duanestorey/hifi-amp/README.md

# hifi-amp
A hi-fi 4-channel amplifier with active-crossovers and room correction
