duanestorey/hifi-amp/pcbs/README.md

## Printed Circuit Boards

These are all the associated PCBs for the amplifier project.  They were all created in Kicad, and the boards optimized for production via JLCPCB.
