duanestorey/hifi-amp/pcbs/_final_proto/README.md

## Next Updates

* Opamp voltage regulator has enable pin - can use that to kill the rails instead of a relay on split board
* Change vinyl to Muffy
* See if we can move relay for LM3886 rails somewhere else
* Add LPF to opamp power supply caps, possibly digital too
