duanestorey/hifi-amp/pcbs/vinyl-p6/readme.md

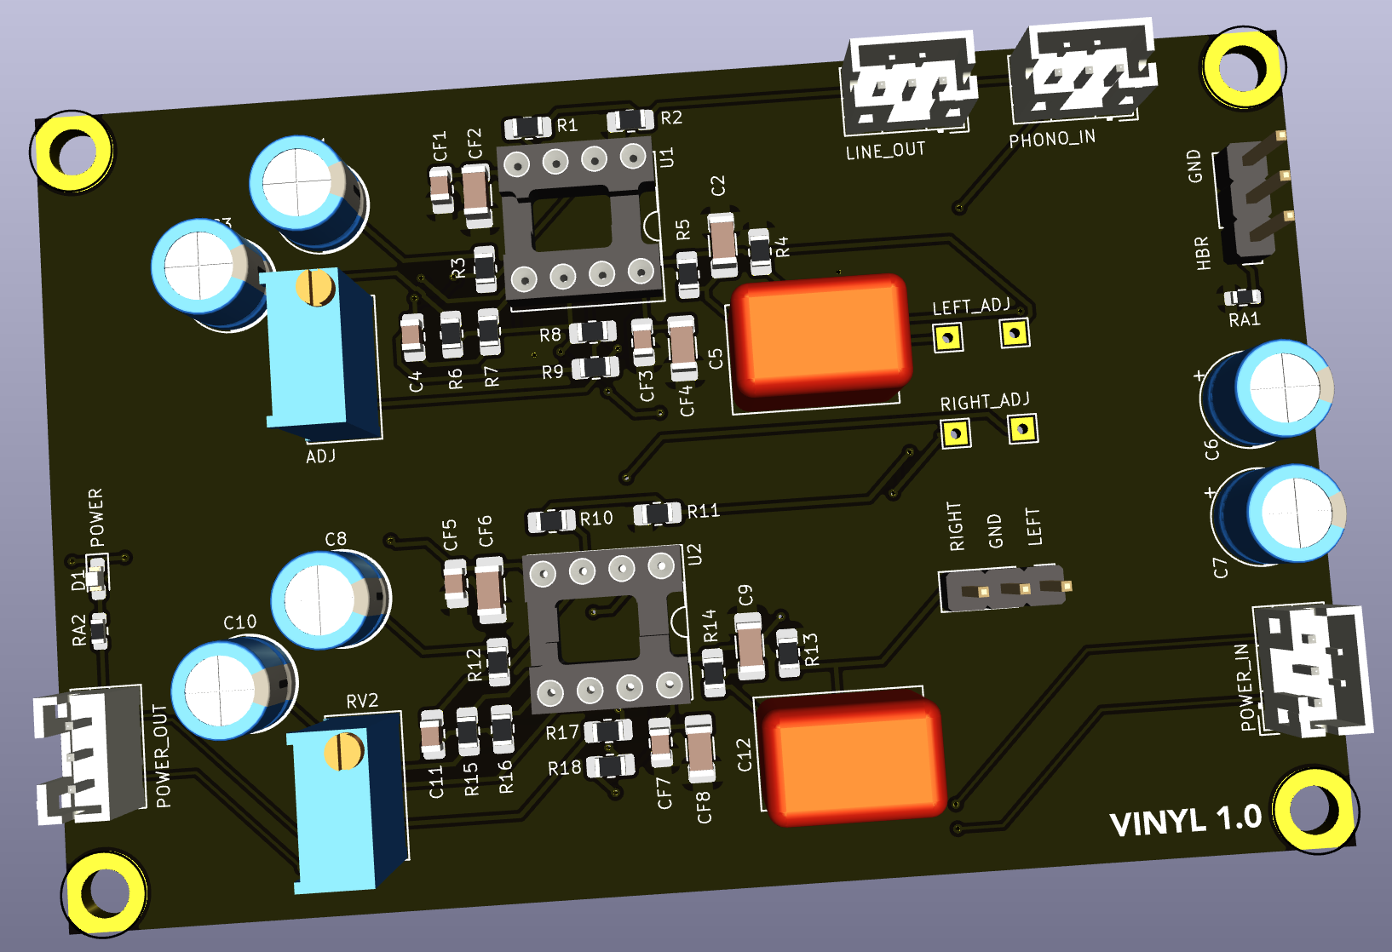
[picture p10: pcbs/vinyl-p6/screenshot.png]


## Phono/Vinyl Pre-amp

This is a phono/vinyl pre-amp with adjustable gain from about 40dB up to 60dB. It is based almost entirely on the ESP Project 6 Hifi Phono Pre-amp.  All resistors are thin-film 603/805, and all capacitors are either Nichicon Muse ES bipolar electrolytics or C0G surface mount 1206 variants.

### Version History

- 1.0: Initial Release

### Speciality Components

* OPA1612 Burr Brown operation amplifiers
* Various C0G and thin film resistors
* Nichicon Muse ES 25V 10uF
