duanestorey/hifi-amp/pcbs/_final_proto/psu-relay/readme.md

## PSU Split

### Version History

- 1.0: Initial Release
	- Missed connections between 5V and 3V3 capacitors.  Can fix it attaching wire under the board I think

### Speciality Components
