duanestorey/hifi-amp/pcbs/_final_proto/input-sel/readme.md

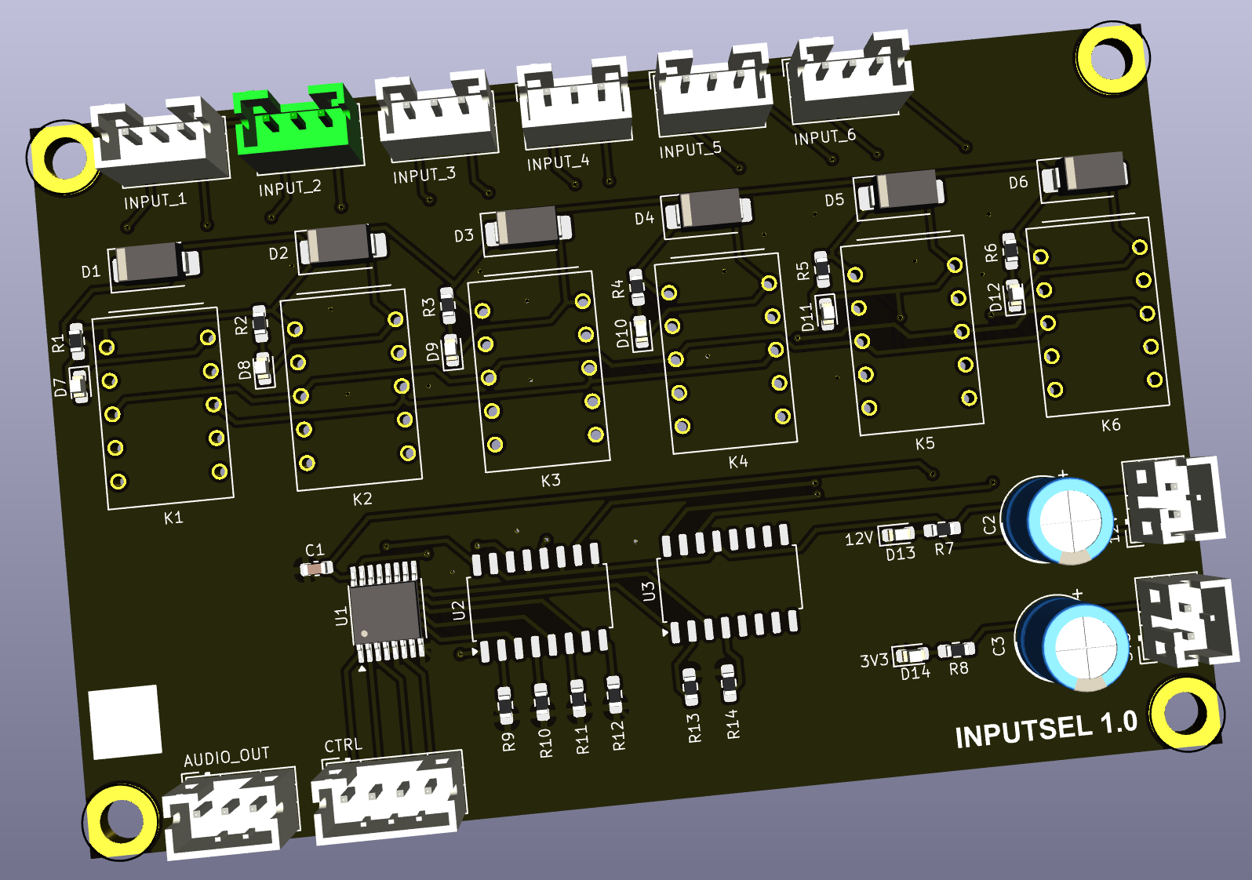
[picture p15: pcbs/_final_proto/input-sel/screenshot.png]


## Line-Input Selector

This PCB allows switching of 6 analog stereo inputs using gold-plated small signal relays.

### Version History

- 1.0: Initial Release

### Speciality Components

* 6x KEMET EA2 12V relays
* 2x TCMT4600 quad optocoupler
* CD74AC238 3->8 digital decoder
