duanestorey/hifi-amp/pcbs/_final_proto/lift/readme.md

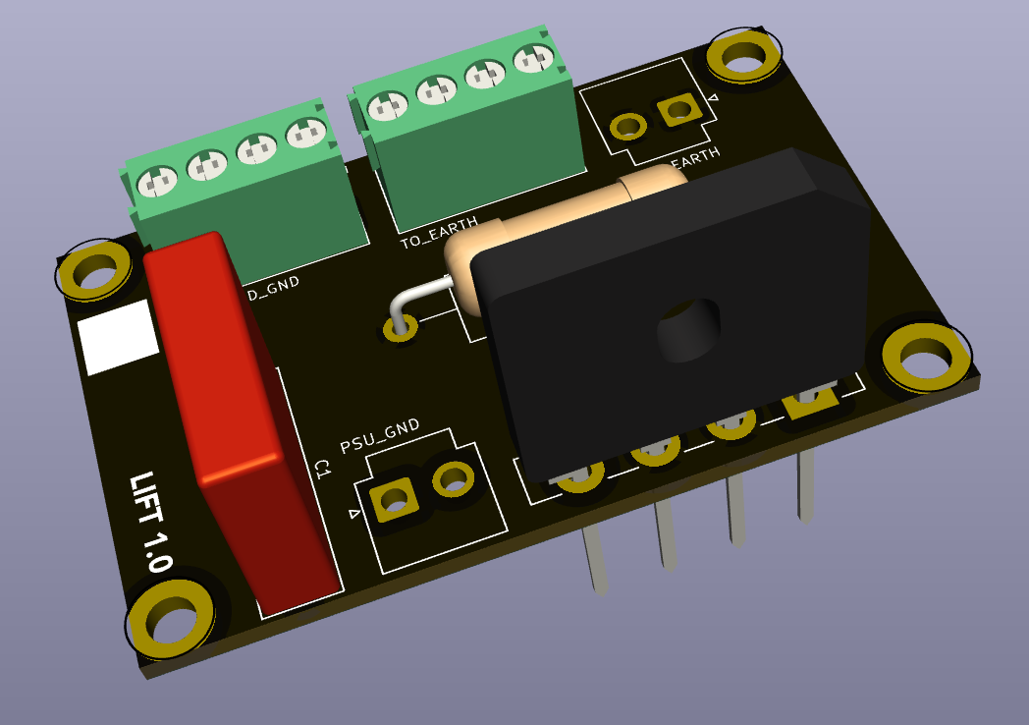
[picture p16: pcbs/_final_proto/lift/screenshot.png]


## Ground Lift

This board provides a ground-lift circuit to isolate the audio grounds from the chassis ground.  May not be legal in some juridictions, but should be safe.

### Version History

- 1.0: Initial Release

### Speciality Components
