duanestorey/hifi-amp/docs/specs.md

## Technical Specifications

The following are the rough technical specifications for the completed amplifier project. 

| Name | Value |
| ---- | ----- |
| Speakers | 2.1 |
| Channels | 4.1 |
| Subwoofer | Auto-generated |
| Sub Crossover Frequency | Programmable (80Hz typical) |
| Output Power (8Ω)| > 50W x 2 |
| Output Power (6Ω)| > 68W x 2 |
| THD+N @ Full Power | 0.03% |
| THD+N @ 2W | 0.005% |
| Display | 4x16 alphanumeric LCD |
| RCA Inputs | 6 |
| SPDIF Digital Inputs | 4 |
| TOSLINK Digital Inputs | 1 |
| Vinyl | Built-in RIAA amplifier |
| Internal Digital | 24-bit 96kHz | 
| Active Crossovers | Supported via Programmabale Biquads |
| Biquads supported | More than 100 at 96kHz |
| Signal Processing | 3x240 MHz dual-core 32-bit Xtensa LX7 |
| Output DAC | 112db SNR, -93db THD |
| Input ADC | 110db SNR, -93db THD |
| IR External Remote | Supported at 38kHz |
| Configuration | Wifi-Support |
| Programming | Over USB |

[Return to main page](/)
