duanestorey/hifi-amp/docs/hardware/index.md

## Hardware

The following are the entire collection of PCBs used to build the amplifier. The majority of these PCBS are two layer, but are few of them are also four layer. 

All of these PCBs were created using [Kicad](https://www.kicad.org/), a great open-source electronics design and automation suite. The Kicad files can be found [in the Github repository](https://github.com/duanestorey/hifi-amp/tree/main/pcbs) under similar names.

### Contents

- [Accessory PSU](dual-psu.md)
- [ADC](adc.md)
- [Analog Input Selector](input-sel.md)
- [Channel Amplifiers](lm3886.md)
- [DAC](dac.md)
- [Digital Signal Processors](dsp.md)
- [FTDI USB to UART](ftdi.md)
- [GPIO Extender](extend.md)
- [Ground Lift](lift.md)
- [Main PSU](psu.md)
- [Microprocessor](uproc.md)
- [Monoblocks](mono.md)
- [RCA Inputs](inputs.md)
- [Rectifier](rectify.md)
- [SPDIF/Digital Inputs](spdif.md)
- [Vinyl RIAA Amplifier](vinyl.md)
- [DIP to SOIC](soic.md)

[Return to main page](/)
