duanestorey/hifi-amp/docs/hardware/dsp.md

DSP PCB

## Digital Signal Processing (DSP)

This board can convert one stereo I2S audio stream into six independent signal processing pipelines configurable over I2C. 

### Version History

- 1.0: Initial Release

### Speciality Components

* 3x ESP32-S3-WROOM-1-N16R8 microprocessors @ 240 MHz
* 3x PI6CV304 clock distributor
* TMP100 temperature sensor

[Return to main page](/)
