duanestorey/hifi-amp/docs/i2c.md

## I2C Allocation

The following are the I2C addresses and alternates in the amplifier.

| Description | Address | Alternative |
| ----- | --- | --- |
| CS8416 | 0x10 | 0x10 - 0x17 |
| MCP1 | 0x20 | |
| MCP2 | 0x21 | |
| 4 Line LCD | 0x27 | |
| DIX9211 | 0x40 | 0x41 | 
| INA260 Channel | 0x41 | |
| INA260 PSU | 0x42 | |
| INA260 DC POS | 0x43 | |
| INA260 BUCK | 0x44 | |
| INA260 5V | 0x45 | |
| INA260 12V | 0x46 | |
| INA260 3V3 | 0x47 | |
| TMP100 CPU | 0x48 | | 
| TMP100 PSU | 0x49 | | 
| PCM5122 | 0x4c | 0x4d - 0x4f |
| ESP32 DSP | 0x58 | |
| Dolby Decoder | 0x5c | |
| PCM1863 ADC | 0x94 | 0x96 |

[Return to main page](/)
