duanestorey/hifi-amp/docs/enclosures.md

## Enclosures

There are two different enclosures used in this project.

### Main Amplifier Chassis

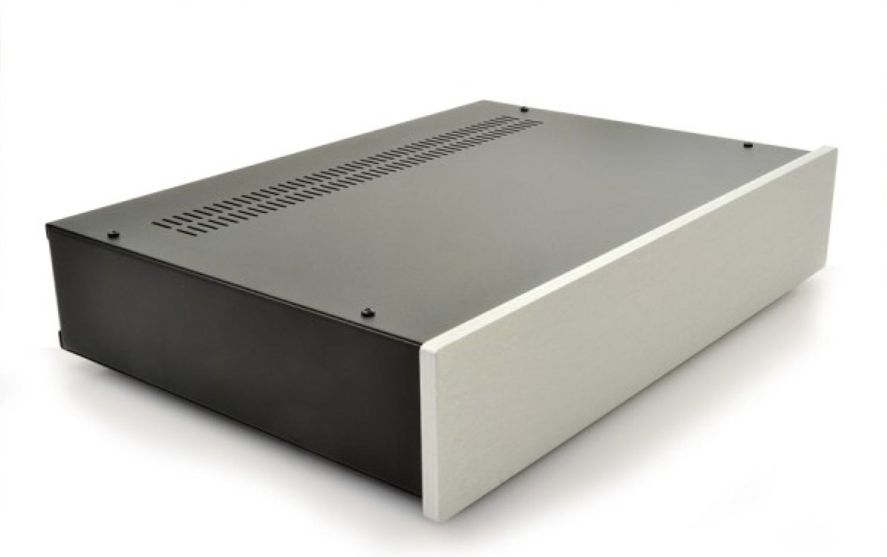
[picture p20: docs/images/pesante.png]
Main Chassis


The main amplifier uses the Pesante 2U case with 10mm front panel from [modushop.biz](https://modushop.biz/site/index.php?route=product/product&path=171_229&product_id=157).  This case also uses the optinoal inner baseplate with 10mm spacing.

#### Front Panel

The front panel was drilled using a CNC machine using the [front-panel template](https://github.com/duanestorey/hifi-amp/tree/main/cad) by modushop.biz using one of their optional add-ons. 

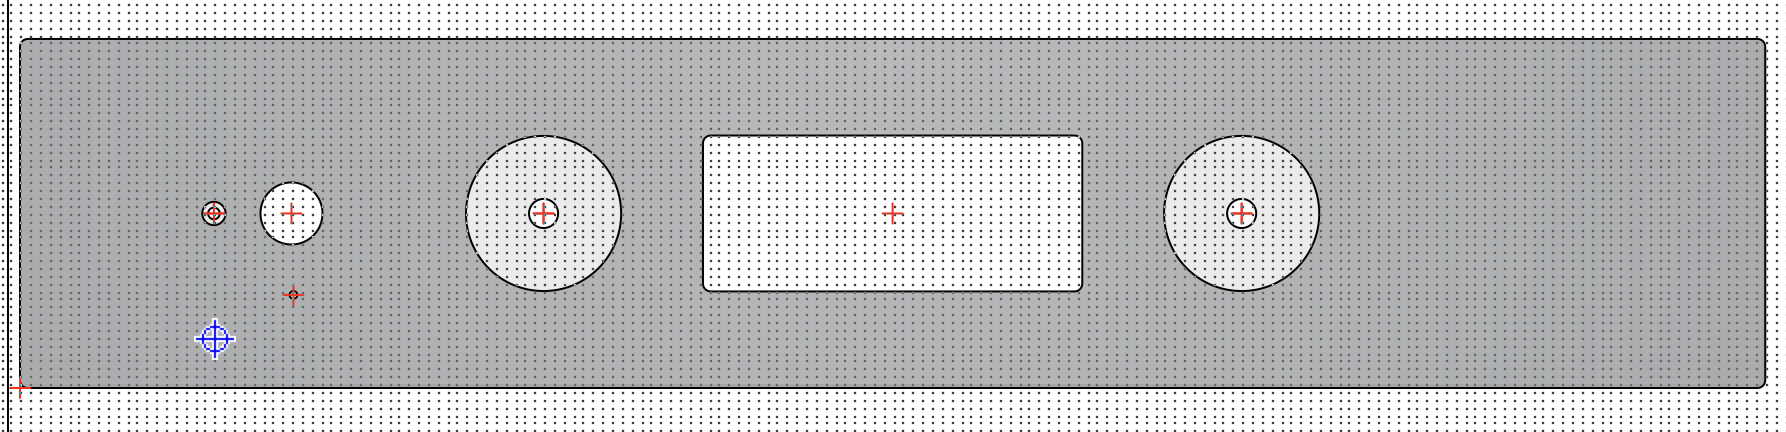
[picture p21: docs/images/front-panel.png]
Front Panel


### Monoblocks

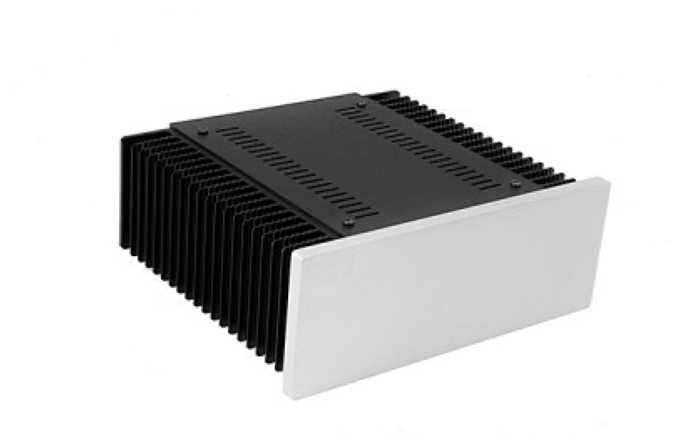
[picture p22: docs/images/mini-dissipante.png]
Monoblocks


There are also two monoblocks (technically duo-blocks, as they contain two channels each) that use the Mini-dissipante 2U cases also from [moduship.biz](https://modushop.biz/site/index.php?route=product/product&path=284&product_id=735).  This two cases also uses the optinoal inner baseplate with 10mm spacing.

[Return to main page](/)
