duanestorey/hifi-amp/docs/software/amp.md

## Amplifier Code

The main amplifier code is an ESP32 IDF application built on FreeRTOS. 

You can find the main amplifier code [in the Github repository](https://github.com/duanestorey/hifi-amp/).

[Return to main page](/)
