duanestorey/hifi-amp/docs/software/index.md

## Software

This project primarily uses the ESP32-S3 chipset by Espressif. These chips are dual-core 240 MHz and support both wifi and bluetooth.

The software was written primariy in C++ and C using the [Epressif IDF framework](https://www.espressif.com/en/products/sdks/esp-idf).

### Contents

- [Amplifier](amp.md)
- [DSP](dsp.md)

[Return to main page](/)
