duanestorey/hifi-amp/docs/software/dsp.md

## DSP Code

The main DSP code is an ESP32 IDF application built on FreeRTOS. It has to be independently uploaded to each of the three DSP chips.

[Return to main page](/)
