duanestorey/hifi-amp/plans/pcb-requirements.rtf

AMPLIFIER PINS

ADC - no major ones
- would be nice - GPIO1, ADC_INT

DAC - I2C,
- would be nice, XSMT pin

DOLBY - RESET, IRQ, both already have pull-ups , pulldowns

DSP - would be nice, EN, BOOT to program chip

I2S - EN1, EN2 for sure, EN3, EN4 if we have room

INPUT-SEL
- needs CTRL1, CTRL2, CTRL3, FUTURE - needs pulldowns on uProc side, put on for pin header for now

SPDIF
- needs SCL, SDA, RESET on 3 pin PH

REMOTE
EXPANSION
DEBUG

PGND
3V3
SCL
SDA
