duanestorey/hifi-amp/datasheets/inductor_cmp.png

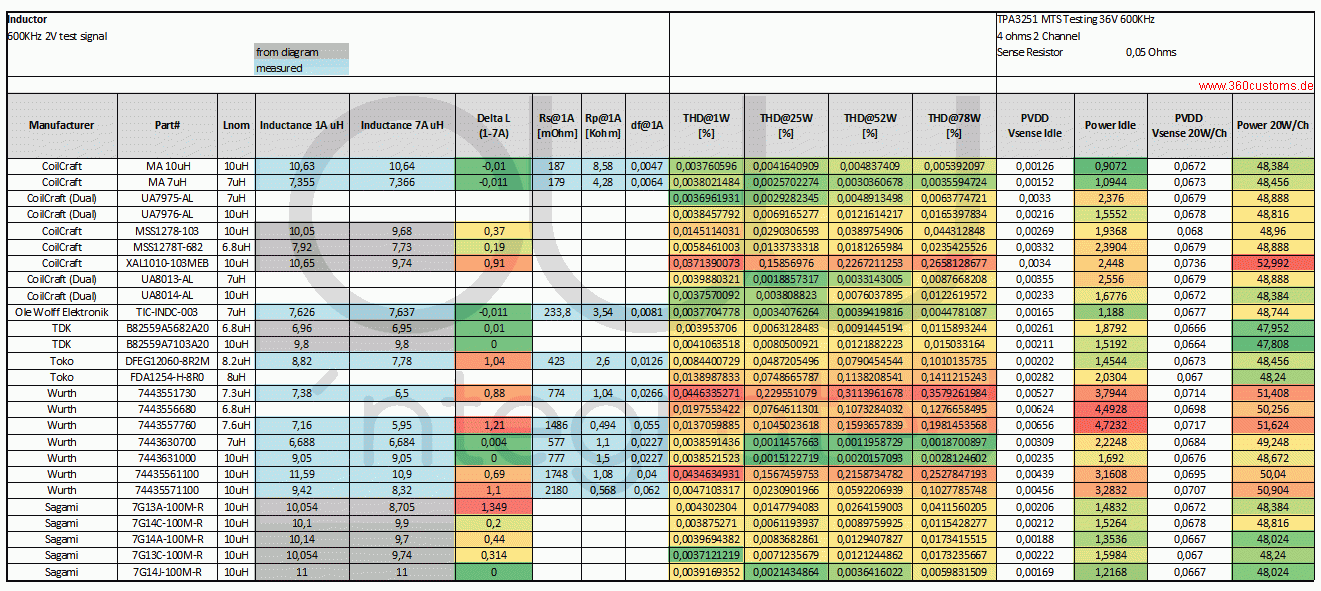
datasheets/inductor_cmp.png
