duanestorey/hifi-amp/docs/log/GjvUp6-XUAA7CEx Medium.jpeg

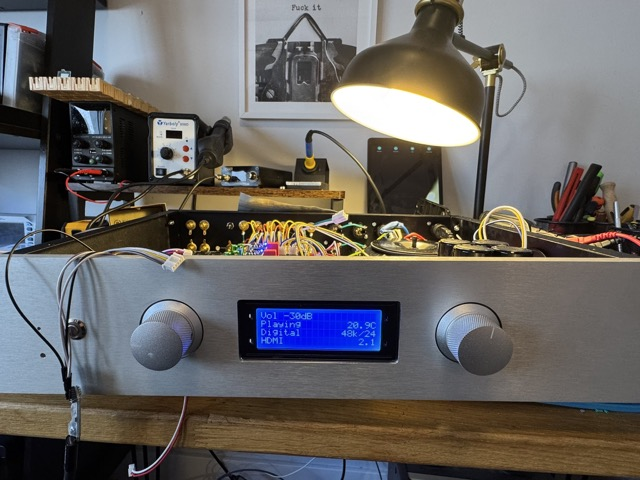
docs/log/GjvUp6-XUAA7CEx Medium.jpeg
