duanestorey/hifi-amp/docs/log/Gjw41vNXAAAi-az Medium.jpeg

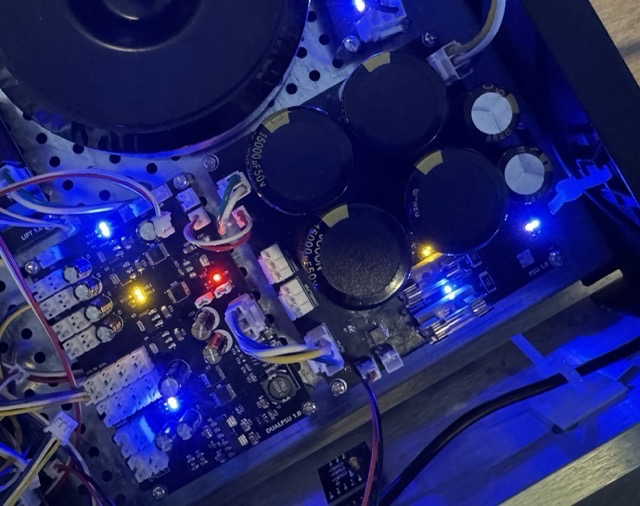
docs/log/Gjw41vNXAAAi-az Medium.jpeg
