duanestorey/hifi-amp/docs/log/IMG_3358 Medium.jpeg

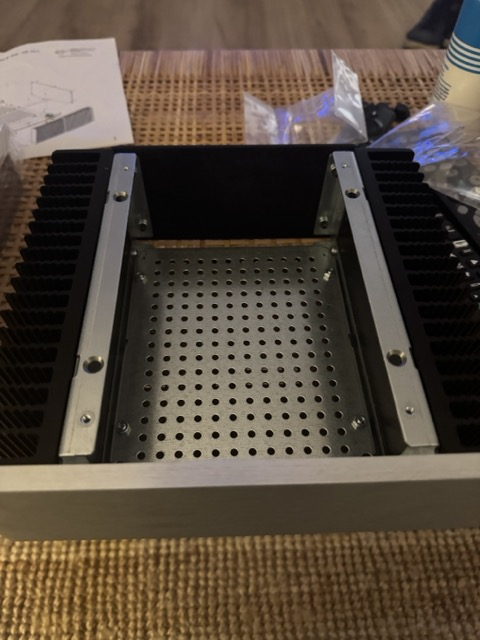
docs/log/IMG_3358 Medium.jpeg
