duanestorey/hifi-amp/docs/log/IMG_3362 Medium.jpeg

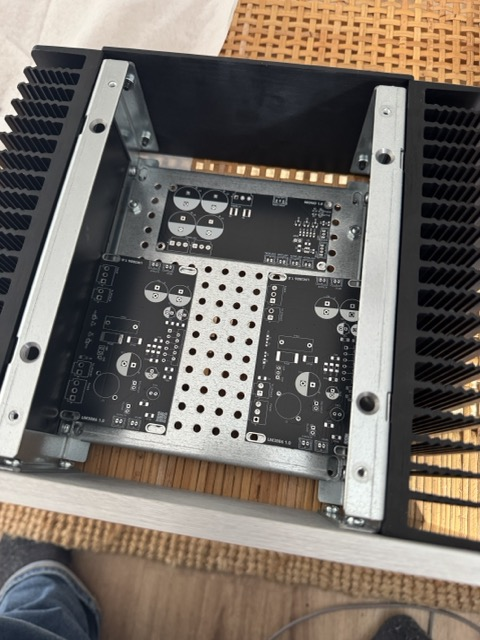
docs/log/IMG_3362 Medium.jpeg
