duanestorey/hifi-amp/docs/log/IMG_3363 Medium.jpeg

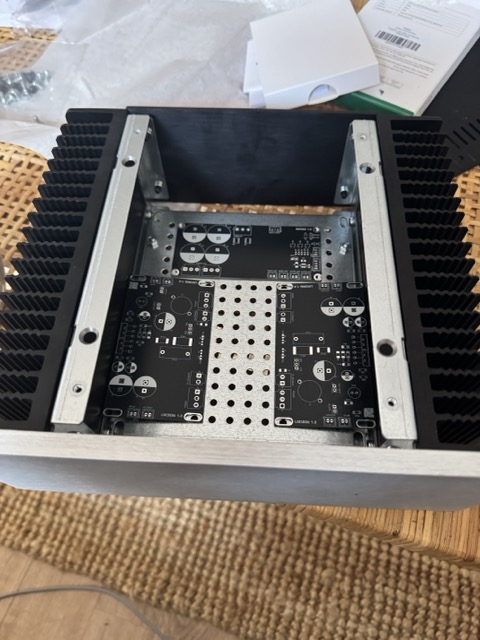
docs/log/IMG_3363 Medium.jpeg
