duanestorey/hifi-amp/docs/log/IMG_3368 Medium.jpeg

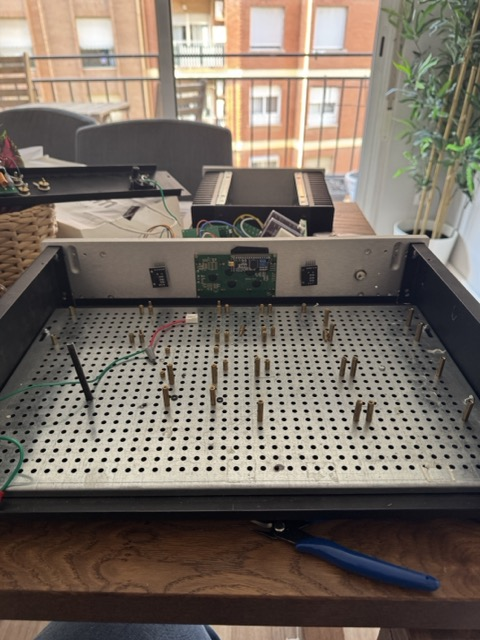
docs/log/IMG_3368 Medium.jpeg
