duanestorey/hifi-amp/docs/log/IMG_3374 Medium.jpeg

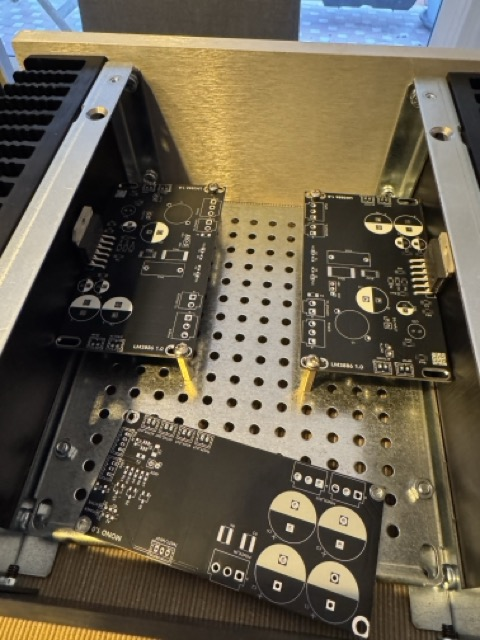
docs/log/IMG_3374 Medium.jpeg
