duanestorey/hifi-amp/docs/log/IMG_3375 Medium.jpeg

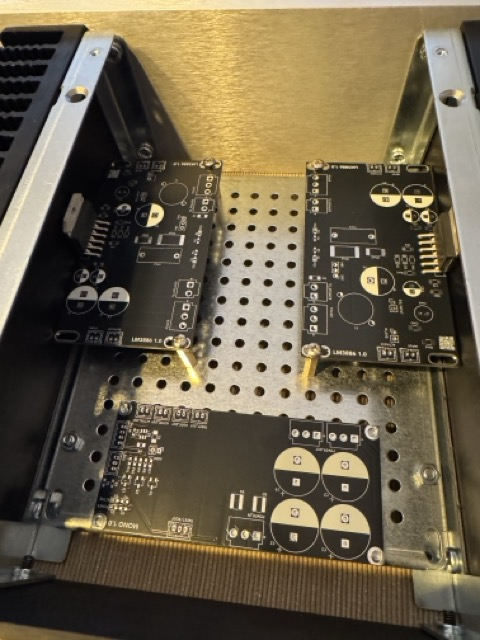
docs/log/IMG_3375 Medium.jpeg
