duanestorey/hifi-amp/docs/log/IMG_3376 Medium.jpeg

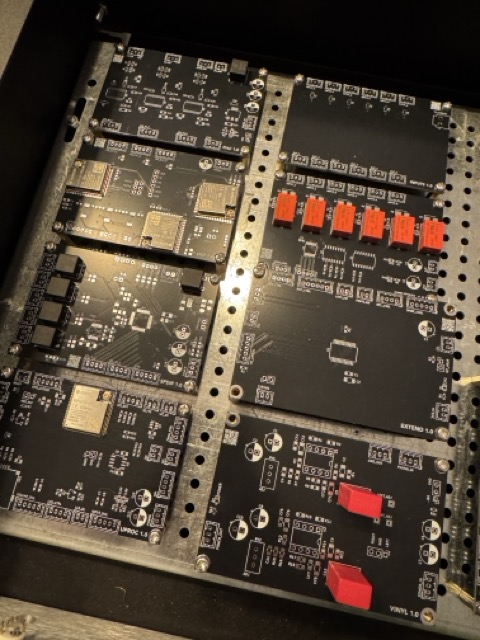
docs/log/IMG_3376 Medium.jpeg
