duanestorey/hifi-amp/docs/log/IMG_3377 Medium.jpeg

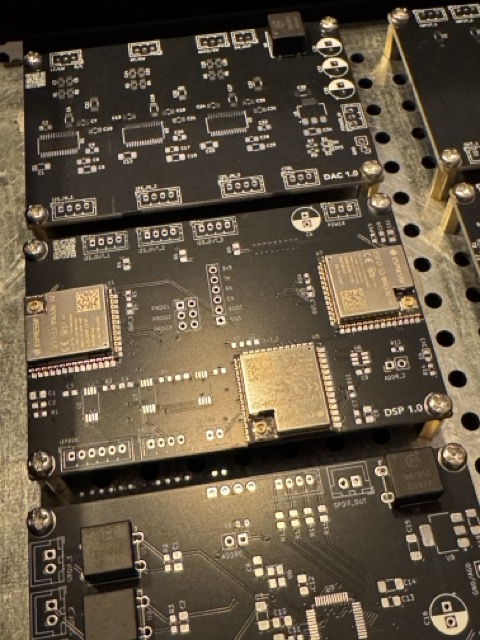
docs/log/IMG_3377 Medium.jpeg
