duanestorey/hifi-amp/docs/log/IMG_3389 Medium.jpeg

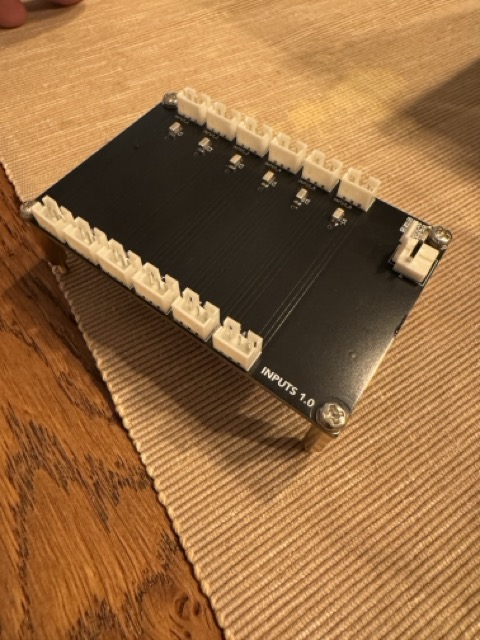
docs/log/IMG_3389 Medium.jpeg
