duanestorey/hifi-amp/docs/log/IMG_3390 Medium.jpeg

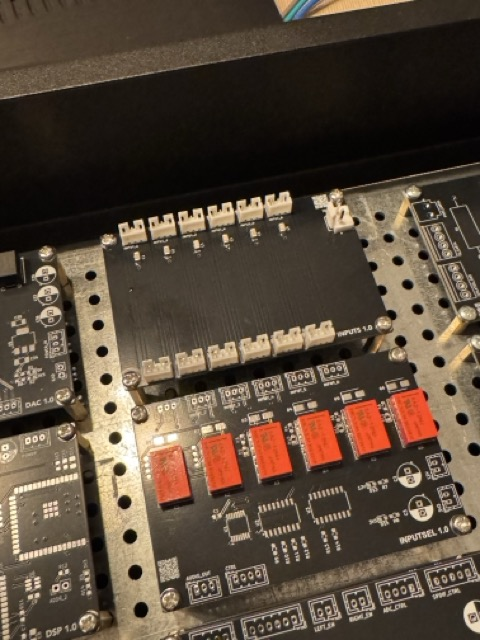
docs/log/IMG_3390 Medium.jpeg
