duanestorey/hifi-amp/docs/log/IMG_3426 Medium.jpeg

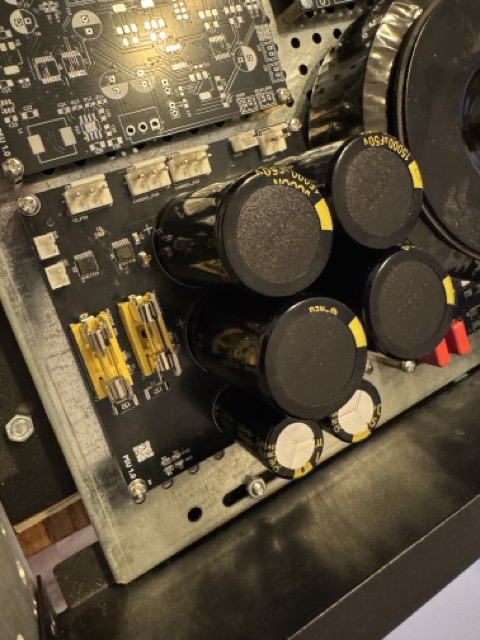
docs/log/IMG_3426 Medium.jpeg
