duanestorey/hifi-amp/docs/log/IMG_3427 Medium.jpeg

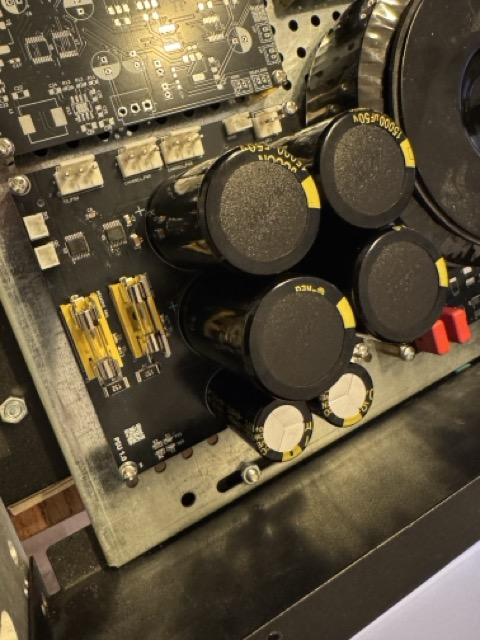
docs/log/IMG_3427 Medium.jpeg
