duanestorey/hifi-amp/docs/log/IMG_3428 Medium.jpeg

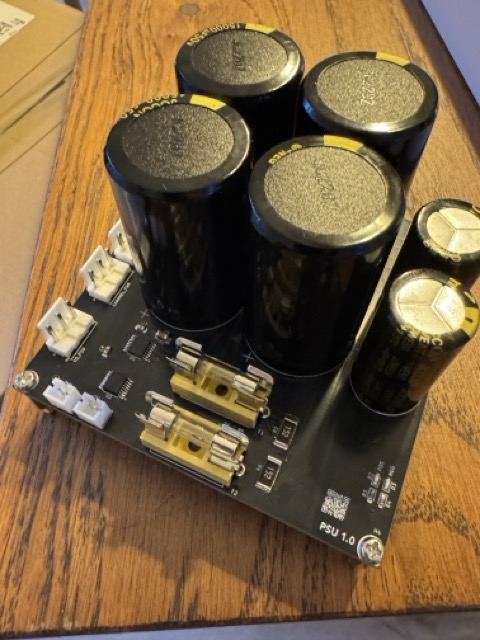
docs/log/IMG_3428 Medium.jpeg
