duanestorey/hifi-amp/docs/log/IMG_3440 Medium.jpeg

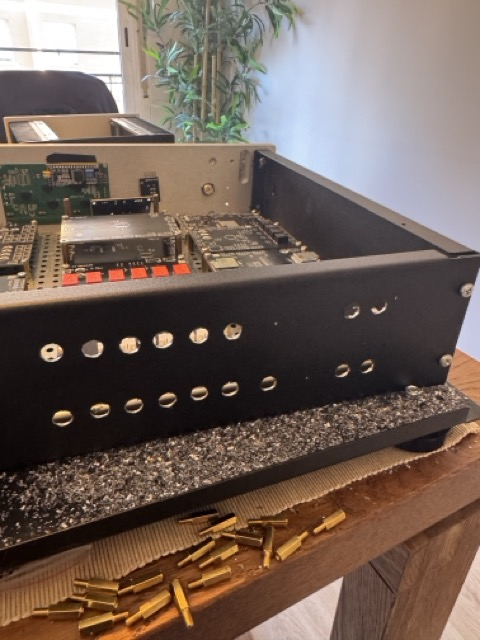
docs/log/IMG_3440 Medium.jpeg
