duanestorey/hifi-amp/docs/log/IMG_3441 Medium.jpeg

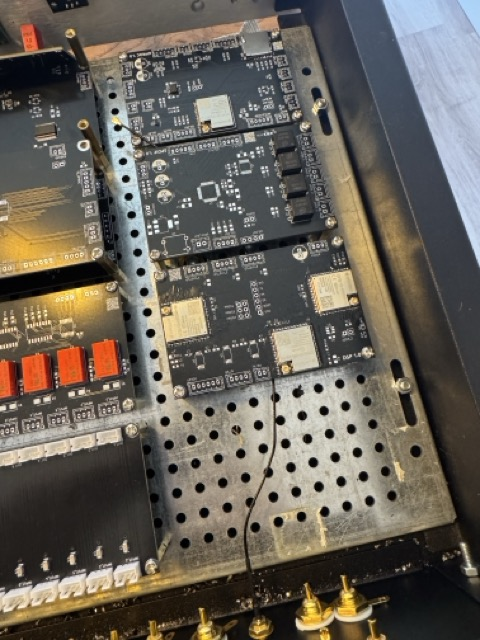
docs/log/IMG_3441 Medium.jpeg
