duanestorey/hifi-amp/docs/log/IMG_3442 Medium.jpeg

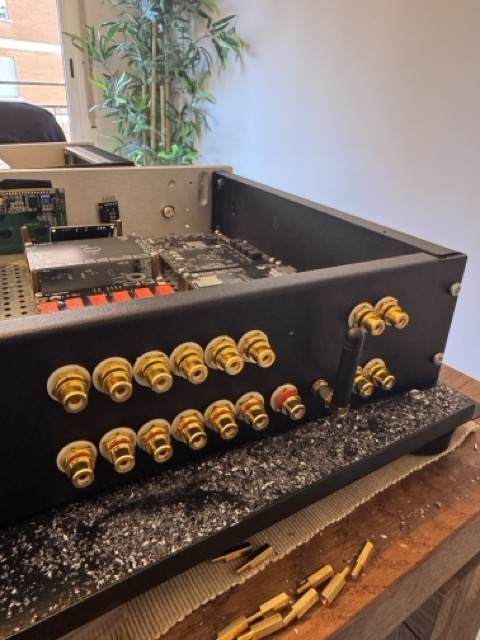
docs/log/IMG_3442 Medium.jpeg
