duanestorey/hifi-amp/docs/log/IMG_3445 Medium.jpeg

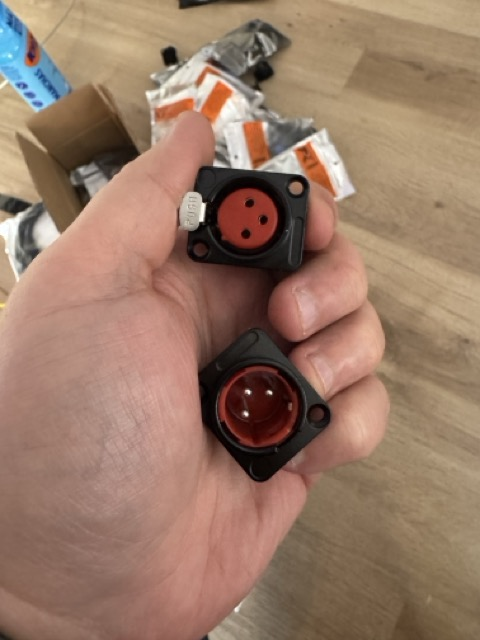
docs/log/IMG_3445 Medium.jpeg
