duanestorey/hifi-amp/docs/log/IMG_3446 Medium.jpeg

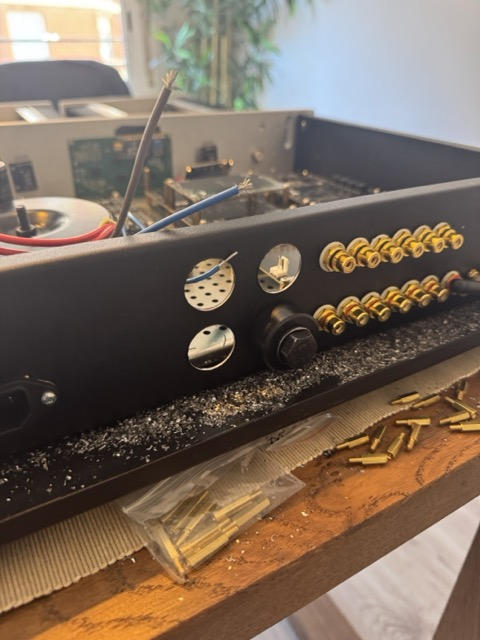
docs/log/IMG_3446 Medium.jpeg
