duanestorey/hifi-amp/docs/log/IMG_3447 Medium.jpeg

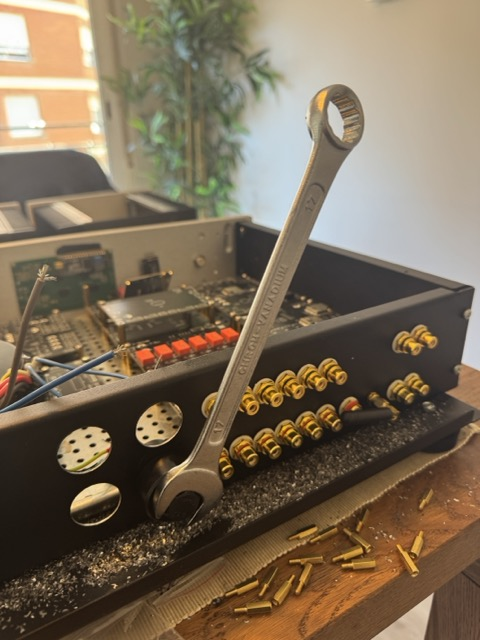
docs/log/IMG_3447 Medium.jpeg
