duanestorey/hifi-amp/docs/log/IMG_3448 Medium.jpeg

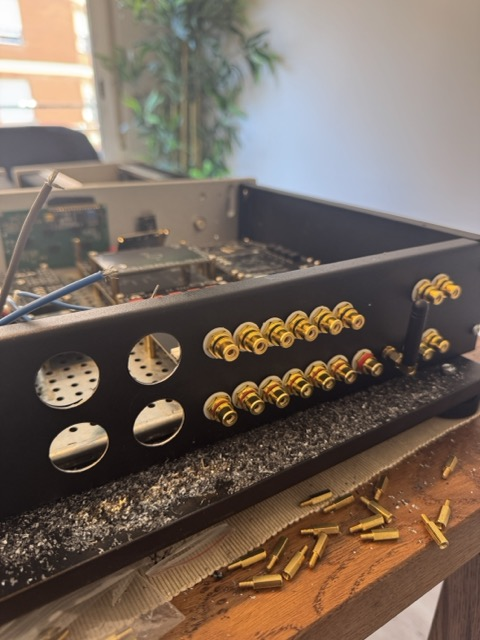
docs/log/IMG_3448 Medium.jpeg
