duanestorey/hifi-amp/docs/log/IMG_3449 Medium.jpeg

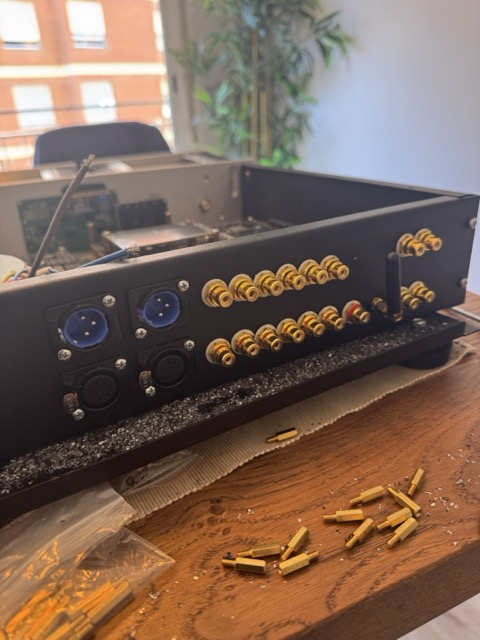
docs/log/IMG_3449 Medium.jpeg
