duanestorey/hifi-amp/docs/log/IMG_3450 Medium.jpeg

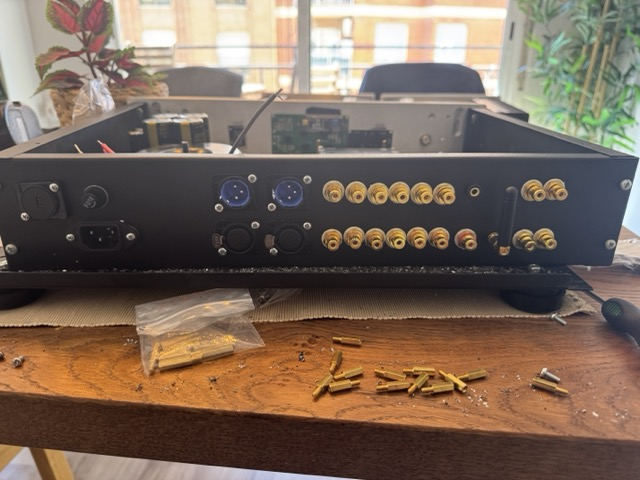
docs/log/IMG_3450 Medium.jpeg
