duanestorey/hifi-amp/docs/log/IMG_3454 Medium.jpeg

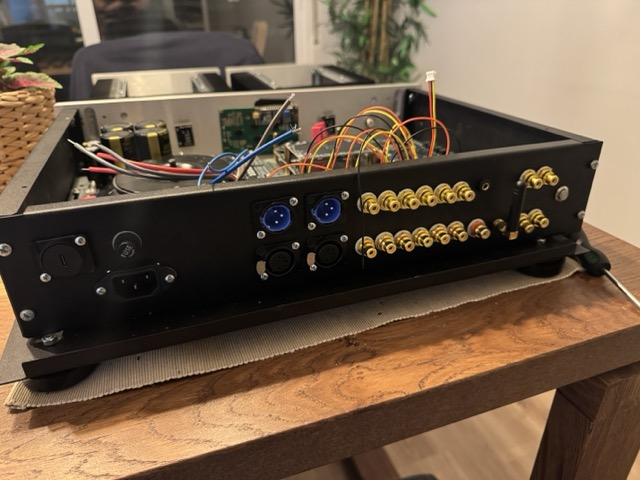
docs/log/IMG_3454 Medium.jpeg
