duanestorey/hifi-amp/docs/log/IMG_3464 Medium.jpeg

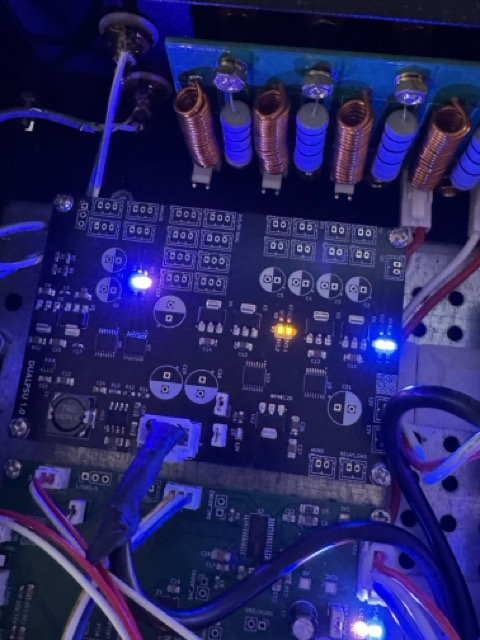
docs/log/IMG_3464 Medium.jpeg
