duanestorey/hifi-amp/docs/log/IMG_3465 Medium.jpeg

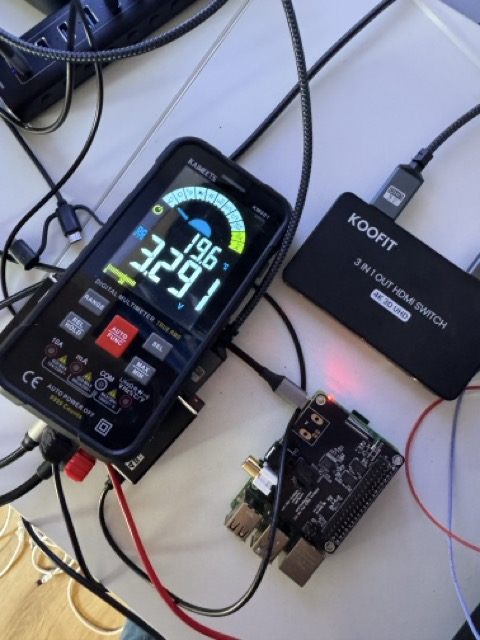
docs/log/IMG_3465 Medium.jpeg
