duanestorey/hifi-amp/docs/log/IMG_3466 Medium.jpeg

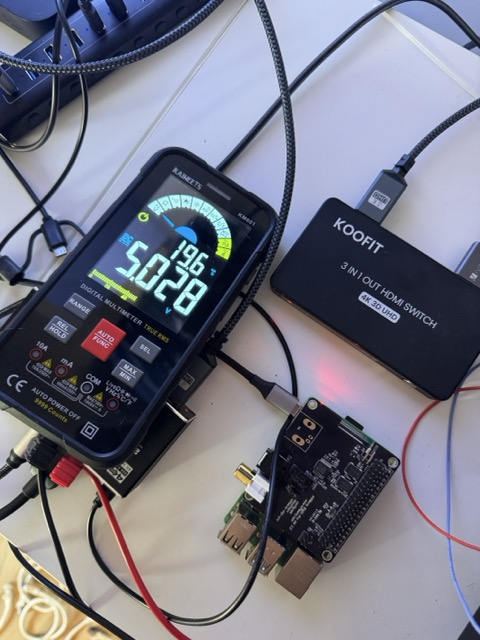
docs/log/IMG_3466 Medium.jpeg
