duanestorey/hifi-amp/docs/log/IMG_3471 Medium.jpeg

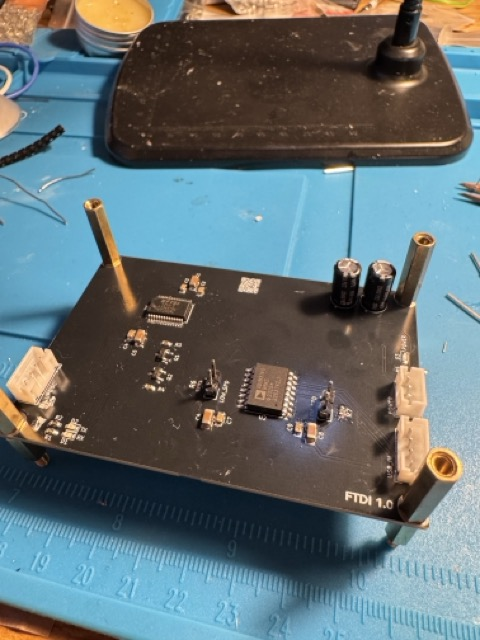
docs/log/IMG_3471 Medium.jpeg
