duanestorey/hifi-amp/docs/log/IMG_3472 Medium.jpeg

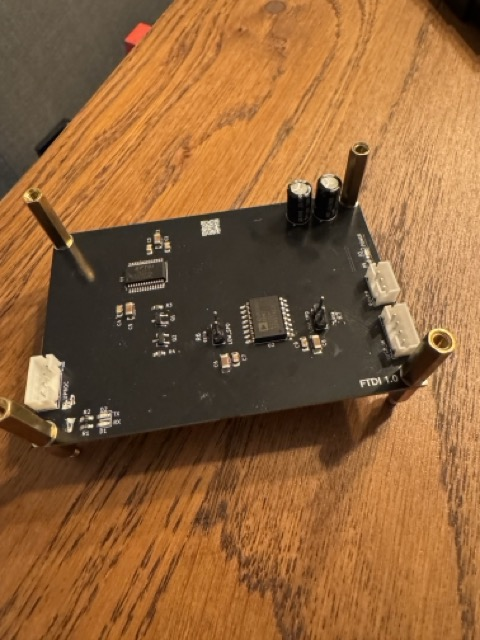
docs/log/IMG_3472 Medium.jpeg
