duanestorey/hifi-amp/docs/log/IMG_3473 Medium.jpeg

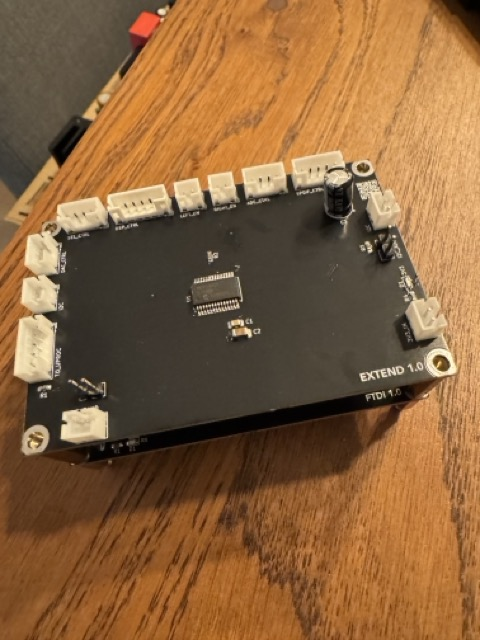
docs/log/IMG_3473 Medium.jpeg
