duanestorey/hifi-amp/docs/log/IMG_3475 Medium.jpeg

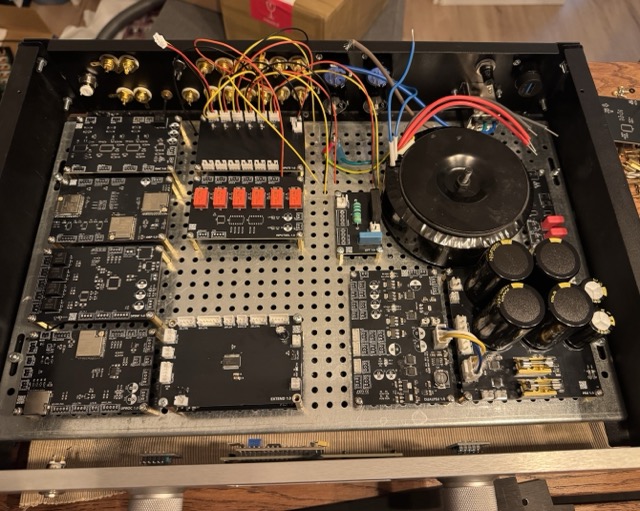
docs/log/IMG_3475 Medium.jpeg
