duanestorey/hifi-amp/docs/log/IMG_3496 Medium.jpeg

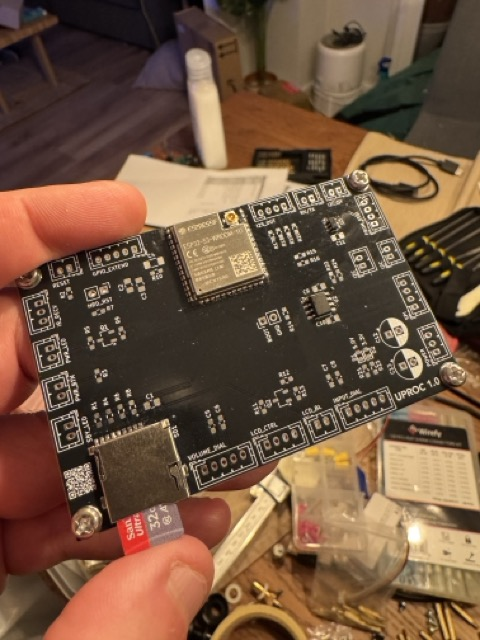
docs/log/IMG_3496 Medium.jpeg
