duanestorey/hifi-amp/docs/log/IMG_3515 Medium.jpeg

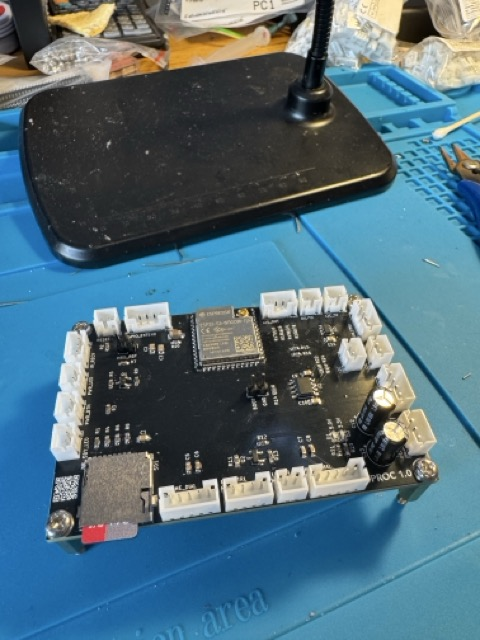
docs/log/IMG_3515 Medium.jpeg
