duanestorey/hifi-amp/docs/log/IMG_3516 Medium.jpeg

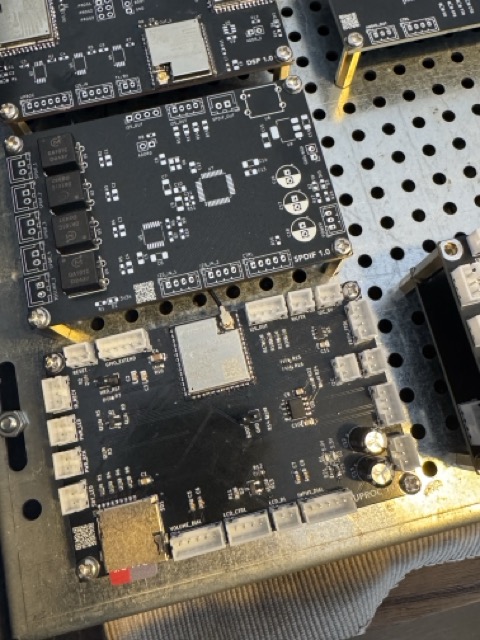
docs/log/IMG_3516 Medium.jpeg
