duanestorey/hifi-amp/docs/log/IMG_3518 Medium.jpeg

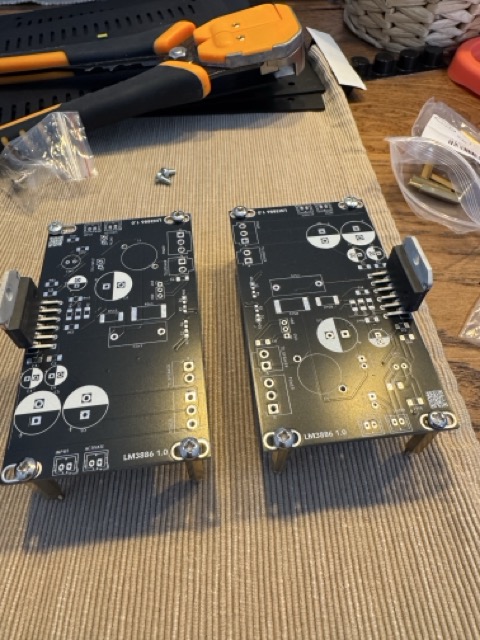
docs/log/IMG_3518 Medium.jpeg
