duanestorey/hifi-amp/docs/log/IMG_3519 Medium.jpeg

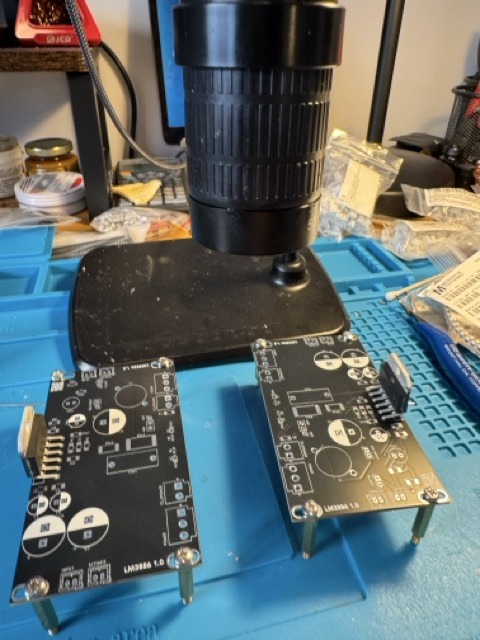
docs/log/IMG_3519 Medium.jpeg
