duanestorey/hifi-amp/docs/log/IMG_3520 Medium.jpeg

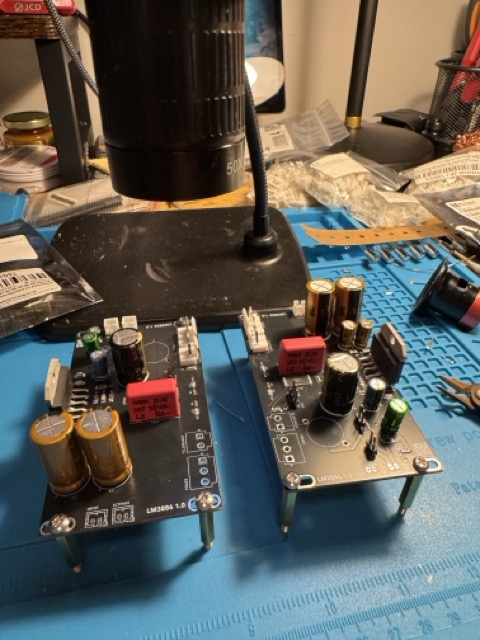
docs/log/IMG_3520 Medium.jpeg
