duanestorey/hifi-amp/docs/log/IMG_3521 Medium.jpeg

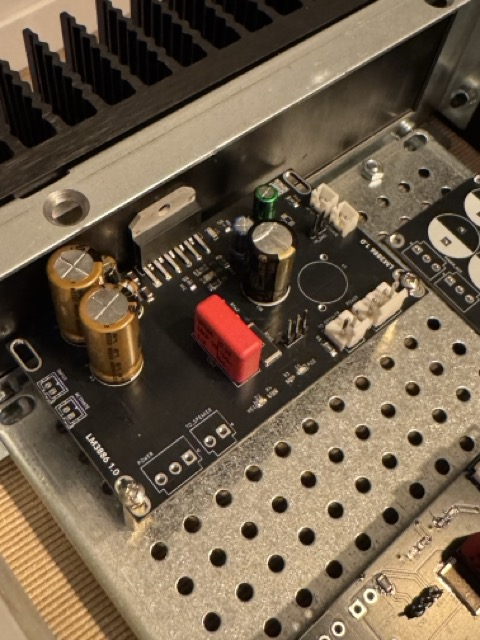
docs/log/IMG_3521 Medium.jpeg
