duanestorey/hifi-amp/docs/log/IMG_3522 Medium.jpeg

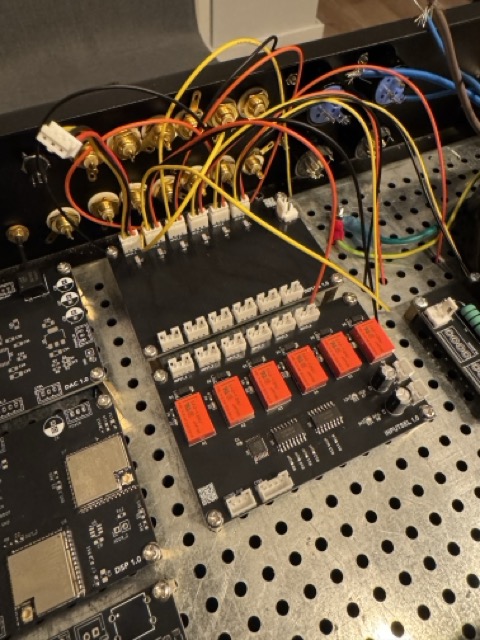
docs/log/IMG_3522 Medium.jpeg
