duanestorey/hifi-amp/docs/log/IMG_3523 Medium.jpeg

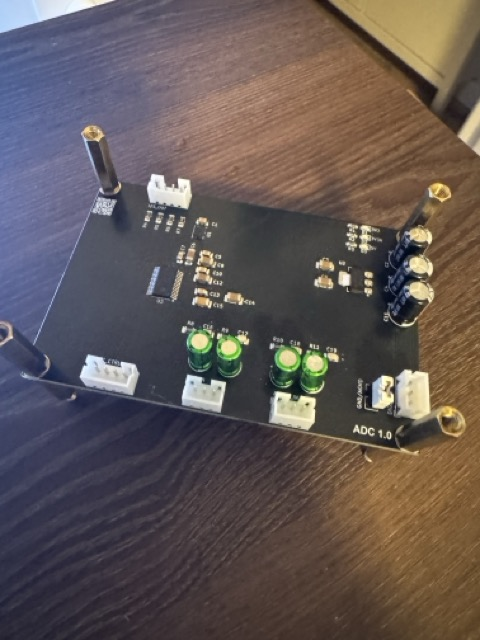
docs/log/IMG_3523 Medium.jpeg
