duanestorey/hifi-amp/docs/log/IMG_3524 Medium.jpeg

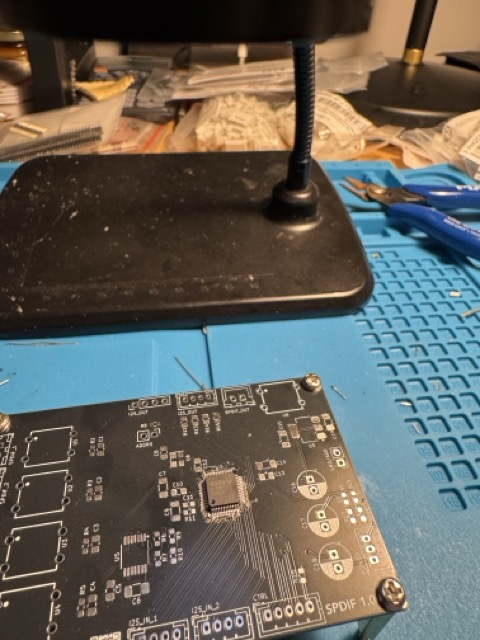
docs/log/IMG_3524 Medium.jpeg
