duanestorey/hifi-amp/docs/log/IMG_3525 Medium.jpeg

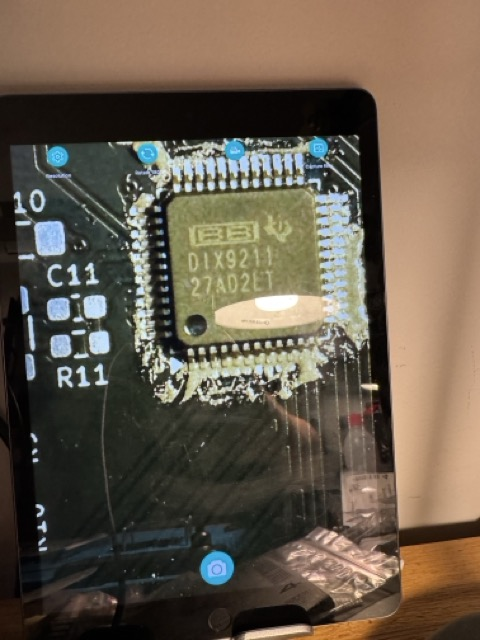
docs/log/IMG_3525 Medium.jpeg
