duanestorey/hifi-amp/docs/log/IMG_3526 Medium.jpeg

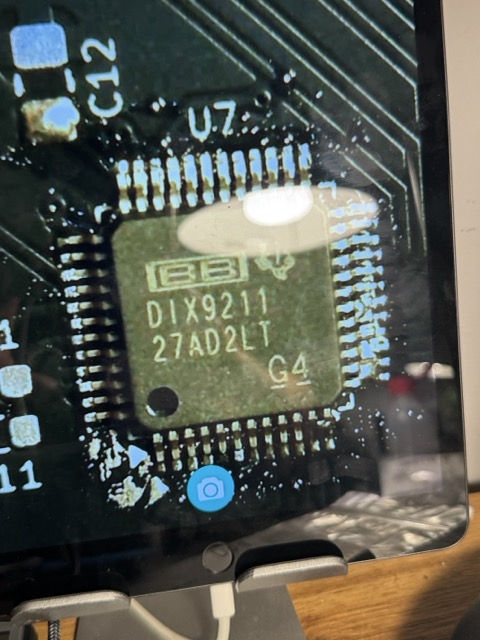
docs/log/IMG_3526 Medium.jpeg
