duanestorey/hifi-amp/docs/log/IMG_3527 Medium.jpeg

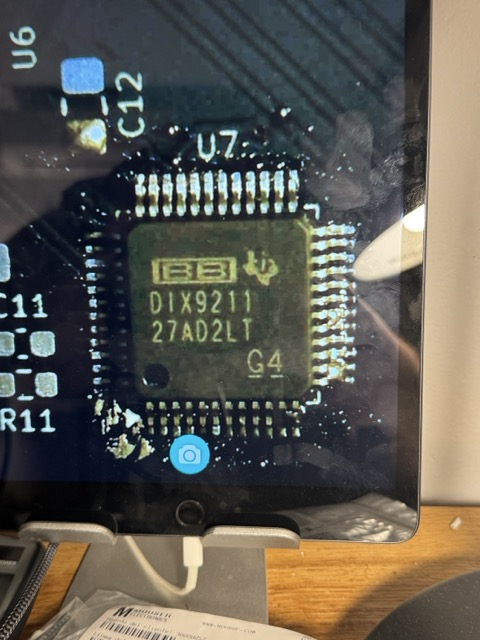
docs/log/IMG_3527 Medium.jpeg
