duanestorey/hifi-amp/docs/log/IMG_3528 Medium.jpeg

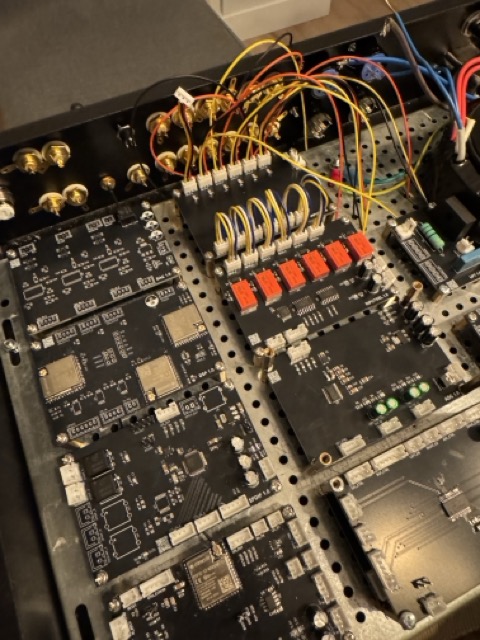
docs/log/IMG_3528 Medium.jpeg
