duanestorey/hifi-amp/docs/log/IMG_3529 Medium.jpeg

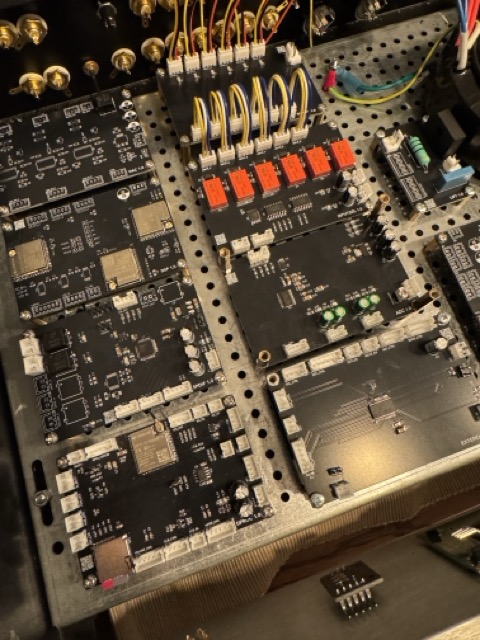
docs/log/IMG_3529 Medium.jpeg
