duanestorey/hifi-amp/docs/log/IMG_3530 Medium.jpeg

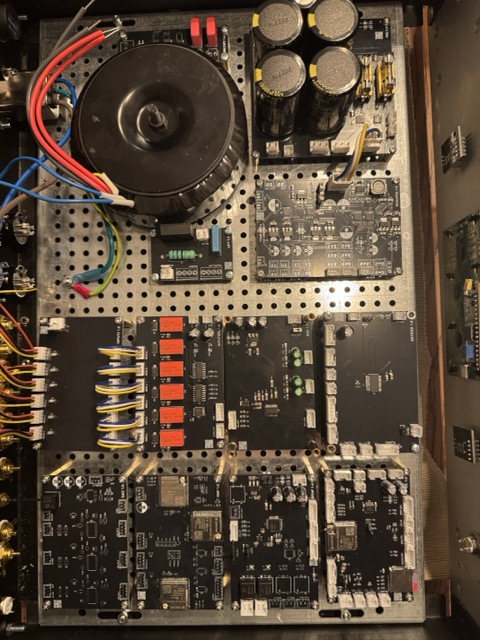
docs/log/IMG_3530 Medium.jpeg
