duanestorey/hifi-amp/docs/log/IMG_3531 Medium.jpeg

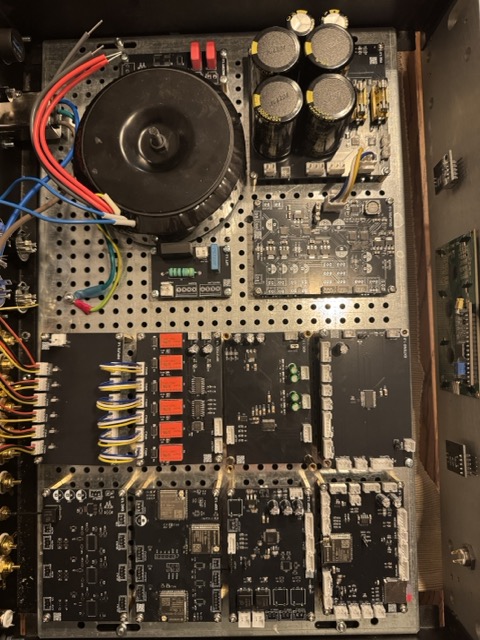
docs/log/IMG_3531 Medium.jpeg
