duanestorey/hifi-amp/docs/log/IMG_3533 Medium.jpeg

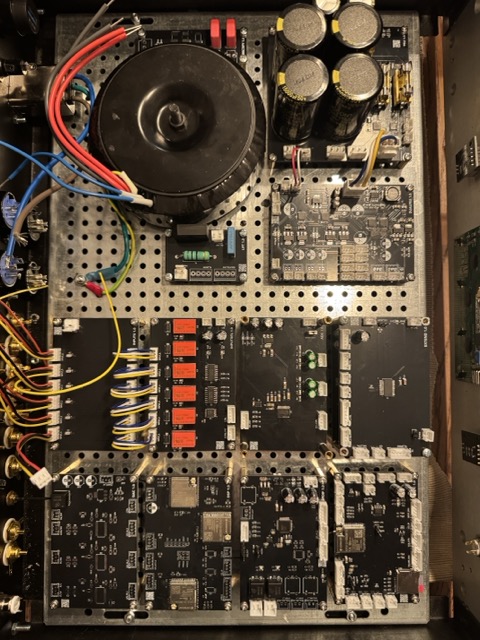
docs/log/IMG_3533 Medium.jpeg
