duanestorey/hifi-amp/docs/log/IMG_3535 Medium.jpeg

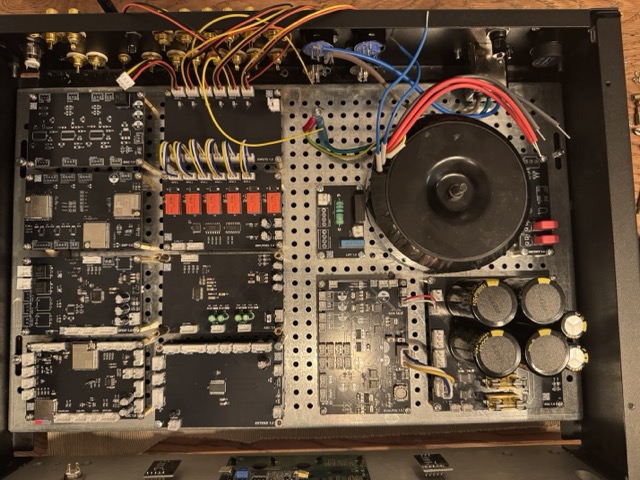
docs/log/IMG_3535 Medium.jpeg
