duanestorey/hifi-amp/docs/log/IMG_3539 Medium.jpeg

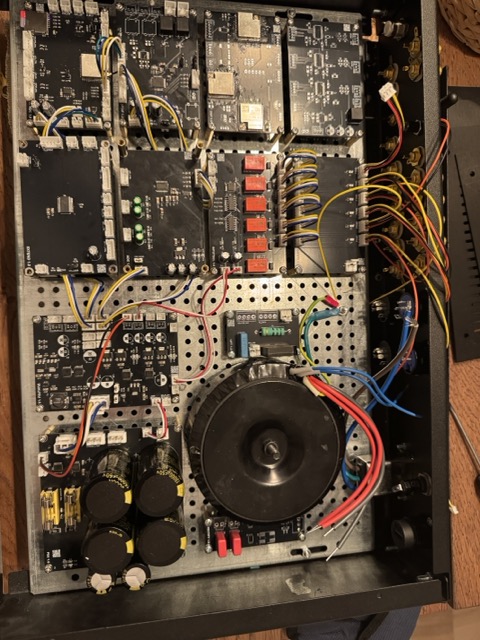
docs/log/IMG_3539 Medium.jpeg
