duanestorey/hifi-amp/docs/log/IMG_3547 Medium.jpeg

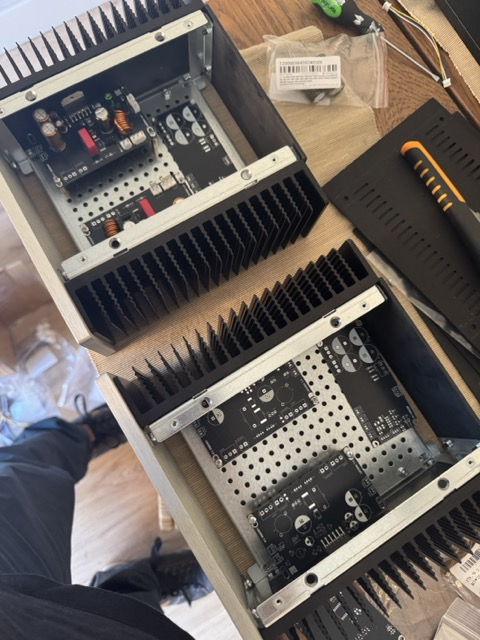
docs/log/IMG_3547 Medium.jpeg
