duanestorey/hifi-amp/docs/log/IMG_3548 Medium.jpeg

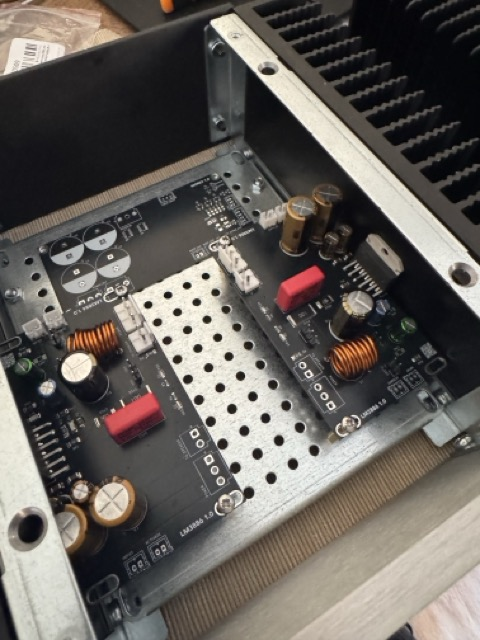
docs/log/IMG_3548 Medium.jpeg
