duanestorey/hifi-amp/docs/log/IMG_3549 Medium.jpeg

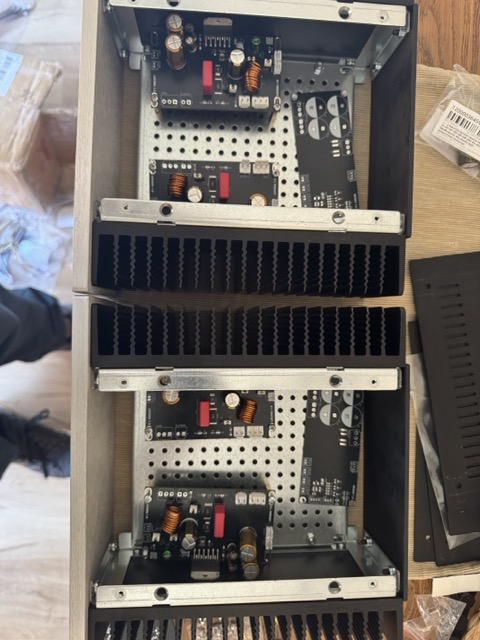
docs/log/IMG_3549 Medium.jpeg
