duanestorey/hifi-amp/docs/log/IMG_3550 Medium.jpeg

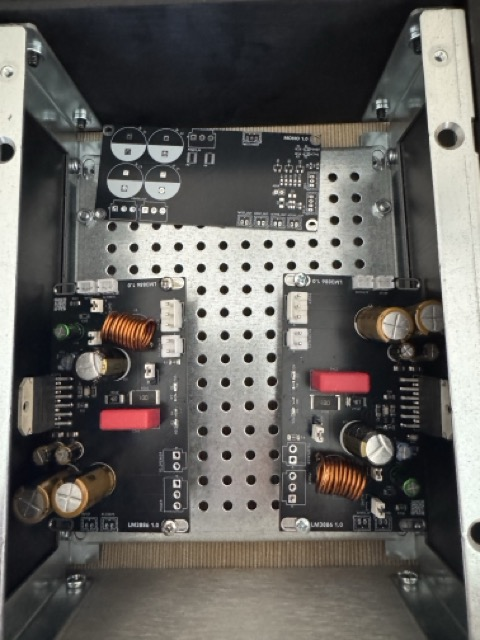
docs/log/IMG_3550 Medium.jpeg
