duanestorey/hifi-amp/docs/log/IMG_3551 Medium.jpeg

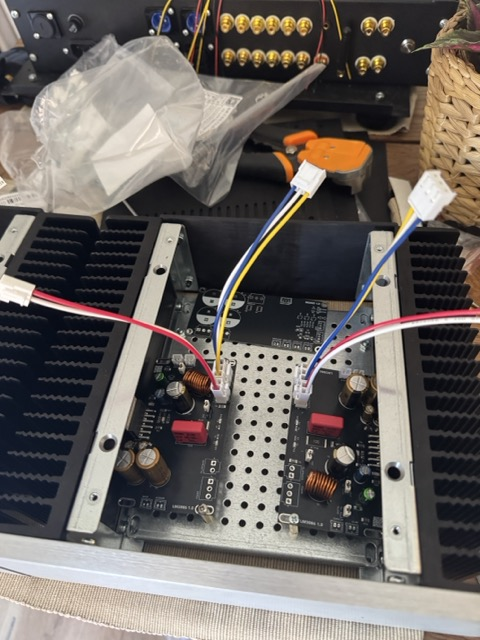
docs/log/IMG_3551 Medium.jpeg
