duanestorey/hifi-amp/docs/log/IMG_3553 Medium.jpeg

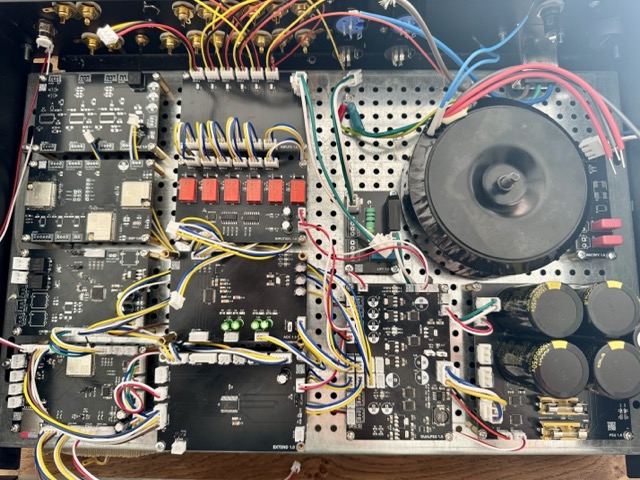
docs/log/IMG_3553 Medium.jpeg
