duanestorey/hifi-amp/docs/log/IMG_3554 Medium.jpeg

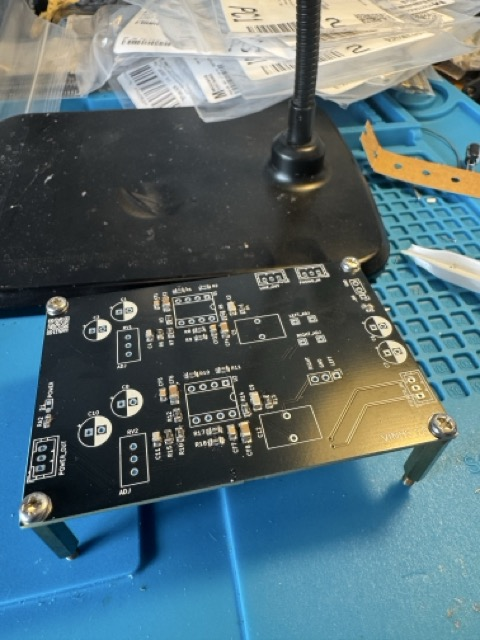
docs/log/IMG_3554 Medium.jpeg
