duanestorey/hifi-amp/docs/log/IMG_3555 Medium.jpeg

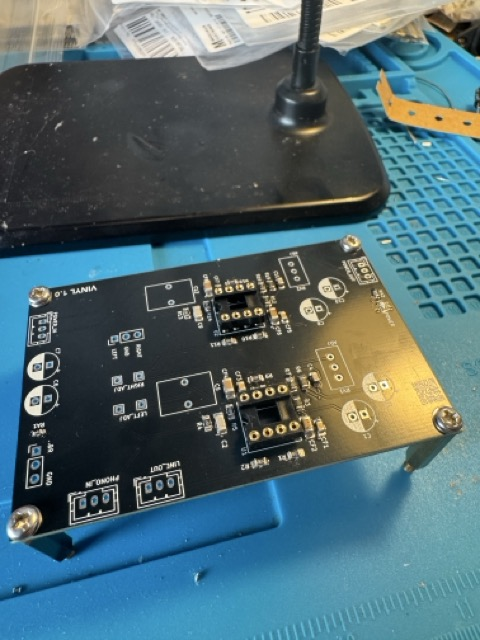
docs/log/IMG_3555 Medium.jpeg
