duanestorey/hifi-amp/docs/log/IMG_3556 Medium.jpeg

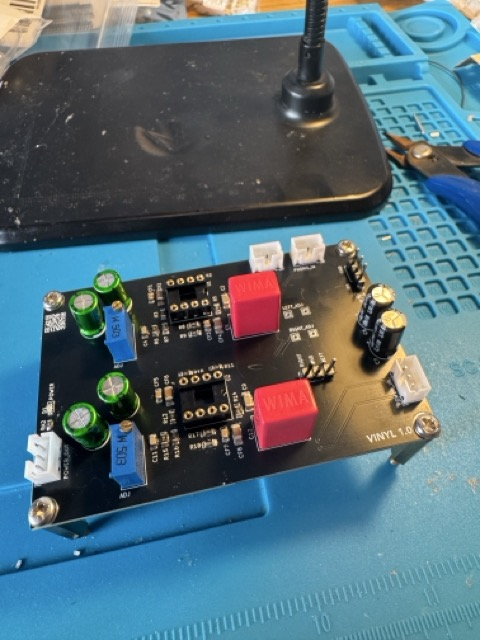
docs/log/IMG_3556 Medium.jpeg
