duanestorey/hifi-amp/docs/log/IMG_3559 Medium.jpeg

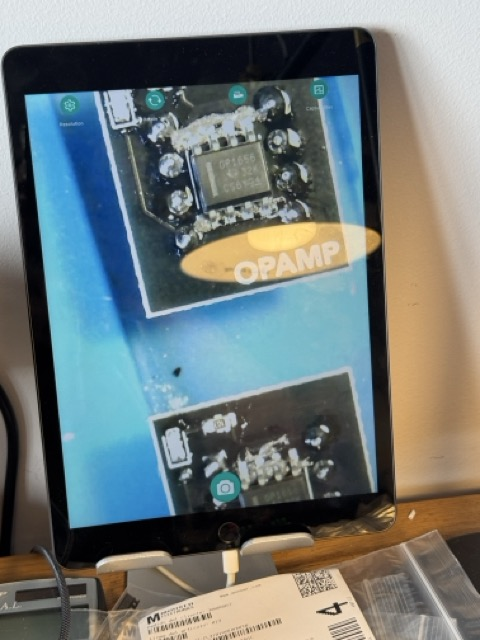
docs/log/IMG_3559 Medium.jpeg
