duanestorey/hifi-amp/docs/log/IMG_3560 Medium.jpeg

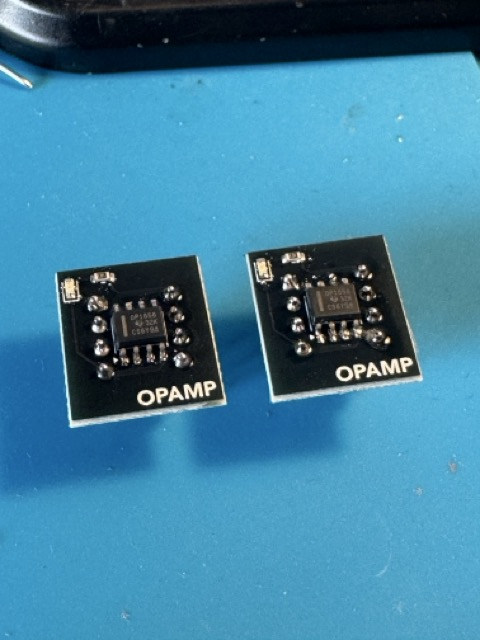
docs/log/IMG_3560 Medium.jpeg
