duanestorey/hifi-amp/docs/log/IMG_3561 Medium.jpeg

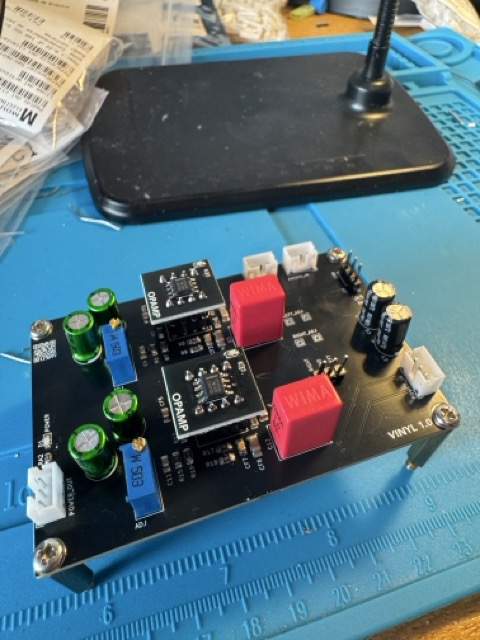
docs/log/IMG_3561 Medium.jpeg
