duanestorey/hifi-amp/docs/log/IMG_3562 Medium.jpeg

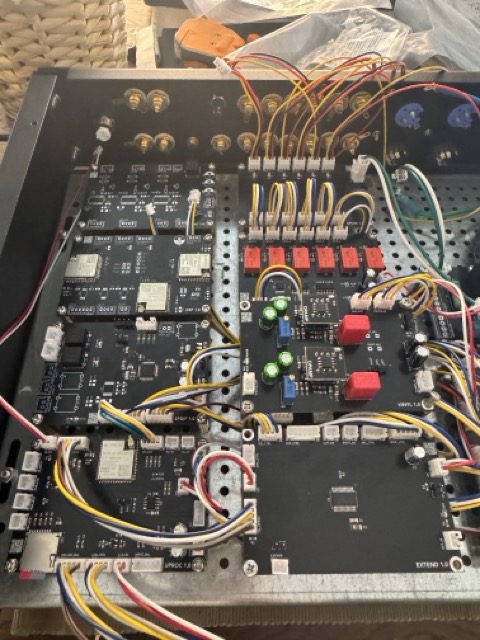
docs/log/IMG_3562 Medium.jpeg
