duanestorey/hifi-amp/docs/log/IMG_3563 Medium.jpeg

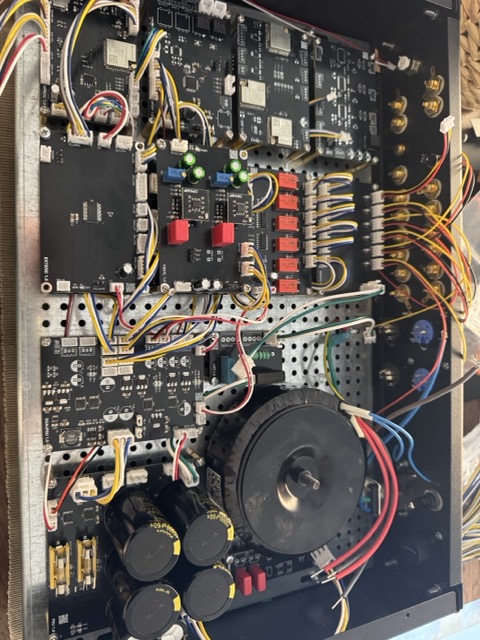
docs/log/IMG_3563 Medium.jpeg
