duanestorey/hifi-amp/docs/log/IMG_3564 Medium.jpeg

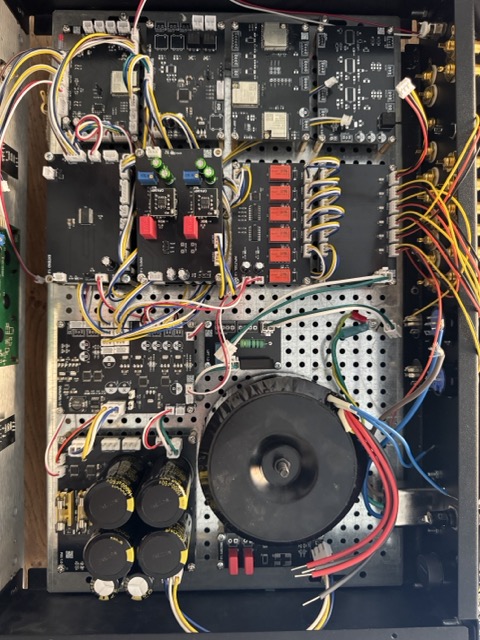
docs/log/IMG_3564 Medium.jpeg
