duanestorey/hifi-amp/docs/log/IMG_3565 Medium.jpeg

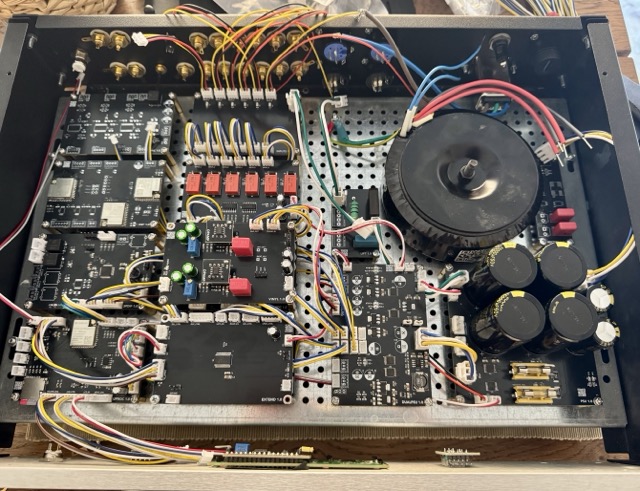
docs/log/IMG_3565 Medium.jpeg
