duanestorey/hifi-amp/docs/log/IMG_3618 Medium.jpeg

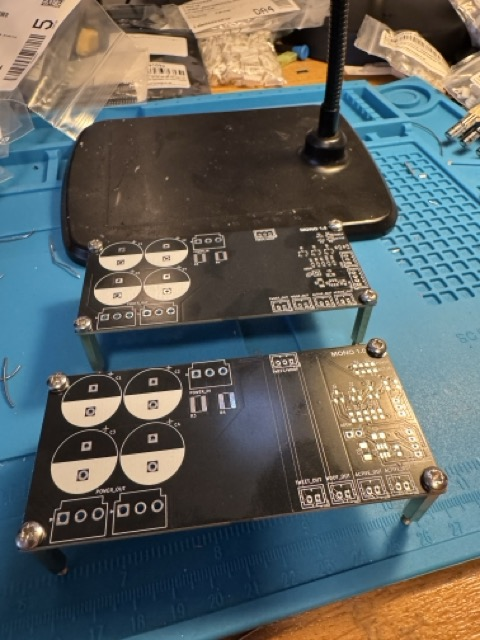
docs/log/IMG_3618 Medium.jpeg
