duanestorey/hifi-amp/docs/log/IMG_3619 Medium.jpeg

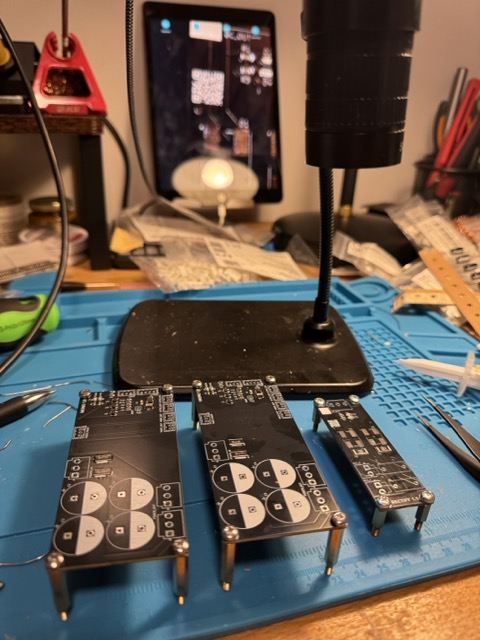
docs/log/IMG_3619 Medium.jpeg
