duanestorey/hifi-amp/docs/log/IMG_3620 Medium.jpeg

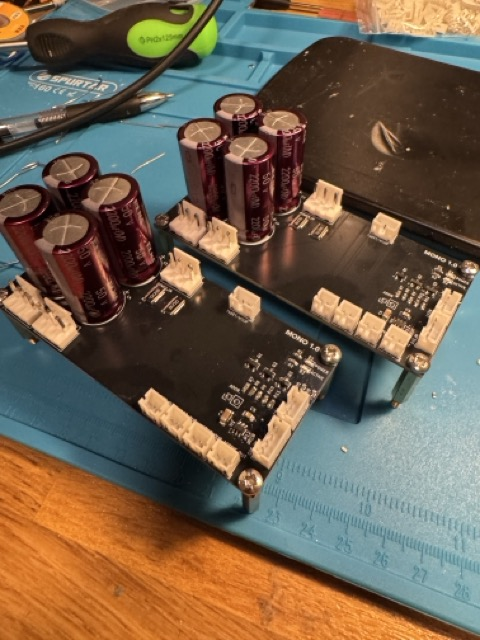
docs/log/IMG_3620 Medium.jpeg
