duanestorey/hifi-amp/docs/log/IMG_3621 Medium.jpeg

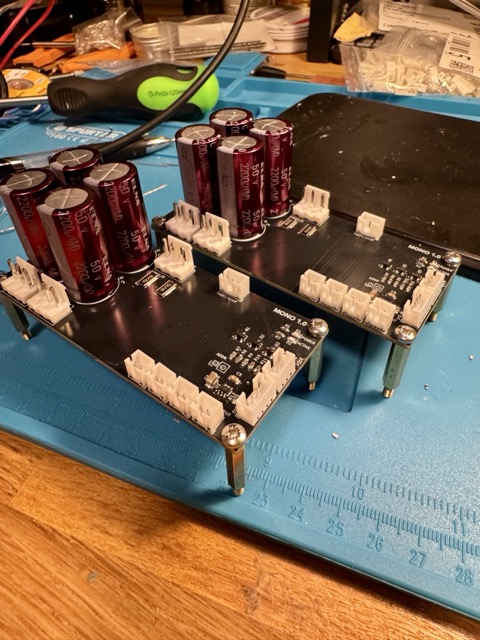
docs/log/IMG_3621 Medium.jpeg
