duanestorey/hifi-amp/docs/log/IMG_3623 Medium.jpeg

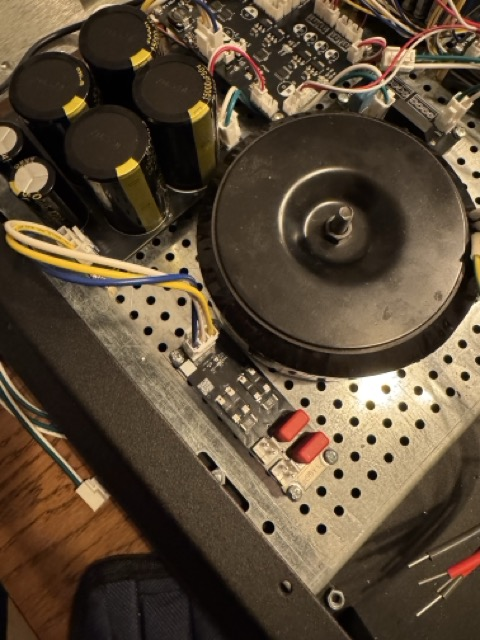
docs/log/IMG_3623 Medium.jpeg
