duanestorey/hifi-amp/docs/log/IMG_3624 Medium.jpeg

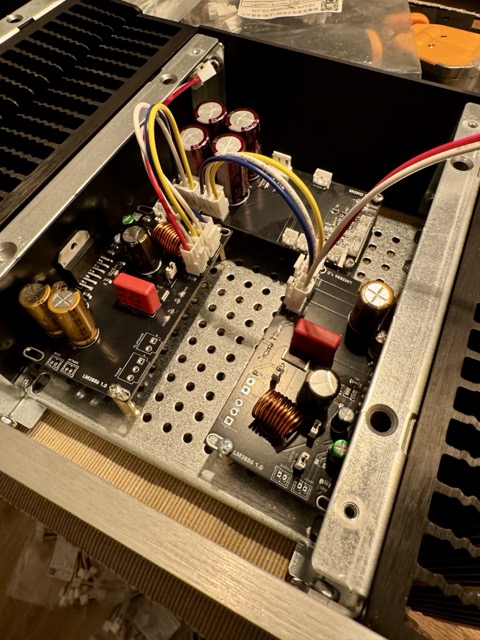
docs/log/IMG_3624 Medium.jpeg
