duanestorey/hifi-amp/docs/log/IMG_3625 Medium.jpeg

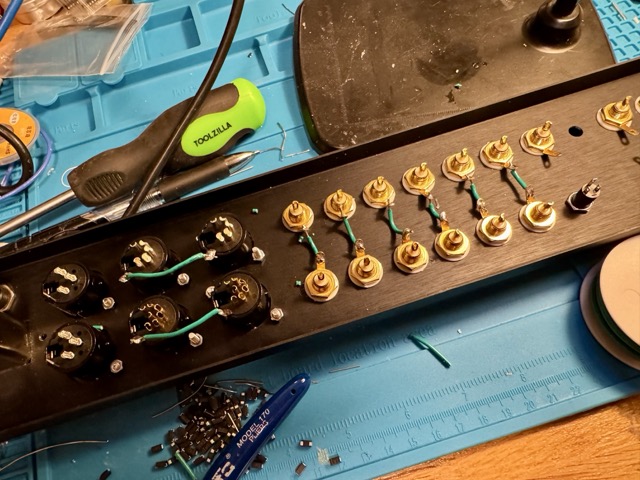
docs/log/IMG_3625 Medium.jpeg
