duanestorey/hifi-amp/docs/log/IMG_3626 Medium.jpeg

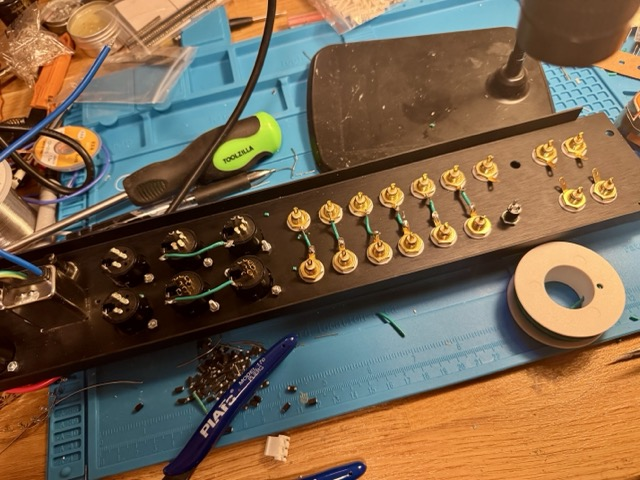
docs/log/IMG_3626 Medium.jpeg
