duanestorey/hifi-amp/docs/log/IMG_3627 Medium.jpeg

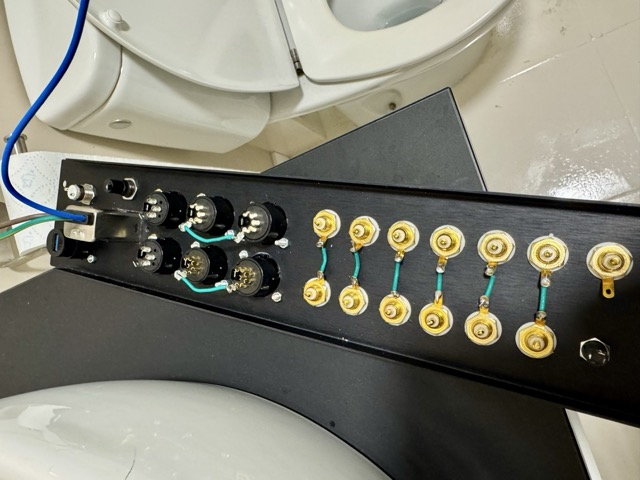
docs/log/IMG_3627 Medium.jpeg
