duanestorey/hifi-amp/docs/log/IMG_3628 Medium.jpeg

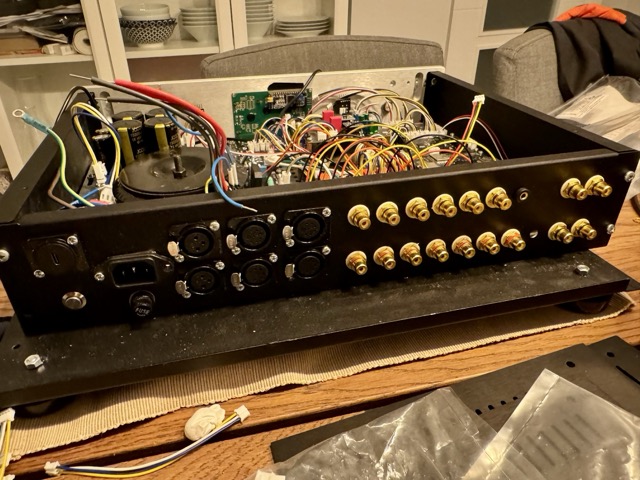
docs/log/IMG_3628 Medium.jpeg
