duanestorey/hifi-amp/docs/log/IMG_3637 Medium.jpeg

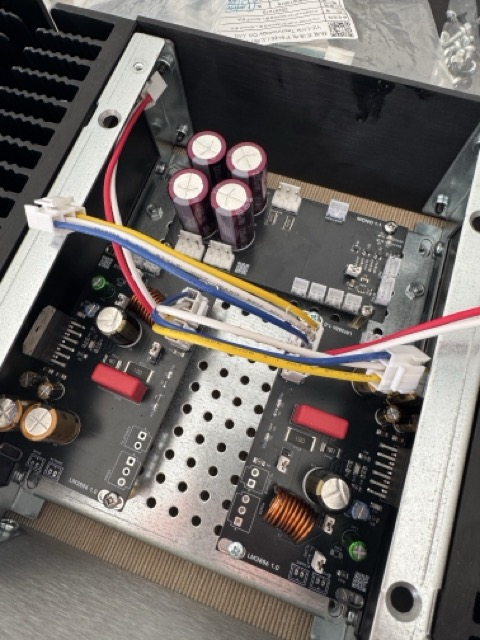
docs/log/IMG_3637 Medium.jpeg
