duanestorey/hifi-amp/docs/log/IMG_3638 Medium.jpeg

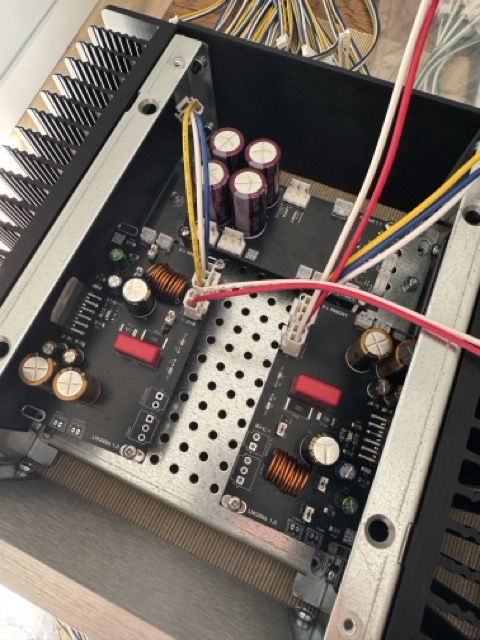
docs/log/IMG_3638 Medium.jpeg
