duanestorey/hifi-amp/docs/log/IMG_3641 Medium.jpeg

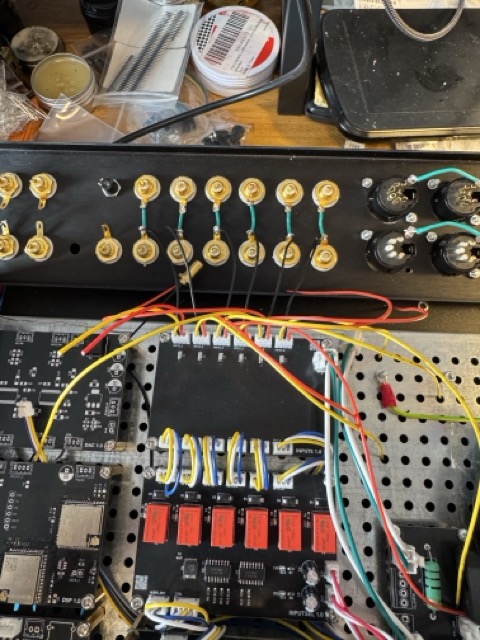
docs/log/IMG_3641 Medium.jpeg
