duanestorey/hifi-amp/docs/log/IMG_3643 Medium.jpeg

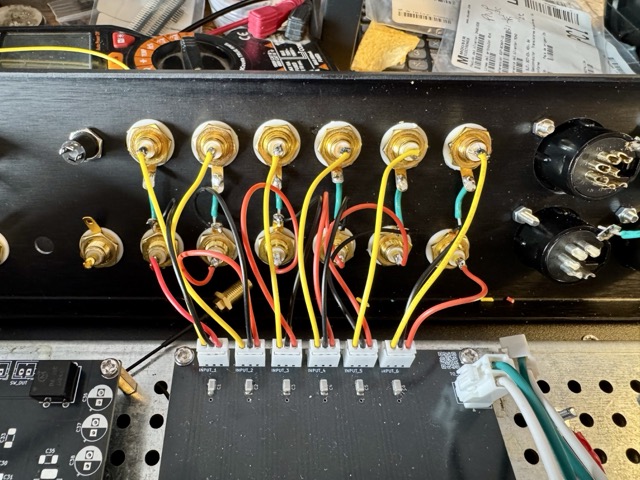
docs/log/IMG_3643 Medium.jpeg
