duanestorey/hifi-amp/docs/log/IMG_3644 Medium.jpeg

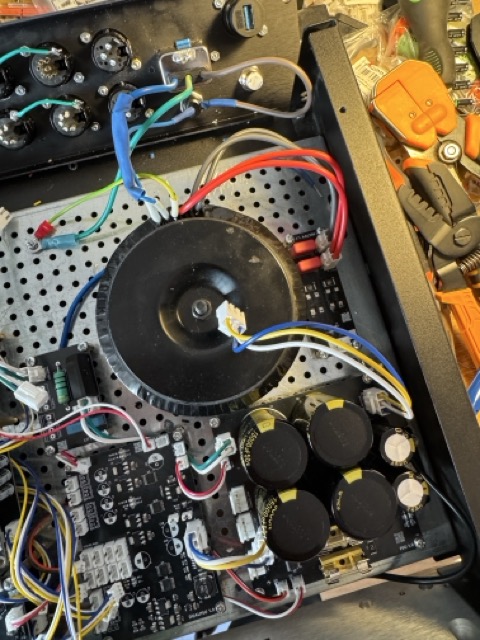
docs/log/IMG_3644 Medium.jpeg
