duanestorey/hifi-amp/docs/log/IMG_3645 Medium.jpeg

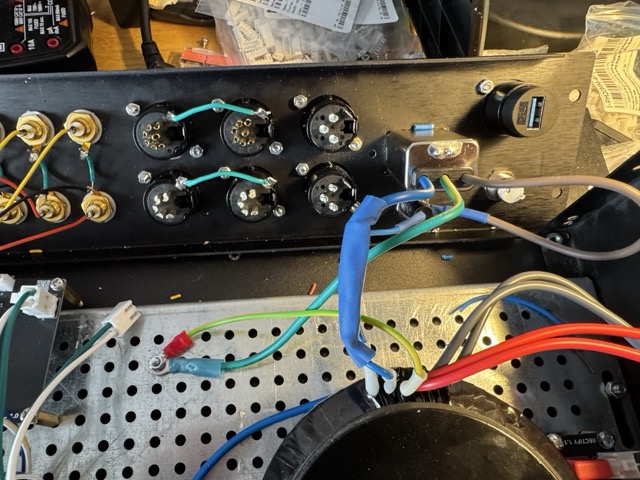
docs/log/IMG_3645 Medium.jpeg
