duanestorey/hifi-amp/docs/log/IMG_3646 Medium.jpeg

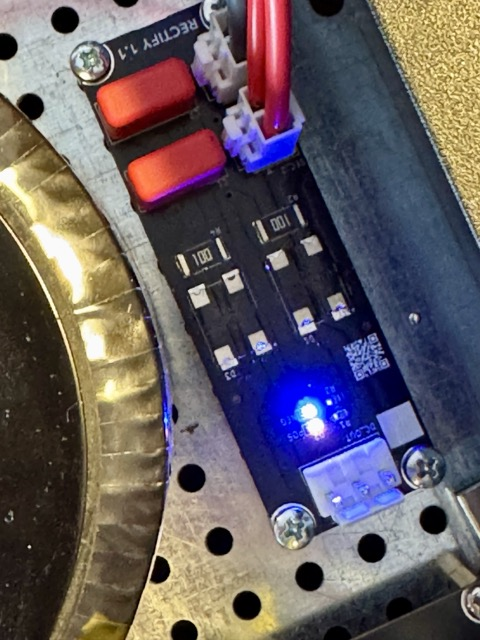
docs/log/IMG_3646 Medium.jpeg
