duanestorey/hifi-amp/docs/log/IMG_3647 Medium.jpeg

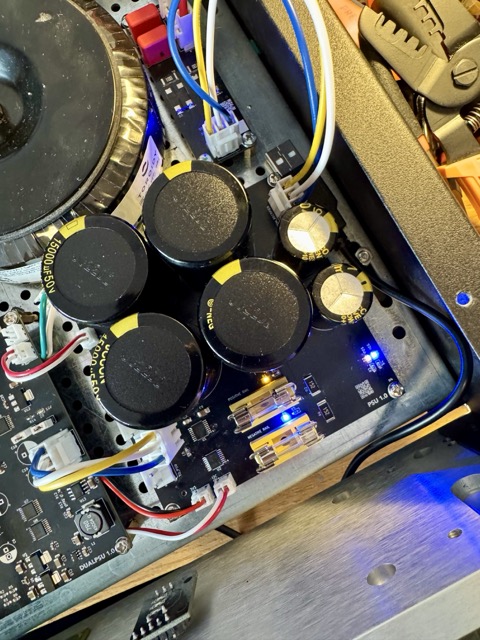
docs/log/IMG_3647 Medium.jpeg
