duanestorey/hifi-amp/docs/log/IMG_3648 Medium.jpeg

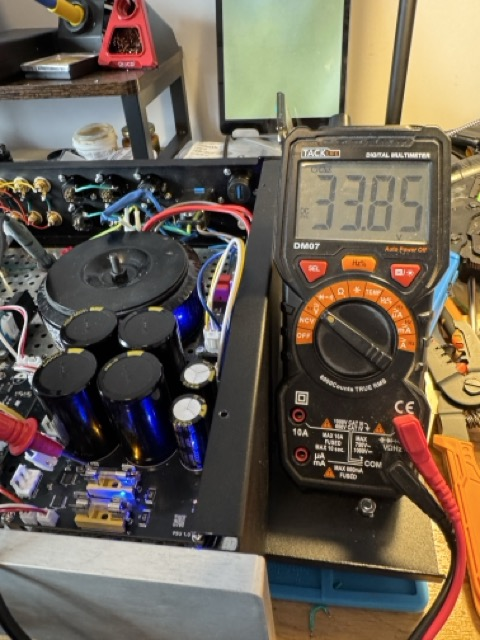
docs/log/IMG_3648 Medium.jpeg
