duanestorey/hifi-amp/docs/log/IMG_3649 Medium.jpeg

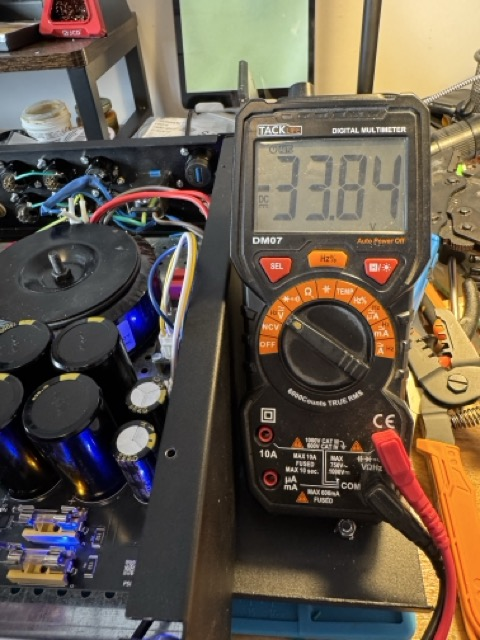
docs/log/IMG_3649 Medium.jpeg
