duanestorey/hifi-amp/docs/log/IMG_3650 Medium.jpeg

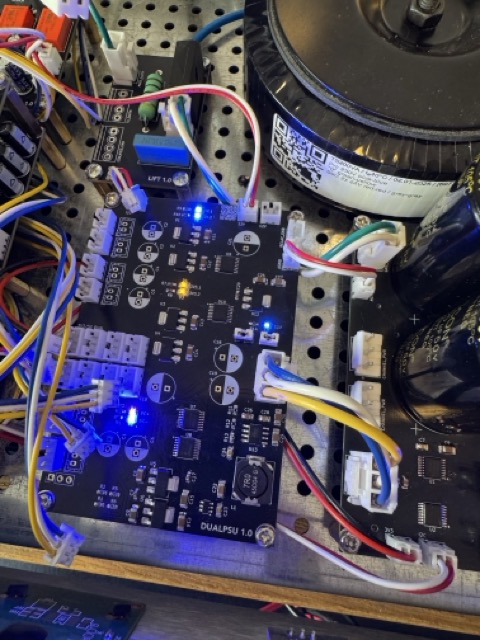
docs/log/IMG_3650 Medium.jpeg
