duanestorey/hifi-amp/docs/log/IMG_3651 Medium.jpeg

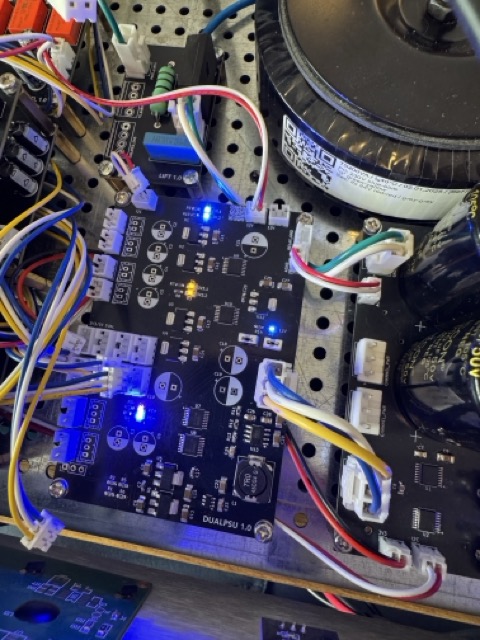
docs/log/IMG_3651 Medium.jpeg
