duanestorey/hifi-amp/docs/log/IMG_3653 Medium.jpeg

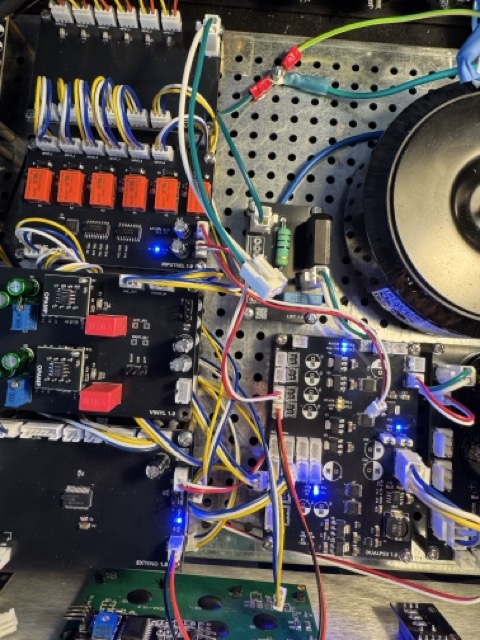
docs/log/IMG_3653 Medium.jpeg
