duanestorey/hifi-amp/docs/log/IMG_3654 Medium.jpeg

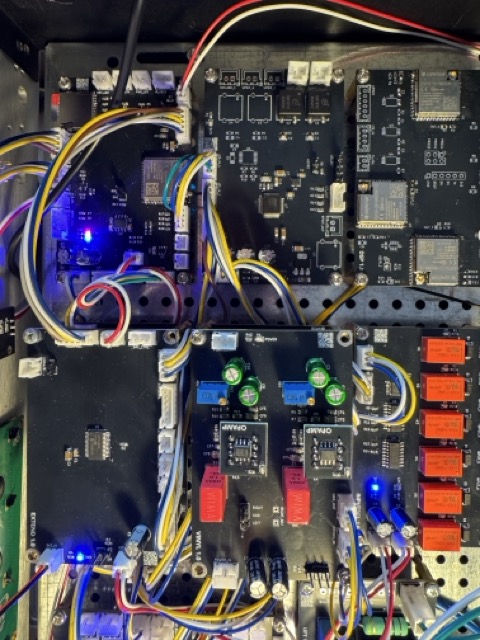
docs/log/IMG_3654 Medium.jpeg
