duanestorey/hifi-amp/docs/log/IMG_3655 Medium.jpeg

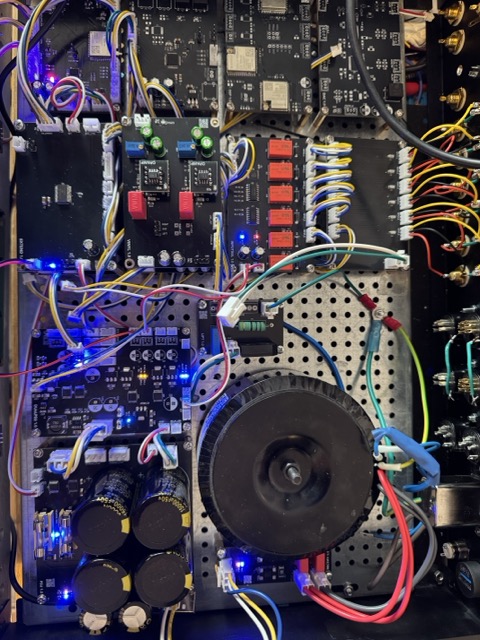
docs/log/IMG_3655 Medium.jpeg
