duanestorey/hifi-amp/docs/log/IMG_3660 Medium.jpeg

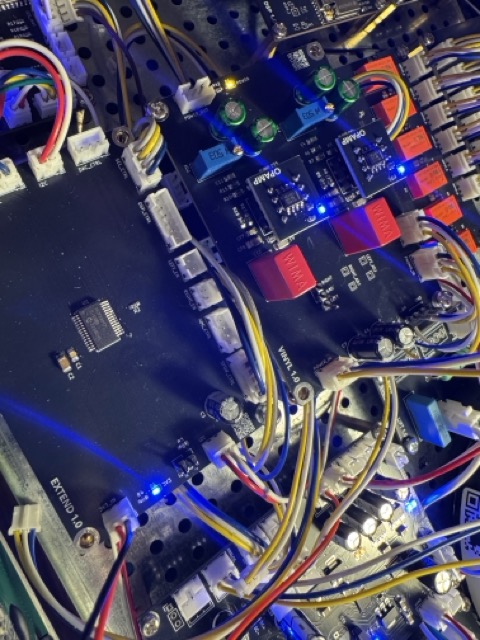
docs/log/IMG_3660 Medium.jpeg
