duanestorey/hifi-amp/docs/log/IMG_3661 Medium.jpeg

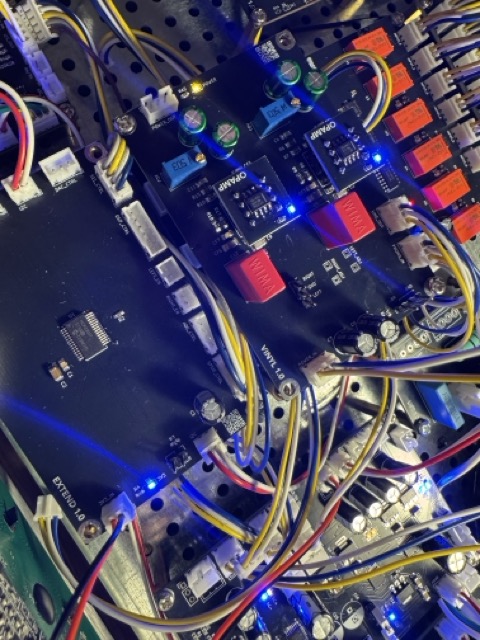
docs/log/IMG_3661 Medium.jpeg
