duanestorey/hifi-amp/docs/log/IMG_3662 Medium.jpeg

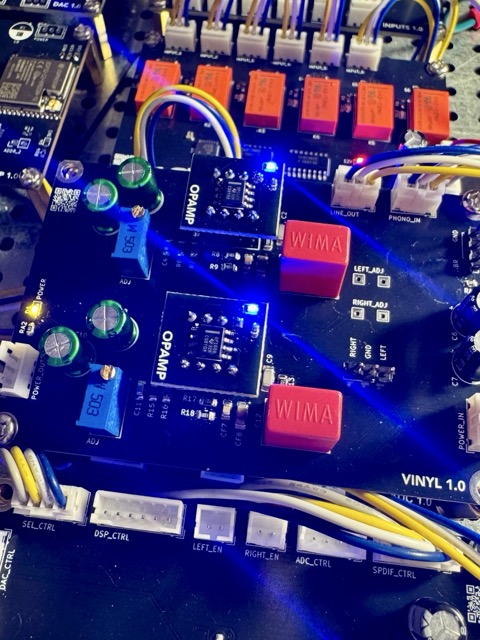
docs/log/IMG_3662 Medium.jpeg
