duanestorey/hifi-amp/docs/log/IMG_3666 Medium.jpeg

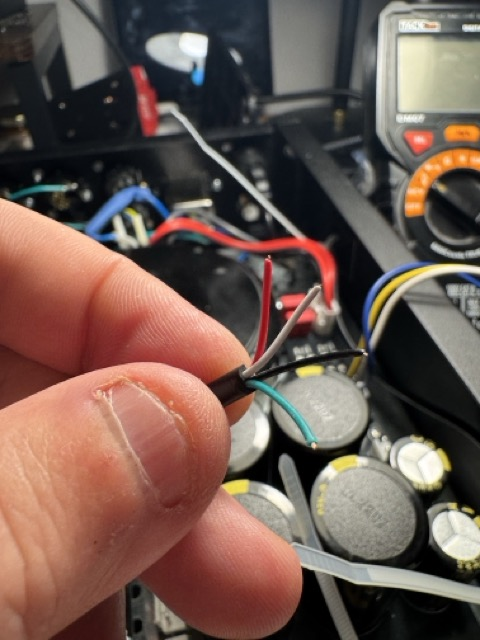
docs/log/IMG_3666 Medium.jpeg
