duanestorey/hifi-amp/docs/log/IMG_3668 Medium.jpeg

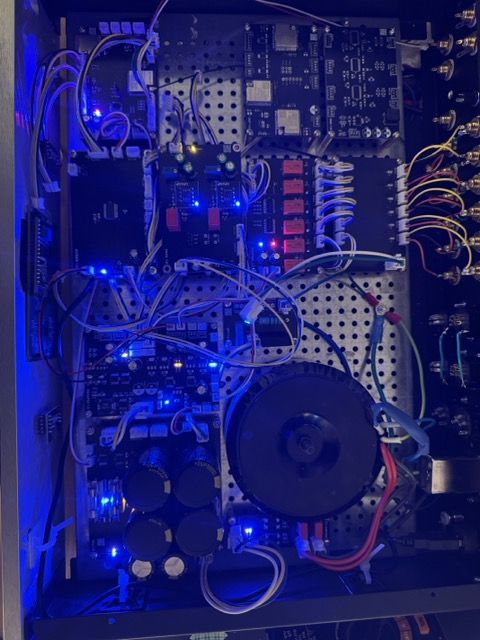
docs/log/IMG_3668 Medium.jpeg
