duanestorey/hifi-amp/docs/log/IMG_3669 Medium.jpeg

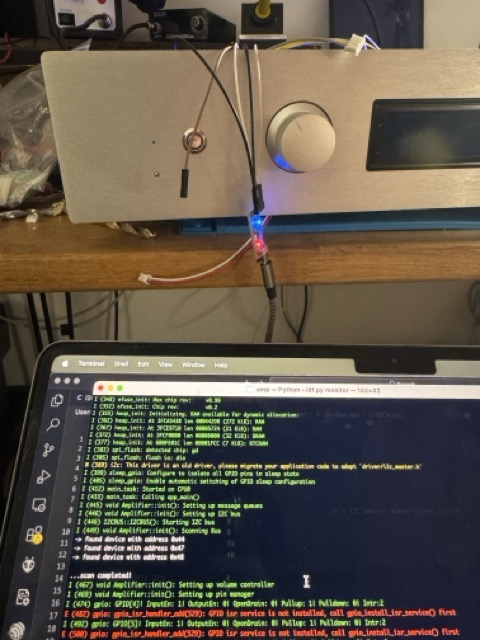
docs/log/IMG_3669 Medium.jpeg
