duanestorey/hifi-amp/docs/log/IMG_3670 2 Medium.jpeg

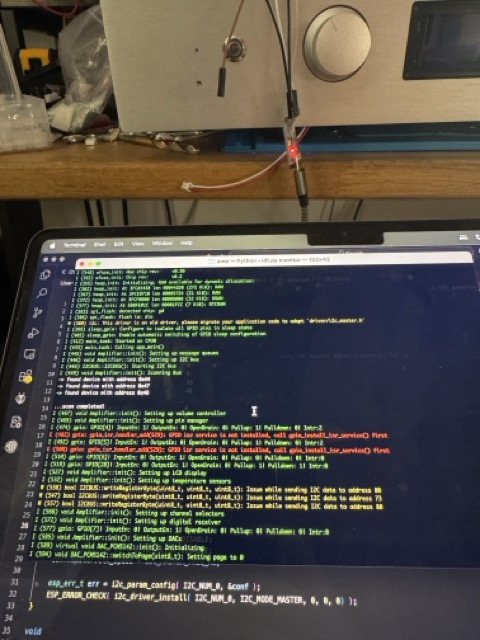
docs/log/IMG_3670 2 Medium.jpeg
