duanestorey/hifi-amp/docs/log/IMG_3673 Medium.jpeg

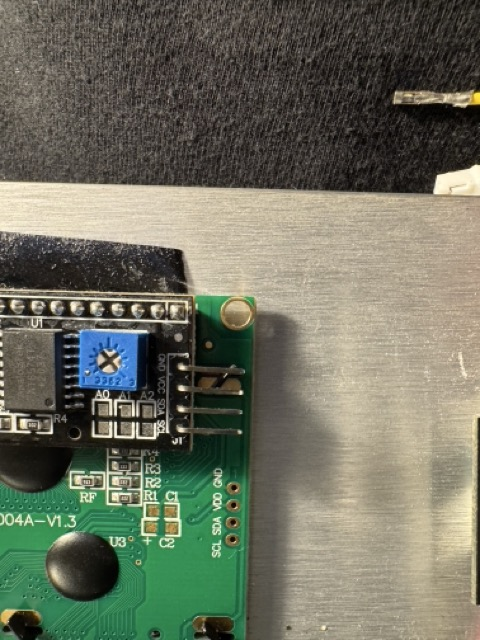
docs/log/IMG_3673 Medium.jpeg
