duanestorey/hifi-amp/docs/log/IMG_3684 Medium.jpeg

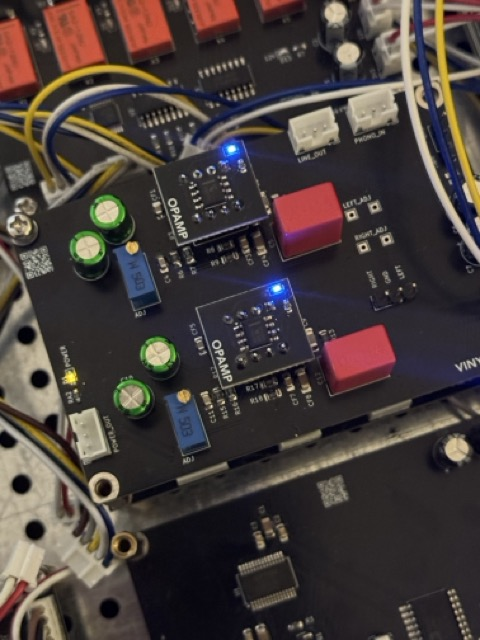
docs/log/IMG_3684 Medium.jpeg
