duanestorey/hifi-amp/kicad/Models/usb-c.step

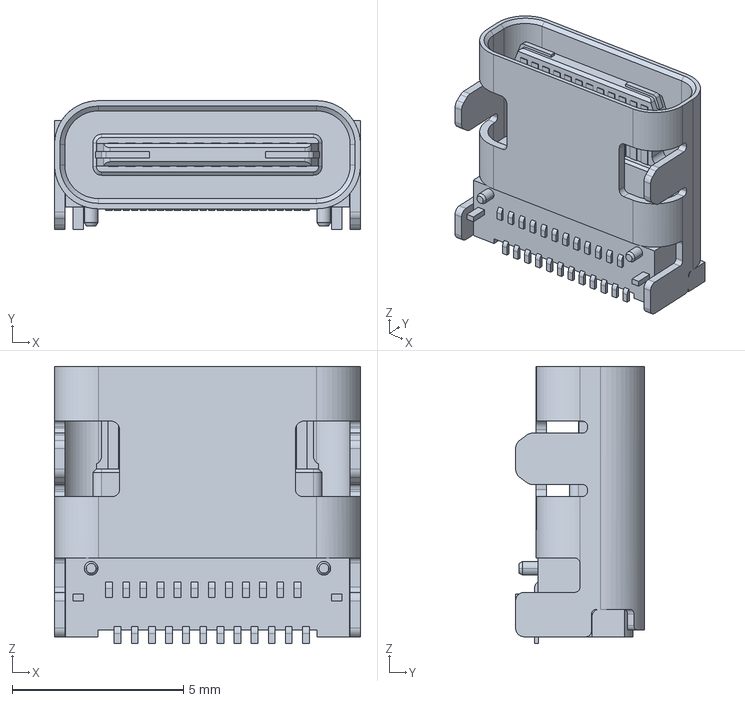
[picture p126: CAD file, 2025-11-16]
kicad/Models/usb-c.step
8.94 x 3.76 x 8.10 mm
