duanestorey/hifi-amp/kicad/Models/skqgafe010.stp

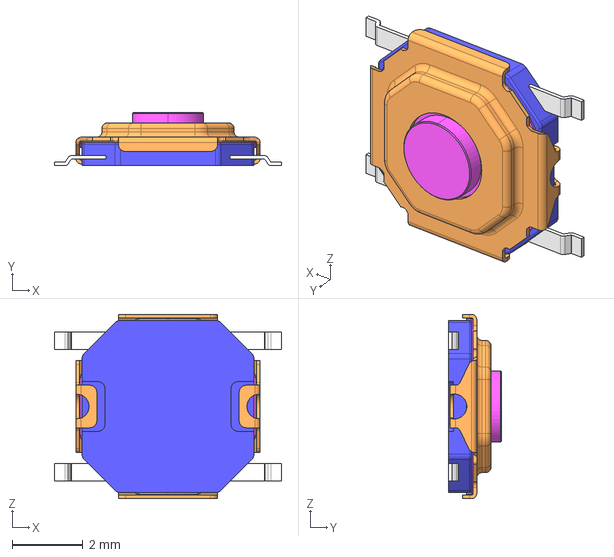
[picture p127: CAD file, 2025-11-16]
kicad/Models/skqgafe010.stp
6.40 x 1.50 x 5.20 mm
