duanestorey/hifi-amp/kicad/Models/B2P-VH--3DModel-STEP-56544.STEP

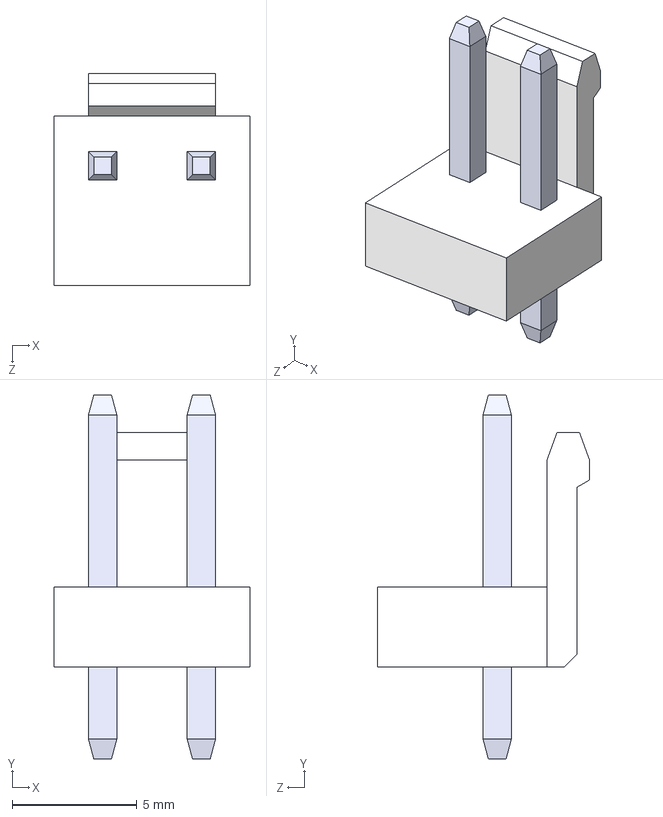
[picture p128: CAD file, 2025-11-16]
kicad/Models/B2P-VH--3DModel-STEP-56544.STEP
7.86 x 14.6 x 8.50 mm
BxP-VH_2
pin x 2
