duanestorey/hifi-amp/kicad/Models/Msbl.stp

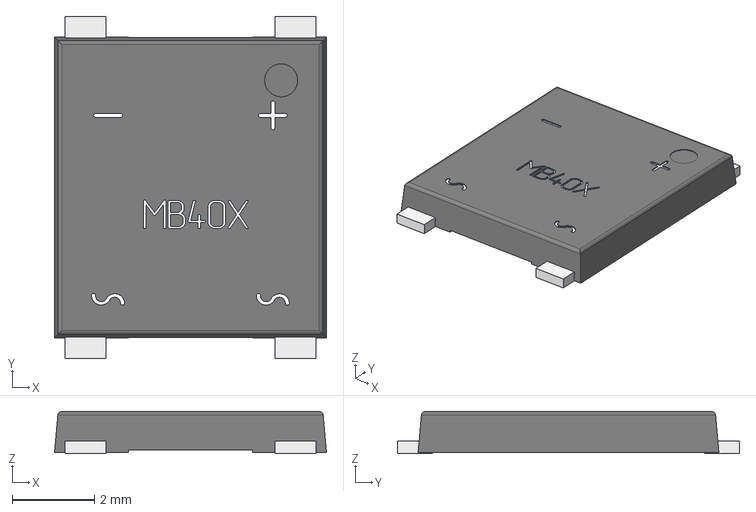
[picture p129: CAD file, 2025-11-16]
kicad/Models/Msbl.stp
6.60 x 8.30 x 1.02 mm
