duanestorey/hifi-amp/kicad/Models/B3P-VH-LF--SN---3DModel-STEP-510211.STEP

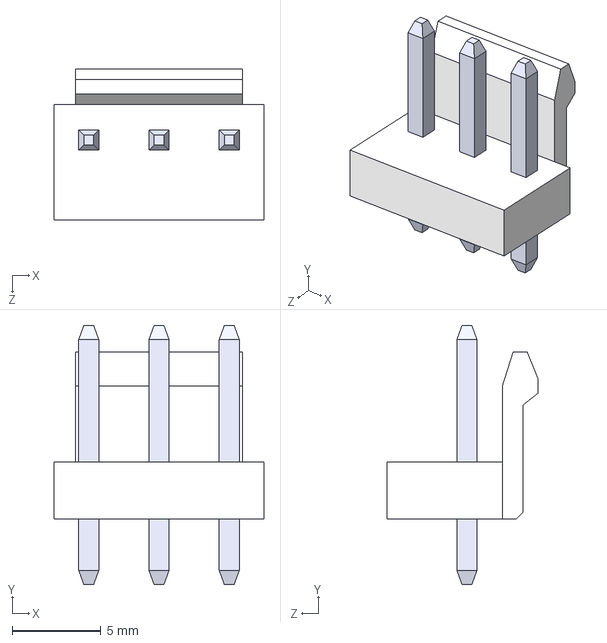
[picture p130: CAD file, 2025-11-16]
kicad/Models/B3P-VH-LF--SN---3DModel-STEP-510211.STEP
11.8 x 14.6 x 8.50 mm
