duanestorey/hifi-amp/kicad/Models/LM3886.STEP

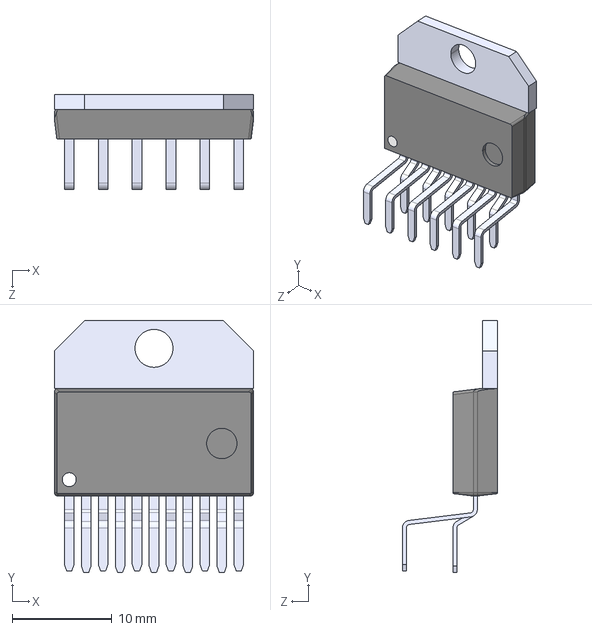
[picture p131: CAD file, 2025-11-16]
kicad/Models/LM3886.STEP
20.0 x 25.3 x 9.58 mm
