duanestorey/hifi-amp/kicad/Models/g2rl-2_24dc.stp

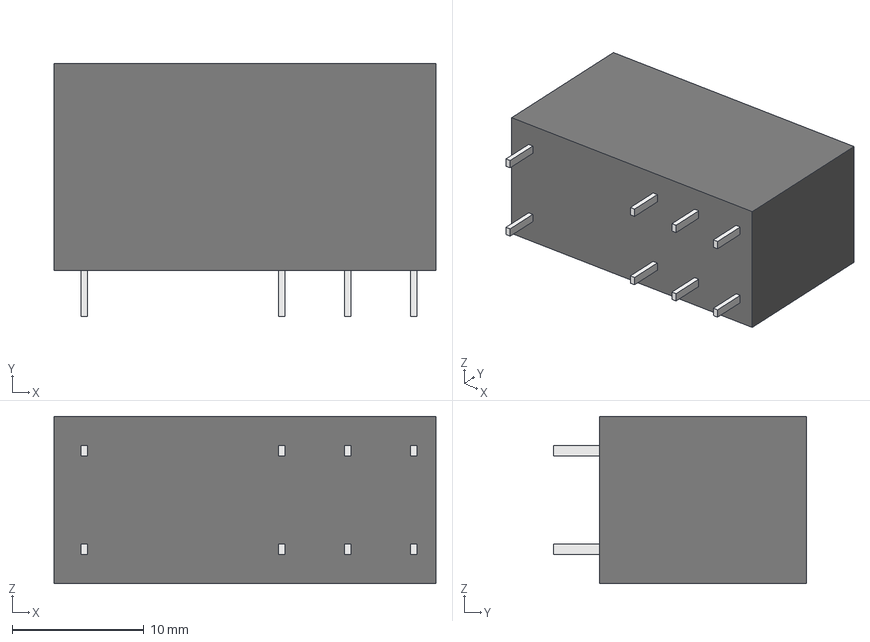
[picture p132: CAD file, 2025-11-16]
kicad/Models/g2rl-2_24dc.stp
29.0 x 19.2 x 12.7 mm
