duanestorey/hifi-amp/kicad/Models/SMD fuse holder v7.step

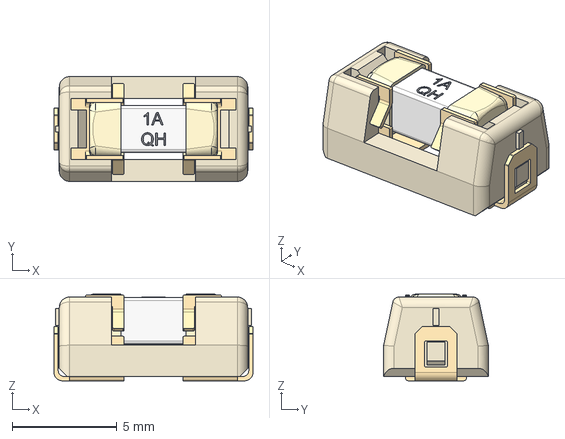
[picture p133: CAD file, 2025-11-16]
kicad/Models/SMD fuse holder v7.step
9.50 x 5.00 x 4.14 mm
0679H1000-xxsingle fonts v2
Terminal
