duanestorey/hifi-amp/kicad/Models/SSR21NV-M30064.step

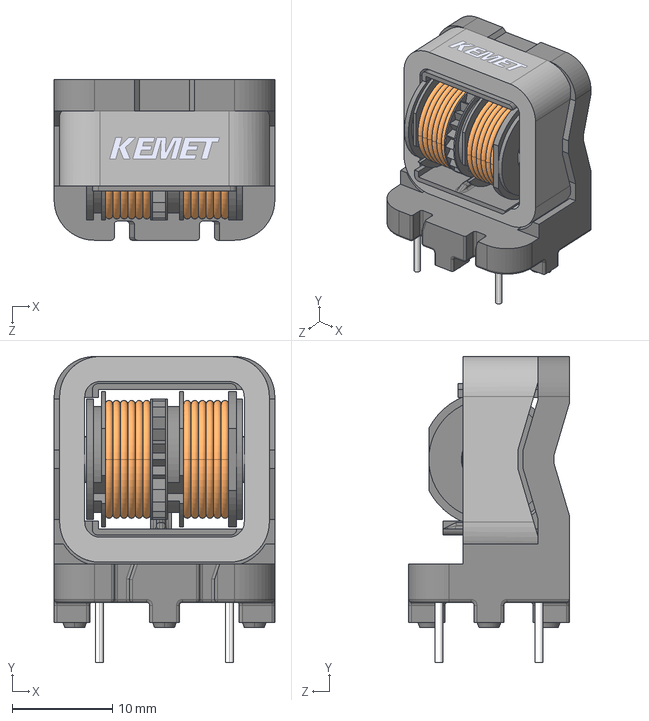
[picture p134: CAD file, 2025-10-22]
kicad/Models/SSR21NV-M30064.step
22.0 x 30.5 x 16.0 mm
