duanestorey/hifi-amp/kicad/Models/2171790001.stp

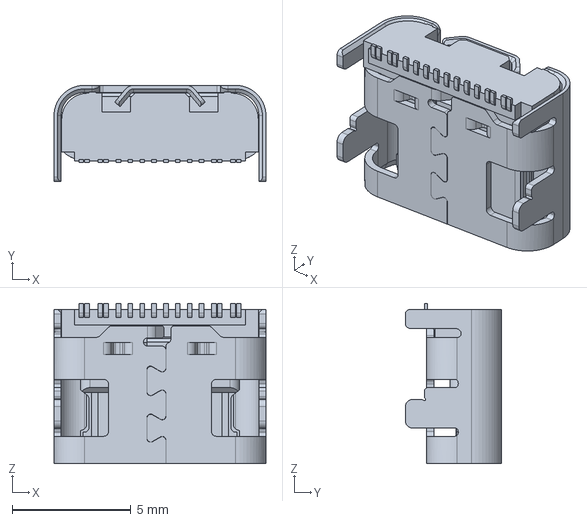
[picture p135: CAD file, 2025-11-16]
kicad/Models/2171790001.stp
8.94 x 4.06 x 6.75 mm
