duanestorey/hifi-amp/(list of files, cad)

Other CAD files:
cad/amp.scad
cad/amp2.scad
cad/back.scad
