duanestorey/hifi-amp/docs/build/index.md

## Build

### Contents

- [Chassis & Monoblocks](chassis.md)
- [IEC Inlet & Transformer](iec.md)
- [Grounds and Ground Lift](grounds.md)
- [Amplifier Back Panel](amp-back-panel.md)
- [Rectifier & Main PSU](psu.md)
- [Accessory PSU](dual-psu.md)
- [FTDI & Microprocessor](ftdi-uproc.md)
- [Buttons & LCD](buttons.md)
- [GPIO Extender](gpio.md)
- [Inputs & Input Selector](inputs.md)
- [Vinyl](vinyl.md)
- [SPDIF & DSP](dsp.md)
- [ADC & DAC](adc-dac.md)
- [Amplifier Back Panel Wiring](wiring.md)
- [Monoblocks](mono.md)
- [Channel Amplifiers](lm3886.md)
- [Monoblock Back Panel](mono-back-panel.md)

[Return to main page](/)
