duanestorey/hifi-amp/pcbs/_ToPrint.rtf

February 28, 2025

- DAC17??

- DAC - DONE
- DSP - DONE
- DOLBY - DONE
- ENTRY - DONE
- I2S - DONE
- LM3886 - DONE
- MONITOR - DONE
- MULTI - DONE
- SPLIT - DONE
- RECTIFY - DONE
- SPDIF CS8416

Aliexpress
ADAU
TSSOP CS8416
