duanestorey/hifi-amp/(list of files, drawings)

Other design files:
pcbs/_final_proto/adc/1.0/freerouting.dsn
pcbs/adc/1.2/freerouting.dsn
