duanestorey/hifi-amp/pcbs/_final_proto/psu-split/1.2/split.kicad_pcb

## KiCad design pcbs/_final_proto/psu-split/1.2/split.kicad_pcb (2025-11-16)

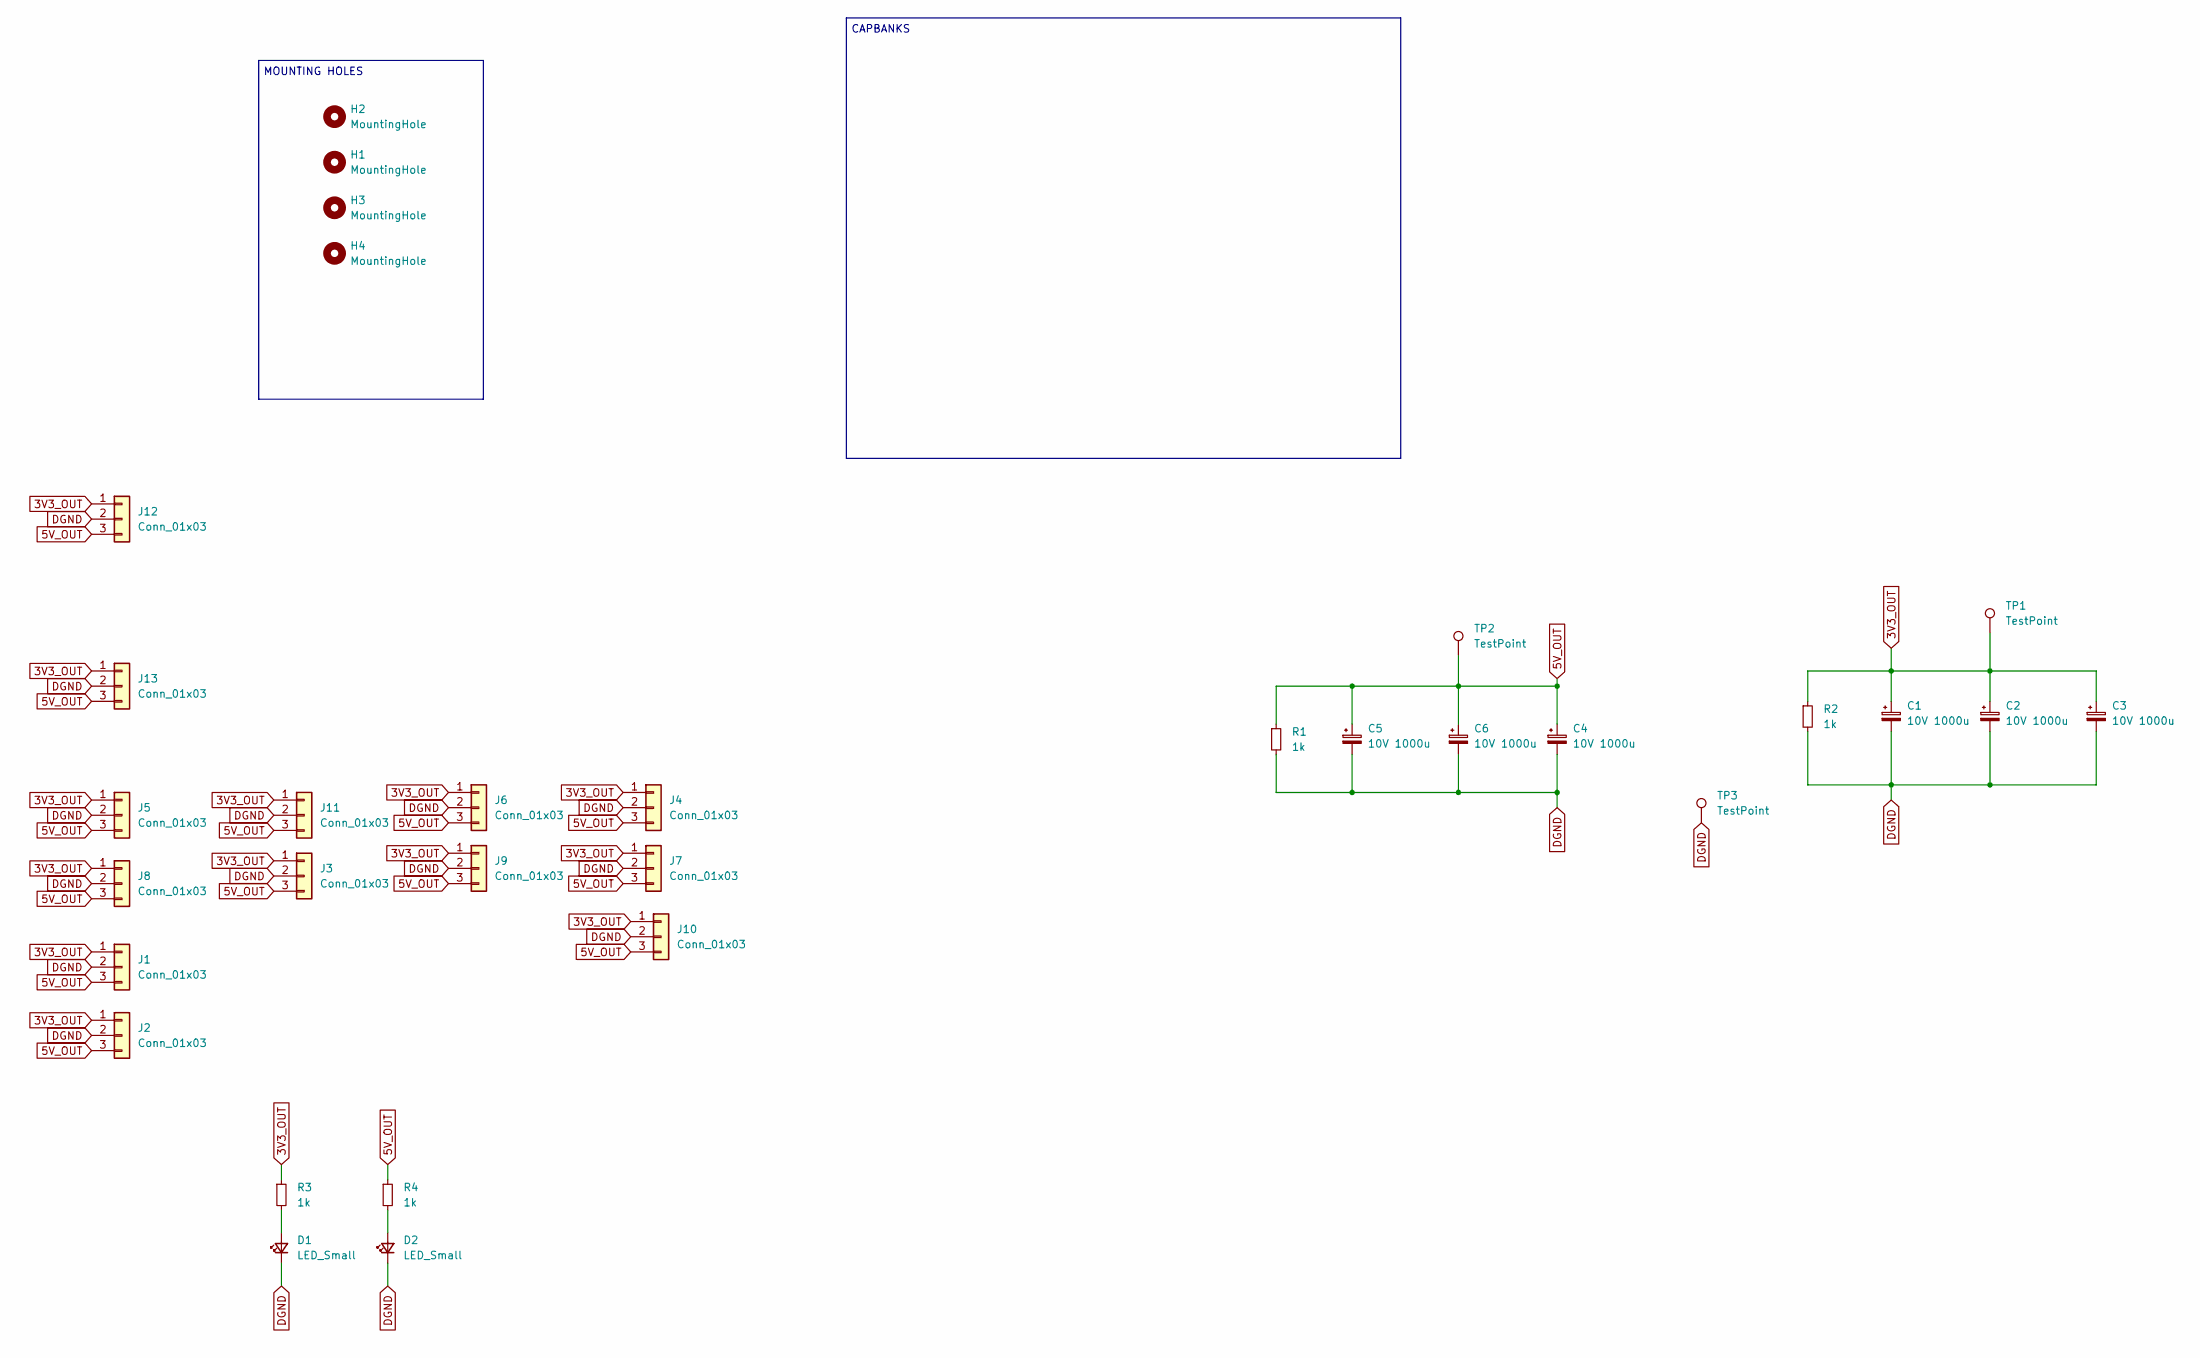
[picture p136: schematic split.kicad_sch]

Parts:
C1, C2, C3, C4, C5, C6: 10V 1000u; CP_Elec_10x10
D1, D2: LED_Small; LED_0805_2012Metric_Pad_HandSolder_Duane
H1, H2, H3, H4: MountingHole; MountingHole_3.2mm_M3_DIN965_Pad_TopBottom
J1, J2, J3, J4, J5, J6, J7, J8, J9, J10, J11, J13: Conn_01x03; JST_PH_B3B-PH-K_1x03_P2.00mm_Vertical
J12: Conn_01x03; JST_VH_B3P-VH-B_1x03_P3.96mm_Vertical_Duane
R1, R2, R3, R4: 1k; R_0805_2012Metric_Pad1.20x1.40mm_HandSolder_Duane
TP1, TP2, TP3: TestPoint; TestPoint_THTPad_2.5x2.5mm_Drill1.2mm

Connections:
3V3_OUT: C1.1, C2.1, C3.1, J1.1, J2.1, J3.1, J4.1, J5.1, J6.1, J7.1, J8.1, J9.1, J10.1, J11.1, J12.1, J13.1, R2.1, R3.1, TP1.1
5V_OUT: C4.1, C5.1, C6.1, J1.3, J2.3, J3.3, J4.3, J5.3, J6.3, J7.3, J8.3, J9.3, J10.3, J11.3, J12.3, J13.3, R1.1, R4.1, TP2.1
DGND: C1.2, C2.2, C3.2, C4.2, C5.2, C6.2, D1.1 (K), D2.1 (K), J1.2, J2.2, J3.2, J4.2, J5.2, J6.2, J7.2, J8.2, J9.2, J10.2, J11.2, J12.2, J13.2, R1.2, R2.2, TP3.1
unnamed: D1.2 (A), R3.2
unnamed: D2.2 (A), R4.2

Notes on the sheet:
MOUNTING HOLES
CAPBANKS

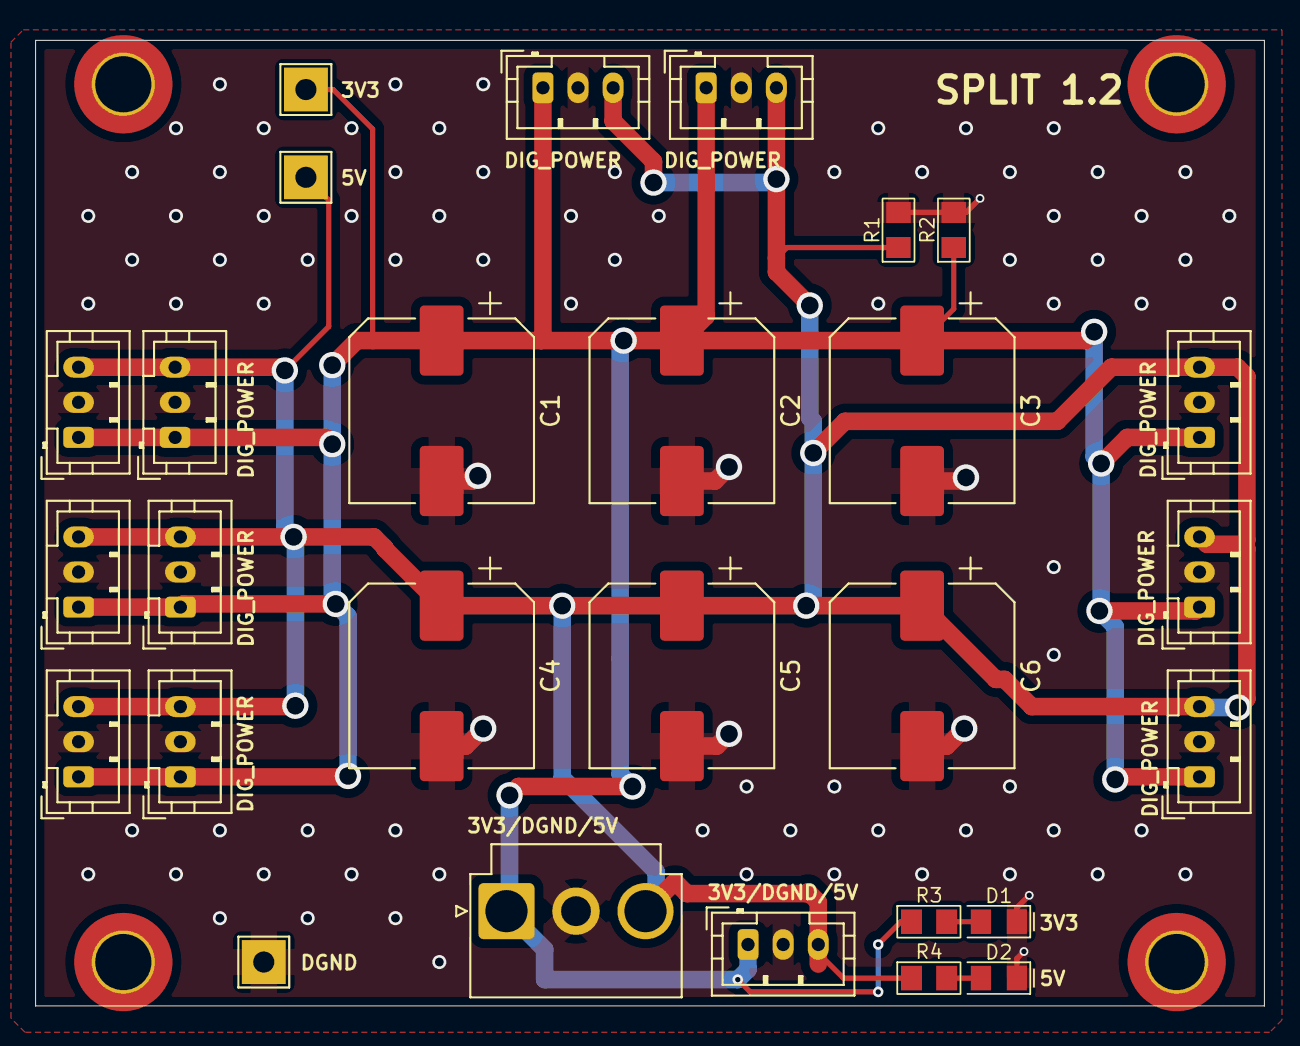
[picture p137: board pcbs/_final_proto/psu-split/1.2/split.kicad_pcb from above]

Board: 2 copper layers, 70.0 x 55.0 mm, 32 parts (0 on the bottom side), 5 nets.
