duanestorey/hifi-amp/pcbs/_final_proto/psu-monitor/1.2/rectifier.kicad_pcb

## KiCad design pcbs/_final_proto/psu-monitor/1.2/rectifier.kicad_pcb (2025-11-16)

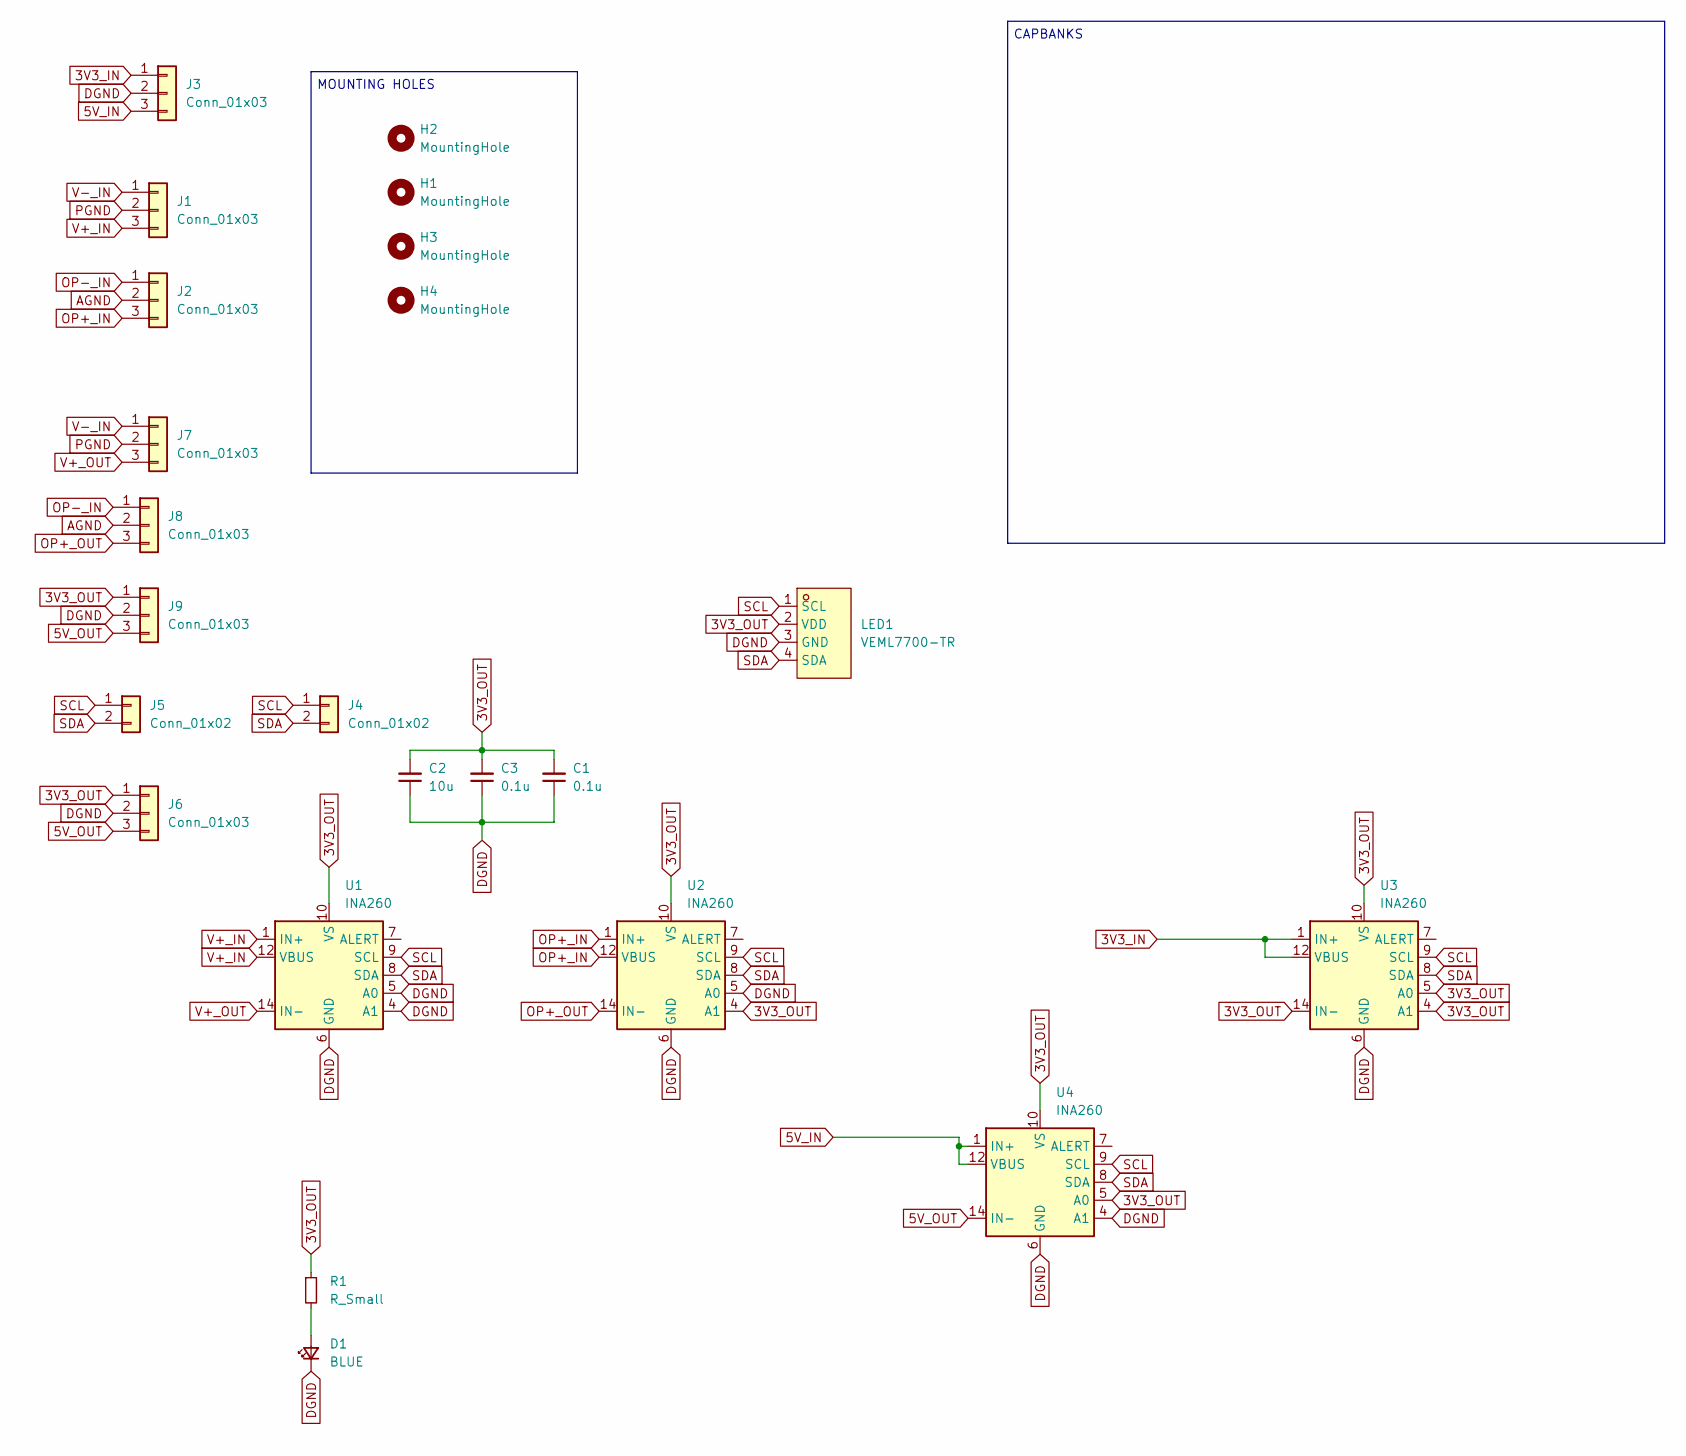
[picture p138: schematic rectifier.kicad_sch]

Parts:
C1, C3: 0.1u; C_0805_2012Metric_Pad1.18x1.45mm_HandSolder_Duane
C2: 10u; C_1206_3216Metric_Pad1.33x1.80mm_HandSolder_Duane
D1: BLUE; LED_0805_2012Metric_Pad_HandSolder_Duane
H1, H2, H3, H4: MountingHole; MountingHole_3.2mm_M3_DIN965_Pad_TopBottom
J1, J2, J3, J7, J8, J9: Conn_01x03; JST_VH_B3P-VH-B_1x03_P3.96mm_Vertical_Duane
J4, J5: Conn_01x02; JST_PH_B2B-PH-K_1x02_P2.00mm_Vertical
J6: Conn_01x03; JST_PH_B3B-PH-K_1x03_P2.00mm_Vertical
LED1: VEML7700-TR; LED-SMD_4P-L6.8-W2.4_VEML7700-TR; LCSC Part C504893
R1: R_Small; R_0805_2012Metric_Pad1.20x1.40mm_HandSolder_Duane
U1, U2, U3, U4: INA260; TSSOP-16_4.4x5mm_P0.65mm

Connections:
3V3_IN: J3.1, U3.1 (IN+), U3.2 (IN+), U3.3 (IN+), U3.12 (VBUS)
3V3_OUT: C1.2, C2.2, C3.2, J6.1, J9.1, LED1.2 (VDD), R1.1, U1.10 (VS), U2.4 (A1), U2.10 (VS), U3.4 (A1), U3.5 (A0), U3.10 (VS), U3.14 (IN-), U3.15 (IN-), U3.16 (IN-), U4.5 (A0), U4.10 (VS)
5V_IN: J3.3, U4.1 (IN+), U4.2 (IN+), U4.3 (IN+), U4.12 (VBUS)
5V_OUT: J6.3, J9.3, U4.14 (IN-), U4.15 (IN-), U4.16 (IN-)
AGND: J2.2, J8.2
DGND: C1.1, C2.1, C3.1, D1.1 (K), J3.2, J6.2, J9.2, LED1.3 (GND), U1.4 (A1), U1.5 (A0), U1.6 (GND), U1.11 (GND), U2.5 (A0), U2.6 (GND), U2.11 (GND), U3.6 (GND), U3.11 (GND), U4.4 (A1), U4.6 (GND), U4.11 (GND)
unnamed: D1.2 (A), R1.2
OP+_IN: J2.3, U2.1 (IN+), U2.2 (IN+), U2.3 (IN+), U2.12 (VBUS)
OP+_OUT: J8.3, U2.14 (IN-), U2.15 (IN-), U2.16 (IN-)
OP-_IN: J2.1, J8.1
PGND: J1.2, J7.2
SCL: J4.1, J5.1, LED1.1 (SCL), U1.9 (SCL), U2.9 (SCL), U3.9 (SCL), U4.9 (SCL)
SDA: J4.2, J5.2, LED1.4 (SDA), U1.8 (SDA), U2.8 (SDA), U3.8 (SDA), U4.8 (SDA)
V+_IN: J1.3, U1.1 (IN+), U1.2 (IN+), U1.3 (IN+), U1.12 (VBUS)
V+_OUT: J7.3, U1.14 (IN-), U1.15 (IN-), U1.16 (IN-)
V-_IN: J1.1, J7.1

Notes on the sheet:
MOUNTING HOLES
CAPBANKS

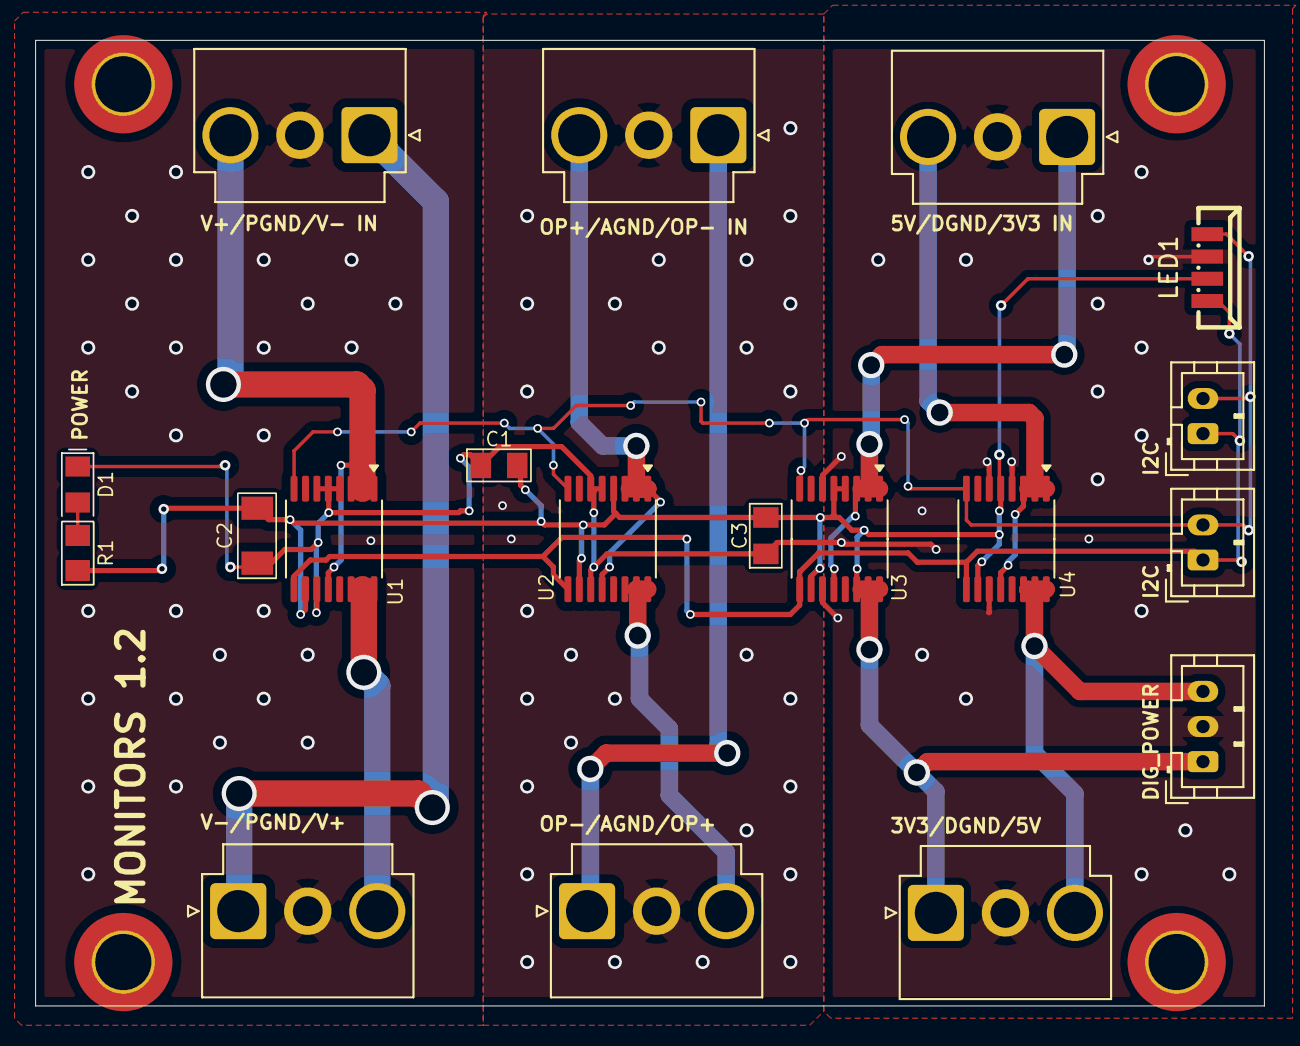
[picture p139: board pcbs/_final_proto/psu-monitor/1.2/rectifier.kicad_pcb from above]

Board: 2 copper layers, 70.0 x 55.0 mm, 23 parts (0 on the bottom side), 16 nets.
