duanestorey/hifi-amp/pcbs/_final_proto/dsp/1.1-raw/dsp.kicad_pcb

## KiCad design pcbs/_final_proto/dsp/1.1-raw/dsp.kicad_pcb (2025-11-16)

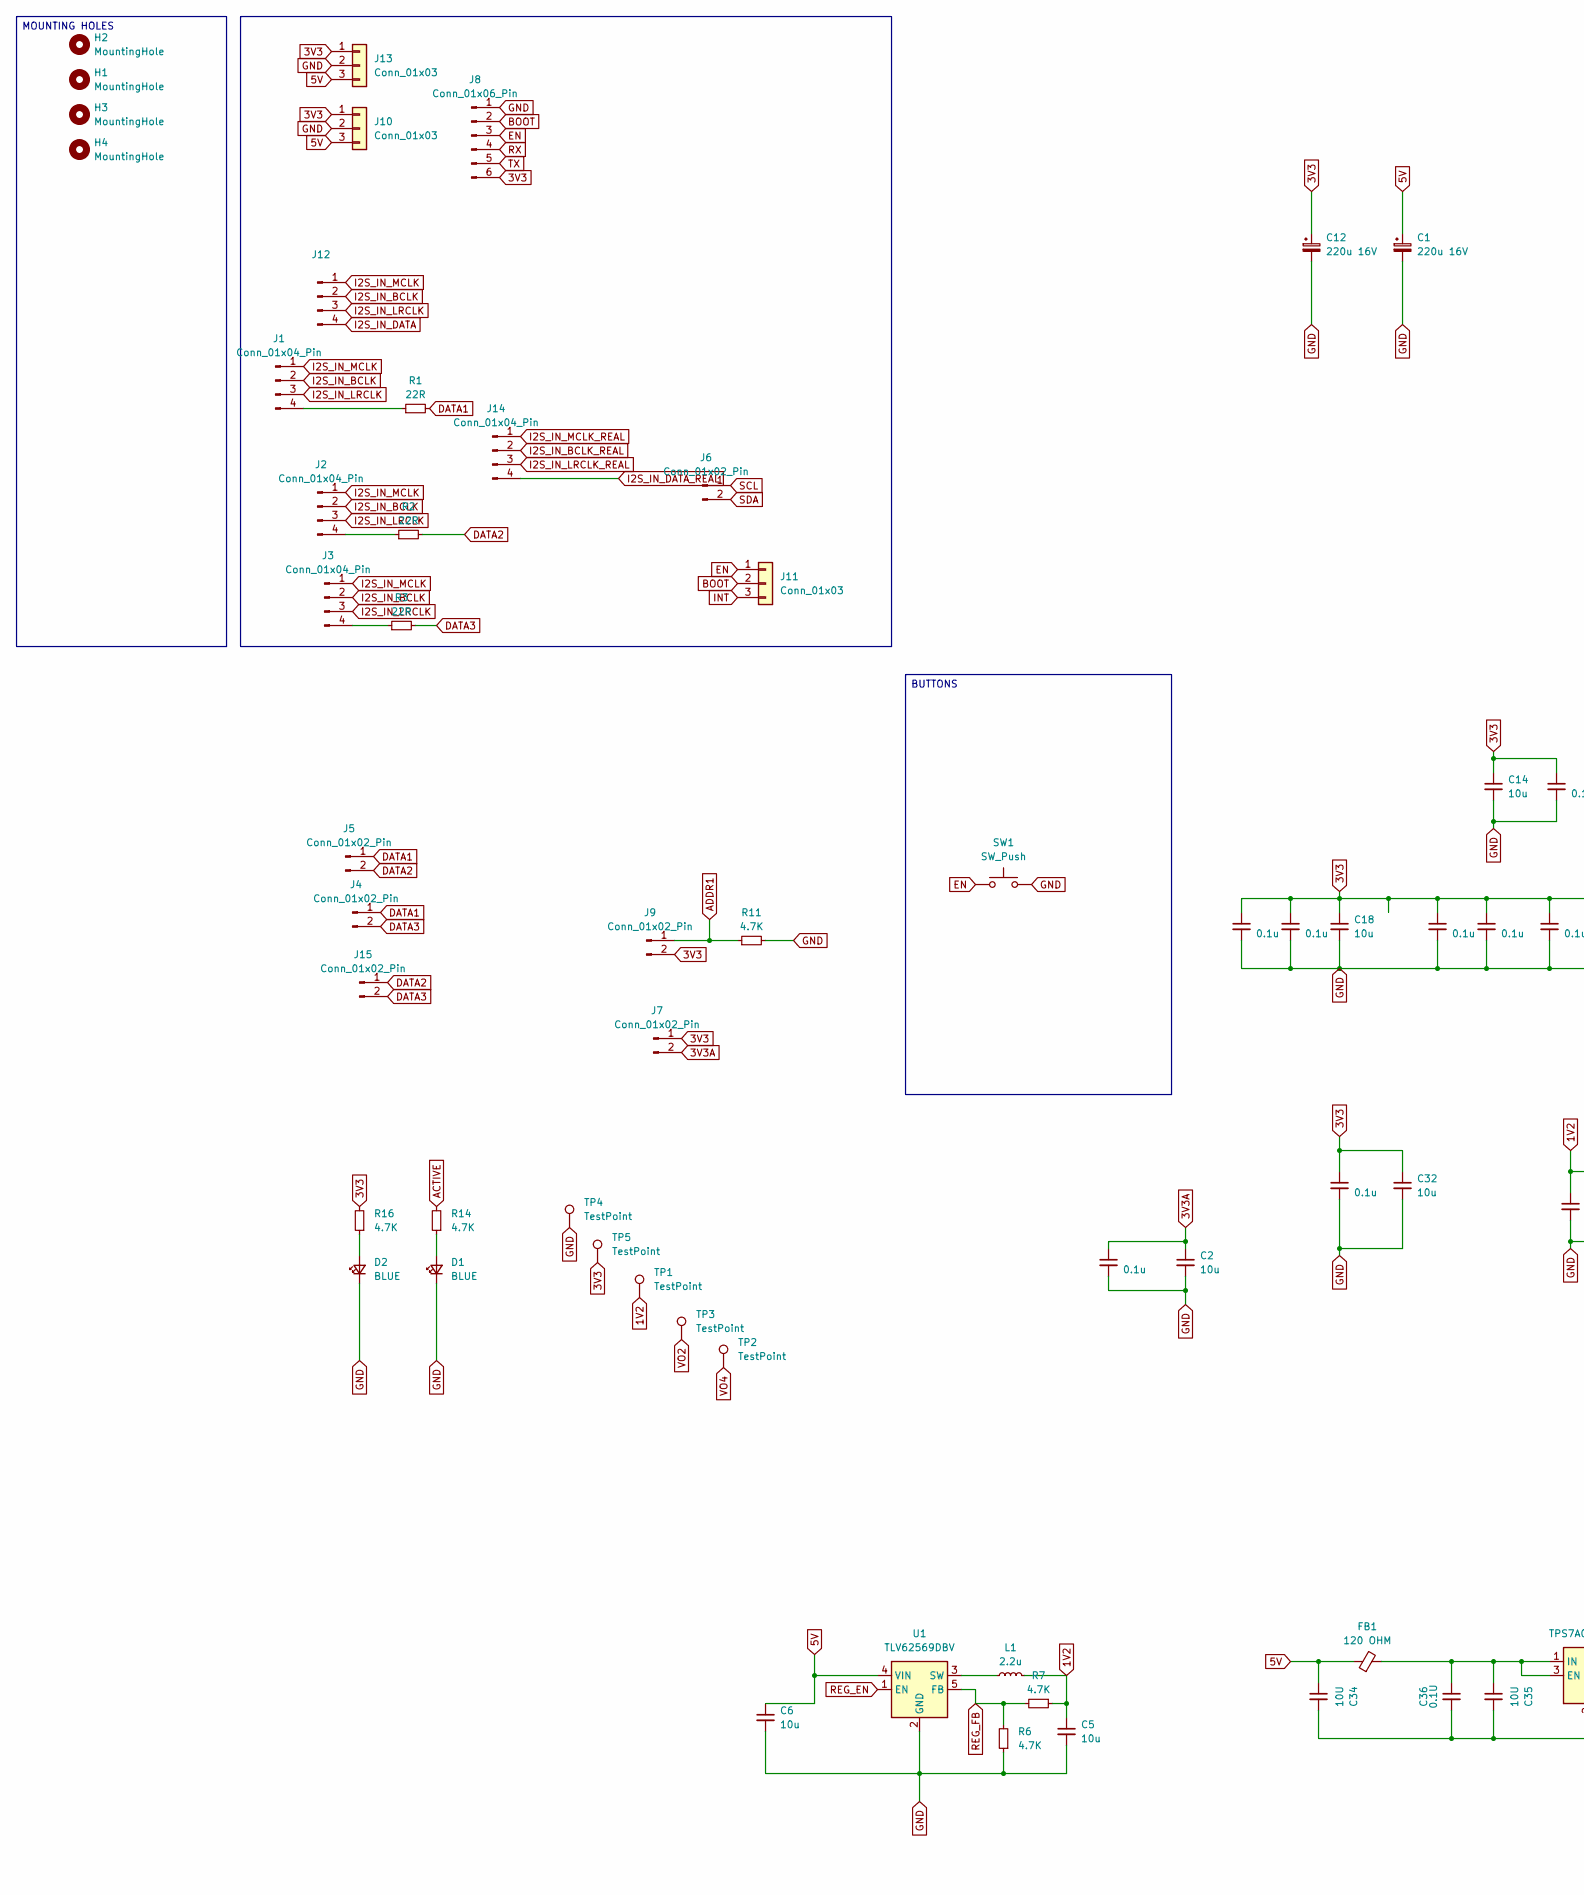
[picture p140: schematic dsp.kicad_sch, part in row 1, column 1]

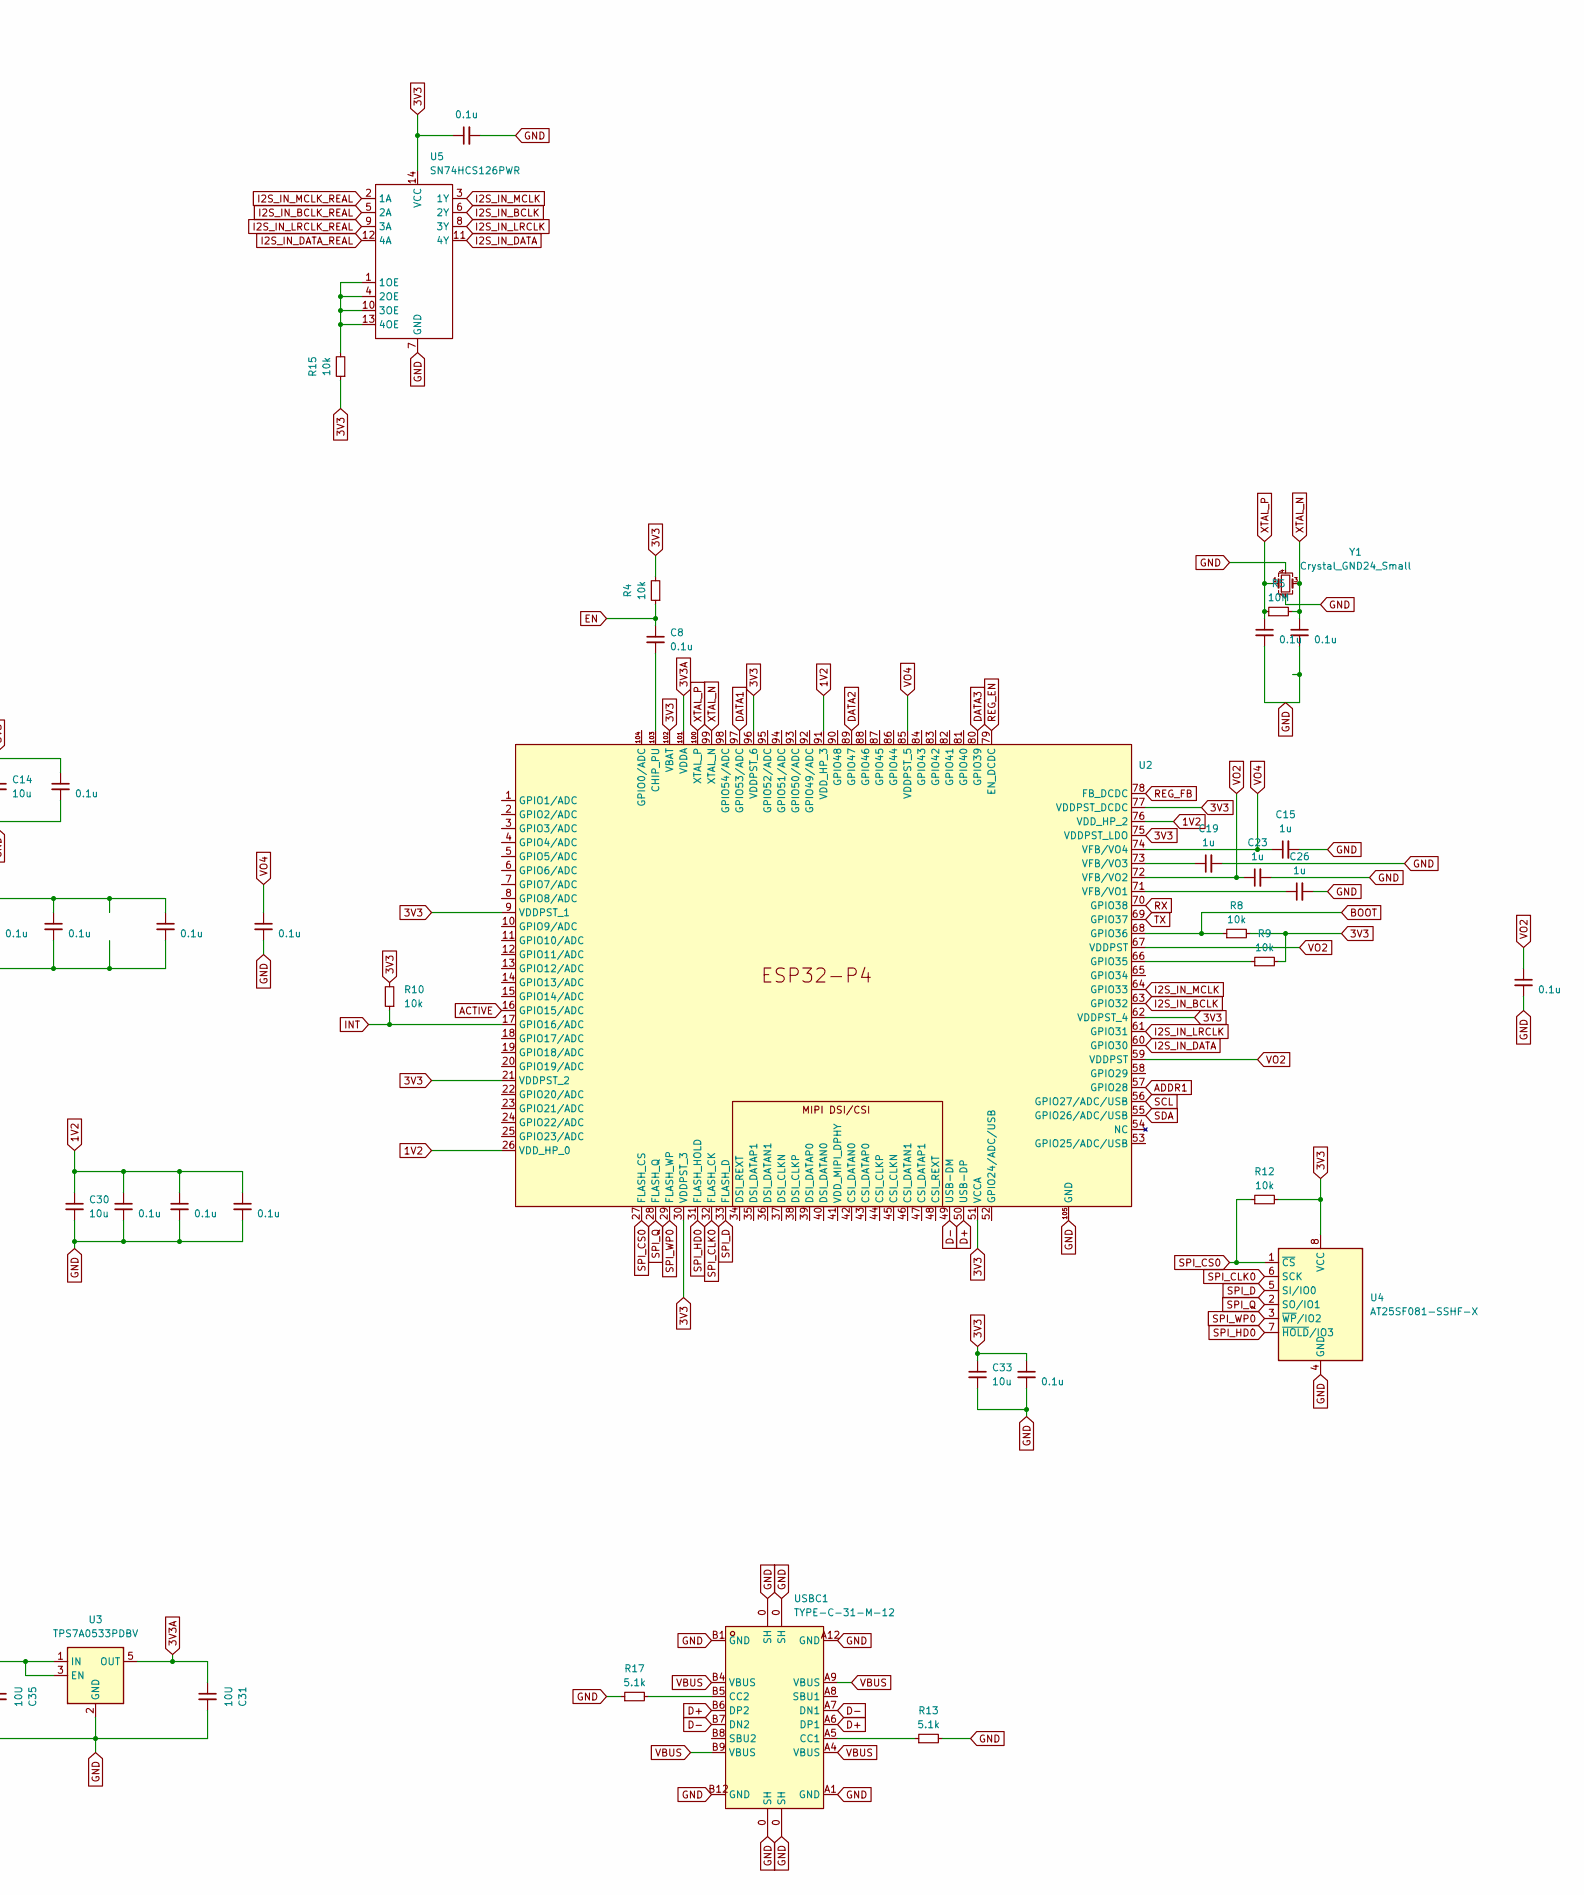
[picture p141: schematic dsp.kicad_sch, part in row 1, column 2]

Parts:
C1, C12: 220u 16V; CP_Elec_6.3x7.7
C2, C5, C6, C14, C18, C30, C32, C33: 10u; C_1206_3216Metric_Pad1.33x1.80mm_HandSolder
C3, C4, C7, C8, C9, C10, C11, C13, C16, C17, C20, C21, C22, C24, C25, C27, C28, C29, C37: 0.1u; C_0805_2012Metric_Pad1.18x1.45mm_HandSolder
C15, C19, C23, C26: 1u; C_1206_3216Metric_Pad1.33x1.80mm_HandSolder
C31, C34, C35: 10U; C_1206_3216Metric_Pad1.33x1.80mm_HandSolder
C36: 0.1U; C_0805_2012Metric_Pad1.18x1.45mm_HandSolder
D1, D2: BLUE; LED_0805_2012Metric_Pad_HandSolder_Duane
FB1: 120 OHM; R_0603_1608Metric_Pad0.98x0.95mm_HandSolder
H1, H2, H3, H4: MountingHole; MountingHole_3.2mm_M3_DIN965_Pad_TopOnly
J1, J2, J3, J14: Conn_01x04_Pin; JST_PH_B4B-PH-K_1x04_P2.00mm_Vertical
J4, J5, J7, J9, J15: Conn_01x02_Pin; PinHeader_1x02_P2.54mm_Vertical
J6: Conn_01x02_Pin; JST_PH_B2B-PH-K_1x02_P2.00mm_Vertical
J8: Conn_01x06_Pin; PinHeader_1x06_P2.54mm_Vertical
J10, J11, J13: Conn_01x03; JST_PH_B3B-PH-K_1x03_P2.00mm_Vertical
J12: Conn_01x04_Pin; PinHeader_1x04_P2.54mm_Vertical
L1: 2.2u; L_0805_2012Metric_Pad1.15x1.40mm_HandSolder
R1, R2, R3: 22R; R_0805_2012Metric_Pad1.20x1.40mm_HandSolder; LCSC C23162
R4, R8, R9, R10, R12, R15: 10k; R_0805_2012Metric_Pad1.20x1.40mm_HandSolder; Mouser 603-RT0805FRE0722RL
R5: 10M; R_0805_2012Metric_Pad1.20x1.40mm_HandSolder; Mouser 603-RT0805FRE0722RL
R6, R7, R11, R14, R16: 4.7K; R_0805_2012Metric_Pad1.20x1.40mm_HandSolder; LCSC C23162
R13, R17: 5.1k; R_0805_2012Metric_Pad1.20x1.40mm_HandSolder; Mouser 603-RT0805FRE0722RL
SW1: SW_Push; Button Aliexpress 4x4
TP1, TP2, TP3, TP4, TP5: TestPoint; TestPoint_THTPad_1.5x1.5mm_Drill0.7mm
U1: TLV62569DBV; SOT-23-5
U2: ESP32-P4
U3: TPS7A0533PDBV; SOT-23-5
U4: AT25SF081-SSHF-X; SOP-8_3.76x4.96mm_P1.27mm
U5: SN74HCS126PWR; TSSOP-14_4.4x5mm_P0.65mm; Mouser SN74HCS126PWR
USBC1: TYPE-C-31-M-12; USB-C_SMD-TYPE-C-31-M-12; LCSC Part C165948
Y1: Crystal_GND24_Small; Crystal_SMD_SeikoEpson_FA238-4Pin_3.2x2.5mm

Connections:
1V2: C5.1, C10.1, C17.1, C27.1, C30.1, L1.2, R7.1, TP1.1, U2.26 (VDD_HP_0), U2.76 (VDD_HP_2), U2.91 (VDD_HP_3)
3V3: C9.1, C12.1, C13.1, C14.1, C16.1, C18.1, C20.1, C21.1, C22.1, C24.1, C28.1, C29.1, C32.1, C33.1, C37.1, J7.1, J8.6, J9.2, J10.1, J13.1, R4.2, R8.2, R9.2, R10.2, R12.2, R15.1, R16.2, TP5.1, U2.9 (VDDPST_1), U2.21 (VDDPST_2), U2.30 (VDDPST_3), U2.51 (VCCA), U2.62 (VDDPST_4), U2.75 (VDDPST_LDO), U2.77 (VDDPST_DCDC), U2.96 (VDDPST_6), U2.102 (VBAT), U4.8 (VCC), U5.14 (VCC)
3V3A: C2.1, C7.1, C31.1, J7.2, U2.101 (VDDA), U3.5 (OUT)
5V: C1.1, C6.1, C34.1, FB1.1, J10.3, J13.3, U1.4 (VIN)
ACTIVE: R14.2, U2.16 (GPIO15/ADC)
ADDR1: J9.1, R11.1, U2.57 (GPIO28)
BOOT: J8.2, J11.2, R8.1, U2.68 (GPIO36)
D+: U2.50 (USB-DP), USBC1.A6 (DP1), USBC1.B6 (DP2)
D-: U2.49 (USB-DM), USBC1.A7 (DN1), USBC1.B7 (DN2)
DATA1: J4.1, J5.1, R1.2, U2.97 (GPIO53/ADC)
DATA2: J5.2, J15.1, R2.2, U2.89 (GPIO47)
DATA3: J4.2, J15.2, R3.2, U2.80 (GPIO39)
EN: C8.1, J8.3, J11.1, R4.1, SW1.1
GND: C1.2, C2.2, C3.2, C4.2, C5.2, C6.2, C7.2, C9.2, C10.2, C11.2, C12.2, C13.2, C14.2, C15.2, C16.2, C17.2, C18.2, C19.2, C20.2, C21.2, C22.2, C23.2, C24.2, C25.2, C26.2, C27.2, C28.2, C29.2, C30.2, C31.2, C32.2, C33.2, C34.2, C35.2, C36.2, C37.2, D1.1 (K), D2.1 (K), J8.1, J10.2, J13.2, R6.1, R11.2, R13.2, R17.1, SW1.2, TP4.1, U1.2 (GND), U2.105 (GND), U3.2 (GND), U4.4 (GND), U5.7 (GND), USBC1.0 (SH), USBC1.A1 (GND), USBC1.A12 (GND), USBC1.B1 (GND), USBC1.B12 (GND), Y1.2, Y1.4
I2S_IN_BCLK: J1.2, J2.2, J3.2, J12.2, U2.63 (GPIO32), U5.6 (2Y)
I2S_IN_BCLK_REAL: J14.2, U5.5 (2A)
I2S_IN_DATA: J12.4, U2.60 (GPIO30), U5.11 (4Y)
I2S_IN_DATA_REAL: J14.4, U5.12 (4A)
I2S_IN_LRCLK: J1.3, J2.3, J3.3, J12.3, U2.61 (GPIO31), U5.8 (3Y)
I2S_IN_LRCLK_REAL: J14.3, U5.9 (3A)
I2S_IN_MCLK: J1.1, J2.1, J3.1, J12.1, U2.64 (GPIO33), U5.3 (1Y)
I2S_IN_MCLK_REAL: J14.1, U5.2 (1A)
INT: J11.3, R10.1, U2.17 (GPIO16/ADC)
unnamed: D1.2 (A), R14.1
unnamed: D2.2 (A), R16.1
unnamed: J1.4, R1.1
unnamed: J2.4, R2.1
unnamed: J3.4, R3.1
unnamed: L1.1, U1.3 (SW)
unnamed: C8.2, U2.103 (CHIP_PU)
unnamed: R9.1, U2.66 (GPIO35)
unnamed: C26.1, U2.71 (VFB/VO1)
unnamed: C19.1, U2.73 (VFB/VO3)
unnamed: C35.1, C36.1, FB1.2, U3.1 (IN), U3.3 (EN)
unnamed: R15.2, U5.1 (1OE), U5.4 (2OE), U5.10 (3OE), U5.13 (4OE)
unnamed: R13.1, USBC1.A5 (CC1)
unnamed: R17.2, USBC1.B5 (CC2)
REG_EN: U1.1 (EN), U2.79 (EN_DCDC)
REG_FB: R6.2, R7.2, U1.5 (FB), U2.78 (FB_DCDC)
RX: J8.4, U2.70 (GPIO38)
SCL: J6.1, U2.56 (GPIO27/ADC/USB)
SDA: J6.2, U2.55 (GPIO26/ADC/USB)
SPI_CLK0: U2.32 (FLASH_CK), U4.6 (SCK)
SPI_CS0: R12.1, U2.27 (FLASH_CS), U4.1 (~CS)
SPI_D: U2.33 (FLASH_D), U4.5 (SI/IO0)
SPI_HD0: U2.31 (FLASH_HOLD), U4.7 (~HOLD/IO3)
SPI_Q: U2.28 (FLASH_Q), U4.2 (SO/IO1)
SPI_WP0: U2.29 (FLASH_WP), U4.3 (~WP/IO2)
TX: J8.5, U2.69 (GPIO37)
VBUS: USBC1.A4 (VBUS), USBC1.A9 (VBUS), USBC1.B4 (VBUS), USBC1.B9 (VBUS)
VO2: C23.1, C25.1, TP3.1, U2.59 (VDDPST), U2.67 (VDDPST), U2.72 (VFB/VO2)
VO4: C11.1, C15.1, TP2.1, U2.74 (VFB/VO4), U2.85 (VDDPST_5)
XTAL_N: C4.1, R5.2, U2.99 (XTAL_N), Y1.3
XTAL_P: C3.1, R5.1, U2.100 (XTAL_P), Y1.1

Notes on the sheet:
MOUNTING HOLES
BUTTONS

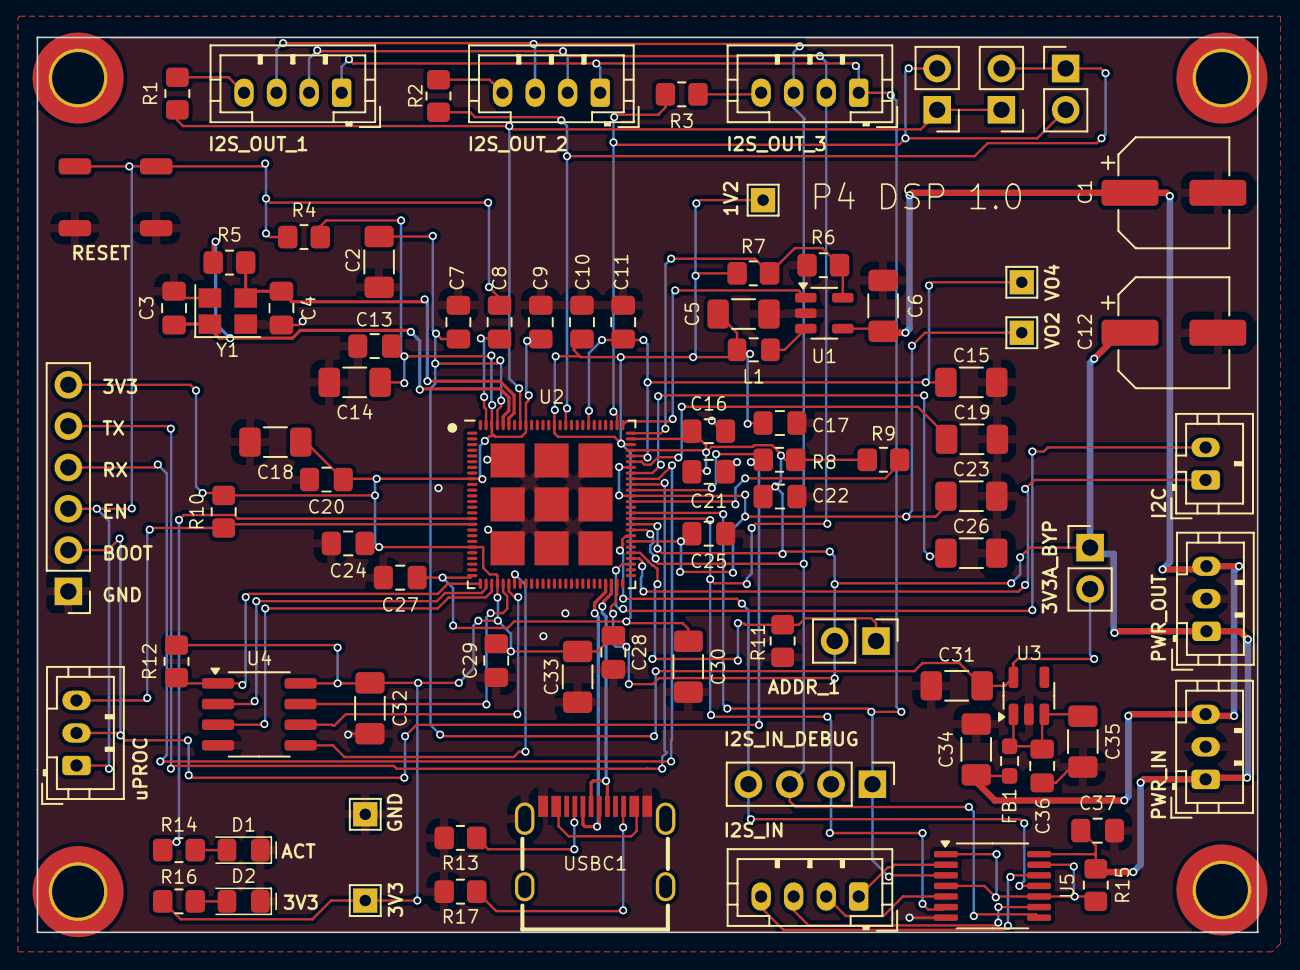
[picture p142: board pcbs/_final_proto/dsp/1.1-raw/dsp.kicad_pcb from above]

Board: 2 copper layers, 75.0 x 55.0 mm, 90 parts (0 on the bottom side), 54 nets.
