duanestorey/hifi-amp/pcbs/_final_proto/i2s/1.0/i2s.kicad_pcb

## KiCad design pcbs/_final_proto/i2s/1.0/i2s.kicad_pcb (2025-11-16)

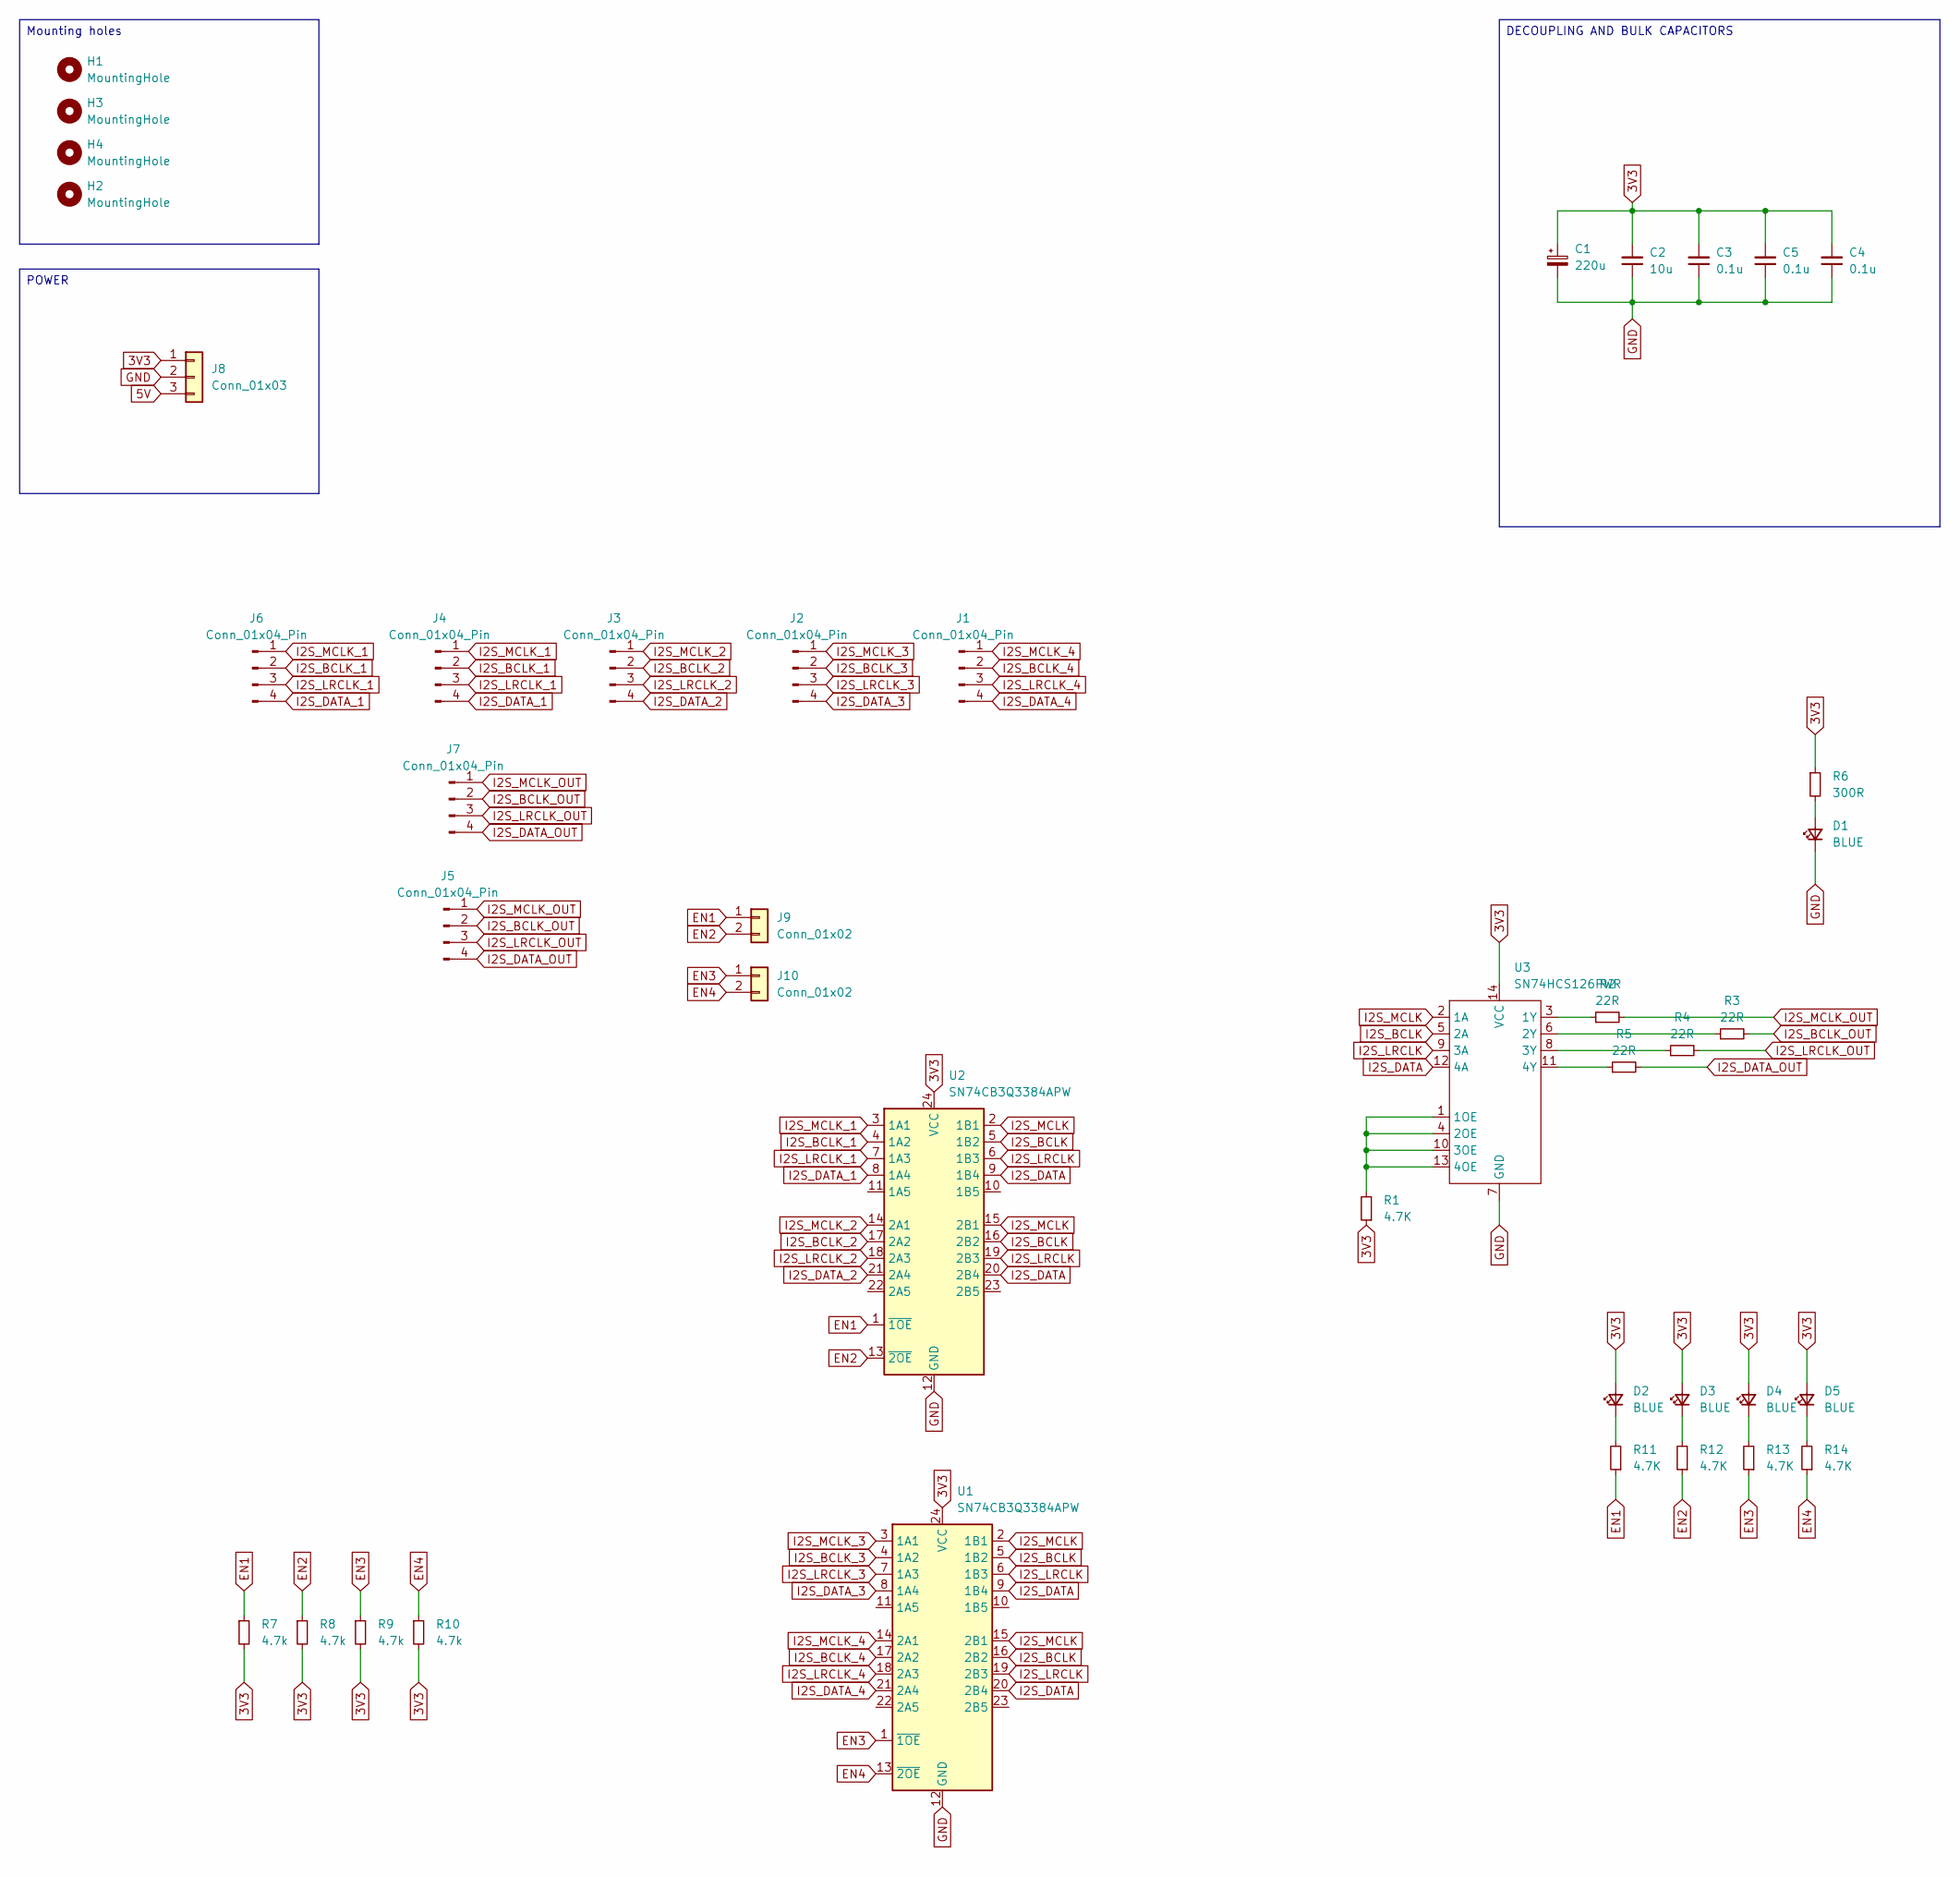
[picture p143: schematic i2s.kicad_sch]

Parts:
C1: 220u; CP_Elec_6.3x7.7
C2: 10u; C_1206_3216Metric_Pad1.33x1.80mm_HandSolder_Duane
C3, C4, C5: 0.1u; C_0805_2012Metric_Pad1.18x1.45mm_HandSolder_Duane
D1, D2, D3, D4, D5: BLUE; LED_0805_2012Metric_Pad_HandSolder_Duane
H1, H2, H3, H4: MountingHole; MountingHole_3.2mm_M3_DIN965_Pad_TopBottom
J1, J2, J3, J4, J6, J7: Conn_01x04_Pin; JST_PH_B4B-PH-K_1x04_P2.00mm_Vertical
J5: Conn_01x04_Pin; PinHeader_1x04_P2.54mm_Vertical
J8: Conn_01x03; JST_PH_B3B-PH-K_1x03_P2.00mm_Vertical
J9, J10: Conn_01x02; JST_PH_B2B-PH-K_1x02_P2.00mm_Vertical
R1, R11, R12, R13, R14: 4.7K; R_0805_2012Metric_Pad1.20x1.40mm_HandSolder_Duane
R2, R3, R4, R5: 22R; R_0805_2012Metric_Pad1.20x1.40mm_HandSolder_Duane
R6: 300R; R_0805_2012Metric_Pad1.20x1.40mm_HandSolder_Duane
R7, R8, R9, R10: 4.7k; R_0805_2012Metric_Pad1.20x1.40mm_HandSolder_Duane
U1, U2: SN74CB3Q3384APW; TSSOP-24_4.4x7.8mm_P0.65mm; Mouser SN74CB3Q3384APWR
U3: SN74HCS126PWR; TSSOP-14_4.4x5mm_P0.65mm; Mouser SN74HCS126PWR

Connections:
3V3: C1.1, C2.2, C3.2, C4.2, C5.2, D2.2 (A), D3.2 (A), D4.2 (A), D5.2 (A), J8.1, R1.1, R6.1, R7.2, R8.2, R9.2, R10.2, U1.24 (VCC), U2.24 (VCC), U3.14 (VCC)
5V: J8.3
EN1: J9.1, R7.1, R11.1, U2.1 (~1OE)
EN2: J9.2, R8.1, R12.1, U2.13 (~2OE)
EN3: J10.1, R9.1, R13.1, U1.1 (~1OE)
EN4: J10.2, R10.1, R14.1, U1.13 (~2OE)
GND: C1.2, C2.1, C3.1, C4.1, C5.1, D1.1 (K), J8.2, U1.12 (GND), U2.12 (GND), U3.7 (GND)
I2S_BCLK: U1.5 (1B2), U1.16 (2B2), U2.5 (1B2), U2.16 (2B2), U3.5 (2A)
I2S_BCLK_1: J4.2, J6.2, U2.4 (1A2)
I2S_BCLK_2: J3.2, U2.17 (2A2)
I2S_BCLK_3: J2.2, U1.4 (1A2)
I2S_BCLK_4: J1.2, U1.17 (2A2)
I2S_BCLK_OUT: J5.2, J7.2, R3.2
I2S_DATA: U1.9 (1B4), U1.20 (2B4), U2.9 (1B4), U2.20 (2B4), U3.12 (4A)
I2S_DATA_1: J4.4, J6.4, U2.8 (1A4)
I2S_DATA_2: J3.4, U2.21 (2A4)
I2S_DATA_3: J2.4, U1.8 (1A4)
I2S_DATA_4: J1.4, U1.21 (2A4)
I2S_DATA_OUT: J5.4, J7.4, R5.2
I2S_LRCLK: U1.6 (1B3), U1.19 (2B3), U2.6 (1B3), U2.19 (2B3), U3.9 (3A)
I2S_LRCLK_1: J4.3, J6.3, U2.7 (1A3)
I2S_LRCLK_2: J3.3, U2.18 (2A3)
I2S_LRCLK_3: J2.3, U1.7 (1A3)
I2S_LRCLK_4: J1.3, U1.18 (2A3)
I2S_LRCLK_OUT: J5.3, J7.3, R4.2
I2S_MCLK: U1.2 (1B1), U1.15 (2B1), U2.2 (1B1), U2.15 (2B1), U3.2 (1A)
I2S_MCLK_1: J4.1, J6.1, U2.3 (1A1)
I2S_MCLK_2: J3.1, U2.14 (2A1)
I2S_MCLK_3: J2.1, U1.3 (1A1)
I2S_MCLK_4: J1.1, U1.14 (2A1)
I2S_MCLK_OUT: J5.1, J7.1, R2.2
unnamed: D1.2 (A), R6.2
unnamed: D2.1 (K), R11.2
unnamed: D3.1 (K), R12.2
unnamed: D4.1 (K), R13.2
unnamed: D5.1 (K), R14.2
unnamed: R1.2, U3.1 (1OE), U3.4 (2OE), U3.10 (3OE), U3.13 (4OE)
unnamed: R2.1, U3.3 (1Y)
unnamed: R3.1, U3.6 (2Y)
unnamed: R4.1, U3.8 (3Y)
unnamed: R5.1, U3.11 (4Y)

Notes on the sheet:
DECOUPLING AND BULK CAPACITORS
Mounting holes
POWER

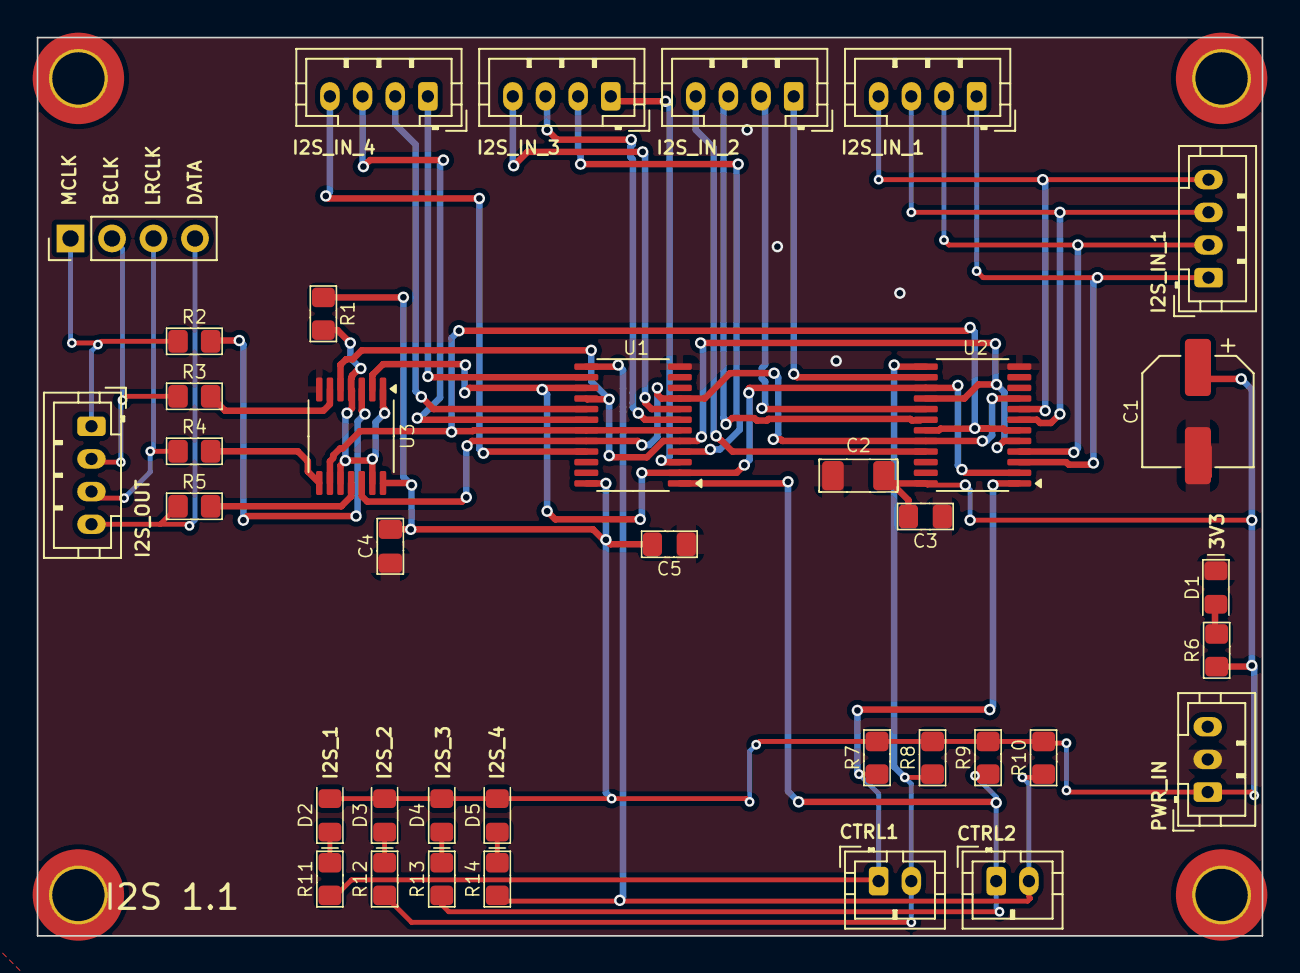
[picture p144: board i2s.kicad_pcb from above]

Board: 2 copper layers, 75.0 x 55.0 mm, 41 parts (0 on the bottom side), 40 nets.
