duanestorey/hifi-amp/pcbs/_final_proto/sub-uproc/sub-uproc.kicad_pcb

## KiCad design pcbs/_final_proto/sub-uproc/sub-uproc.kicad_pcb (2025-11-16)

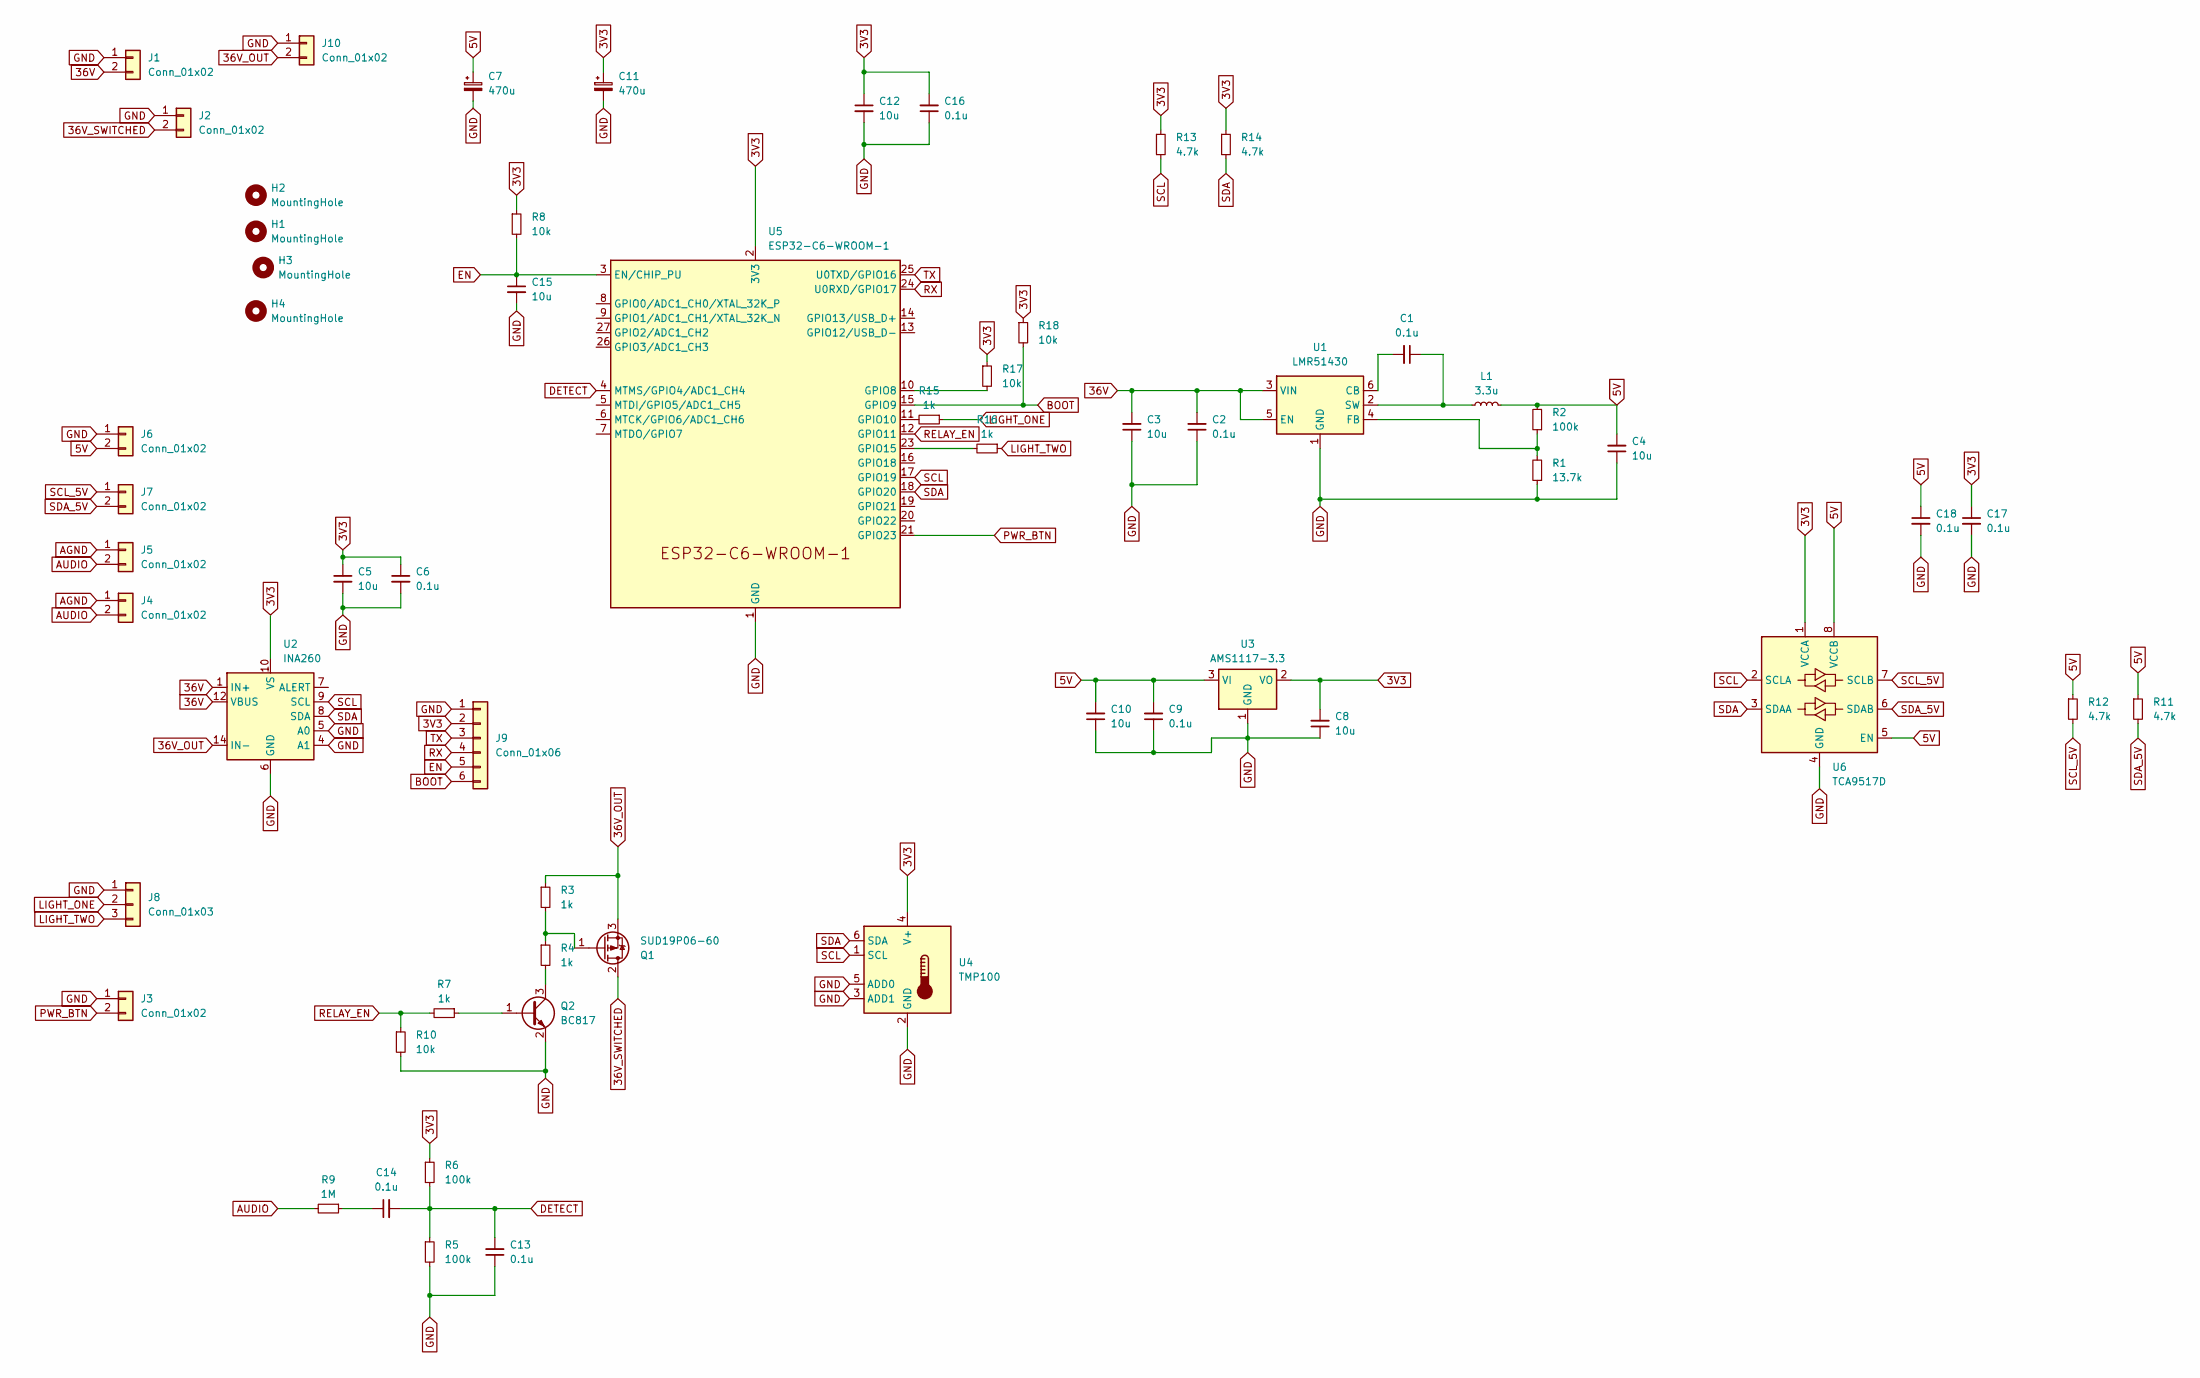
[picture p145: schematic sub-uproc.kicad_sch]

Parts:
C1, C2, C6, C9, C13, C14, C16, C17, C18: 0.1u; C_0805_2012Metric_Pad1.18x1.45mm_HandSolder_Duane
C3, C4, C5, C8, C10, C12, C15: 10u; C_1206_3216Metric_Pad1.33x1.80mm_HandSolder_Duane
C7, C11: 470u; CP_Elec_6.3x7.7
H1, H2, H3, H4: MountingHole; MountingHole_3.2mm_M3_DIN965_Pad_TopBottom
J1, J2, J4, J5, J6, J7, J10: Conn_01x02; TerminalBlock_Phoenix_PT-1,5-2-5.0-H_1x02_P5.00mm_Horizontal
J3: Conn_01x02; JST_PH_B2B-PH-K_1x02_P2.00mm_Vertical
J8: Conn_01x03; JST_PH_B3B-PH-K_1x03_P2.00mm_Vertical
J9: Conn_01x06; PinHeader_1x06_P2.54mm_Vertical
L1: 3.3u; L_Wuerth_HCI-7030
Q1: SUD19P06-60; TO-252-2
Q2: BC817; SOT-23
R1: 13.7k; R_0805_2012Metric_Pad1.20x1.40mm_HandSolder_Duane
R2, R5, R6: 100k; R_0805_2012Metric_Pad1.20x1.40mm_HandSolder_Duane
R3, R4, R7, R15, R16: 1k; R_0805_2012Metric_Pad1.20x1.40mm_HandSolder_Duane
R8, R10, R17, R18: 10k; R_0805_2012Metric_Pad1.20x1.40mm_HandSolder_Duane
R9: 1M; R_0805_2012Metric_Pad1.20x1.40mm_HandSolder_Duane
R11, R12, R13, R14: 4.7k; R_0805_2012Metric_Pad1.20x1.40mm_HandSolder_Duane
U1: LMR51430; SOT-23-6
U2: INA260; TSSOP-16_4.4x5mm_P0.65mm
U3: AMS1117-3.3; SOT-223-3_TabPin2
U4: TMP100; SOT-23-6
U5: ESP32-C6-WROOM-1
U6: TCA9517D; SOIC-8_3.9x4.9mm_P1.27mm

Connections:
3V3: C5.1, C6.1, C8.2, C11.1, C12.1, C16.2, C17.1, J9.2, R6.1, R8.1, R13.1, R14.1, R17.1, R18.1, U2.10 (VS), U3.2 (VO), U4.4 (V+), U5.2 (3V3), U6.1 (VCCA)
5V: C4.2, C7.1, C9.2, C10.2, C18.1, J6.2, L1.2, R2.2, R11.1, R12.1, U3.3 (VI), U6.5 (EN), U6.8 (VCCB)
36V: C2.2, C3.2, J1.2, U1.3 (VIN), U1.5 (EN), U2.1 (IN+), U2.2 (IN+), U2.3 (IN+), U2.12 (VBUS)
36V_OUT: J10.2, Q1.3 (S), R3.1, U2.14 (IN-), U2.15 (IN-), U2.16 (IN-)
36V_SWITCHED: J2.2, Q1.2 (D)
AGND: J4.1, J5.1
AUDIO: J4.2, J5.2, R9.2
BOOT: J9.6, R18.2, U5.15 (GPIO9)
DETECT: C13.2, C14.2, R5.1, R6.2, U5.4 (MTMS/GPIO4/ADC1_CH4)
EN: C15.1, J9.5, R8.2, U5.3 (EN/CHIP_PU)
GND: C2.1, C3.1, C4.1, C5.2, C6.2, C7.2, C8.1, C9.1, C10.1, C11.2, C12.2, C13.1, C15.2, C16.1, C17.2, C18.2, J1.1, J2.1, J3.1, J6.1, J8.1, J9.1, J10.1, Q2.2 (E), R1.1, R5.2, R10.2, U1.1 (GND), U2.4 (A1), U2.5 (A0), U2.6 (GND), U2.11 (GND), U3.1 (GND), U4.2 (GND), U4.3 (ADD1), U4.5 (ADD0), U5.1 (GND), U5.28 (GND), U5.29 (GND), U6.4 (GND)
LIGHT_ONE: J8.2, R15.1
LIGHT_TWO: J8.3, R16.1
unnamed: C14.1, R9.1
unnamed: Q1.1 (G), R3.2, R4.1
unnamed: Q2.1 (B), R7.1
unnamed: Q2.3 (C), R4.2
unnamed: C1.2, U1.6 (CB)
unnamed: R1.2, R2.1, U1.4 (FB)
unnamed: C1.1, L1.1, U1.2 (SW)
unnamed: R17.2, U5.10 (GPIO8)
unnamed: R15.2, U5.11 (GPIO10)
unnamed: R16.2, U5.23 (GPIO15)
PWR_BTN: J3.2, U5.21 (GPIO23)
RELAY_EN: R7.2, R10.1, U5.12 (GPIO11)
RX: J9.4, U5.24 (U0RXD/GPIO17)
SCL: R13.2, U2.9 (SCL), U4.1 (SCL), U5.17 (GPIO19), U6.2 (SCLA)
SCL_5V: J7.1, R12.2, U6.7 (SCLB)
SDA: R14.2, U2.8 (SDA), U4.6 (SDA), U5.18 (GPIO20), U6.3 (SDAA)
SDA_5V: J7.2, R11.2, U6.6 (SDAB)
TX: J9.3, U5.25 (U0TXD/GPIO16)

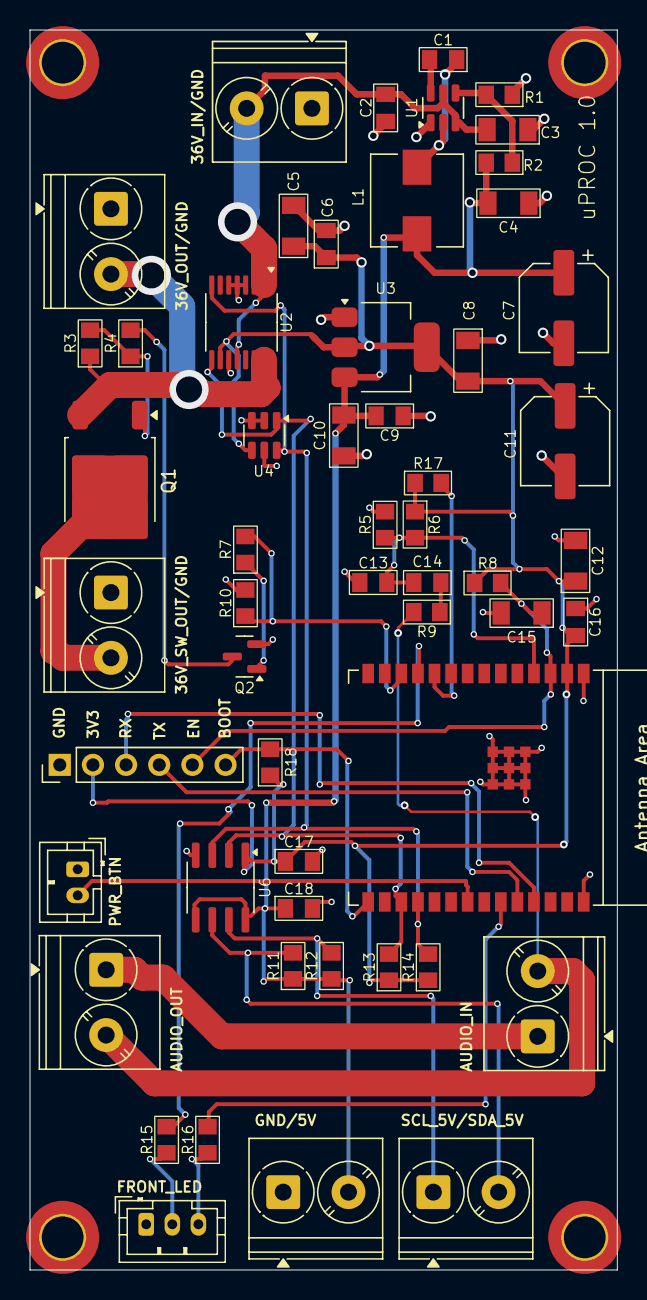
[picture p146: board sub-uproc.kicad_pcb from above]

Board: 2 copper layers, 45.0 x 95.0 mm, 59 parts (0 on the bottom side), 31 nets.
