duanestorey/hifi-amp/pcbs/_final_proto/psu-capbanks/1.1-more/capbanks.kicad_pcb

## KiCad design pcbs/_final_proto/psu-capbanks/1.1-more/capbanks.kicad_pcb (2025-11-16)

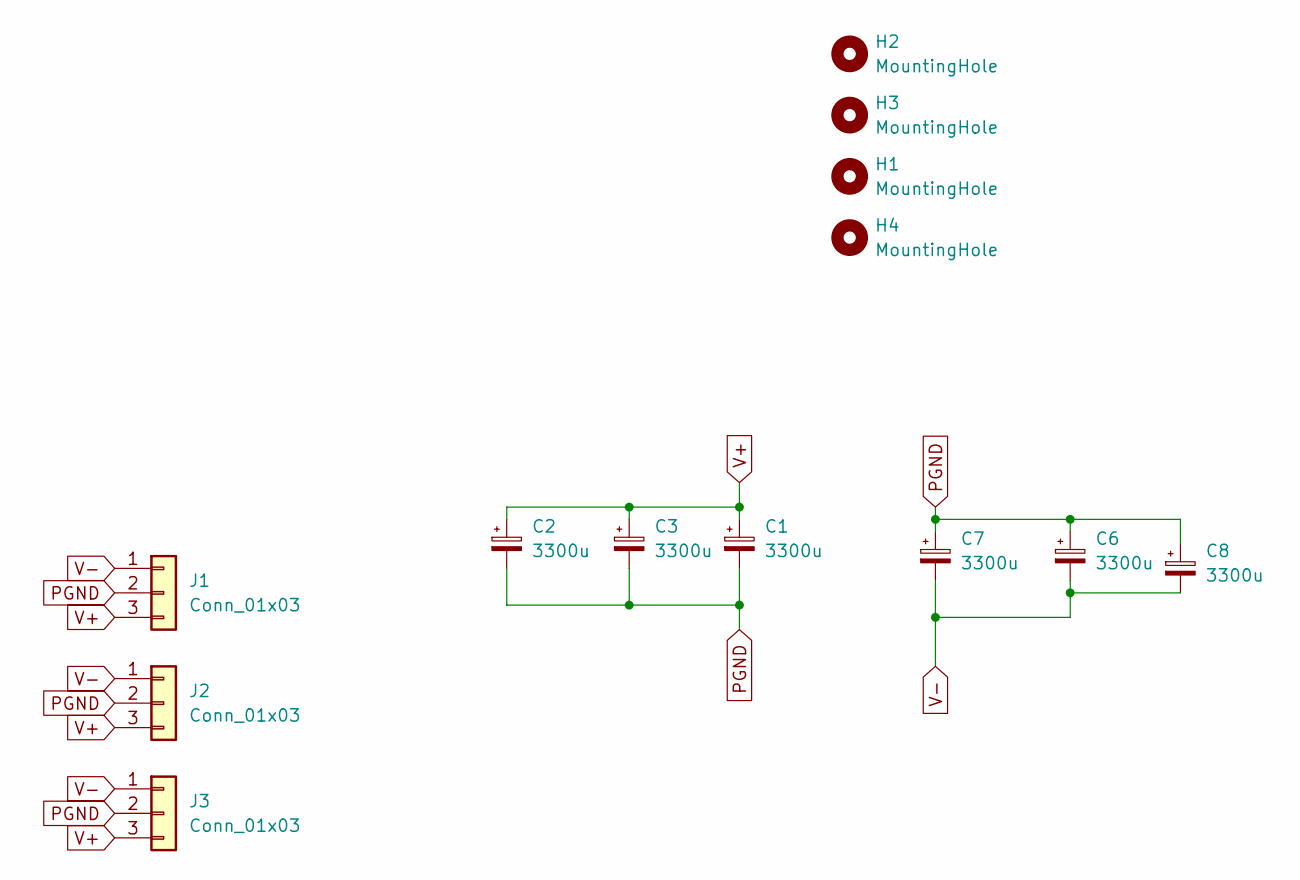
[picture p147: schematic capbanks.kicad_sch]

Parts:
C1, C2, C3, C6, C7, C8: 3300u; CP_Radial_D16.0mm_P7.50mm
H1, H2, H3, H4: MountingHole; MountingHole_3.2mm_M3_DIN965_Pad_TopBottom
J1, J2, J3: Conn_01x03; JST_VH_B3P-VH-B_1x03_P3.96mm_Vertical_Duane

Connections:
PGND: C1.2, C2.2, C3.2, C6.1, C7.1, C8.1, J1.2, J2.2, J3.2
V+: C1.1, C2.1, C3.1, J1.3, J2.3, J3.3
V-: C6.2, C7.2, C8.2, J1.1, J2.1, J3.1

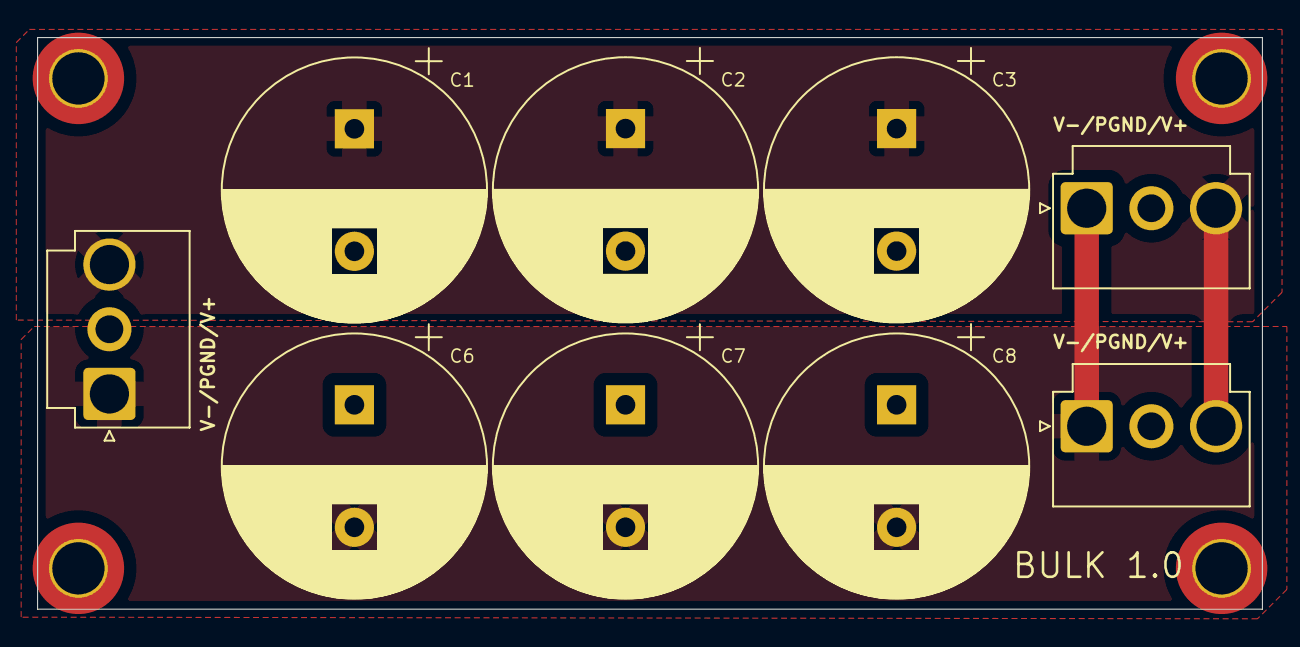
[picture p148: board pcbs/_final_proto/psu-capbanks/1.1-more/capbanks.kicad_pcb from above]

Board: 2 copper layers, 75.0 x 35.0 mm, 13 parts (0 on the bottom side), 3 nets.
