duanestorey/hifi-amp/pcbs/_final_proto/psu-split/1.0/split.kicad_pcb

## KiCad design pcbs/_final_proto/psu-split/1.0/split.kicad_pcb (2025-11-16)

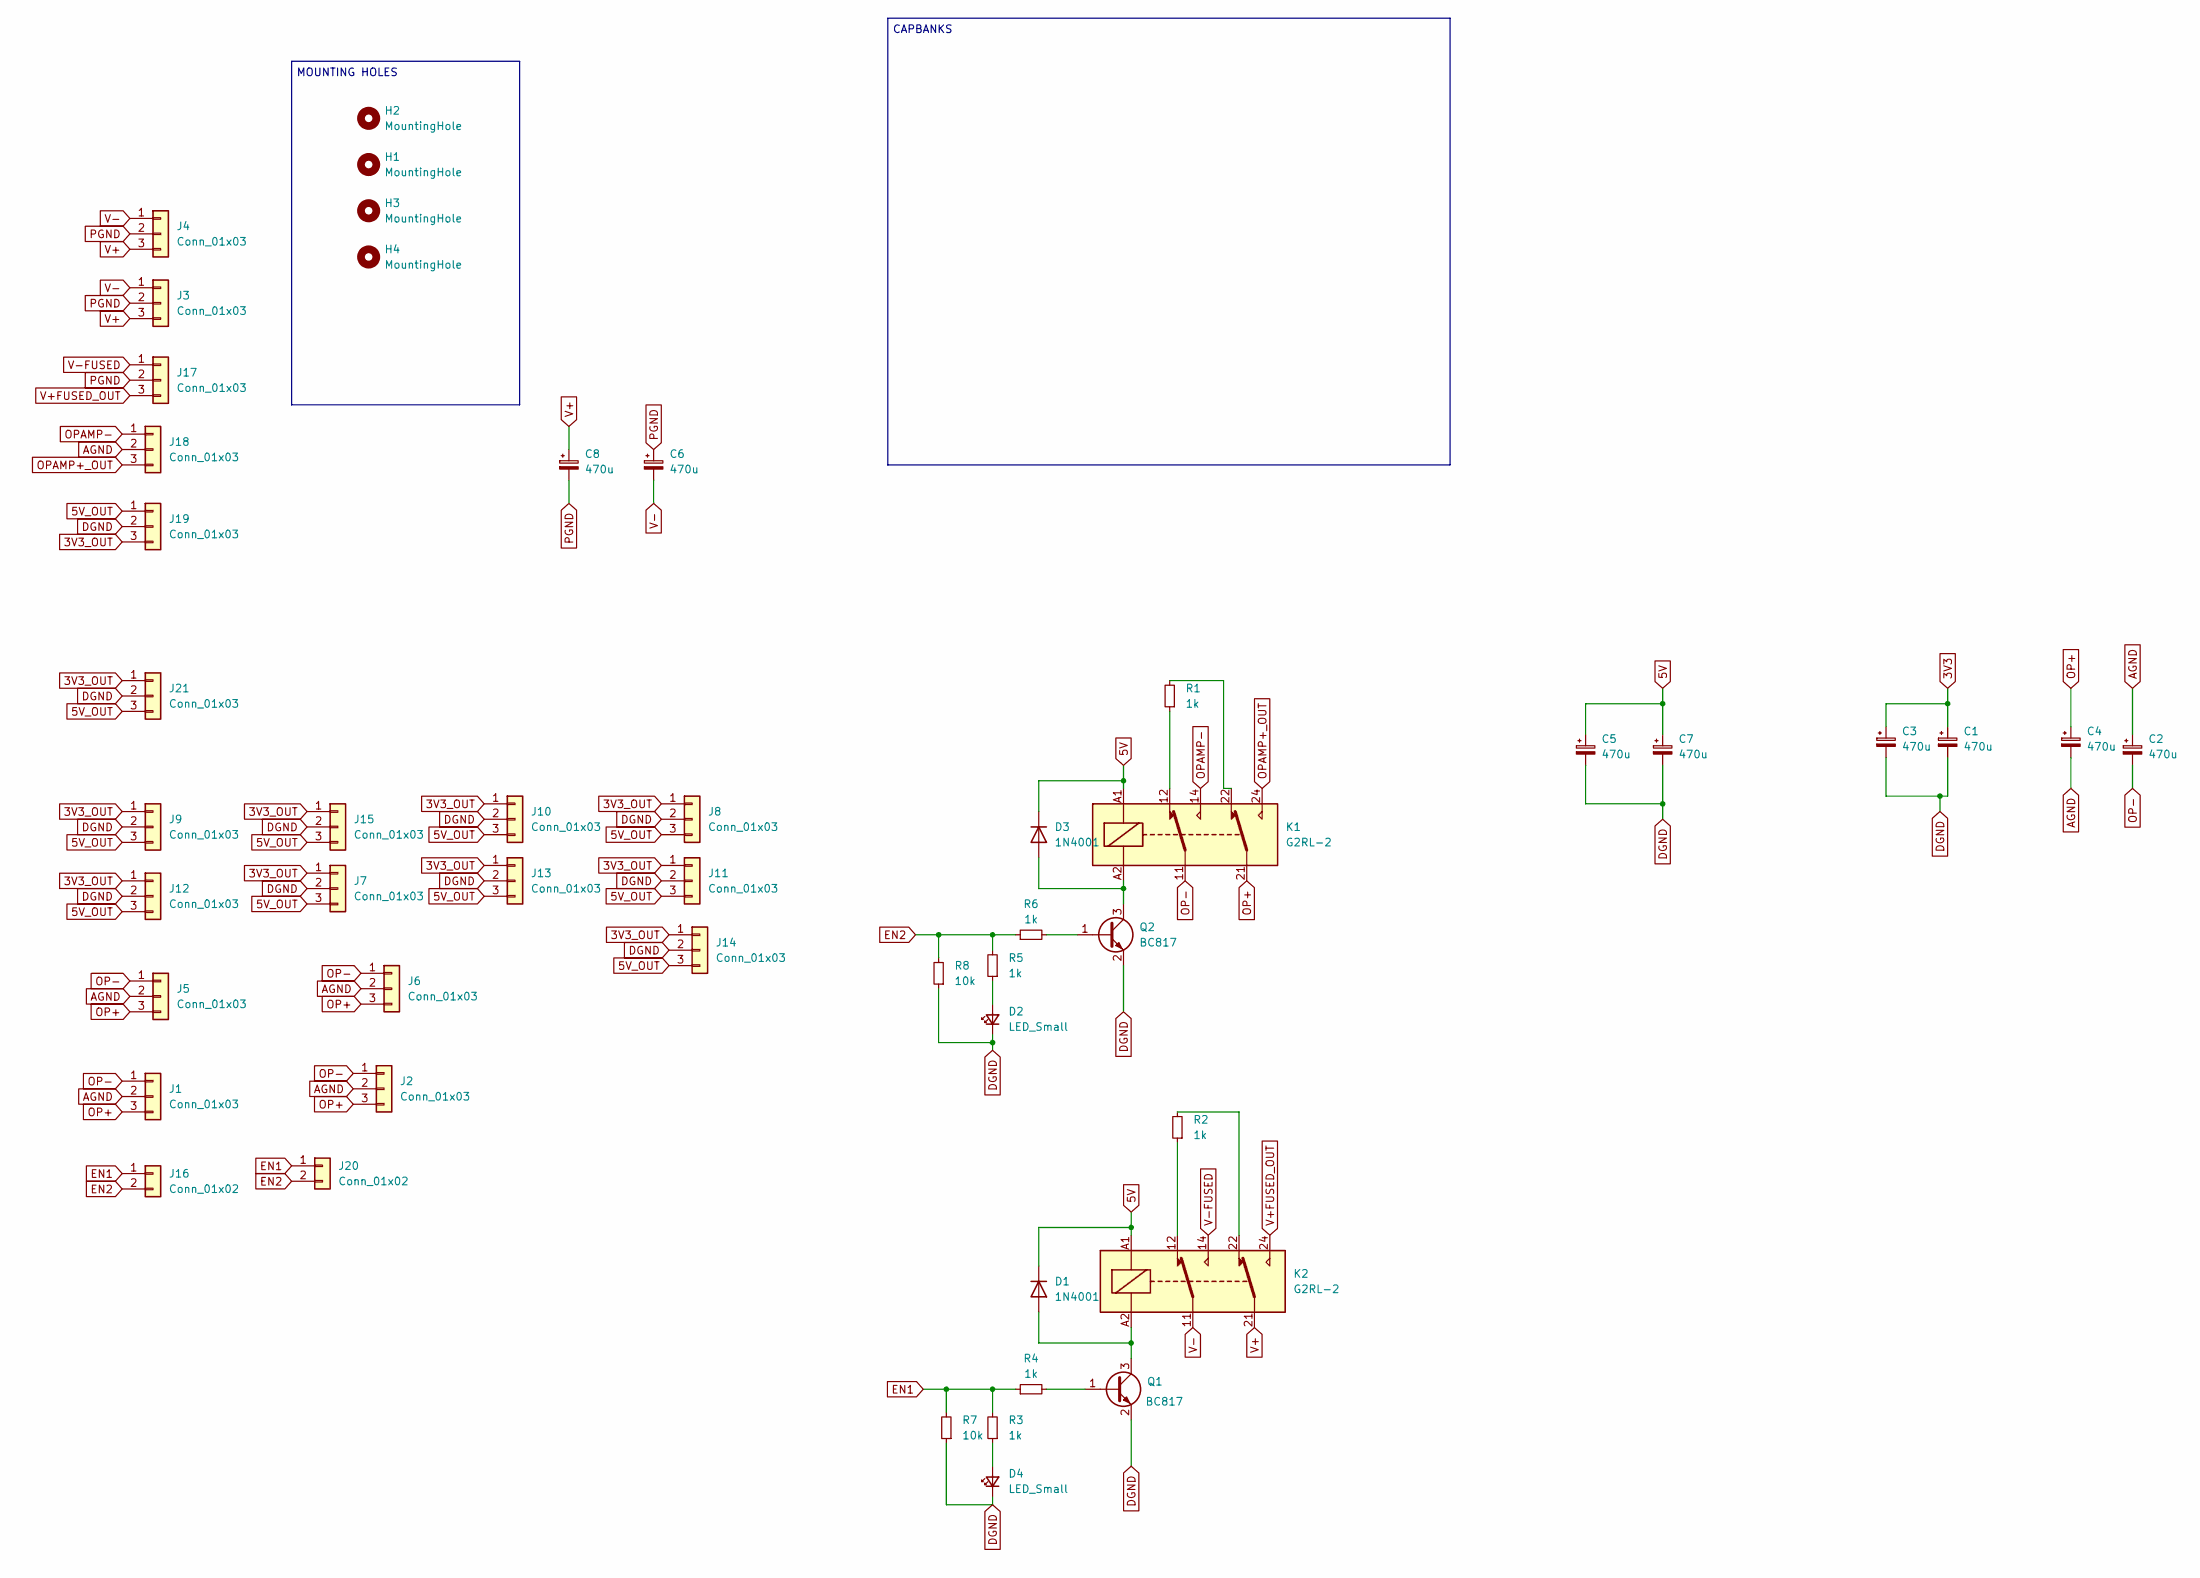
[picture p149: schematic split.kicad_sch]

Parts:
C1, C2, C3, C4, C5, C6, C7, C8: 470u; CP_Elec_6.3x7.7
D1, D3: 1N4001; D_SMA
D2, D4: LED_Small; LED_0805_2012Metric_Pad_HandSolder_Duane
H1, H2, H3, H4: MountingHole; MountingHole_3.2mm_M3_DIN965_Pad_TopBottom
J1, J2, J5, J6, J7, J8, J9, J10, J11, J12, J13, J14, J15, J21: Conn_01x03; JST_PH_B3B-PH-K_1x03_P2.00mm_Vertical
J3, J4, J17, J18, J19: Conn_01x03; TerminalBlock_Phoenix_PT-1,5-3-3.5-H_1x03_P3.50mm_Horizontal
J16: Conn_01x02; PinHeader_1x02_P2.54mm_Vertical
J20: Conn_01x02; JST_PH_B2B-PH-K_1x02_P2.00mm_Vertical
K1, K2: G2RL-2; Relay_DPDT_Omron_G2RL-2
Q1, Q2: BC817; SOT-23
R1, R2, R3, R4, R5, R6: 1k; R_0805_2012Metric_Pad1.20x1.40mm_HandSolder_Duane
R7, R8: 10k; R_0805_2012Metric_Pad1.20x1.40mm_HandSolder_Duane

Connections:
3V3: C1.1, C3.1
3V3_OUT: J7.1, J8.1, J9.1, J10.1, J11.1, J12.1, J13.1, J14.1, J15.1, J19.3, J21.1
5V: C5.1, C7.1, D1.1 (K), D3.1 (K), K1.A1, K2.A1
5V_OUT: J7.3, J8.3, J9.3, J10.3, J11.3, J12.3, J13.3, J14.3, J15.3, J19.1, J21.3
AGND: C2.1, C4.2, J1.2, J2.2, J5.2, J6.2, J18.2
DGND: C1.2, C3.2, C5.2, C7.2, D2.1 (K), D4.1 (K), J7.2, J8.2, J9.2, J10.2, J11.2, J12.2, J13.2, J14.2, J15.2, J19.2, J21.2, Q1.2 (E), Q2.2 (E), R7.1, R8.1
EN1: J16.1, J20.1, R3.2, R4.1, R7.2
EN2: J16.2, J20.2, R5.2, R6.1, R8.2
unnamed: D1.2 (A), K2.A2, Q1.3 (C)
unnamed: D2.2 (A), R5.1
unnamed: D3.2 (A), K1.A2, Q2.3 (C)
unnamed: D4.2 (A), R3.1
unnamed: K1.12, R1.1
unnamed: K1.22, R1.2
unnamed: K2.12, R2.1
unnamed: K2.22, R2.2
unnamed: Q1.1 (B), R4.2
unnamed: Q2.1 (B), R6.2
OP+: C4.1, J1.3, J2.3, J5.3, J6.3, K1.21
OP-: C2.2, J1.1, J2.1, J5.1, J6.1, K1.11
OPAMP+_OUT: J18.3, K1.24
OPAMP-: J18.1, K1.14
PGND: C6.1, C8.2, J3.2, J4.2, J17.2
V+: C8.1, J3.3, J4.3, K2.21
V+FUSED_OUT: J17.3, K2.24
V-: C6.2, J3.1, J4.1, K2.11
V-FUSED: J17.1, K2.14

Notes on the sheet:
MOUNTING HOLES
CAPBANKS

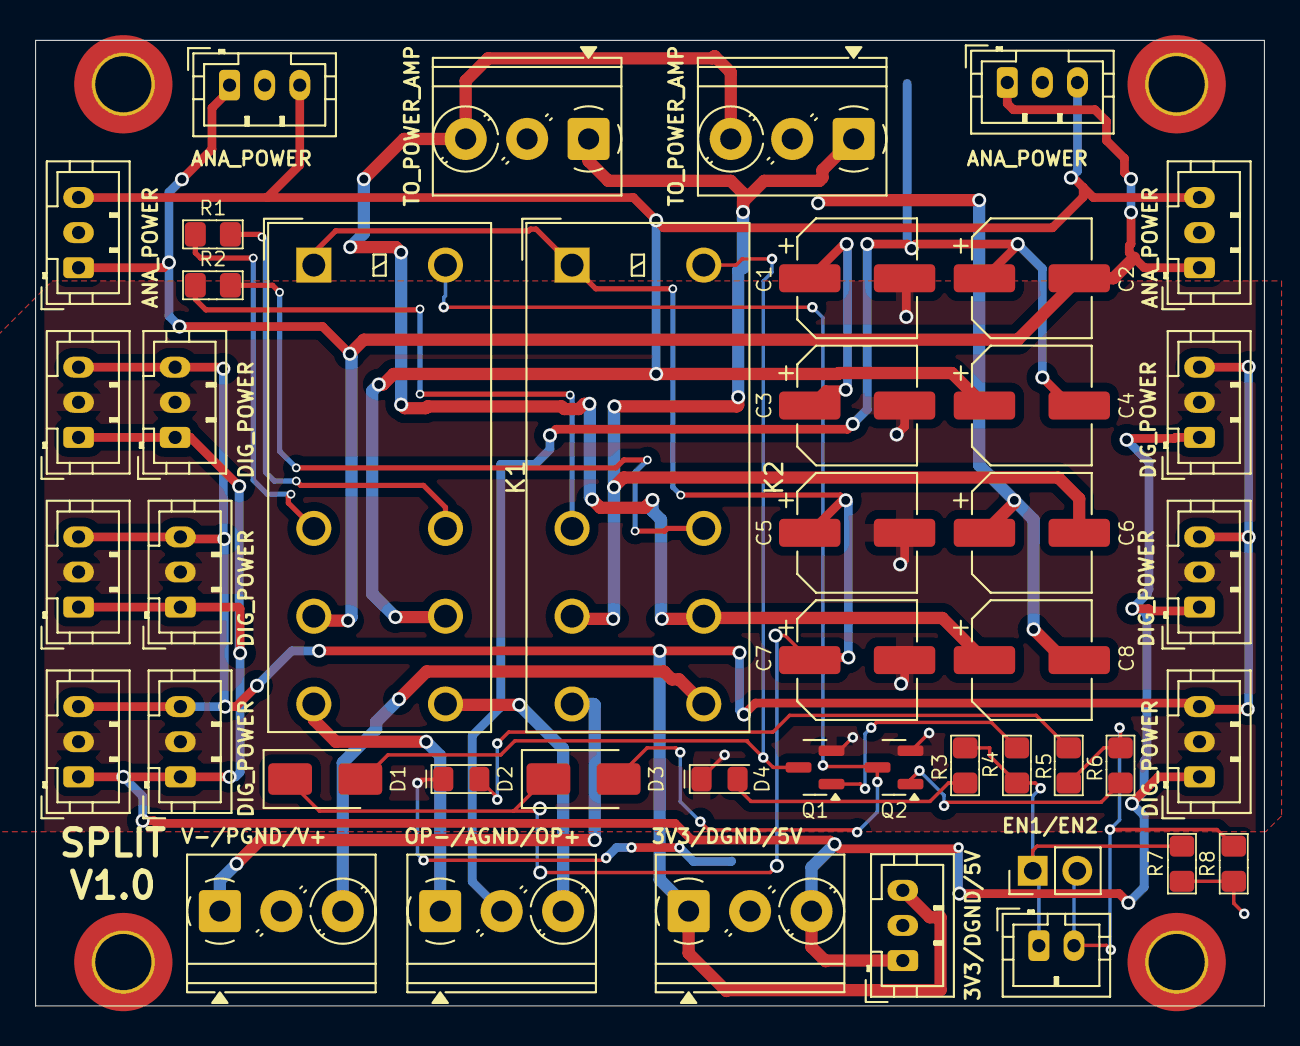
[picture p150: board pcbs/_final_proto/psu-split/1.0/split.kicad_pcb from above]

Board: 2 copper layers, 70.0 x 55.0 mm, 49 parts (0 on the bottom side), 27 nets.
