duanestorey/hifi-amp/pcbs/_final_proto/psu-capbanks/1.2-relay/capbanks.kicad_pcb

## KiCad design pcbs/_final_proto/psu-capbanks/1.2-relay/capbanks.kicad_pcb (2025-11-16)

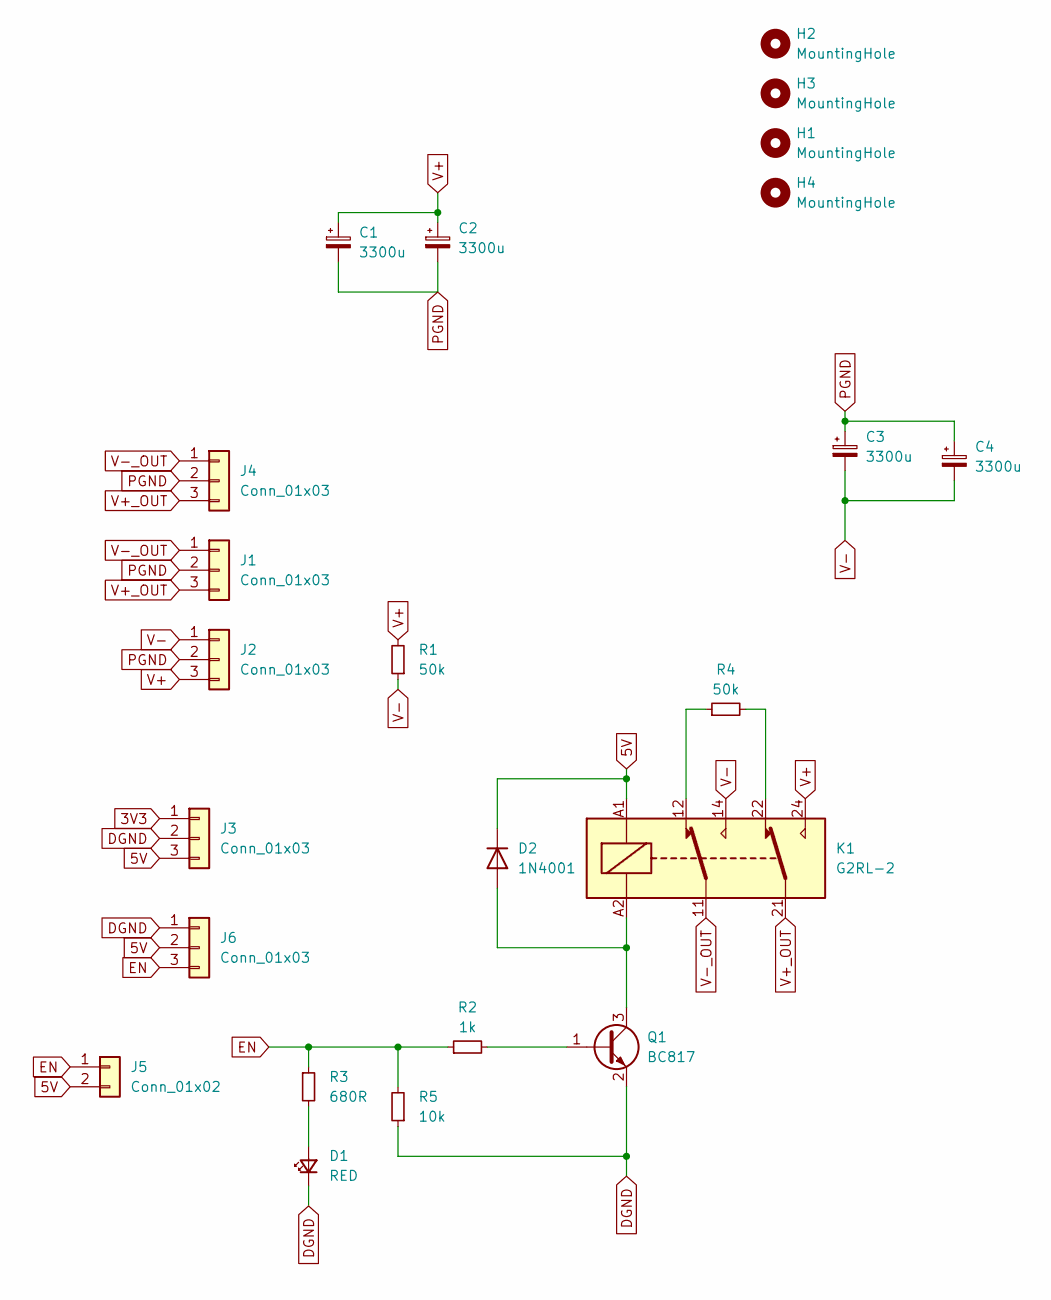
[picture p151: schematic capbanks.kicad_sch]

Parts:
C1, C2, C3, C4: 3300u; CP_Radial_D16.0mm_P7.50mm
D1: RED; LED_0805_2012Metric_Pad_HandSolder_Duane
D2: 1N4001; D_SMA
H1, H2, H3, H4: MountingHole; MountingHole_3.2mm_M3_DIN965_Pad_TopBottom
J1, J2, J4: Conn_01x03; JST_VH_B3P-VH-B_1x03_P3.96mm_Vertical_Duane
J3, J6: Conn_01x03; JST_PH_B3B-PH-K_1x03_P2.00mm_Vertical
J5: Conn_01x02; PinHeader_1x02_P2.54mm_Vertical
K1: G2RL-2; Relay_DPDT_Omron_G2RL-2
Q1: BC817; SOT-23
R1, R4: 50k; R_0805_2012Metric_Pad1.20x1.40mm_HandSolder_Duane
R2: 1k; R_0805_2012Metric_Pad1.20x1.40mm_HandSolder_Duane
R3: 680R; R_0805_2012Metric_Pad1.20x1.40mm_HandSolder_Duane
R5: 10k; R_0805_2012Metric_Pad1.20x1.40mm_HandSolder_Duane

Connections:
3V3: J3.1
5V: D2.1 (K), J3.3, J5.2, J6.2, K1.A1
DGND: D1.1 (K), J3.2, J6.1, Q1.2 (E), R5.1
EN: J5.1, J6.3, R2.1, R3.1, R5.2
unnamed: D1.2 (A), R3.2
unnamed: D2.2 (A), K1.A2, Q1.3 (C)
unnamed: K1.12, R4.1
unnamed: K1.22, R4.2
unnamed: Q1.1 (B), R2.2
PGND: C1.2, C2.2, C3.1, C4.1, J1.2, J2.2, J4.2
V+: C1.1, C2.1, J2.3, K1.24, R1.2
V+_OUT: J1.3, J4.3, K1.21
V-: C3.2, C4.2, J2.1, K1.14, R1.1
V-_OUT: J1.1, J4.1, K1.11

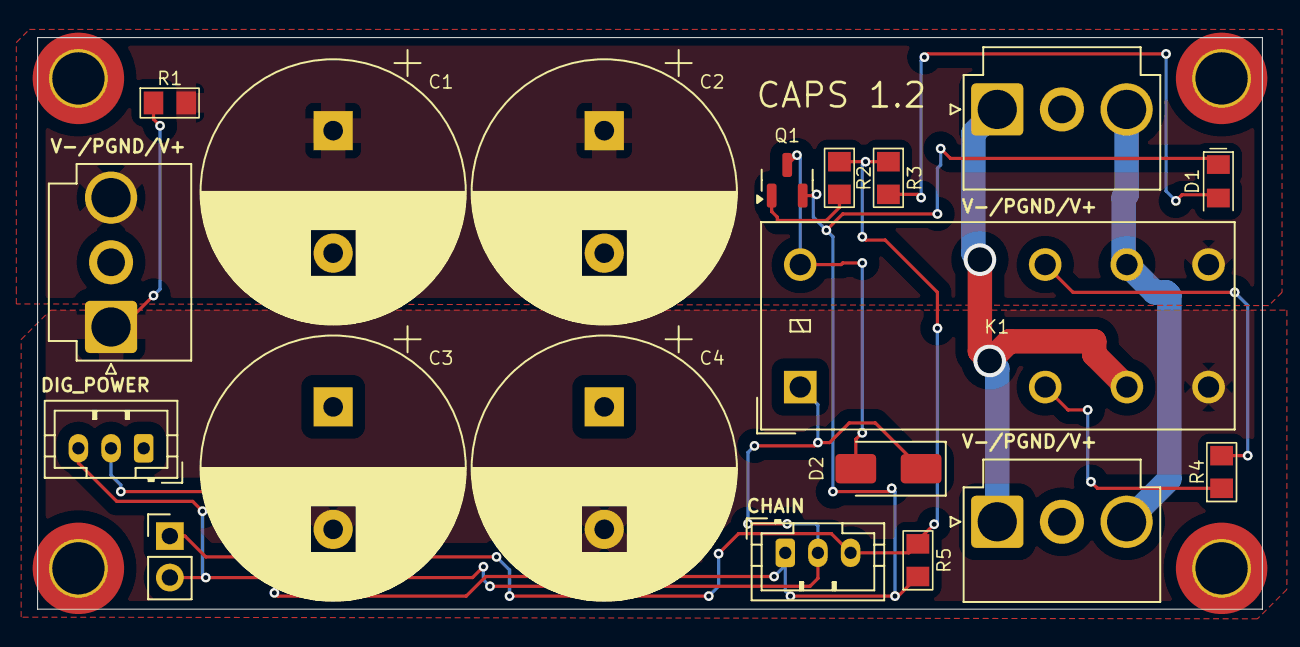
[picture p152: board pcbs/_final_proto/psu-capbanks/1.2-relay/capbanks.kicad_pcb from above]

Board: 2 copper layers, 75.0 x 35.0 mm, 23 parts (0 on the bottom side), 13 nets.
