duanestorey/hifi-amp/pcbs/_final_proto/psu-rectifiers/1.2/rectifier.kicad_pcb

## KiCad design pcbs/_final_proto/psu-rectifiers/1.2/rectifier.kicad_pcb (2025-11-16)

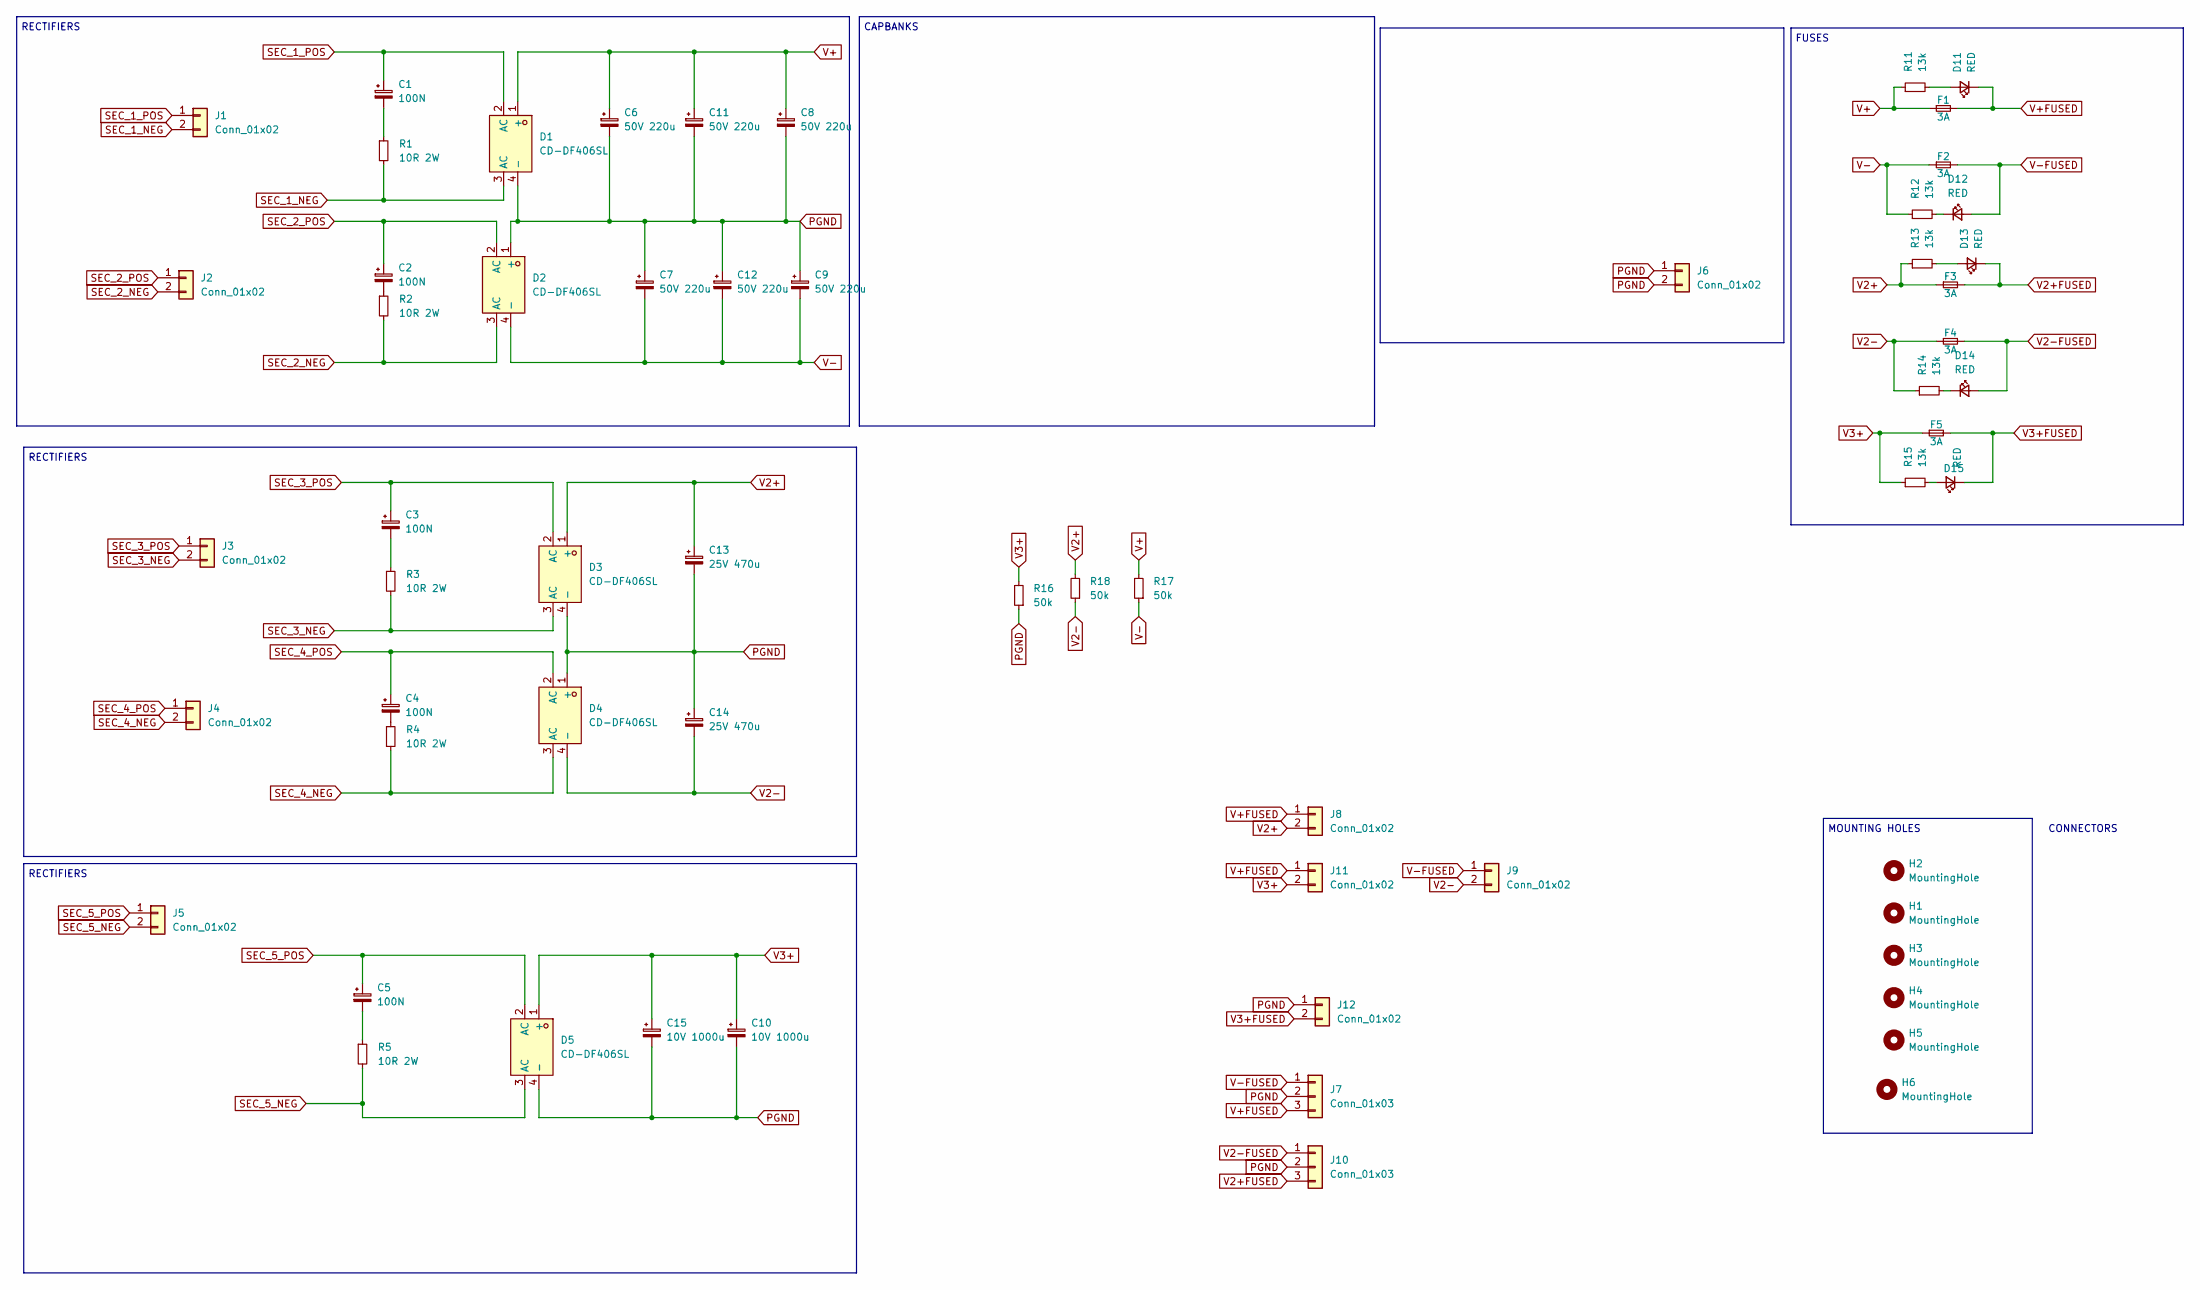
[picture p153: schematic rectifier.kicad_sch]

Parts:
C1, C2, C3, C4, C5: 100N; C_Rect_L10.3mm_W4.5mm_P7.50mm_MKS4; Mouser MKP4F031002D00KF00
C6, C7, C8, C9, C11, C12: 50V 220u; CP_Elec_10x10.5
C10, C15: 10V 1000u; CP_Elec_10x10.5
C13, C14: 25V 470u; CP_Elec_10x10.5
D1, D2, D3, D4, D5: CD-DF406SL; Z4-D_4P-L10.5-W8.1-P5.08-TL; LCSC Part C17188088
D11, D12, D13, D14, D15: RED; LED_0805_2012Metric_Pad_HandSolder_Duane
F1, F2, F3, F4, F5: 3A; Fuse_1812_AliExpress
H1, H2, H3, H4, H5, H6: MountingHole; MountingHole_3.2mm_M3_DIN965_Pad_TopBottom
J1, J2, J3, J4, J5, J6: Conn_01x02; JST_VH_B2P-VH-B_1x02_P3.96mm_Vertical
J7, J10: Conn_01x03; JST_VH_B3P-VH-B_1x03_P3.96mm_Vertical_Duane
J8, J9, J11: Conn_01x02; PinHeader_1x02_P2.54mm_Vertical
J12: Conn_01x02; JST_VH_B2P-VH-B_1x02_P3.96mm_Vertical_Duane
R1, R2, R3, R4, R5: 10R 2W; R_2512_6332Metric_Pad1.40x3.35mm_HandSolder; Mouser 603-SR2512JK-7W10RL
R11, R12, R13, R14, R15: 13k; R_0805_2012Metric_Pad1.20x1.40mm_HandSolder_Duane; Mouser 603-SR2512JK-7W10RL
R16, R17, R18: 50k; R_0805_2012Metric_Pad1.20x1.40mm_HandSolder_Duane; Mouser 603-SR2512JK-7W10RL

Connections:
unnamed: C1.2, R1.1
unnamed: C2.2, R2.1
unnamed: C3.2, R3.1
unnamed: C4.2, R4.1
unnamed: C5.2, R5.1
unnamed: D11.2 (A), R11.2
unnamed: D12.1 (K), R12.2
unnamed: D13.2 (A), R13.2
unnamed: D14.1 (K), R14.2
unnamed: D15.2 (A), R15.2
PGND: C6.2, C7.1, C8.2, C9.1, C10.2, C11.2, C12.1, C13.2, C14.1, C15.2, D1.4 (-), D2.1 (+), D3.4 (-), D4.1 (+), D5.4 (-), J6.1, J6.2, J7.2, J10.2, J12.1, R16.1
SEC_1_NEG: D1.3 (AC), J1.2, R1.2
SEC_1_POS: C1.1, D1.2 (AC), J1.1
SEC_2_NEG: D2.3 (AC), J2.2, R2.2
SEC_2_POS: C2.1, D2.2 (AC), J2.1
SEC_3_NEG: D3.3 (AC), J3.2, R3.2
SEC_3_POS: C3.1, D3.2 (AC), J3.1
SEC_4_NEG: D4.3 (AC), J4.2, R4.2
SEC_4_POS: C4.1, D4.2 (AC), J4.1
SEC_5_NEG: D5.3 (AC), J5.2, R5.2
SEC_5_POS: C5.1, D5.2 (AC), J5.1
V2+: C13.1, D3.1 (+), F3.1, J8.2, R13.1, R18.2
V2+FUSED: D13.1 (K), F3.2, J10.3
V2-: C14.2, D4.4 (-), F4.1, J9.2, R14.1, R18.1
V2-FUSED: D14.2 (A), F4.2, J10.1
V3+: C10.1, C15.1, D5.1 (+), F5.1, J11.2, R15.1, R16.2
V3+FUSED: D15.1 (K), F5.2, J12.2
V+: C6.1, C8.1, C11.1, D1.1 (+), F1.1, R11.1, R17.2
V+FUSED: D11.1 (K), F1.2, J7.3, J8.1, J11.1
V-: C7.2, C9.2, C12.2, D2.4 (-), F2.1, R12.1, R17.1
V-FUSED: D12.2 (A), F2.2, J7.1, J9.1

Notes on the sheet:
MOUNTING HOLES
RECTIFIERS
CONNECTORS
CAPBANKS
FUSES

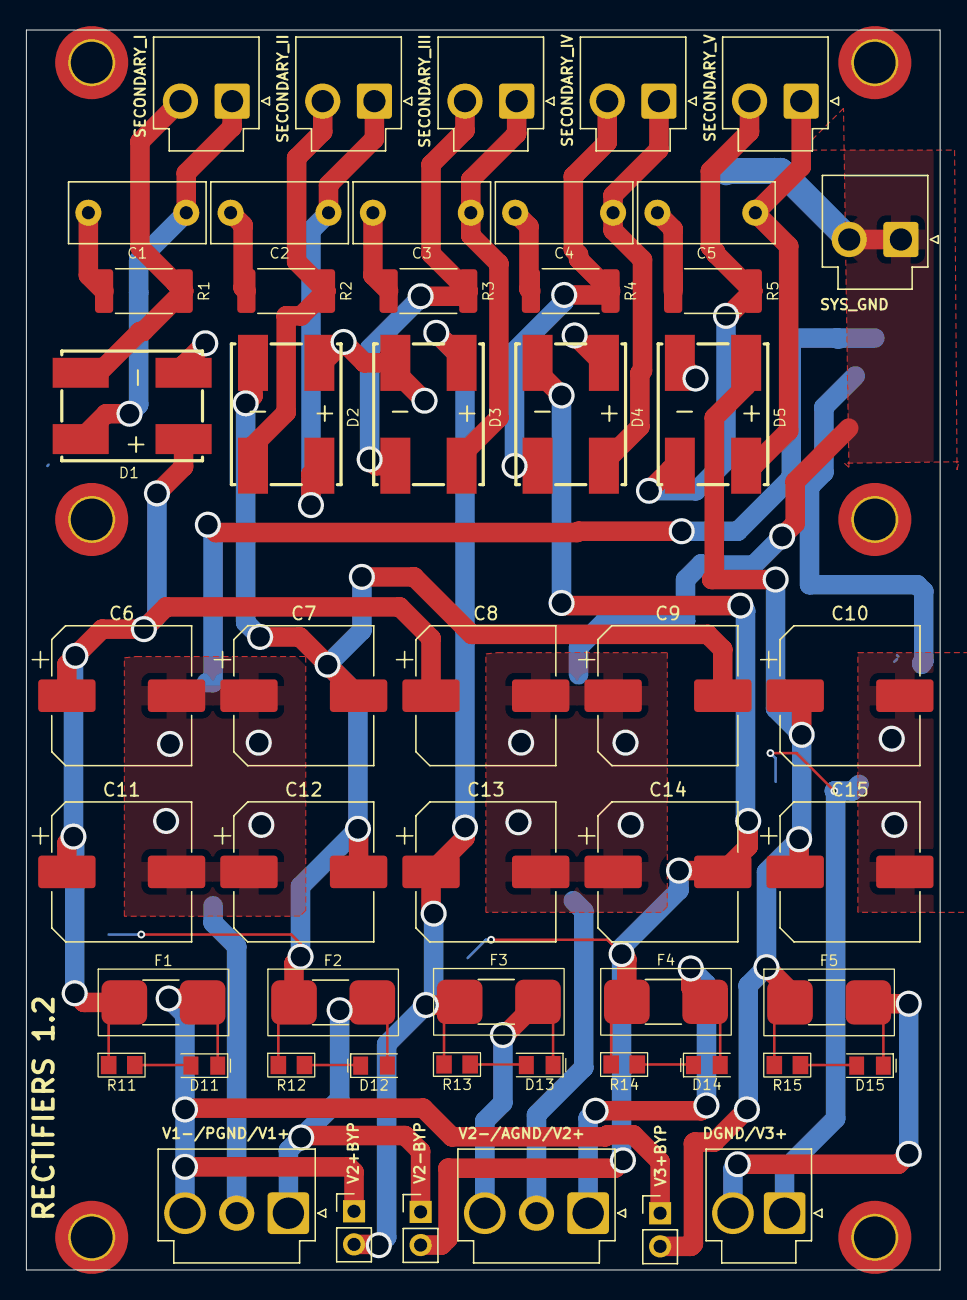
[picture p154: board pcbs/_final_proto/psu-rectifiers/1.2/rectifier.kicad_pcb from above]

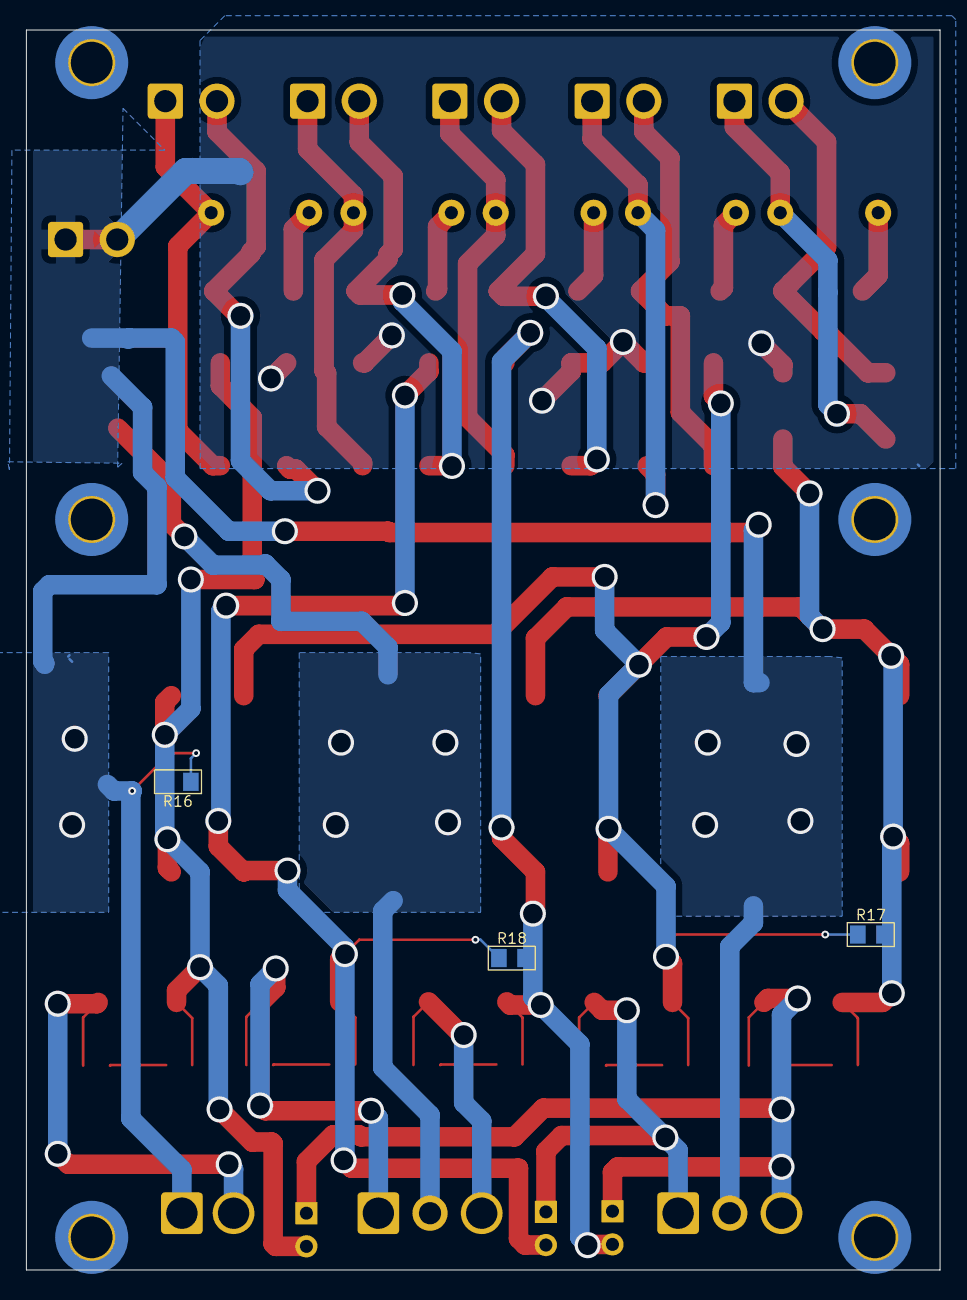
[picture p155: board pcbs/_final_proto/psu-rectifiers/1.2/rectifier.kicad_pcb from below]

Board: 2 copper layers, 70.0 x 95.0 mm, 61 parts (3 on the bottom side), 31 nets.
