duanestorey/hifi-amp/pcbs/_final_proto/lm3886/1.1/lm3886.kicad_pcb

## KiCad design pcbs/_final_proto/lm3886/1.1/lm3886.kicad_pcb (2025-11-16)

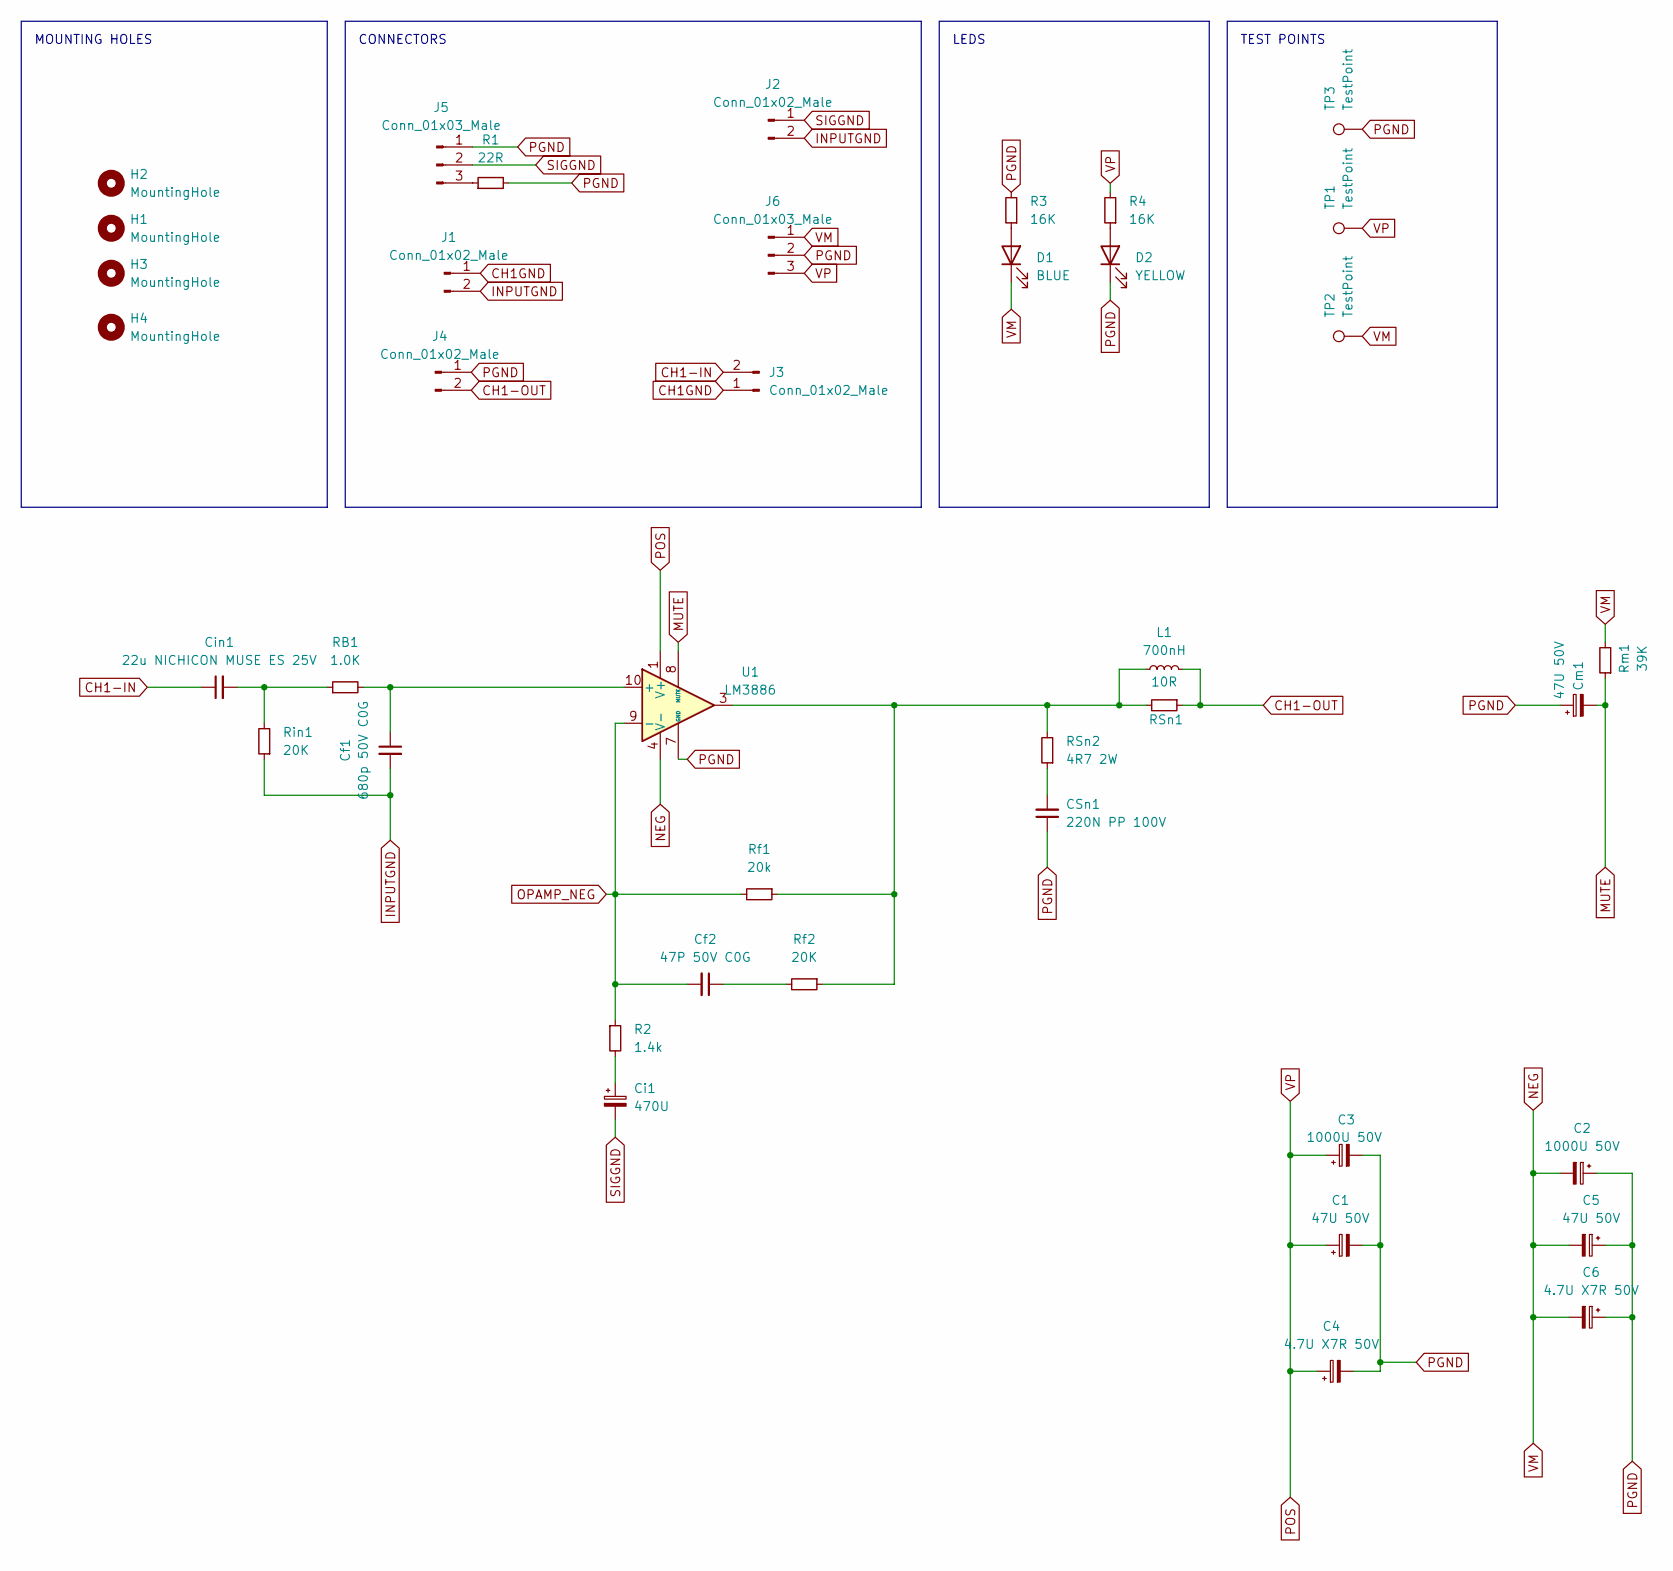
[picture p156: schematic lm3886.kicad_sch]

Parts:
C1, C5: 47U 50V; CP_Radial_D6.3mm_P2.50mm
C2, C3: 1000U 50V; CP_Radial_D12.5mm_P5.00mm
C4, C6: 4.7U X7R 50V; C_1206_3216Metric_Pad1.33x1.80mm_HandSolder; Mouser 80-C1206X475J5RACTU
CSn1: 220N PP 100V; C_Rect_L18.0mm_W7.0mm_P15.00mm_FKS3_FKP3; Mouser 505-MKP1D032204D00JB
Cf1: 680p 50V C0G; C_1206_3216Metric_Pad1.33x1.80mm_HandSolder; Mouser 603-CC126GRNPO9BN681
Cf2: 47P 50V C0G; C_1206_3216Metric_Pad1.33x1.80mm_HandSolder; Mouser 791-1206N470F500CT
Ci1: 470U; CP_Radial_D12.5mm_P5.00mm
Cin1: 22u NICHICON MUSE ES 25V; C_Radial_D6.3mm_H5.0mm_P2.50mm
Cm1: 47U 50V; CP_Radial_D6.3mm_P2.50mm
D1: BLUE; LED_0805_2012Metric_Pad1.15x1.40mm_HandSolder
D2: YELLOW; LED_0805_2012Metric_Pad1.15x1.40mm_HandSolder
H1, H2, H3, H4: MountingHole; MountingHole_3.2mm_M3_DIN965_Pad_TopOnly
J1, J2: Conn_01x02_Male; PinHeader_1x02_P2.54mm_Vertical
J3: Conn_01x02_Male; TerminalBlock_Phoenix_PT-1,5-2-3.5-H_1x02_P3.50mm_Horizontal
J4: Conn_01x02_Male; TerminalBlock_Phoenix_PT-1,5-2-5.0-H_1x02_P5.00mm_Horizontal
J5: Conn_01x03_Male; PinHeader_1x03_P2.54mm_Vertical
J6: Conn_01x03_Male; TerminalBlock_Phoenix_PT-1,5-3-5.0-H_1x03_P5.00mm_Horizontal
L1: 700nH; 500nH Inductor Aliexpress Air Gap
R1: 22R; R_1206_3216Metric_Pad1.30x1.75mm_HandSolder
R2: 1.4k; R_1206_3216Metric_Pad1.30x1.75mm_HandSolder; Mouser RC1206FR-071K4L
R3, R4: 16K; R_0805_2012Metric_Pad1.20x1.40mm_HandSolder_Duane
RB1: 1.0K; R_1206_3216Metric_Pad1.30x1.75mm_HandSolder; Mouser 603-RT1206FRE131KL
RSn1: 10R; R_4020_10251Metric_Pad1.65x5.30mm_HandSolder; Mouser 279-355010RJT
RSn2: 4R7 2W; R_2512_6332Metric_Pad1.40x3.35mm_HandSolder; Mouser 603-RC2512JK-7W4R7
Rf1: 20k; R_1206_3216Metric_Pad1.30x1.75mm_HandSolder; Mouser 603-RT1206FRD0720KL
Rf2: 20K; R_1206_3216Metric_Pad1.30x1.75mm_HandSolder; Mouser 603-RT1206FRD0720KL
Rin1: 20K; R_1206_3216Metric_Pad1.30x1.75mm_HandSolder; Mouser 603-RT1206FRD0720KL
Rm1: 39K; R_1206_3216Metric_Pad1.30x1.75mm_HandSolder; Mouser 603-RC1206JR-0739KL
TP1, TP2, TP3: TestPoint; TestPoint_THTPad_1.5x1.5mm_Drill0.7mm
U1: LM3886

Connections:
CH1-IN: Cin1.1, J3.2
CH1-OUT: J4.2, L1.2, RSn1.1
CH1GND: J1.1, J3.1
INPUTGND: Cf1.2, J1.2, J2.2, Rin1.1
MUTE: Cm1.2, Rm1.1, U1.8 (MUTE)
NEG: C2.2, C5.2, C6.2, D1.1 (K), J6.1, Rm1.2, TP2.1, U1.4 (V-)
unnamed: CSn1.2, RSn2.1
unnamed: Cf2.1, Rf2.2
unnamed: Ci1.1, R2.2
unnamed: Cin1.2, RB1.1, Rin1.2
unnamed: D1.2 (A), R3.1
unnamed: D2.2 (A), R4.1
unnamed: J5.3, R1.1
unnamed: L1.1, RSn1.2, RSn2.2, Rf1.1, Rf2.1, U1.3
unnamed: Cf1.1, RB1.2, U1.10 (+)
OPAMP_NEG: Cf2.2, R2.1, Rf1.2, U1.9 (-)
PGND: C1.2, C2.1, C3.2, C4.2, C5.1, C6.1, CSn1.1, Cm1.1, D2.1 (K), J4.1, J5.1, J6.2, R1.2, R3.2, TP3.1, U1.7 (GND)
POS: C1.1, C3.1, C4.1, J6.3, R4.2, TP1.1, U1.1 (V+), U1.5 (V+)
SIGGND: Ci1.2, J2.1, J5.2

Notes on the sheet:
TEST POINTS
MOUNTING HOLES
CONNECTORS
LEDS

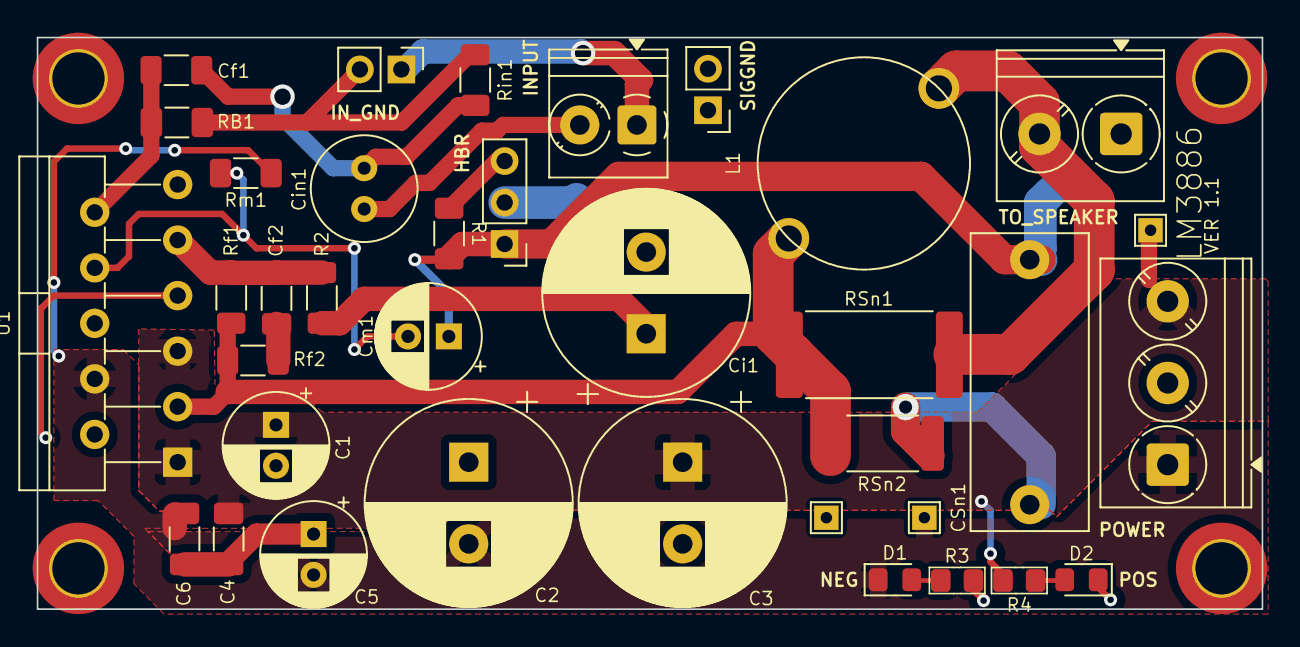
[picture p157: board pcbs/_final_proto/lm3886/1.1/lm3886.kicad_pcb from above]

Board: 2 copper layers, 75.0 x 35.0 mm, 40 parts (0 on the bottom side), 19 nets.
