duanestorey/hifi-amp/pcbs/_final_proto/psu-analog-digital/1.1/rectifier.kicad_pcb

## KiCad design pcbs/_final_proto/psu-analog-digital/1.1/rectifier.kicad_pcb (2025-11-16)

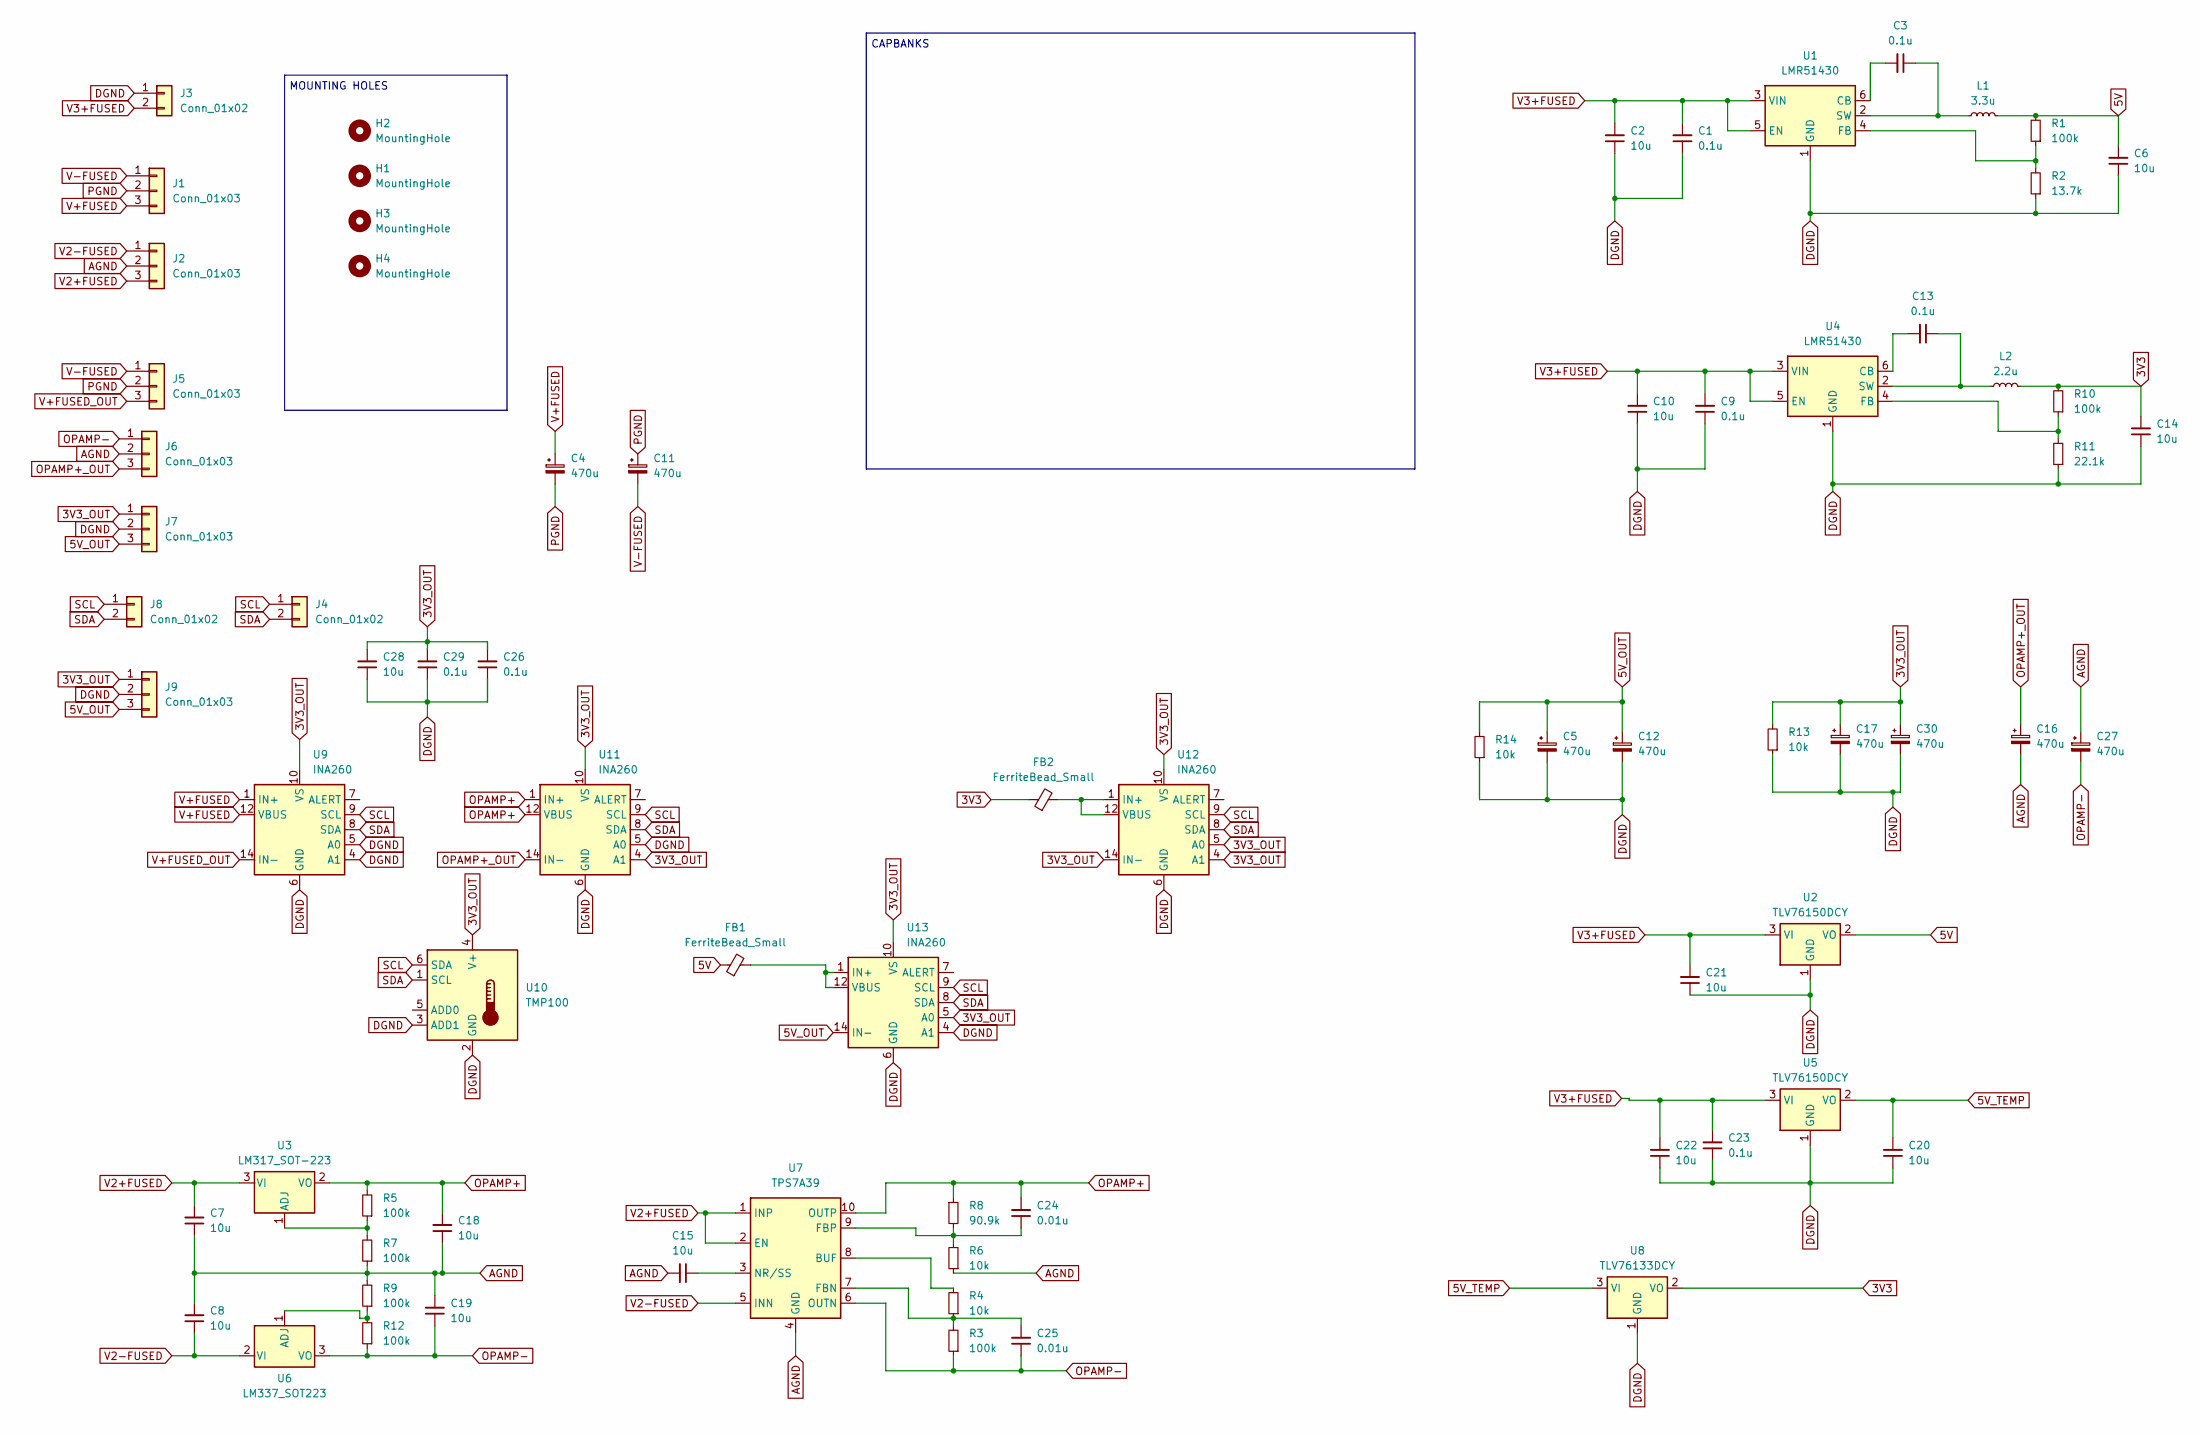
[picture p160: schematic rectifier.kicad_sch]

Parts:
C1, C3, C9, C13, C23, C26, C29: 0.1u; C_0805_2012Metric_Pad1.18x1.45mm_HandSolder_Duane
C2, C6, C7, C8, C10, C14, C15, C18, C19, C20, C21, C22, C28: 10u; C_1206_3216Metric_Pad1.33x1.80mm_HandSolder_Duane
C4, C5, C11, C12, C16, C17, C27, C30: 470u; CP_Elec_6.3x7.7
C24, C25: 0.01u; C_0805_2012Metric_Pad1.18x1.45mm_HandSolder_Duane
FB1, FB2: FerriteBead_Small; R_0805_2012Metric_Pad1.20x1.40mm_HandSolder_Duane
H1, H2, H3, H4: MountingHole; MountingHole_3.2mm_M3_DIN965_Pad_TopBottom
J1, J2, J5, J6, J7: Conn_01x03; JST_VH_B3P-VH-B_1x03_P3.96mm_Vertical_Duane
J3: Conn_01x02; JST_VH_B2P-VH-B_1x02_P3.96mm_Vertical_Duane
J4, J8: Conn_01x02; JST_PH_B2B-PH-K_1x02_P2.00mm_Vertical
J9: Conn_01x03; JST_PH_B3B-PH-K_1x03_P2.00mm_Vertical
L1: 3.3u; L_Wuerth_HCI-7030
L2: 2.2u; L_Wuerth_HCI-7030
R1, R3, R5, R7, R9, R10, R12: 100k; R_0805_2012Metric_Pad1.20x1.40mm_HandSolder_Duane
R2: 13.7k; R_0805_2012Metric_Pad1.20x1.40mm_HandSolder_Duane
R4, R6, R13, R14: 10k; R_0805_2012Metric_Pad1.20x1.40mm_HandSolder_Duane
R8: 90.9k; R_0805_2012Metric_Pad1.20x1.40mm_HandSolder_Duane
R11: 22.1k; R_0805_2012Metric_Pad1.20x1.40mm_HandSolder_Duane
U1, U4: LMR51430; SOT-23-6
U2, U5: TLV76150DCY; SOT-223-3_TabPin2
U3: LM317_SOT-223; SOT-223-3_TabPin2
U6: LM337_SOT223; SOT-223-3_TabPin2
U7: TPS7A39; Texas_S-PVSON-N10_ThermalVias
U8: TLV76133DCY; SOT-223-3_TabPin2
U9, U11, U12, U13: INA260; TSSOP-16_4.4x5mm_P0.65mm
U10: TMP100; SOT-23-6

Connections:
3V3: C14.2, FB2.1, L2.2, R10.2, U8.2 (VO)
3V3_OUT: C17.1, C26.2, C28.2, C29.2, C30.1, J7.1, J9.1, R13.2, U9.10 (VS), U10.4 (V+), U11.4 (A1), U11.10 (VS), U12.4 (A1), U12.5 (A0), U12.10 (VS), U12.14 (IN-), U12.15 (IN-), U12.16 (IN-), U13.5 (A0), U13.10 (VS)
5V: C6.2, FB1.1, L1.2, R1.2, U2.2 (VO)
5V_OUT: C5.1, C12.1, J7.3, J9.3, R14.2, U13.14 (IN-), U13.15 (IN-), U13.16 (IN-)
5V_TEMP: C20.2, U5.2 (VO), U8.3 (VI)
AGND: C7.1, C8.2, C15.2, C16.2, C18.1, C19.2, C27.1, J2.2, J6.2, R6.1, R7.1, R9.2, U7.4 (GND), U7.11 (GND)
DGND: C1.1, C2.1, C5.2, C6.1, C9.1, C10.1, C12.2, C14.1, C17.2, C20.1, C21.1, C22.1, C23.1, C26.1, C28.1, C29.1, C30.2, J3.1, J7.2, J9.2, R2.1, R11.1, R13.1, R14.1, U1.1 (GND), U2.1 (GND), U4.1 (GND), U5.1 (GND), U8.1 (GND), U9.4 (A1), U9.5 (A0), U9.6 (GND), U9.11 (GND), U10.2 (GND), U10.3 (ADD1), U11.5 (A0), U11.6 (GND), U11.11 (GND), U12.6 (GND), U12.11 (GND), U13.4 (A1), U13.6 (GND), U13.11 (GND)
unnamed: C3.2, U1.6 (CB)
unnamed: R1.1, R2.2, U1.4 (FB)
unnamed: C3.1, L1.1, U1.2 (SW)
unnamed: R5.1, R7.2, U3.1 (ADJ)
unnamed: C13.2, U4.6 (CB)
unnamed: R10.1, R11.2, U4.4 (FB)
unnamed: C13.1, L2.1, U4.2 (SW)
unnamed: R9.1, R12.2, U6.1 (ADJ)
unnamed: R4.2, U7.8 (BUF)
unnamed: C25.2, R3.2, R4.1, U7.7 (FBN)
unnamed: C24.1, R6.2, R8.2, U7.9 (FBP)
unnamed: C15.1, U7.3 (NR/SS)
unnamed: FB2.2, U12.1 (IN+), U12.2 (IN+), U12.3 (IN+), U12.12 (VBUS)
unnamed: FB1.2, U13.1 (IN+), U13.2 (IN+), U13.3 (IN+), U13.12 (VBUS)
OPAMP+: C18.2, C24.2, R5.2, R8.1, U3.2 (VO), U7.10 (OUTP), U11.1 (IN+), U11.2 (IN+), U11.3 (IN+), U11.12 (VBUS)
OPAMP+_OUT: C16.1, J6.3, U11.14 (IN-), U11.15 (IN-), U11.16 (IN-)
OPAMP-: C19.1, C25.1, C27.2, J6.1, R3.1, R12.1, U6.3 (VO), U7.6 (OUTN)
PGND: C4.2, C11.1, J1.2, J5.2
SCL: J4.1, J8.1, U9.9 (SCL), U10.6 (SDA), U11.9 (SCL), U12.9 (SCL), U13.9 (SCL)
SDA: J4.2, J8.2, U9.8 (SDA), U10.1 (SCL), U11.8 (SDA), U12.8 (SDA), U13.8 (SDA)
V2+FUSED: C7.2, J2.3, U3.3 (VI), U7.1 (INP), U7.2 (EN)
V2-FUSED: C8.1, J2.1, U6.2 (VI), U7.5 (INN)
V3+FUSED: C1.2, C2.2, C9.2, C10.2, C21.2, C22.2, C23.2, J3.2, U1.3 (VIN), U1.5 (EN), U2.3 (VI), U4.3 (VIN), U4.5 (EN), U5.3 (VI)
V+FUSED: C4.1, J1.3, U9.1 (IN+), U9.2 (IN+), U9.3 (IN+), U9.12 (VBUS)
V+FUSED_OUT: J5.3, U9.14 (IN-), U9.15 (IN-), U9.16 (IN-)
V-FUSED: C11.2, J1.1, J5.1

Notes on the sheet:
MOUNTING HOLES
CAPBANKS

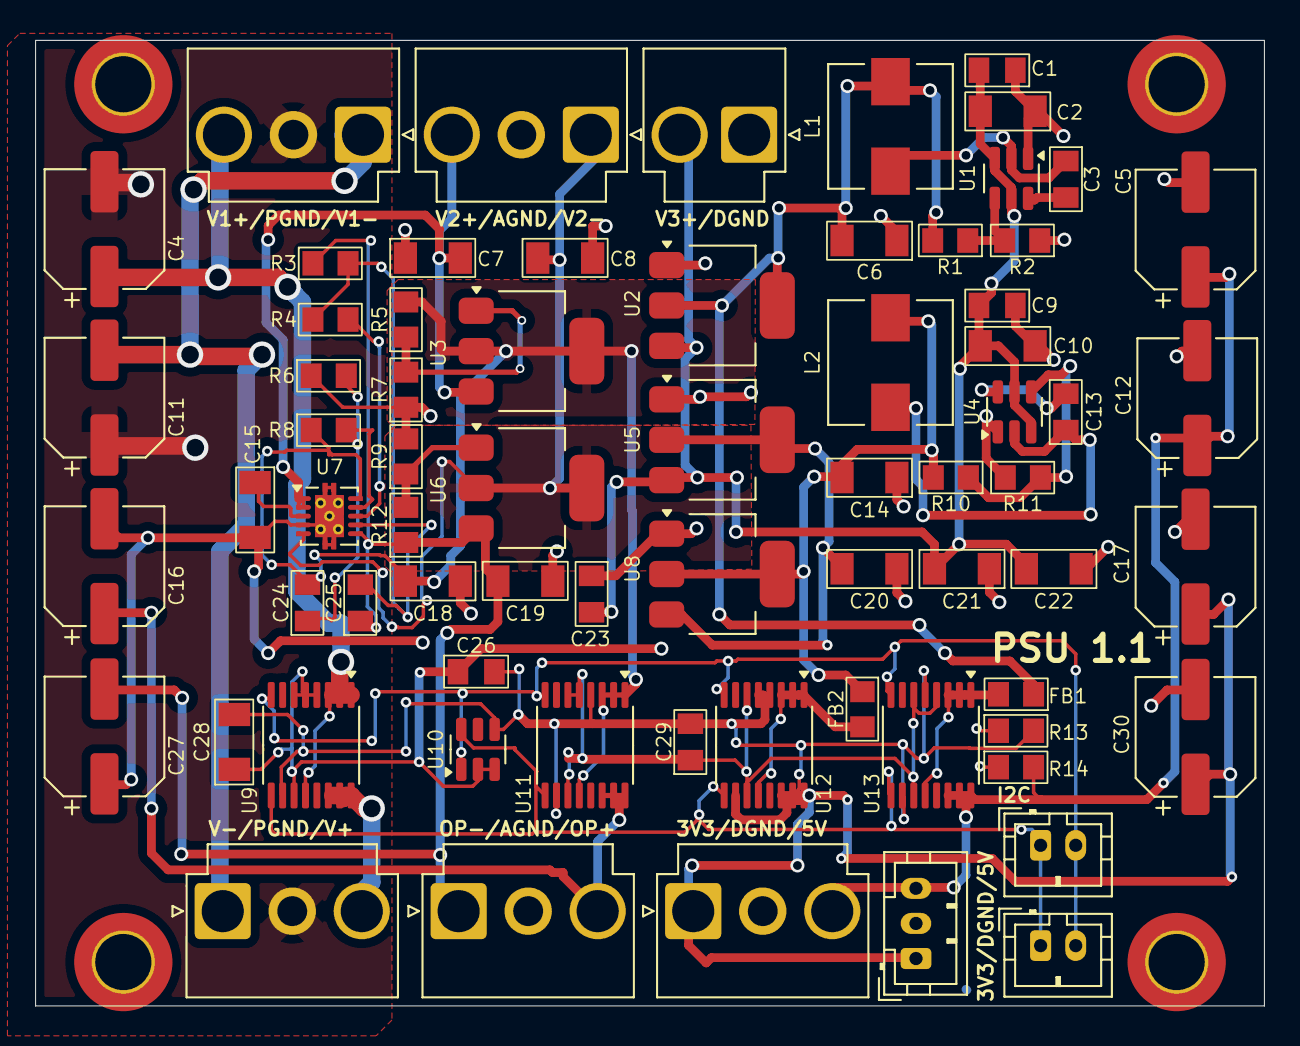
[picture p161: board pcbs/_final_proto/psu-analog-digital/1.1/rectifier.kicad_pcb from above]

Board: 2 copper layers, 70.0 x 55.0 mm, 74 parts (0 on the bottom side), 33 nets.
