duanestorey/hifi-amp/pcbs/_final_proto/psu-analog-digital/1.1-linear/rectifier.kicad_pcb

## KiCad design pcbs/_final_proto/psu-analog-digital/1.1-linear/rectifier.kicad_pcb (2025-11-16)

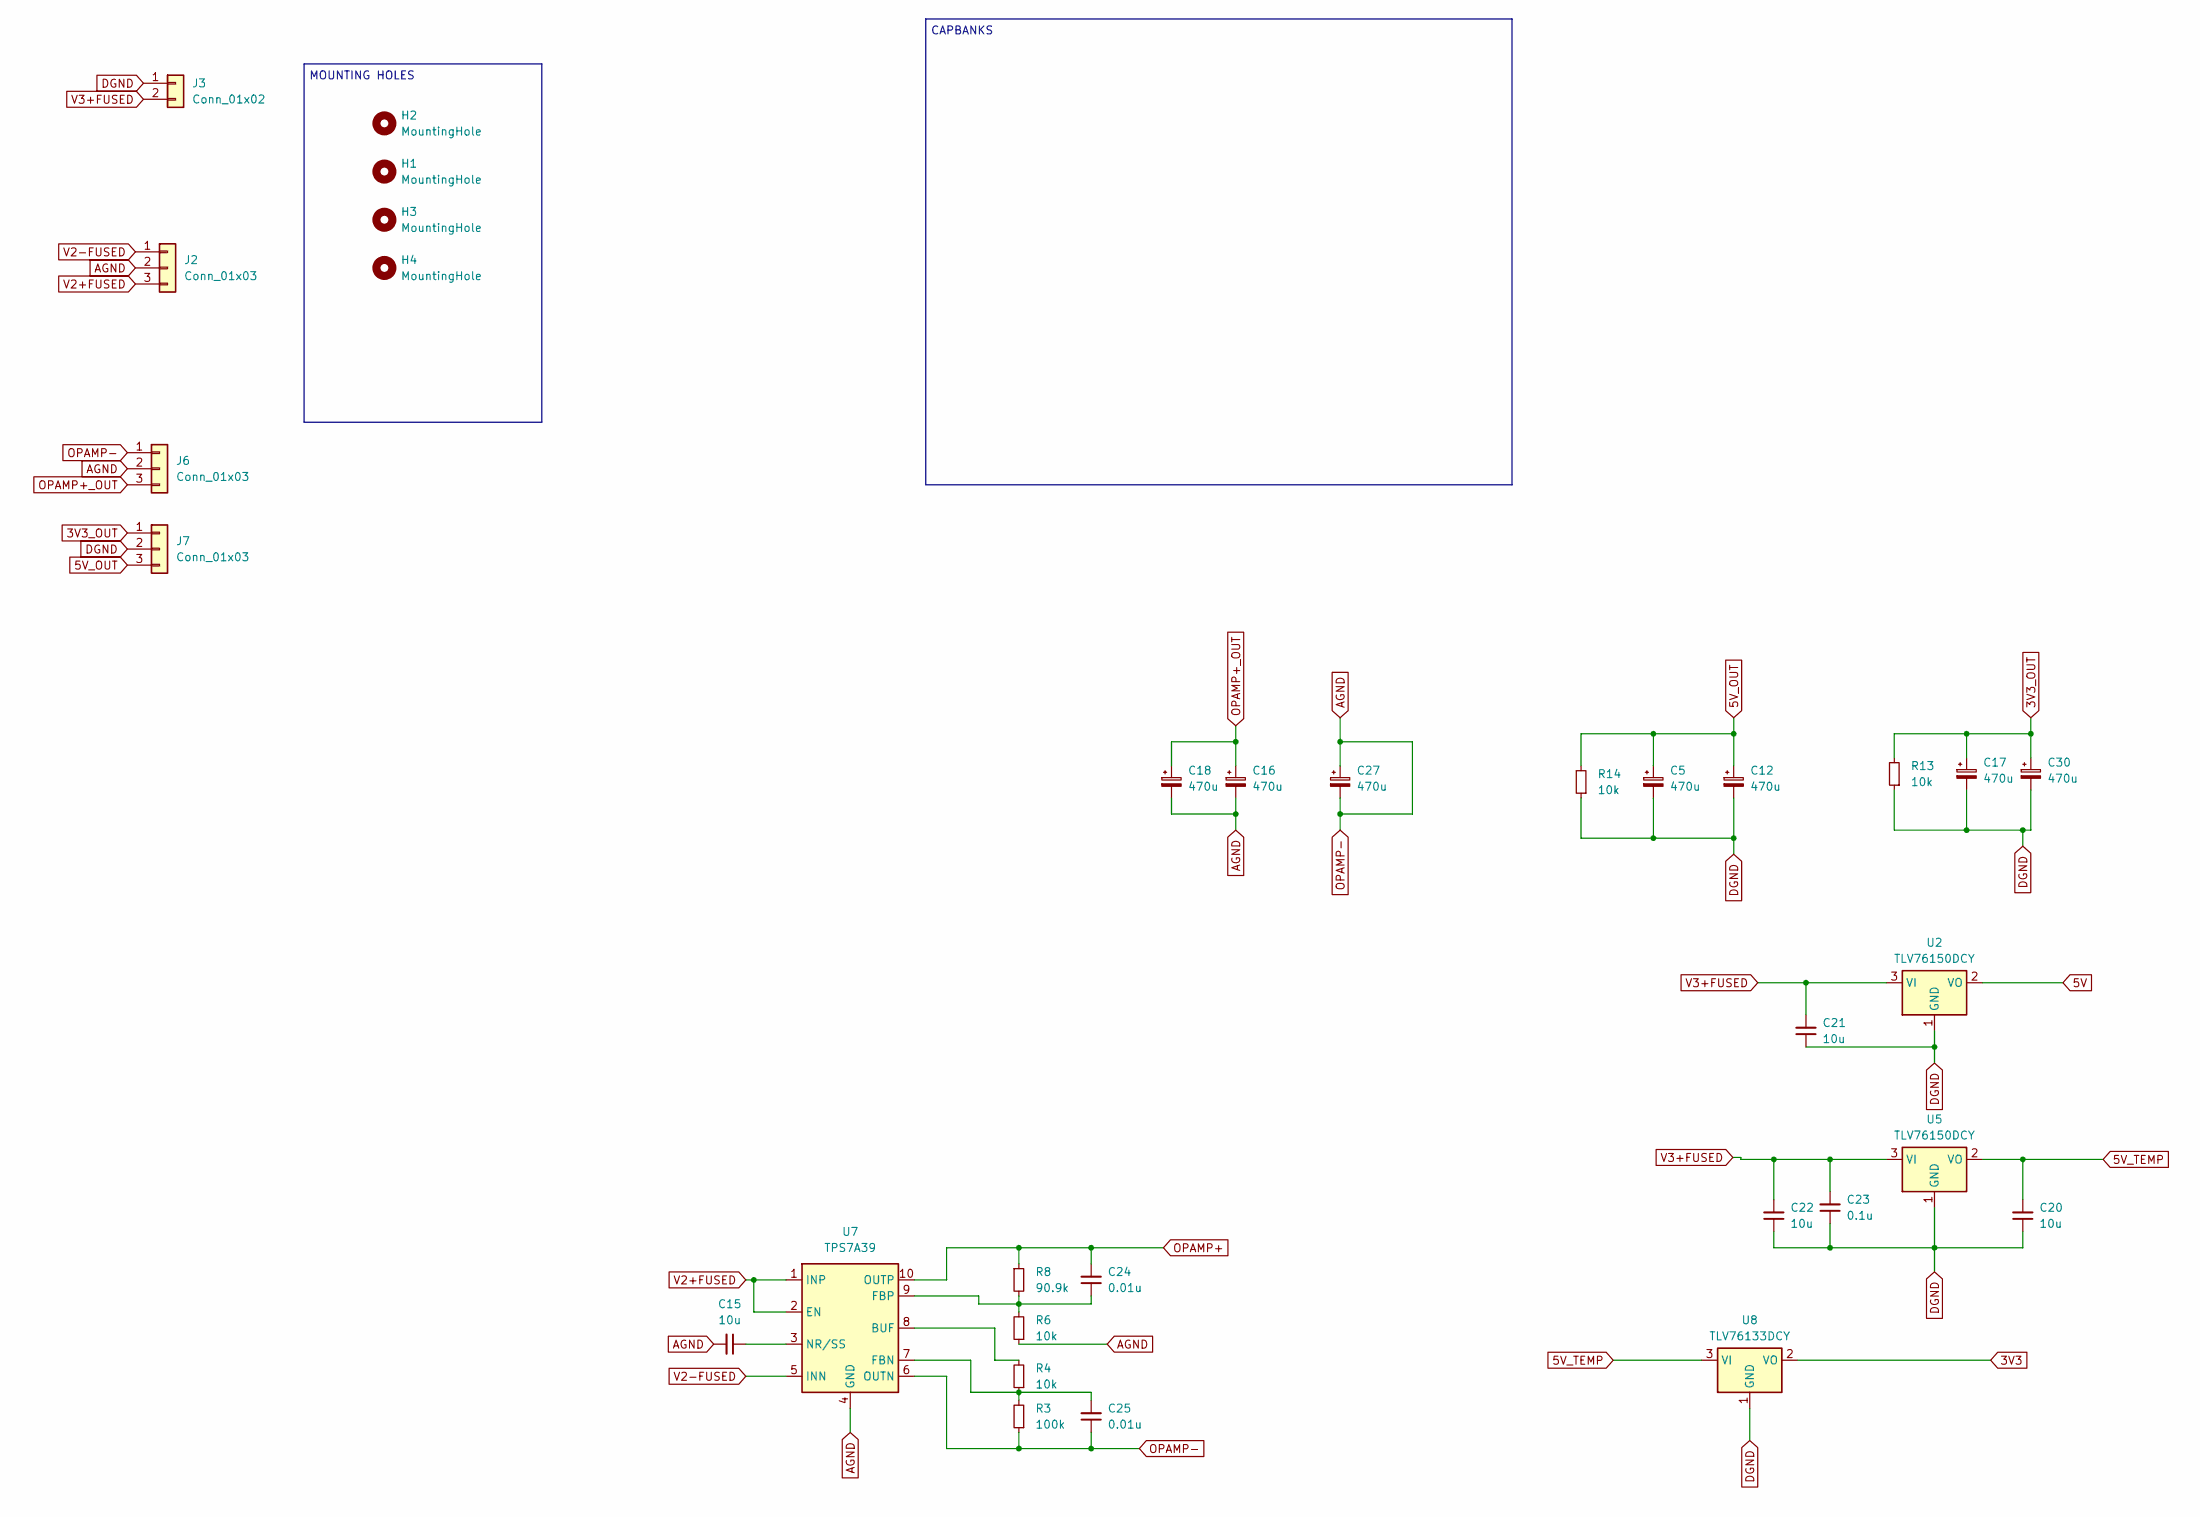
[picture p162: schematic rectifier.kicad_sch]

Parts:
C5, C12, C16, C17, C18, C27, C30: 470u; CP_Elec_6.3x7.7
C15, C20, C21, C22: 10u; C_1206_3216Metric_Pad1.33x1.80mm_HandSolder_Duane
C23: 0.1u; C_0805_2012Metric_Pad1.18x1.45mm_HandSolder_Duane
C24, C25: 0.01u; C_0805_2012Metric_Pad1.18x1.45mm_HandSolder_Duane
H1, H2, H3, H4: MountingHole; MountingHole_3.2mm_M3_DIN965_Pad_TopBottom
J2, J6, J7: Conn_01x03; JST_VH_B3P-VH-B_1x03_P3.96mm_Vertical_Duane
J3: Conn_01x02; JST_VH_B2P-VH-B_1x02_P3.96mm_Vertical_Duane
R3: 100k; R_0805_2012Metric_Pad1.20x1.40mm_HandSolder_Duane
R4, R6, R13, R14: 10k; R_0805_2012Metric_Pad1.20x1.40mm_HandSolder_Duane
R8: 90.9k; R_0805_2012Metric_Pad1.20x1.40mm_HandSolder_Duane
U2, U5: TLV76150DCY; SOT-223-3_TabPin2
U7: TPS7A39; Texas_S-PVSON-N10_ThermalVias
U8: TLV76133DCY; SOT-223-3_TabPin2

Connections:
3V3: U8.2 (VO)
3V3_OUT: C17.1, C30.1, J7.1, R13.2
5V: U2.2 (VO)
5V_OUT: C5.1, C12.1, J7.3, R14.2
5V_TEMP: C20.2, U5.2 (VO), U8.3 (VI)
AGND: C15.2, C16.2, C18.2, C25.1, C27.1, C27.2, J2.2, J6.1, J6.2, R3.1, R6.1, U7.4 (GND), U7.6 (OUTN), U7.11 (GND)
DGND: C5.2, C12.2, C17.2, C20.1, C21.1, C22.1, C23.1, C30.2, J3.1, J7.2, R13.1, R14.1, U2.1 (GND), U5.1 (GND), U8.1 (GND)
unnamed: R4.2, U7.8 (BUF)
unnamed: C25.2, R3.2, R4.1, U7.7 (FBN)
unnamed: C24.1, R6.2, R8.2, U7.9 (FBP)
unnamed: C15.1, U7.3 (NR/SS)
OPAMP+: C24.2, R8.1, U7.10 (OUTP)
OPAMP+_OUT: C16.1, C18.1, J6.3
V2+FUSED: J2.3, U7.1 (INP), U7.2 (EN)
V2-FUSED: J2.1, U7.5 (INN)
V3+FUSED: C21.2, C22.2, C23.2, J3.2, U2.3 (VI), U5.3 (VI)

Notes on the sheet:
MOUNTING HOLES
CAPBANKS

Board: 2 copper layers, 32 parts (0 on the bottom side), 14 nets, no tracks yet.
