duanestorey/hifi-amp/pcbs/_final_proto/dac-pcm1681/1.0/dac.kicad_pcb

## KiCad design pcbs/_final_proto/dac-pcm1681/1.0/dac.kicad_pcb (2025-11-16)

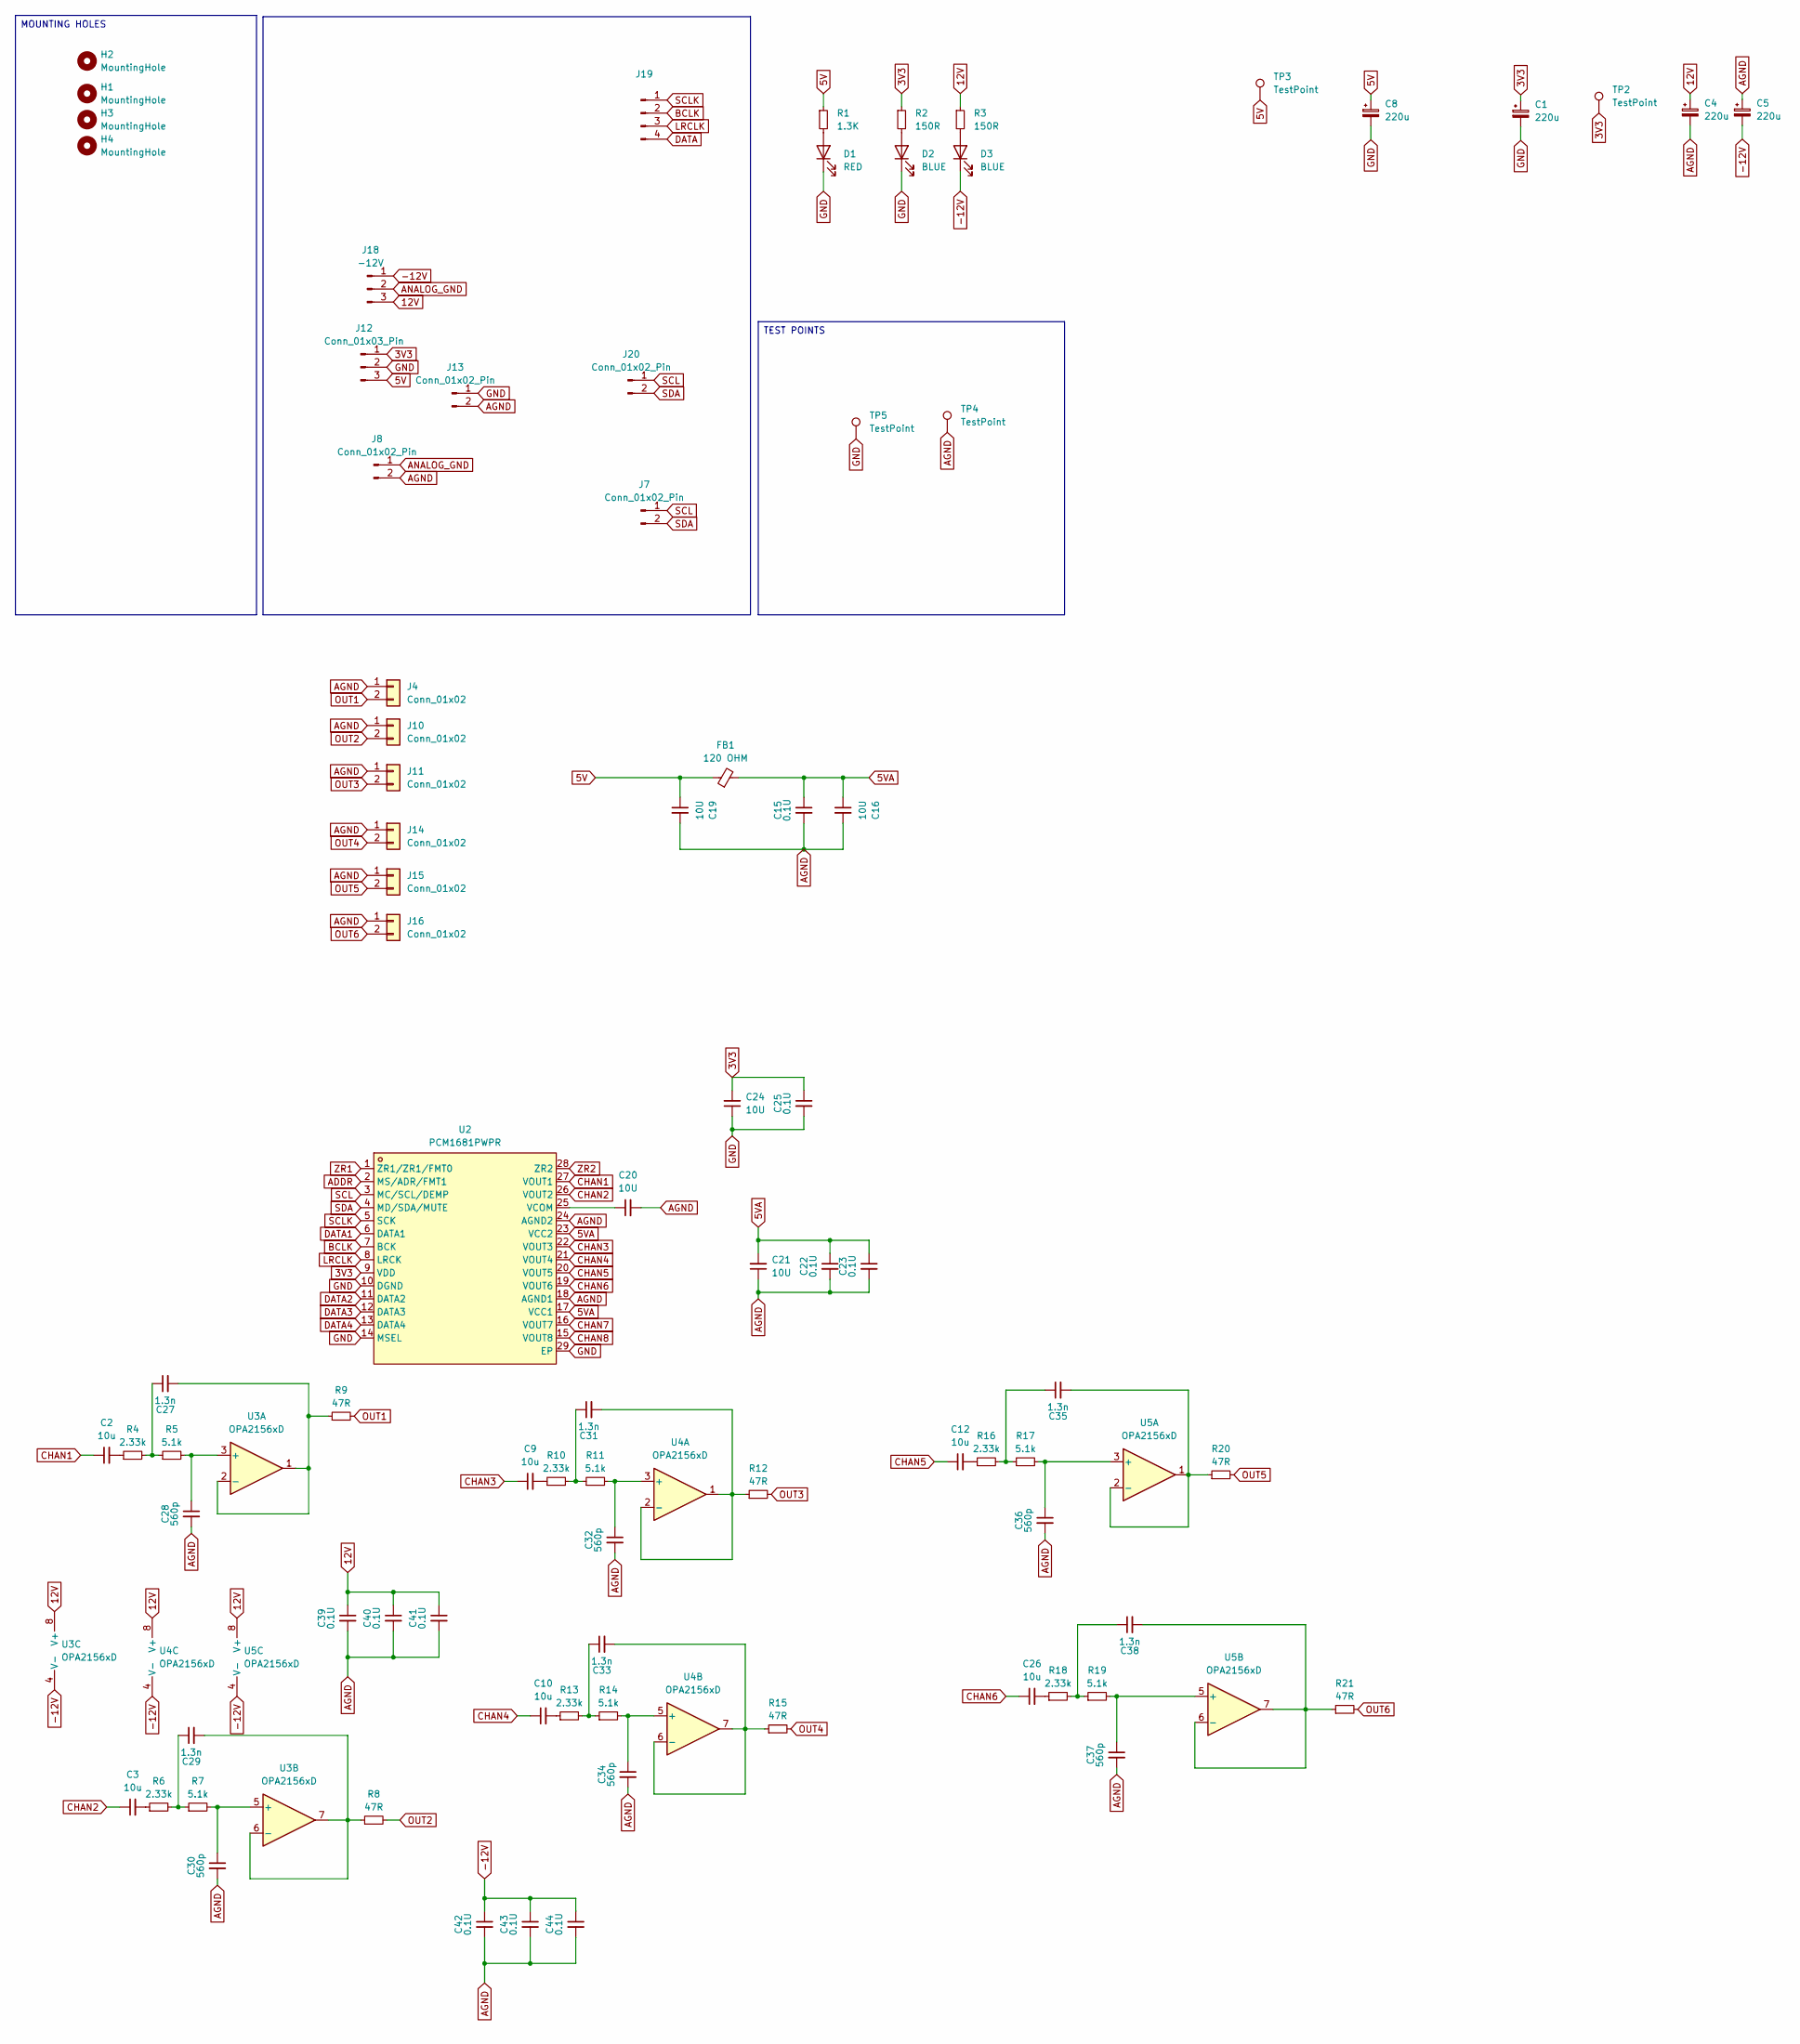
[picture p163: schematic dac.kicad_sch]

Parts:
C1, C4, C5, C8: 220u; CP_Radial_D6.3mm_P2.50mm
C2, C3, C9, C10, C12, C26: 10u; C_Radial_D6.3mm_H5.0mm_P2.50mm
C15, C22, C23, C25, C39, C40, C41, C42, C43, C44: 0.1U; C_0805_2012Metric_Pad1.18x1.45mm_HandSolder
C16, C19, C20, C21, C24: 10U; C_1206_3216Metric_Pad1.33x1.80mm_HandSolder
C27, C29, C31, C33, C35, C38: 1.3n; C_0805_2012Metric_Pad1.18x1.45mm_HandSolder
C28, C30, C32, C34, C36, C37: 560p; C_0805_2012Metric_Pad1.18x1.45mm_HandSolder
D1: RED; LED_0805_2012Metric_Pad1.15x1.40mm_HandSolder
D2, D3: BLUE; LED_0805_2012Metric_Pad1.15x1.40mm_HandSolder
FB1: 120 OHM; R_0603_1608Metric_Pad0.98x0.95mm_HandSolder
H1, H2, H3, H4: MountingHole; MountingHole_3.2mm_M3_DIN965_Pad_TopOnly
J4, J10, J11, J14, J15, J16: Conn_01x02; TerminalBlock_Phoenix_PT-1,5-2-3.5-H_1x02_P3.50mm_Horizontal
J7, J20: Conn_01x02_Pin; JST_PH_B2B-PH-K_1x02_P2.00mm_Vertical
J8, J13: Conn_01x02_Pin; PinHeader_1x02_P2.54mm_Vertical
J12: Conn_01x03_Pin; JST_PH_B3B-PH-K_1x03_P2.00mm_Vertical
J18: -12V; JST_PH_B3B-PH-K_1x03_P2.00mm_Vertical
J19: Conn_01x04_Pin; JST_PH_B4B-PH-K_1x04_P2.00mm_Vertical
R1: 1.3K; R_0805_2012Metric_Pad1.20x1.40mm_HandSolder
R2, R3: 150R; R_0805_2012Metric_Pad1.20x1.40mm_HandSolder
R4, R6, R10, R13, R16, R18: 2.33k; R_0805_2012Metric_Pad1.20x1.40mm_HandSolder
R5, R7, R11, R14, R17, R19: 5.1k; R_0805_2012Metric_Pad1.20x1.40mm_HandSolder
R8, R9, R12, R15, R20, R21: 47R; R_0805_2012Metric_Pad1.20x1.40mm_HandSolder
TP2, TP3, TP4, TP5: TestPoint; TestPoint_THTPad_1.5x1.5mm_Drill0.7mm
U2: PCM1681PWPR; TSSOP-28_L9.7-W4.4-P0.65-LS6.4-BL-EP-3; LCSC Part C181571
U3, U4, U5: OPA2156xD; SOIC-8_3.9x4.9mm_P1.27mm

Connections:
3V3: C1.1, C24.2, C25.1, J12.1, R2.1, TP2.1, U2.9 (VDD)
5V: C8.1, C19.1, FB1.1, J12.3, R1.1, TP3.1
5VA: C15.1, C16.1, C21.2, C22.1, C23.1, FB1.2, U2.17 (VCC1), U2.23 (VCC2)
12V: C4.1, C39.1, C40.1, C41.1, J18.3, R3.1, U3.8 (V+), U4.8 (V+), U5.8 (V+)
-12V: C5.2, C42.1, C43.1, C44.1, D3.1 (K), J18.1, U3.4 (V-), U4.4 (V-), U5.4 (V-)
ADDR: U2.2 (MS/ADR/FMT1)
AGND: C4.2, C5.1, C15.2, C16.2, C19.2, C20.2, C21.1, C22.2, C23.2, C28.2, C30.2, C32.2, C34.2, C36.2, C37.2, C39.2, C40.2, C41.2, C42.2, C43.2, C44.2, J4.1, J8.2, J10.1, J11.1, J13.2, J14.1, J15.1, J16.1, TP4.1, U2.18 (AGND1), U2.24 (AGND2)
ANALOG_GND: J8.1, J18.2
BCLK: J19.2, U2.7 (BCK)
CHAN1: C2.1, U2.27 (VOUT1)
CHAN2: C3.1, U2.26 (VOUT2)
CHAN3: C9.1, U2.22 (VOUT3)
CHAN4: C10.1, U2.21 (VOUT4)
CHAN5: C12.1, U2.20 (VOUT5)
CHAN6: C26.1, U2.19 (VOUT6)
CHAN7: U2.16 (VOUT7)
CHAN8: U2.15 (VOUT8)
DATA: J19.4
DATA1: U2.6 (DATA1)
DATA2: U2.11 (DATA2)
DATA3: U2.12 (DATA3)
DATA4: U2.13 (DATA4)
GND: C1.2, C8.2, C24.1, C25.2, D1.1 (K), D2.1 (K), J12.2, J13.1, TP5.1, U2.10 (DGND), U2.14 (MSEL), U2.29 (EP)
LRCLK: J19.3, U2.8 (LRCK)
unnamed: C2.2, R4.1
unnamed: C3.2, R6.1
unnamed: C9.2, R10.1
unnamed: C10.2, R13.1
unnamed: C12.2, R16.1
unnamed: C26.2, R18.1
unnamed: C27.1, R4.2, R5.1
unnamed: C29.1, R6.2, R7.1
unnamed: C31.1, R10.2, R11.1
unnamed: C33.1, R13.2, R14.1
unnamed: C35.1, R16.2, R17.1
unnamed: C38.1, R18.2, R19.1
unnamed: D1.2 (A), R1.2
unnamed: D2.2 (A), R2.2
unnamed: D3.2 (A), R3.2
unnamed: C20.1, U2.25 (VCOM)
unnamed: C28.1, R5.2, U3.3 (+)
unnamed: C27.2, R9.1, U3.1, U3.2 (-)
unnamed: C30.1, R7.2, U3.5 (+)
unnamed: C29.2, R8.1, U3.6 (-), U3.7
unnamed: C32.1, R11.2, U4.3 (+)
unnamed: C31.2, R12.1, U4.1, U4.2 (-)
unnamed: C34.1, R14.2, U4.5 (+)
unnamed: C33.2, R15.1, U4.6 (-), U4.7
unnamed: C36.1, R17.2, U5.3 (+)
unnamed: C35.2, R20.1, U5.1, U5.2 (-)
unnamed: C37.1, R19.2, U5.5 (+)
unnamed: C38.2, R21.1, U5.6 (-), U5.7
OUT1: J4.2, R9.2
OUT2: J10.2, R8.2
OUT3: J11.2, R12.2
OUT4: J14.2, R15.2
OUT5: J15.2, R20.2
OUT6: J16.2, R21.2
SCL: J7.1, J20.1, U2.3 (MC/SCL/DEMP)
SCLK: J19.1, U2.5 (SCK)
SDA: J7.2, J20.2, U2.4 (MD/SDA/MUTE)
ZR1: U2.1 (ZR1/ZR1/FMT0)
ZR2: U2.28 (ZR2)

Notes on the sheet:
MOUNTING HOLES
TEST POINTS

Board: 2 copper layers, 87 parts (0 on the bottom side), 53 nets, no tracks yet.
