duanestorey/hifi-amp/pcbs/_final_proto/psu-relay/1.0/relay.kicad_pcb

## KiCad design pcbs/_final_proto/psu-relay/1.0/relay.kicad_pcb (2025-11-16)

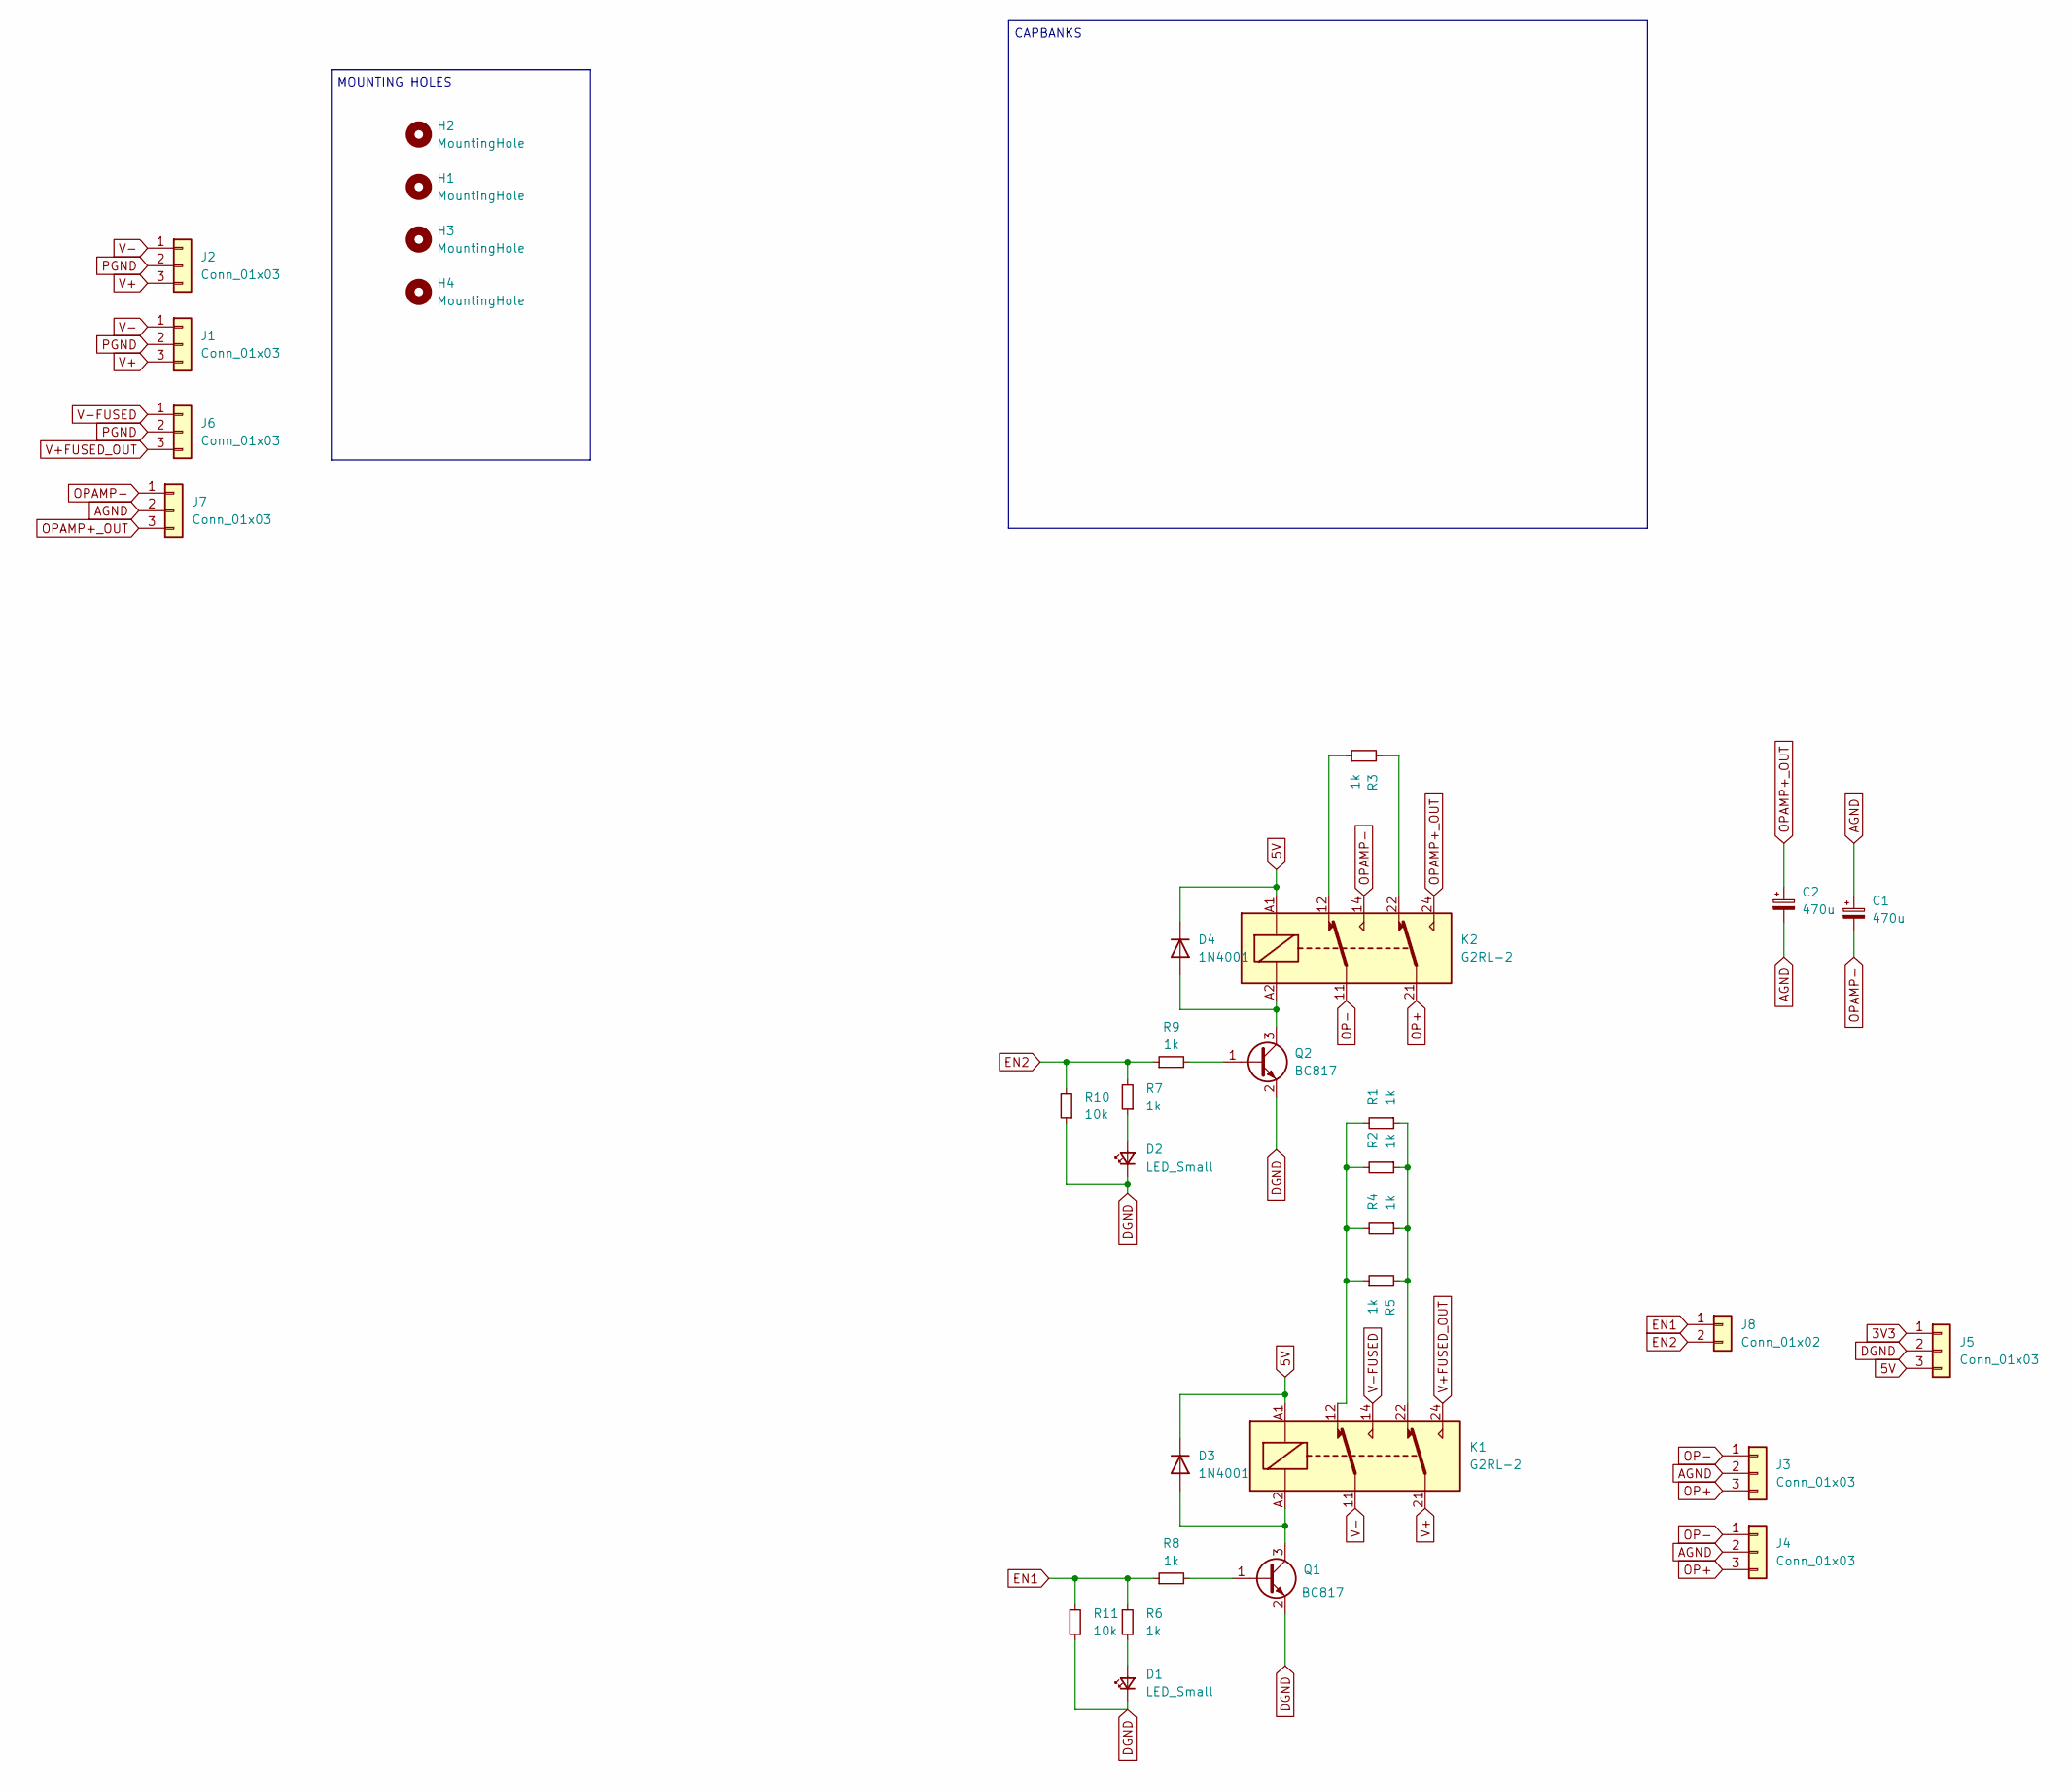
[picture p164: schematic relay.kicad_sch]

Parts:
C1, C2: 470u; CP_Elec_6.3x7.7
D1, D2: LED_Small; LED_0805_2012Metric_Pad_HandSolder_Duane
D3, D4: 1N4001; D_SMA
H1, H2, H3, H4: MountingHole; MountingHole_3.2mm_M3_DIN965_Pad_TopBottom
J1, J2, J6, J7: Conn_01x03; JST_VH_B3P-VH-B_1x03_P3.96mm_Vertical_Duane
J3, J4, J5: Conn_01x03; JST_PH_B3B-PH-K_1x03_P2.00mm_Vertical
J8: Conn_01x02; JST_PH_B2B-PH-K_1x02_P2.00mm_Vertical
K1, K2: G2RL-2; Relay_DPDT_Omron_G2RL-2
Q1, Q2: BC817; SOT-23
R1, R2, R4, R5: 1k; R_2512_6332Metric_Pad1.40x3.35mm_HandSolder
R3: 1k; R_1206_3216Metric_Pad1.30x1.75mm_HandSolder_Duane
R6, R7, R8, R9: 1k; R_0805_2012Metric_Pad1.20x1.40mm_HandSolder_Duane
R10, R11: 10k; R_0805_2012Metric_Pad1.20x1.40mm_HandSolder_Duane

Connections:
3V3: J5.1
5V: D3.1 (K), D4.1 (K), J5.3, K1.A1, K2.A1
AGND: C1.1, C2.2, J3.2, J4.2, J7.2
DGND: D1.1 (K), D2.1 (K), J5.2, Q1.2 (E), Q2.2 (E), R10.1, R11.1
EN1: J8.1, R6.2, R8.1, R11.2
EN2: J8.2, R7.2, R9.1, R10.2
unnamed: D1.2 (A), R6.1
unnamed: D2.2 (A), R7.1
unnamed: D3.2 (A), K1.A2, Q1.3 (C)
unnamed: D4.2 (A), K2.A2, Q2.3 (C)
unnamed: K1.12, R1.2, R2.2, R4.2, R5.1
unnamed: K1.22, R1.1, R2.1, R4.1, R5.2
unnamed: K2.12, R3.1
unnamed: K2.22, R3.2
unnamed: Q1.1 (B), R8.2
unnamed: Q2.1 (B), R9.2
OP+: J3.3, J4.3, K2.21
OP-: J3.1, J4.1, K2.11
OPAMP+_OUT: C2.1, J7.3, K2.24
OPAMP-: C1.2, J7.1, K2.14
PGND: J1.2, J2.2, J6.2
V+: J1.3, J2.3, K1.21
V+FUSED_OUT: J6.3, K1.24
V-: J1.1, J2.1, K1.11
V-FUSED: J6.1, K1.14

Notes on the sheet:
MOUNTING HOLES
CAPBANKS
