duanestorey/hifi-amp/pcbs/_final_proto/psu-relay/1.0/relay.kicad_pcb

## KiCad design pcbs/_final_proto/psu-relay/1.0/relay.kicad_pcb (continued)

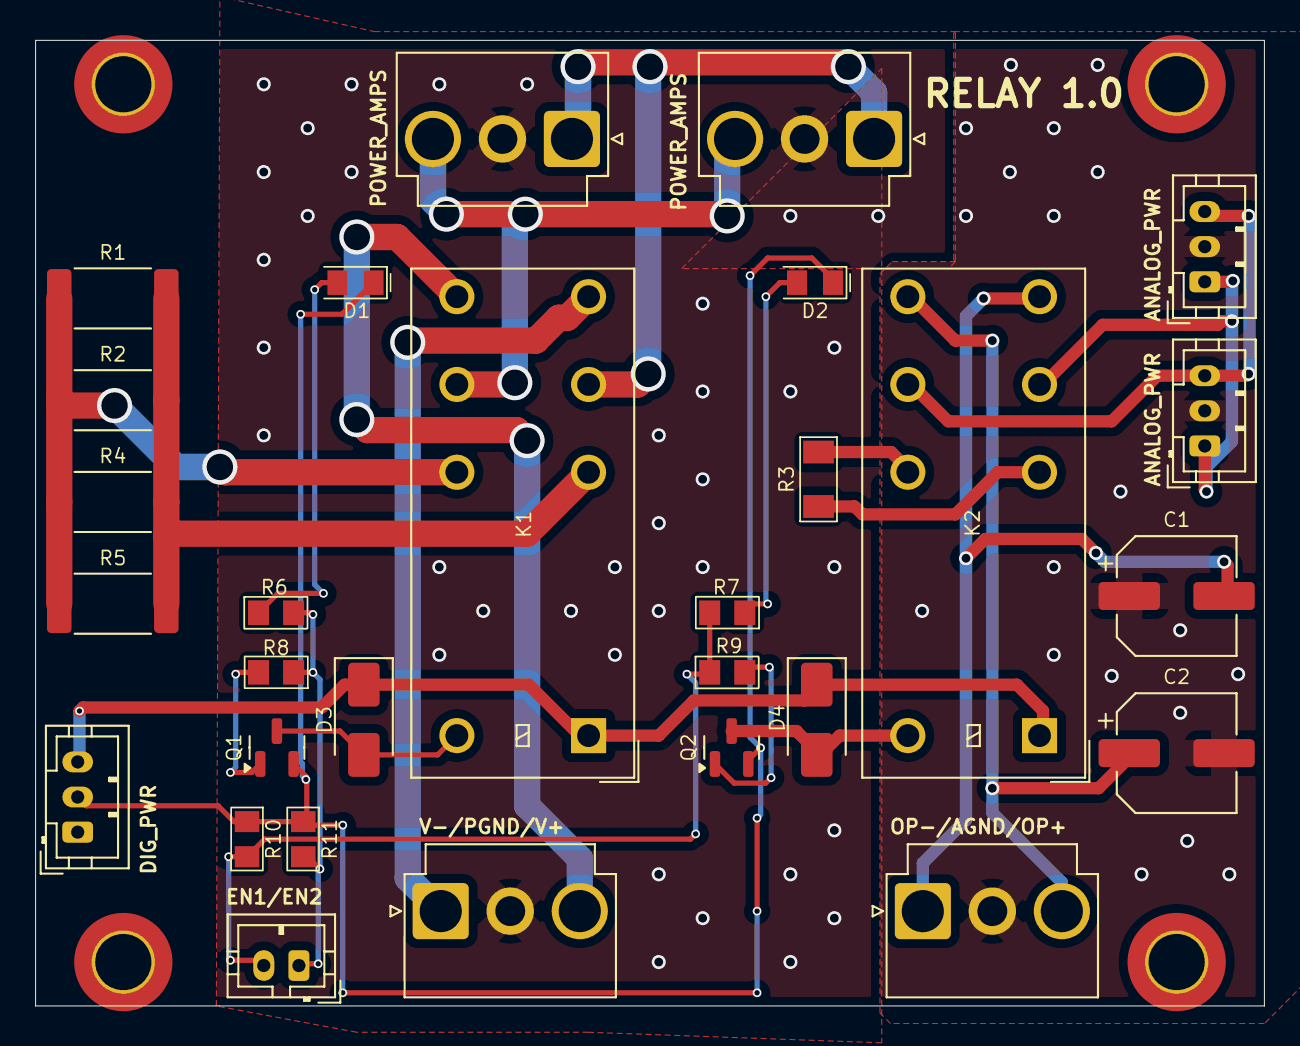
[picture p165: board pcbs/_final_proto/psu-relay/1.0/relay.kicad_pcb from above]

Board: 2 copper layers, 70.0 x 55.0 mm, 33 parts (0 on the bottom side), 24 nets.
