duanestorey/hifi-amp/pcbs/_final_proto/_archived/psu_rect_power/rectifier.kicad_pcb

## KiCad design pcbs/_final_proto/_archived/psu_rect_power/rectifier.kicad_pcb (2025-10-22, an earlier design)

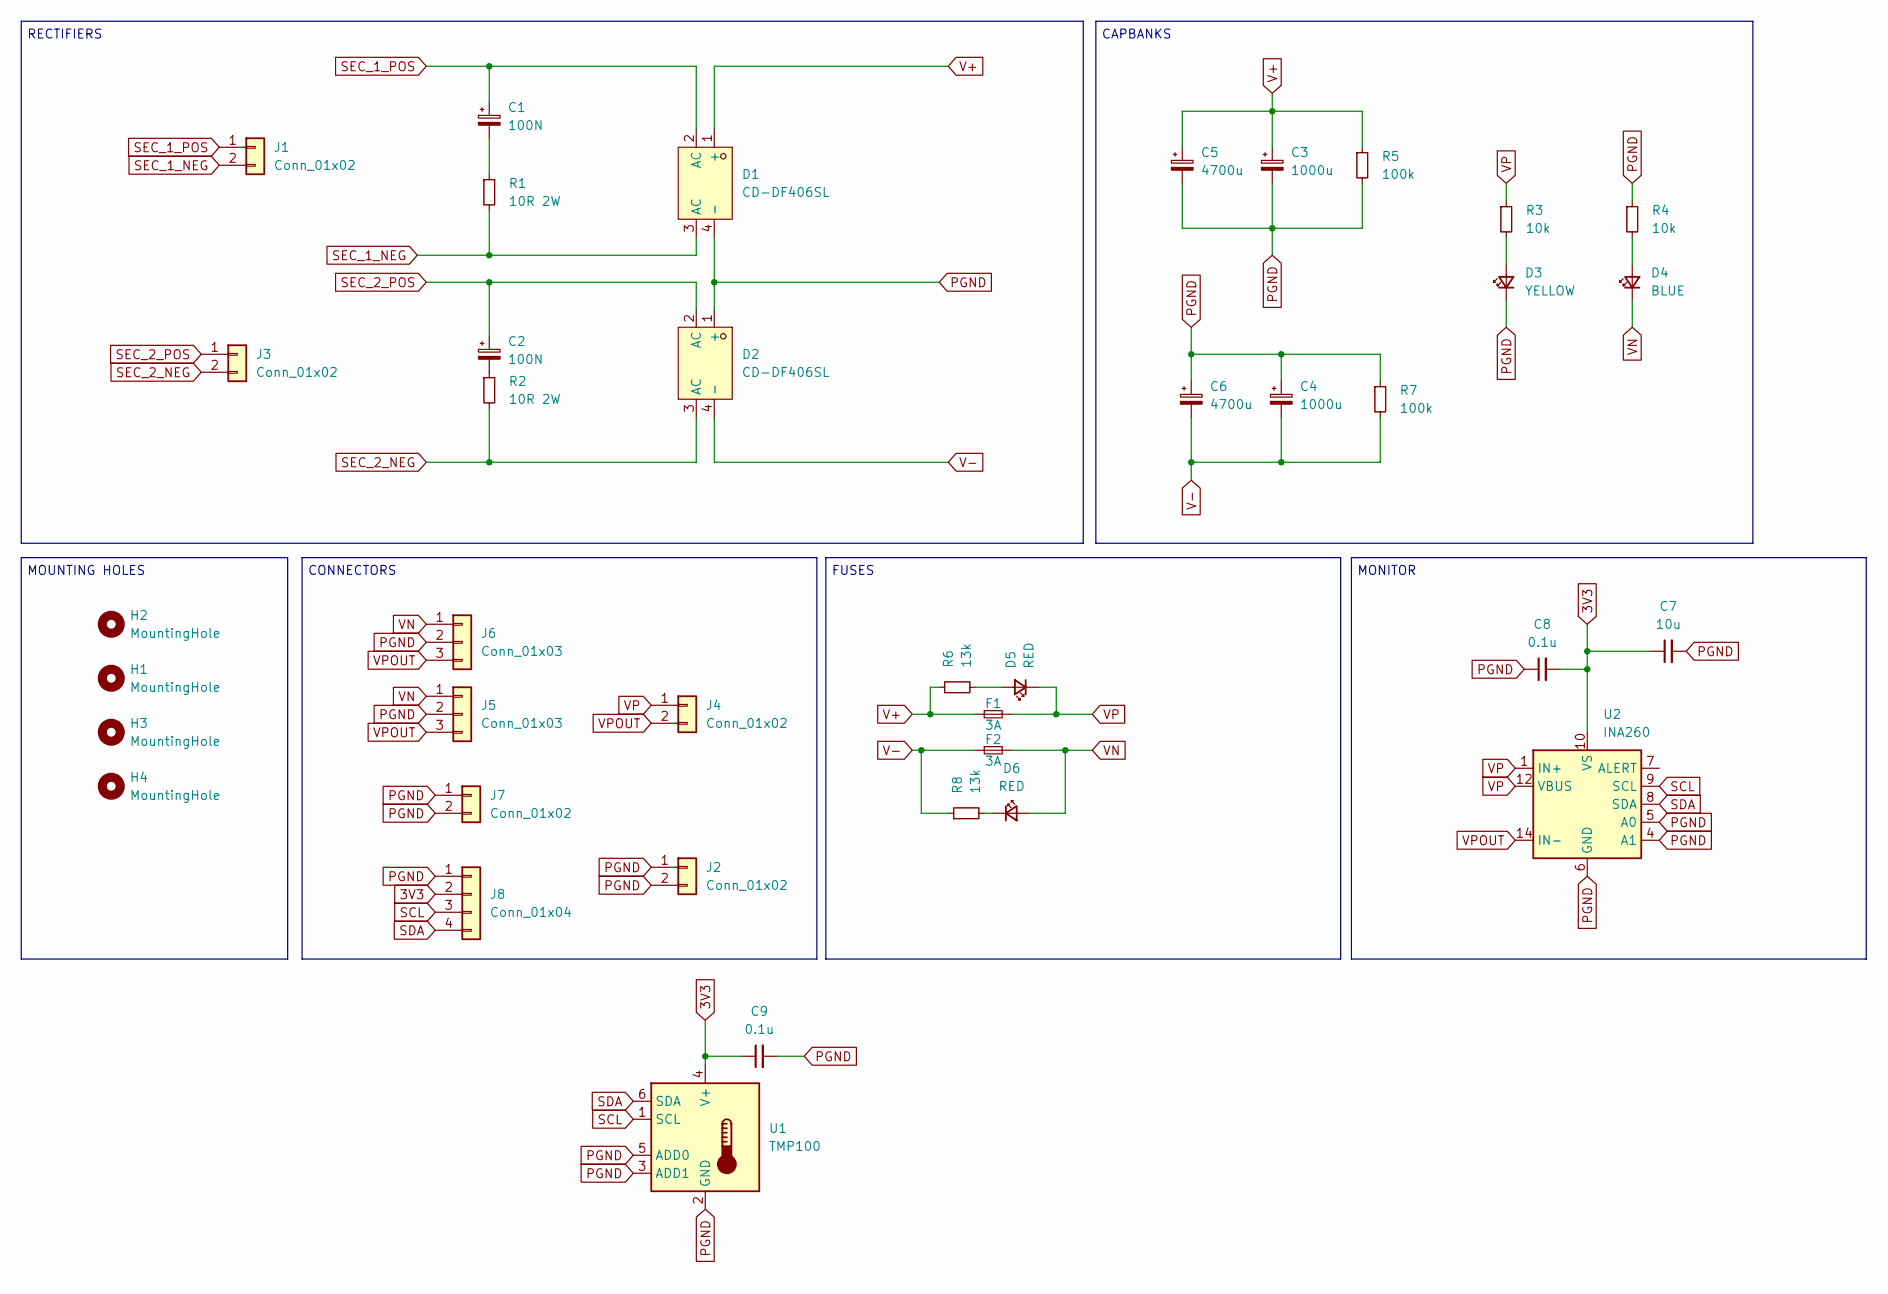
[picture p166: schematic rectifier.kicad_sch]

Parts:
C1, C2: 100N; C_Rect_L10.3mm_W4.5mm_P7.50mm_MKS4; Mouser MKP4F031002D00KF00
C3, C4: 1000u; CP_Radial_D12.5mm_P5.00mm
C5, C6: 4700u; CP_Radial_D18.0mm_P7.50mm
C7: 10u; C_1206_3216Metric_Pad1.33x1.80mm_HandSolder
C8, C9: 0.1u; C_0805_2012Metric_Pad1.18x1.45mm_HandSolder_Duane
D1, D2: CD-DF406SL; Z4-D_4P-L10.5-W8.1-P5.08-TL; LCSC Part C17188088
D3: YELLOW; LED_0805_2012Metric_Pad1.15x1.40mm_HandSolder
D4: BLUE; LED_0805_2012Metric_Pad1.15x1.40mm_HandSolder
D5, D6: RED; LED_0805_2012Metric_Pad1.15x1.40mm_HandSolder
F1, F2: 3A; Fuse_1812_AliExpress
H1, H2, H3, H4: MountingHole; MountingHole_3.2mm_M3_DIN965_Pad_TopBottom
J1, J2, J3: Conn_01x02; TerminalBlock_Phoenix_PT-1,5-2-3.5-H_1x02_P3.50mm_Horizontal
J4: Conn_01x02; PinHeader_1x02_P2.54mm_Vertical
J5, J6: Conn_01x03; JST_VH_B3P-VH_1x03_P3.96mm_Vertical
J7: Conn_01x02; JST_PH_B2B-PH-K_1x02_P2.00mm_Vertical
J8: Conn_01x04; JST_PH_B4B-PH-K_1x04_P2.00mm_Vertical
R1, R2: 10R 2W; R_2512_6332Metric_Pad1.40x3.35mm_HandSolder; Mouser 603-SR2512JK-7W10RL
R3, R4: 10k; R_0805_2012Metric_Pad1.20x1.40mm_HandSolder; Mouser 603-SR2512JK-7W10RL
R5, R7: 100k; R_0805_2012Metric_Pad1.20x1.40mm_HandSolder; Mouser 603-SR2512JK-7W10RL
R6, R8: 13k; R_0805_2012Metric_Pad1.20x1.40mm_HandSolder; Mouser 603-SR2512JK-7W10RL
U1: TMP100; SOT-23-6
U2: INA260; TSSOP-16_4.4x5mm_P0.65mm

Connections:
3V3: C7.1, C8.2, C9.1, J8.2, U1.4 (V+), U2.10 (VS)
unnamed: C1.2, R1.1
unnamed: C2.2, R2.1
unnamed: D3.2 (A), R3.2
unnamed: D4.2 (A), R4.2
unnamed: D5.2 (A), R6.2
unnamed: D6.1 (K), R8.2
PGND: C3.2, C4.1, C5.2, C6.1, C7.2, C8.1, C9.2, D1.4 (-), D2.1 (+), D3.1 (K), J2.1, J2.2, J5.2, J6.2, J7.1, J7.2, J8.1, R4.1, R5.2, R7.1, U1.2 (GND), U1.3 (ADD1), U1.5 (ADD0), U2.4 (A1), U2.5 (A0), U2.6 (GND), U2.11 (GND)
SCL: J8.3, U1.1 (SCL), U2.9 (SCL)
SDA: J8.4, U1.6 (SDA), U2.8 (SDA)
SEC_1_NEG: D1.3 (AC), J1.2, R1.2
SEC_1_POS: C1.1, D1.2 (AC), J1.1
SEC_2_NEG: D2.3 (AC), J3.2, R2.2
SEC_2_POS: C2.1, D2.2 (AC), J3.1
V+: C3.1, C5.1, D1.1 (+), F1.1, R5.1, R6.1
V-: C4.2, C6.2, D2.4 (-), F2.1, R7.2, R8.1
VN: D4.1 (K), D6.2 (A), F2.2, J5.1, J6.1
VP: D5.1 (K), F1.2, J4.1, R3.1, U2.1 (IN+), U2.2 (IN+), U2.3 (IN+), U2.12 (VBUS)
VPOUT: J4.2, J5.3, J6.3, U2.14 (IN-), U2.15 (IN-), U2.16 (IN-)

Notes on the sheet:
MOUNTING HOLES
MONITOR
CONNECTORS
RECTIFIERS
CAPBANKS
FUSES

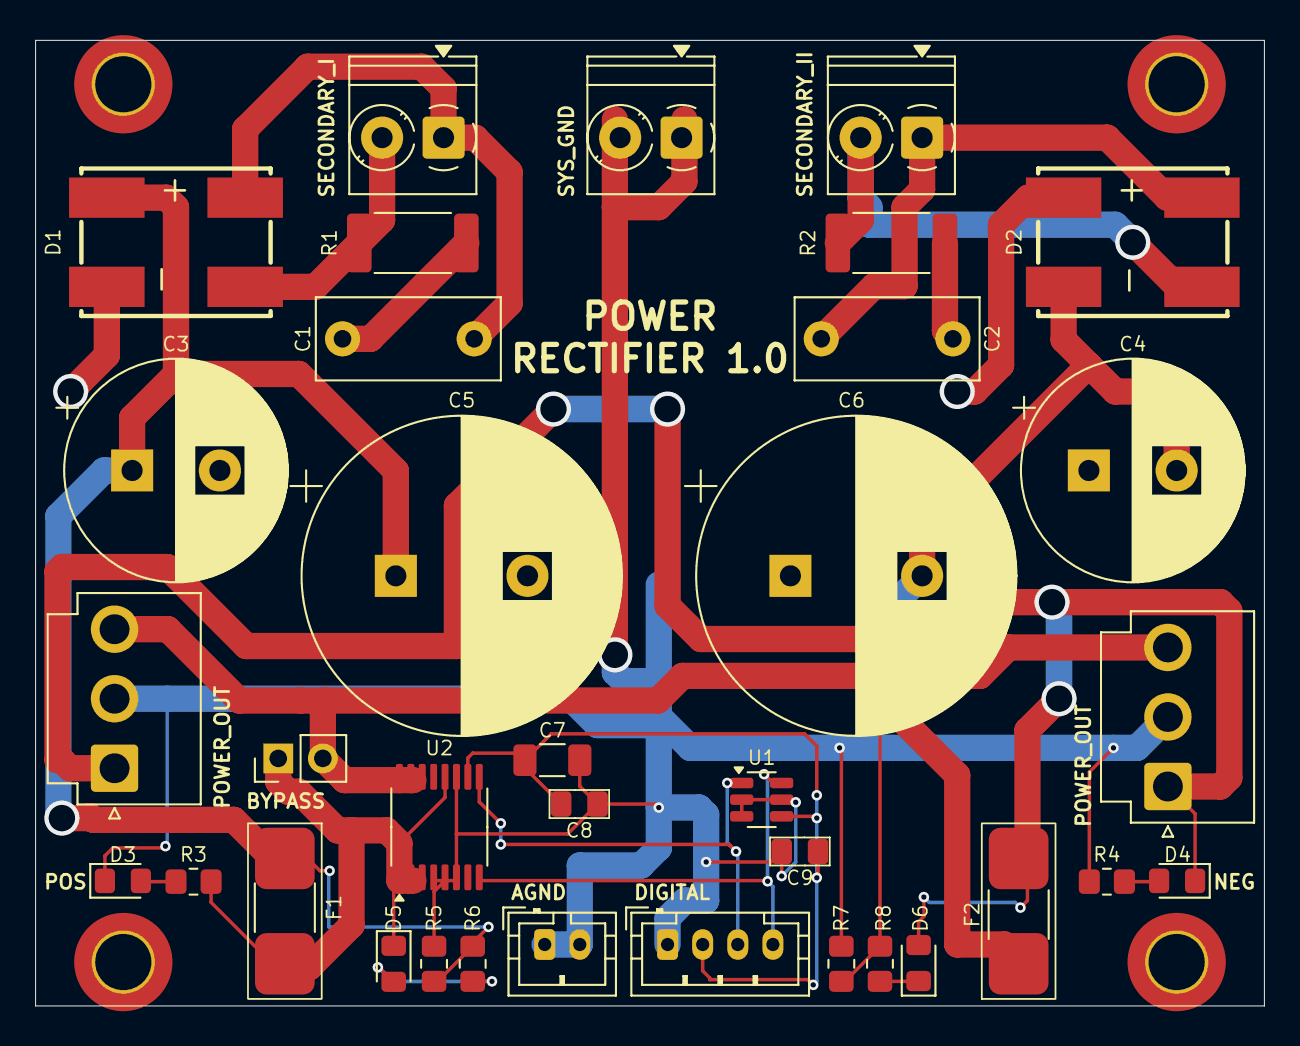
[picture p167: board pcbs/_final_proto/_archived/psu_rect_power/rectifier.kicad_pcb from above]

Board: 2 copper layers, 70.0 x 55.0 mm, 39 parts (0 on the bottom side), 19 nets.
