duanestorey/hifi-amp/pcbs/_final_proto/psu-relay/1.2/relay.kicad_pcb

## KiCad design pcbs/_final_proto/psu-relay/1.2/relay.kicad_pcb (2025-11-16)

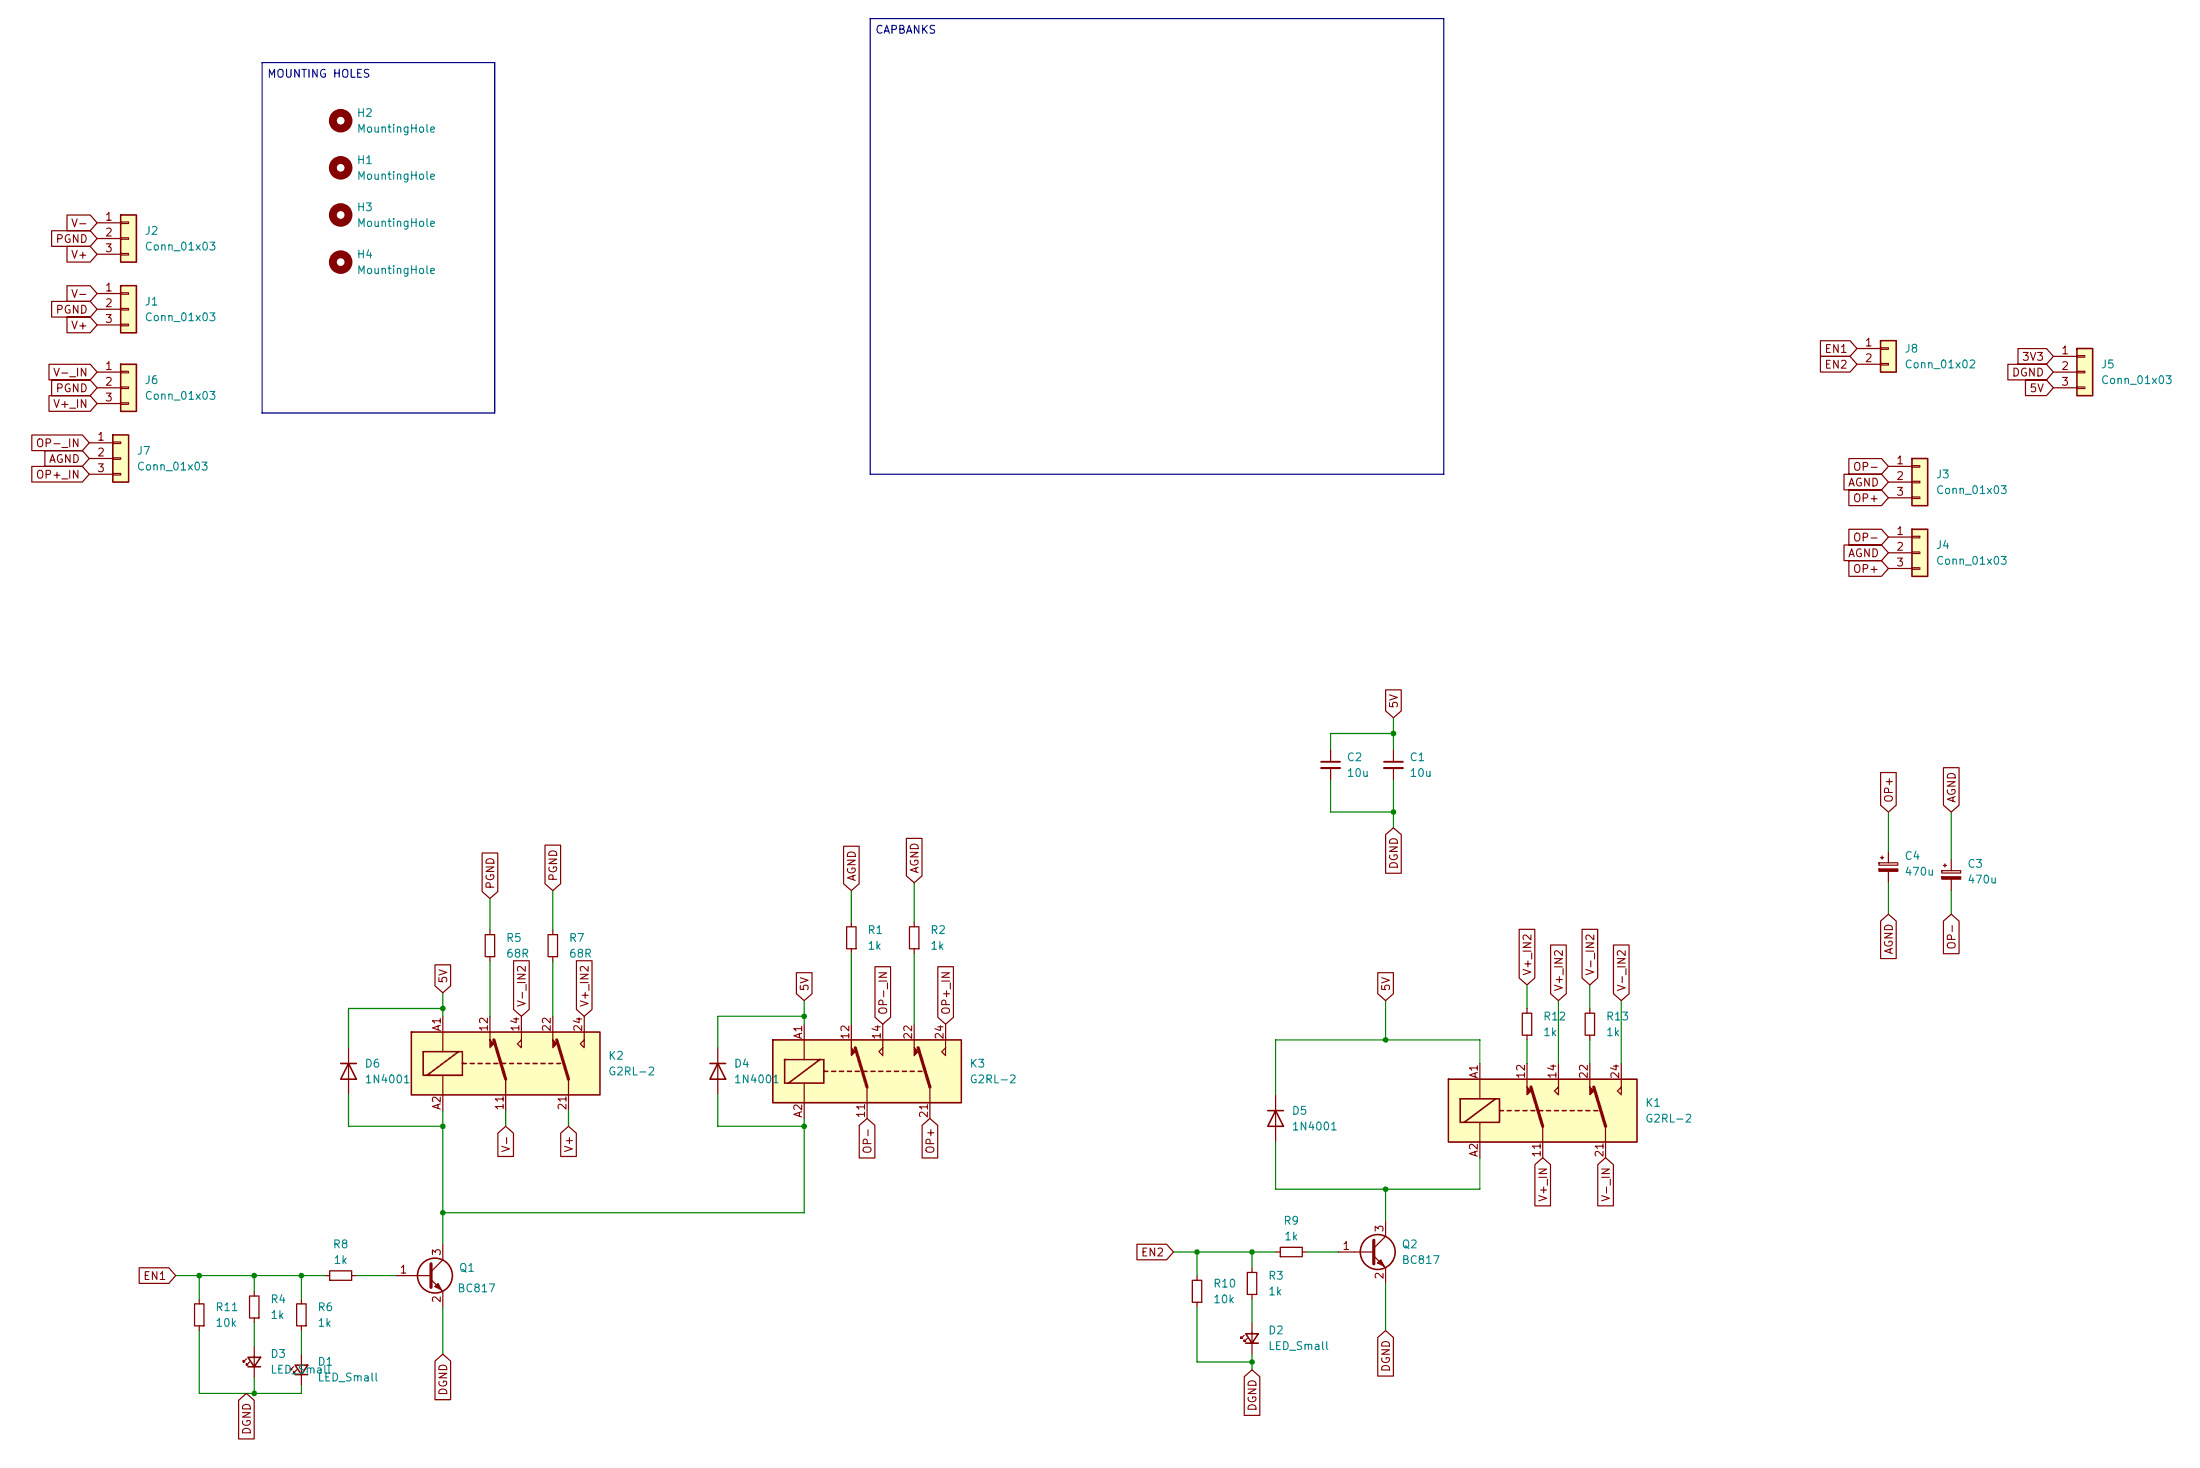
[picture p168: schematic relay.kicad_sch]

Parts:
C1, C2: 10u; C_1206_3216Metric_Pad1.33x1.80mm_HandSolder_Duane
C3, C4: 470u; CP_Elec_6.3x7.7
D1, D2, D3: LED_Small; LED_0805_2012Metric_Pad_HandSolder_Duane
D4, D5, D6: 1N4001; D_SMA
H1, H2, H3, H4: MountingHole; MountingHole_3.2mm_M3_DIN965_Pad_TopBottom
J1, J2, J6, J7: Conn_01x03; JST_VH_B3P-VH-B_1x03_P3.96mm_Vertical_Duane
J3, J4, J5: Conn_01x03; JST_PH_B3B-PH-K_1x03_P2.00mm_Vertical
J8: Conn_01x02; JST_PH_B2B-PH-K_1x02_P2.00mm_Vertical
K1, K2, K3: G2RL-2; Relay_DPDT_Omron_G2RL-2
Q1, Q2: BC817; SOT-23
R1, R2: 1k; R_1206_3216Metric_Pad1.30x1.75mm_HandSolder_Duane
R3, R4, R6, R8, R9: 1k; R_0805_2012Metric_Pad1.20x1.40mm_HandSolder_Duane
R5, R7: 68R; R_2512_6332Metric_Pad1.40x3.35mm_HandSolder; Mouser 279-352268RJT
R10, R11: 10k; R_0805_2012Metric_Pad1.20x1.40mm_HandSolder_Duane
R12, R13: 1k; R_2512_6332Metric_Pad1.40x3.35mm_HandSolder

Connections:
3V3: J5.1
5V: C1.1, C2.1, D4.1 (K), D5.1 (K), D6.1 (K), J5.3, K1.A1, K2.A1, K3.A1
AGND: C3.1, C4.2, J3.2, J4.2, J7.2, R1.2, R2.2
DGND: C1.2, C2.2, D1.1 (K), D2.1 (K), D3.1 (K), J5.2, Q1.2 (E), Q2.2 (E), R10.1, R11.1
EN1: J8.1, R4.2, R6.2, R8.1, R11.2
EN2: J8.2, R3.2, R9.1, R10.2
unnamed: D1.2 (A), R6.1
unnamed: D2.2 (A), R3.1
unnamed: D3.2 (A), R4.1
unnamed: D4.2 (A), D6.2 (A), K2.A2, K3.A2, Q1.3 (C)
unnamed: D5.2 (A), K1.A2, Q2.3 (C)
unnamed: K1.12, R12.1
unnamed: K1.22, R13.1
unnamed: K2.12, R5.1
unnamed: K2.22, R7.1
unnamed: K3.12, R1.1
unnamed: K3.22, R2.1
unnamed: Q1.1 (B), R8.2
unnamed: Q2.1 (B), R9.2
OP+: C4.1, J3.3, J4.3, K3.21
OP+_IN: J7.3, K3.24
OP-: C3.2, J3.1, J4.1, K3.11
OP-_IN: J7.1, K3.14
PGND: J1.2, J2.2, J6.2, R5.2, R7.2
V+: J1.3, J2.3, K2.21
V+_IN: J6.3, K1.11
V+_IN2: K1.14, K2.24, R12.2
V-: J1.1, J2.1, K2.11
V-_IN: J6.1, K1.21
V-_IN2: K1.24, K2.14, R13.2

Notes on the sheet:
MOUNTING HOLES
CAPBANKS

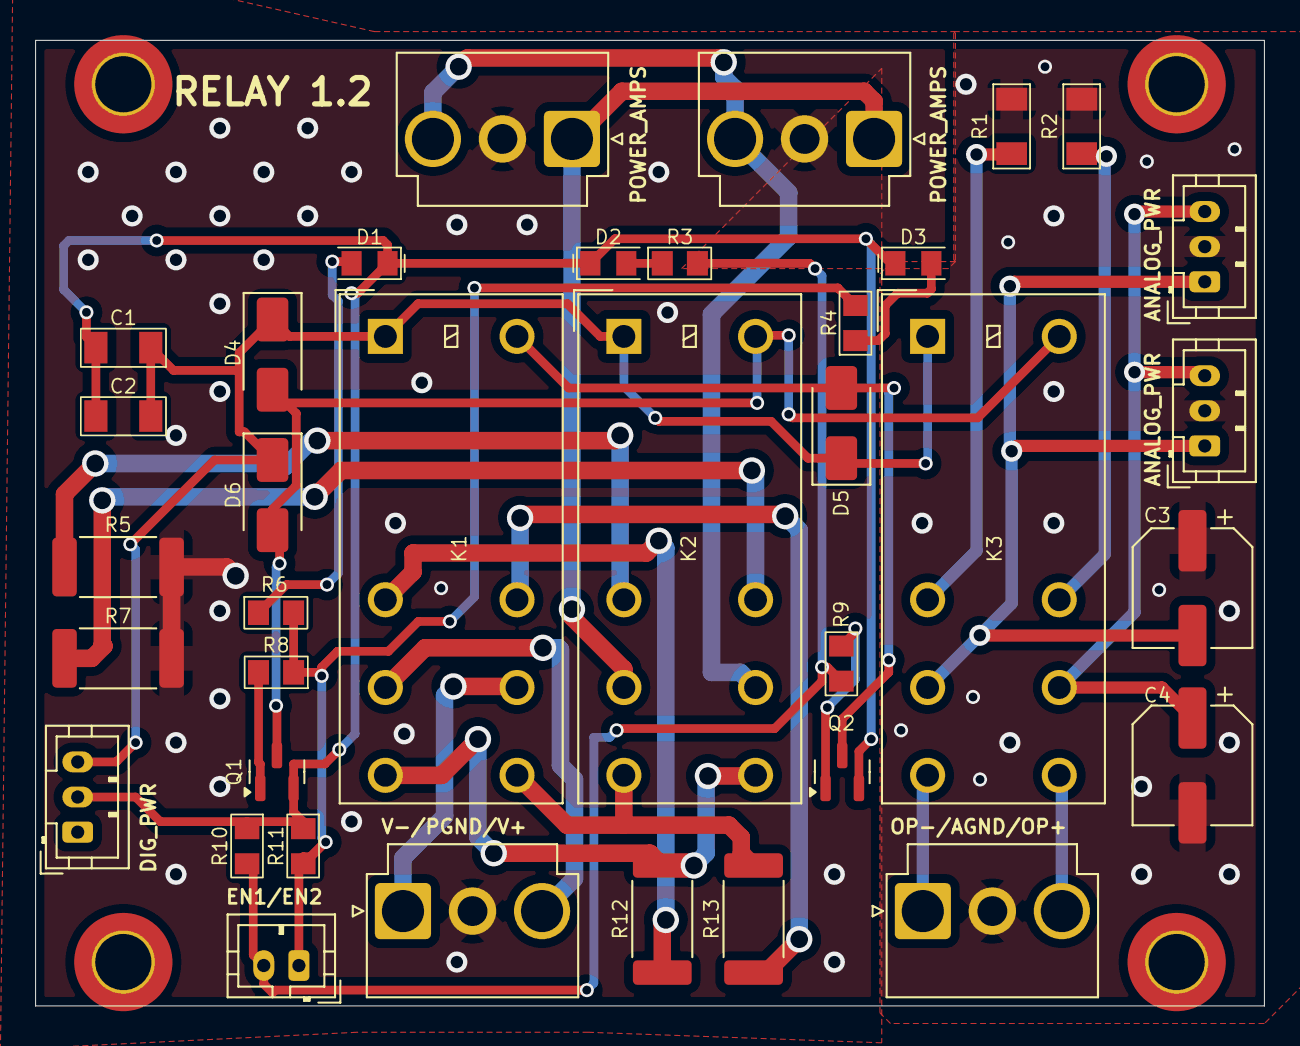
[picture p169: board pcbs/_final_proto/psu-relay/1.2/relay.kicad_pcb from above]

Board: 2 copper layers, 70.0 x 55.0 mm, 40 parts (0 on the bottom side), 29 nets.
