duanestorey/hifi-amp/pcbs/_final_proto/uproc/1.1 /uproc.kicad_pcb

## KiCad design pcbs/_final_proto/uproc/1.1 /uproc.kicad_pcb (2025-11-16)

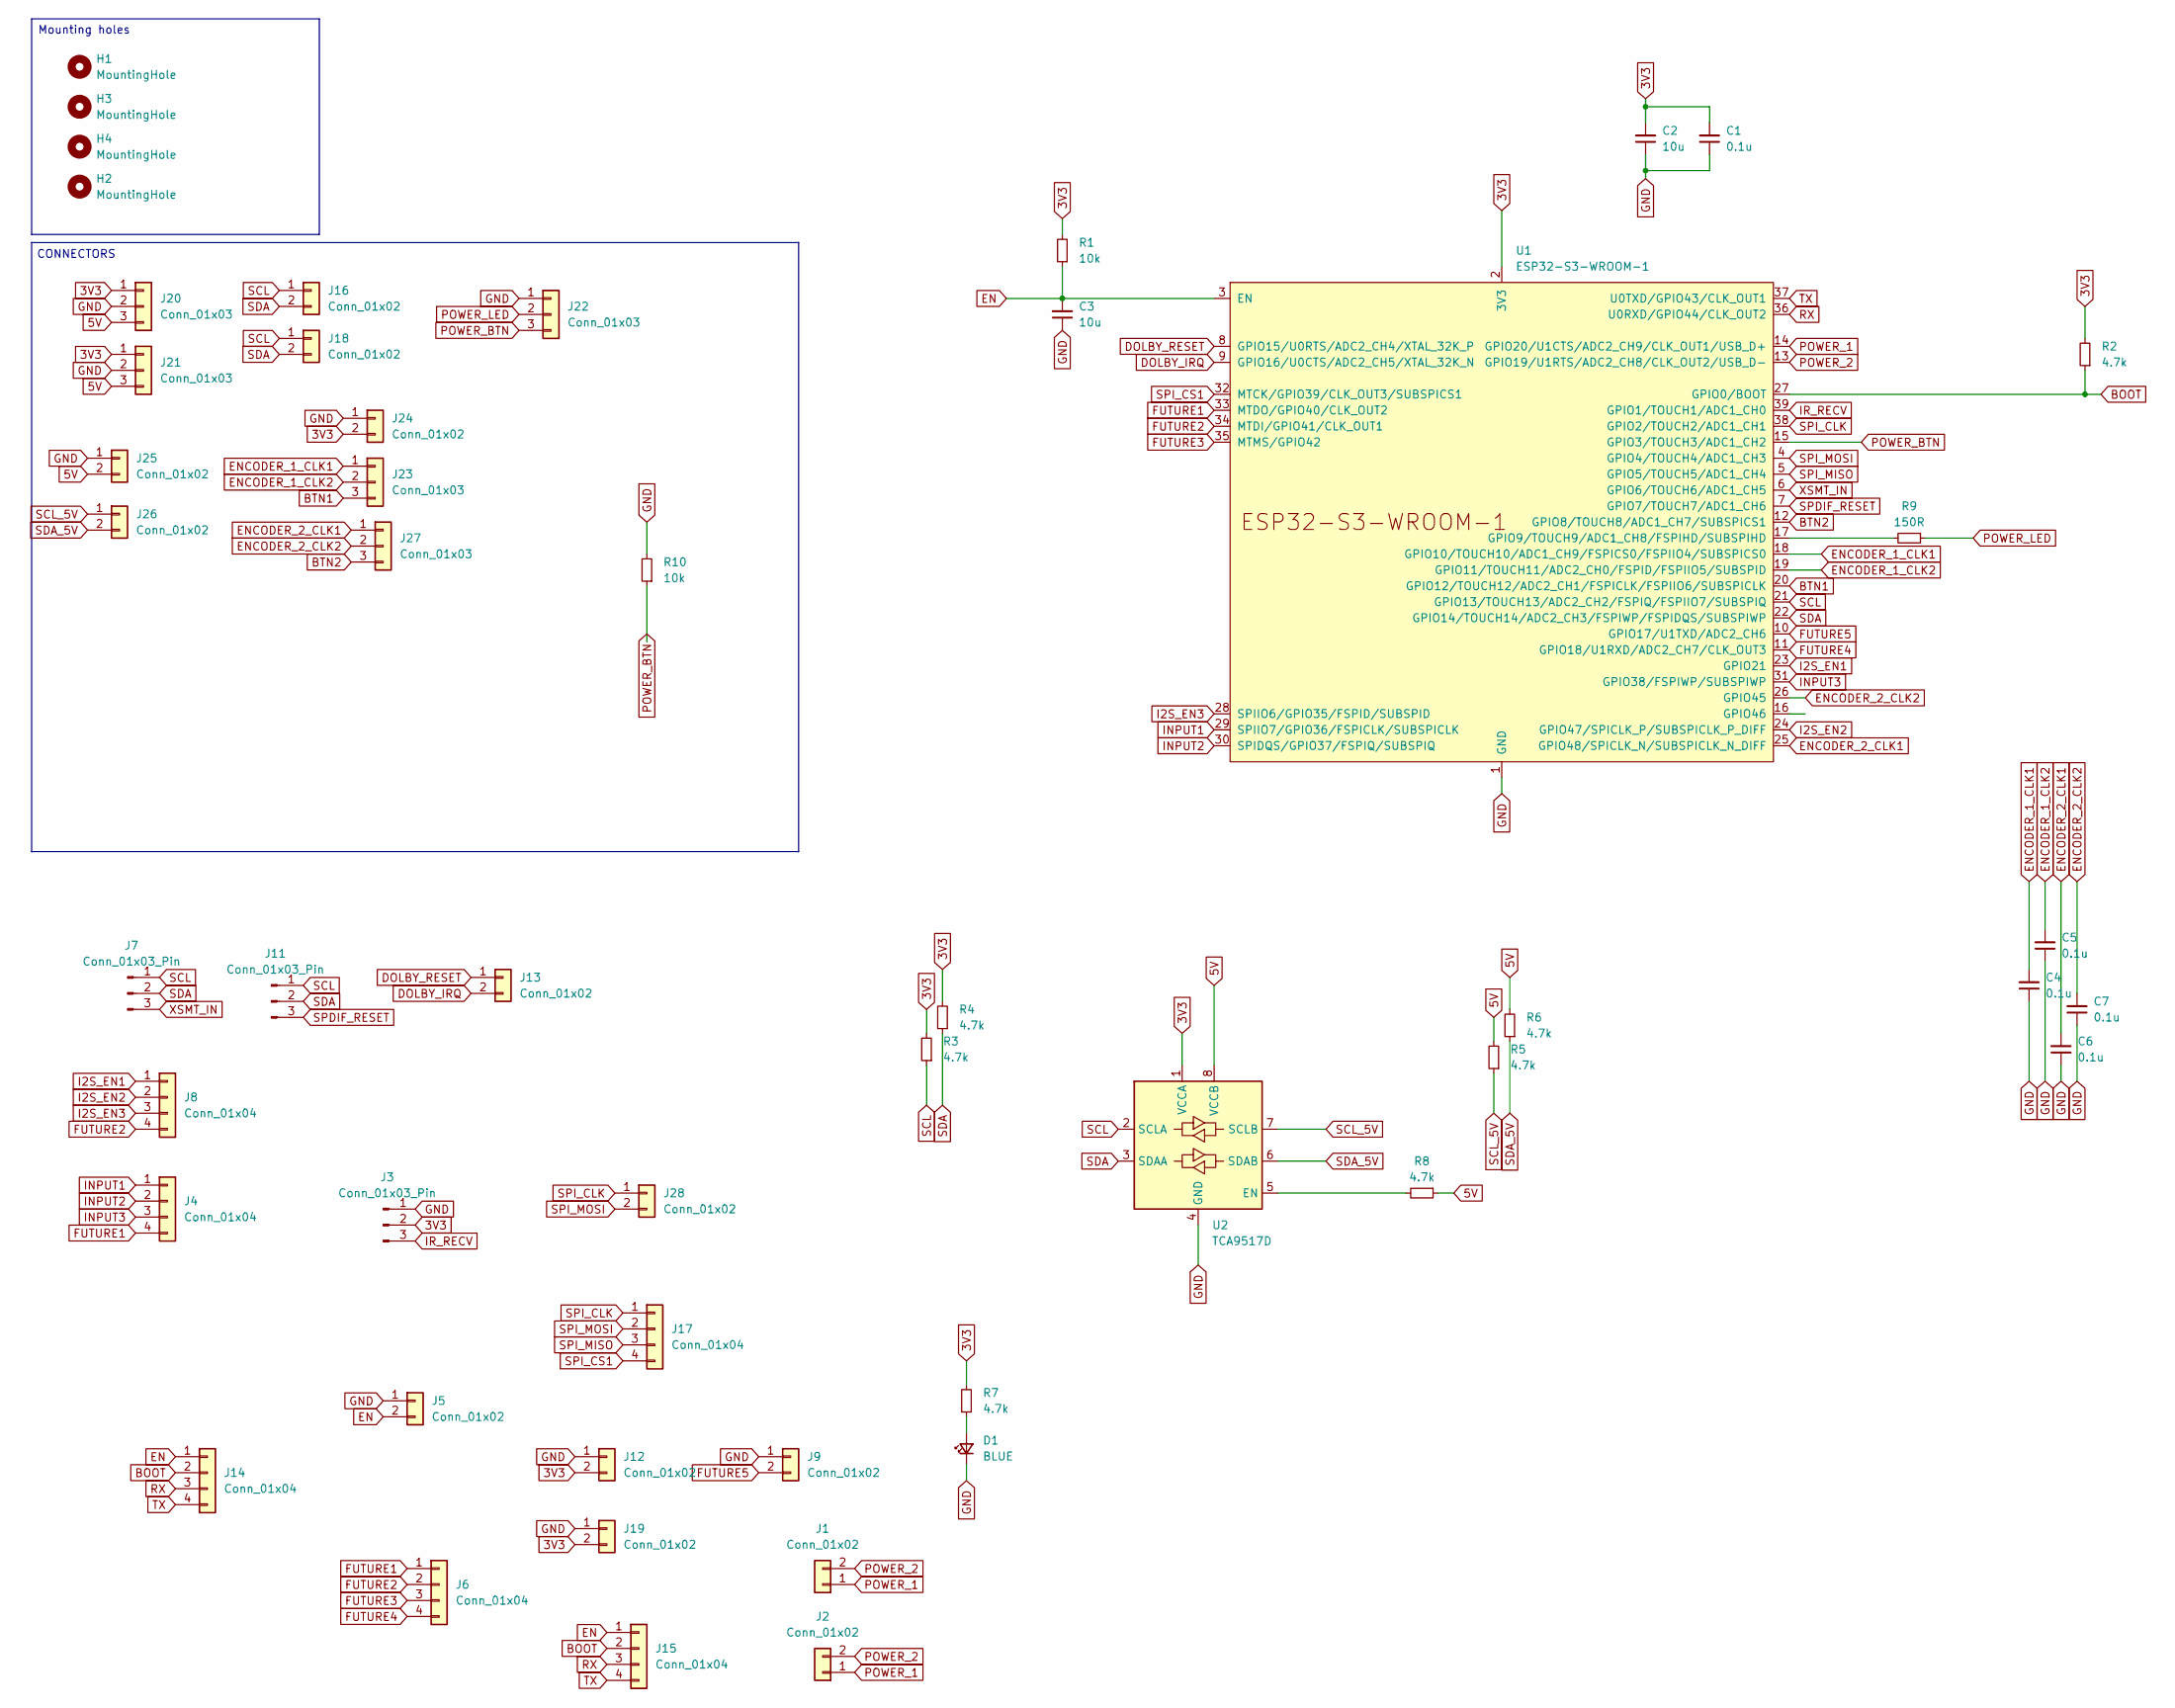
[picture p172: schematic uproc.kicad_sch]

Parts:
C1, C4, C5, C6, C7: 0.1u; C_0805_2012Metric_Pad1.18x1.45mm_HandSolder_Duane
C2, C3: 10u; C_1206_3216Metric_Pad1.33x1.80mm_HandSolder
D1: BLUE; LED_0805_2012Metric_Pad1.15x1.40mm_HandSolder
H1, H2, H3, H4: MountingHole; MountingHole_3.2mm_M3_DIN965_Pad_TopBottom
J1, J9, J12, J19, J28: Conn_01x02; PinHeader_1x02_P2.54mm_Vertical
J2, J5, J13, J16, J18: Conn_01x02; JST_PH_B2B-PH-K_1x02_P2.00mm_Vertical
J3, J7, J11: Conn_01x03_Pin; JST_PH_B3B-PH-K_1x03_P2.00mm_Vertical
J4, J8, J14, J17: Conn_01x04; JST_PH_B4B-PH-K_1x04_P2.00mm_Vertical
J6, J15: Conn_01x04; PinHeader_1x04_P2.54mm_Vertical
J20, J21: Conn_01x03; JST_PH_B3B-PH-K_1x03_P2.00mm_Vertical
J22, J23, J27: Conn_01x03; TerminalBlock_Phoenix_PT-1,5-3-3.5-H_1x03_P3.50mm_Horizontal
J24, J25, J26: Conn_01x02; TerminalBlock_Phoenix_PT-1,5-2-3.5-H_1x02_P3.50mm_Horizontal
R1, R10: 10k; R_0805_2012Metric_Pad1.20x1.40mm_HandSolder_Duane
R2, R3, R4, R5, R6, R7, R8: 4.7k; R_0805_2012Metric_Pad1.20x1.40mm_HandSolder_Duane
R9: 150R; R_0805_2012Metric_Pad1.20x1.40mm_HandSolder_Duane
U1: ESP32-S3-WROOM-1
U2: TCA9517D; SOIC-8_3.9x4.9mm_P1.27mm

Connections:
3V3: C1.2, C2.2, J3.2, J12.2, J19.2, J20.1, J21.1, J24.2, R1.2, R2.2, R3.2, R4.2, R7.2, U1.2 (3V3), U2.1 (VCCA)
5V: J20.3, J21.3, J25.2, R5.2, R6.2, R8.1, U2.8 (VCCB)
BOOT: J14.2, J15.2, R2.1, U1.27 (GPIO0/BOOT)
BTN1: J23.3, U1.20 (GPIO12/TOUCH12/ADC2_CH1/FSPICLK/FSPIIO6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)
BTN2: J27.3, U1.12 (GPIO8/TOUCH8/ADC1_CH7/SUBSPICS1)
DOLBY_IRQ: J13.2, U1.9 (GPIO16/U0CTS/ADC2_CH5/XTAL_32K_N)
DOLBY_RESET: J13.1, U1.8 (GPIO15/U0RTS/ADC2_CH4/XTAL_32K_P)
EN: C3.2, J5.2, J14.1, J15.1, R1.1, U1.3 (EN)
ENCODER_1_CLK1: C4.2, J23.1, U1.18 (GPIO10/TOUCH10/ADC1_CH9/FSPICS0/FSPIIO4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)
ENCODER_1_CLK2: C5.2, J23.2, U1.19 (GPIO11/TOUCH11/ADC2_CH0/FSPID/FSPIIO5/S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)
ENCODER_2_CLK1: C6.2, J27.1, U1.25 (GPIO48/SPICLK_N/SUBSPICLK_N_DIFF)
ENCODER_2_CLK2: C7.2, J27.2, U1.26 (GPIO45)
FUTURE1: J4.4, J6.1, U1.33 (MTDO/GPIO40/CLK_OUT2)
FUTURE2: J6.2, J8.4, U1.34 (MTDI/GPIO41/CLK_OUT1)
FUTURE3: J6.3, U1.35 (MTMS/GPIO42)
FUTURE4: J6.4, U1.11 (GPIO18/U1RXD/ADC2_CH7/CLK_OUT3)
FUTURE5: J9.2, U1.10 (GPIO17/U1TXD/ADC2_CH6)
GND: C1.1, C2.1, C3.1, C4.1, C5.1, C6.1, C7.1, D1.1 (K), J3.1, J5.1, J9.1, J12.1, J19.1, J20.2, J21.2, J22.1, J24.1, J25.1, R10.2, U1.1 (GND), U1.40 (GND), U1.41 (GND), U2.4 (GND)
I2S_EN1: J8.1, U1.23 (GPIO21)
I2S_EN2: J8.2, U1.24 (GPIO47/SPICLK_P/SUBSPICLK_P_DIFF)
I2S_EN3: J8.3, U1.28 (SPIIO6/GPIO35/FSPID/SUBSPID)
INPUT1: J4.1, U1.29 (SPIIO7/GPIO36/FSPICLK/SUBSPICLK)
INPUT2: J4.2, U1.30 (SPIDQS/GPIO37/FSPIQ/SUBSPIQ)
INPUT3: J4.3, U1.31 (GPIO38/FSPIWP/SUBSPIWP)
IR_RECV: J3.3, U1.39 (GPIO1/TOUCH1/ADC1_CH0)
unnamed: D1.2 (A), R7.1
unnamed: R9.2, U1.17 (GPIO9/TOUCH9/ADC1_CH8/FSPIHD/SUBSPIHD)
unnamed: R8.2, U2.5 (EN)
POWER_1: J1.1, J2.1, U1.14 (GPIO20/U1CTS/ADC2_CH9/CLK_OUT1/USB_D+)
POWER_2: J1.2, J2.2, U1.13 (GPIO19/U1RTS/ADC2_CH8/CLK_OUT2/USB_D-)
POWER_BTN: J22.3, R10.1, U1.15 (GPIO3/TOUCH3/ADC1_CH2)
POWER_LED: J22.2, R9.1
RX: J14.3, J15.3, U1.36 (U0RXD/GPIO44/CLK_OUT2)
SCL: J7.1, J11.1, J16.1, J18.1, R3.1, U1.21 (GPIO13/TOUCH13/ADC2_CH2/FSPIQ/FSPIIO7/S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), U2.2 (SCLA)
SCL_5V: J26.1, R5.1, U2.7 (SCLB)
SDA: J7.2, J11.2, J16.2, J18.2, R4.1, U1.22 (GPIO14/TOUCH14/ADC2_CH3/FSPIWP/FSPIDQS/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), U2.3 (SDAA)
SDA_5V: J26.2, R6.1, U2.6 (SDAB)
SPDIF_RESET: J11.3, U1.7 (GPIO7/TOUCH7/ADC1_CH6)
SPI_CLK: J17.1, J28.1, U1.38 (GPIO2/TOUCH2/ADC1_CH1)
SPI_CS1: J17.4, U1.32 (MTCK/GPIO39/CLK_OUT3/SUBSPICS1)
SPI_MISO: J17.3, U1.5 (GPIO5/TOUCH5/ADC1_CH4)
SPI_MOSI: J17.2, J28.2, U1.4 (GPIO4/TOUCH4/ADC1_CH3)
TX: J14.4, J15.4, U1.37 (U0TXD/GPIO43/CLK_OUT1)
XSMT_IN: J7.3, U1.6 (GPIO6/TOUCH6/ADC1_CH5)

Notes on the sheet:
CONNECTORS
Mounting holes

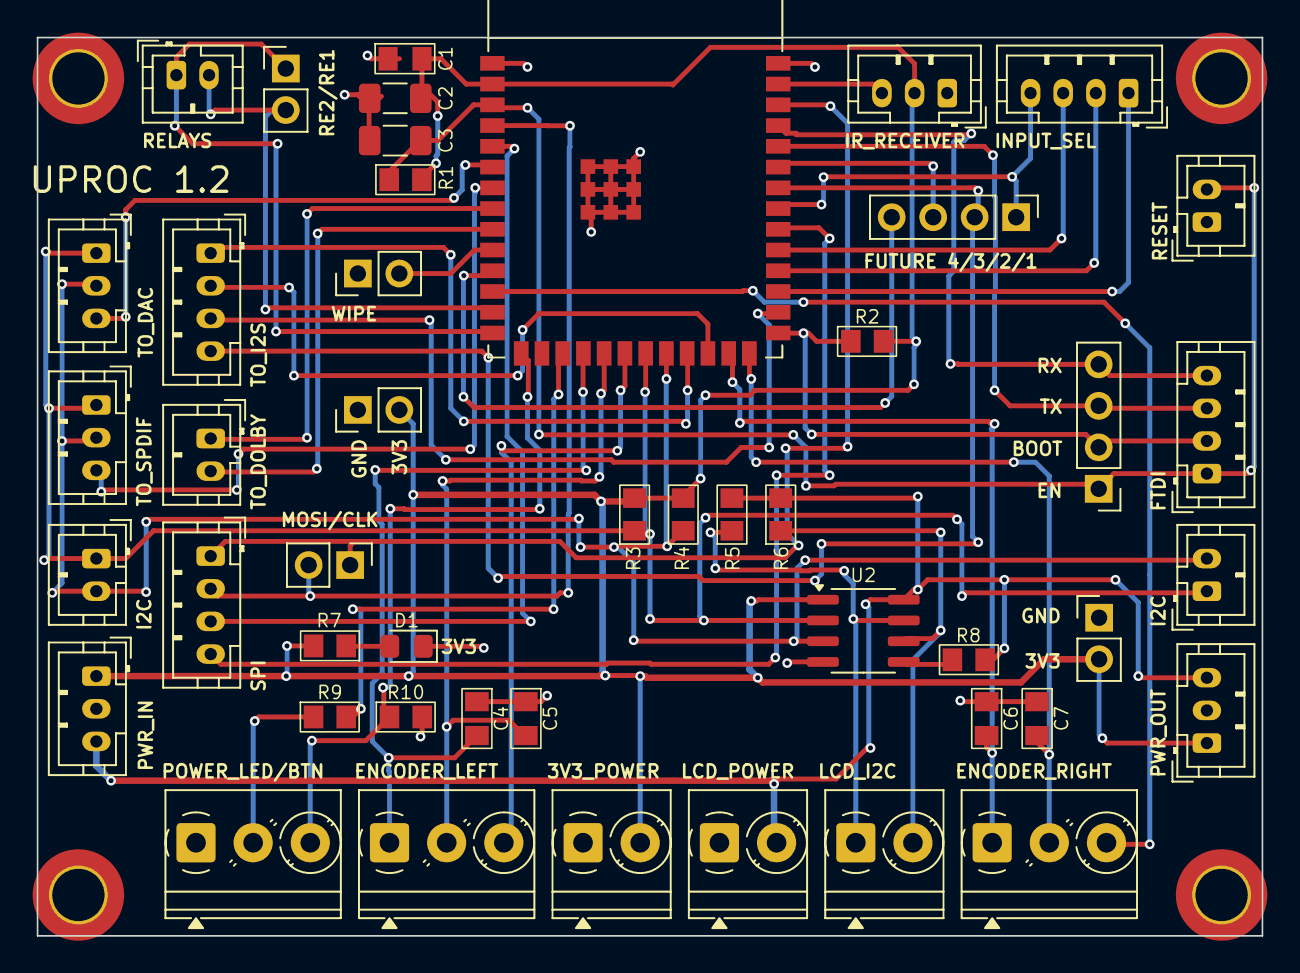
[picture p173: board uproc.kicad_pcb from above]

Board: 2 copper layers, 75.0 x 55.0 mm, 51 parts (0 on the bottom side), 44 nets.
