duanestorey/hifi-amp/pcbs/_final_proto/spdif-wm8805/1.0/SPDIF.kicad_pcb

## KiCad design pcbs/_final_proto/spdif-wm8805/1.0/SPDIF.kicad_pcb (2025-11-16)

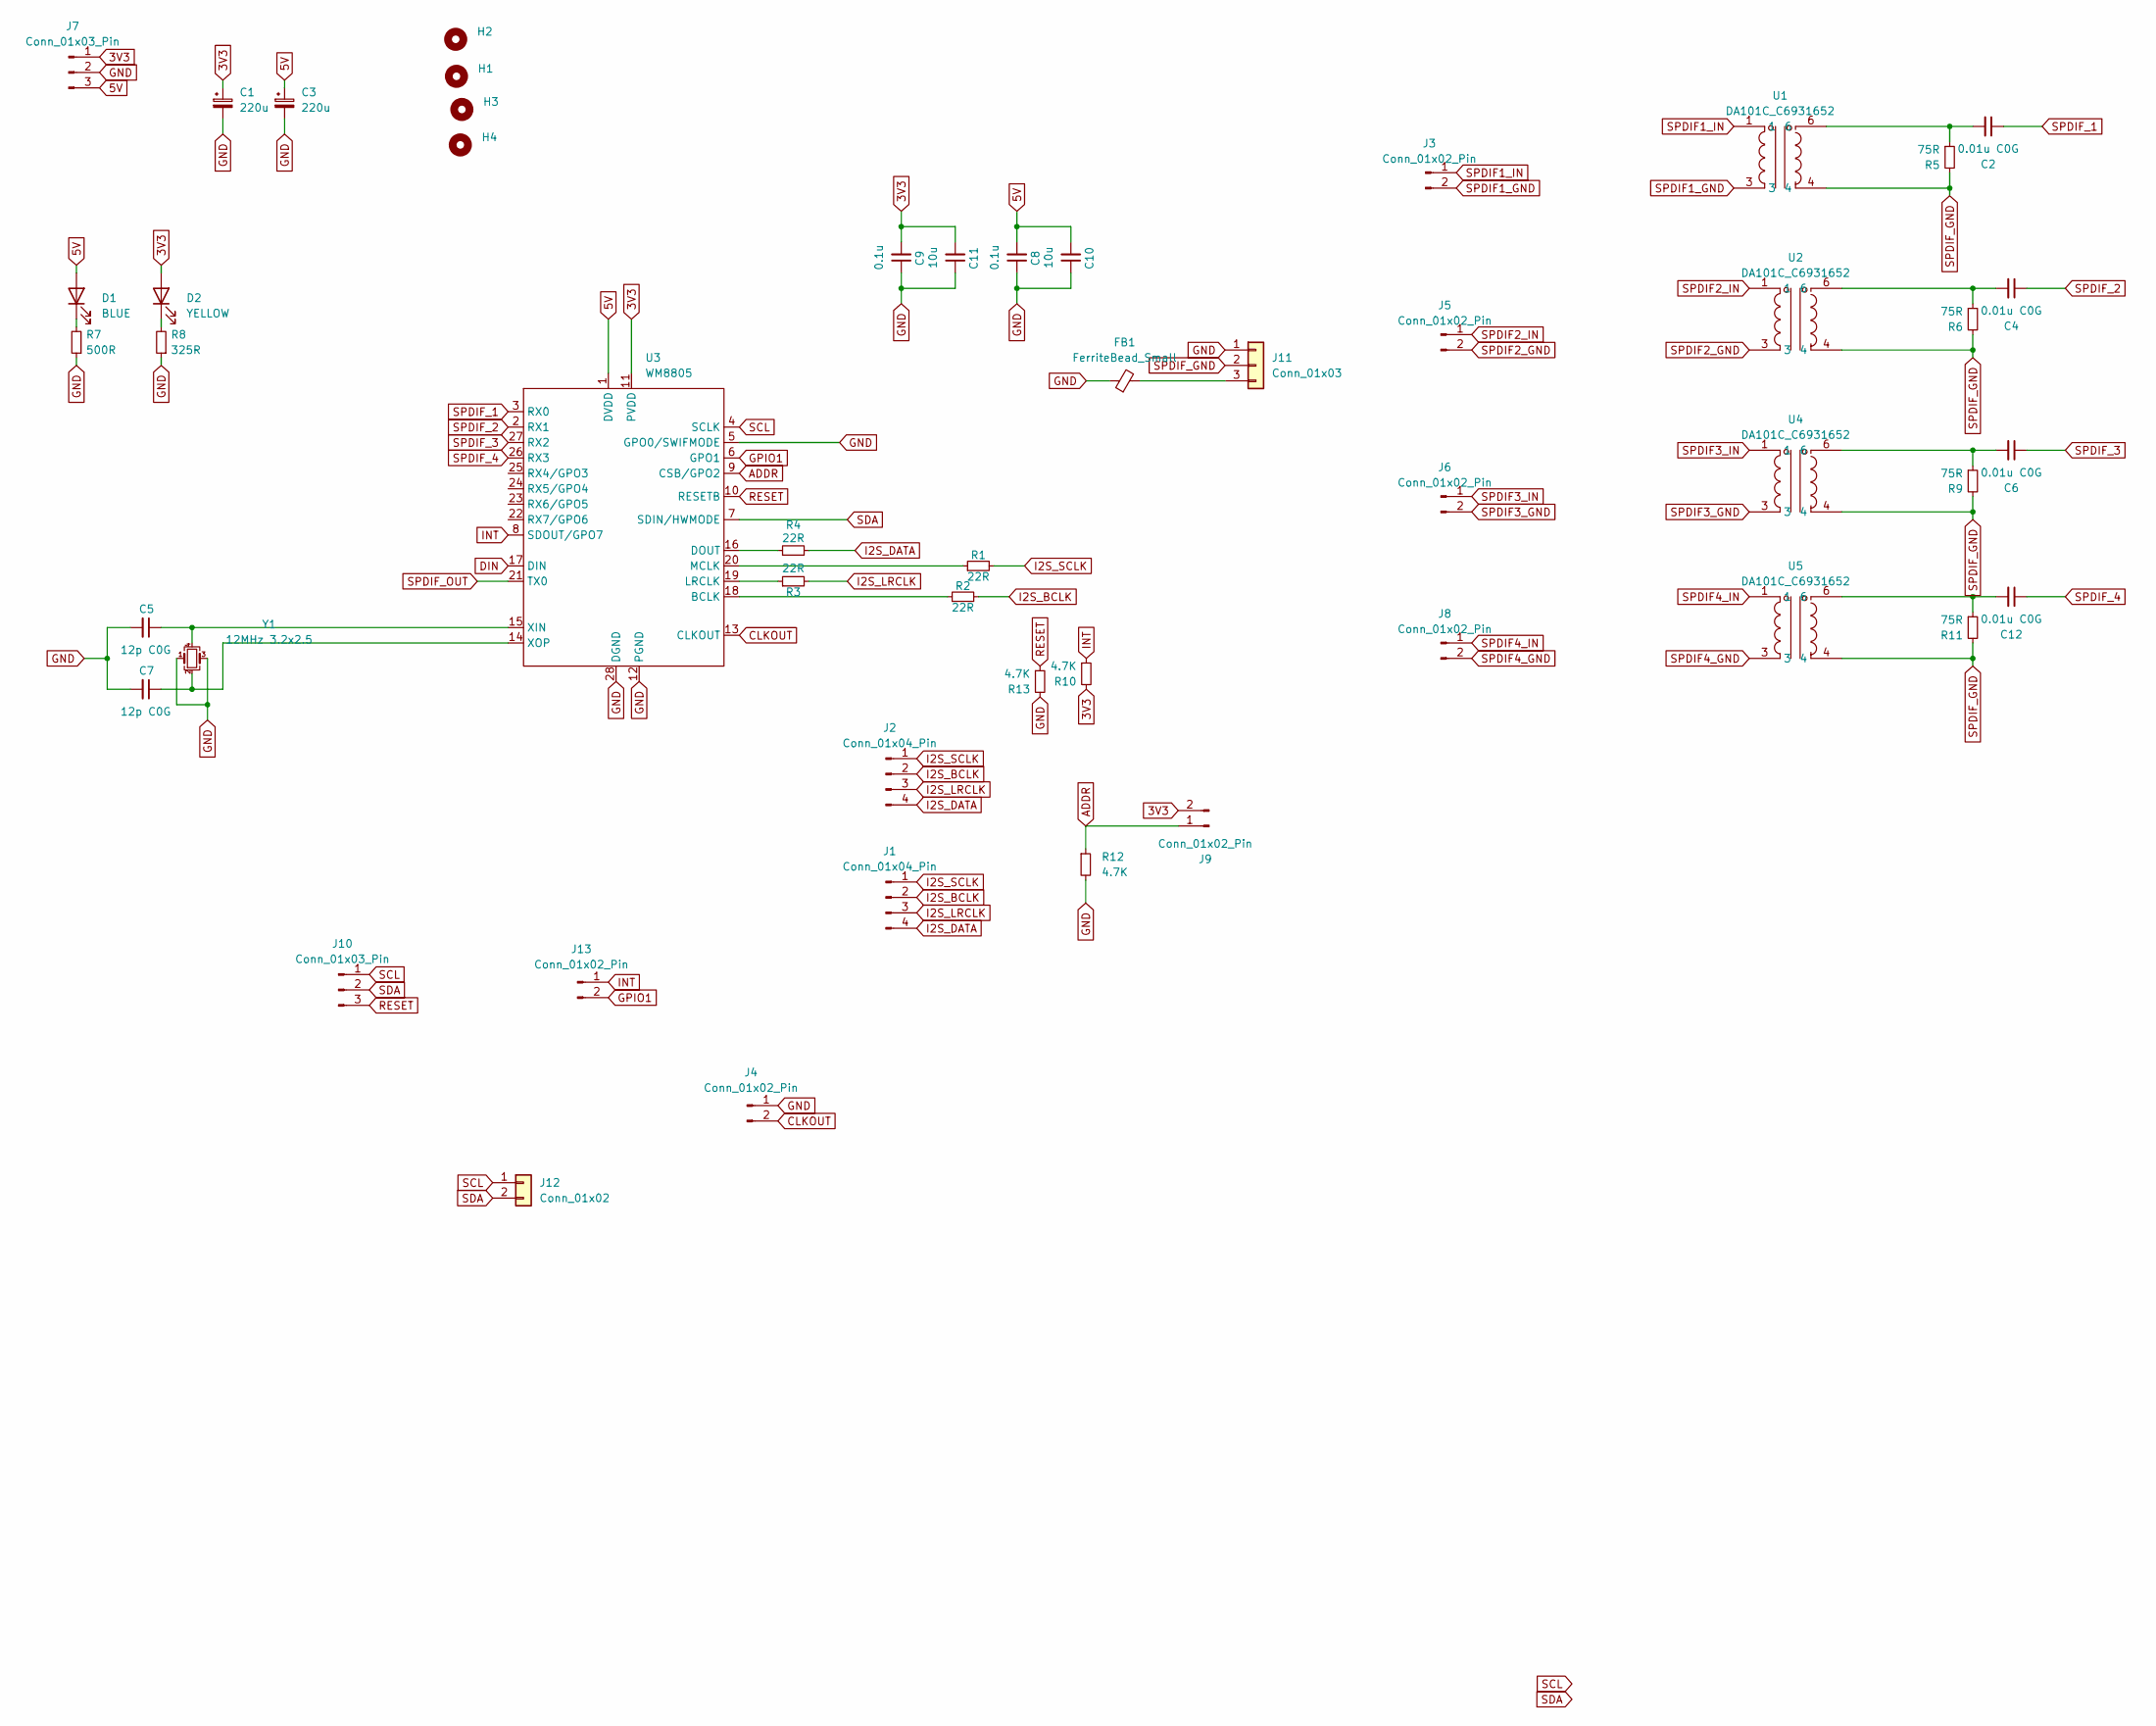
[picture p174: schematic SPDIF.kicad_sch]

Parts:
C1, C3: 220u; CP_Elec_6.3x7.7
C2, C4, C6, C12: 0.01u C0G; C_0805_2012Metric_Pad1.18x1.45mm_HandSolder_Duane; Mouser 791-0805N103G250CT
C5, C7: 12p C0G; C_0805_2012Metric_Pad1.18x1.45mm_HandSolder_Duane; Mouser 603-CC805FRNPO9BN120
C8, C9: 0.1u; C_0805_2012Metric_Pad1.18x1.45mm_HandSolder_Duane
C10, C11: 10u; C_1206_3216Metric_Pad1.33x1.80mm_HandSolder_Duane
D1: BLUE; LED_0805_2012Metric_Pad1.15x1.40mm_HandSolder
D2: YELLOW; LED_0805_2012Metric_Pad1.15x1.40mm_HandSolder
FB1: FerriteBead_Small; R_0805_2012Metric_Pad1.20x1.40mm_HandSolder_Duane
H1, H2, H3, H4: MountingHole; MountingHole_3.2mm_M3_DIN965_Pad_TopOnly
J1: Conn_01x04_Pin; PinHeader_1x04_P2.54mm_Vertical
J2: Conn_01x04_Pin; JST_PH_B4B-PH-K_1x04_P2.00mm_Vertical
J3, J5, J6, J8: Conn_01x02_Pin; JST_XH_B2B-XH-A_1x02_P2.50mm_Vertical
J4, J9, J13: Conn_01x02_Pin; PinHeader_1x02_P2.54mm_Vertical
J7, J10: Conn_01x03_Pin; JST_PH_B3B-PH-K_1x03_P2.00mm_Vertical
J11: Conn_01x03; PinHeader_1x03_P2.54mm_Vertical
J12: Conn_01x02; JST_PH_B2B-PH-K_1x02_P2.00mm_Vertical
R1, R2, R3, R4: 22R; R_0805_2012Metric_Pad1.20x1.40mm_HandSolder_Duane
R5, R6, R9, R11: 75R; R_0805_2012Metric_Pad1.20x1.40mm_HandSolder_Duane; Mouser 71-CRCW0603-75-E3
R7: 500R; R_0805_2012Metric_Pad1.20x1.40mm_HandSolder_Duane
R8: 325R; R_0805_2012Metric_Pad1.20x1.40mm_HandSolder_Duane
R10, R12, R13: 4.7K; R_0805_2012Metric_Pad1.20x1.40mm_HandSolder_Duane
U1, U2, U4, U5: DA101C_C6931652; XFMR-TH_4P-L9.5-W9.0-P5.08-LS10.2_C9900096976; LCSC Part C6931652
U3: WM8805; SSOP-28_5.3x10.2mm_P0.65mm
Y1: 12MHz 3.2x2.5; Crystal_SMD_SeikoEpson_FA238-4Pin_3.2x2.5mm_HandSoldering; Mouser 520-120-8-33B2CKMTR3

Connections:
3V3: C1.1, C9.2, C11.2, D2.2 (A), J7.1, J9.2, R10.2, U3.11 (PVDD)
5V: C3.1, C8.2, C10.2, D1.2 (A), J7.3, U3.1 (DVDD)
ADDR: J9.1, R12.1, U3.9 (CSB/GPO2)
CLKOUT: J4.2, U3.13 (CLKOUT)
DIN: U3.17 (DIN)
GND: C1.2, C3.2, C5.2, C7.2, C8.1, C9.1, C10.1, C11.1, FB1.1, J4.1, J7.2, J11.1, R7.1, R8.1, R12.2, R13.2, U3.5 (GPO0/SWIFMODE), U3.12 (PGND), U3.28 (DGND), Y1.1, Y1.3
GPIO1: J13.2, U3.6 (GPO1)
I2S_BCLK: J1.2, J2.2, R2.2
I2S_DATA: J1.4, J2.4, R4.2
I2S_LRCLK: J1.3, J2.3, R3.2
I2S_SCLK: J1.1, J2.1, R1.2
INT: J13.1, R10.1, U3.8 (SDOUT/GPO7)
unnamed: C2.2, R5.1, U1.6
unnamed: C4.2, R6.1, U2.6
unnamed: C6.2, R9.1, U4.6
unnamed: C12.2, R11.1, U5.6
unnamed: D1.1 (K), R7.2
unnamed: D2.1 (K), R8.2
unnamed: FB1.2, J11.3
unnamed: R2.1, U3.18 (BCLK)
unnamed: R4.1, U3.16 (DOUT)
unnamed: R3.1, U3.19 (LRCLK)
unnamed: R1.1, U3.20 (MCLK)
unnamed: C5.1, U3.15 (XIN), Y1.4
unnamed: C7.1, U3.14 (XOP), Y1.2
RESET: J10.3, R13.1, U3.10 (RESETB)
SCL: J10.1, J12.1, U3.4 (SCLK)
SDA: J10.2, J12.2, U3.7 (SDIN/HWMODE)
SPDIF1_GND: J3.2, U1.3
SPDIF1_IN: J3.1, U1.1
SPDIF2_GND: J5.2, U2.3
SPDIF2_IN: J5.1, U2.1
SPDIF3_GND: J6.2, U4.3
SPDIF3_IN: J6.1, U4.1
SPDIF4_GND: J8.2, U5.3
SPDIF4_IN: J8.1, U5.1
SPDIF_1: C2.1, U3.3 (RX0)
SPDIF_2: C4.1, U3.2 (RX1)
SPDIF_3: C6.1, U3.27 (RX2)
SPDIF_4: C12.1, U3.26 (RX3)
SPDIF_GND: J11.2, R5.2, R6.2, R9.2, R11.2, U1.4, U2.4, U4.4, U5.4
SPDIF_OUT: U3.21 (TX0)

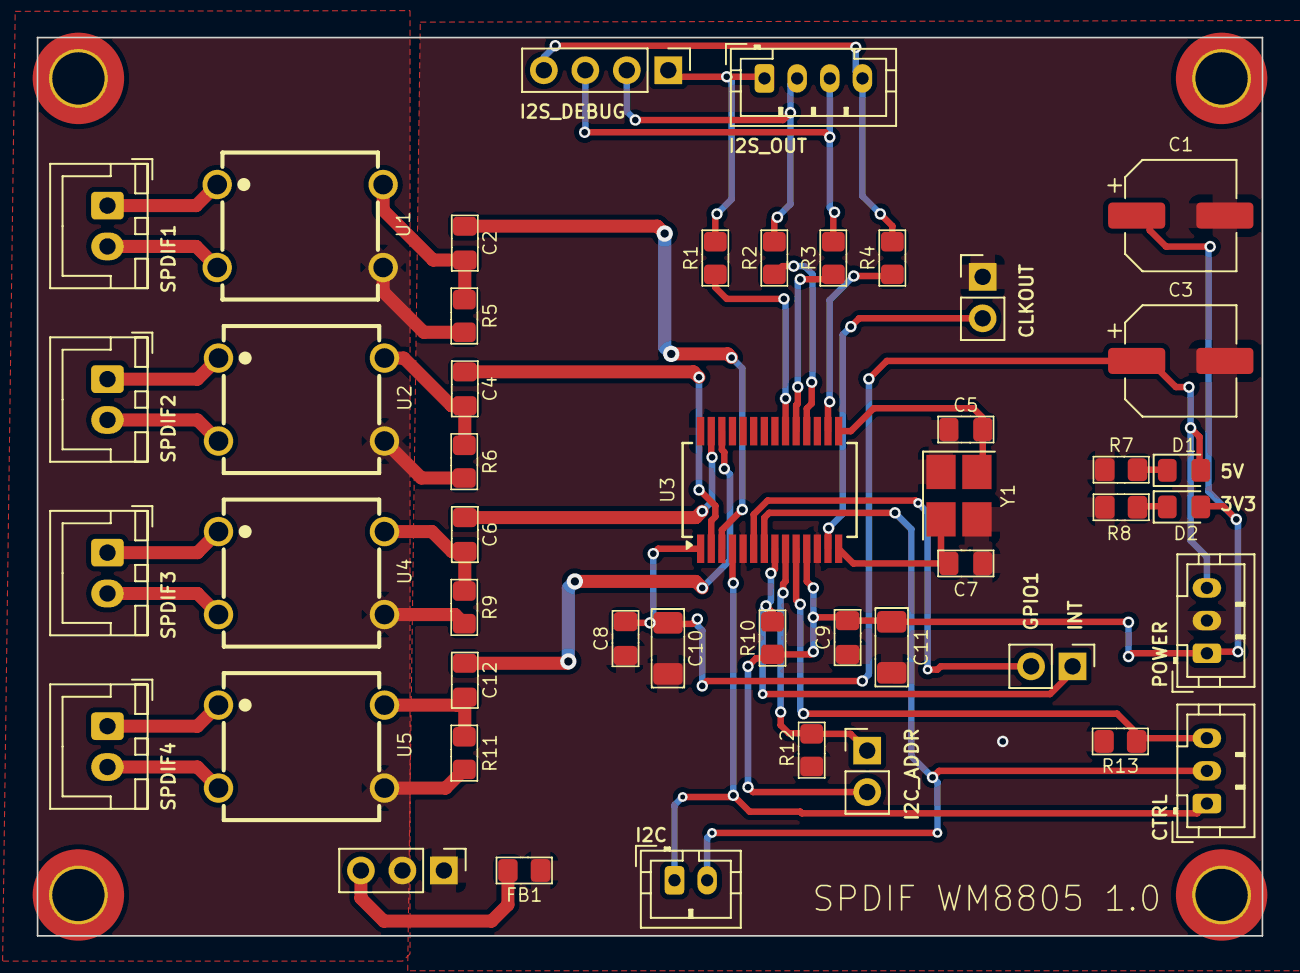
[picture p175: board SPDIF.kicad_pcb from above]

Board: 2 copper layers, 75.0 x 55.0 mm, 51 parts (0 on the bottom side), 40 nets.
