duanestorey/hifi-amp/pcbs/_final_proto/dsp/1.2-new-esp/dsp.kicad_pcb

## KiCad design pcbs/_final_proto/dsp/1.2-new-esp/dsp.kicad_pcb (2025-11-16)

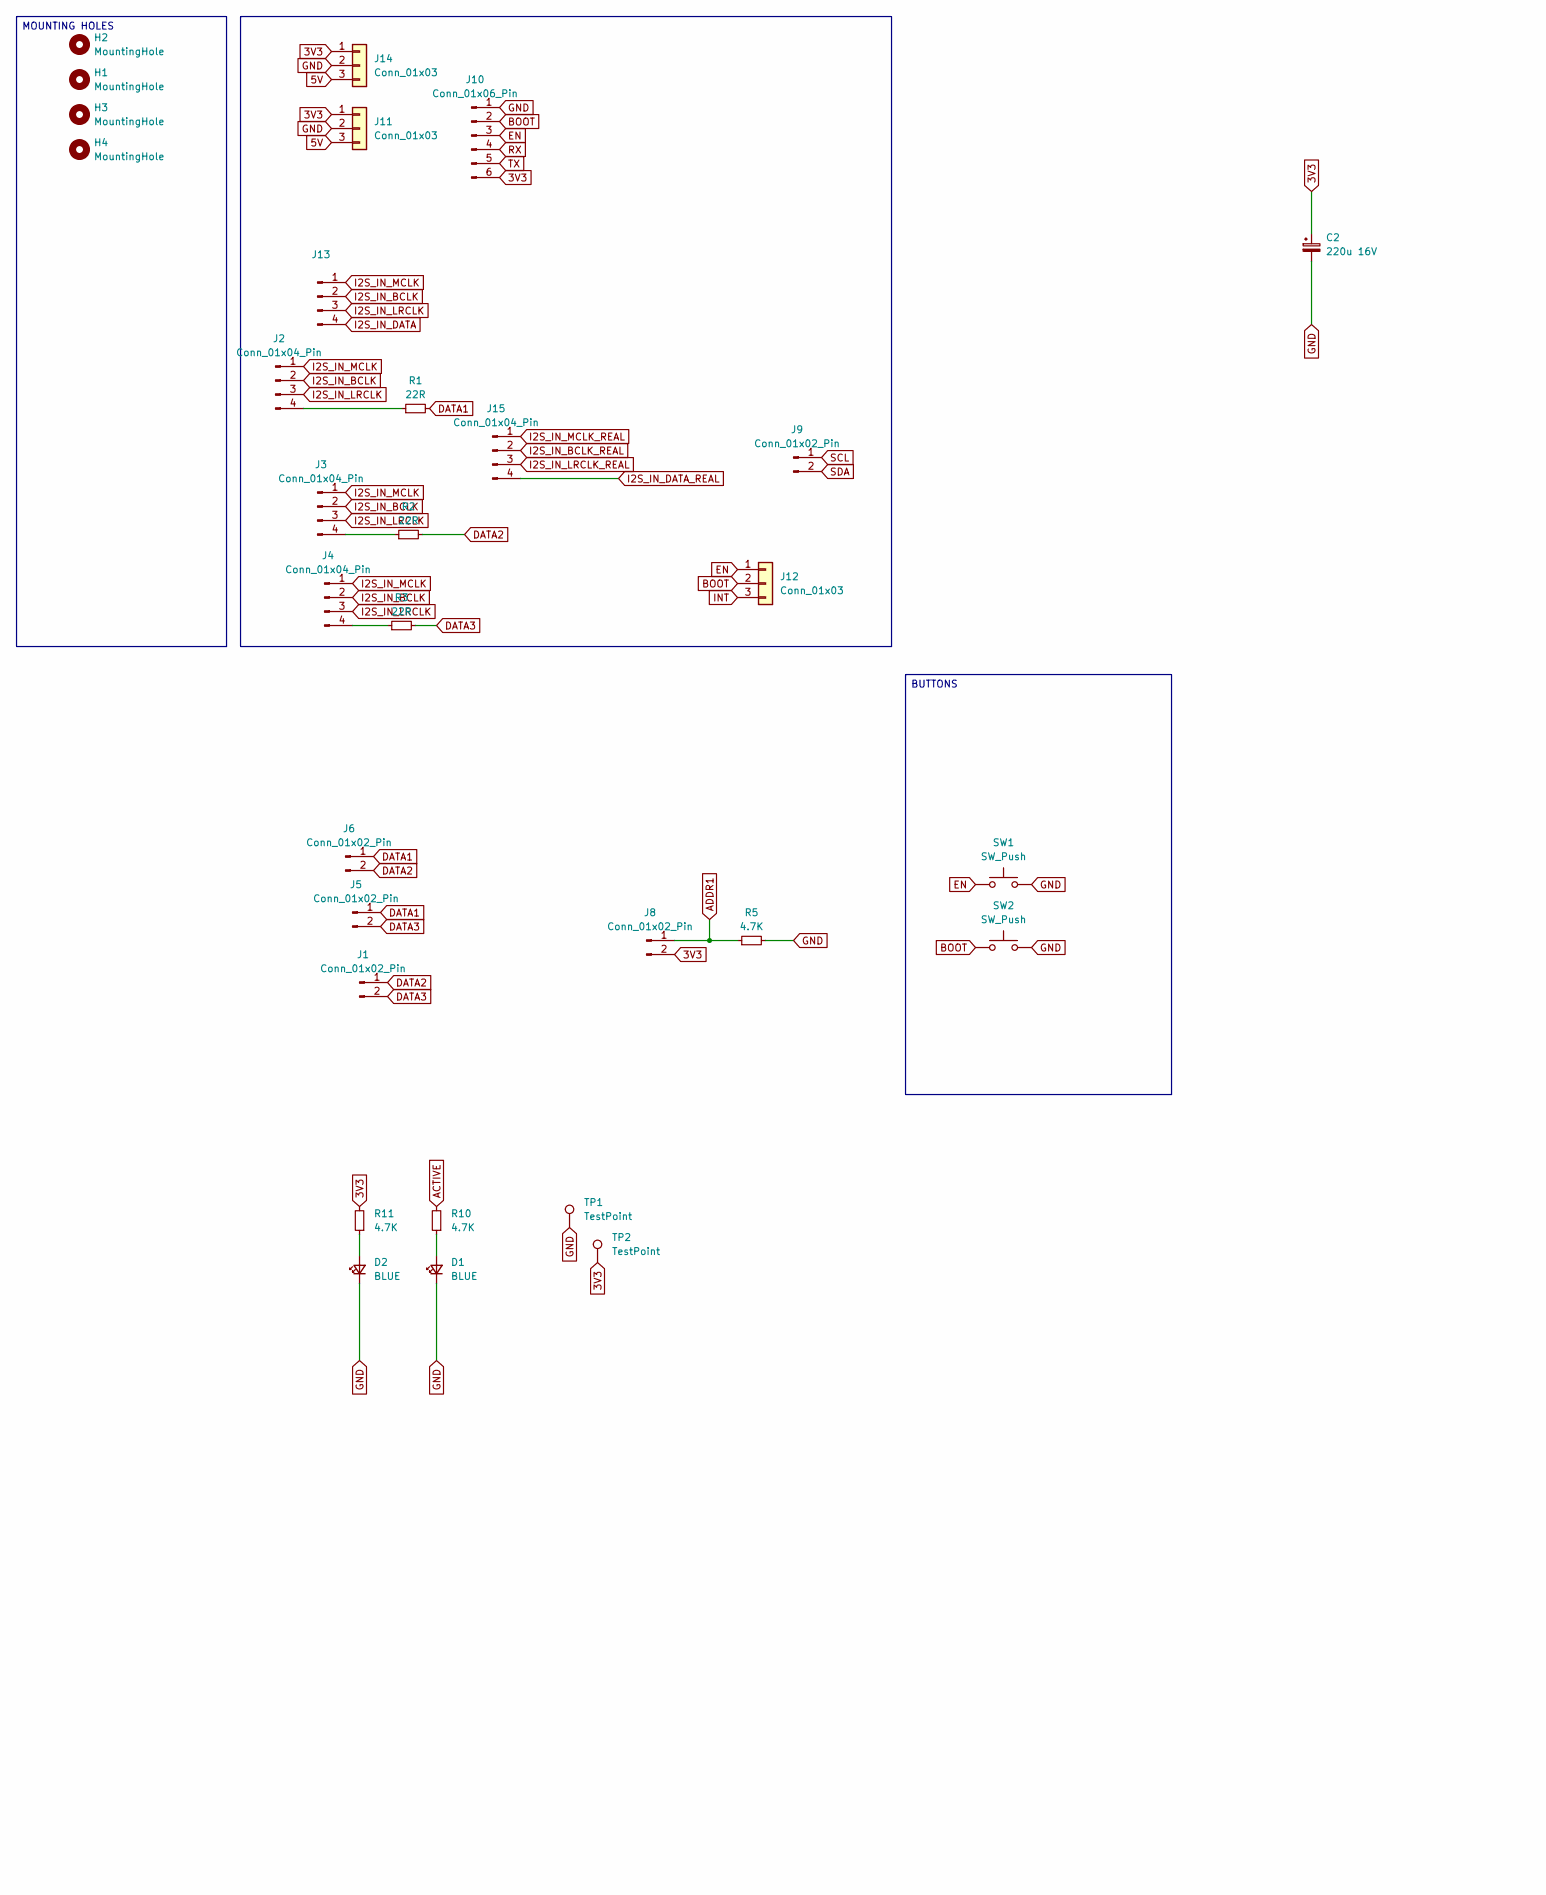
[picture p176: schematic dsp.kicad_sch, part in row 1, column 1]

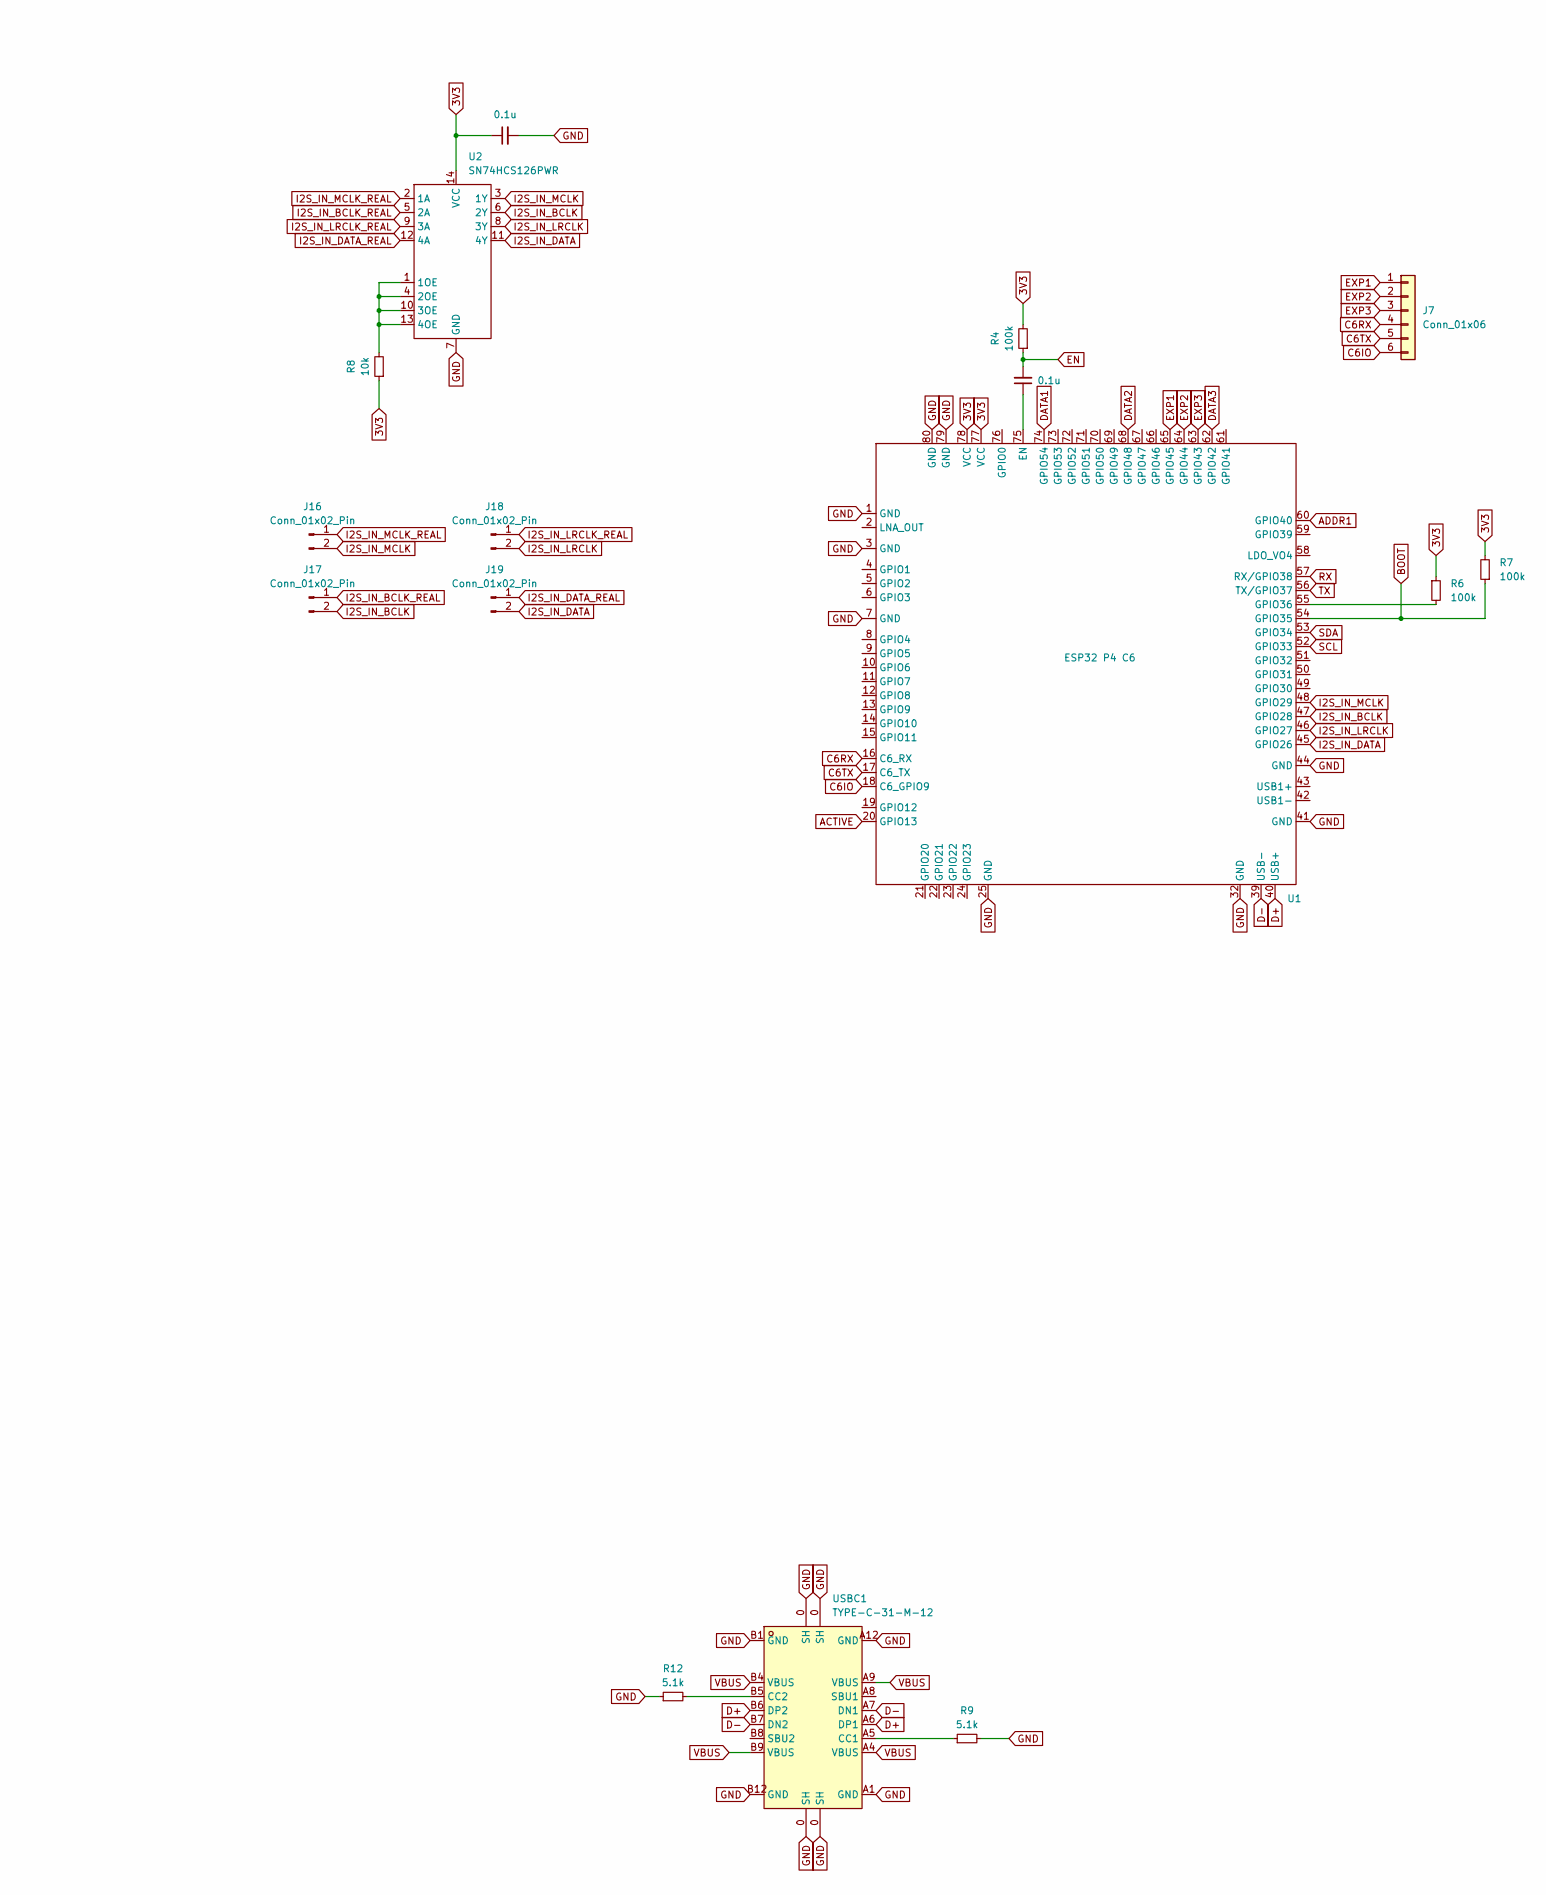
[picture p177: schematic dsp.kicad_sch, part in row 1, column 2]

Parts:
C1, C3: 0.1u; C_0805_2012Metric_Pad1.18x1.45mm_HandSolder
C2: 220u 16V; CP_Elec_6.3x7.7
D1, D2: BLUE; LED_0805_2012Metric_Pad_HandSolder_Duane
H1, H2, H3, H4: MountingHole; MountingHole_3.2mm_M3_DIN965_Pad_TopOnly
J1, J5, J6, J8, J16, J17, J18, J19: Conn_01x02_Pin; PinHeader_1x02_P2.54mm_Vertical
J2, J3, J4, J15: Conn_01x04_Pin; JST_PH_B4B-PH-K_1x04_P2.00mm_Vertical
J7: Conn_01x06; PinHeader_1x06_P2.54mm_Vertical
J9: Conn_01x02_Pin; JST_PH_B2B-PH-K_1x02_P2.00mm_Vertical
J10: Conn_01x06_Pin; PinHeader_1x06_P2.54mm_Vertical
J11, J12, J14: Conn_01x03; JST_PH_B3B-PH-K_1x03_P2.00mm_Vertical
J13: Conn_01x04_Pin; PinHeader_1x04_P2.54mm_Vertical
R1, R2, R3: 22R; R_0805_2012Metric_Pad1.20x1.40mm_HandSolder_Duane; LCSC C23162
R4, R6, R7: 100k; R_0805_2012Metric_Pad1.20x1.40mm_HandSolder_Duane; Mouser 603-RT0805FRE0722RL
R5, R10, R11: 4.7K; R_0805_2012Metric_Pad1.20x1.40mm_HandSolder_Duane; LCSC C23162
R8: 10k; R_0805_2012Metric_Pad1.20x1.40mm_HandSolder_Duane; Mouser 603-RT0805FRE0722RL
R9, R12: 5.1k; R_0805_2012Metric_Pad1.20x1.40mm_HandSolder_Duane; Mouser 603-RT0805FRE0722RL
SW1, SW2: SW_Push; Button Aliexpress 4x4
TP1, TP2: TestPoint; TestPoint_THTPad_1.5x1.5mm_Drill0.7mm
U1: ESP32 P4 C6; ESP32 P4 C6 Module SoC Duane
U2: SN74HCS126PWR; TSSOP-14_4.4x5mm_P0.65mm; Mouser SN74HCS126PWR
USBC1: TYPE-C-31-M-12; USB-C - Duane; LCSC Part C165948

Connections:
3V3: C2.1, C3.1, J8.2, J10.6, J11.1, J14.1, R4.2, R6.1, R7.2, R8.1, R11.2, TP2.1, U1.77 (VCC), U1.78 (VCC), U2.14 (VCC)
5V: J11.3, J14.3
ACTIVE: R10.2, U1.20 (GPIO13)
ADDR1: J8.1, R5.1, U1.60 (GPIO40)
BOOT: J10.2, J12.2, R7.1, SW2.1, U1.54 (GPIO35)
C6IO: J7.6, U1.18 (C6_GPIO9)
C6RX: J7.4, U1.16 (C6_RX)
C6TX: J7.5, U1.17 (C6_TX)
D+: U1.40 (USB+), USBC1.A6 (DP1), USBC1.B6 (DP2)
D-: U1.39 (USB-), USBC1.A7 (DN1), USBC1.B7 (DN2)
DATA1: J5.1, J6.1, R1.2, U1.74 (GPIO54)
DATA2: J1.1, J6.2, R2.2, U1.68 (GPIO48)
DATA3: J1.2, J5.2, R3.2, U1.62 (GPIO42)
EN: C1.2, J10.3, J12.1, R4.1, SW1.1
EXP1: J7.1, U1.65 (GPIO45)
EXP2: J7.2, U1.64 (GPIO44)
EXP3: J7.3, U1.63 (GPIO43)
GND: C2.2, C3.2, D1.1 (K), D2.1 (K), J10.1, J11.2, J14.2, R5.2, R9.2, R12.1, SW1.2, SW2.2, TP1.1, U1.1 (GND), U1.3 (GND), U1.7 (GND), U1.25 (GND), U1.32 (GND), U1.41 (GND), U1.44 (GND), U1.79 (GND), U1.80 (GND), U2.7 (GND), USBC1.0 (SH), USBC1.A1 (GND), USBC1.A12 (GND), USBC1.B1 (GND), USBC1.B12 (GND)
I2S_IN_BCLK: J2.2, J3.2, J4.2, J13.2, J17.2, U1.47 (GPIO28), U2.6 (2Y)
I2S_IN_BCLK_REAL: J15.2, J17.1, U2.5 (2A)
I2S_IN_DATA: J13.4, J19.2, U1.45 (GPIO26), U2.11 (4Y)
I2S_IN_DATA_REAL: J15.4, J19.1, U2.12 (4A)
I2S_IN_LRCLK: J2.3, J3.3, J4.3, J13.3, J18.2, U1.46 (GPIO27), U2.8 (3Y)
I2S_IN_LRCLK_REAL: J15.3, J18.1, U2.9 (3A)
I2S_IN_MCLK: J2.1, J3.1, J4.1, J13.1, J16.2, U1.48 (GPIO29), U2.3 (1Y)
I2S_IN_MCLK_REAL: J15.1, J16.1, U2.2 (1A)
INT: J12.3
unnamed: D1.2 (A), R10.1
unnamed: D2.2 (A), R11.1
unnamed: J2.4, R1.1
unnamed: J3.4, R2.1
unnamed: J4.4, R3.1
unnamed: C1.1, U1.75 (EN)
unnamed: R6.2, U1.55 (GPIO36)
unnamed: R8.2, U2.1 (1OE), U2.4 (2OE), U2.10 (3OE), U2.13 (4OE)
unnamed: R9.1, USBC1.A5 (CC1)
unnamed: R12.2, USBC1.B5 (CC2)
RX: J10.4, U1.57 (RX/GPIO38)
SCL: J9.1, U1.52 (GPIO33)
SDA: J9.2, U1.53 (GPIO34)
TX: J10.5, U1.56 (TX/GPIO37)
VBUS: USBC1.A4 (VBUS), USBC1.A9 (VBUS), USBC1.B4 (VBUS), USBC1.B9 (VBUS)

Notes on the sheet:
MOUNTING HOLES
BUTTONS
