duanestorey/hifi-amp/pcbs/_final_proto/dsp/1.2-new-esp/dsp.kicad_pcb

## KiCad design pcbs/_final_proto/dsp/1.2-new-esp/dsp.kicad_pcb (continued)

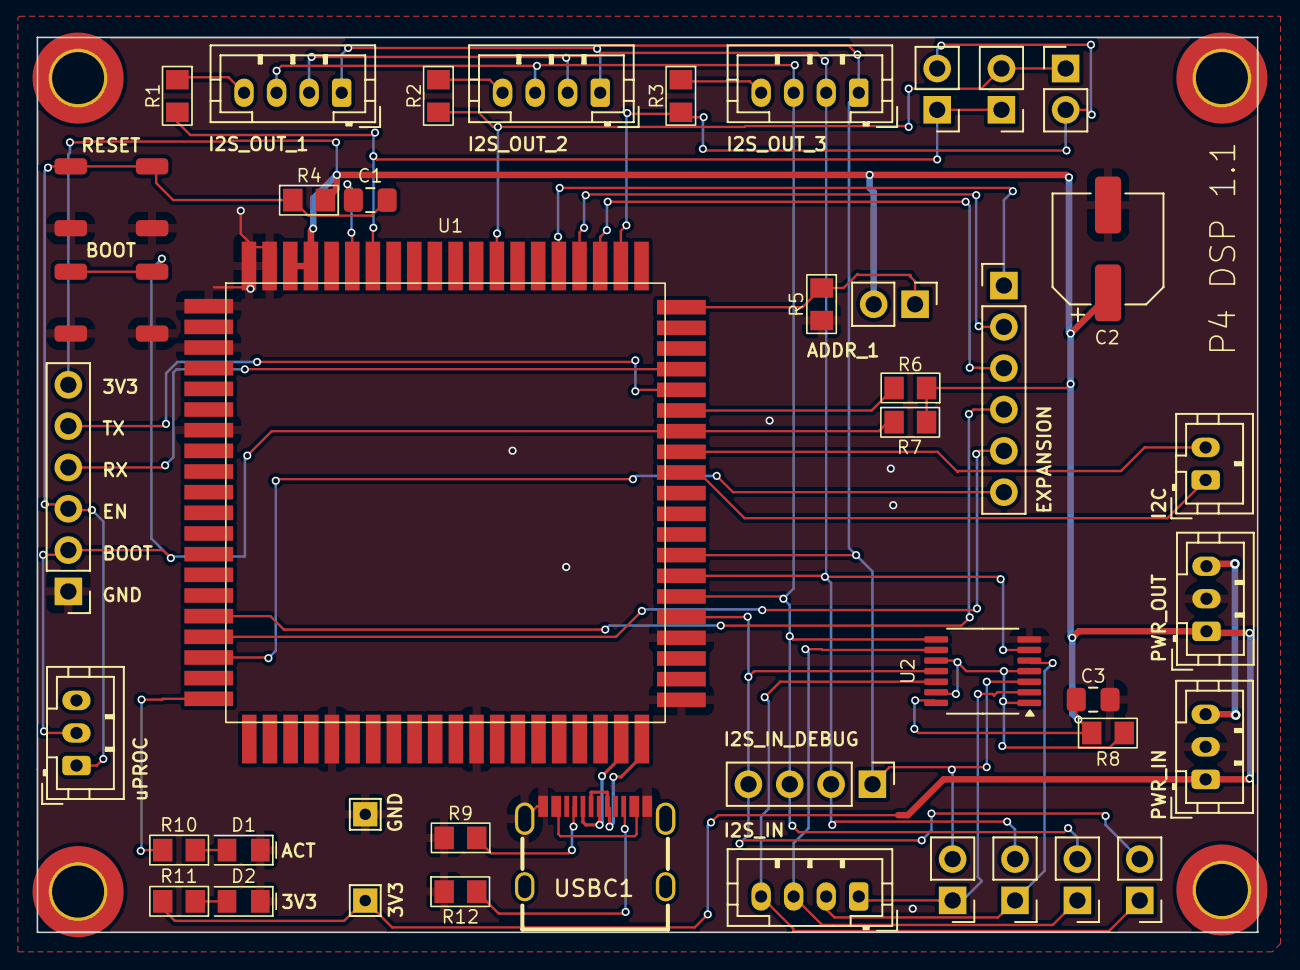
[picture p178: board pcbs/_final_proto/dsp/1.2-new-esp/dsp.kicad_pcb from above]

Board: 2 copper layers, 75.0 x 55.0 mm, 47 parts (0 on the bottom side), 41 nets.
