duanestorey/hifi-amp/pcbs/plate-amp/2.0/plate-amp.kicad_pcb

## KiCad design pcbs/plate-amp/2.0/plate-amp.kicad_pcb (2025-11-16)

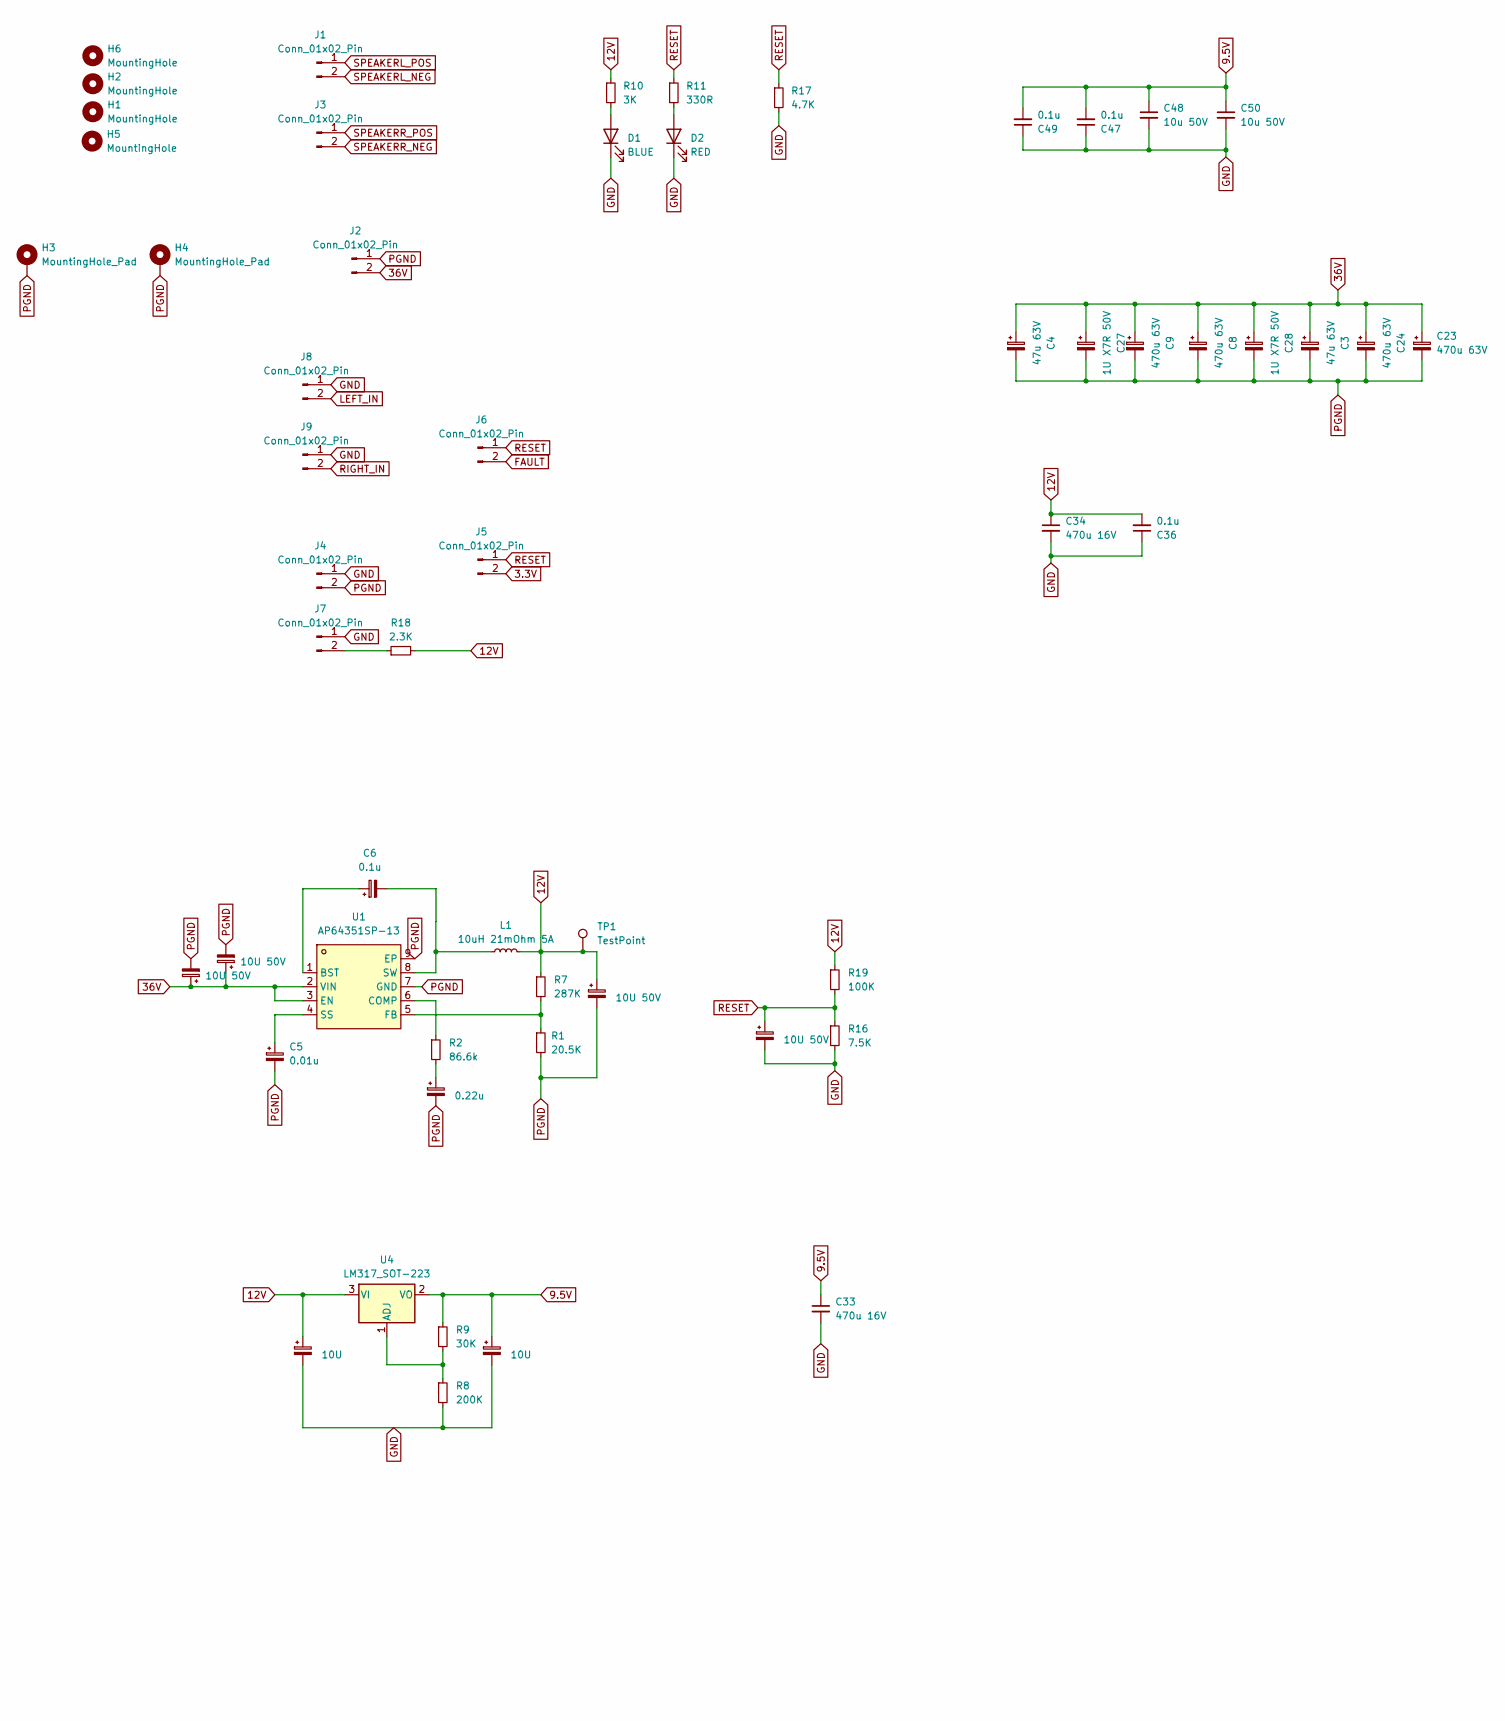
[picture p179: schematic plate-amp.kicad_sch, part in row 1, column 1]

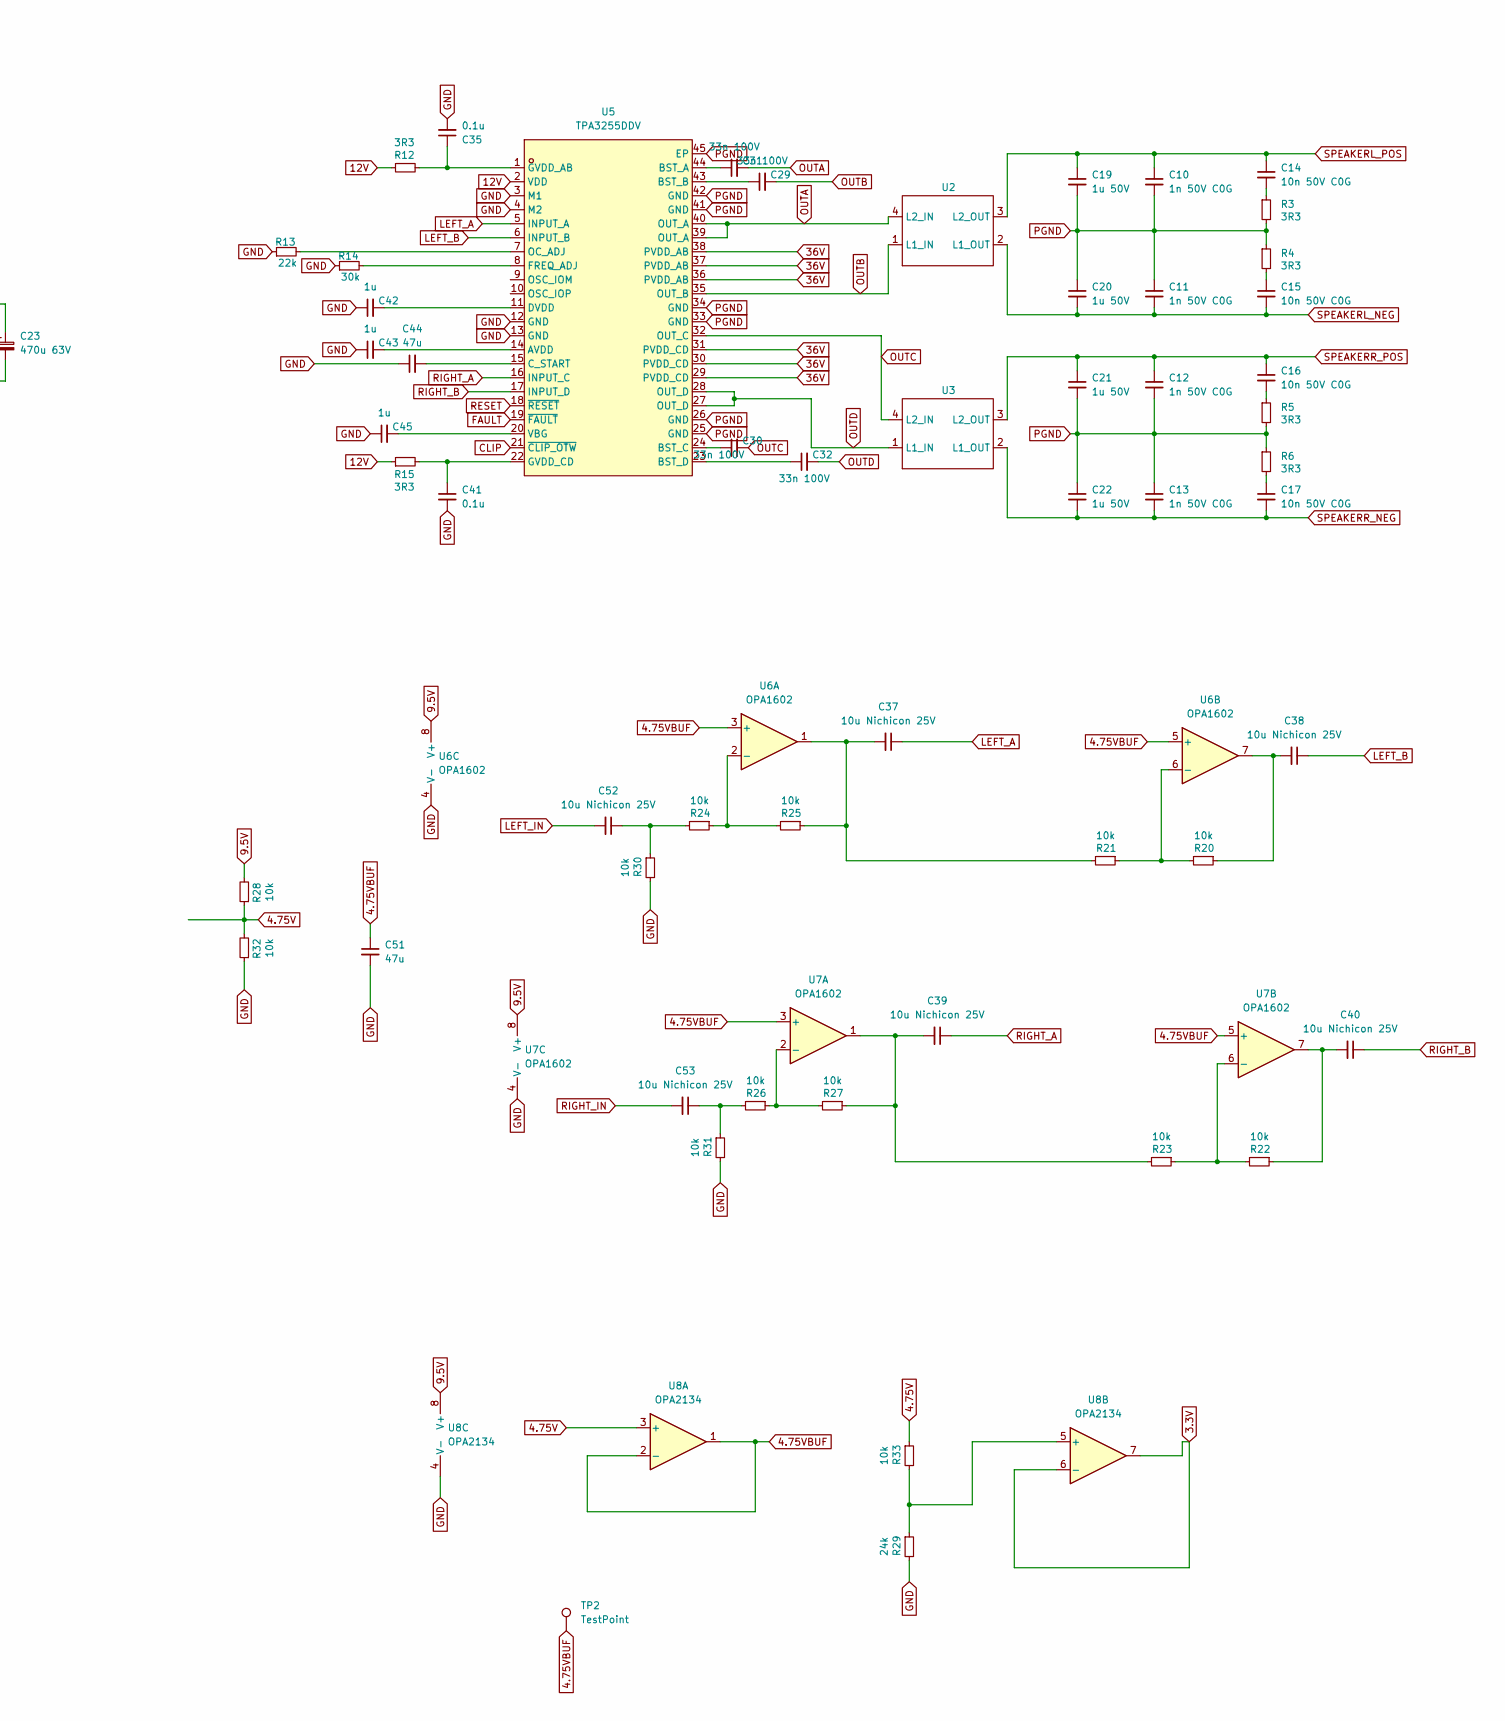
[picture p180: schematic plate-amp.kicad_sch, part in row 1, column 2]

Parts:
C1, C2, C18, C46: 10U 50V; C_1206_3216Metric_Pad1.33x1.80mm_HandSolder
C3, C4: 47u 63V; CP_Radial_D6.3mm_P2.50mm; LCSC C45673
C5: 0.01u; C_0805_2012Metric_Pad1.18x1.45mm_HandSolder
C6, C35, C36, C41, C47, C49: 0.1u; C_0805_2012Metric_Pad1.18x1.45mm_HandSolder
C7: 0.22u; C_0805_2012Metric_Pad1.18x1.45mm_HandSolder
C8, C9, C23, C24: 470u 63V; CP_Radial_D13.0mm_P5.00mm; LCSC C18823
C10, C11, C12, C13: 1n 50V C0G; C_1206_3216Metric_Pad1.33x1.80mm_HandSolder
C14, C15, C16, C17: 10n 50V C0G; C_1206_3216Metric_Pad1.33x1.80mm_HandSolder
C19, C20, C21, C22: 1u 50V; CP_Radial_D5.0mm_P2.00mm
C25, C26: 10U; C_1206_3216Metric_Pad1.33x1.80mm_HandSolder
C27, C28: 1U X7R 50V; C_1206_3216Metric_Pad1.33x1.80mm_HandSolder; Mouser 80-C1206X475J5RACTU
C29, C30, C31, C32: 33n 100V; C_1206_3216Metric_Pad1.33x1.80mm_HandSolder
C33, C34: 470u 16V; CP_Radial_D8.0mm_P3.50mm
C37, C38, C39, C40, C52, C53: 10u Nichicon 25V; CP_Radial_D5.0mm_P2.50mm
C42, C43, C45: 1u; C_1206_3216Metric_Pad1.33x1.80mm_HandSolder
C44, C51: 47u; C_1206_3216Metric_Pad1.33x1.80mm_HandSolder
C48, C50: 10u 50V; C_1206_3216Metric_Pad1.33x1.80mm_HandSolder
D1: BLUE; LED_0603_1608Metric_Pad1.05x0.95mm_HandSolder; LCSC XL-1608UBC-04
D2: RED; LED_0603_1608Metric_Pad1.05x0.95mm_HandSolder; LCSC XL-1608UBC-04
H1, H2, H5, H6: MountingHole; MountingHole_3.2mm_M3_DIN965_Pad_TopOnly
H3, H4: MountingHole_Pad; MountingHole_3.2mm_M3_DIN965_Pad_TopBottom
J1, J2, J3: Conn_01x02_Pin; TerminalBlock_MaiXu_MX126-5.0-02P_1x02_P5.00mm
J4, J5: Conn_01x02_Pin; PinHeader_1x02_P2.54mm_Vertical
J6, J7, J8, J9: Conn_01x02_Pin; JST_PH_B2B-PH-K_1x02_P2.00mm_Vertical
L1: 10uH 21mOhm 5A; L_Vishay_IHLP-4040; Mouser 704-DR1040-7R0-R
R1: 20.5K; R_0603_1608Metric_Pad0.98x0.95mm_HandSolder; Mouser 603-RC0603JR-07820KP
R2: 86.6k; R_0603_1608Metric_Pad0.98x0.95mm_HandSolder; Mouser 71-CRCW0603-86.6K-E3
R3, R4, R5, R6: 3R3; R_2512_6332Metric_Pad1.40x3.35mm_HandSolder
R7: 287K; R_0603_1608Metric_Pad0.98x0.95mm_HandSolder; Mouser 603-RC0603JR-10180KL
R8: 200K; R_0603_1608Metric_Pad0.98x0.95mm_HandSolder
R9: 30K; R_0603_1608Metric_Pad0.98x0.95mm_HandSolder
R10: 3K; R_0603_1608Metric_Pad0.98x0.95mm_HandSolder
R11: 330R; R_0603_1608Metric_Pad0.98x0.95mm_HandSolder
R12, R15: 3R3; C_0603_1608Metric_Pad1.08x0.95mm_HandSolder
R13: 22k; C_0603_1608Metric_Pad1.08x0.95mm_HandSolder
R14: 30k; C_0603_1608Metric_Pad1.08x0.95mm_HandSolder
R16: 7.5K; R_0603_1608Metric_Pad0.98x0.95mm_HandSolder; Mouser 603-RC0603JR-10180KL
R17: 4.7K; R_0603_1608Metric_Pad0.98x0.95mm_HandSolder
R18: 2.3K; R_0603_1608Metric_Pad0.98x0.95mm_HandSolder; Mouser 603-RC0603JR-10180KL
R19: 100K; R_0603_1608Metric_Pad0.98x0.95mm_HandSolder; Mouser 603-RC0603JR-10180KL
R20, R21, R22, R23, R24, R25, R26, R27, R28, R30, R31, R32, R33: 10k; C_0603_1608Metric_Pad1.08x0.95mm_HandSolder
R29: 24k; C_0603_1608Metric_Pad1.08x0.95mm_HandSolder
TP1: TestPoint; TestPoint_THTPad_D2.0mm_Drill1.0mm
TP2: TestPoint; TestPoint_THTPad_2.5x2.5mm_Drill1.2mm
U1: AP64351SP-13; SOIC-8_L4.9-W3.9-P1.27-LS6.0-BL-EP; LCSC Part C3192339
U2, U3: UA8014-AL
U4: LM317_SOT-223; SOT-223-3_TabPin2
U5: TPA3255DDV; HTSSOP-44_L14.0-W6.1-P0.64-LS8.1-BL-EP; LCSC Part C468240
U6, U7: OPA1602; DIP-8_W7.62mm
U8: OPA2134; SOIC-8_3.9x4.9mm_P1.27mm

Connections:
3.3V: J5.2, U8.6 (-), U8.7
4.75V: R28.1, R32.2, R33.1, U8.3 (+)
4.75VBUF: C51.1, TP2.1, U6.3 (+), U6.5 (+), U7.3 (+), U7.5 (+), U8.1, U8.2 (-)
9.5V: C26.1, C33.1, C47.2, C48.1, C49.2, C50.1, R9.1, R28.2, U4.2 (VO), U6.8 (V+), U7.8 (V+), U8.8 (V+)
12V: C18.1, C25.1, C34.1, C36.2, L1.2, R7.1, R10.1, R12.1, R15.1, R18.2, R19.1, TP1.1, U4.3 (VI), U5.2 (VDD)
36V: C1.1, C2.1, C3.1, C4.1, C8.1, C9.1, C23.1, C24.1, C27.1, C28.1, J2.2, U1.2 (VIN), U1.3 (EN), U5.29 (PVDD_CD), U5.30 (PVDD_CD), U5.31 (PVDD_CD), U5.36 (PVDD_AB), U5.37 (PVDD_AB), U5.38 (PVDD_AB)
CLIP: U5.21 (~CLIP_OTW)
FAULT: J6.2, U5.19 (~FAULT)
GND: C25.2, C26.2, C33.2, C34.2, C35.2, C36.1, C41.2, C42.1, C43.1, C44.1, C45.1, C46.2, C47.1, C48.2, C49.1, C50.2, C51.2, D1.1 (K), D2.1 (K), J4.1, J7.1, J8.1, J9.1, R8.2, R13.1, R14.1, R16.2, R17.2, R29.2, R30.2, R31.2, R32.1, U5.3 (M1), U5.4 (M2), U5.12 (GND), U5.13 (GND), U6.4 (V-), U7.4 (V-), U8.4 (V-)
LEFT_A: C37.1, U5.5 (INPUT_A)
LEFT_B: C38.1, U5.6 (INPUT_B)
LEFT_IN: C52.2, J8.2
unnamed: C7.1, R2.2
unnamed: C14.2, R3.1
unnamed: C15.1, R4.2
unnamed: C16.2, R5.1
unnamed: C17.1, R6.2
unnamed: C37.2, R21.2, R25.1, U6.1
unnamed: C38.2, R20.1, U6.7
unnamed: C39.2, R23.2, R27.1, U7.1
unnamed: C40.2, R22.1, U7.7
unnamed: C52.1, R24.2, R30.1
unnamed: C53.1, R26.2, R31.1
unnamed: D1.2 (A), R10.2
unnamed: D2.2 (A), R11.2
unnamed: J7.2, R18.1
unnamed: C6.1, U1.1 (BST)
unnamed: R2.1, U1.6 (COMP)
unnamed: R1.1, R7.2, U1.5 (FB)
unnamed: C5.1, U1.4 (SS)
unnamed: C6.2, L1.1, U1.8 (SW)
unnamed: R8.1, R9.2, U4.1 (ADJ)
unnamed: C43.2, U5.14 (AVDD)
unnamed: C31.1, U5.44 (BST_A)
unnamed: C29.1, U5.43 (BST_B)
unnamed: C30.1, U5.24 (BST_C)
unnamed: C32.1, U5.23 (BST_D)
unnamed: C44.2, U5.15 (C_START)
unnamed: C42.2, U5.11 (DVDD)
unnamed: R14.2, U5.8 (FREQ_ADJ)
unnamed: C35.1, R12.2, U5.1 (GVDD_AB)
unnamed: C41.1, R15.2, U5.22 (GVDD_CD)
unnamed: R13.2, U5.7 (OC_ADJ)
unnamed: C45.2, U5.20 (VBG)
unnamed: R24.1, R25.2, U6.2 (-)
unnamed: R20.2, R21.1, U6.6 (-)
unnamed: R26.1, R27.2, U7.2 (-)
unnamed: R22.2, R23.1, U7.6 (-)
unnamed: R29.1, R33.2, U8.5 (+)
OUTA: C31.2, U2.4 (L2_IN), U5.39 (OUT_A), U5.40 (OUT_A)
OUTB: C29.2, U2.1 (L1_IN), U5.35 (OUT_B)
OUTC: C30.2, U3.4 (L2_IN), U5.32 (OUT_C)
OUTD: C32.2, U3.1 (L1_IN), U5.27 (OUT_D), U5.28 (OUT_D)
PGND: C1.2, C2.2, C3.2, C4.2, C5.2, C7.2, C8.2, C9.2, C10.2, C11.1, C12.2, C13.1, C18.2, C19.2, C20.1, C21.2, C22.1, C23.2, C24.2, C27.2, C28.2, H3.1, H4.1, J2.1, J4.2, R1.2, R3.2, R4.1, R5.2, R6.1, U1.7 (GND), U1.9 (EP), U5.25 (GND), U5.26 (GND), U5.33 (GND), U5.34 (GND), U5.41 (GND), U5.42 (GND), U5.45 (EP)
RESET: C46.1, J5.1, J6.1, R11.1, R16.1, R17.1, R19.2, U5.18 (~RESET)
RIGHT_A: C39.1, U5.16 (INPUT_C)
RIGHT_B: C40.1, U5.17 (INPUT_D)
RIGHT_IN: C53.2, J9.2
SPEAKERL_NEG: C11.2, C15.2, C20.2, J1.2, U2.2 (L1_OUT)
SPEAKERL_POS: C10.1, C14.1, C19.1, J1.1, U2.3 (L2_OUT)
SPEAKERR_NEG: C13.2, C17.2, C22.2, J3.2, U3.2 (L1_OUT)
SPEAKERR_POS: C12.1, C16.1, C21.1, J3.1, U3.3 (L2_OUT)

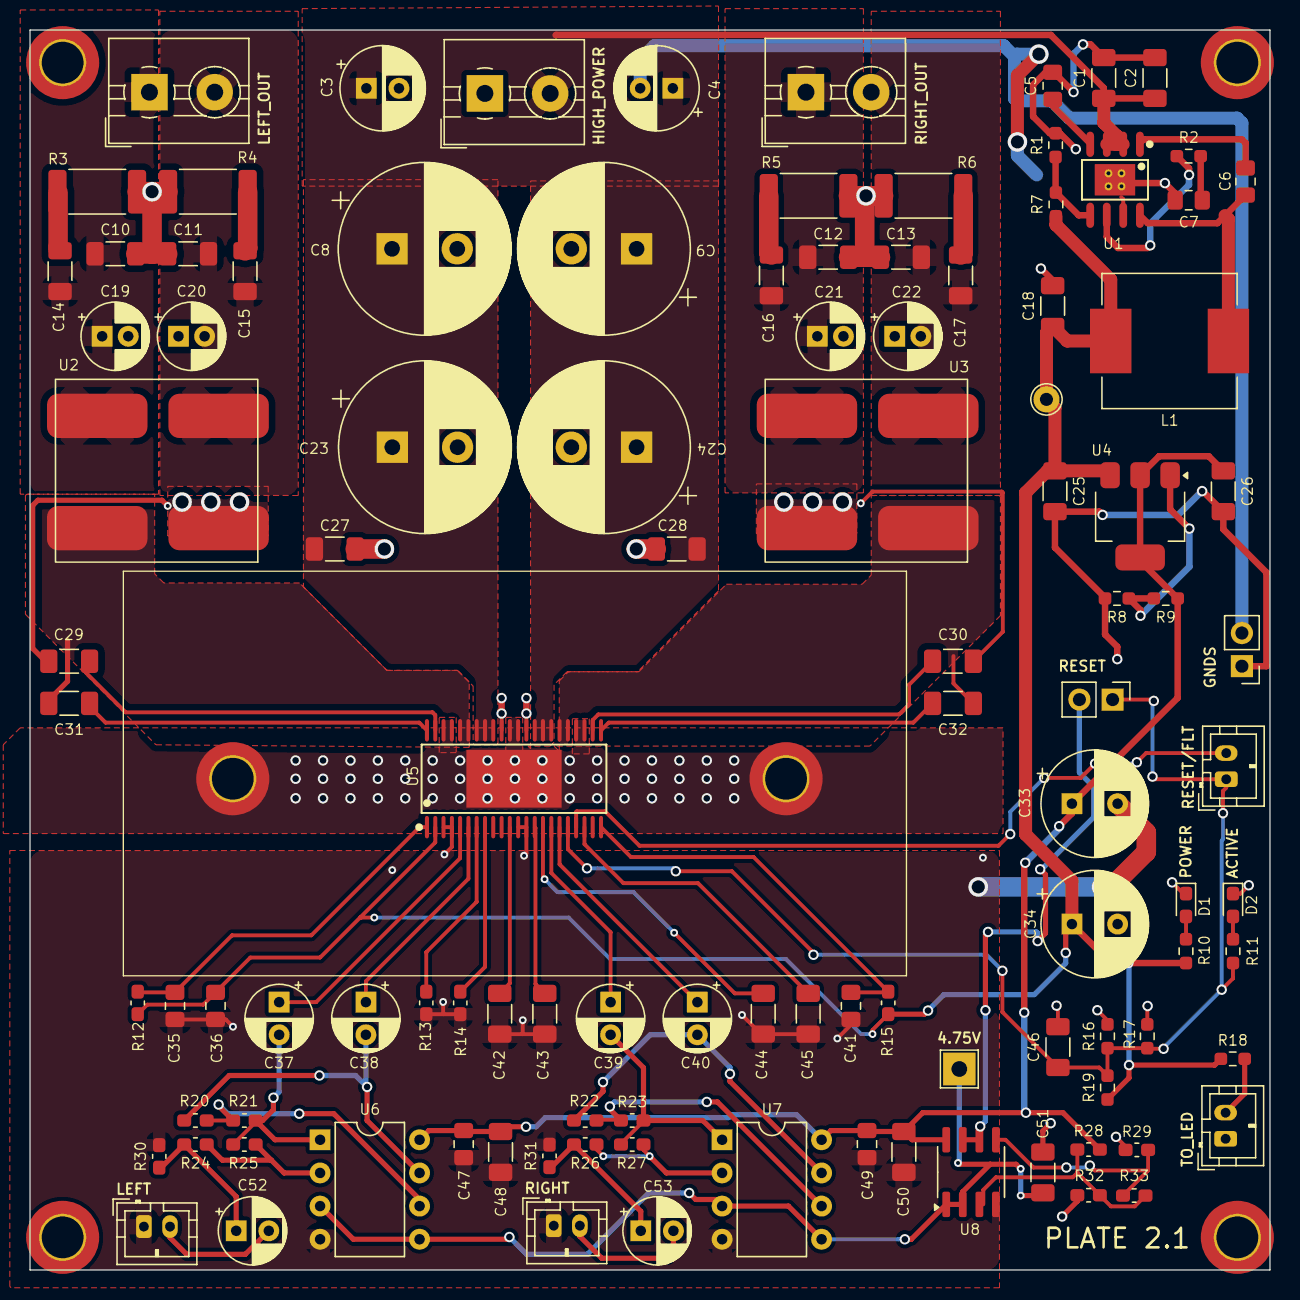
[picture p181: board plate-amp.kicad_pcb from above]

Board: 2 copper layers, 95.0 x 95.0 mm, 114 parts (0 on the bottom side), 61 nets.
