duanestorey/hifi-amp/pcbs/_final_proto/soic/1.0/soic.kicad_pcb

## KiCad design pcbs/_final_proto/soic/1.0/soic.kicad_pcb (2025-11-16)

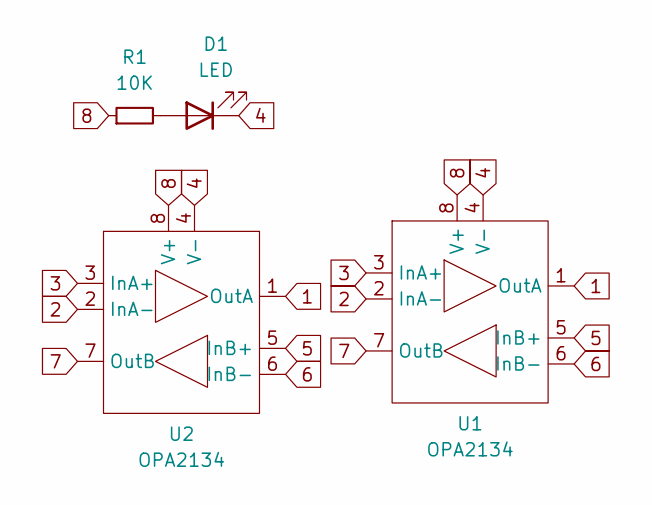
[picture p182: schematic soic.kicad_sch]

Parts:
D1: LED; LED_0805_2012Metric_Pad_HandSolder_Duane
R1: 10K; R_0805_2012Metric_Pad1.20x1.40mm_HandSolder_Duane
U1: OPA2134; DIP-8_W7.62mm_Socket
U2: OPA2134; SOIC-8_3.9x4.9mm_P1.27mm

Connections:
1: U1.1 (OutA), U2.1 (OutA)
2: U1.2 (InA-), U2.2 (InA-)
3: U1.3 (InA+), U2.3 (InA+)
4: D1.1 (K), U1.4 (V-), U2.4 (V-)
5: U1.5 (InB+), U2.5 (InB+)
6: U1.6 (InB-), U2.6 (InB-)
7: U1.7 (OutB), U2.7 (OutB)
8: R1.1, U1.8 (V+), U2.8 (V+)
unnamed: D1.2 (A), R1.2

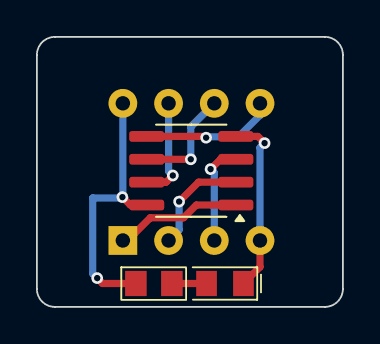
[picture p183: board soic.kicad_pcb from above]

Board: 2 copper layers, 17.0 x 15.0 mm, 4 parts (0 on the bottom side), 9 nets.
