duanestorey/hifi-amp/pcbs/_final_proto/psu-capbanks/1.0/capbanks.kicad_pcb

## KiCad design pcbs/_final_proto/psu-capbanks/1.0/capbanks.kicad_pcb (2025-11-16)

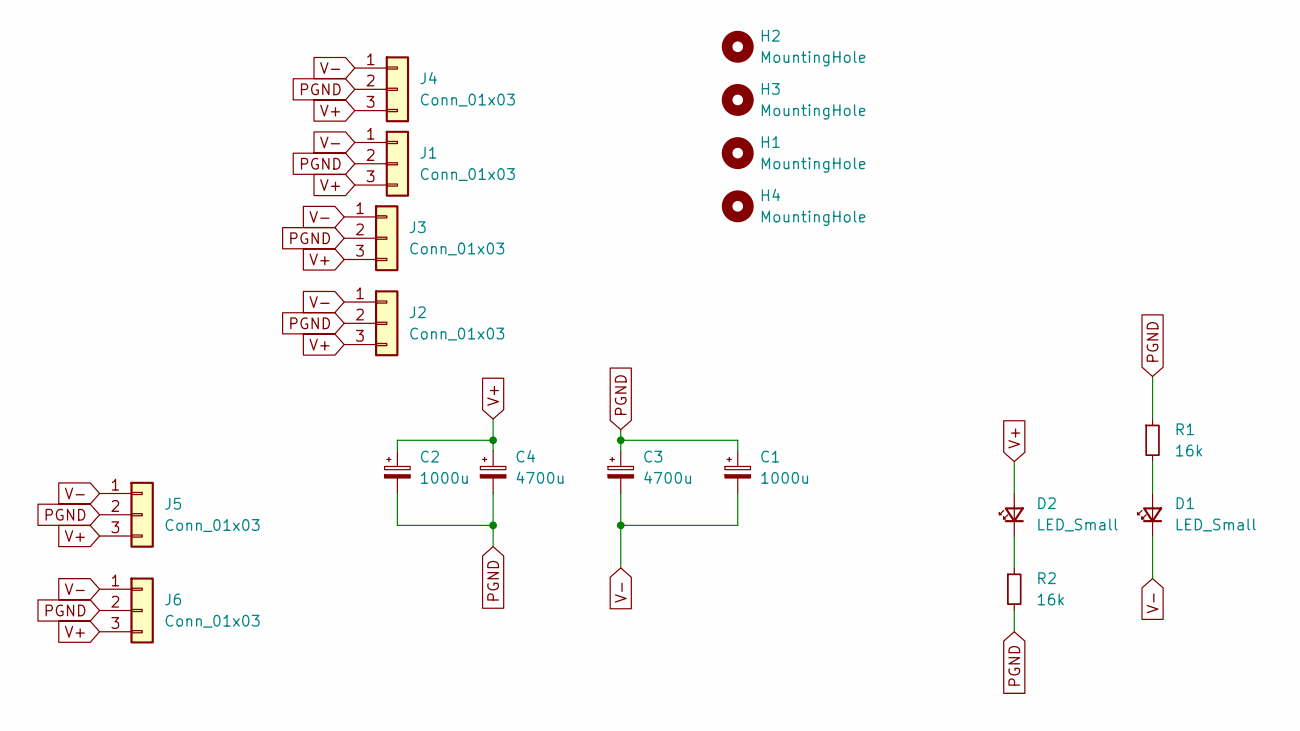
[picture p184: schematic capbanks.kicad_sch]

Parts:
C1, C2: 1000u; CP_Radial_D12.5mm_P5.00mm
C3, C4: 4700u; CP_Radial_D18.0mm_P7.50mm
D1, D2: LED_Small; LED_0805_2012Metric_Pad_HandSolder_Duane
H1, H2, H3, H4: MountingHole; MountingHole_3.2mm_M3_DIN965_Pad_TopBottom
J1, J2, J3, J4, J5, J6: Conn_01x03; TerminalBlock_Phoenix_PT-1,5-3-3.5-H_1x03_P3.50mm_Horizontal
R1, R2: 16k; R_0805_2012Metric_Pad1.20x1.40mm_HandSolder_Duane

Connections:
unnamed: D1.2 (A), R1.2
unnamed: D2.1 (K), R2.1
PGND: C1.1, C2.2, C3.1, C4.2, J1.2, J2.2, J3.2, J4.2, J5.2, J6.2, R1.1, R2.2
V+: C2.1, C4.1, D2.2 (A), J1.3, J2.3, J3.3, J4.3, J5.3, J6.3
V-: C1.2, C3.2, D1.1 (K), J1.1, J2.1, J3.1, J4.1, J5.1, J6.1

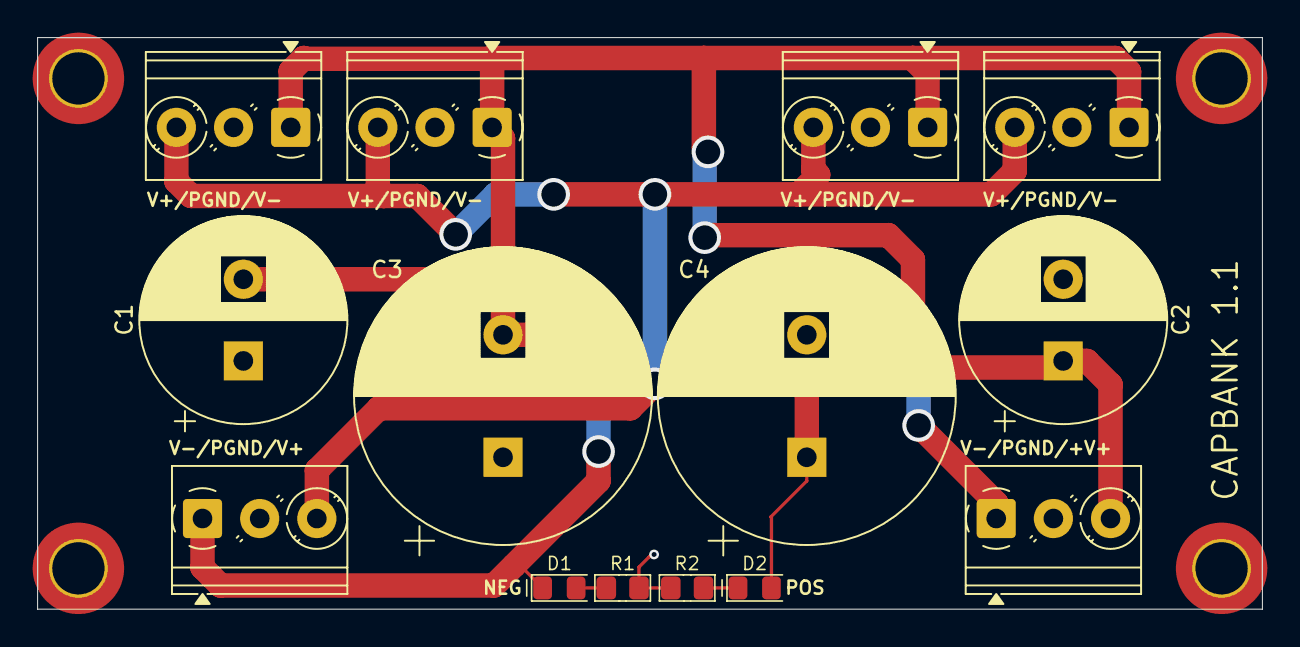
[picture p185: board pcbs/_final_proto/psu-capbanks/1.0/capbanks.kicad_pcb from above]

Board: 2 copper layers, 75.0 x 35.0 mm, 18 parts (0 on the bottom side), 5 nets.
