duanestorey/hifi-amp/pcbs/_final_proto/_archived/psu_analog_digital/rectifier.kicad_pcb

## KiCad design pcbs/_final_proto/_archived/psu_analog_digital/rectifier.kicad_pcb (2025-11-16, an earlier design)

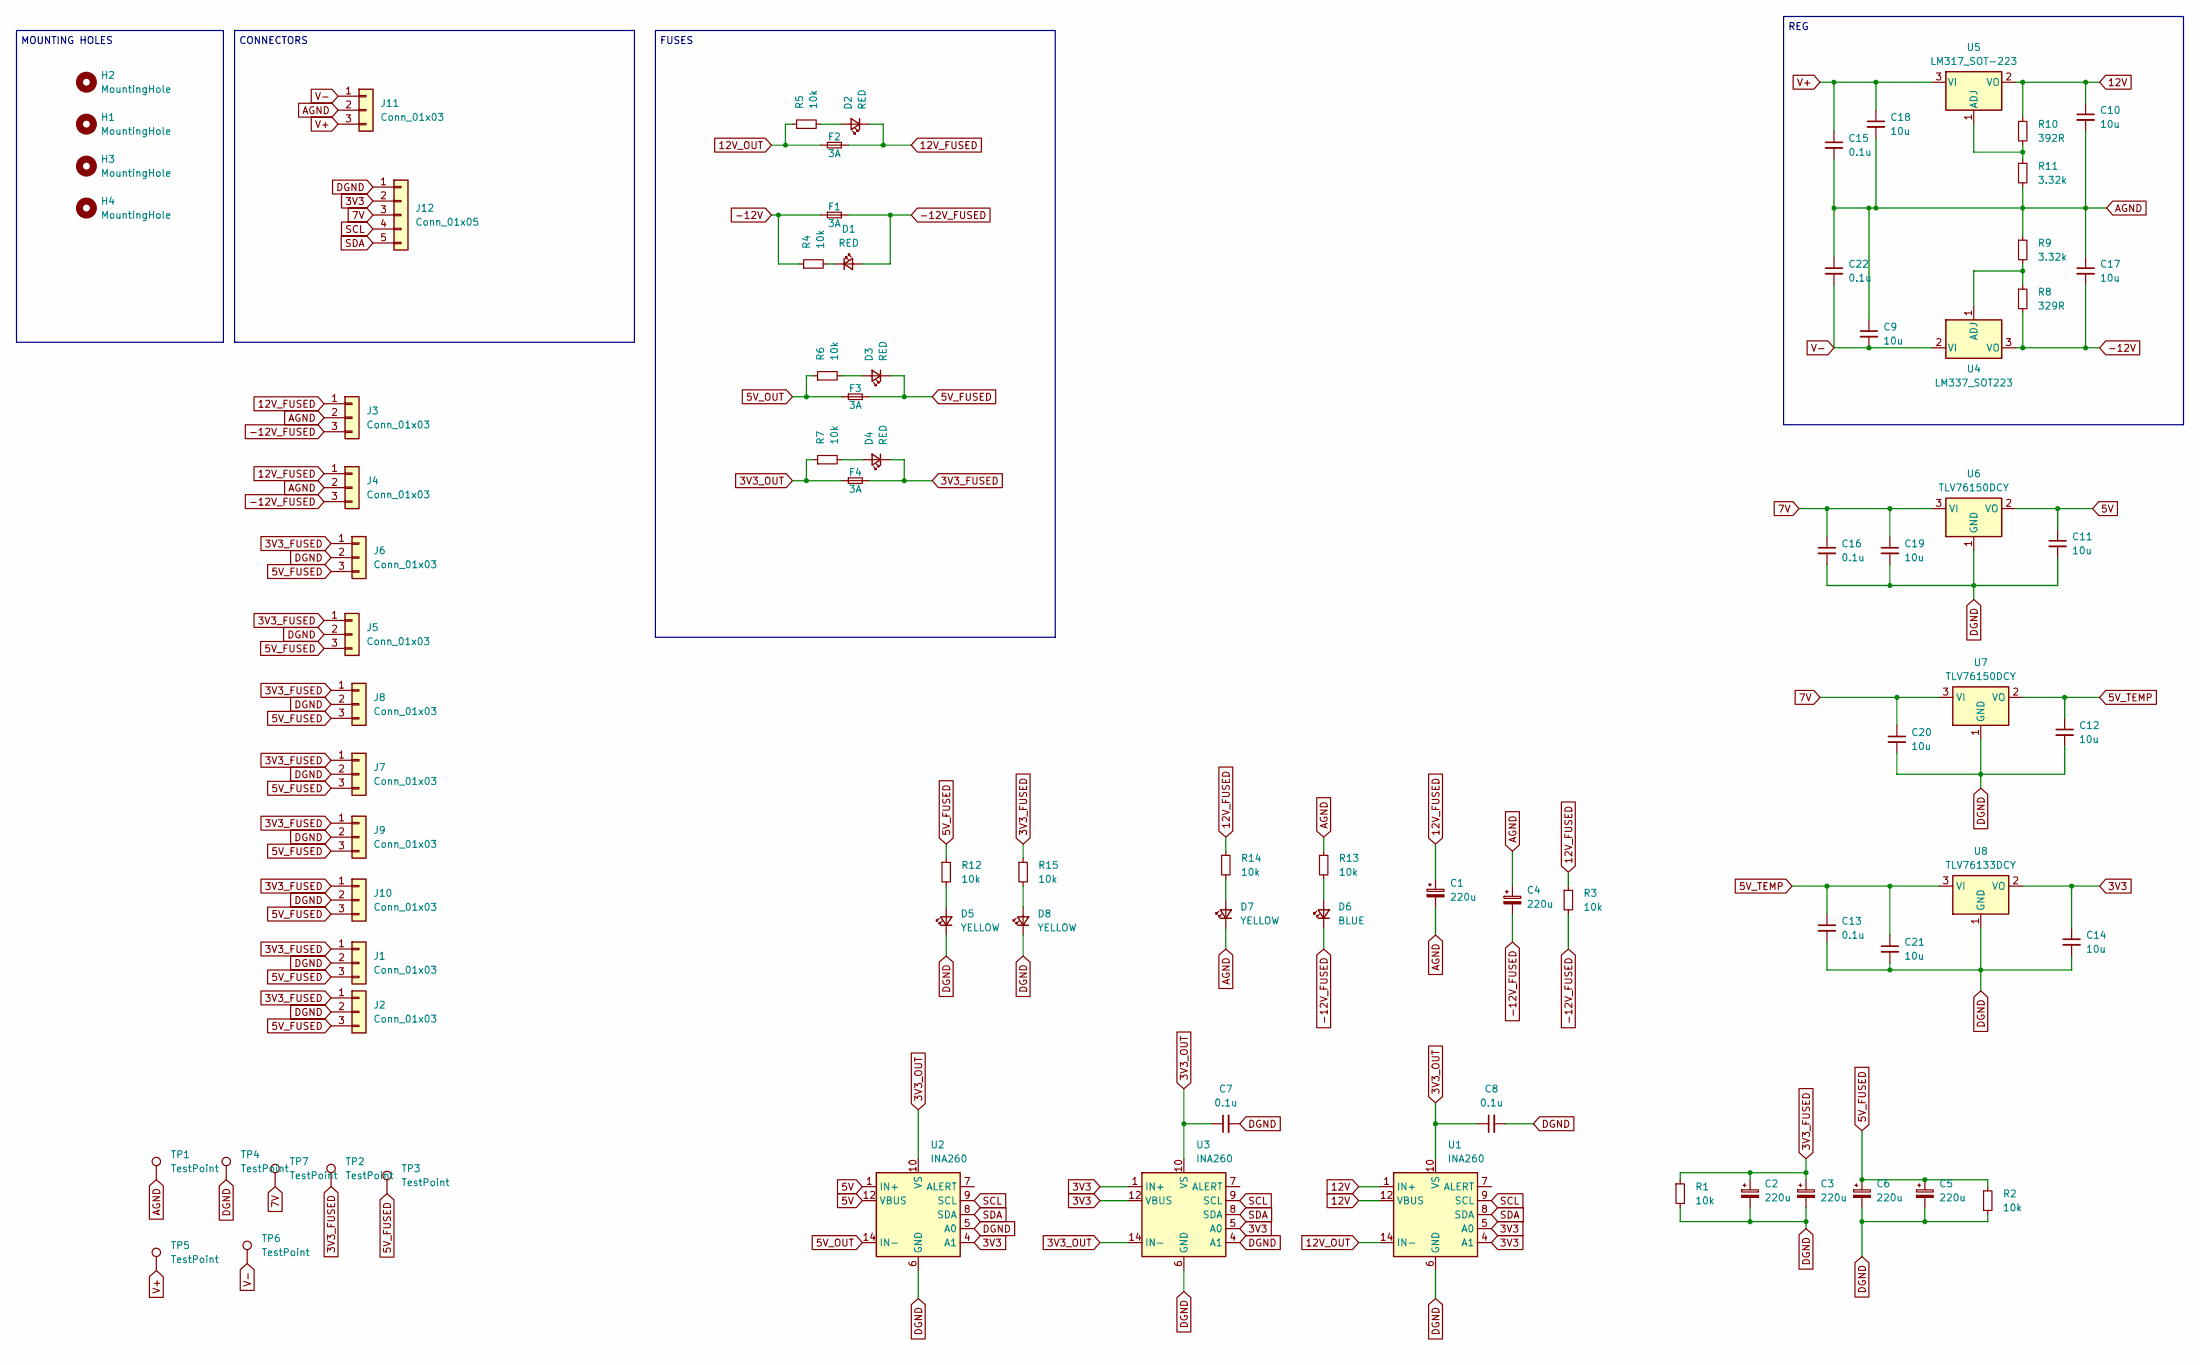
[picture p186: schematic rectifier.kicad_sch]

Parts:
C1, C2, C3, C4, C5, C6: 220u; CP_Radial_D6.3mm_P2.50mm
C7, C8, C13, C15, C16, C22: 0.1u; C_0805_2012Metric_Pad1.18x1.45mm_HandSolder
C9, C10, C11, C12, C14, C17, C18, C19, C20, C21: 10u; C_1206_3216Metric_Pad1.33x1.80mm_HandSolder
D1, D2, D3, D4: RED; LED_0805_2012Metric_Pad1.15x1.40mm_HandSolder
D5, D7, D8: YELLOW; LED_0805_2012Metric_Pad1.15x1.40mm_HandSolder
D6: BLUE; LED_0805_2012Metric_Pad1.15x1.40mm_HandSolder
F1, F2, F3, F4: 3A; Fuse_1812_AliExpress
H1, H2, H3, H4: MountingHole; MountingHole_3.2mm_M3_DIN965_Pad_TopBottom
J1, J2, J3, J4, J5, J6, J7, J8, J9, J10, J11: Conn_01x03; JST_PH_B3B-PH-K_1x03_P2.00mm_Vertical
J12: Conn_01x05; JST_PH_B5B-PH-K_1x05_P2.00mm_Vertical
R1, R2, R3, R4, R5, R6, R7, R12, R13, R14, R15: 10k; R_0805_2012Metric_Pad1.20x1.40mm_HandSolder; Mouser 603-SR2512JK-7W10RL
R8: 329R; R_0805_2012Metric_Pad1.20x1.40mm_HandSolder; Mouser 652-CR0805FX-3920ELF
R9, R11: 3.32k; R_0805_2012Metric_Pad1.20x1.40mm_HandSolder; Mouser AC0805FR-073K32L
R10: 392R; R_0805_2012Metric_Pad1.20x1.40mm_HandSolder; Mouser 652-CR0805FX-3920ELF
TP1, TP2, TP3, TP4, TP5, TP6, TP7: TestPoint; TestPoint_THTPad_1.5x1.5mm_Drill0.7mm
U1, U2, U3: INA260; TSSOP-16_4.4x5mm_P0.65mm
U4: LM337_SOT223; SOT-223-3_TabPin2
U5: LM317_SOT-223; SOT-223-3_TabPin2
U6, U7: TLV76150DCY; SOT-223-3_TabPin2
U8: TLV76133DCY; SOT-223-3_TabPin2

Connections:
3V3: C14.1, J12.2, U1.4 (A1), U1.5 (A0), U2.4 (A1), U3.1 (IN+), U3.2 (IN+), U3.3 (IN+), U3.5 (A0), U3.12 (VBUS), U8.2 (VO)
3V3_FUSED: C2.1, C3.1, D4.1 (K), F4.2, J1.1, J2.1, J5.1, J6.1, J7.1, J8.1, J9.1, J10.1, R1.1, R15.1, TP2.1
3V3_OUT: C7.1, C8.1, F4.1, R7.1, U1.10 (VS), U2.10 (VS), U3.10 (VS), U3.14 (IN-), U3.15 (IN-), U3.16 (IN-)
5V: C11.1, U2.1 (IN+), U2.2 (IN+), U2.3 (IN+), U2.12 (VBUS), U6.2 (VO)
5V_FUSED: C5.1, C6.1, D3.1 (K), F3.2, J1.3, J2.3, J5.3, J6.3, J7.3, J8.3, J9.3, J10.3, R2.1, R12.1, TP3.1
5V_OUT: F3.1, R6.1, U2.14 (IN-), U2.15 (IN-), U2.16 (IN-)
5V_TEMP: C12.1, C13.1, C21.1, U7.2 (VO), U8.3 (VI)
7V: C16.1, C19.1, C20.1, J12.3, TP7.1, U6.3 (VI), U7.3 (VI)
12V: C10.1, R10.1, U1.1 (IN+), U1.2 (IN+), U1.3 (IN+), U1.12 (VBUS), U5.2 (VO)
12V_FUSED: C1.1, D2.1 (K), F2.2, J3.1, J4.1, R3.1, R14.1
12V_OUT: F2.1, R5.1, U1.14 (IN-), U1.15 (IN-), U1.16 (IN-)
-12V: C17.2, F1.1, R4.1, R8.2, U4.3 (VO)
-12V_FUSED: C4.2, D1.2 (A), D6.1 (K), F1.2, J3.3, J4.3, R3.2
AGND: C1.2, C4.1, C9.1, C10.2, C15.2, C17.1, C18.2, C22.1, D7.1 (K), J3.2, J4.2, J11.2, R9.1, R11.2, R13.1, TP1.1
DGND: C2.2, C3.2, C5.2, C6.2, C7.2, C8.2, C11.2, C12.2, C13.2, C14.2, C16.2, C19.2, C20.2, C21.2, D5.1 (K), D8.1 (K), J1.2, J2.2, J5.2, J6.2, J7.2, J8.2, J9.2, J10.2, J12.1, R1.2, R2.2, TP4.1, U1.6 (GND), U1.11 (GND), U2.5 (A0), U2.6 (GND), U2.11 (GND), U3.4 (A1), U3.6 (GND), U3.11 (GND), U6.1 (GND), U7.1 (GND), U8.1 (GND)
unnamed: D1.1 (K), R4.2
unnamed: D2.2 (A), R5.2
unnamed: D3.2 (A), R6.2
unnamed: D4.2 (A), R7.2
unnamed: D5.2 (A), R12.2
unnamed: D6.2 (A), R13.2
unnamed: D7.2 (A), R14.2
unnamed: D8.2 (A), R15.2
unnamed: R8.1, R9.2, U4.1 (ADJ)
unnamed: R10.2, R11.1, U5.1 (ADJ)
SCL: J12.4, U1.9 (SCL), U2.9 (SCL), U3.9 (SCL)
SDA: J12.5, U1.8 (SDA), U2.8 (SDA), U3.8 (SDA)
V+: C15.1, C18.1, J11.3, TP5.1, U5.3 (VI)
V-: C9.2, C22.2, J11.1, TP6.1, U4.2 (VI)

Notes on the sheet:
MOUNTING HOLES
REG
CONNECTORS
FUSES

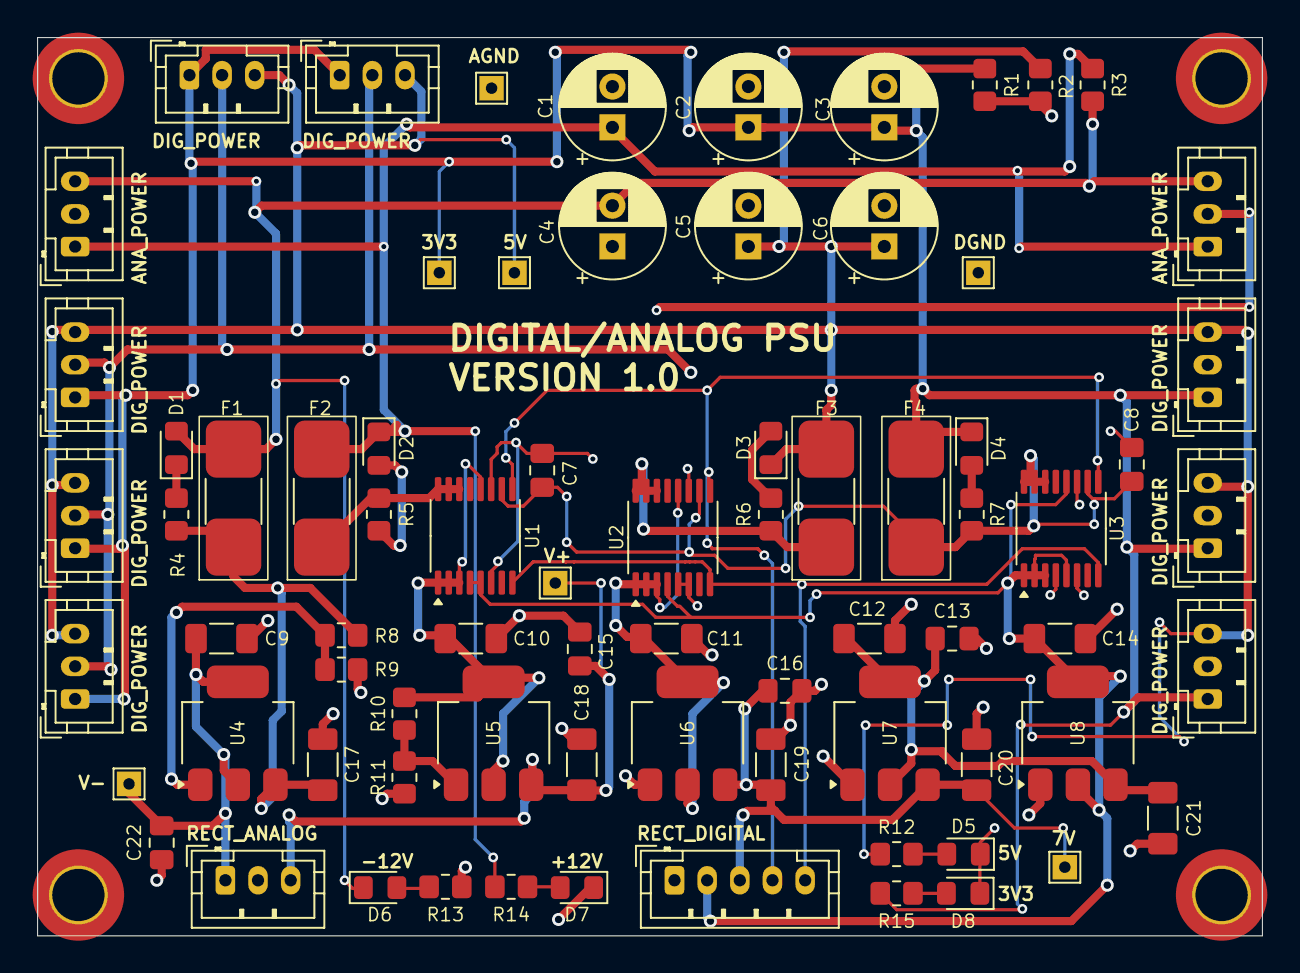
[picture p187: board pcbs/_final_proto/_archived/psu_analog_digital/rectifier.kicad_pcb from above]

Board: 2 copper layers, 75.0 x 55.0 mm, 80 parts (0 on the bottom side), 29 nets.
