duanestorey/hifi-amp/pcbs/_final_proto/psu-analog-digital/1.2/psu.kicad_pcb

## KiCad design pcbs/_final_proto/psu-analog-digital/1.2/psu.kicad_pcb (2025-11-16)

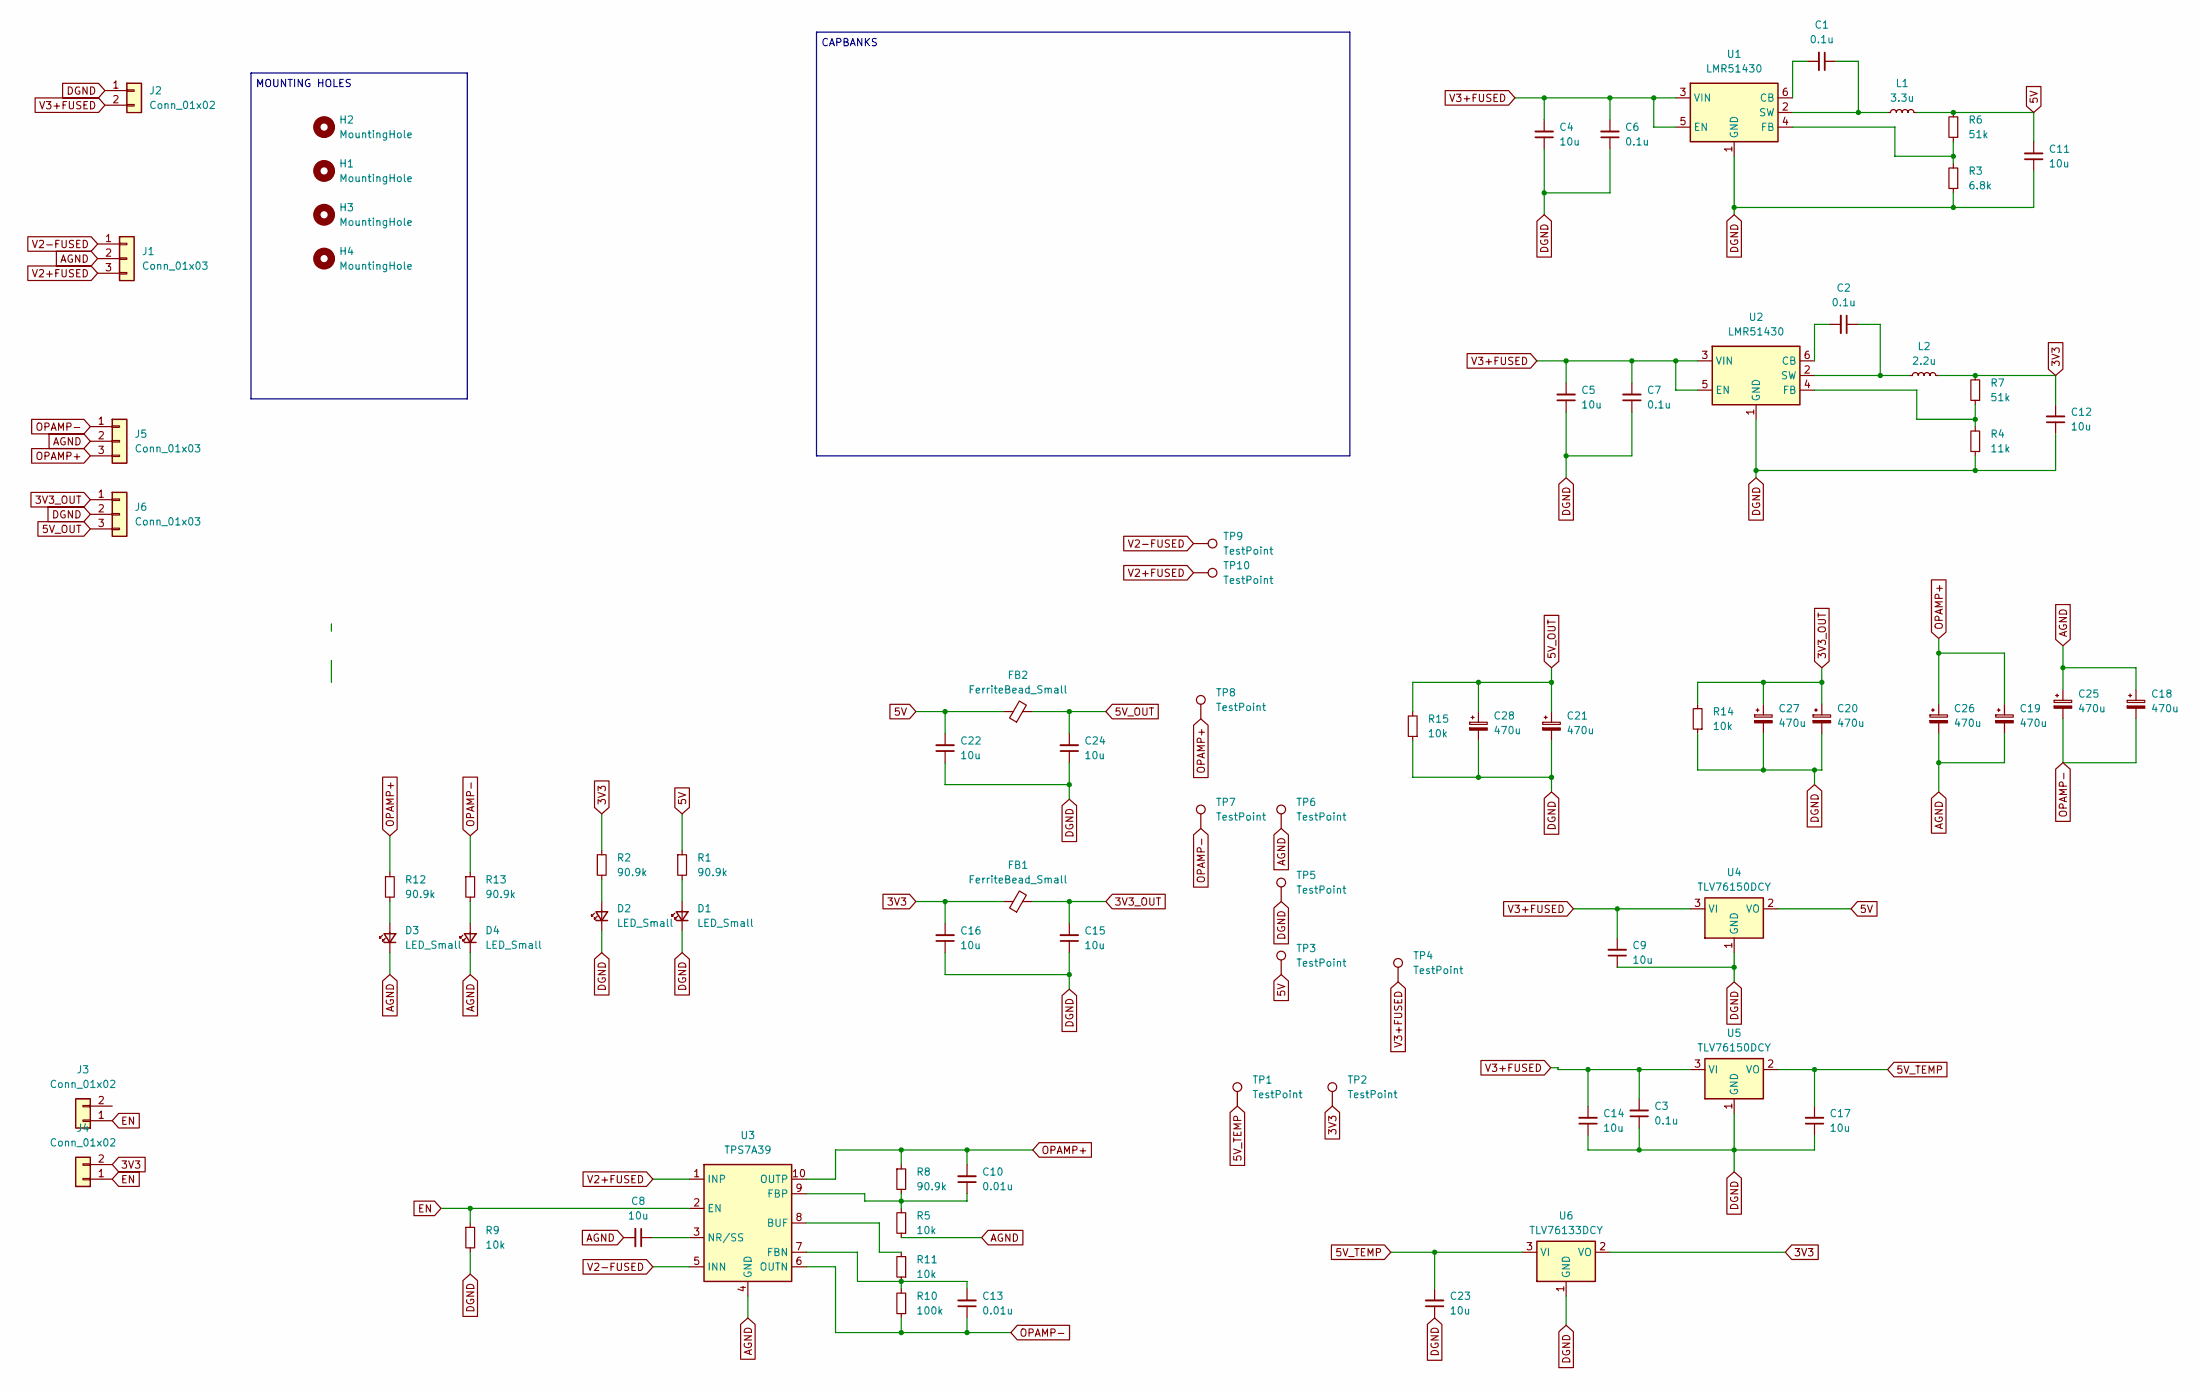
[picture p188: schematic psu.kicad_sch]

Parts:
C1, C2, C3, C6, C7: 0.1u; C_0805_2012Metric_Pad1.18x1.45mm_HandSolder_Duane
C4, C5, C8, C9, C11, C12, C14, C15, C16, C17, C22, C23, C24: 10u; C_1206_3216Metric_Pad1.33x1.80mm_HandSolder_Duane
C10, C13: 0.01u; C_0805_2012Metric_Pad1.18x1.45mm_HandSolder_Duane
C18, C19, C20, C21, C25, C26, C27, C28: 470u; CP_Elec_6.3x7.7
D1, D2, D3, D4: LED_Small; LED_0805_2012Metric_Pad_HandSolder_Duane
FB1, FB2: FerriteBead_Small; R_0805_2012Metric_Pad1.20x1.40mm_HandSolder_Duane
H1, H2, H3, H4: MountingHole; MountingHole_3.2mm_M3_DIN965_Pad_TopBottom
J1, J5, J6: Conn_01x03; JST_VH_B3P-VH-B_1x03_P3.96mm_Vertical_Duane
J2: Conn_01x02; JST_VH_B2P-VH-B_1x02_P3.96mm_Vertical_Duane
J3: Conn_01x02; JST_PH_B2B-PH-K_1x02_P2.00mm_Vertical
J4: Conn_01x02; PinHeader_1x02_P2.54mm_Vertical
L1: 3.3u; L_Wuerth_HCI-7030
L2: 2.2u; L_Wuerth_HCI-7030
R1, R2, R8, R12, R13: 90.9k; R_0805_2012Metric_Pad1.20x1.40mm_HandSolder_Duane
R3: 6.8k; R_0805_2012Metric_Pad1.20x1.40mm_HandSolder_Duane
R4: 11k; R_0805_2012Metric_Pad1.20x1.40mm_HandSolder_Duane
R5, R9, R11, R14, R15: 10k; R_0805_2012Metric_Pad1.20x1.40mm_HandSolder_Duane
R6, R7: 51k; R_0805_2012Metric_Pad1.20x1.40mm_HandSolder_Duane
R10: 100k; R_0805_2012Metric_Pad1.20x1.40mm_HandSolder_Duane
TP1, TP2, TP3, TP4, TP5, TP6, TP7, TP8, TP9, TP10: TestPoint; TestPoint_THTPad_2.5x2.5mm_Drill1.2mm
U1, U2: LMR51430; SOT-23-6
U3: TPS7A39; Texas_S-PVSON-N10_ThermalVias
U4, U5: TLV76150DCY; SOT-223-3_TabPin2
U6: TLV76133DCY; SOT-223-3_TabPin2

Connections:
3V3: C12.2, C16.2, FB1.1, J4.2, L2.2, R2.1, R7.2, TP2.1, U6.2 (VO)
3V3_OUT: C15.2, C20.1, C27.1, FB1.2, J6.1, R14.2
5V: C11.2, C22.2, FB2.1, L1.2, R1.1, R6.2, TP3.1, U4.2 (VO)
5V_OUT: C21.1, C24.2, C28.1, FB2.2, J6.3, R15.2
5V_TEMP: C17.2, C23.2, TP1.1, U5.2 (VO), U6.3 (VI)
AGND: C8.2, C18.1, C19.2, C25.1, C26.2, D3.1 (K), D4.1 (K), J1.2, J5.2, R5.1, TP6.1, U3.4 (GND), U3.11 (GND)
DGND: C3.1, C4.1, C5.1, C6.1, C7.1, C9.1, C11.1, C12.1, C14.1, C15.1, C16.1, C17.1, C20.2, C21.2, C22.1, C23.1, C24.1, C27.2, C28.2, D1.1 (K), D2.1 (K), J2.1, J6.2, R3.1, R4.1, R9.2, R14.1, R15.1, TP5.1, U1.1 (GND), U2.1 (GND), U4.1 (GND), U5.1 (GND), U6.1 (GND)
EN: J3.1, J4.1, R9.1, U3.2 (EN)
unnamed: D1.2 (A), R1.2
unnamed: D2.2 (A), R2.2
unnamed: D3.2 (A), R12.2
unnamed: D4.2 (A), R13.2
unnamed: C1.2, U1.6 (CB)
unnamed: R3.2, R6.1, U1.4 (FB)
unnamed: C1.1, L1.1, U1.2 (SW)
unnamed: C2.2, U2.6 (CB)
unnamed: R4.2, R7.1, U2.4 (FB)
unnamed: C2.1, L2.1, U2.2 (SW)
unnamed: R11.2, U3.8 (BUF)
unnamed: C13.2, R10.2, R11.1, U3.7 (FBN)
unnamed: C10.1, R5.2, R8.2, U3.9 (FBP)
unnamed: C8.1, U3.3 (NR/SS)
OPAMP+: C10.2, C19.1, C26.1, J5.3, R8.1, R12.1, TP8.1, U3.10 (OUTP)
OPAMP-: C13.1, C18.2, C25.2, J5.1, R10.1, R13.1, TP7.1, U3.6 (OUTN)
V2+FUSED: J1.3, TP10.1, U3.1 (INP)
V2-FUSED: J1.1, TP9.1, U3.5 (INN)
V3+FUSED: C3.2, C4.2, C5.2, C6.2, C7.2, C9.2, C14.2, J2.2, TP4.1, U1.3 (VIN), U1.5 (EN), U2.3 (VIN), U2.5 (EN), U4.3 (VI), U5.3 (VI)

Notes on the sheet:
MOUNTING HOLES
CAPBANKS

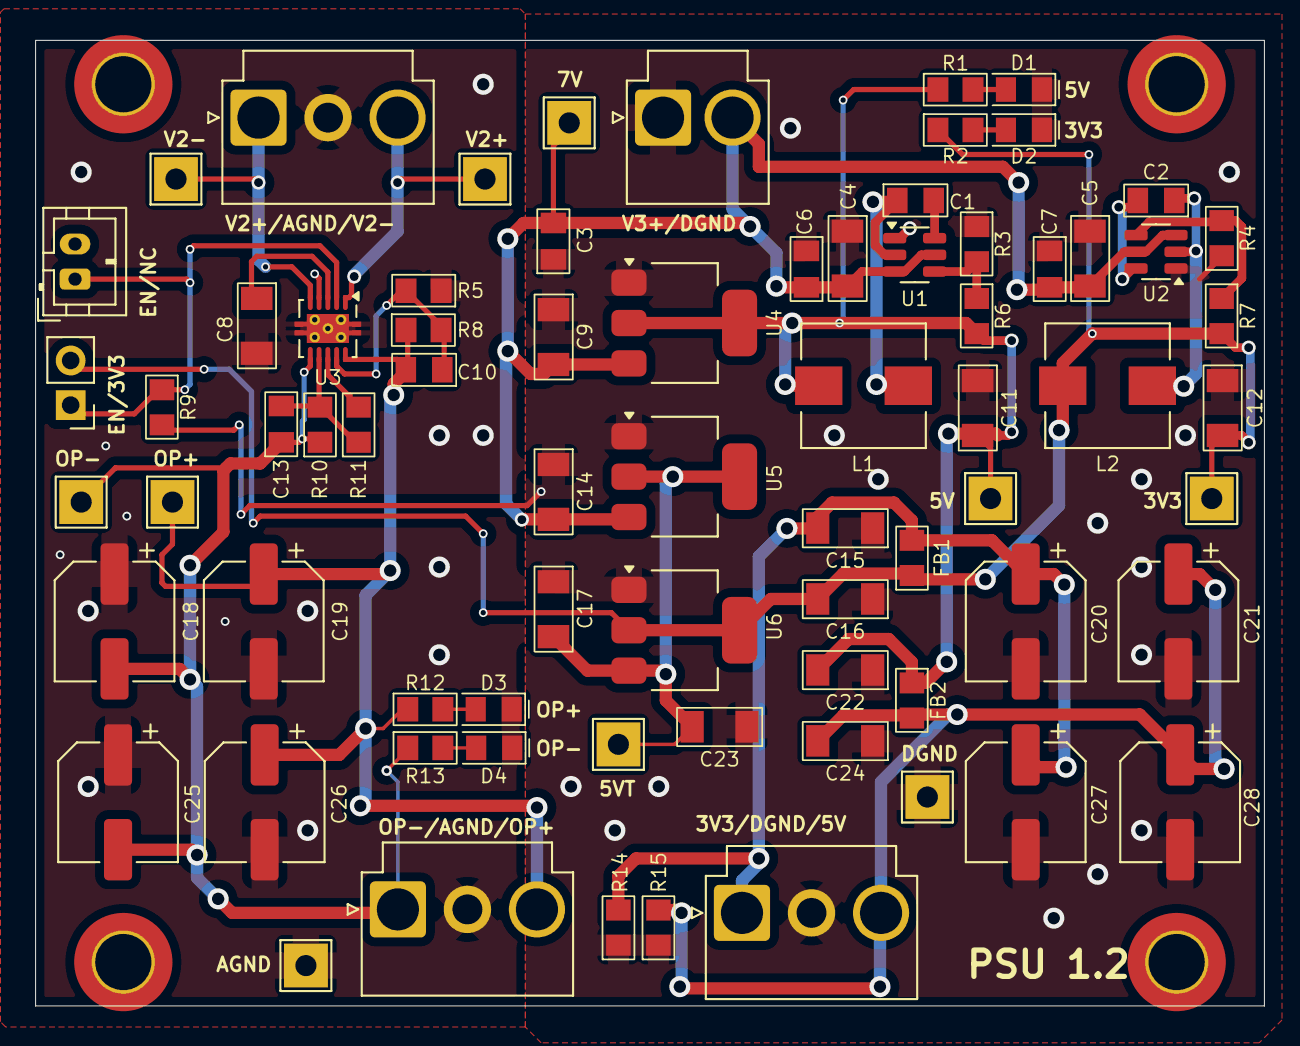
[picture p189: board psu.kicad_pcb from above]

Board: 2 copper layers, 70.0 x 55.0 mm, 77 parts (0 on the bottom side), 27 nets.
