duanestorey/hifi-amp/pcbs/_final_proto/dac-pcm5142/1.0-dual/dac.kicad_pcb

## KiCad design pcbs/_final_proto/dac-pcm5142/1.0-dual/dac.kicad_pcb (2025-11-16)

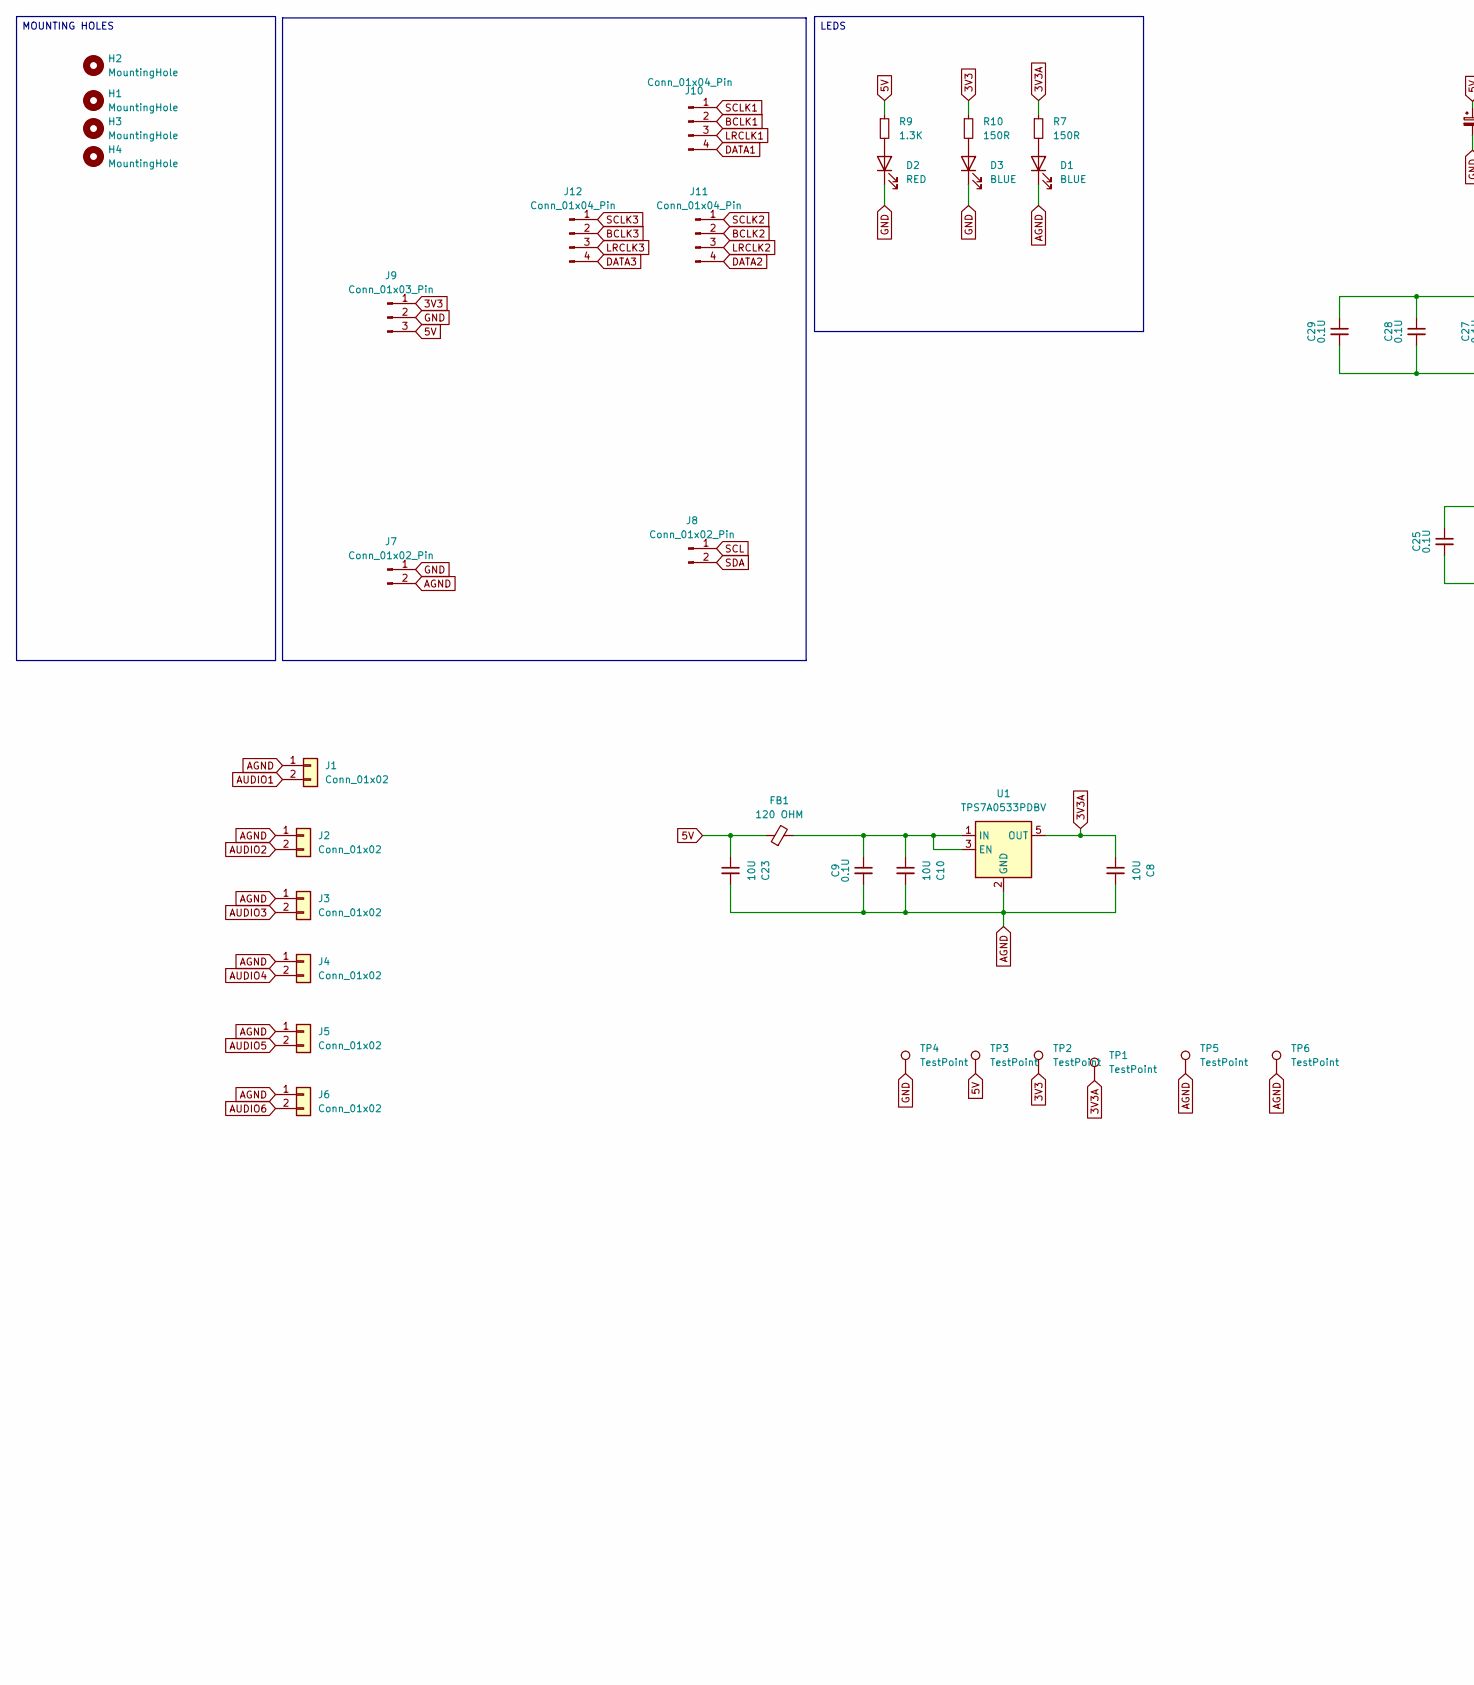
[picture p190: schematic dac.kicad_sch, part in row 1, column 1]

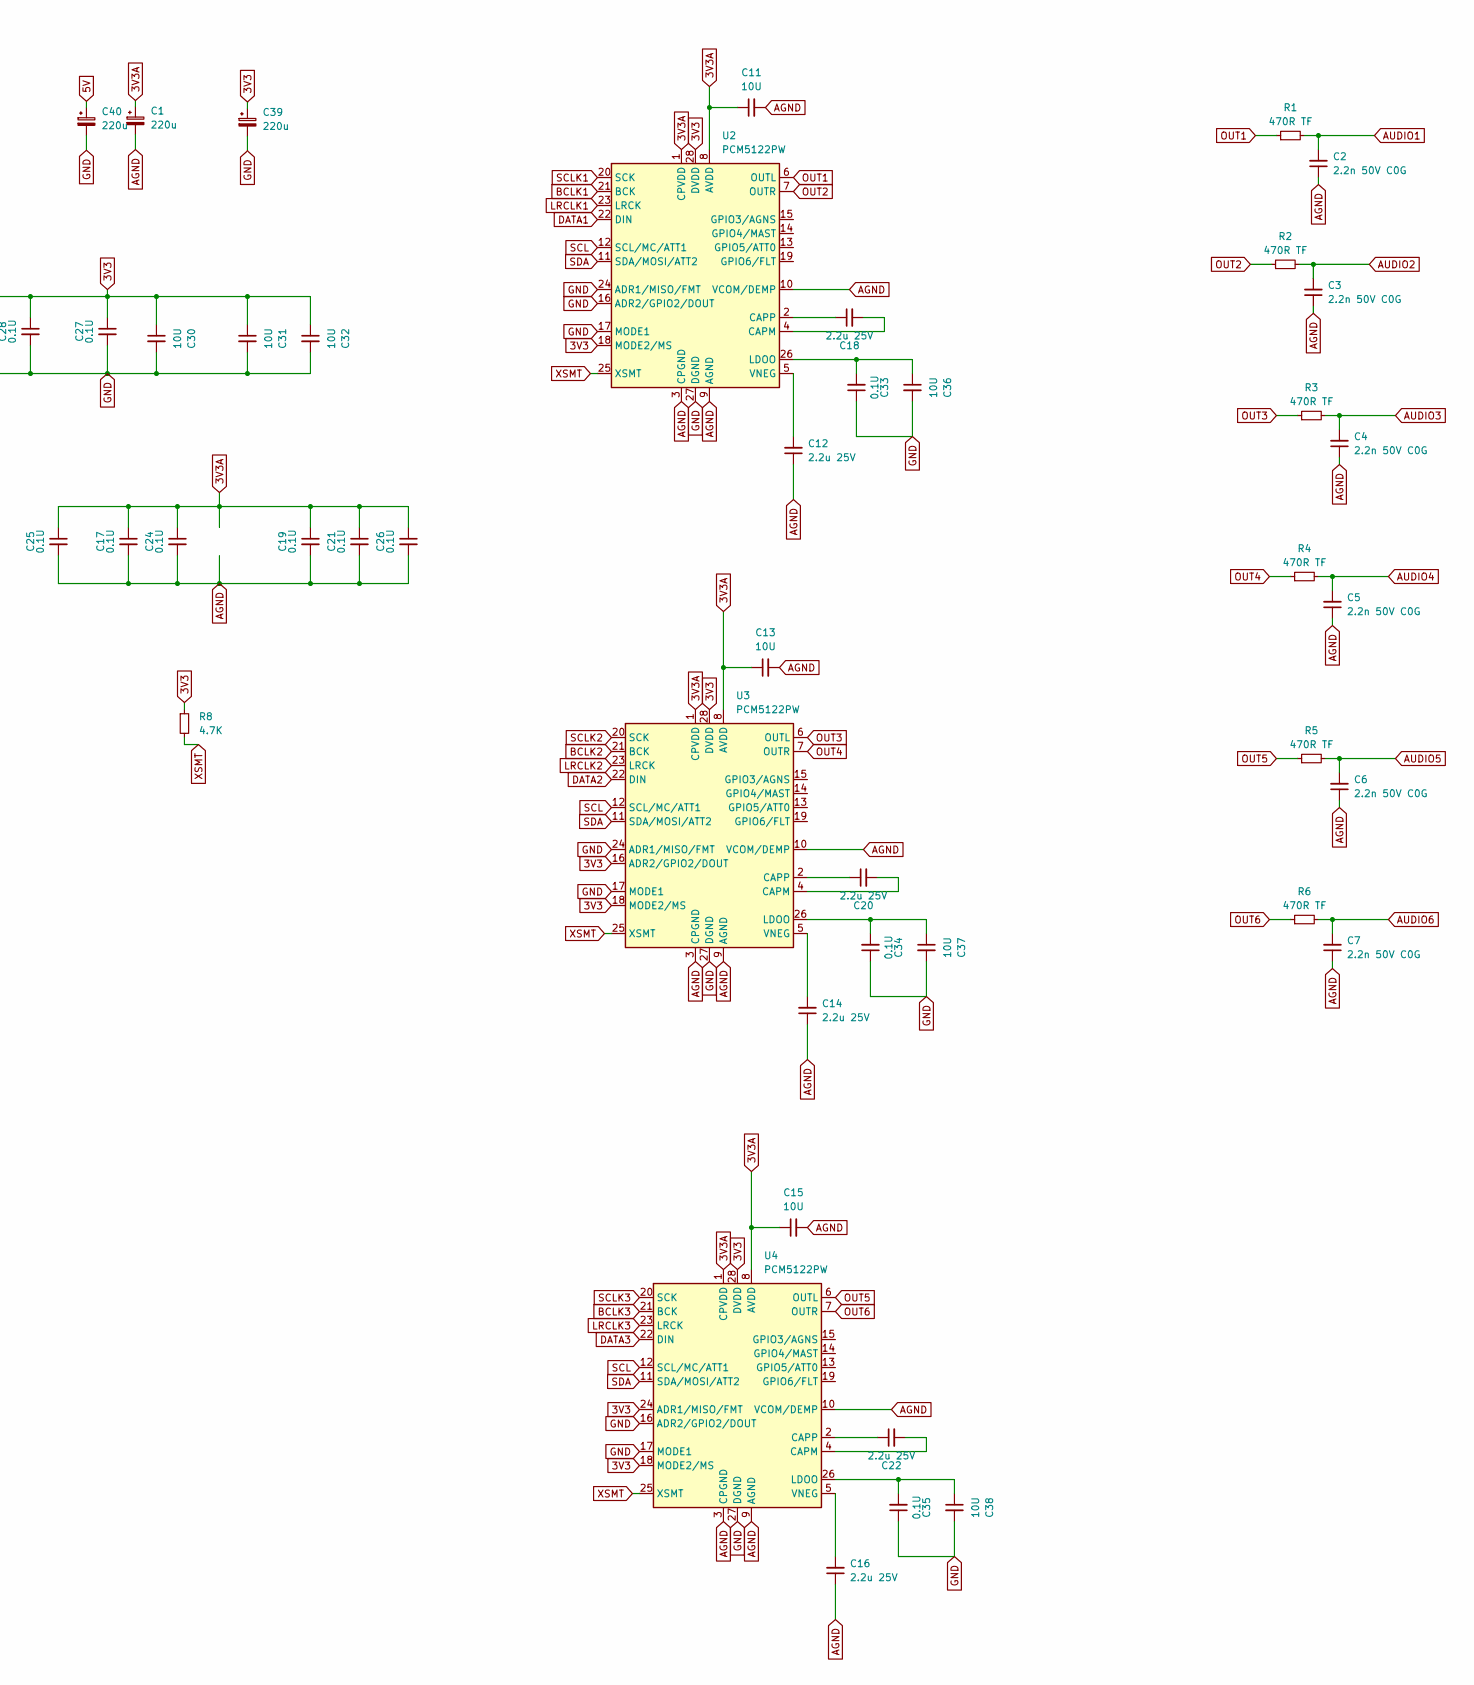
[picture p191: schematic dac.kicad_sch, part in row 1, column 2]

Parts:
C1, C39, C40: 220u; CP_Elec_6.3x7.7
C2, C3, C4, C5, C6, C7: 2.2n 50V C0G; C_0805_2012Metric_Pad1.18x1.45mm_HandSolder; Mouser 791-0805N222G500CT
C8, C10, C11, C13, C15, C23, C30, C31, C32, C36, C37, C38: 10U; C_1206_3216Metric_Pad1.33x1.80mm_HandSolder
C9, C17, C19, C21, C24, C25, C26, C27, C28, C29, C33, C34, C35: 0.1U; C_0805_2012Metric_Pad1.18x1.45mm_HandSolder
C12, C14, C16, C18, C20, C22: 2.2u 25V; C_1206_3216Metric_Pad1.33x1.80mm_HandSolder; Mouser 603-CC1206JKX78BB225
D1, D3: BLUE; LED_0805_2012Metric_Pad1.15x1.40mm_HandSolder
D2: RED; LED_0805_2012Metric_Pad1.15x1.40mm_HandSolder
FB1: 120 OHM; R_0603_1608Metric_Pad0.98x0.95mm_HandSolder
H1, H2, H3, H4: MountingHole; MountingHole_3.2mm_M3_DIN965_Pad_TopOnly
J1, J2, J3, J4, J5, J6: Conn_01x02; TerminalBlock_Phoenix_PT-1,5-2-3.5-H_1x02_P3.50mm_Horizontal
J7: Conn_01x02_Pin; PinHeader_1x02_P2.54mm_Vertical
J8: Conn_01x02_Pin; JST_PH_B2B-PH-K_1x02_P2.00mm_Vertical
J9: Conn_01x03_Pin; JST_PH_B3B-PH-K_1x03_P2.00mm_Vertical
J10, J11, J12: Conn_01x04_Pin; JST_PH_B4B-PH-K_1x04_P2.00mm_Vertical
R1, R2, R3, R4, R5, R6: 470R TF; R_0805_2012Metric_Pad1.20x1.40mm_HandSolder; Mouser 603-RT0805FRE07470RL
R7, R10: 150R; R_0805_2012Metric_Pad1.20x1.40mm_HandSolder
R8: 4.7K; R_0805_2012Metric_Pad1.20x1.40mm_HandSolder
R9: 1.3K; R_0805_2012Metric_Pad1.20x1.40mm_HandSolder
TP1, TP2, TP3, TP4, TP5, TP6: TestPoint; TestPoint_THTPad_1.5x1.5mm_Drill0.7mm
U1: TPS7A0533PDBV; SOT-23-5
U2, U3, U4: PCM5122PW; TSSOP-28_4.4x9.7mm_P0.65mm; Mouser 595-PCM5122PWR

Connections:
3V3: C27.1, C28.1, C29.1, C30.1, C31.1, C32.1, C39.1, J9.1, R8.1, R10.1, TP2.1, U2.18 (MODE2/MS), U2.28 (DVDD), U3.16 (ADR2/GPIO2/DOUT), U3.18 (MODE2/MS), U3.28 (DVDD), U4.18 (MODE2/MS), U4.24 (ADR1/MISO/FMT), U4.28 (DVDD)
3V3A: C1.1, C8.1, C11.1, C13.1, C15.1, C17.1, C19.1, C21.1, C24.1, C25.1, C26.1, R7.1, TP1.1, U1.5 (OUT), U2.1 (CPVDD), U2.8 (AVDD), U3.1 (CPVDD), U3.8 (AVDD), U4.1 (CPVDD), U4.8 (AVDD)
5V: C23.1, C40.1, FB1.1, J9.3, R9.1, TP3.1
AGND: C1.2, C2.1, C3.1, C4.1, C5.1, C6.1, C7.1, C8.2, C9.2, C10.2, C11.2, C12.1, C13.2, C14.1, C15.2, C16.1, C17.2, C19.2, C21.2, C23.2, C24.2, C25.2, C26.2, D1.1 (K), J1.1, J2.1, J3.1, J4.1, J5.1, J6.1, J7.2, TP5.1, TP6.1, U1.2 (GND), U2.3 (CPGND), U2.9 (AGND), U2.10 (VCOM/DEMP), U3.3 (CPGND), U3.9 (AGND), U3.10 (VCOM/DEMP), U4.3 (CPGND), U4.9 (AGND), U4.10 (VCOM/DEMP)
AUDIO1: C2.2, J1.2, R1.2
AUDIO2: C3.2, J2.2, R2.2
AUDIO3: C4.2, J3.2, R3.2
AUDIO4: C5.2, J4.2, R4.2
AUDIO5: C6.2, J5.2, R5.2
AUDIO6: C7.2, J6.2, R6.2
BCLK1: J10.2, U2.21 (BCK)
BCLK2: J11.2, U3.21 (BCK)
BCLK3: J12.2, U4.21 (BCK)
DATA1: J10.4, U2.22 (DIN)
DATA2: J11.4, U3.22 (DIN)
DATA3: J12.4, U4.22 (DIN)
GND: C27.2, C28.2, C29.2, C30.2, C31.2, C32.2, C33.1, C34.1, C35.1, C36.2, C37.2, C38.2, C39.2, C40.2, D2.1 (K), D3.1 (K), J7.1, J9.2, TP4.1, U2.16 (ADR2/GPIO2/DOUT), U2.17 (MODE1), U2.24 (ADR1/MISO/FMT), U2.27 (DGND), U3.17 (MODE1), U3.24 (ADR1/MISO/FMT), U3.27 (DGND), U4.16 (ADR2/GPIO2/DOUT), U4.17 (MODE1), U4.27 (DGND)
LRCLK1: J10.3, U2.23 (LRCK)
LRCLK2: J11.3, U3.23 (LRCK)
LRCLK3: J12.3, U4.23 (LRCK)
unnamed: D1.2 (A), R7.2
unnamed: D2.2 (A), R9.2
unnamed: D3.2 (A), R10.2
unnamed: C9.1, C10.1, FB1.2, U1.1 (IN), U1.3 (EN)
unnamed: C18.2, U2.4 (CAPM)
unnamed: C18.1, U2.2 (CAPP)
unnamed: C33.2, C36.1, U2.26 (LDOO)
unnamed: C12.2, U2.5 (VNEG)
unnamed: C20.2, U3.4 (CAPM)
unnamed: C20.1, U3.2 (CAPP)
unnamed: C34.2, C37.1, U3.26 (LDOO)
unnamed: C14.2, U3.5 (VNEG)
unnamed: C22.2, U4.4 (CAPM)
unnamed: C22.1, U4.2 (CAPP)
unnamed: C35.2, C38.1, U4.26 (LDOO)
unnamed: C16.2, U4.5 (VNEG)
OUT1: R1.1, U2.6 (OUTL)
OUT2: R2.1, U2.7 (OUTR)
OUT3: R3.1, U3.6 (OUTL)
OUT4: R4.1, U3.7 (OUTR)
OUT5: R5.1, U4.6 (OUTL)
OUT6: R6.1, U4.7 (OUTR)
SCL: J8.1, U2.12 (SCL/MC/ATT1), U3.12 (SCL/MC/ATT1), U4.12 (SCL/MC/ATT1)
SCLK1: J10.1, U2.20 (SCK)
SCLK2: J11.1, U3.20 (SCK)
SCLK3: J12.1, U4.20 (SCK)
SDA: J8.2, U2.11 (SDA/MOSI/ATT2), U3.11 (SDA/MOSI/ATT2), U4.11 (SDA/MOSI/ATT2)
XSMT: R8.2, U2.25 (XSMT), U3.25 (XSMT), U4.25 (XSMT)

Notes on the sheet:
MOUNTING HOLES
LEDS

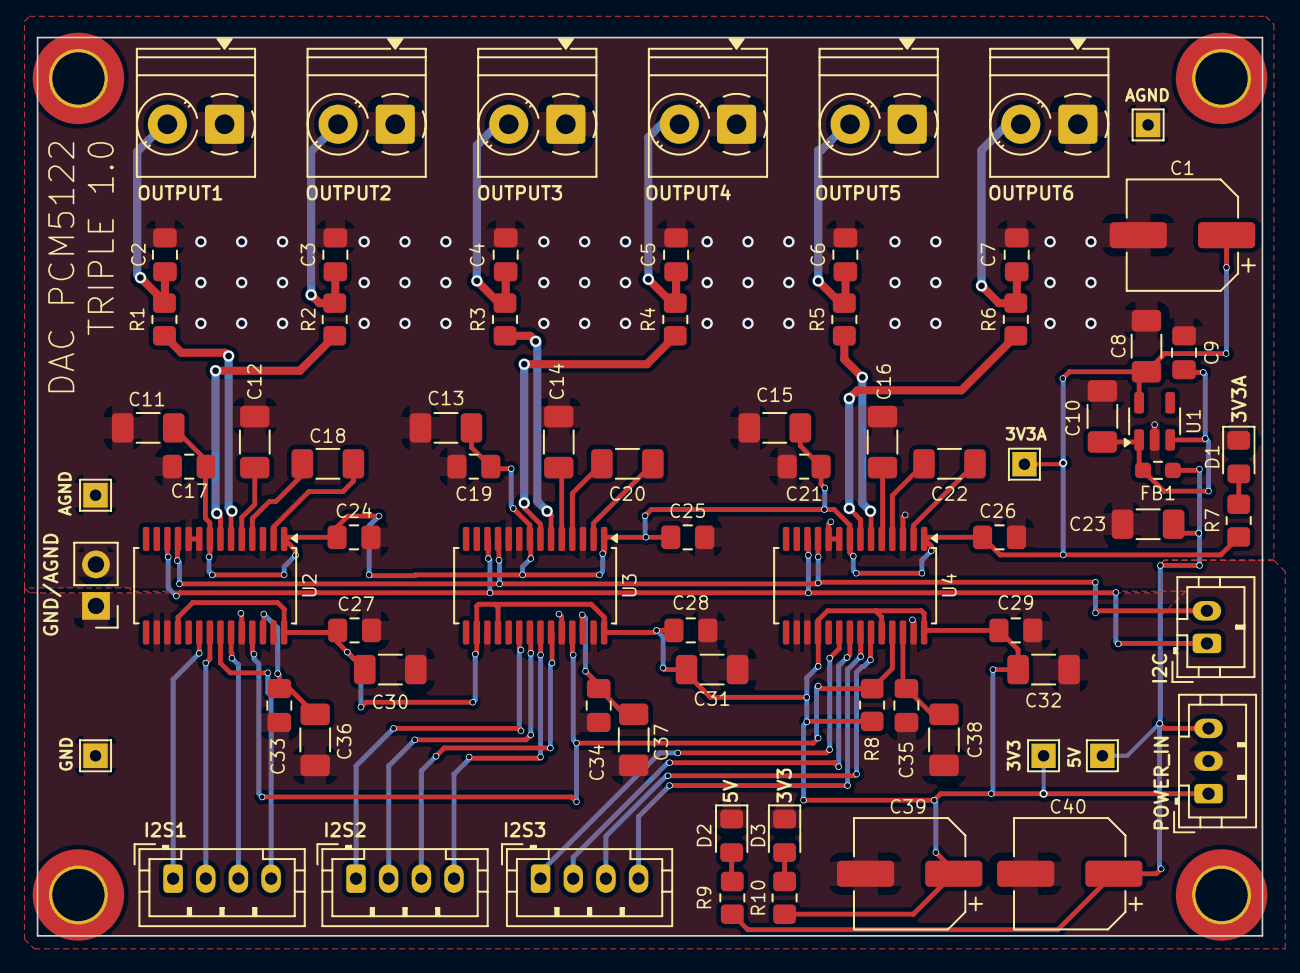
[picture p192: board pcbs/_final_proto/dac-pcm5142/1.0-dual/dac.kicad_pcb from above]

Board: 2 copper layers, 75.0 x 55.0 mm, 80 parts (0 on the bottom side), 48 nets.
