duanestorey/hifi-amp/pcbs/_final_proto/psu-rectifiers/1.1/rectifier.kicad_pcb

## KiCad design pcbs/_final_proto/psu-rectifiers/1.1/rectifier.kicad_pcb (2025-11-16)

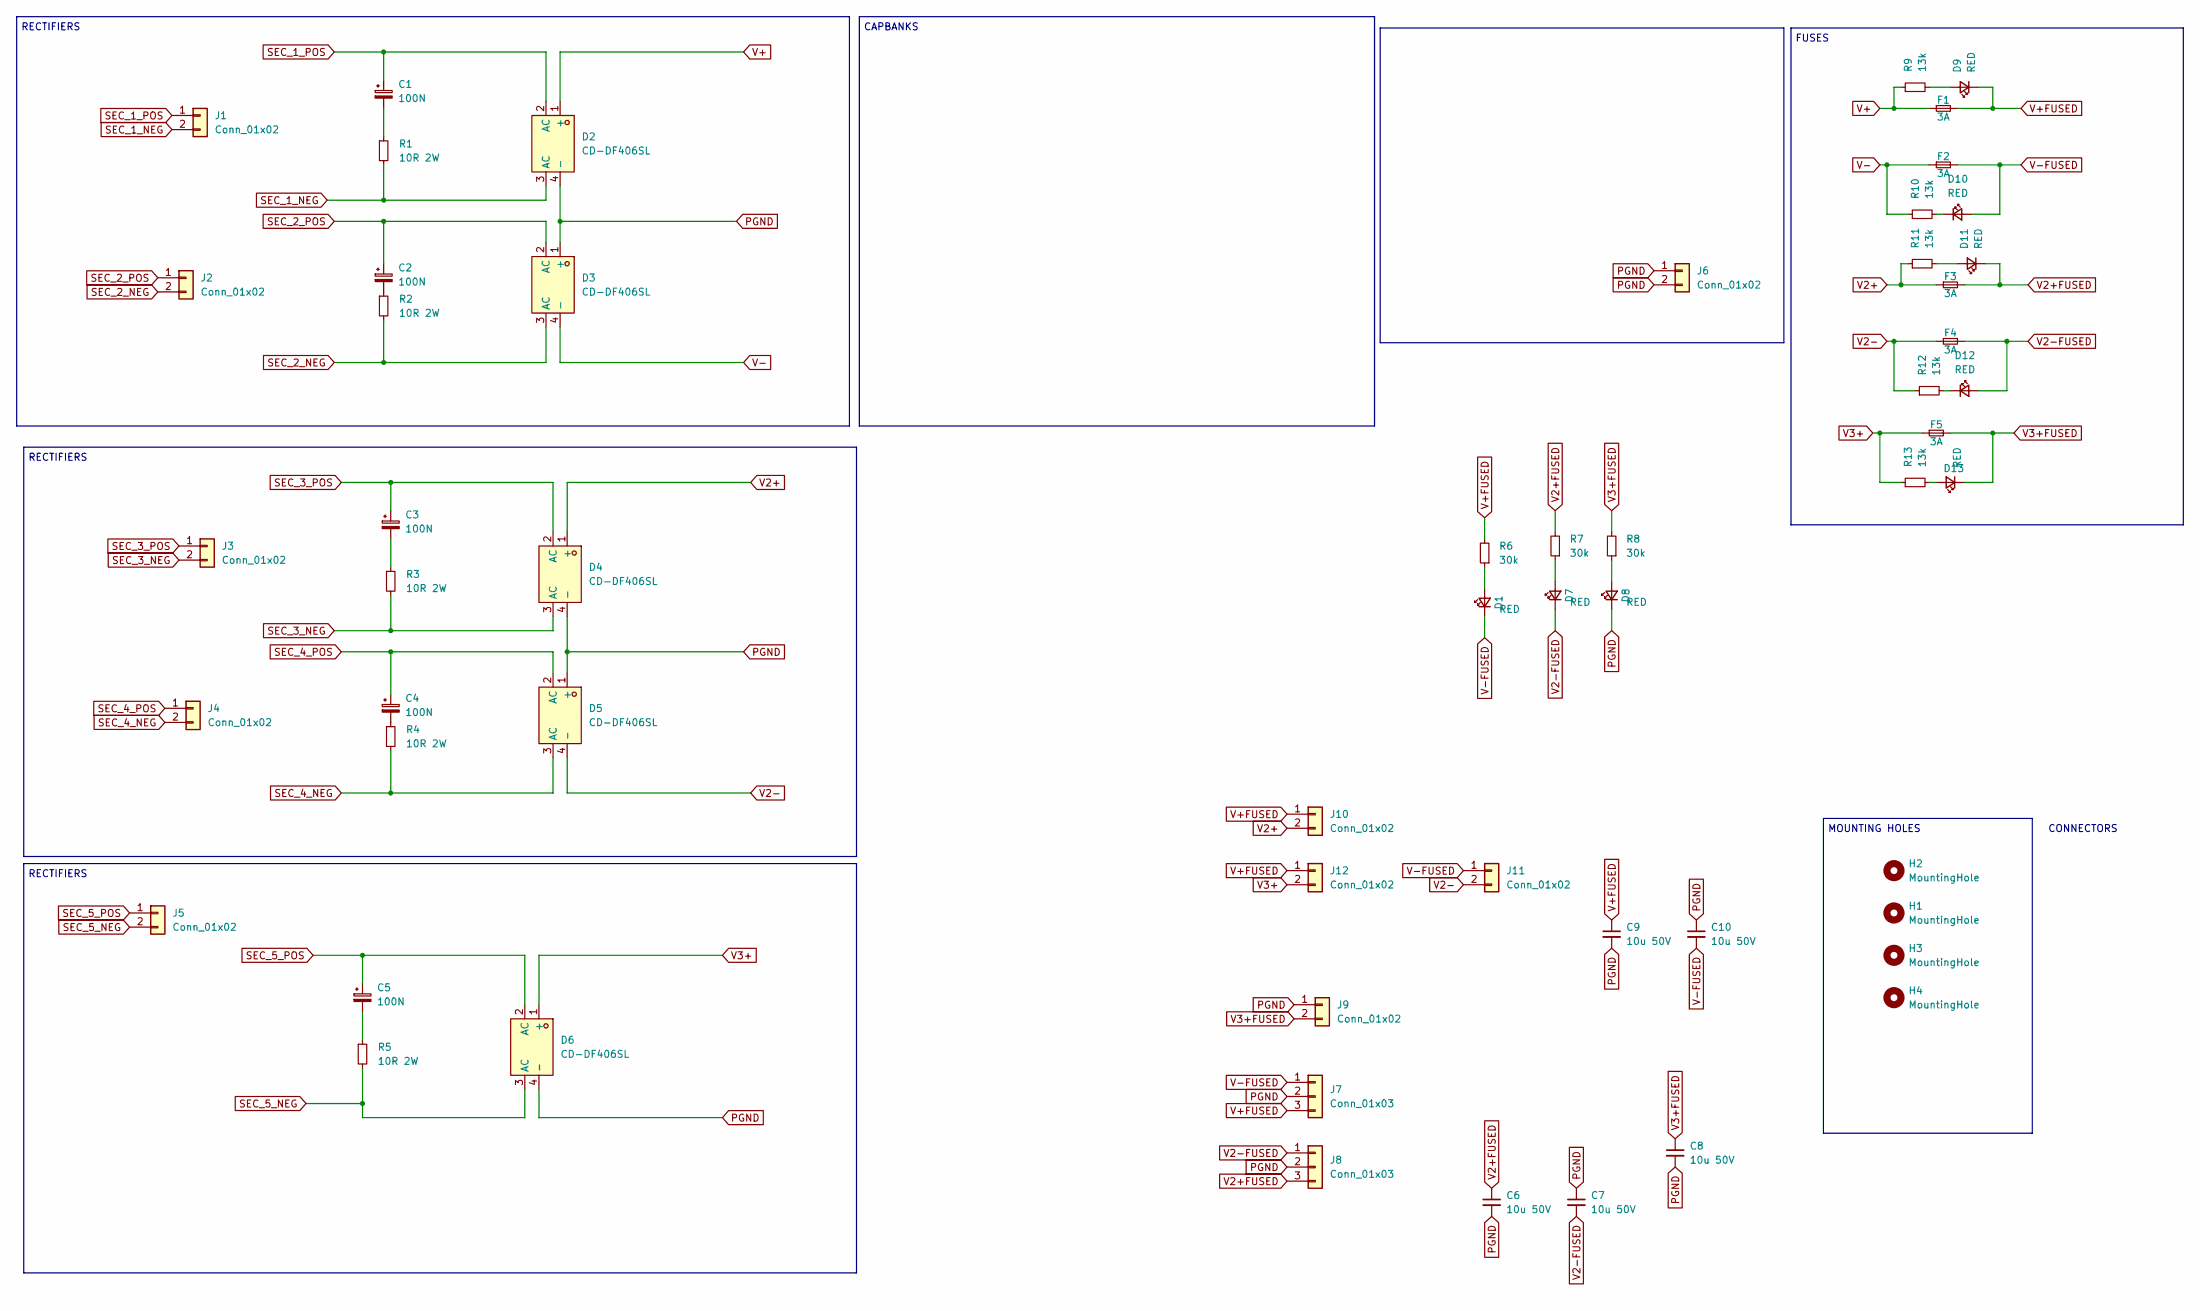
[picture p193: schematic rectifier.kicad_sch]

Parts:
C1, C2, C3, C4, C5: 100N; C_Rect_L10.3mm_W4.5mm_P7.50mm_MKS4; Mouser MKP4F031002D00KF00
C6, C7, C8, C9, C10: 10u 50V; C_1206_3216Metric_Pad1.33x1.80mm_HandSolder_Duane
D1, D7, D8, D9, D10, D11, D12, D13: RED; LED_0805_2012Metric_Pad_HandSolder_Duane
D2, D3, D4, D5, D6: CD-DF406SL; Z4-D_4P-L10.5-W8.1-P5.08-TL; LCSC Part C17188088
F1, F2, F3, F4, F5: 3A; Fuse_1812_AliExpress
H1, H2, H3, H4: MountingHole; MountingHole_3.2mm_M3_DIN965_Pad_TopBottom
J1, J2, J3, J4, J5, J9: Conn_01x02; JST_VH_B2P-VH-B_1x02_P3.96mm_Vertical_Duane
J6: Conn_01x02; TerminalBlock_Phoenix_PT-1,5-2-3.5-H_1x02_P3.50mm_Horizontal
J7, J8: Conn_01x03; JST_VH_B3P-VH-B_1x03_P3.96mm_Vertical_Duane
J10, J11, J12: Conn_01x02; PinHeader_1x02_P2.54mm_Vertical
R1, R2, R3, R4, R5: 10R 2W; R_2512_6332Metric_Pad1.40x3.35mm_HandSolder; Mouser 603-SR2512JK-7W10RL
R6, R7, R8: 30k; R_0805_2012Metric_Pad1.20x1.40mm_HandSolder_Duane; Mouser 603-SR2512JK-7W10RL
R9, R10, R11, R12, R13: 13k; R_0805_2012Metric_Pad1.20x1.40mm_HandSolder_Duane; Mouser 603-SR2512JK-7W10RL

Connections:
unnamed: C1.2, R1.1
unnamed: C2.2, R2.1
unnamed: C3.2, R3.1
unnamed: C4.2, R4.1
unnamed: C5.2, R5.1
unnamed: D1.2 (A), R6.1
unnamed: D7.2 (A), R7.1
unnamed: D8.2 (A), R8.1
unnamed: D9.2 (A), R9.2
unnamed: D10.1 (K), R10.2
unnamed: D11.2 (A), R11.2
unnamed: D12.1 (K), R12.2
unnamed: D13.2 (A), R13.2
PGND: C6.2, C7.1, C8.2, C9.2, C10.1, D2.4 (-), D3.1 (+), D4.4 (-), D5.1 (+), D6.4 (-), D8.1 (K), J6.1, J6.2, J7.2, J8.2, J9.1
SEC_1_NEG: D2.3 (AC), J1.2, R1.2
SEC_1_POS: C1.1, D2.2 (AC), J1.1
SEC_2_NEG: D3.3 (AC), J2.2, R2.2
SEC_2_POS: C2.1, D3.2 (AC), J2.1
SEC_3_NEG: D4.3 (AC), J3.2, R3.2
SEC_3_POS: C3.1, D4.2 (AC), J3.1
SEC_4_NEG: D5.3 (AC), J4.2, R4.2
SEC_4_POS: C4.1, D5.2 (AC), J4.1
SEC_5_NEG: D6.3 (AC), J5.2, R5.2
SEC_5_POS: C5.1, D6.2 (AC), J5.1
V2+: D4.1 (+), F3.1, J10.2, R11.1
V2+FUSED: C6.1, D11.1 (K), F3.2, J8.3, R7.2
V2-: D5.4 (-), F4.1, J11.2, R12.1
V2-FUSED: C7.2, D7.1 (K), D12.2 (A), F4.2, J8.1
V3+: D6.1 (+), F5.1, J12.2, R13.1
V3+FUSED: C8.1, D13.1 (K), F5.2, J9.2, R8.2
V+: D2.1 (+), F1.1, R9.1
V+FUSED: C9.1, D9.1 (K), F1.2, J7.3, J10.1, J12.1, R6.2
V-: D3.4 (-), F2.1, R10.1
V-FUSED: C10.2, D1.1 (K), D10.2 (A), F2.2, J7.1, J11.1

Notes on the sheet:
MOUNTING HOLES
RECTIFIERS
CONNECTORS
CAPBANKS
FUSES

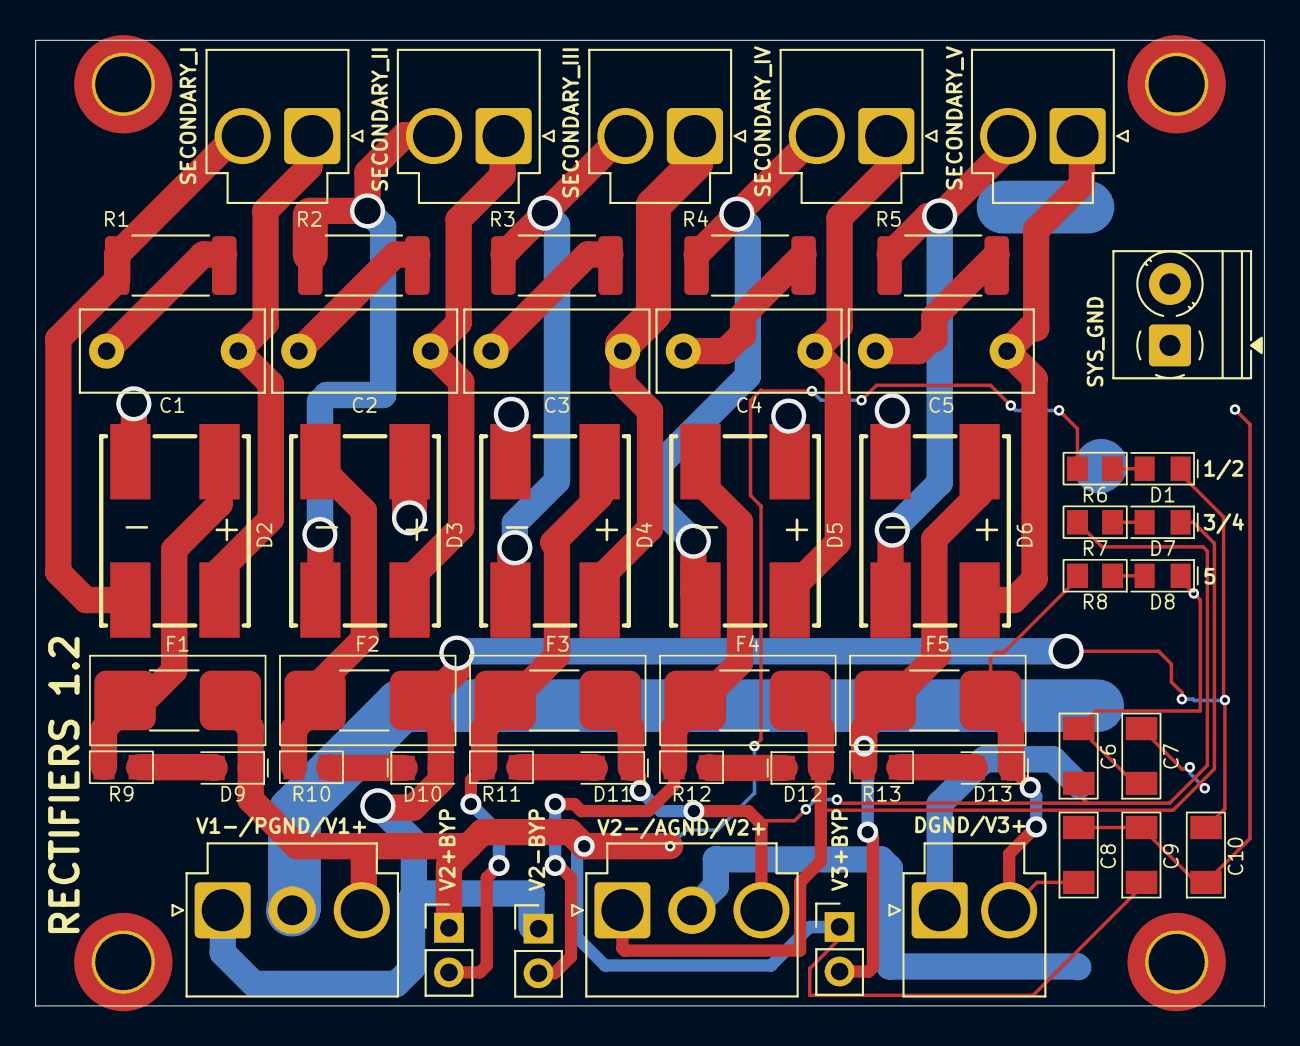
[picture p194: board pcbs/_final_proto/psu-rectifiers/1.1/rectifier.kicad_pcb from above]

Board: 2 copper layers, 70.0 x 55.0 mm, 57 parts (0 on the bottom side), 34 nets.
