duanestorey/hifi-amp/pcbs/_final_proto/psu-monitor/1.3/monitors.kicad_pcb

## KiCad design pcbs/_final_proto/psu-monitor/1.3/monitors.kicad_pcb (2025-11-16)

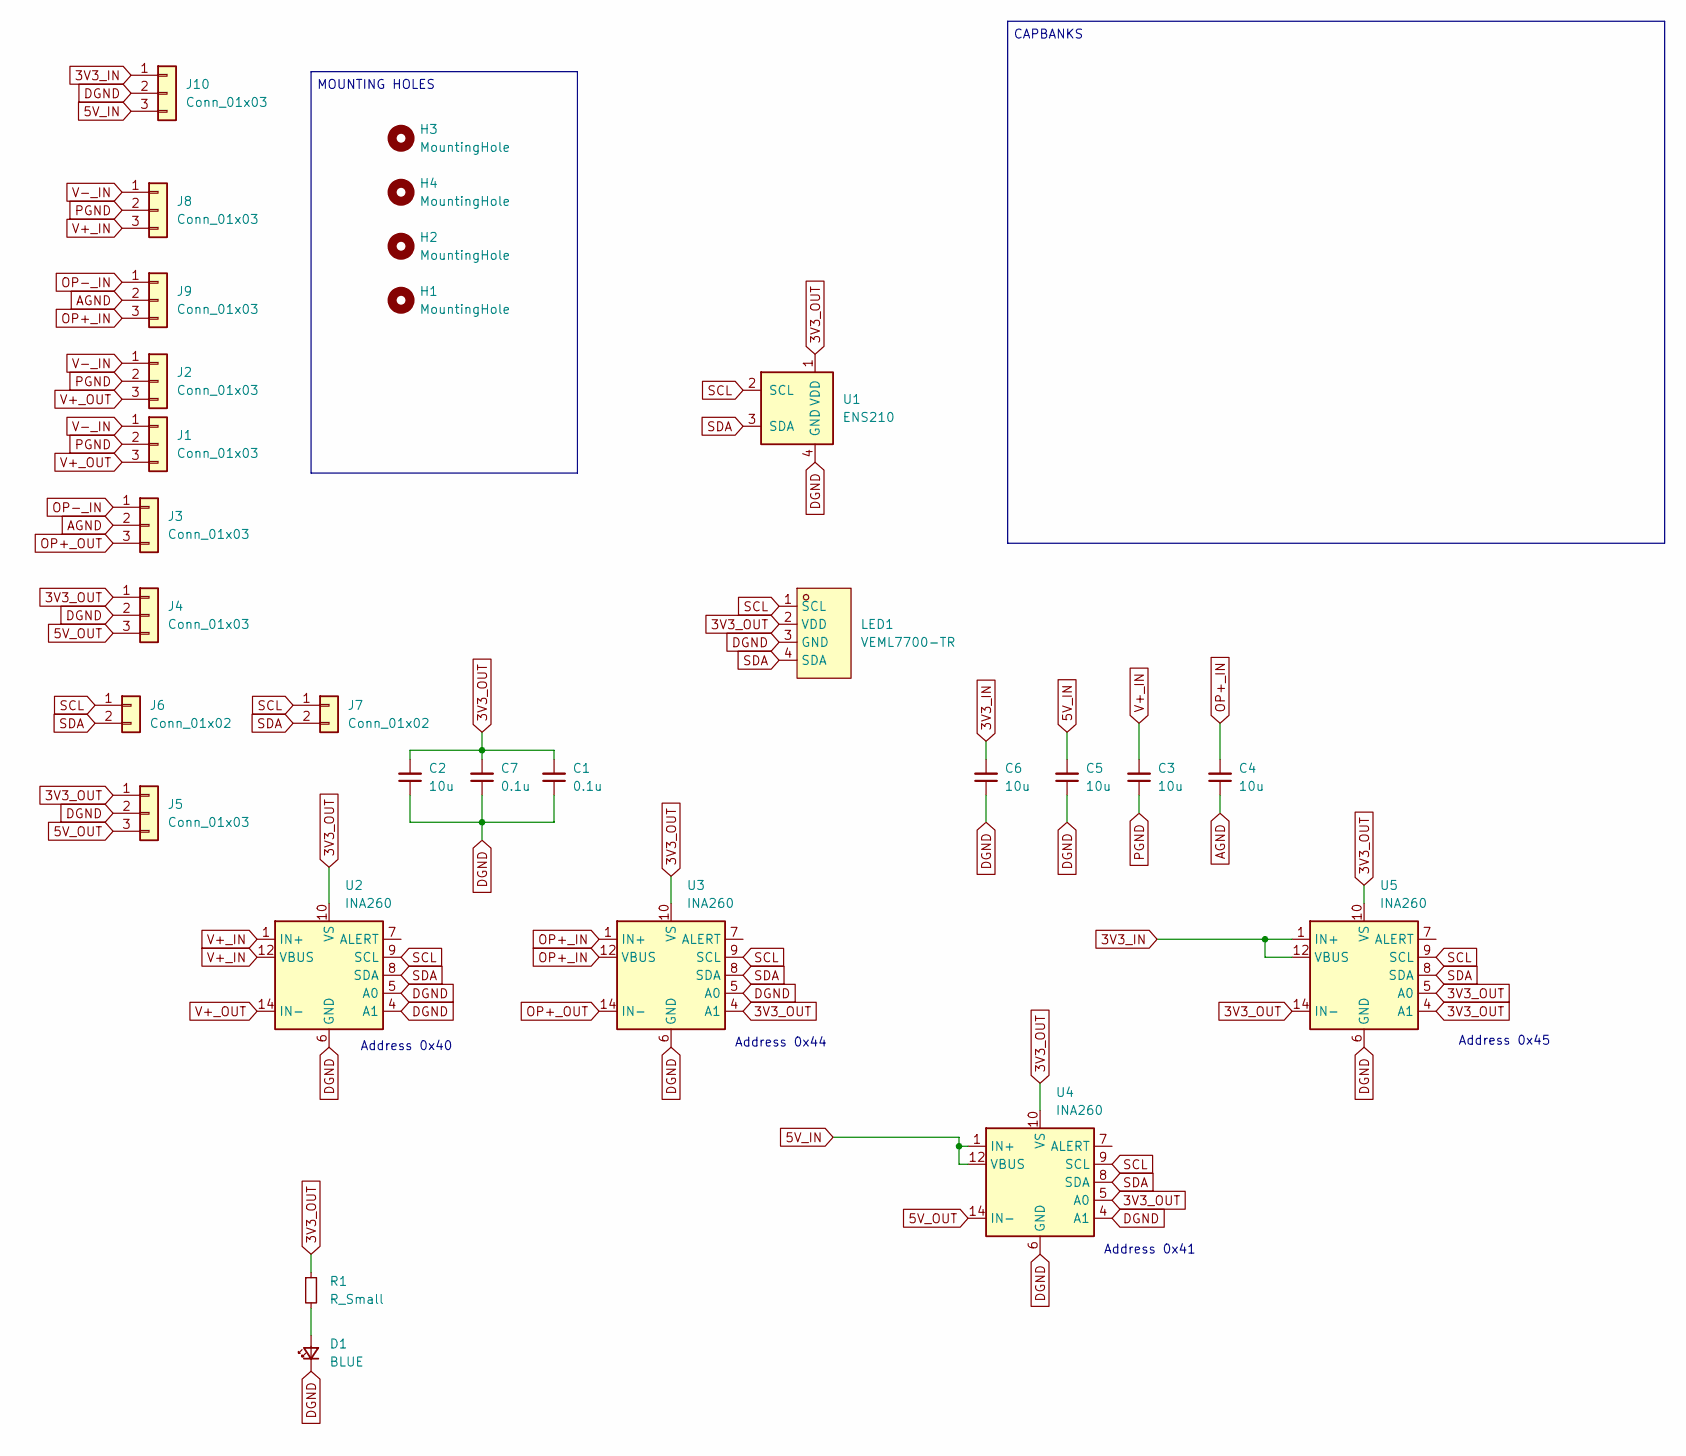
[picture p195: schematic monitors.kicad_sch]

Parts:
C1, C7: 0.1u; C_0805_2012Metric_Pad1.18x1.45mm_HandSolder_Duane
C2, C3, C4, C5, C6: 10u; C_1206_3216Metric_Pad1.33x1.80mm_HandSolder_Duane
D1: BLUE; LED_0805_2012Metric_Pad_HandSolder_Duane
H1, H2, H3, H4: MountingHole; MountingHole_3.2mm_M3_DIN965_Pad_TopBottom
J1, J2, J3, J4, J8, J9, J10: Conn_01x03; JST_VH_B3P-VH-B_1x03_P3.96mm_Vertical_Duane
J5: Conn_01x03; JST_PH_B3B-PH-K_1x03_P2.00mm_Vertical
J6, J7: Conn_01x02; JST_PH_B2B-PH-K_1x02_P2.00mm_Vertical
LED1: VEML7700-TR; LED-SMD_4P-L6.8-W2.4_VEML7700-TR; LCSC Part C504893
R1: R_Small; R_0805_2012Metric_Pad1.20x1.40mm_HandSolder_Duane
U1: ENS210; AMS_QFN-4-1EP_2x2mm_P0.95mm_EP0.7x1.6mm
U2, U3, U4, U5: INA260; TSSOP-16_4.4x5mm_P0.65mm

Connections:
3V3_IN: C6.2, J10.1, U5.1 (IN+), U5.2 (IN+), U5.3 (IN+), U5.12 (VBUS)
3V3_OUT: C1.2, C2.2, C7.2, J4.1, J5.1, LED1.2 (VDD), R1.1, U1.1 (VDD), U2.10 (VS), U3.4 (A1), U3.10 (VS), U4.5 (A0), U4.10 (VS), U5.4 (A1), U5.5 (A0), U5.10 (VS), U5.14 (IN-), U5.15 (IN-), U5.16 (IN-)
5V_IN: C5.2, J10.3, U4.1 (IN+), U4.2 (IN+), U4.3 (IN+), U4.12 (VBUS)
5V_OUT: J4.3, J5.3, U4.14 (IN-), U4.15 (IN-), U4.16 (IN-)
AGND: C4.1, J3.2, J9.2
DGND: C1.1, C2.1, C5.1, C6.1, C7.1, D1.1 (K), J4.2, J5.2, J10.2, LED1.3 (GND), U1.4 (GND), U1.5 (GND), U2.4 (A1), U2.5 (A0), U2.6 (GND), U2.11 (GND), U3.5 (A0), U3.6 (GND), U3.11 (GND), U4.4 (A1), U4.6 (GND), U4.11 (GND), U5.6 (GND), U5.11 (GND)
unnamed: D1.2 (A), R1.2
OP+_IN: C4.2, J9.3, U3.1 (IN+), U3.2 (IN+), U3.3 (IN+), U3.12 (VBUS)
OP+_OUT: J3.3, U3.14 (IN-), U3.15 (IN-), U3.16 (IN-)
OP-_IN: J3.1, J9.1
PGND: C3.1, J1.2, J2.2, J8.2
SCL: J6.1, J7.1, LED1.1 (SCL), U1.2 (SCL), U2.9 (SCL), U3.9 (SCL), U4.9 (SCL), U5.9 (SCL)
SDA: J6.2, J7.2, LED1.4 (SDA), U1.3 (SDA), U2.8 (SDA), U3.8 (SDA), U4.8 (SDA), U5.8 (SDA)
V+_IN: C3.2, J8.3, U2.1 (IN+), U2.2 (IN+), U2.3 (IN+), U2.12 (VBUS)
V+_OUT: J1.3, J2.3, U2.14 (IN-), U2.15 (IN-), U2.16 (IN-)
V-_IN: J1.1, J2.1, J8.1

Notes on the sheet:
Address 0x44
Address 0x41
MOUNTING HOLES
Address 0x45
CAPBANKS
Address 0x40

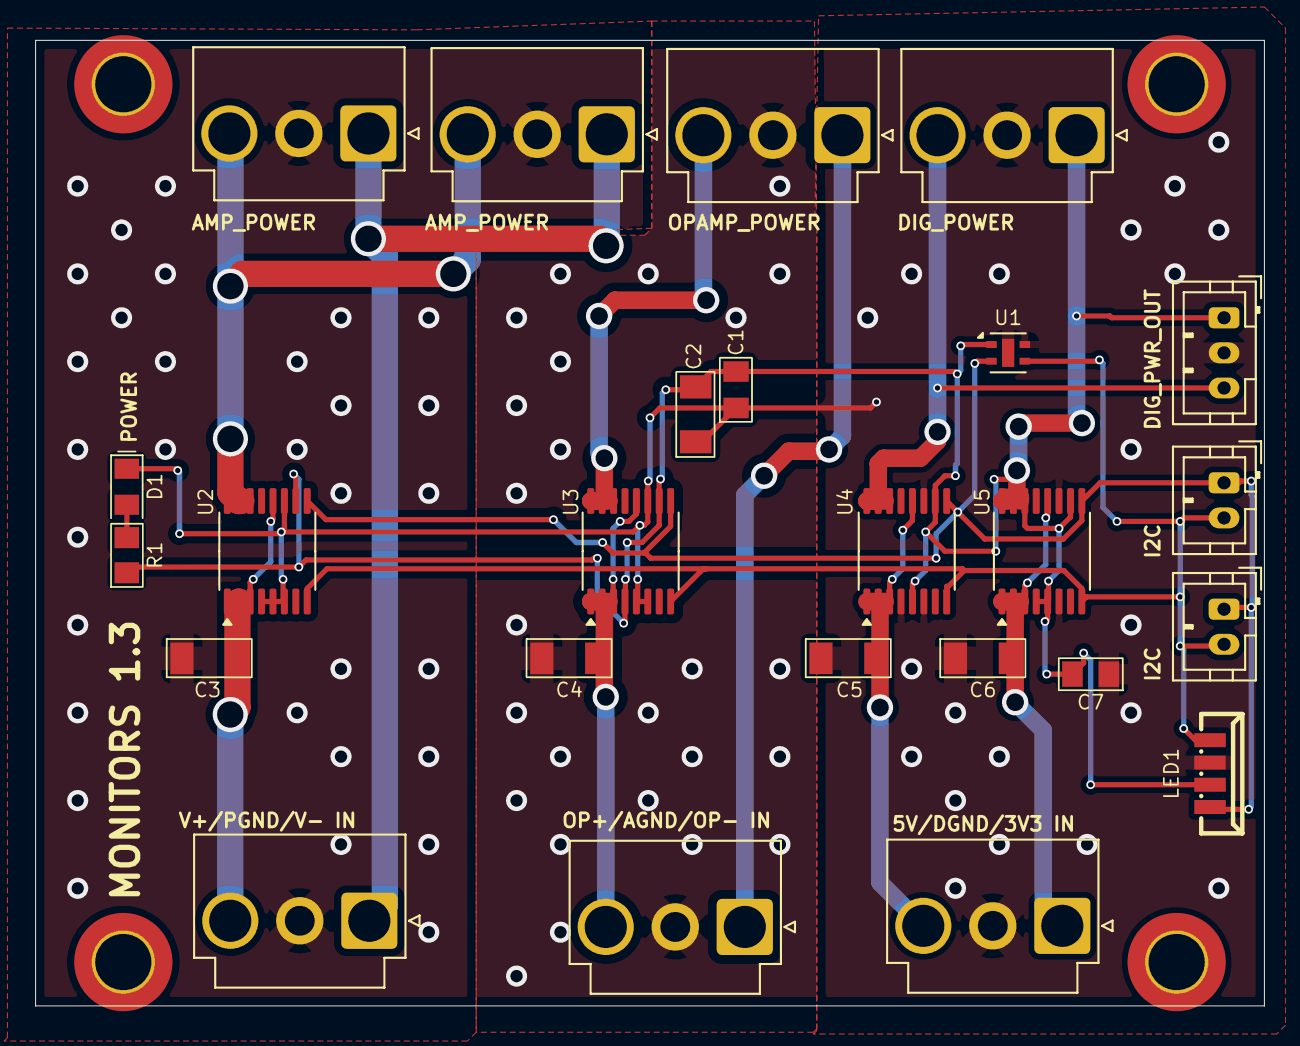
[picture p196: board monitors.kicad_pcb from above]

Board: 2 copper layers, 70.0 x 55.0 mm, 29 parts (0 on the bottom side), 16 nets.
