duanestorey/hifi-amp/pcbs/esp32-s3/esp32-s3.kicad_sch

## KiCad design pcbs/esp32-s3/esp32-s3.kicad_sch (2025-02-14)

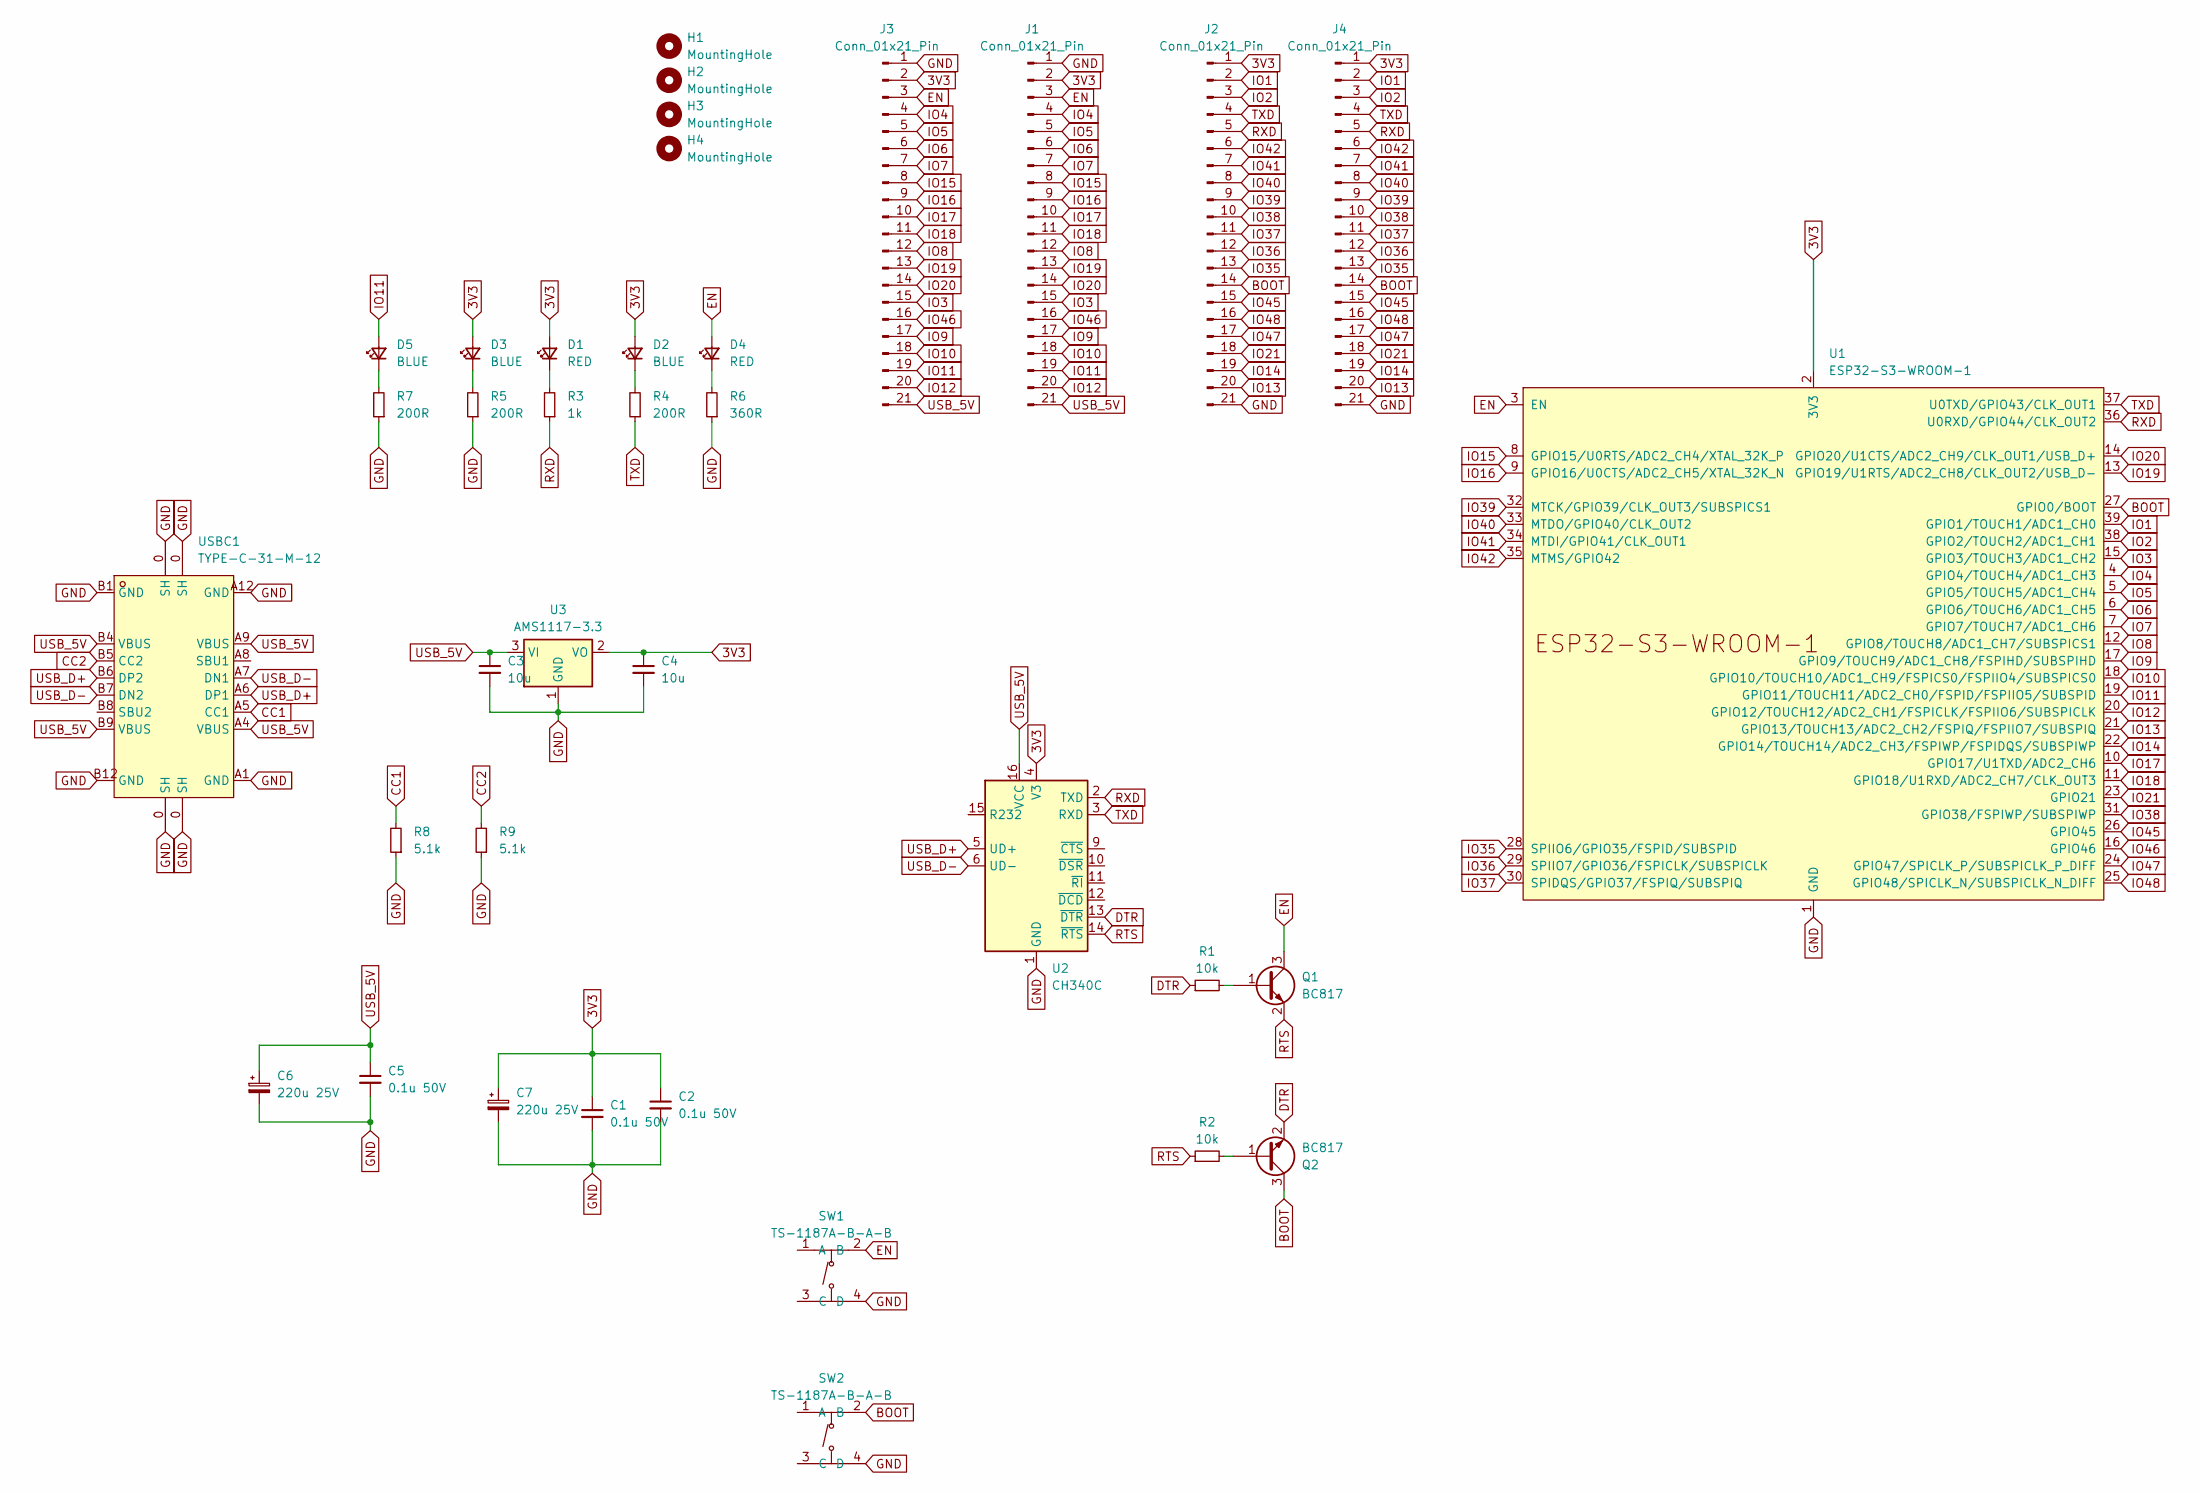
[picture p197: schematic esp32-s3.kicad_sch]

Parts:
C1, C2, C5: 0.1u 50V; C_0805_2012Metric; LCSC C38141
C3, C4: 10u; C_1206_3216Metric; LCSC C14860
C6, C7: 220u 25V; CP_Elec_6.3x7.7; LCSC C2918361
D1, D4: RED; LED_0603_1608Metric
D2, D3, D5: BLUE; LED_0603_1608Metric; LCSC C19171394
H1, H2, H3, H4: MountingHole; MountingHole_3.2mm_M3_DIN965_Pad_TopBottom
J1, J2: Conn_01x21_Pin; PinHeader_1x21_P2.54mm_Vertical; LCSC C41375940
J3, J4: Conn_01x21_Pin; PinSocket_1x21_P2.54mm_Vertical; LCSC C41376160
Q1, Q2: BC817; SOT-23; LCSC C52801
R1, R2: 10k; R_0603_1608Metric; LCSC C2930027
R3: 1k; R_0603_1608Metric
R4, R5: 200R; R_0603_1608Metric; LCSC C8218
R6: 360R; R_0603_1608Metric; LCSC C25194
R7: 200R; R_0603_1608Metric
R8, R9: 5.1k; R_0603_1608Metric; LCSC C23186
SW1, SW2: TS-1187A-B-A-B; SW-SMD_4P-L5.1-W5.1-P3.70-LS6.5-TL_H1.5; LCSC Part C318884
U1: ESP32-S3-WROOM-1; LCSC C2913203
U2: CH340C; SOIC-16_3.9x9.9mm_P1.27mm
U3: AMS1117-3.3; SOT-223-3_TabPin2; LCSC C5250992
USBC1: TYPE-C-31-M-12; USB-C_SMD-TYPE-C-31-M-12; LCSC Part C165948

Connections:
3V3: C1.1, C2.1, C4.1, C7.1, D1.2 (A), D2.2 (A), D3.2 (A), J1.2, J2.1, J3.2, J4.1, U1.2 (3V3), U2.4 (V3), U3.2 (VO)
BOOT: J2.14, J4.14, Q2.3 (C), SW2.2 (B), U1.27 (GPIO0/BOOT)
CC1: R8.2, USBC1.A5 (CC1)
CC2: R9.2, USBC1.B5 (CC2)
DTR: Q2.2 (E), R1.1, U2.13 (~DTR)
EN: D4.2 (A), J1.3, J3.3, Q1.3 (C), SW1.2 (B), U1.3 (EN)
GND: C1.2, C2.2, C3.2, C4.2, C5.2, C6.2, C7.2, J1.1, J2.21, J3.1, J4.21, R5.1, R6.1, R7.1, R8.1, R9.1, SW1.4 (D), SW2.4 (D), U1.1 (GND), U1.40 (GND), U1.41 (GND), U2.1 (GND), U3.1 (GND), USBC1.0 (SH), USBC1.A1 (GND), USBC1.A12 (GND), USBC1.B1 (GND), USBC1.B12 (GND)
IO1: J2.2, J4.2, U1.39 (GPIO1/TOUCH1/ADC1_CH0)
IO2: J2.3, J4.3, U1.38 (GPIO2/TOUCH2/ADC1_CH1)
IO3: J1.15, J3.15, U1.15 (GPIO3/TOUCH3/ADC1_CH2)
IO4: J1.4, J3.4, U1.4 (GPIO4/TOUCH4/ADC1_CH3)
IO5: J1.5, J3.5, U1.5 (GPIO5/TOUCH5/ADC1_CH4)
IO6: J1.6, J3.6, U1.6 (GPIO6/TOUCH6/ADC1_CH5)
IO7: J1.7, J3.7, U1.7 (GPIO7/TOUCH7/ADC1_CH6)
IO8: J1.12, J3.12, U1.12 (GPIO8/TOUCH8/ADC1_CH7/SUBSPICS1)
IO9: J1.17, J3.17, U1.17 (GPIO9/TOUCH9/ADC1_CH8/FSPIHD/SUBSPIHD)
IO10: J1.18, J3.18, U1.18 (GPIO10/TOUCH10/ADC1_CH9/FSPICS0/FSPIIO4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)
IO11: D5.2 (A), J1.19, J3.19, U1.19 (GPIO11/TOUCH11/ADC2_CH0/FSPID/FSPIIO5/S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)
IO12: J1.20, J3.20, U1.20 (GPIO12/TOUCH12/ADC2_CH1/FSPICLK/FSPIIO6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)
IO13: J2.20, J4.20, U1.21 (GPIO13/TOUCH13/ADC2_CH2/FSPIQ/FSPIIO7/S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)
IO14: J2.19, J4.19, U1.22 (GPIO14/TOUCH14/ADC2_CH3/FSPIWP/FSPIDQS/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)
IO15: J1.8, J3.8, U1.8 (GPIO15/U0RTS/ADC2_CH4/XTAL_32K_P)
IO16: J1.9, J3.9, U1.9 (GPIO16/U0CTS/ADC2_CH5/XTAL_32K_N)
IO17: J1.10, J3.10, U1.10 (GPIO17/U1TXD/ADC2_CH6)
IO18: J1.11, J3.11, U1.11 (GPIO18/U1RXD/ADC2_CH7/CLK_OUT3)
IO19: J1.13, J3.13, U1.13 (GPIO19/U1RTS/ADC2_CH8/CLK_OUT2/USB_D-)
IO20: J1.14, J3.14, U1.14 (GPIO20/U1CTS/ADC2_CH9/CLK_OUT1/USB_D+)
IO21: J2.18, J4.18, U1.23 (GPIO21)
IO35: J2.13, J4.13, U1.28 (SPIIO6/GPIO35/FSPID/SUBSPID)
IO36: J2.12, J4.12, U1.29 (SPIIO7/GPIO36/FSPICLK/SUBSPICLK)
IO37: J2.11, J4.11, U1.30 (SPIDQS/GPIO37/FSPIQ/SUBSPIQ)
IO38: J2.10, J4.10, U1.31 (GPIO38/FSPIWP/SUBSPIWP)
IO39: J2.9, J4.9, U1.32 (MTCK/GPIO39/CLK_OUT3/SUBSPICS1)
IO40: J2.8, J4.8, U1.33 (MTDO/GPIO40/CLK_OUT2)
IO41: J2.7, J4.7, U1.34 (MTDI/GPIO41/CLK_OUT1)
IO42: J2.6, J4.6, U1.35 (MTMS/GPIO42)
IO45: J2.15, J4.15, U1.26 (GPIO45)
IO46: J1.16, J3.16, U1.16 (GPIO46)
IO47: J2.17, J4.17, U1.24 (GPIO47/SPICLK_P/SUBSPICLK_P_DIFF)
IO48: J2.16, J4.16, U1.25 (GPIO48/SPICLK_N/SUBSPICLK_N_DIFF)
unnamed: D1.1 (K), R3.2
unnamed: D2.1 (K), R4.2
unnamed: D3.1 (K), R5.2
unnamed: D4.1 (K), R6.2
unnamed: D5.1 (K), R7.2
unnamed: Q1.1 (B), R1.2
unnamed: Q2.1 (B), R2.2
RTS: Q1.2 (E), R2.1, U2.14 (~RTS)
RXD: J2.5, J4.5, R3.1, U1.36 (U0RXD/GPIO44/CLK_OUT2), U2.2 (TXD)
TXD: J2.4, J4.4, R4.1, U1.37 (U0TXD/GPIO43/CLK_OUT1), U2.3 (RXD)
USB_5V: C3.1, C5.1, C6.1, J1.21, J3.21, U2.16 (VCC), U3.3 (VI), USBC1.A4 (VBUS), USBC1.A9 (VBUS), USBC1.B4 (VBUS), USBC1.B9 (VBUS)
USB_D+: U2.5 (UD+), USBC1.A6 (DP1), USBC1.B6 (DP2)
USB_D-: U2.6 (UD-), USBC1.A7 (DN1), USBC1.B7 (DN2)
