duanestorey/hifi-amp/pcbs/plate-amp-psu/plate-amp-psu.kicad_sch

## KiCad design pcbs/plate-amp-psu/plate-amp-psu.kicad_sch (2025-02-14)

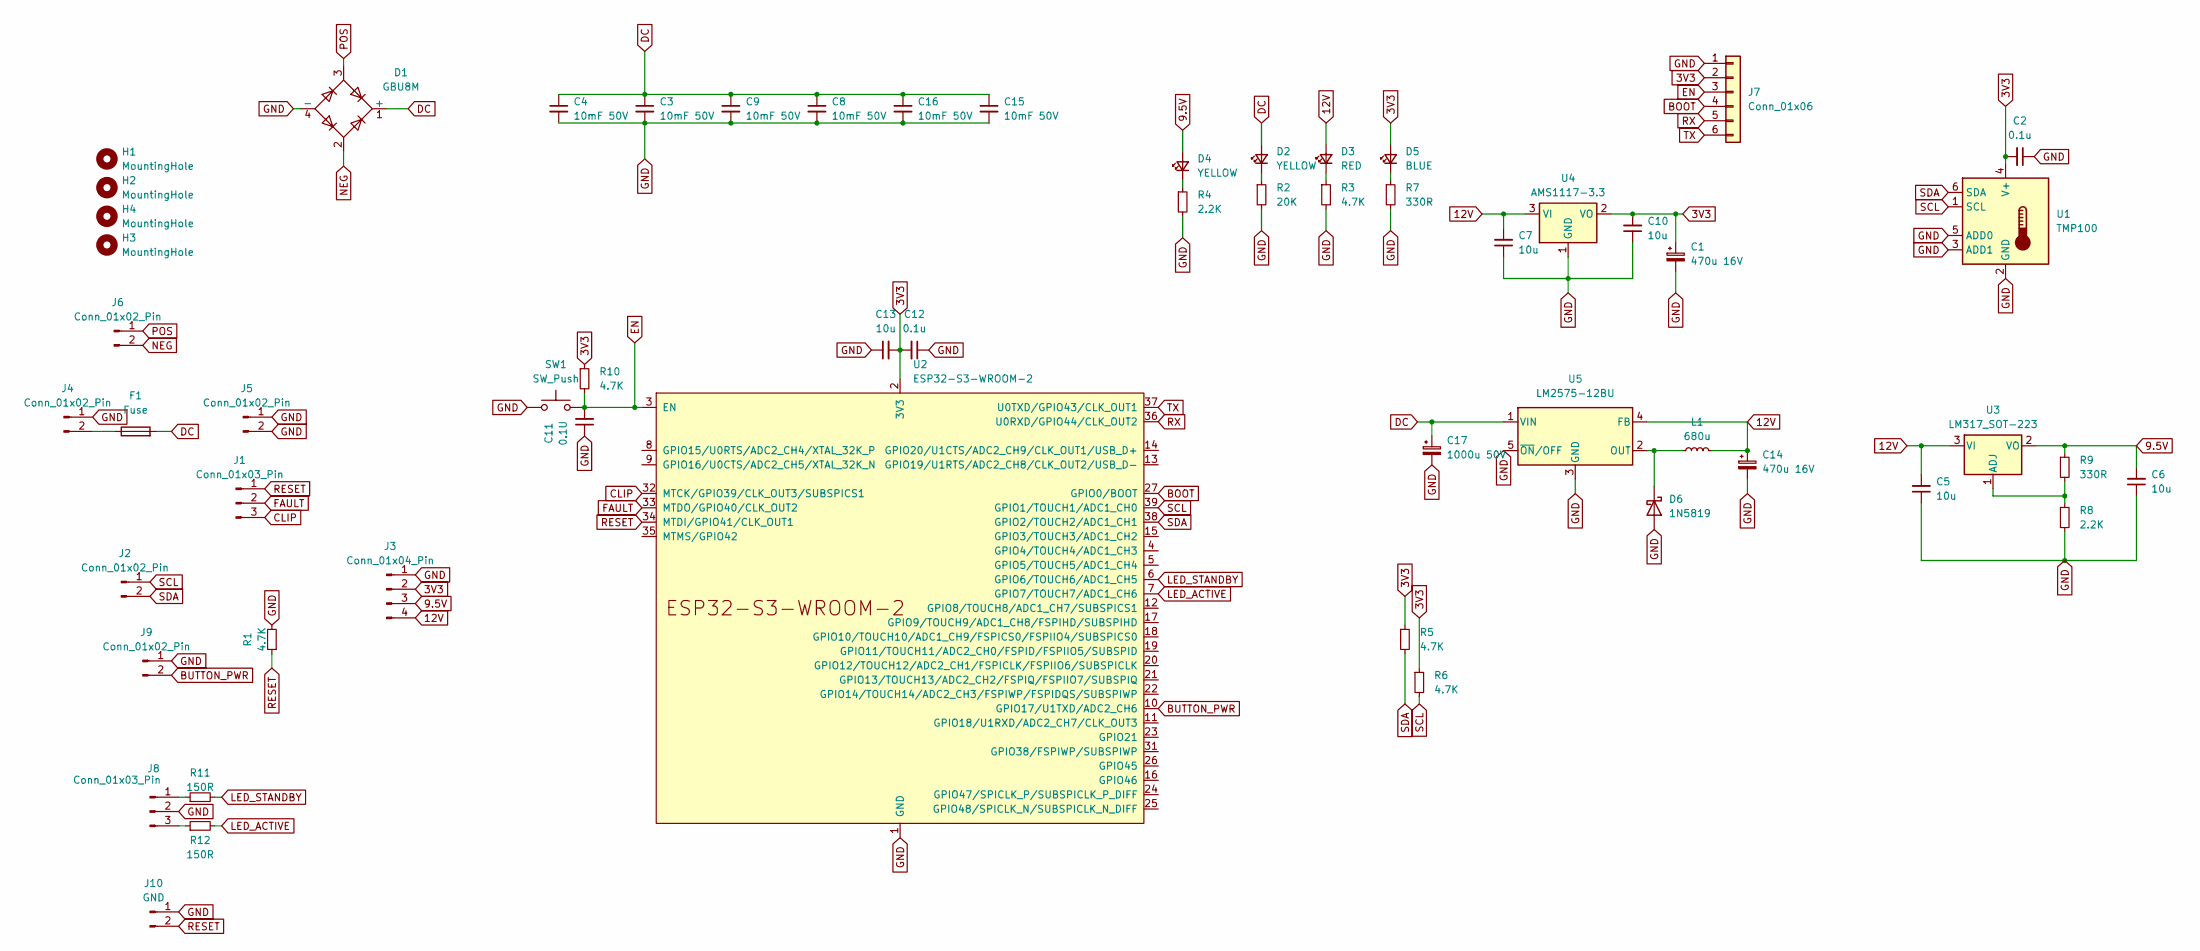
[picture p198: schematic plate-amp-psu.kicad_sch]

Parts:
C1, C14: 470u 16V; CP_Radial_D8.0mm_P3.50mm
C2, C12: 0.1u; C_0805_2012Metric_Pad1.18x1.45mm_HandSolder
C3, C4, C8, C9, C15, C16: 10mF 50V; CP_Radial_D25.0mm_P10.00mm_SnapIn
C5, C6, C7, C10, C13: 10u; C_1206_3216Metric_Pad1.33x1.80mm_HandSolder
C11: 0.1U; C_0805_2012Metric_Pad1.18x1.45mm_HandSolder
C17: 1000u 50V; CP_Radial_D12.5mm_P5.00mm
D1: GBU8M; Diode_Bridge_Vishay_GBU
D2, D4: YELLOW; LED_0805_2012Metric_Pad1.15x1.40mm_HandSolder
D3: RED; LED_0805_2012Metric_Pad1.15x1.40mm_HandSolder
D5: BLUE; LED_0805_2012Metric_Pad1.15x1.40mm_HandSolder
D6: 1N5819; D_DO-41_SOD81_P7.62mm_Horizontal; Mouser 863-MBR150RLG
F1: Fuse; Aliexpress Fuse 5x20
H1, H2, H3, H4: MountingHole; MountingHole_3.2mm_M3_DIN965_Pad_TopBottom
J1, J8: Conn_01x03_Pin; JST_PH_B3B-PH-K_1x03_P2.00mm_Vertical
J2, J9: Conn_01x02_Pin; JST_PH_B2B-PH-K_1x02_P2.00mm_Vertical
J3: Conn_01x04_Pin; JST_PH_B4B-PH-K_1x04_P2.00mm_Vertical
J4, J5: Conn_01x02_Pin; JST_VH_B2P-VH-B_1x02_P3.96mm_Vertical
J6: Conn_01x02_Pin; TerminalBlock_MetzConnect_Type059_RT06302HBWC_1x02_P3.50mm_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
J7: Conn_01x06; PinHeader_1x06_P2.54mm_Vertical
J10: GND; JST_PH_B2B-PH-K_1x02_P2.00mm_Vertical
L1: 680u; L_Changjiang_FXL1365; Mouser 710-7447709681
R1, R3, R5, R6, R10: 4.7K; R_0603_1608Metric_Pad0.98x0.95mm_HandSolder
R2: 20K; R_0603_1608Metric_Pad0.98x0.95mm_HandSolder
R4, R8: 2.2K; R_0603_1608Metric_Pad0.98x0.95mm_HandSolder
R7, R9: 330R; R_0603_1608Metric_Pad0.98x0.95mm_HandSolder
R11, R12: 150R; R_0603_1608Metric_Pad0.98x0.95mm_HandSolder
SW1: SW_Push; Button Aliexpress 4x4
U1: TMP100; SOT-23-6
U2: ESP32-S3-WROOM-2
U3: LM317_SOT-223; SOT-223-3_TabPin2
U4: AMS1117-3.3; SOT-223-3_TabPin2
U5: LM2575-12BU; TO-263-5_TabPin3; Mouser TL2575HV-12IKTTR

Connections:
3V3: C1.1, C2.2, C10.2, C12.2, C13.2, D5.2 (A), J3.2, J7.2, R5.1, R6.1, R10.1, U1.4 (V+), U2.2 (3V3), U4.2 (VO)
9.5V: C6.2, D4.2 (A), J3.3, R9.1, U3.2 (VO)
12V: C5.2, C7.2, C14.1, D3.2 (A), J3.4, L1.2, U3.3 (VI), U4.3 (VI), U5.4 (FB)
BOOT: J7.4, U2.27 (GPIO0/BOOT)
BUTTON_PWR: J9.2, U2.10 (GPIO17/U1TXD/ADC2_CH6)
CLIP: J1.3, U2.32 (MTCK/GPIO39/CLK_OUT3/SUBSPICS1)
DC: C3.1, C4.1, C8.1, C9.1, C15.1, C16.1, C17.1, D1.1 (+), D2.2 (A), F1.2, U5.1 (VIN)
EN: C11.2, J7.3, R10.2, SW1.2, U2.3 (EN)
FAULT: J1.2, U2.33 (MTDO/GPIO40/CLK_OUT2)
GND: C1.2, C2.1, C3.2, C4.2, C5.1, C6.1, C7.1, C8.2, C9.2, C10.1, C11.1, C12.1, C13.1, C14.2, C15.2, C16.2, C17.2, D1.4 (-), D6.2 (A), J3.1, J4.1, J5.1, J5.2, J7.1, J8.2, J9.1, J10.1, R1.2, R2.2, R3.2, R4.2, R7.2, R8.2, SW1.1, U1.2 (GND), U1.3 (ADD1), U1.5 (ADD0), U2.1 (GND), U2.40 (GND), U2.41 (GND), U4.1 (GND), U5.3 (GND), U5.5 (~ON/OFF)
LED_ACTIVE: R12.2, U2.7 (GPIO7/TOUCH7/ADC1_CH6)
LED_STANDBY: R11.2, U2.6 (GPIO6/TOUCH6/ADC1_CH5)
NEG: D1.2, J6.2
unnamed: D2.1 (K), R2.1
unnamed: D3.1 (K), R3.1
unnamed: D4.1 (K), R4.1
unnamed: D5.1 (K), R7.1
unnamed: D6.1 (K), L1.1, U5.2 (OUT)
unnamed: F1.1, J4.2
unnamed: J8.1, R11.1
unnamed: J8.3, R12.1
unnamed: R8.1, R9.2, U3.1 (ADJ)
POS: D1.3, J6.1
RESET: J1.1, J10.2, R1.1, U2.34 (MTDI/GPIO41/CLK_OUT1)
RX: J7.5, U2.36 (U0RXD/GPIO44/CLK_OUT2)
SCL: J2.1, R6.2, U1.1 (SCL), U2.39 (GPIO1/TOUCH1/ADC1_CH0)
SDA: J2.2, R5.2, U1.6 (SDA), U2.38 (GPIO2/TOUCH2/ADC1_CH1)
TX: J7.6, U2.37 (U0TXD/GPIO43/CLK_OUT1)
