duanestorey/hifi-amp/pcbs/_blank/1.0/blank.kicad_sch

## KiCad design pcbs/_blank/1.0/blank.kicad_sch (2025-03-21)

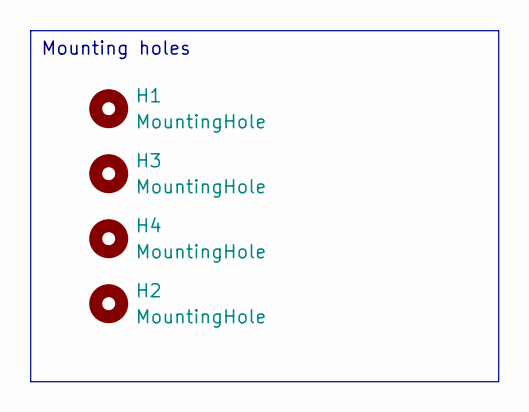
[picture p199: schematic blank.kicad_sch]

Parts:
H1, H2, H3, H4: MountingHole; MountingHole_3.2mm_M3_DIN965_Pad_TopBottom

Notes on the sheet:
Mounting holes
