duanestorey/hifi-amp/pcbs/adc/1.0/adc.kicad_sch

## KiCad design pcbs/adc/1.0/adc.kicad_sch (2025-02-14)

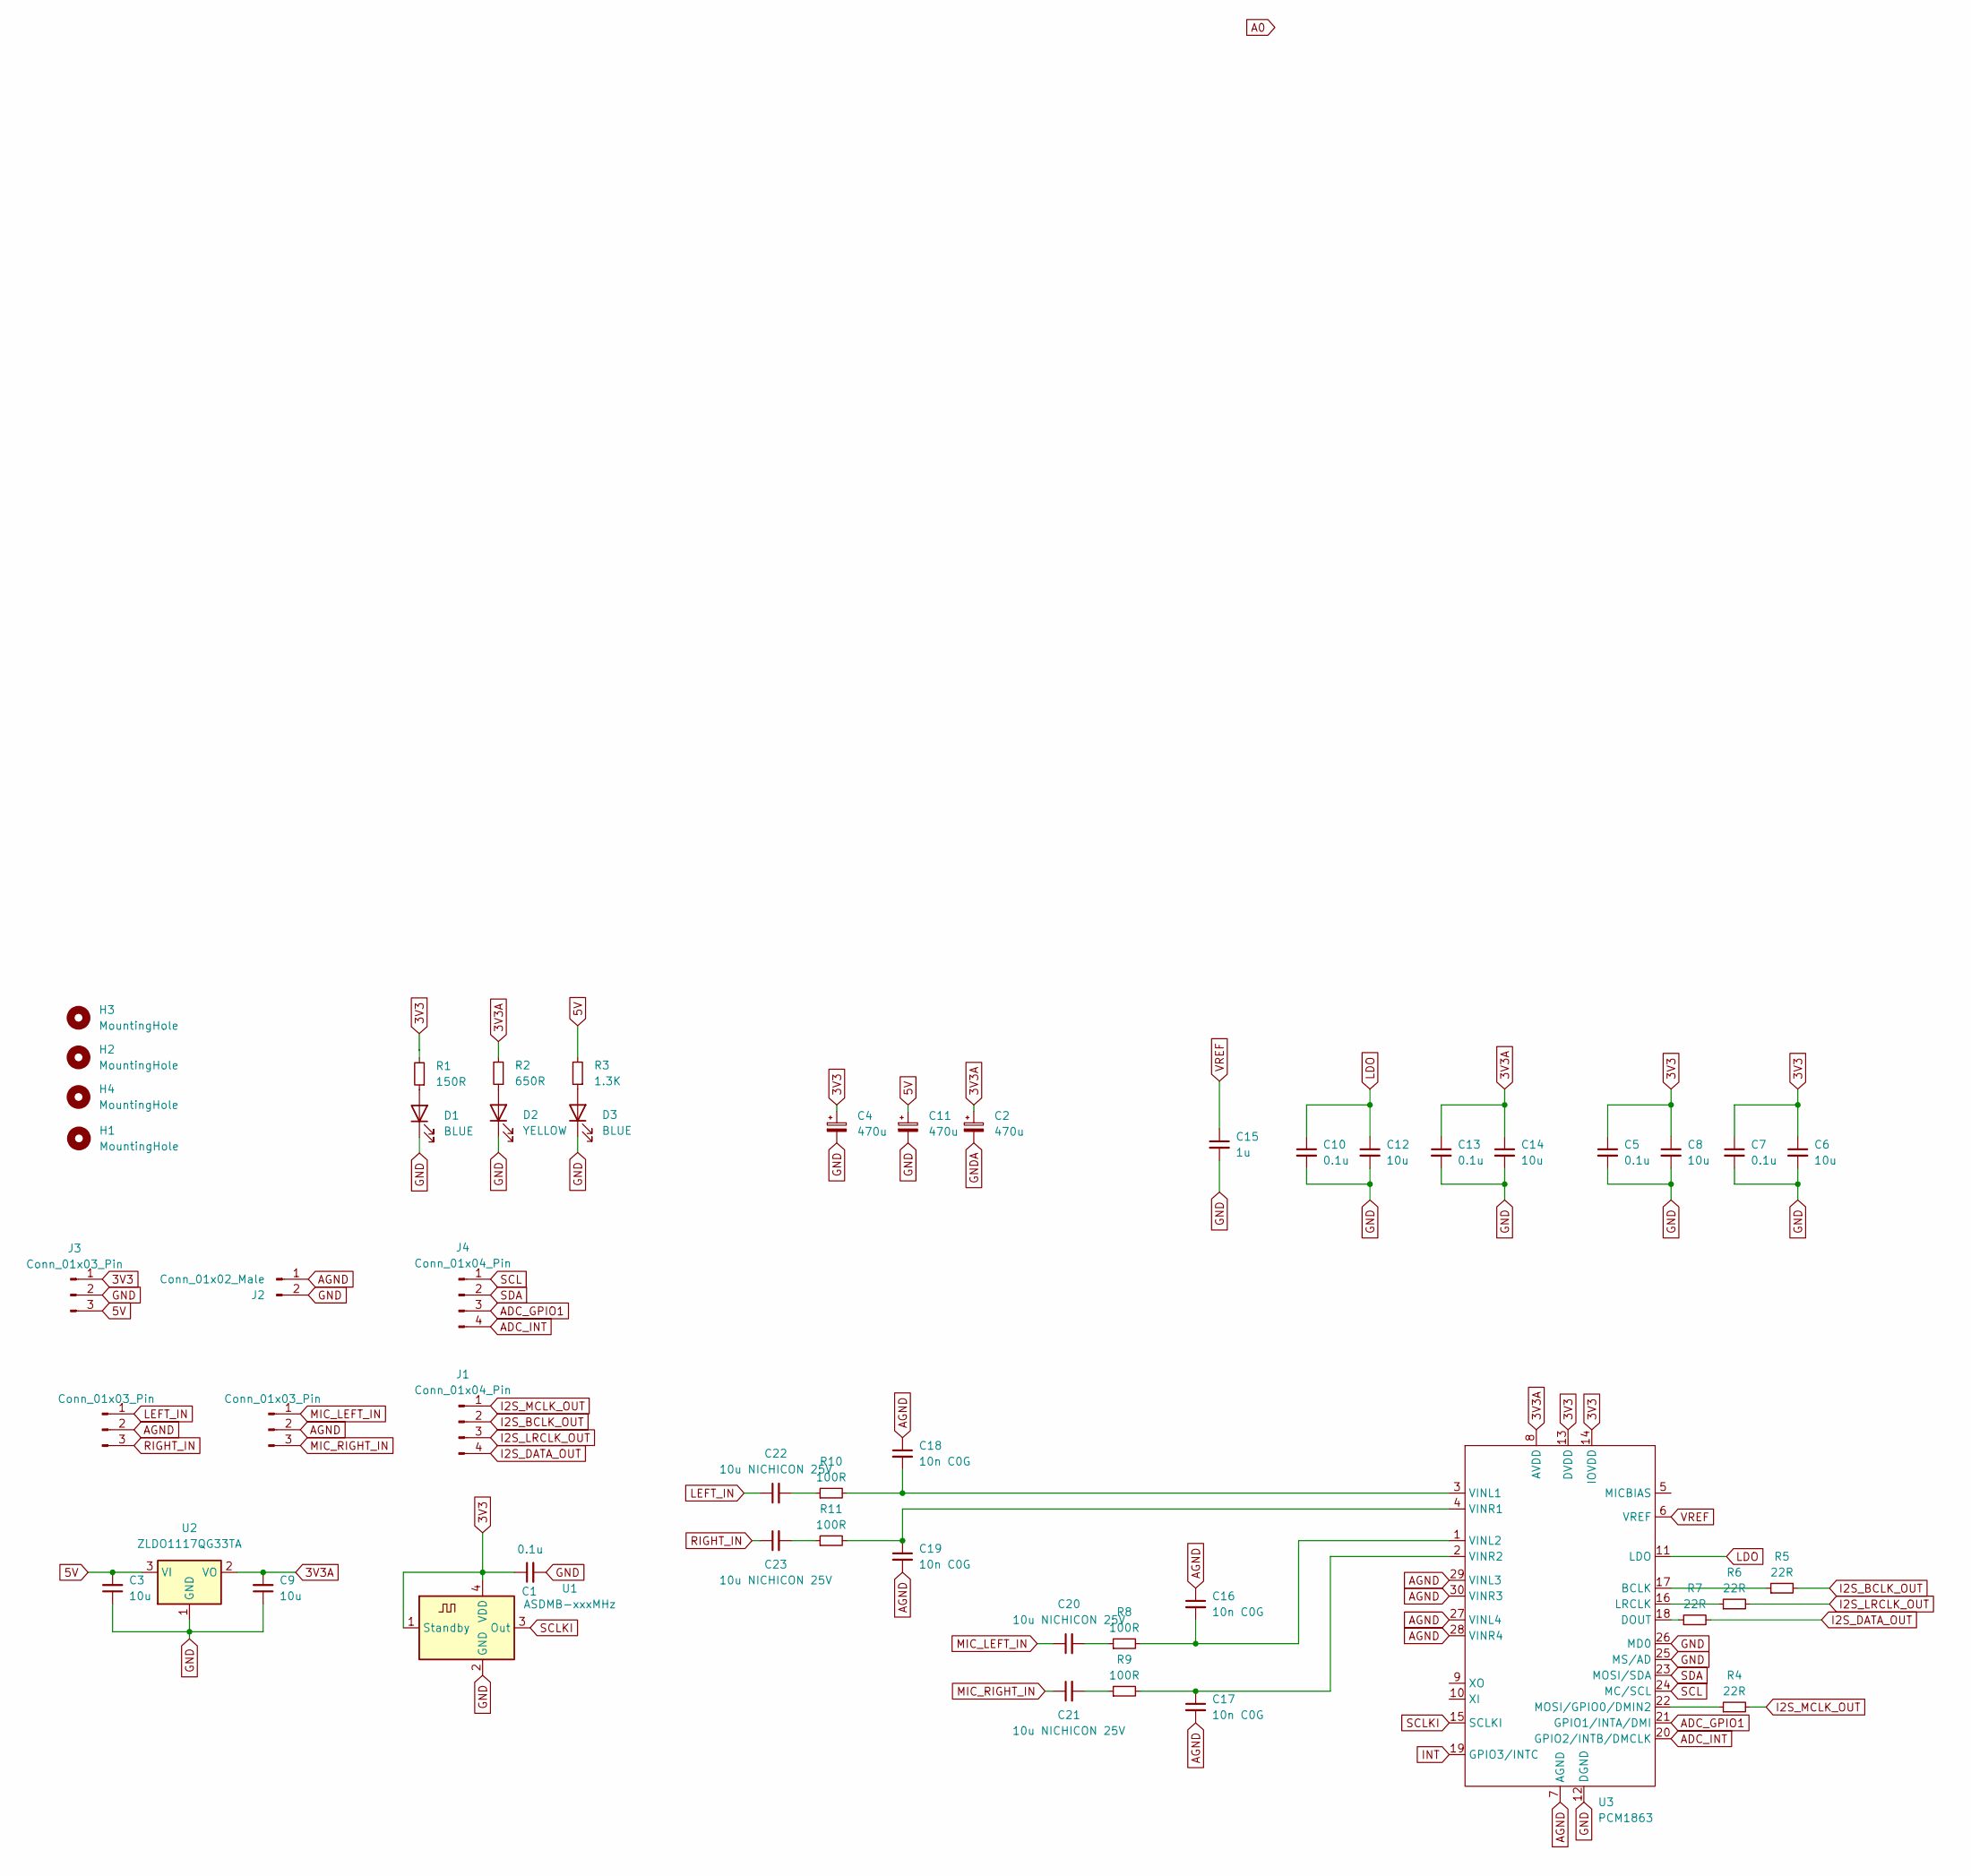
[picture p200: schematic adc.kicad_sch]

Parts:
C1: 0.1u; C_0805_2012Metric_Pad1.18x1.45mm_HandSolder; Mouser 791-0805N103G250CT
C2, C4, C11: 470u; CP_Radial_D6.3mm_P2.50mm
C3, C6, C8, C9, C12, C14: 10u; C_1206_3216Metric_Pad1.33x1.80mm_HandSolder
C5, C7, C10, C13: 0.1u; C_0805_2012Metric_Pad1.18x1.45mm_HandSolder
C15: 1u; C_1206_3216Metric_Pad1.33x1.80mm_HandSolder
C16, C17, C18, C19: 10n C0G; C_0805_2012Metric_Pad1.18x1.45mm_HandSolder; Mouser 791-0805N103G250CT
C20, C21, C22, C23: 10u NICHICON 25V; CP_Radial_D5.0mm_P2.00mm
D1, D3: BLUE; LED_0603_1608Metric
D2: YELLOW; LED_0603_1608Metric
H1, H2, H3, H4: MountingHole; MountingHole_3.2mm_M3_DIN965_Pad_TopOnly
J1, J4: Conn_01x04_Pin; JST_PH_B4B-PH-K_1x04_P2.00mm_Vertical
J2: Conn_01x02_Male; PinHeader_1x02_P2.54mm_Vertical
J3, J5, J6: Conn_01x03_Pin; JST_PH_B3B-PH-K_1x03_P2.00mm_Vertical
R1: 150R; R_0603_1608Metric_Pad0.98x0.95mm_HandSolder
R2: 650R; R_0603_1608Metric_Pad0.98x0.95mm_HandSolder
R3: 1.3K; R_0603_1608Metric_Pad0.98x0.95mm_HandSolder
R4, R5, R6, R7: 22R; R_0805_2012Metric_Pad1.20x1.40mm_HandSolder; Mouser 603-RT0805FRE0722RL
R8, R9, R10, R11: 100R; R_0805_2012Metric_Pad1.20x1.40mm_HandSolder; Mouser 603-RT0805FRE13100RL
U1: ASDMB-xxxMHz; Oscillator_SMD_Abracon_ASE-4Pin_3.2x2.5mm; Mouser 346-3225Z24.5760C1KX
U2: ZLDO1117QG33TA; SOT-223-3_TabPin2
U3: PCM1863; TSSOP-30_4.4x7.8mm_P0.5mm; Mouser 595-PCM1863DBT

Connections:
3V3: C1.1, C4.1, C5.1, C6.1, C7.1, C8.1, J3.1, R1.2, U1.1 (Standby), U1.4 (VDD), U3.13 (DVDD), U3.14 (IOVDD)
3V3A: C2.1, C9.2, C13.1, C14.1, R2.2, U2.2 (VO), U3.8 (AVDD)
5V: C3.2, C11.1, J3.3, R3.2, U2.3 (VI)
ADC_GPIO1: J4.3, U3.21 (GPIO1/INTA/DMI)
ADC_INT: J4.4, U3.20 (GPIO2/INTB/DMCLK)
AGND: C16.1, C17.2, C18.1, C19.2, J2.1, J5.2, J6.2, U3.7 (AGND), U3.27 (VINL4), U3.28 (VINR4), U3.29 (VINL3), U3.30 (VINR3)
GND: C1.2, C3.1, C4.2, C5.2, C6.2, C7.2, C8.2, C9.1, C10.2, C11.2, C12.2, C13.2, C14.2, C15.2, D1.1 (K), D2.1 (K), D3.1 (K), J2.2, J3.2, U1.2 (GND), U2.1 (GND), U3.12 (DGND), U3.25 (MS/AD), U3.26 (MD0)
GNDA: C2.2
I2S_BCLK_OUT: J1.2, R5.2
I2S_DATA_OUT: J1.4, R7.2
I2S_LRCLK_OUT: J1.3, R6.2
I2S_MCLK_OUT: J1.1, R4.2
INT: U3.19 (GPIO3/INTC)
LDO: C10.1, C12.1, U3.11 (LDO)
LEFT_IN: C22.1, J6.1
MIC_LEFT_IN: C20.1, J5.1
MIC_RIGHT_IN: C21.1, J5.3
unnamed: C16.2, R8.2, U3.1 (VINL2)
unnamed: C17.1, R9.2, U3.2 (VINR2)
unnamed: C18.2, R10.2, U3.3 (VINL1)
unnamed: C19.1, R11.2, U3.4 (VINR1)
unnamed: C20.2, R8.1
unnamed: C21.2, R9.1
unnamed: C22.2, R10.1
unnamed: C23.2, R11.1
unnamed: D1.2 (A), R1.1
unnamed: D2.2 (A), R2.1
unnamed: D3.2 (A), R3.1
unnamed: R4.1, U3.22 (MOSI/GPIO0/DMIN2)
unnamed: R5.1, U3.17 (BCLK)
unnamed: R6.1, U3.16 (LRCLK)
unnamed: R7.1, U3.18 (DOUT)
RIGHT_IN: C23.1, J6.3
SCL: J4.1, U3.24 (MC/SCL)
SCLKI: U1.3 (Out), U3.15 (SCLKI)
SDA: J4.2, U3.23 (MOSI/SDA)
VREF: C15.1, U3.6 (VREF)
