duanestorey/hifi-amp/pcbs/adc/1.2/adc.kicad_sch

## KiCad design pcbs/adc/1.2/adc.kicad_sch (2025-10-22)

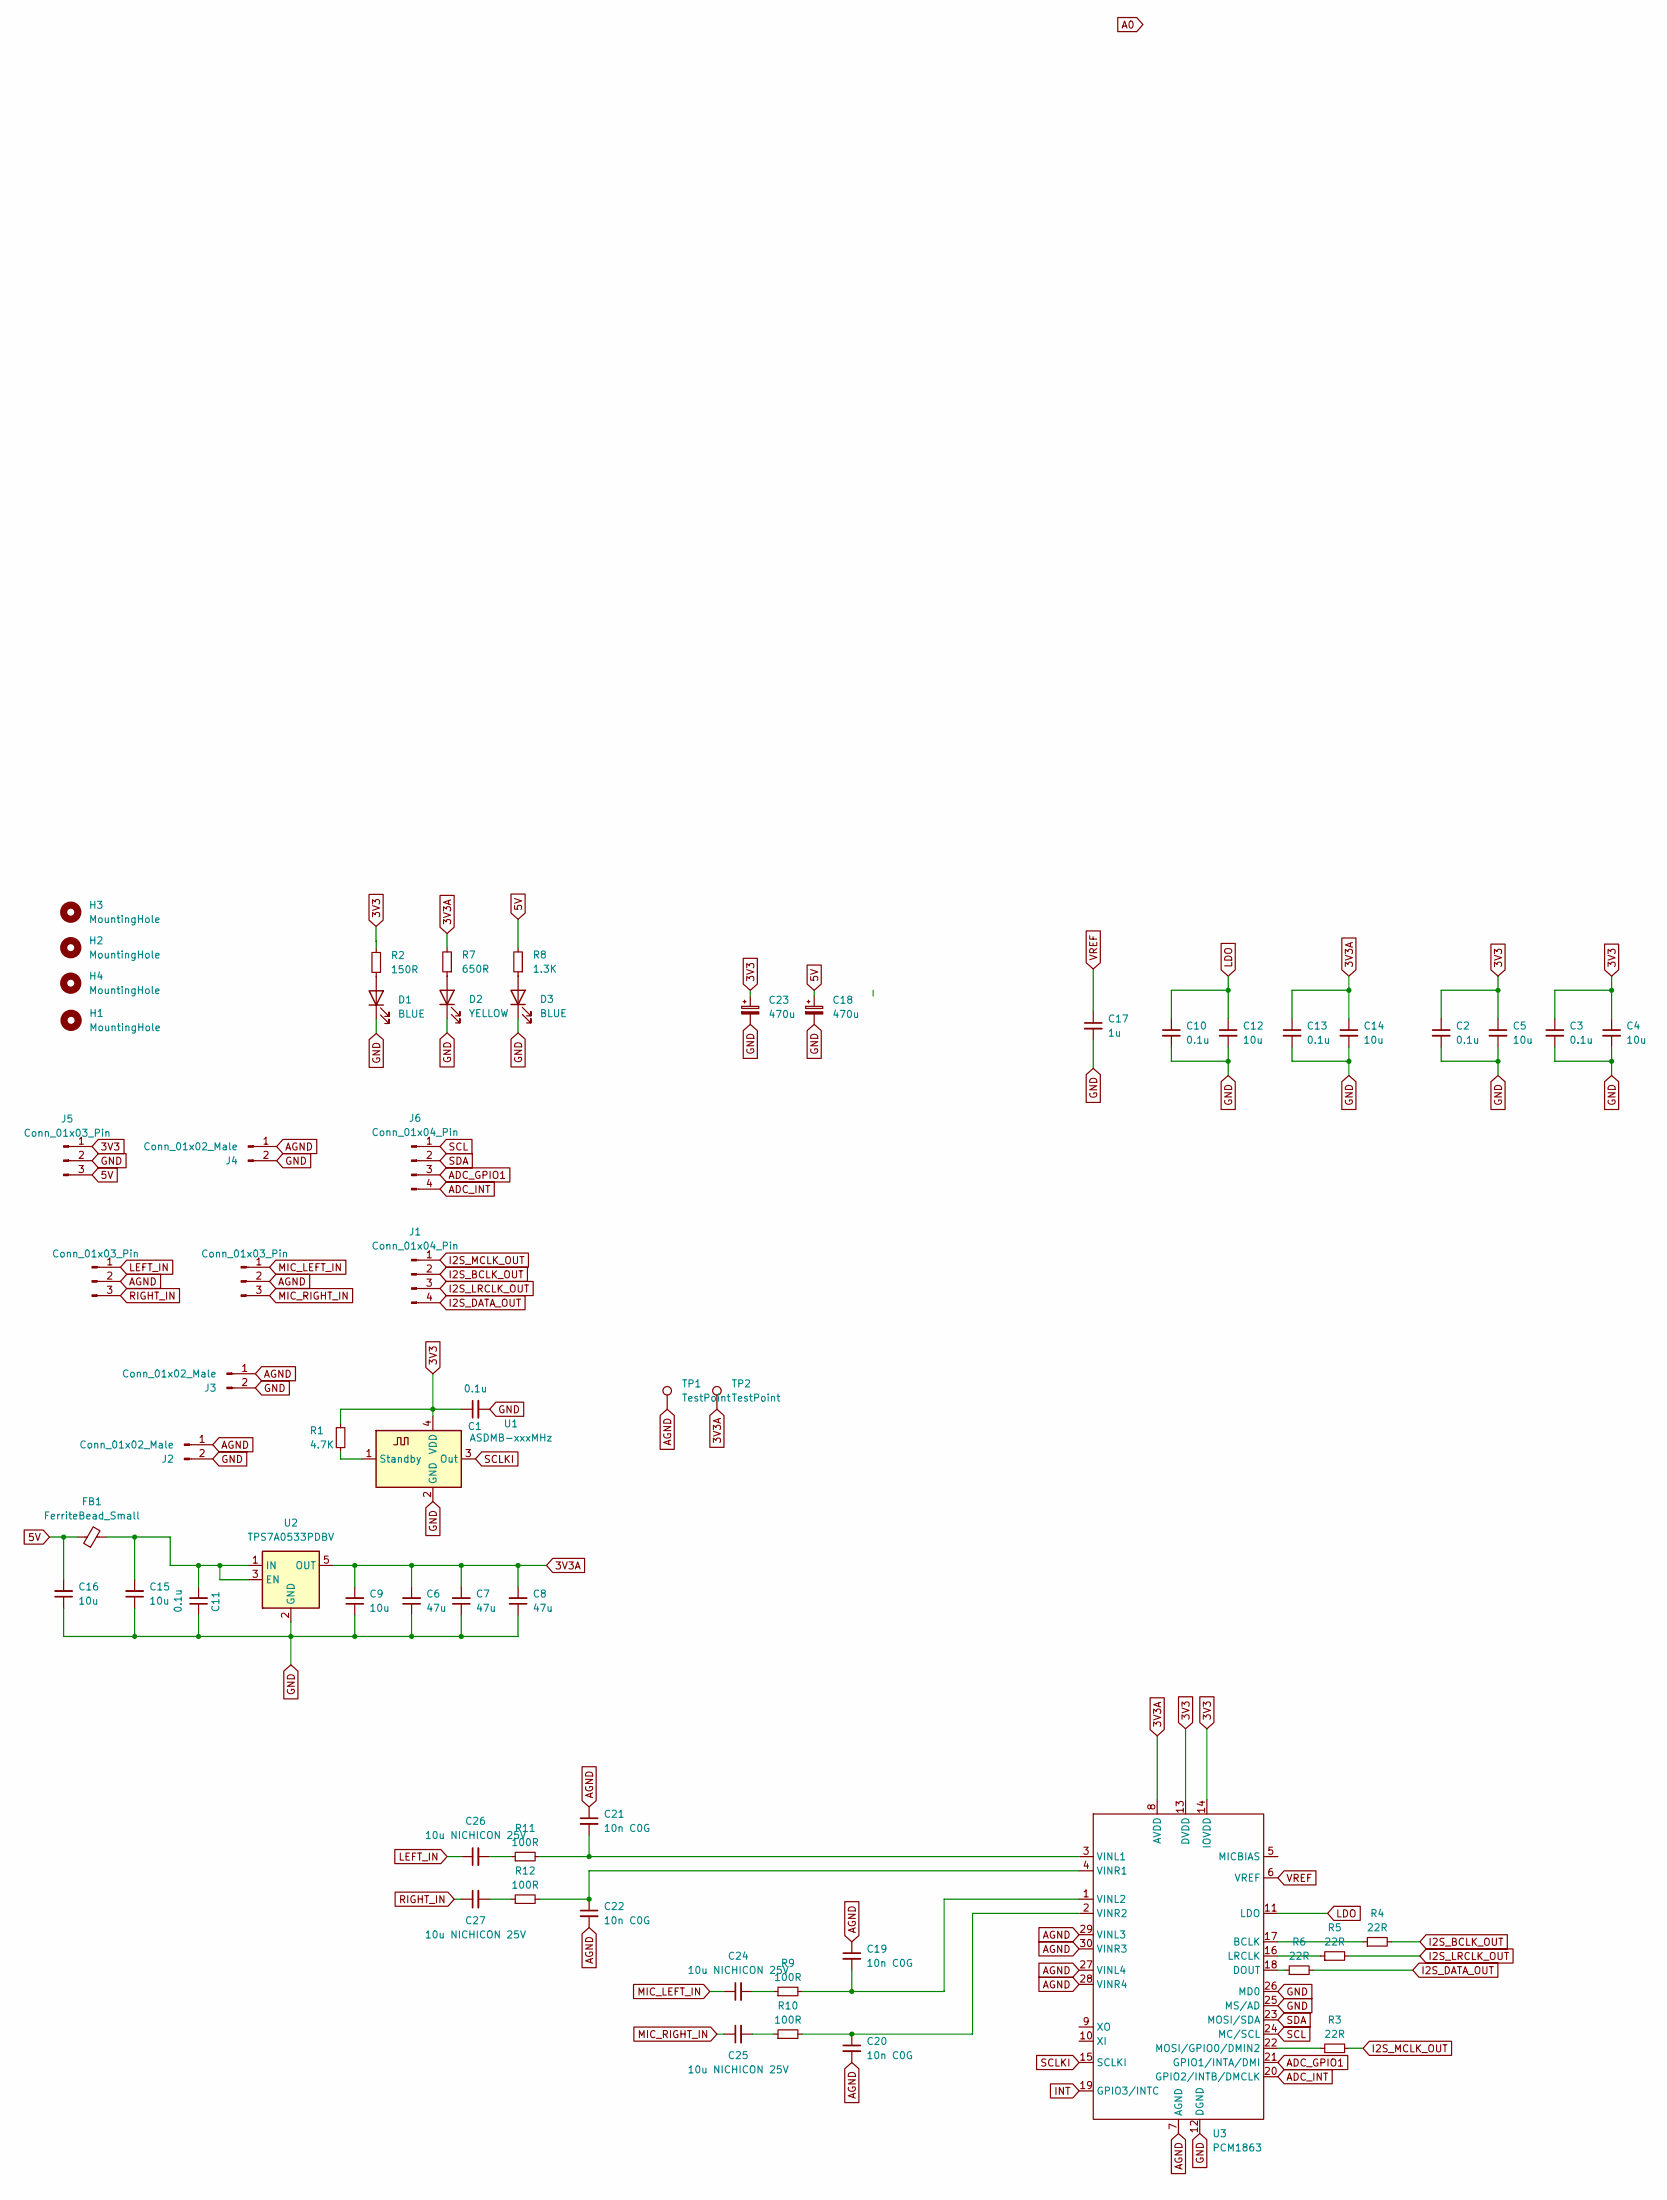
[picture p201: schematic adc.kicad_sch]

Parts:
C1, C11: 0.1u; C_0805_2012Metric_Pad1.18x1.45mm_HandSolder; Mouser 791-0805N103G250CT
C2, C3, C10, C13: 0.1u; C_0805_2012Metric_Pad1.18x1.45mm_HandSolder
C4, C5, C9, C12, C14, C15, C16: 10u; C_1206_3216Metric_Pad1.33x1.80mm_HandSolder
C6, C7, C8: 47u; C_1206_3216Metric_Pad1.33x1.80mm_HandSolder
C17: 1u; C_1206_3216Metric_Pad1.33x1.80mm_HandSolder
C18, C23: 470u; CP_Radial_D6.3mm_P2.50mm
C19, C20, C21, C22: 10n C0G; C_0805_2012Metric_Pad1.18x1.45mm_HandSolder; Mouser 791-0805N103G250CT
C24, C25, C26, C27: 10u NICHICON 25V; CP_Radial_D5.0mm_P2.00mm
D1, D3: BLUE; LED_0603_1608Metric
D2: YELLOW; LED_0603_1608Metric
FB1: FerriteBead_Small; R_0603_1608Metric_Pad0.98x0.95mm_HandSolder
H1, H2, H3, H4: MountingHole; MountingHole_3.2mm_M3_DIN965_Pad_TopOnly
J1, J6: Conn_01x04_Pin; JST_PH_B4B-PH-K_1x04_P2.00mm_Vertical
J2, J3, J4: Conn_01x02_Male; PinHeader_1x02_P2.54mm_Vertical
J5, J7, J8: Conn_01x03_Pin; JST_PH_B3B-PH-K_1x03_P2.00mm_Vertical
R1: 4.7K; R_0603_1608Metric_Pad0.98x0.95mm_HandSolder; Mouser 603-RT0805FRE0722RL
R2: 150R; R_0603_1608Metric_Pad0.98x0.95mm_HandSolder
R3, R4, R5, R6: 22R; R_0805_2012Metric_Pad1.20x1.40mm_HandSolder; Mouser 603-RT0805FRE0722RL
R7: 650R; R_0603_1608Metric_Pad0.98x0.95mm_HandSolder
R8: 1.3K; R_0603_1608Metric_Pad0.98x0.95mm_HandSolder
R9, R10, R11, R12: 100R; R_0805_2012Metric_Pad1.20x1.40mm_HandSolder; Mouser 603-RT0805FRE13100RL
TP1, TP2: TestPoint; TestPoint_THTPad_2.5x2.5mm_Drill1.2mm
U1: ASDMB-xxxMHz; Oscillator_SMD_Abracon_ASE-4Pin_3.2x2.5mm; Mouser 346-3225Z24.5760C1KX
U2: TPS7A0533PDBV; SOT-23-5
U3: PCM1863; TSSOP-30_4.4x7.8mm_P0.5mm; Mouser 595-PCM1863DBT

Connections:
3V3: C1.1, C2.1, C3.1, C4.1, C5.1, C23.1, J5.1, R1.1, R2.2, U1.4 (VDD), U3.13 (DVDD), U3.14 (IOVDD)
3V3A: C6.2, C7.2, C8.2, C9.2, C13.1, C14.1, R7.2, TP2.1, U2.5 (OUT), U3.8 (AVDD)
5V: C16.2, C18.1, FB1.1, J5.3, R8.2
ADC_GPIO1: J6.3, U3.21 (GPIO1/INTA/DMI)
ADC_INT: J6.4, U3.20 (GPIO2/INTB/DMCLK)
AGND: C19.1, C20.2, C21.1, C22.2, J2.1, J3.1, J4.1, J7.2, J8.2, TP1.1, U3.7 (AGND), U3.27 (VINL4), U3.28 (VINR4), U3.29 (VINL3), U3.30 (VINR3)
GND: C1.2, C2.2, C3.2, C4.2, C5.2, C6.1, C7.1, C8.1, C9.1, C10.2, C11.1, C12.2, C13.2, C14.2, C15.1, C16.1, C17.2, C18.2, C23.2, D1.1 (K), D2.1 (K), D3.1 (K), J2.2, J3.2, J4.2, J5.2, U1.2 (GND), U2.2 (GND), U3.12 (DGND), U3.25 (MS/AD), U3.26 (MD0)
I2S_BCLK_OUT: J1.2, R4.2
I2S_DATA_OUT: J1.4, R6.2
I2S_LRCLK_OUT: J1.3, R5.2
I2S_MCLK_OUT: J1.1, R3.2
INT: U3.19 (GPIO3/INTC)
LDO: C10.1, C12.1, U3.11 (LDO)
LEFT_IN: C26.1, J8.1
MIC_LEFT_IN: C24.1, J7.1
MIC_RIGHT_IN: C25.1, J7.3
unnamed: C11.2, C15.2, FB1.2, U2.1 (IN), U2.3 (EN)
unnamed: C19.2, R9.2, U3.1 (VINL2)
unnamed: C20.1, R10.2, U3.2 (VINR2)
unnamed: C21.2, R11.2, U3.3 (VINL1)
unnamed: C22.1, R12.2, U3.4 (VINR1)
unnamed: C24.2, R9.1
unnamed: C25.2, R10.1
unnamed: C26.2, R11.1
unnamed: C27.2, R12.1
unnamed: D1.2 (A), R2.1
unnamed: D2.2 (A), R7.1
unnamed: D3.2 (A), R8.1
unnamed: R1.2, U1.1 (Standby)
unnamed: R3.1, U3.22 (MOSI/GPIO0/DMIN2)
unnamed: R4.1, U3.17 (BCLK)
unnamed: R5.1, U3.16 (LRCLK)
unnamed: R6.1, U3.18 (DOUT)
RIGHT_IN: C27.1, J8.3
SCL: J6.1, U3.24 (MC/SCL)
SCLKI: U1.3 (Out), U3.15 (SCLKI)
SDA: J6.2, U3.23 (MOSI/SDA)
VREF: C17.1, U3.6 (VREF)
