duanestorey/hifi-amp/pcbs/dac-pcm5142/1.1/dac.kicad_sch

## KiCad design pcbs/dac-pcm5142/1.1/dac.kicad_sch (2025-02-21)

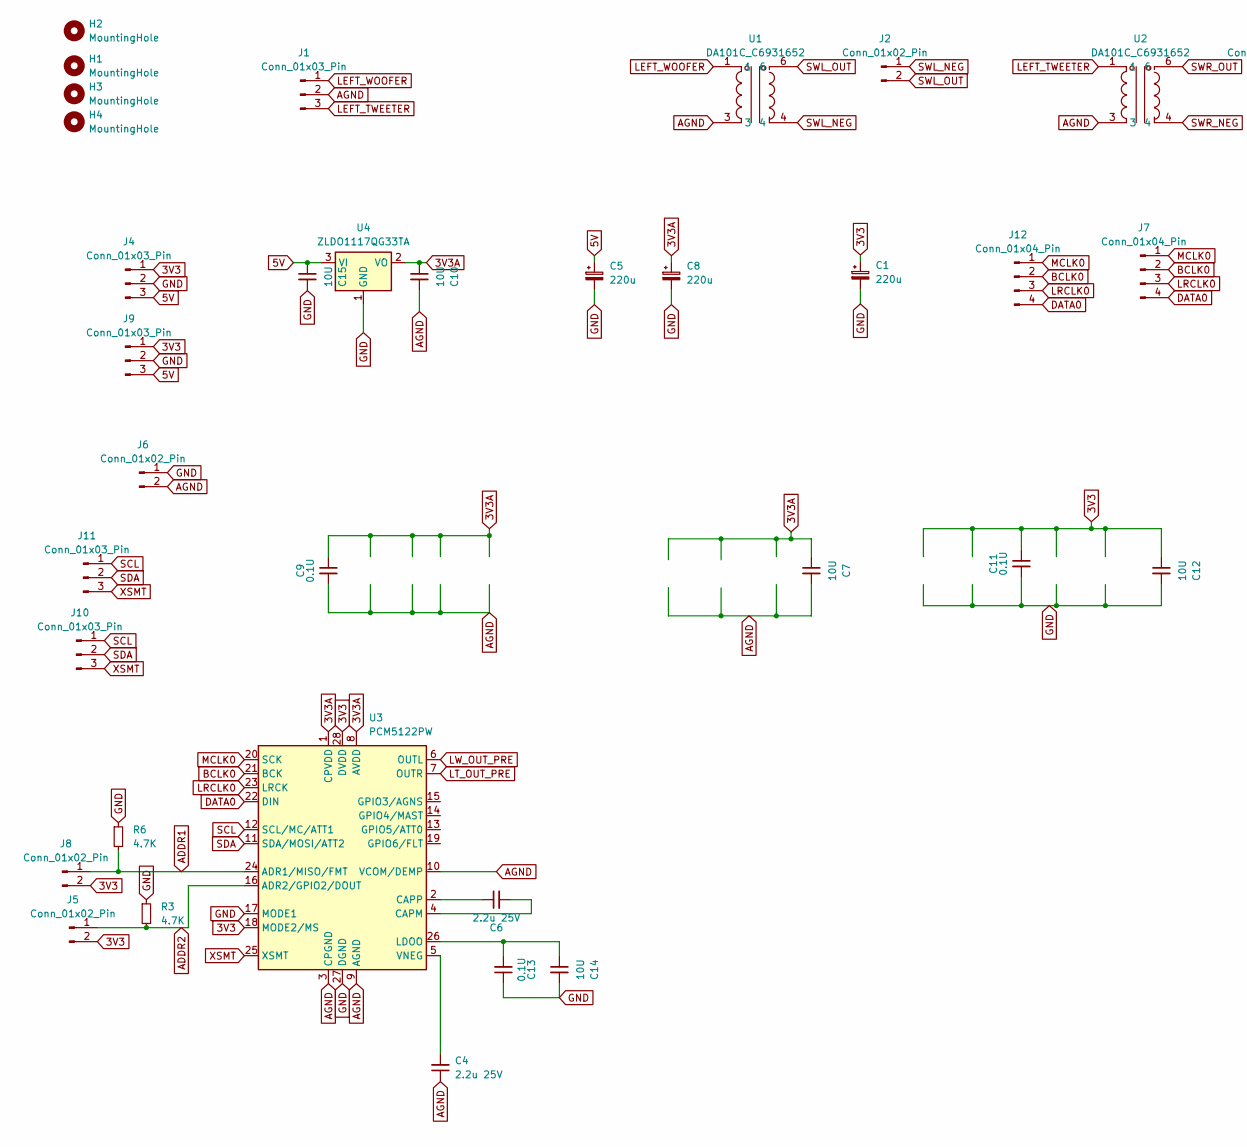
[picture p202: schematic dac.kicad_sch, part in row 1, column 1]

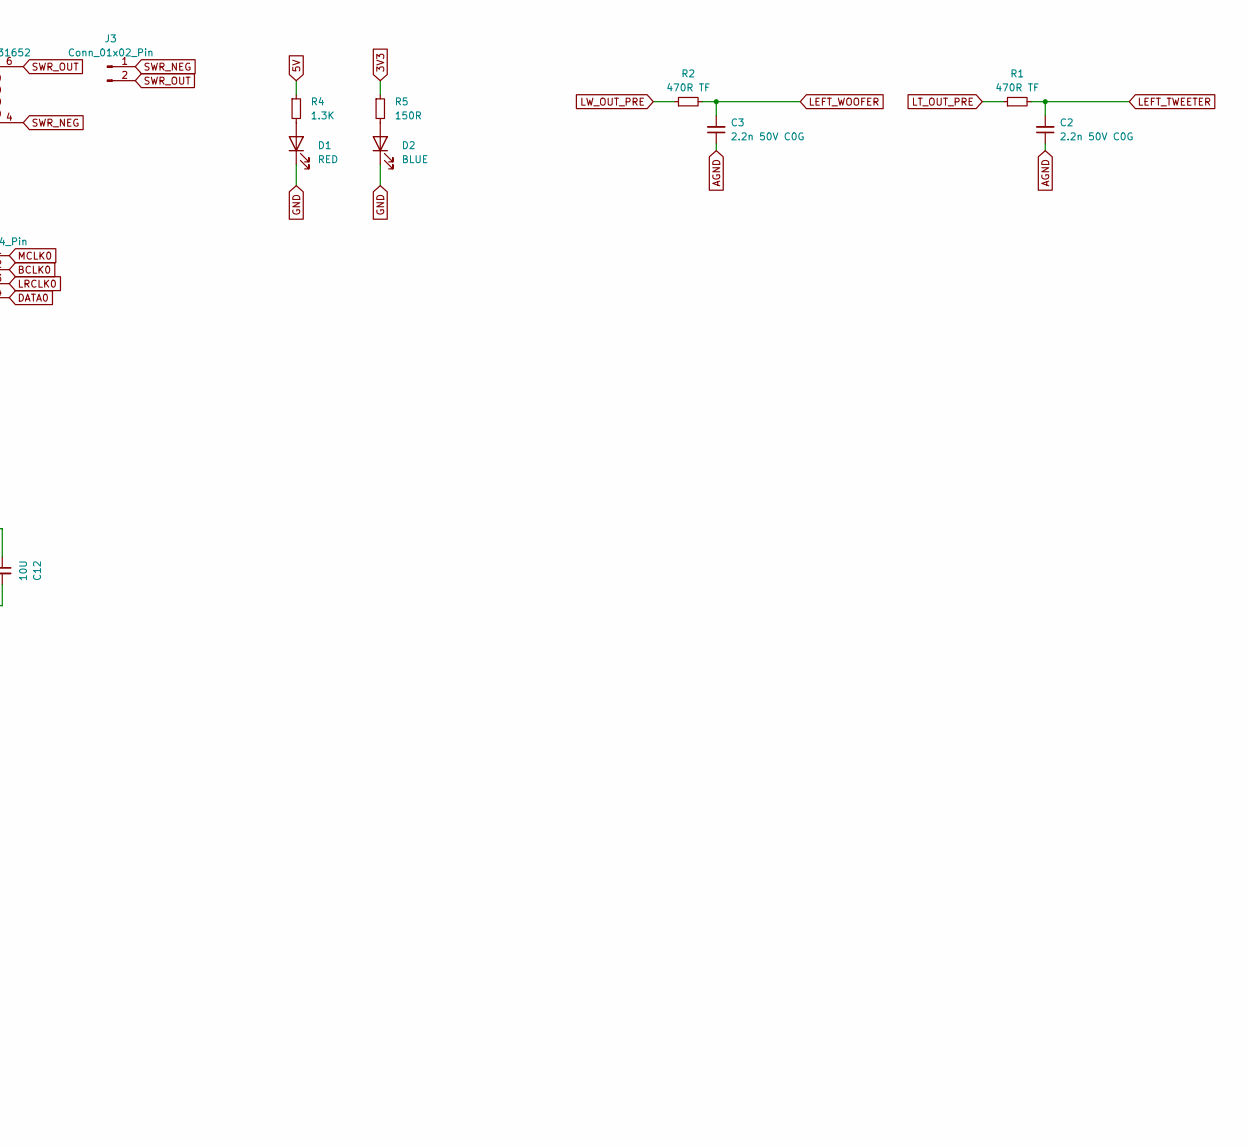
[picture p203: schematic dac.kicad_sch, part in row 1, column 2]

Parts:
C1, C5, C8: 220u; CP_Radial_D6.3mm_P2.50mm
C2, C3: 2.2n 50V C0G; C_0805_2012Metric_Pad1.18x1.45mm_HandSolder; Mouser 791-0805N222F500CT
C4: 2.2u 25V; C_1206_3216Metric_Pad1.33x1.80mm_HandSolder; Mouser 603-CC1206JKX78BB225
C6: 2.2u 25V; C_0805_2012Metric_Pad1.18x1.45mm_HandSolder; Mouser 603-CC1206JKX78BB225
C7, C10, C12, C14, C15: 10U; C_1206_3216Metric_Pad1.33x1.80mm_HandSolder
C9, C11, C13: 0.1U; C_0805_2012Metric_Pad1.18x1.45mm_HandSolder
D1: RED; LED_0603_1608Metric
D2: BLUE; LED_0603_1608Metric
H1, H2, H3, H4: MountingHole; MountingHole_3.2mm_M3_DIN965_Pad_TopOnly
J1, J4, J9, J10, J11: Conn_01x03_Pin; JST_PH_B3B-PH-K_1x03_P2.00mm_Vertical
J2, J3: Conn_01x02_Pin; JST_PH_B2B-PH-K_1x02_P2.00mm_Vertical
J5, J6, J8: Conn_01x02_Pin; PinHeader_1x02_P2.54mm_Vertical
J7, J12: Conn_01x04_Pin; JST_PH_B4B-PH-K_1x04_P2.00mm_Vertical
R1, R2: 470R TF; R_0805_2012Metric_Pad1.20x1.40mm_HandSolder; Mouser 603-RT0805FRE07470RL
R3, R6: 4.7K; R_0603_1608Metric_Pad0.98x0.95mm_HandSolder
R4: 1.3K; R_0603_1608Metric_Pad0.98x0.95mm_HandSolder
R5: 150R; R_0603_1608Metric_Pad0.98x0.95mm_HandSolder
U1, U2: DA101C_C6931652; XFMR-TH_4P-L9.5-W9.0-P5.08-LS10.2_C9900096976; LCSC Part C6931652
U3: PCM5122PW; TSSOP-28_4.4x9.7mm_P0.65mm; Mouser 595-PCM5122PWR
U4: ZLDO1117QG33TA; SOT-223-3_TabPin2

Connections:
3V3: C1.1, C11.1, C12.1, J4.1, J5.2, J8.2, J9.1, R5.1, U3.18 (MODE2/MS), U3.28 (DVDD)
3V3A: C7.1, C8.1, C9.1, C10.1, U3.1 (CPVDD), U3.8 (AVDD), U4.2 (VO)
5V: C5.1, C15.1, J4.3, J9.3, R4.1, U4.3 (VI)
ADDR1: J8.1, R6.2, U3.24 (ADR1/MISO/FMT)
ADDR2: J5.1, R3.2, U3.16 (ADR2/GPIO2/DOUT)
AGND: C2.1, C3.1, C4.1, C7.2, C9.2, C10.2, J1.2, J6.2, U1.3, U2.3, U3.3 (CPGND), U3.9 (AGND), U3.10 (VCOM/DEMP)
BCLK0: J7.2, J12.2, U3.21 (BCK)
DATA0: J7.4, J12.4, U3.22 (DIN)
GND: C1.2, C5.2, C8.2, C11.2, C12.2, C13.1, C14.2, C15.2, D1.1 (K), D2.1 (K), J4.2, J6.1, J9.2, R3.1, R6.1, U3.17 (MODE1), U3.27 (DGND), U4.1 (GND)
LEFT_TWEETER: C2.2, J1.3, R1.2, U2.1
LEFT_WOOFER: C3.2, J1.1, R2.2, U1.1
LRCLK0: J7.3, J12.3, U3.23 (LRCK)
LT_OUT_PRE: R1.1, U3.7 (OUTR)
LW_OUT_PRE: R2.1, U3.6 (OUTL)
MCLK0: J7.1, J12.1, U3.20 (SCK)
unnamed: C4.2, U3.5 (VNEG)
unnamed: C6.1, U3.2 (CAPP)
unnamed: C6.2, U3.4 (CAPM)
unnamed: C13.2, C14.1, U3.26 (LDOO)
unnamed: D1.2 (A), R4.2
unnamed: D2.2 (A), R5.2
SCL: J10.1, J11.1, U3.12 (SCL/MC/ATT1)
SDA: J10.2, J11.2, U3.11 (SDA/MOSI/ATT2)
SWL_NEG: J2.1, U1.4
SWL_OUT: J2.2, U1.6
SWR_NEG: J3.1, U2.4
SWR_OUT: J3.2, U2.6
XSMT: J10.3, J11.3, U3.25 (XSMT)
