duanestorey/hifi-amp/pcbs/dac-pcm5142/1.3/dac.kicad_sch

## KiCad design pcbs/dac-pcm5142/1.3/dac.kicad_sch (2025-10-22)

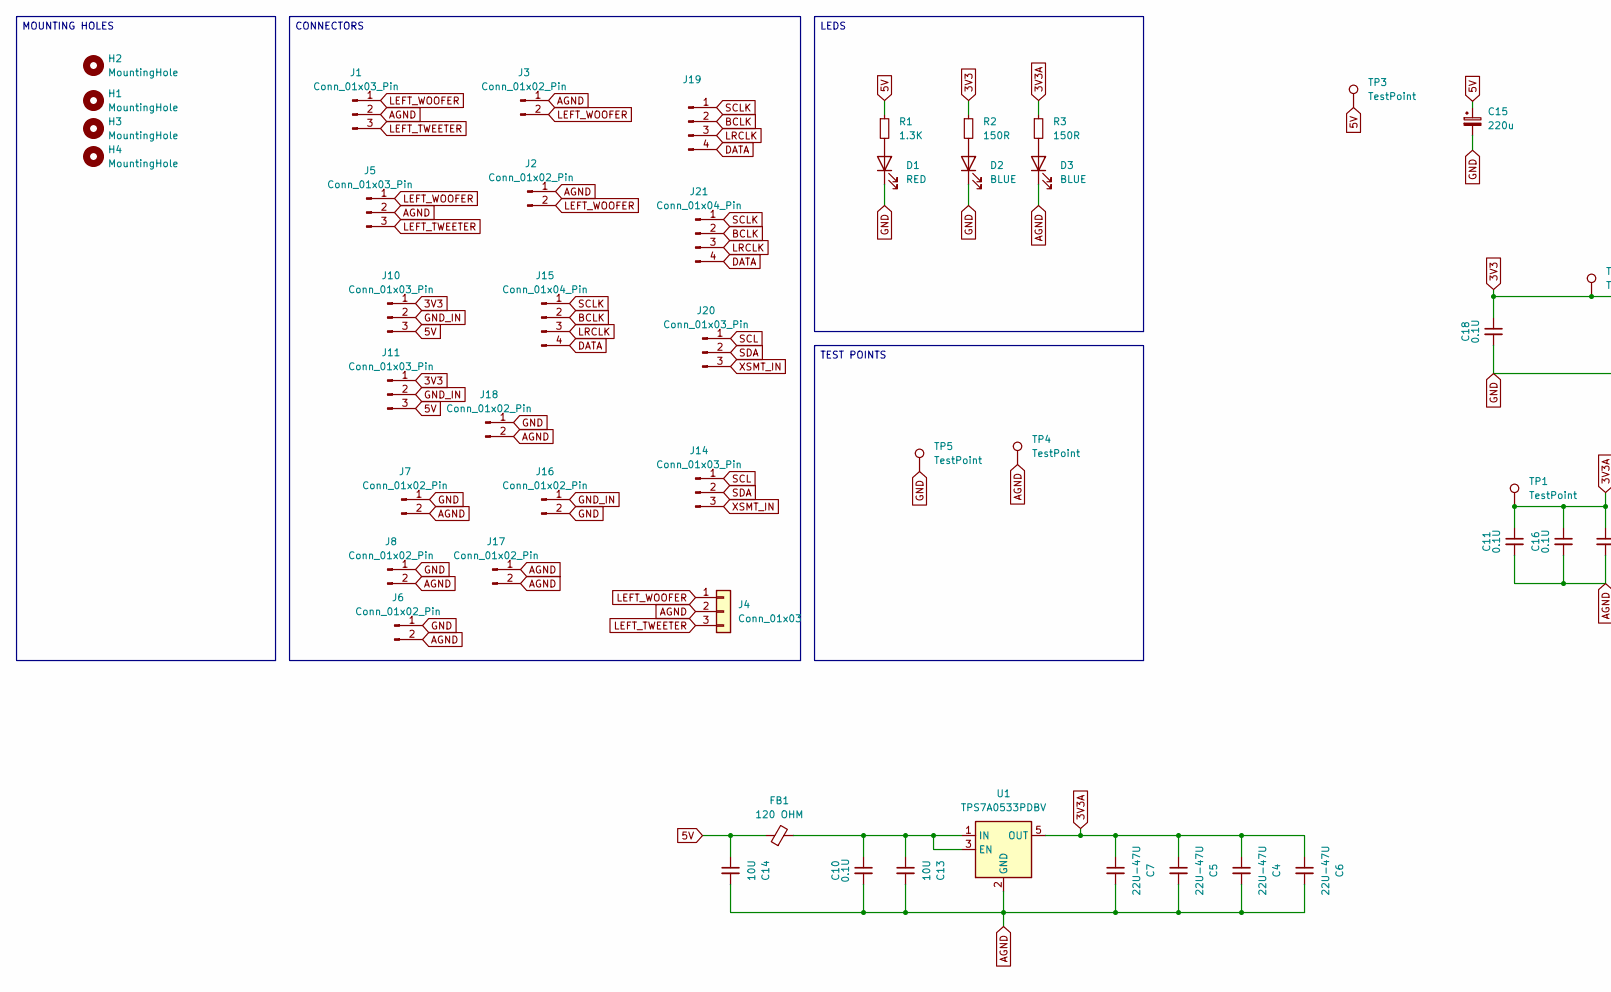
[picture p204: schematic dac.kicad_sch, part in row 1, column 1]

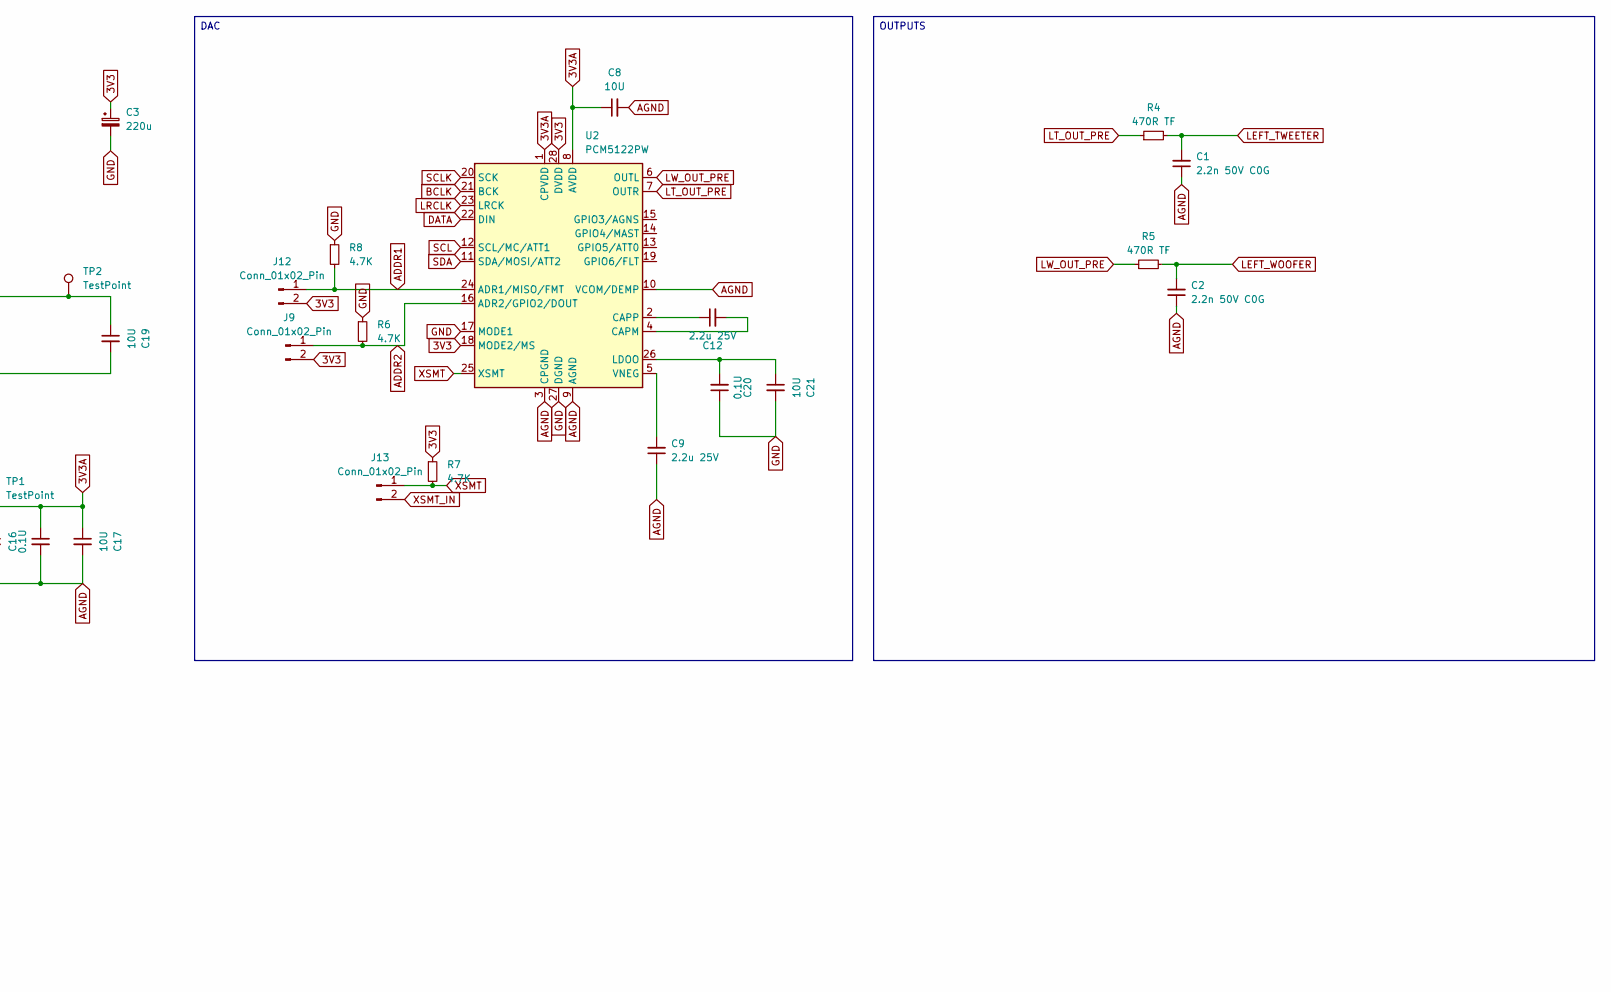
[picture p205: schematic dac.kicad_sch, part in row 1, column 2]

Parts:
C1, C2: 2.2n 50V C0G; C_0805_2012Metric_Pad1.18x1.45mm_HandSolder; Mouser 791-0805N222G500CT
C3, C15: 220u; CP_Radial_D6.3mm_P2.50mm
C4, C5, C6, C7: 22U-47U; C_1206_3216Metric_Pad1.33x1.80mm_HandSolder
C8, C13, C14, C17, C19, C21: 10U; C_1206_3216Metric_Pad1.33x1.80mm_HandSolder
C9, C12: 2.2u 25V; C_1206_3216Metric_Pad1.33x1.80mm_HandSolder; Mouser 603-CC1206JKX78BB225
C10, C11, C16, C18, C20: 0.1U; C_0805_2012Metric_Pad1.18x1.45mm_HandSolder
D1: RED; LED_0805_2012Metric_Pad1.15x1.40mm_HandSolder
D2, D3: BLUE; LED_0805_2012Metric_Pad1.15x1.40mm_HandSolder
FB1: 120 OHM; R_0603_1608Metric_Pad0.98x0.95mm_HandSolder
H1, H2, H3, H4: MountingHole; MountingHole_3.2mm_M3_DIN965_Pad_TopOnly
J1, J10, J11, J14, J20: Conn_01x03_Pin; JST_PH_B3B-PH-K_1x03_P2.00mm_Vertical
J2, J3, J17: Conn_01x02_Pin; JST_PH_B2B-PH-K_1x02_P2.00mm_Vertical
J4: Conn_01x03; TerminalBlock_Phoenix_PT-1,5-3-3.5-H_1x03_P3.50mm_Horizontal
J5: Conn_01x03_Pin; PinHeader_1x03_P2.54mm_Vertical
J6, J7, J8, J9, J12, J13, J16, J18: Conn_01x02_Pin; PinHeader_1x02_P2.54mm_Vertical
J15, J19: Conn_01x04_Pin; JST_PH_B4B-PH-K_1x04_P2.00mm_Vertical
J21: Conn_01x04_Pin; PinHeader_1x04_P2.54mm_Vertical
R1: 1.3K; R_0603_1608Metric_Pad0.98x0.95mm_HandSolder
R2, R3: 150R; R_0603_1608Metric_Pad0.98x0.95mm_HandSolder
R4, R5: 470R TF; R_0805_2012Metric_Pad1.20x1.40mm_HandSolder; Mouser 603-RT0805FRE07470RL
R6, R7, R8: 4.7K; R_0603_1608Metric_Pad0.98x0.95mm_HandSolder
TP1, TP2, TP3, TP4, TP5: TestPoint; TestPoint_THTPad_D2.0mm_Drill1.0mm
U1: TPS7A0533PDBV; SOT-23-5
U2: PCM5122PW; TSSOP-28_4.4x9.7mm_P0.65mm; Mouser 595-PCM5122PWR

Connections:
3V3: C3.1, C18.1, C19.1, J9.2, J10.1, J11.1, J12.2, R2.1, R7.1, TP2.1, U2.18 (MODE2/MS), U2.28 (DVDD)
3V3A: C4.1, C5.1, C6.1, C7.1, C8.1, C11.1, C16.1, C17.1, R3.1, TP1.1, U1.5 (OUT), U2.1 (CPVDD), U2.8 (AVDD)
5V: C14.1, C15.1, FB1.1, J10.3, J11.3, R1.1, TP3.1
ADDR1: J12.1, R8.2, U2.24 (ADR1/MISO/FMT)
ADDR2: J9.1, R6.2, U2.16 (ADR2/GPIO2/DOUT)
AGND: C1.1, C2.1, C4.2, C5.2, C6.2, C7.2, C8.2, C9.1, C10.2, C11.2, C13.2, C14.2, C16.2, C17.2, D3.1 (K), J1.2, J2.1, J3.1, J4.2, J5.2, J6.2, J7.2, J8.2, J17.1, J17.2, J18.2, TP4.1, U1.2 (GND), U2.3 (CPGND), U2.9 (AGND), U2.10 (VCOM/DEMP)
BCLK: J15.2, J19.2, J21.2, U2.21 (BCK)
DATA: J15.4, J19.4, J21.4, U2.22 (DIN)
GND: C3.2, C15.2, C18.2, C19.2, C20.1, C21.2, D1.1 (K), D2.1 (K), J6.1, J7.1, J8.1, J16.2, J18.1, R6.1, R8.1, TP5.1, U2.17 (MODE1), U2.27 (DGND)
GND_IN: J10.2, J11.2, J16.1
LEFT_TWEETER: C1.2, J1.3, J4.3, J5.3, R4.2
LEFT_WOOFER: C2.2, J1.1, J2.2, J3.2, J4.1, J5.1, R5.2
LRCLK: J15.3, J19.3, J21.3, U2.23 (LRCK)
LT_OUT_PRE: R4.1, U2.7 (OUTR)
LW_OUT_PRE: R5.1, U2.6 (OUTL)
unnamed: C9.2, U2.5 (VNEG)
unnamed: C10.1, C13.1, FB1.2, U1.1 (IN), U1.3 (EN)
unnamed: C12.1, U2.2 (CAPP)
unnamed: C12.2, U2.4 (CAPM)
unnamed: C20.2, C21.1, U2.26 (LDOO)
unnamed: D1.2 (A), R1.2
unnamed: D2.2 (A), R2.2
unnamed: D3.2 (A), R3.2
SCL: J14.1, J20.1, U2.12 (SCL/MC/ATT1)
SCLK: J15.1, J19.1, J21.1, U2.20 (SCK)
SDA: J14.2, J20.2, U2.11 (SDA/MOSI/ATT2)
XSMT: J13.1, R7.2, U2.25 (XSMT)
XSMT_IN: J13.2, J14.3, J20.3

Notes on the sheet:
MOUNTING HOLES
TEST POINTS
CONNECTORS
OUTPUTS
DAC
LEDS
