duanestorey/hifi-amp/pcbs/dsp/1.3/dsp.kicad_sch

## KiCad design pcbs/dsp/1.3/dsp.kicad_sch (2025-05-14)

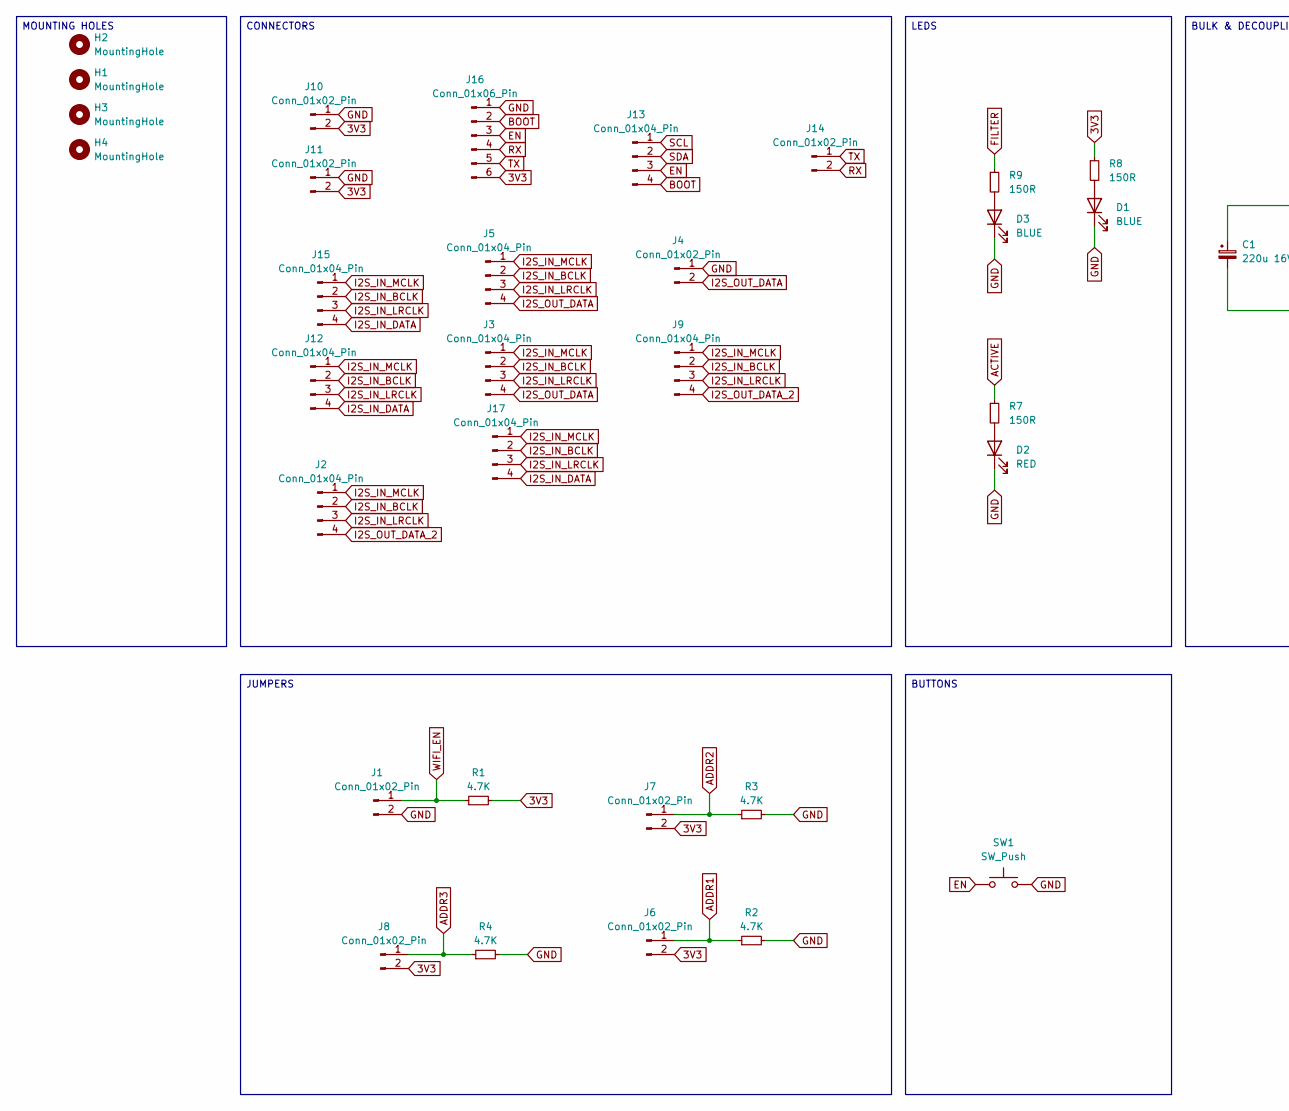
[picture p210: schematic dsp.kicad_sch, part in row 1, column 1]

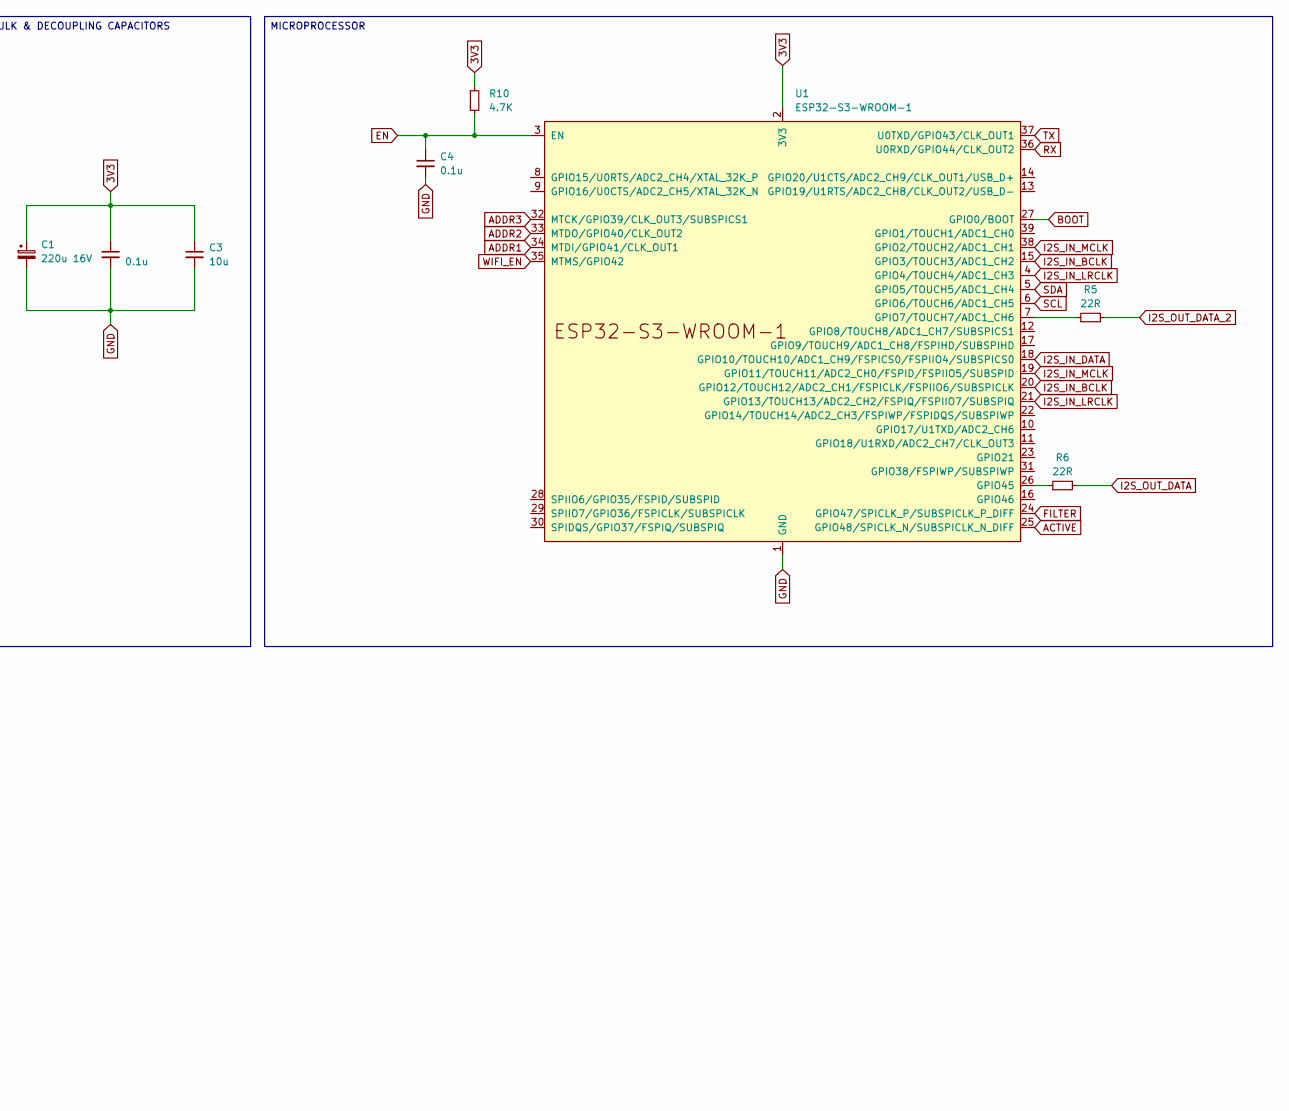
[picture p211: schematic dsp.kicad_sch, part in row 1, column 2]

Parts:
C1: 220u 16V; CP_Radial_D6.3mm_P2.50mm
C2, C4: 0.1u; C_0805_2012Metric_Pad1.18x1.45mm_HandSolder
C3: 10u; C_1206_3216Metric_Pad1.33x1.80mm_HandSolder
D1, D3: BLUE; D_0805_2012Metric_Pad1.15x1.40mm_HandSolder; LCSC C84259
D2: RED; D_0805_2012Metric_Pad1.15x1.40mm_HandSolder; LCSC C84259
H1, H2, H3, H4: MountingHole; MountingHole_3.2mm_M3_DIN965_Pad_TopOnly
J1, J6, J7, J8: Conn_01x02_Pin; PinHeader_1x02_P2.54mm_Vertical
J2, J3, J12, J13, J17: Conn_01x04_Pin; JST_PH_B4B-PH-K_1x04_P2.00mm_Vertical
J4, J10, J11, J14: Conn_01x02_Pin; JST_PH_B2B-PH-K_1x02_P2.00mm_Vertical
J5, J9, J15: Conn_01x04_Pin; PinHeader_1x04_P2.54mm_Vertical
J16: Conn_01x06_Pin; PinHeader_1x06_P2.54mm_Vertical
R1, R2, R3, R4, R10: 4.7K; R_0603_1608Metric_Pad0.98x0.95mm_HandSolder; LCSC C23162
R5, R6: 22R; R_0805_2012Metric_Pad1.20x1.40mm_HandSolder; Mouser 603-RT0805FRE0722RL
R7, R8, R9: 150R; R_0603_1608Metric_Pad0.98x0.95mm_HandSolder; LCSC C22808
SW1: SW_Push; Button Aliexpress 4x4
U1: ESP32-S3-WROOM-1; Mouser 356-ESP32S3WRM1N16R8

Connections:
3V3: C1.1, C2.1, C3.1, J6.2, J7.2, J8.2, J10.2, J11.2, J16.6, R1.2, R8.1, R10.1, U1.2 (3V3)
ACTIVE: R7.1, U1.25 (GPIO48/SPICLK_N/SUBSPICLK_N_DIFF)
ADDR1: J6.1, R2.1, U1.34 (MTDI/GPIO41/CLK_OUT1)
ADDR2: J7.1, R3.1, U1.33 (MTDO/GPIO40/CLK_OUT2)
ADDR3: J8.1, R4.1, U1.32 (MTCK/GPIO39/CLK_OUT3/SUBSPICS1)
BOOT: J13.4, J16.2, U1.27 (GPIO0/BOOT)
EN: C4.1, J13.3, J16.3, R10.2, SW1.1, U1.3 (EN)
FILTER: R9.1, U1.24 (GPIO47/SPICLK_P/SUBSPICLK_P_DIFF)
GND: C1.2, C2.2, C3.2, C4.2, D1.1 (K), D2.1 (K), D3.1 (K), J1.2, J4.1, J10.1, J11.1, J16.1, R2.2, R3.2, R4.2, SW1.2, U1.1 (GND), U1.40 (GND), U1.41 (GND)
I2S_IN_BCLK: J2.2, J3.2, J5.2, J9.2, J12.2, J15.2, J17.2, U1.15 (GPIO3/TOUCH3/ADC1_CH2), U1.20 (GPIO12/TOUCH12/ADC2_CH1/FSPICLK/FSPIIO6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)
I2S_IN_DATA: J12.4, J15.4, J17.4, U1.18 (GPIO10/TOUCH10/ADC1_CH9/FSPICS0/FSPIIO4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)
I2S_IN_LRCLK: J2.3, J3.3, J5.3, J9.3, J12.3, J15.3, J17.3, U1.4 (GPIO4/TOUCH4/ADC1_CH3), U1.21 (GPIO13/TOUCH13/ADC2_CH2/FSPIQ/FSPIIO7/S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)
I2S_IN_MCLK: J2.1, J3.1, J5.1, J9.1, J12.1, J15.1, J17.1, U1.19 (GPIO11/TOUCH11/ADC2_CH0/FSPID/FSPIIO5/S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), U1.38 (GPIO2/TOUCH2/ADC1_CH1)
I2S_OUT_DATA: J3.4, J4.2, J5.4, R6.2
I2S_OUT_DATA_2: J2.4, J9.4, R5.2
unnamed: D1.2 (A), R8.2
unnamed: D2.2 (A), R7.2
unnamed: D3.2 (A), R9.2
unnamed: R5.1, U1.7 (GPIO7/TOUCH7/ADC1_CH6)
unnamed: R6.1, U1.26 (GPIO45)
RX: J14.2, J16.4, U1.36 (U0RXD/GPIO44/CLK_OUT2)
SCL: J13.1, U1.6 (GPIO6/TOUCH6/ADC1_CH5)
SDA: J13.2, U1.5 (GPIO5/TOUCH5/ADC1_CH4)
TX: J14.1, J16.5, U1.37 (U0TXD/GPIO43/CLK_OUT1)
WIFI_EN: J1.1, R1.1, U1.35 (MTMS/GPIO42)

Notes on the sheet:
MOUNTING HOLES
CONNECTORS
MICROPROCESSOR
BUTTONS
LEDS
BULK & DECOUPLING CAPACITORS
JUMPERS
