duanestorey/hifi-amp/pcbs/dual-psu/1.0/dual-psu.kicad_sch

## KiCad design pcbs/dual-psu/1.0/dual-psu.kicad_sch (2025-01-13)

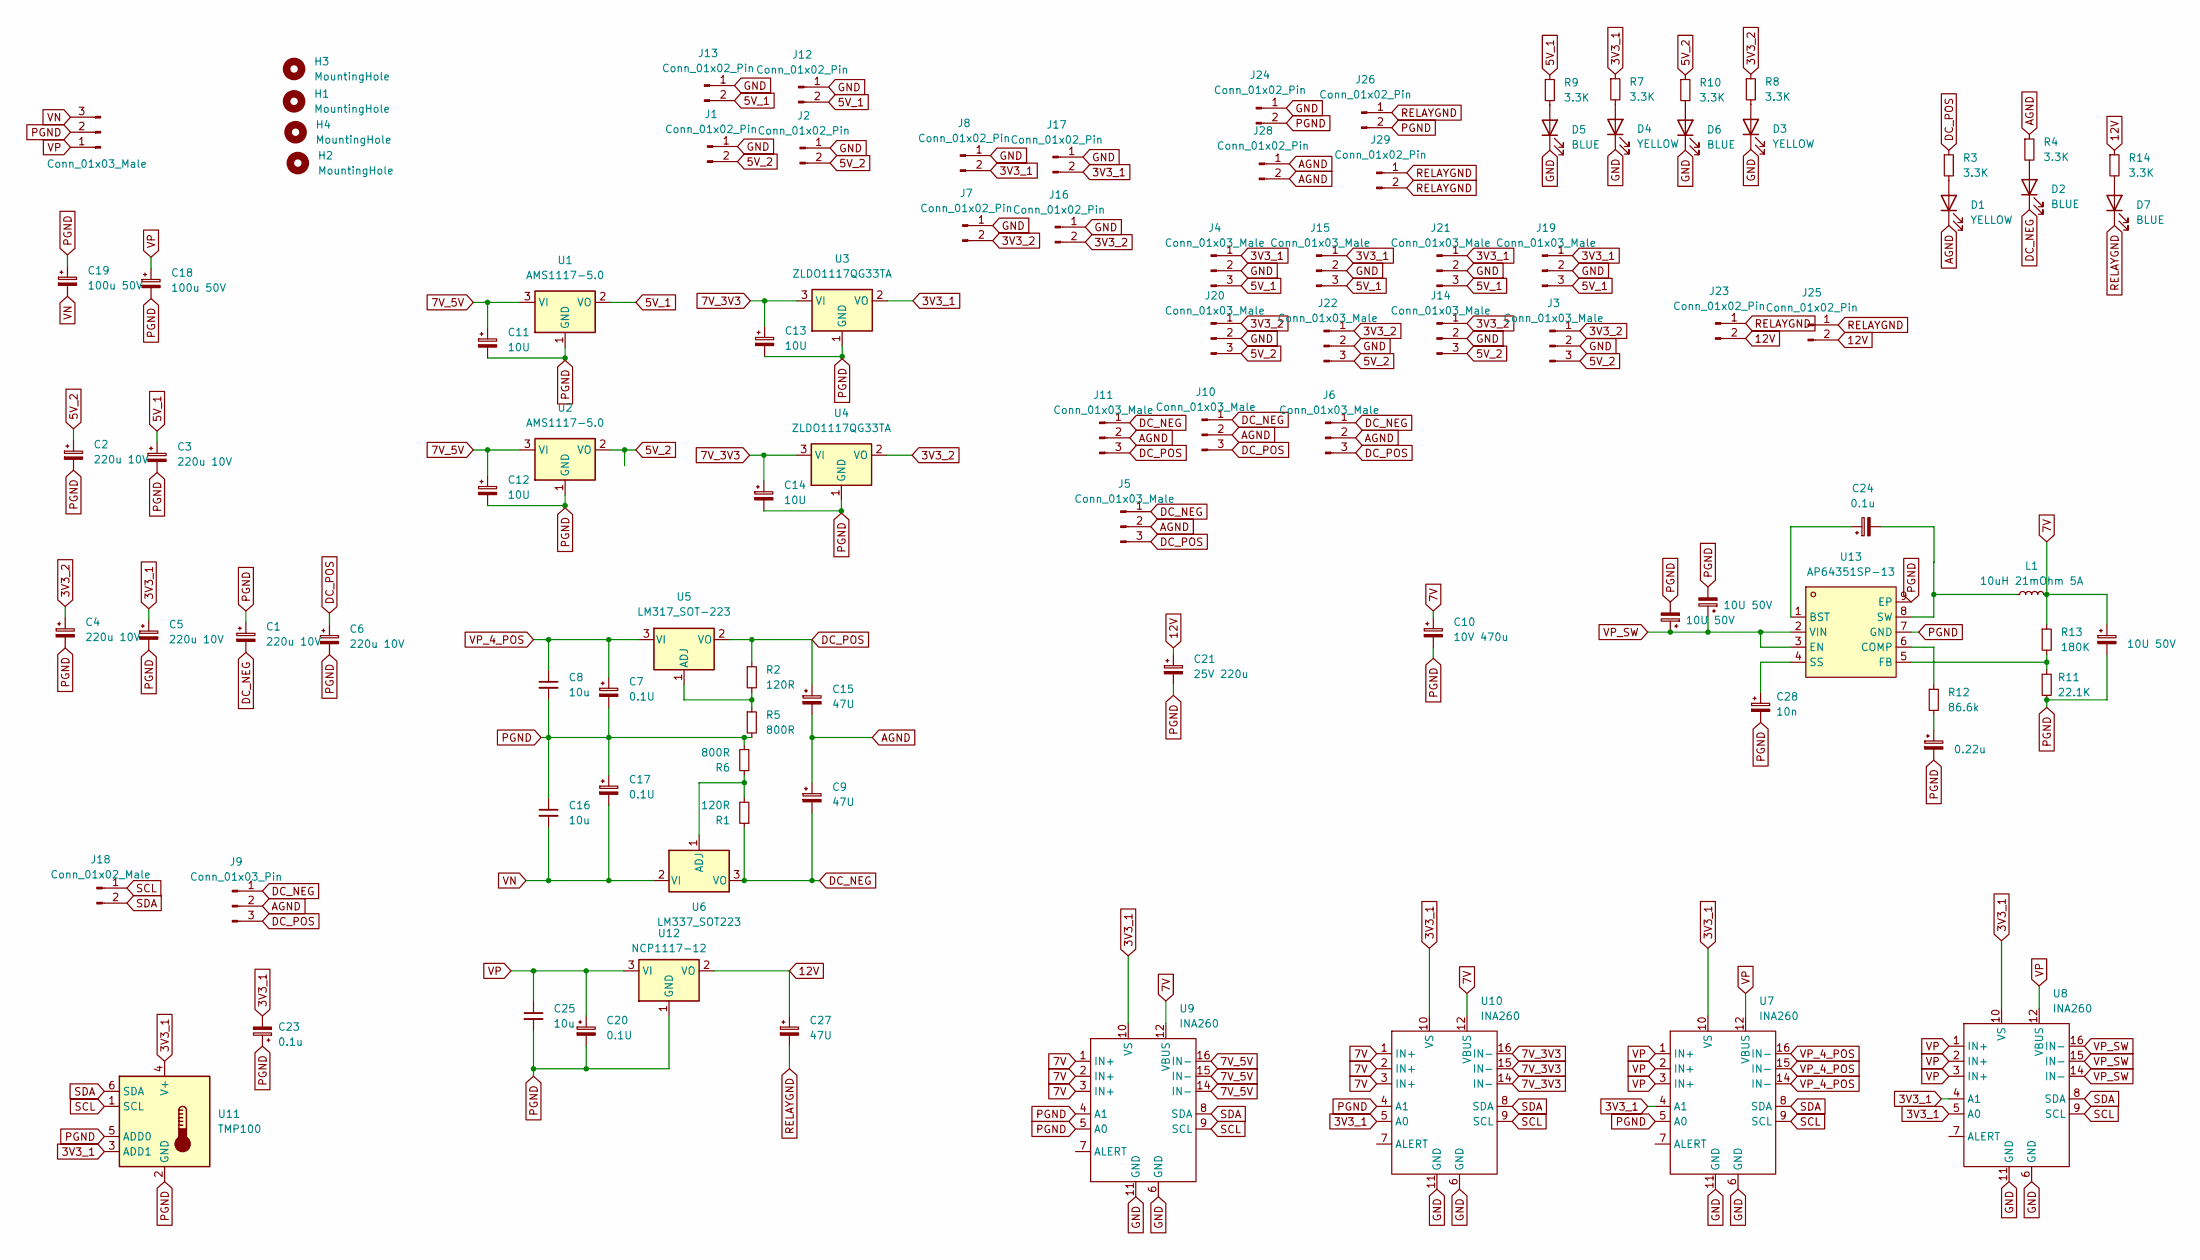
[picture p212: schematic dual-psu.kicad_sch]

Parts:
C1, C2, C3, C4, C5, C6: 220u 10V; CP_Radial_D6.3mm_P2.50mm
C7, C17, C20: 0.1U; C_0603_1608Metric_Pad1.08x0.95mm_HandSolder
C8, C16, C25: 10u; C_1206_3216Metric_Pad1.33x1.80mm_HandSolder
C9, C15, C27: 47U; C_1206_3216Metric_Pad1.33x1.80mm_HandSolder
C10: 10V 470u; CP_Radial_D8.0mm_P3.50mm
C11, C12, C13, C14: 10U; C_1206_3216Metric_Pad1.33x1.80mm_HandSolder
C18, C19: 100u 50V; CP_Radial_D8.0mm_P3.50mm
C21: 25V 220u; CP_Radial_D8.0mm_P3.50mm
C22, C29, C30: 10U 50V; C_1206_3216Metric_Pad1.33x1.80mm_HandSolder
C23, C24: 0.1u; C_0805_2012Metric_Pad1.18x1.45mm_HandSolder
C26: 0.22u; C_0805_2012Metric_Pad1.18x1.45mm_HandSolder
C28: 10n; C_0805_2012Metric_Pad1.18x1.45mm_HandSolder
D1: YELLOW; LED_0603_1608Metric
D2, D7: BLUE; LED_0603_1608Metric
D3, D4: YELLOW; LED_0805_2012Metric_Pad1.15x1.40mm_HandSolder
D5, D6: BLUE; LED_0805_2012Metric_Pad1.15x1.40mm_HandSolder
H1, H2, H3, H4: MountingHole; MountingHole_3.2mm_M3_DIN965_Pad_TopOnly
J1, J2, J7, J8, J12, J13, J16, J17, J23, J25, J28, J29: Conn_01x02_Pin; JST_PH_B2B-PH-K_1x02_P2.00mm_Vertical
J3, J4, J5, J6, J10, J11, J14, J15, J19, J20, J21, J22: Conn_01x03_Male; JST_PH_B3B-PH-K_1x03_P2.00mm_Vertical
J9: Conn_01x03_Pin; PinHeader_1x03_P2.54mm_Vertical
J18: Conn_01x02_Male; JST_PH_B2B-PH-K_1x02_P2.00mm_Vertical
J24, J26: Conn_01x02_Pin; PinHeader_1x02_P2.54mm_Vertical
J27: Conn_01x03_Male; JST_VH_B3P-VH_1x03_P3.96mm_Vertical
L1: 10uH 21mOhm 5A; L_Vishay_IHLP-4040; Mouser 704-DR1040-7R0-R
R1, R2: 120R; R_0603_1608Metric_Pad0.98x0.95mm_HandSolder
R3, R4, R7, R8, R9, R10, R14: 3.3K; R_0603_1608Metric_Pad0.98x0.95mm_HandSolder
R5, R6: 800R; R_0603_1608Metric_Pad0.98x0.95mm_HandSolder
R11: 22.1K; R_0603_1608Metric_Pad0.98x0.95mm_HandSolder; Mouser 603-RC0603JR-07820KP
R12: 86.6k; R_0603_1608Metric_Pad0.98x0.95mm_HandSolder; Mouser 71-CRCW0603-86.6K-E3
R13: 180K; R_0603_1608Metric_Pad0.98x0.95mm_HandSolder; Mouser 603-RC0603JR-10180KL
U1, U2: AMS1117-5.0; SOT-223-3_TabPin2; Mouser 926-LM1117MPX5.0NOPB
U3, U4: ZLDO1117QG33TA; SOT-223-3_TabPin2; Mouser ZLDO1117QG33TA
U5: LM317_SOT-223; SOT-223-3_TabPin2; Mouser 595-LM317DCY
U6: LM337_SOT223; SOT-223-3_TabPin2; Mouser 926-LM337IMPX/NOPB
U7, U8, U9, U10: INA260; TSSOP-16_4.4x5mm_P0.65mm
U11: TMP100; SOT-23-6; Mouser 595-TMP100NA/3K
U12: NCP1117-12; SOT-223; Mouser 863-NCP1117ST12T3G
U13: AP64351SP-13; SOIC-8_L4.9-W3.9-P1.27-LS6.0-BL-EP; LCSC Part C3192339

Connections:
3V3_1: C5.1, C23.2, J4.1, J8.2, J15.1, J17.2, J19.1, J21.1, R7.1, U3.2 (VO), U7.4 (A1), U7.10 (VS), U8.4 (A1), U8.5 (A0), U8.10 (VS), U9.10 (VS), U10.5 (A0), U10.10 (VS), U11.3 (ADD1), U11.4 (V+)
3V3_2: C4.1, J3.1, J7.2, J14.1, J16.2, J20.1, J22.1, R8.1, U4.2 (VO)
5V_1: C3.1, J4.3, J12.2, J13.2, J15.3, J19.3, J21.3, R9.1, U1.2 (VO)
5V_2: C2.1, J1.2, J2.2, J3.3, J14.3, J20.3, J22.3, R10.1, U2.2 (VO)
7V: C10.1, C22.1, L1.2, R13.1, U9.1 (IN+), U9.2 (IN+), U9.3 (IN+), U9.12 (VBUS), U10.1 (IN+), U10.2 (IN+), U10.3 (IN+), U10.12 (VBUS)
7V_3V3: C13.1, C14.1, U3.3 (VI), U4.3 (VI), U10.14 (IN-), U10.15 (IN-), U10.16 (IN-)
7V_5V: C11.1, C12.1, U1.3 (VI), U2.3 (VI), U9.14 (IN-), U9.15 (IN-), U9.16 (IN-)
12V: C21.1, C27.1, J23.2, J25.2, R14.1, U12.2 (VO)
AGND: C9.1, C15.2, D1.1 (K), J5.2, J6.2, J9.2, J10.2, J11.2, J28.1, J28.2, R4.1
DC_NEG: C1.2, C9.2, D2.1 (K), J5.1, J6.1, J9.1, J10.1, J11.1, R1.1, U6.3 (VO)
DC_POS: C6.1, C15.1, J5.3, J6.3, J9.3, J10.3, J11.3, R2.1, R3.1, U5.2 (VO)
GND: D3.1 (K), D4.1 (K), D5.1 (K), D6.1 (K), J1.1, J2.1, J3.2, J4.2, J7.1, J8.1, J12.1, J13.1, J14.2, J15.2, J16.1, J17.1, J19.2, J20.2, J21.2, J22.2, J24.1, U7.6 (GND), U7.11 (GND), U8.6 (GND), U8.11 (GND), U9.6 (GND), U9.11 (GND), U10.6 (GND), U10.11 (GND)
unnamed: C24.1, U13.1 (BST)
unnamed: C24.2, L1.1, U13.8 (SW)
unnamed: C26.1, R12.2
unnamed: C28.1, U13.4 (SS)
unnamed: D1.2 (A), R3.2
unnamed: D2.2 (A), R4.2
unnamed: D3.2 (A), R8.2
unnamed: D4.2 (A), R7.2
unnamed: D5.2 (A), R9.2
unnamed: D6.2 (A), R10.2
unnamed: D7.2 (A), R14.2
unnamed: R1.2, R6.1, U6.1 (ADJ)
unnamed: R2.2, R5.1, U5.1 (ADJ)
unnamed: R11.1, R13.2, U13.5 (FB)
unnamed: R12.1, U13.6 (COMP)
PGND: C1.1, C2.2, C3.2, C4.2, C5.2, C6.2, C7.2, C8.2, C10.2, C11.2, C12.2, C13.2, C14.2, C16.1, C17.1, C18.2, C19.1, C20.2, C21.2, C22.2, C23.1, C25.2, C26.2, C28.2, C29.2, C30.2, J24.2, J26.2, J27.2, R5.2, R6.2, R11.2, U1.1 (GND), U2.1 (GND), U3.1 (GND), U4.1 (GND), U7.5 (A0), U9.4 (A1), U9.5 (A0), U10.4 (A1), U11.2 (GND), U11.5 (ADD0), U12.1 (GND), U13.7 (GND), U13.9 (EP)
RELAYGND: C27.2, D7.1 (K), J23.1, J25.1, J26.1, J29.1, J29.2
SCL: J18.1, U7.9 (SCL), U8.9 (SCL), U9.9 (SCL), U10.9 (SCL), U11.1 (SCL)
SDA: J18.2, U7.8 (SDA), U8.8 (SDA), U9.8 (SDA), U10.8 (SDA), U11.6 (SDA)
VN: C16.2, C17.2, C19.2, J27.3, U6.2 (VI)
VP: C18.1, C20.1, C25.1, J27.1, U7.1 (IN+), U7.2 (IN+), U7.3 (IN+), U7.12 (VBUS), U8.1 (IN+), U8.2 (IN+), U8.3 (IN+), U8.12 (VBUS), U12.3 (VI)
VP_4_POS: C7.1, C8.1, U5.3 (VI), U7.14 (IN-), U7.15 (IN-), U7.16 (IN-)
VP_SW: C29.1, C30.1, U8.14 (IN-), U8.15 (IN-), U8.16 (IN-), U13.2 (VIN), U13.3 (EN)
