duanestorey/hifi-amp/pcbs/dual-psu/1.1/dual-psu.kicad_sch

## KiCad design pcbs/dual-psu/1.1/dual-psu.kicad_sch (2025-03-01)

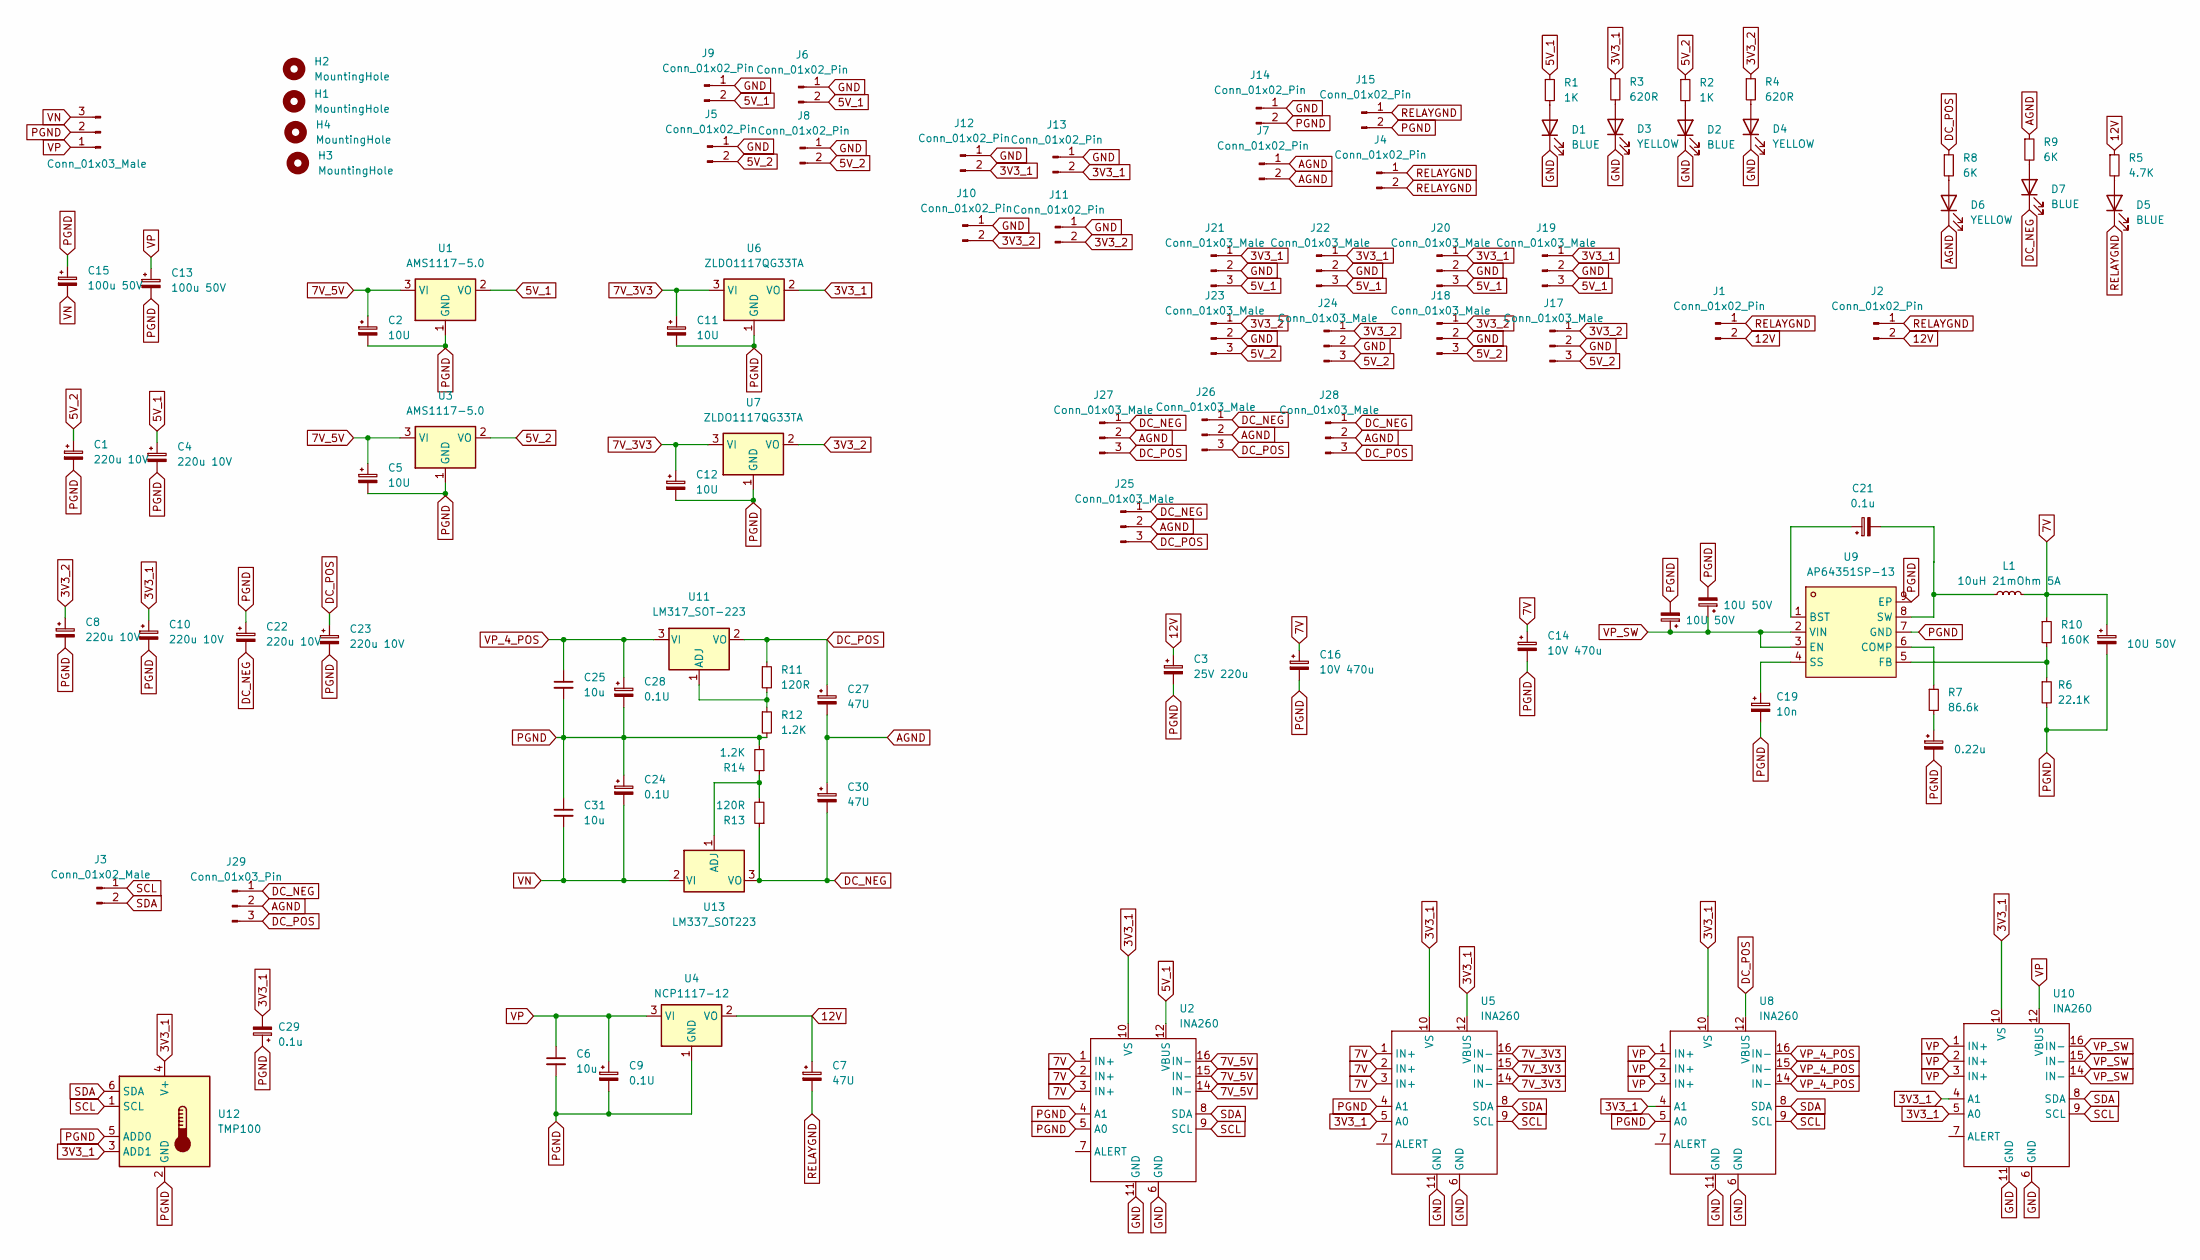
[picture p213: schematic dual-psu.kicad_sch]

Parts:
C1, C4, C8, C10, C22, C23: 220u 10V; CP_Radial_D6.3mm_P2.50mm
C2, C5, C11, C12: 10U; C_1206_3216Metric_Pad1.33x1.80mm_HandSolder
C3: 25V 220u; CP_Radial_D8.0mm_P3.50mm
C6, C25, C31: 10u; C_1206_3216Metric_Pad1.33x1.80mm_HandSolder
C7, C27, C30: 47U; C_1206_3216Metric_Pad1.33x1.80mm_HandSolder
C9, C24, C28: 0.1U; C_0603_1608Metric_Pad1.08x0.95mm_HandSolder
C13, C15: 100u 50V; CP_Radial_D8.0mm_P3.50mm
C14, C16: 10V 470u; CP_Radial_D8.0mm_P3.50mm
C17, C20, C26: 10U 50V; C_1206_3216Metric_Pad1.33x1.80mm_HandSolder
C18: 0.22u; C_0805_2012Metric_Pad1.18x1.45mm_HandSolder
C19: 10n; C_0805_2012Metric_Pad1.18x1.45mm_HandSolder
C21, C29: 0.1u; C_0805_2012Metric_Pad1.18x1.45mm_HandSolder
D1, D2, D5, D7: BLUE; LED_0603_1608Metric_Pad1.05x0.95mm_HandSolder
D3, D4, D6: YELLOW; LED_0603_1608Metric_Pad1.05x0.95mm_HandSolder
H1, H2, H3, H4: MountingHole; MountingHole_3.2mm_M3_DIN965_Pad_TopOnly
J1, J2, J4, J5, J6, J7, J8, J9, J10, J11, J12, J13: Conn_01x02_Pin; JST_PH_B2B-PH-K_1x02_P2.00mm_Vertical
J3: Conn_01x02_Male; JST_PH_B2B-PH-K_1x02_P2.00mm_Vertical
J14, J15: Conn_01x02_Pin; PinHeader_1x02_P2.54mm_Vertical
J16: Conn_01x03_Male; JST_VH_B3P-VH_1x03_P3.96mm_Vertical
J17, J18, J19, J20, J21, J22, J23, J24, J25, J26, J27, J28: Conn_01x03_Male; JST_PH_B3B-PH-K_1x03_P2.00mm_Vertical
J29: Conn_01x03_Pin; PinHeader_1x03_P2.54mm_Vertical
L1: 10uH 21mOhm 5A; L_Vishay_IHLP-4040; Mouser 704-DR1040-7R0-R
R1, R2: 1K; R_0603_1608Metric_Pad0.98x0.95mm_HandSolder
R3, R4: 620R; R_0603_1608Metric_Pad0.98x0.95mm_HandSolder
R5: 4.7K; R_0603_1608Metric_Pad0.98x0.95mm_HandSolder
R6: 22.1K; R_0603_1608Metric_Pad0.98x0.95mm_HandSolder; Mouser 603-RC0603JR-07820KP
R7: 86.6k; R_0603_1608Metric_Pad0.98x0.95mm_HandSolder; Mouser 71-CRCW0603-86.6K-E3
R8, R9: 6K; R_0603_1608Metric_Pad0.98x0.95mm_HandSolder
R10: 160K; R_0603_1608Metric_Pad0.98x0.95mm_HandSolder; Mouser 603-RC0603JR-10180KL
R11, R13: 120R; R_0603_1608Metric_Pad0.98x0.95mm_HandSolder
R12, R14: 1.2K; R_0603_1608Metric_Pad0.98x0.95mm_HandSolder
U1, U3: AMS1117-5.0; SOT-223-3_TabPin2; Mouser 926-LM1117MPX5.0NOPB
U2, U5, U8, U10: INA260; TSSOP-16_4.4x5mm_P0.65mm
U4: NCP1117-12; SOT-223; Mouser 863-NCP1117ST12T3G
U6, U7: ZLDO1117QG33TA; SOT-223-3_TabPin2; Mouser ZLDO1117QG33TA
U9: AP64351SP-13; SOIC-8_L4.9-W3.9-P1.27-LS6.0-BL-EP; LCSC Part C3192339
U11: LM317_SOT-223; SOT-223-3_TabPin2; Mouser 595-LM317DCY
U12: TMP100; SOT-23-6; Mouser 595-TMP100NA/3K
U13: LM337_SOT223; SOT-223-3_TabPin2; Mouser 926-LM337IMPX/NOPB

Connections:
3V3_1: C10.1, C29.2, J12.2, J13.2, J19.1, J20.1, J21.1, J22.1, R3.1, U2.10 (VS), U5.5 (A0), U5.10 (VS), U5.12 (VBUS), U6.2 (VO), U8.4 (A1), U8.10 (VS), U10.4 (A1), U10.5 (A0), U10.10 (VS), U12.3 (ADD1), U12.4 (V+)
3V3_2: C8.1, J10.2, J11.2, J17.1, J18.1, J23.1, J24.1, R4.1, U7.2 (VO)
5V_1: C4.1, J6.2, J9.2, J19.3, J20.3, J21.3, J22.3, R1.1, U1.2 (VO), U2.12 (VBUS)
5V_2: C1.1, J5.2, J8.2, J17.3, J18.3, J23.3, J24.3, R2.1, U3.2 (VO)
7V: C14.1, C16.1, C26.1, L1.2, R10.1, U2.1 (IN+), U2.2 (IN+), U2.3 (IN+), U5.1 (IN+), U5.2 (IN+), U5.3 (IN+)
7V_3V3: C11.1, C12.1, U5.14 (IN-), U5.15 (IN-), U5.16 (IN-), U6.3 (VI), U7.3 (VI)
7V_5V: C2.1, C5.1, U1.3 (VI), U2.14 (IN-), U2.15 (IN-), U2.16 (IN-), U3.3 (VI)
12V: C3.1, C7.1, J1.2, J2.2, R5.1, U4.2 (VO)
AGND: C27.2, C30.1, D6.1 (K), J7.1, J7.2, J25.2, J26.2, J27.2, J28.2, J29.2, R9.1
DC_NEG: C22.2, C30.2, D7.1 (K), J25.1, J26.1, J27.1, J28.1, J29.1, R13.1, U13.3 (VO)
DC_POS: C23.1, C27.1, J25.3, J26.3, J27.3, J28.3, J29.3, R8.1, R11.1, U8.12 (VBUS), U11.2 (VO)
GND: D1.1 (K), D2.1 (K), D3.1 (K), D4.1 (K), J5.1, J6.1, J8.1, J9.1, J10.1, J11.1, J12.1, J13.1, J14.1, J17.2, J18.2, J19.2, J20.2, J21.2, J22.2, J23.2, J24.2, U2.6 (GND), U2.11 (GND), U5.6 (GND), U5.11 (GND), U8.6 (GND), U8.11 (GND), U10.6 (GND), U10.11 (GND)
unnamed: C18.1, R7.2
unnamed: C19.1, U9.4 (SS)
unnamed: C21.1, U9.1 (BST)
unnamed: C21.2, L1.1, U9.8 (SW)
unnamed: D1.2 (A), R1.2
unnamed: D2.2 (A), R2.2
unnamed: D3.2 (A), R3.2
unnamed: D4.2 (A), R4.2
unnamed: D5.2 (A), R5.2
unnamed: D6.2 (A), R8.2
unnamed: D7.2 (A), R9.2
unnamed: R7.1, U9.6 (COMP)
unnamed: R6.1, R10.2, U9.5 (FB)
unnamed: R11.2, R12.1, U11.1 (ADJ)
unnamed: R13.2, R14.1, U13.1 (ADJ)
PGND: C1.2, C2.2, C3.2, C4.2, C5.2, C6.2, C8.2, C9.2, C10.2, C11.2, C12.2, C13.2, C14.2, C15.1, C16.2, C17.2, C18.2, C19.2, C20.2, C22.1, C23.2, C24.1, C25.2, C26.2, C28.2, C29.1, C31.1, J14.2, J15.2, J16.2, R6.2, R12.2, R14.2, U1.1 (GND), U2.4 (A1), U2.5 (A0), U3.1 (GND), U4.1 (GND), U5.4 (A1), U6.1 (GND), U7.1 (GND), U8.5 (A0), U9.7 (GND), U9.9 (EP), U12.2 (GND), U12.5 (ADD0)
RELAYGND: C7.2, D5.1 (K), J1.1, J2.1, J4.1, J4.2, J15.1
SCL: J3.1, U2.9 (SCL), U5.9 (SCL), U8.9 (SCL), U10.9 (SCL), U12.1 (SCL)
SDA: J3.2, U2.8 (SDA), U5.8 (SDA), U8.8 (SDA), U10.8 (SDA), U12.6 (SDA)
VN: C15.2, C24.2, C31.2, J16.3, U13.2 (VI)
VP: C6.1, C9.1, C13.1, J16.1, U4.3 (VI), U8.1 (IN+), U8.2 (IN+), U8.3 (IN+), U10.1 (IN+), U10.2 (IN+), U10.3 (IN+), U10.12 (VBUS)
VP_4_POS: C25.1, C28.1, U8.14 (IN-), U8.15 (IN-), U8.16 (IN-), U11.3 (VI)
VP_SW: C17.1, C20.1, U9.2 (VIN), U9.3 (EN), U10.14 (IN-), U10.15 (IN-), U10.16 (IN-)
