duanestorey/hifi-amp/pcbs/extend/1.1/extend.kicad_sch

## KiCad design pcbs/extend/1.1/extend.kicad_sch (2025-02-21)

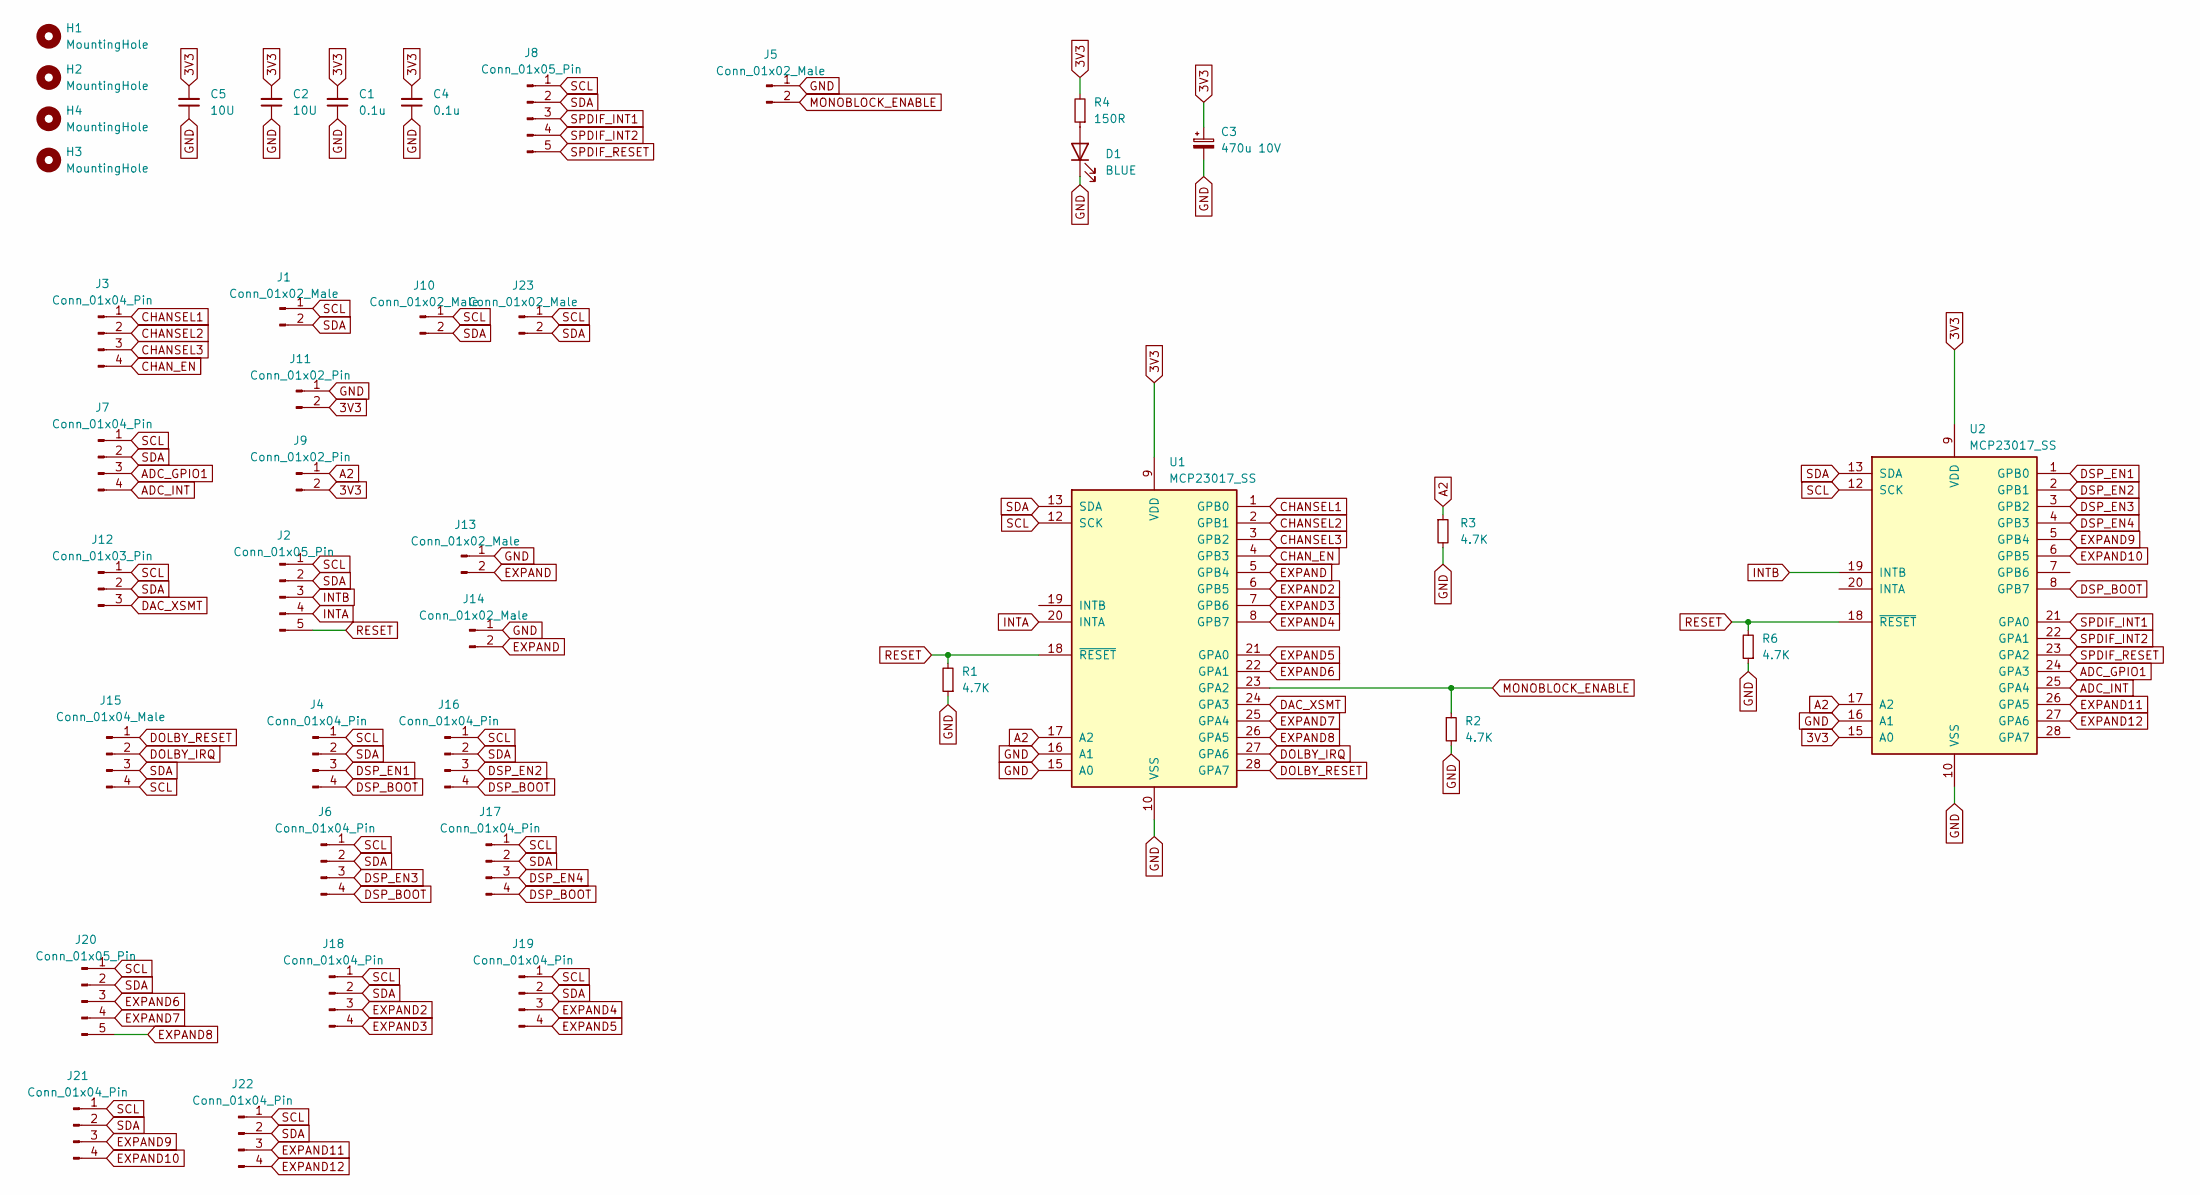
[picture p214: schematic extend.kicad_sch]

Parts:
C1, C4: 0.1u; C_0805_2012Metric_Pad1.18x1.45mm_HandSolder
C2, C5: 10U; C_1206_3216Metric_Pad1.33x1.80mm_HandSolder
C3: 470u 10V; CP_Radial_D6.3mm_P2.50mm
D1: BLUE; LED_0603_1608Metric
H1, H2, H3, H4: MountingHole; MountingHole_3.2mm_M3_DIN965_Pad_TopOnly
J1, J5, J10, J13, J23: Conn_01x02_Male; JST_PH_B2B-PH-K_1x02_P2.00mm_Vertical
J2, J8, J20: Conn_01x05_Pin; JST_PH_B5B-PH-K_1x05_P2.00mm_Vertical
J3, J4, J6, J7, J16, J17, J18, J19, J21, J22: Conn_01x04_Pin; JST_PH_B4B-PH-K_1x04_P2.00mm_Vertical
J9: Conn_01x02_Pin; PinHeader_1x02_P2.54mm_Vertical
J11: Conn_01x02_Pin; JST_PH_B2B-PH-K_1x02_P2.00mm_Vertical
J12: Conn_01x03_Pin; JST_PH_B3B-PH-K_1x03_P2.00mm_Vertical
J14: Conn_01x02_Male; PinHeader_1x02_P2.54mm_Vertical
J15: Conn_01x04_Male; JST_PH_B4B-PH-K_1x04_P2.00mm_Vertical
R1, R2, R3, R6: 4.7K; R_0603_1608Metric_Pad0.98x0.95mm_HandSolder
R4: 150R; R_0603_1608Metric
U1, U2: MCP23017_SS; SSOP-28_5.3x10.2mm_P0.65mm; Mouser 579-MCP23017-E/SS

Connections:
3V3: C1.2, C2.2, C3.1, C4.2, C5.2, J9.2, J11.2, R4.2, U1.9 (VDD), U2.9 (VDD), U2.15 (A0)
A2: J9.1, R3.1, U1.17 (A2), U2.17 (A2)
ADC_GPIO1: J7.3, U2.24 (GPA3)
ADC_INT: J7.4, U2.25 (GPA4)
CHANSEL1: J3.1, U1.1 (GPB0)
CHANSEL2: J3.2, U1.2 (GPB1)
CHANSEL3: J3.3, U1.3 (GPB2)
CHAN_EN: J3.4, U1.4 (GPB3)
DAC_XSMT: J12.3, U1.24 (GPA3)
DOLBY_IRQ: J15.2, U1.27 (GPA6)
DOLBY_RESET: J15.1, U1.28 (GPA7)
DSP_BOOT: J4.4, J6.4, J16.4, J17.4, U2.8 (GPB7)
DSP_EN1: J4.3, U2.1 (GPB0)
DSP_EN2: J16.3, U2.2 (GPB1)
DSP_EN3: J6.3, U2.3 (GPB2)
DSP_EN4: J17.3, U2.4 (GPB3)
EXPAND: J13.2, J14.2, U1.5 (GPB4)
EXPAND2: J18.3, U1.6 (GPB5)
EXPAND3: J18.4, U1.7 (GPB6)
EXPAND4: J19.3, U1.8 (GPB7)
EXPAND5: J19.4, U1.21 (GPA0)
EXPAND6: J20.3, U1.22 (GPA1)
EXPAND7: J20.4, U1.25 (GPA4)
EXPAND8: J20.5, U1.26 (GPA5)
EXPAND9: J21.3, U2.5 (GPB4)
EXPAND10: J21.4, U2.6 (GPB5)
EXPAND11: J22.3, U2.26 (GPA5)
EXPAND12: J22.4, U2.27 (GPA6)
GND: C1.1, C2.1, C3.2, C4.1, C5.1, D1.1 (K), J5.1, J11.1, J13.1, J14.1, R1.1, R2.1, R3.2, R6.1, U1.10 (VSS), U1.15 (A0), U1.16 (A1), U2.10 (VSS), U2.16 (A1)
INTA: J2.4, U1.20 (INTA)
INTB: J2.3, U2.19 (INTB)
MONOBLOCK_ENABLE: J5.2, R2.2, U1.23 (GPA2)
unnamed: D1.2 (A), R4.1
RESET: J2.5, R1.2, R6.2, U1.18 (~RESET), U2.18 (~RESET)
SCL: J1.1, J2.1, J4.1, J6.1, J7.1, J8.1, J10.1, J12.1, J15.4, J16.1, J17.1, J18.1, J19.1, J20.1, J21.1, J22.1, J23.1, U1.12 (SCK), U2.12 (SCK)
SDA: J1.2, J2.2, J4.2, J6.2, J7.2, J8.2, J10.2, J12.2, J15.3, J16.2, J17.2, J18.2, J19.2, J20.2, J21.2, J22.2, J23.2, U1.13 (SDA), U2.13 (SDA)
SPDIF_INT1: J8.3, U2.21 (GPA0)
SPDIF_INT2: J8.4, U2.22 (GPA1)
SPDIF_RESET: J8.5, U2.23 (GPA2)
