duanestorey/hifi-amp/pcbs/ftdi/1.0/ftdi.kicad_sch

## KiCad design pcbs/ftdi/1.0/ftdi.kicad_sch (2025-01-15)

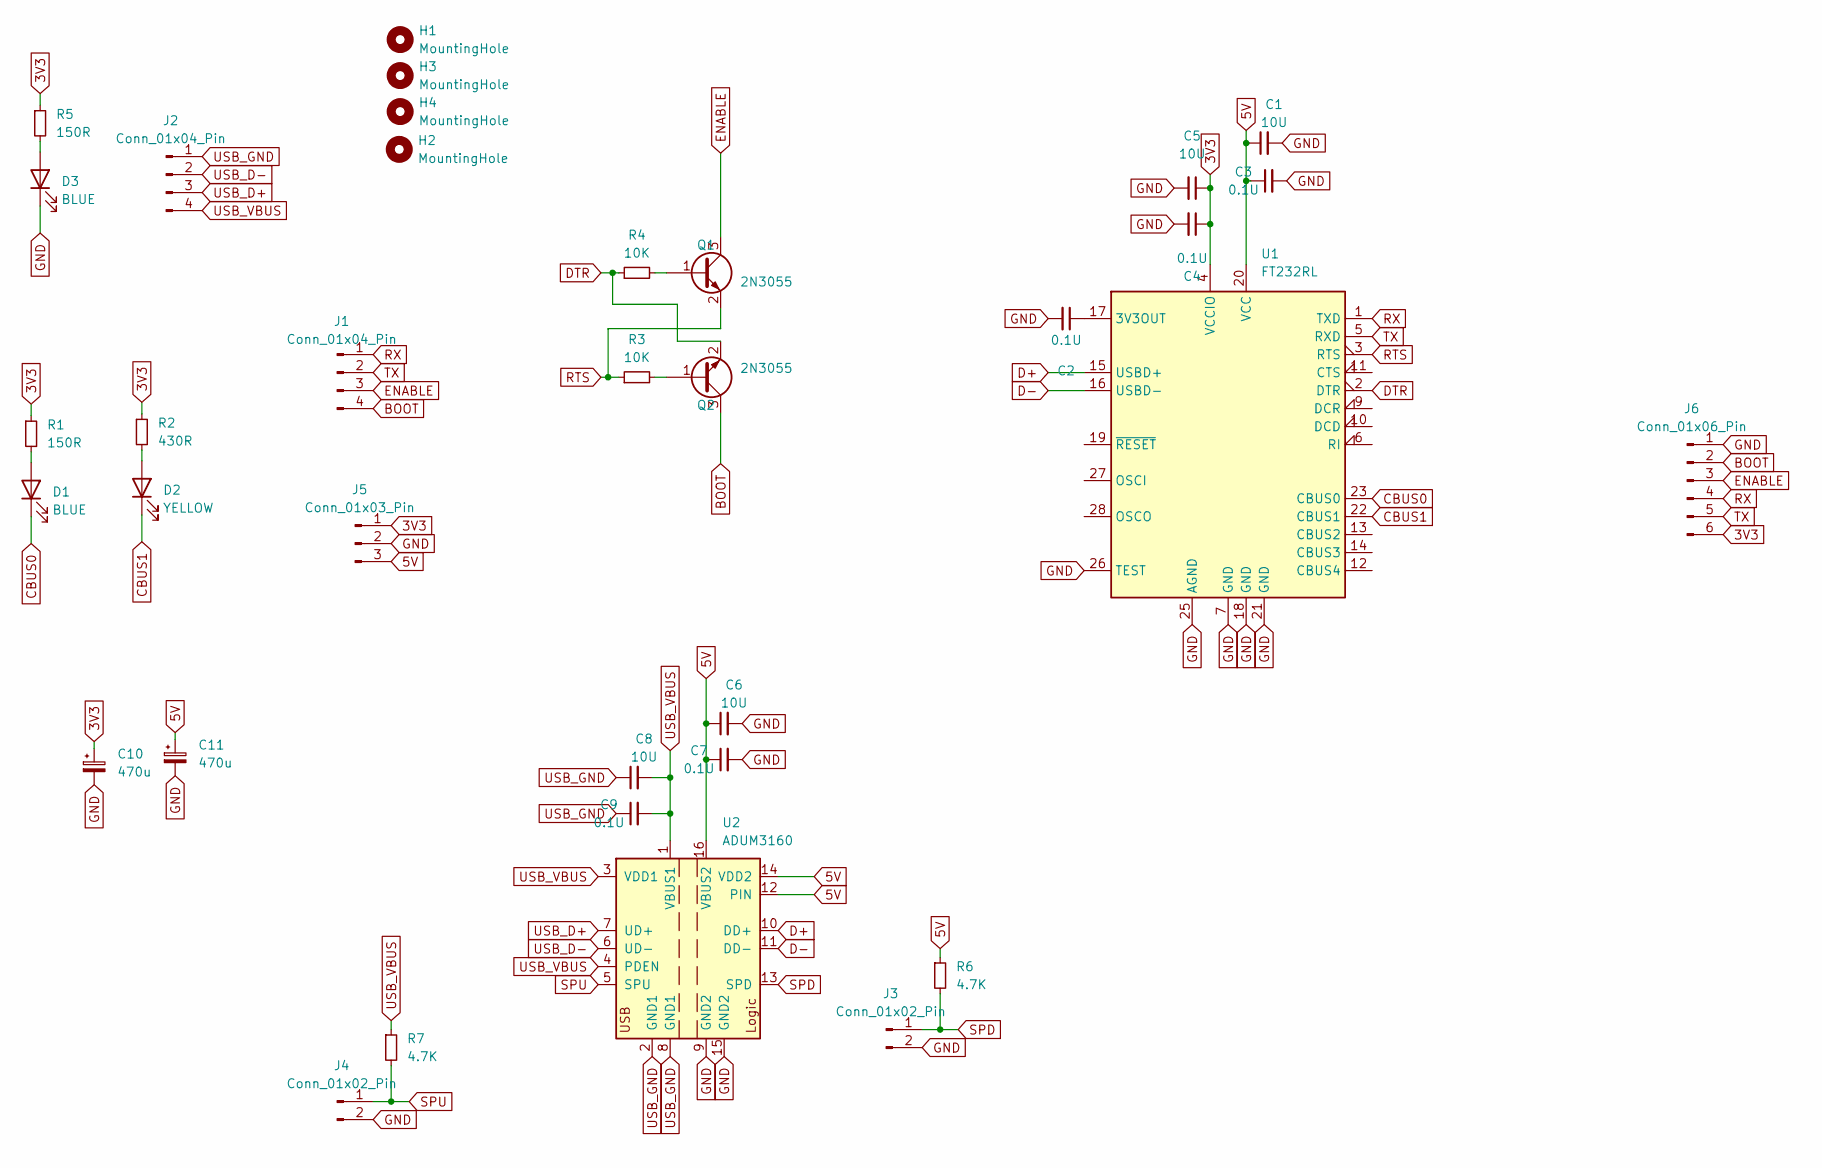
[picture p215: schematic ftdi.kicad_sch]

Parts:
C1, C5, C6, C8: 10U; C_1206_3216Metric_Pad1.33x1.80mm_HandSolder
C2, C3, C4, C7, C9: 0.1U; C_0805_2012Metric_Pad1.18x1.45mm_HandSolder
C10, C11: 470u; CP_Radial_D6.3mm_P2.50mm
D1, D3: BLUE; LED_0603_1608Metric_Pad1.05x0.95mm_HandSolder; LCSC XL-1608UBC-04
D2: YELLOW; LED_0603_1608Metric_Pad1.05x0.95mm_HandSolder; LCSC XL-1608UBC-04
H1, H2, H3, H4: MountingHole; MountingHole_3.2mm_M3_DIN965_Pad_TopOnly
J1, J2: Conn_01x04_Pin; JST_PH_B4B-PH-K_1x04_P2.00mm_Vertical
J3, J4: Conn_01x02_Pin; PinHeader_1x02_P2.54mm_Vertical
J5: Conn_01x03_Pin; JST_PH_B3B-PH-K_1x03_P2.00mm_Vertical
J6: Conn_01x06_Pin; PinHeader_1x06_P2.54mm_Vertical
Q1, Q2: 2N3055; TSOT-23
R1, R5: 150R; R_0603_1608Metric_Pad0.98x0.95mm_HandSolder
R2: 430R; R_0603_1608Metric_Pad0.98x0.95mm_HandSolder
R3, R4: 10K; R_0603_1608Metric_Pad0.98x0.95mm_HandSolder
R6, R7: 4.7K; R_0603_1608Metric_Pad0.98x0.95mm_HandSolder
U1: FT232RL; SSOP-28_5.3x10.2mm_P0.65mm
U2: ADUM3160; SOIC-16W_7.5x10.3mm_P1.27mm; Mouser 584-ADUM3160BRWZ-R

Connections:
3V3: C4.1, C5.1, C10.1, J5.1, J6.6, R1.1, R2.1, R5.1, U1.4 (VCCIO)
5V: C1.1, C3.1, C6.1, C7.1, C11.1, J5.3, R6.1, U1.20 (VCC), U2.12 (PIN), U2.14 (VDD2), U2.16 (VBUS2)
BOOT: J1.4, J6.2, Q2.3 (C)
CBUS0: D1.1 (K), U1.23 (CBUS0)
CBUS1: D2.1 (K), U1.22 (CBUS1)
D+: U1.15 (USBD+), U2.10 (DD+)
D-: U1.16 (USBD-), U2.11 (DD-)
DTR: Q2.2 (E), R4.1, U1.2 (DTR)
ENABLE: J1.3, J6.3, Q1.3 (C)
GND: C1.2, C2.2, C3.2, C4.2, C5.2, C6.2, C7.2, C10.2, C11.2, D3.1 (K), J3.2, J4.2, J5.2, J6.1, U1.7 (GND), U1.18 (GND), U1.21 (GND), U1.25 (AGND), U1.26 (TEST), U2.9 (GND2), U2.15 (GND2)
unnamed: C2.1, U1.17 (3V3OUT)
unnamed: D1.2 (A), R1.2
unnamed: D2.2 (A), R2.2
unnamed: D3.2 (A), R5.2
unnamed: Q1.1 (B), R4.2
unnamed: Q2.1 (B), R3.2
RTS: Q1.2 (E), R3.1, U1.3 (RTS)
RX: J1.1, J6.4, U1.1 (TXD)
SPD: J3.1, R6.2, U2.13 (SPD)
SPU: J4.1, R7.2, U2.5 (SPU)
TX: J1.2, J6.5, U1.5 (RXD)
USB_D+: J2.3, U2.7 (UD+)
USB_D-: J2.2, U2.6 (UD-)
USB_GND: C8.1, C9.1, J2.1, U2.2 (GND1), U2.8 (GND1)
USB_VBUS: C8.2, C9.2, J2.4, R7.1, U2.1 (VBUS1), U2.3 (VDD1), U2.4 (PDEN)
