duanestorey/hifi-amp/pcbs/ftdi/1.3/ftdi.kicad_sch

## KiCad design pcbs/ftdi/1.3/ftdi.kicad_sch (2025-10-22)

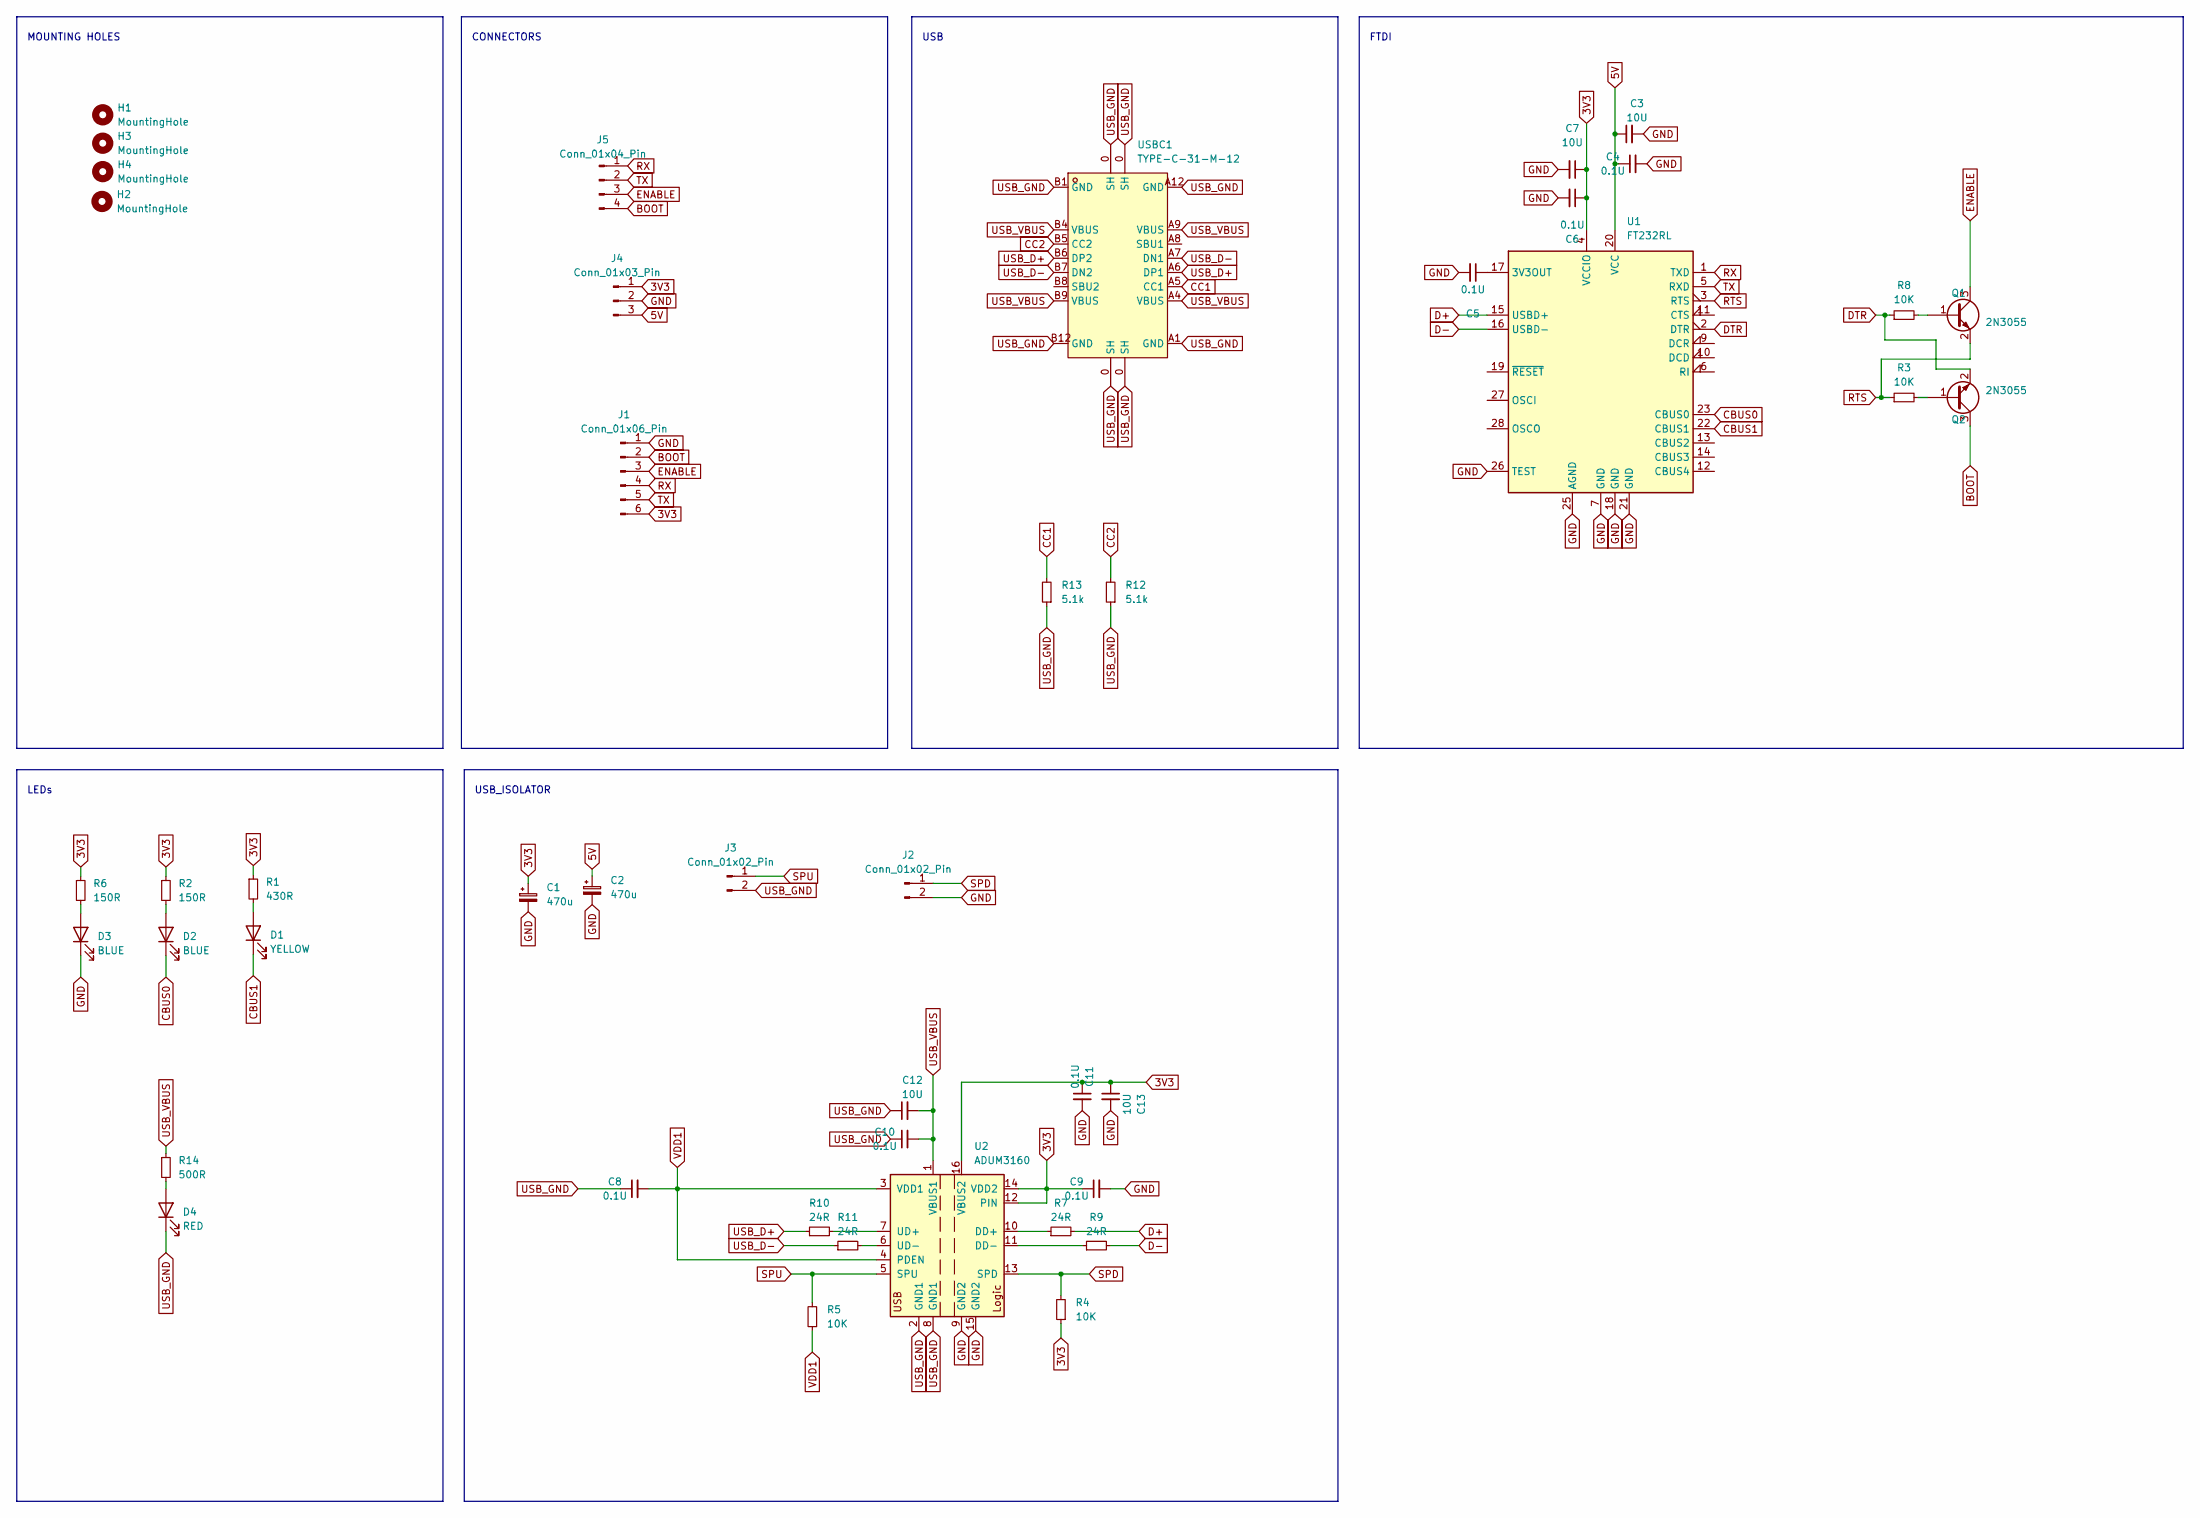
[picture p217: schematic ftdi.kicad_sch]

Parts:
C1, C2: 470u; CP_Radial_D6.3mm_P2.50mm
C3, C7, C12, C13: 10U; C_1206_3216Metric_Pad1.33x1.80mm_HandSolder
C4, C5, C6, C8, C9, C10, C11: 0.1U; C_0805_2012Metric_Pad1.18x1.45mm_HandSolder
D1: YELLOW; LED_0603_1608Metric_Pad1.05x0.95mm_HandSolder; LCSC XL-1608UBC-04
D2, D3: BLUE; LED_0603_1608Metric_Pad1.05x0.95mm_HandSolder; LCSC XL-1608UBC-04
D4: RED; LED_0603_1608Metric_Pad1.05x0.95mm_HandSolder; LCSC XL-1608UBC-04
H1, H2, H3, H4: MountingHole; MountingHole_3.2mm_M3_DIN965_Pad_TopOnly
J1: Conn_01x06_Pin; PinHeader_1x06_P2.54mm_Vertical
J2, J3: Conn_01x02_Pin; PinHeader_1x02_P2.54mm_Vertical
J4: Conn_01x03_Pin; JST_PH_B3B-PH-K_1x03_P2.00mm_Vertical
J5: Conn_01x04_Pin; JST_PH_B4B-PH-K_1x04_P2.00mm_Vertical
Q1, Q2: 2N3055; TSOT-23
R1: 430R; R_0603_1608Metric_Pad0.98x0.95mm_HandSolder
R2, R6: 150R; R_0603_1608Metric_Pad0.98x0.95mm_HandSolder
R3, R4, R5, R8: 10K; R_0603_1608Metric_Pad0.98x0.95mm_HandSolder
R7, R9, R10, R11: 24R; R_0603_1608Metric_Pad0.98x0.95mm_HandSolder
R12, R13: 5.1k; R_0805_2012Metric_Pad1.20x1.40mm_HandSolder
R14: 500R; R_0603_1608Metric_Pad0.98x0.95mm_HandSolder
U1: FT232RL; SSOP-28_5.3x10.2mm_P0.65mm
U2: ADUM3160; SOIC-16W_7.5x10.3mm_P1.27mm; Mouser 584-ADUM3160BRWZ-R
USBC1: TYPE-C-31-M-12; USB-C_SMD-TYPE-C-31-M-12; LCSC Part C165948

Connections:
3V3: C1.1, C6.1, C7.1, C9.1, C11.1, C13.1, J1.6, J4.1, R1.1, R2.1, R4.1, R6.1, U1.4 (VCCIO), U2.12 (PIN), U2.14 (VDD2), U2.16 (VBUS2)
5V: C2.1, C3.1, C4.1, J4.3, U1.20 (VCC)
BOOT: J1.2, J5.4, Q2.3 (C)
CBUS0: D2.1 (K), U1.23 (CBUS0)
CBUS1: D1.1 (K), U1.22 (CBUS1)
CC1: R13.2, USBC1.A5 (CC1)
CC2: R12.2, USBC1.B5 (CC2)
D+: R7.2, U1.15 (USBD+)
D-: R9.2, U1.16 (USBD-)
DTR: Q2.2 (E), R8.1, U1.2 (DTR)
ENABLE: J1.3, J5.3, Q1.3 (C)
GND: C1.2, C2.2, C3.2, C4.2, C5.2, C6.2, C7.2, C9.2, C11.2, C13.2, D3.1 (K), J1.1, J2.2, J4.2, U1.7 (GND), U1.18 (GND), U1.21 (GND), U1.25 (AGND), U1.26 (TEST), U2.9 (GND2), U2.15 (GND2)
unnamed: C5.1, U1.17 (3V3OUT)
unnamed: D1.2 (A), R1.2
unnamed: D2.2 (A), R2.2
unnamed: D3.2 (A), R6.2
unnamed: D4.2 (A), R14.2
unnamed: Q1.1 (B), R8.2
unnamed: Q2.1 (B), R3.2
unnamed: R7.1, U2.10 (DD+)
unnamed: R9.1, U2.11 (DD-)
unnamed: R10.2, U2.7 (UD+)
unnamed: R11.2, U2.6 (UD-)
RTS: Q1.2 (E), R3.1, U1.3 (RTS)
RX: J1.4, J5.1, U1.1 (TXD)
SPD: J2.1, R4.2, U2.13 (SPD)
SPU: J3.1, R5.2, U2.5 (SPU)
TX: J1.5, J5.2, U1.5 (RXD)
USB_D+: R10.1, USBC1.A6 (DP1), USBC1.B6 (DP2)
USB_D-: R11.1, USBC1.A7 (DN1), USBC1.B7 (DN2)
USB_GND: C8.1, C10.1, C12.1, D4.1 (K), J3.2, R12.1, R13.1, U2.2 (GND1), U2.8 (GND1), USBC1.0 (SH), USBC1.A1 (GND), USBC1.A12 (GND), USBC1.B1 (GND), USBC1.B12 (GND)
USB_VBUS: C10.2, C12.2, R14.1, U2.1 (VBUS1), USBC1.A4 (VBUS), USBC1.A9 (VBUS), USBC1.B4 (VBUS), USBC1.B9 (VBUS)
VDD1: C8.2, R5.1, U2.3 (VDD1), U2.4 (PDEN)

Notes on the sheet:
FTDI
LEDs
CONNECTORS
USB_ISOLATOR
USB
MOUNTING HOLES
