duanestorey/hifi-amp/pcbs/input-sel/1.2/input-sel.kicad_sch

## KiCad design pcbs/input-sel/1.2/input-sel.kicad_sch (2025-10-22)

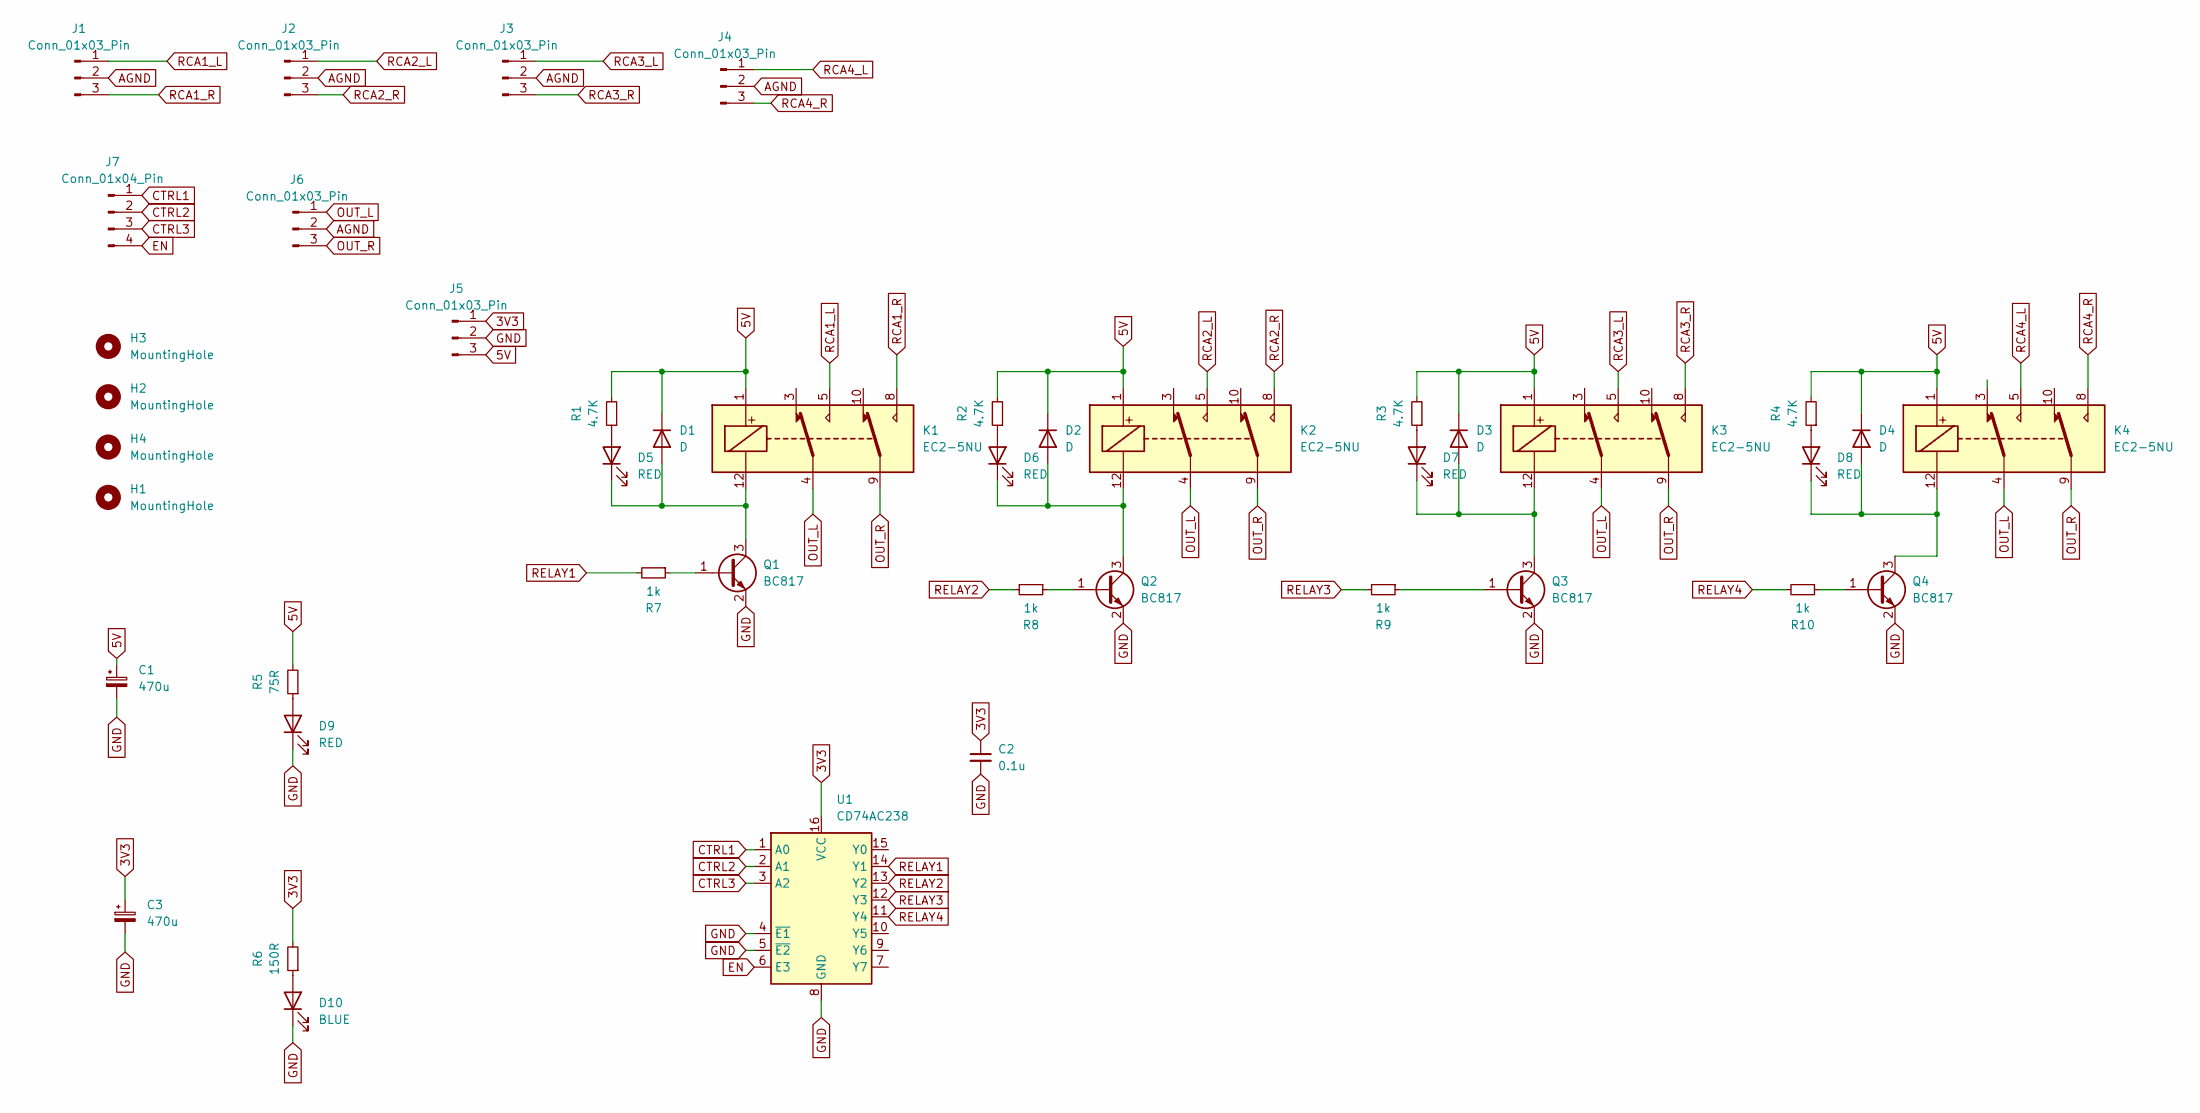
[picture p219: schematic input-sel.kicad_sch]

Parts:
C1, C3: 470u; CP_Radial_D6.3mm_P2.50mm
C2: 0.1u; C_0603_1608Metric
D1, D2, D3, D4: D; D_SMA; Mouser 863-NRVA4005T3G
D5, D6, D7, D8, D9: RED; LED_0603_1608Metric
D10: BLUE; LED_0603_1608Metric
H1, H2, H3, H4: MountingHole; MountingHole_3.2mm_M3_DIN965_Pad_TopOnly
J1, J2, J3, J4, J5, J6: Conn_01x03_Pin; JST_PH_B3B-PH-K_1x03_P2.00mm_Vertical
J7: Conn_01x04_Pin; JST_PH_B4B-PH-K_1x04_P2.00mm_Vertical
K1, K2, K3, K4: EC2-5NU; KEMET EA2; Mouser 80-EA2-12NU
Q1, Q2, Q3, Q4: BC817; SOT-23
R1, R2, R3, R4: 4.7K; R_0603_1608Metric_Pad0.98x0.95mm_HandSolder
R5: 75R; R_0603_1608Metric_Pad0.98x0.95mm_HandSolder
R6: 150R; R_0603_1608Metric_Pad0.98x0.95mm_HandSolder
R7, R8, R9, R10: 1k; R_0603_1608Metric_Pad0.98x0.95mm_HandSolder; Mouser 603-AC0603JR-07820RL
U1: CD74AC238; TSSOP-16_4.4x5mm_P0.65mm; Mouser 512-74AC138MTCX

Connections:
3V3: C2.1, C3.1, J5.1, R6.2, U1.16 (VCC)
5V: C1.1, D1.1 (K), D2.1 (K), D3.1 (K), D4.1 (K), J5.3, K1.1, K2.1, K3.1, K4.1, R1.2, R2.2, R3.2, R4.2, R5.2
AGND: J1.2, J2.2, J3.2, J4.2, J6.2
CTRL1: J7.1, U1.1 (A0)
CTRL2: J7.2, U1.2 (A1)
CTRL3: J7.3, U1.3 (A2)
EN: J7.4, U1.6 (E3)
GND: C1.2, C2.2, C3.2, D9.1 (K), D10.1 (K), J5.2, Q1.2 (E), Q2.2 (E), Q3.2 (E), Q4.2 (E), U1.4 (~E1), U1.5 (~E2), U1.8 (GND)
unnamed: D1.2 (A), D5.1 (K), K1.12, Q1.3 (C)
unnamed: D2.2 (A), D6.1 (K), K2.12, Q2.3 (C)
unnamed: D3.2 (A), D7.1 (K), K3.12, Q3.3 (C)
unnamed: D4.2 (A), D8.1 (K), K4.12, Q4.3 (C)
unnamed: D5.2 (A), R1.1
unnamed: D6.2 (A), R2.1
unnamed: D7.2 (A), R3.1
unnamed: D8.2 (A), R4.1
unnamed: D9.2 (A), R5.1
unnamed: D10.2 (A), R6.1
unnamed: Q1.1 (B), R7.1
unnamed: Q2.1 (B), R8.1
unnamed: Q3.1 (B), R9.1
unnamed: Q4.1 (B), R10.1
OUT_L: J6.1, K1.4, K2.4, K3.4, K4.4
OUT_R: J6.3, K1.9, K2.9, K3.9, K4.9
RCA1_L: J1.1, K1.5
RCA1_R: J1.3, K1.8
RCA2_L: J2.1, K2.5
RCA2_R: J2.3, K2.8
RCA3_L: J3.1, K3.5
RCA3_R: J3.3, K3.8
RCA4_L: J4.1, K4.5
RCA4_R: J4.3, K4.8
RELAY1: R7.2, U1.14 (Y1)
RELAY2: R8.2, U1.13 (Y2)
RELAY3: R9.2, U1.12 (Y3)
RELAY4: R10.2, U1.11 (Y4)
