duanestorey/hifi-amp/pcbs/mono/1.3/mono.kicad_sch

## KiCad design pcbs/mono/1.3/mono.kicad_sch (2025-10-22)

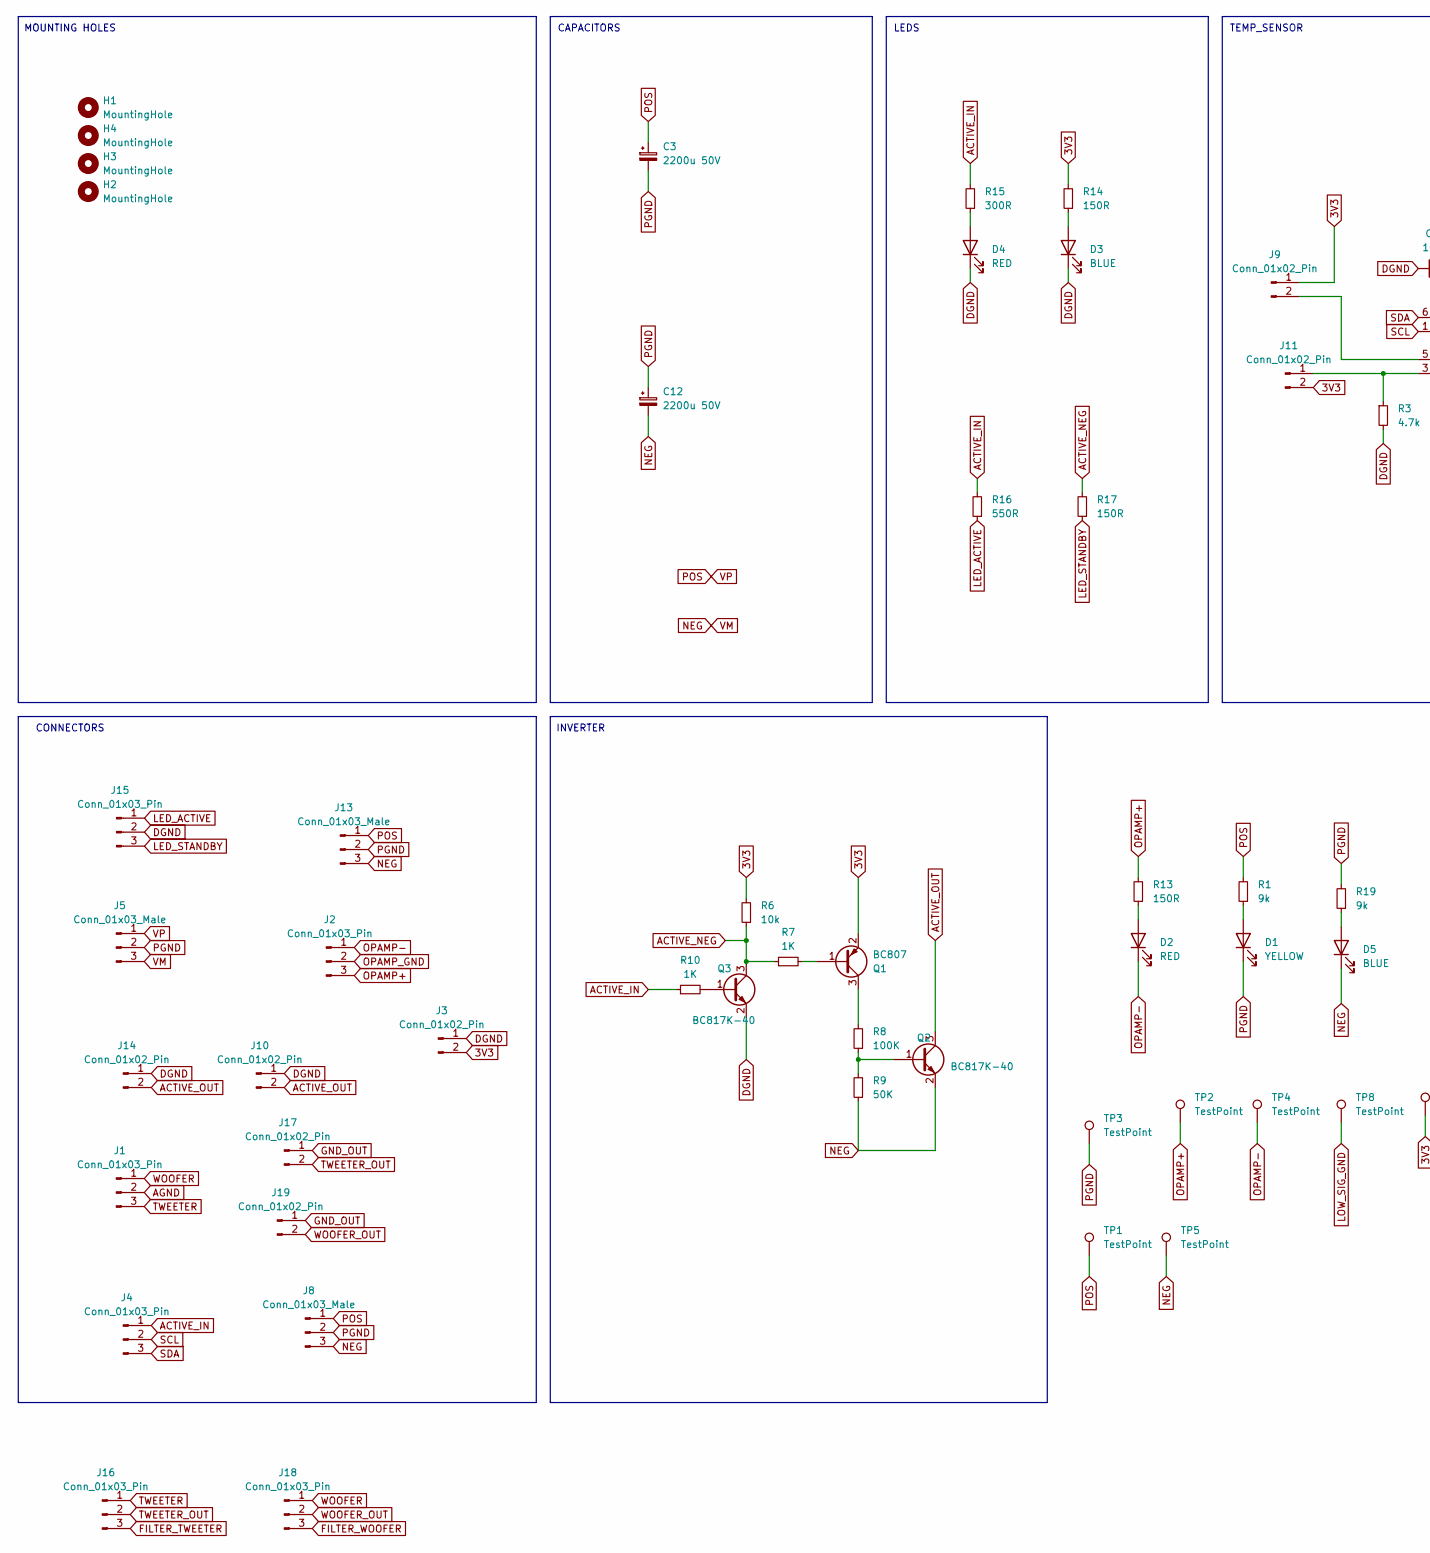
[picture p221: schematic mono.kicad_sch, part in row 1, column 1]

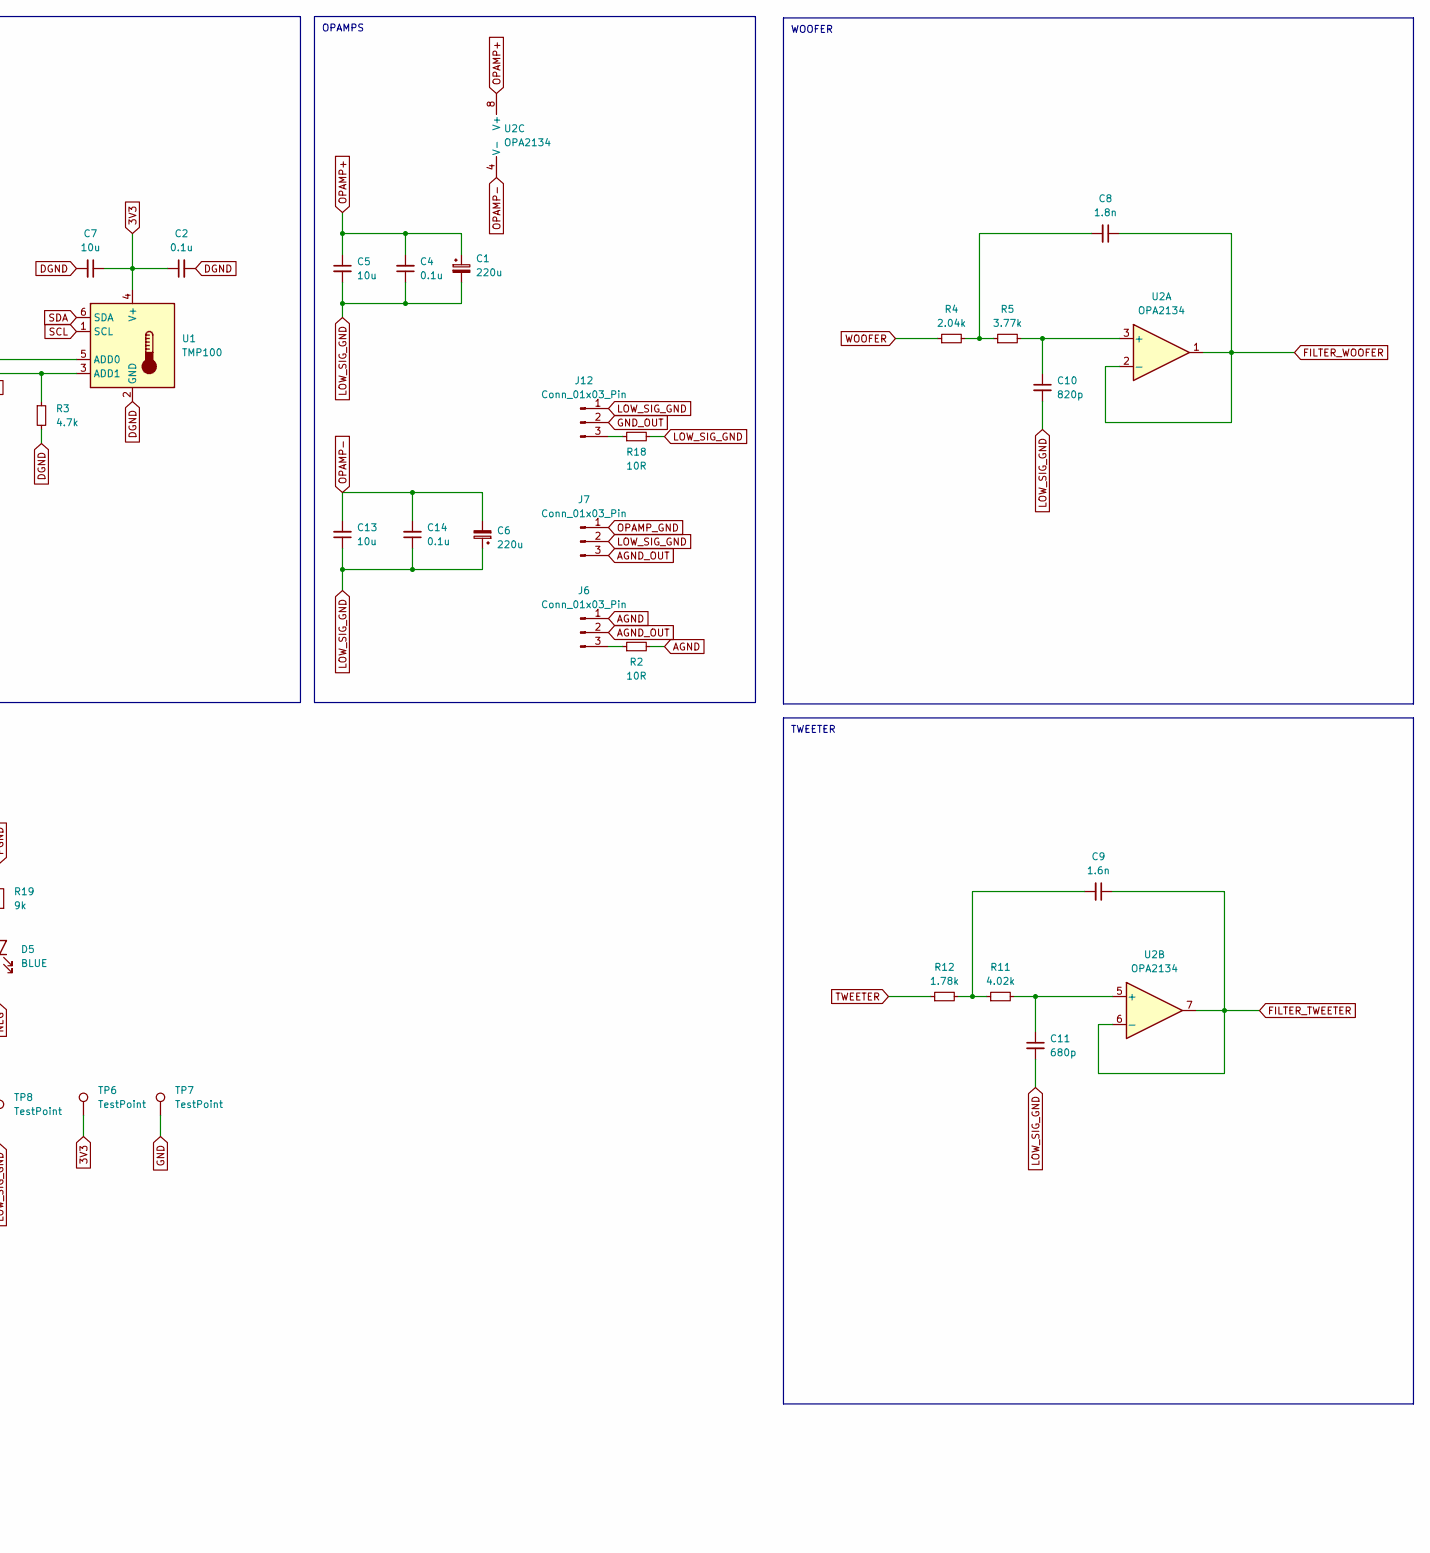
[picture p222: schematic mono.kicad_sch, part in row 1, column 2]

Parts:
C1, C6: 220u; CP_Radial_D6.3mm_P2.50mm
C2, C4, C14: 0.1u; C_0805_2012Metric_Pad1.18x1.45mm_HandSolder
C3, C12: 2200u 50V; CP_Radial_D16.0mm_P7.50mm; Mouser 80-ESH228M050AM3AA
C5, C7, C13: 10u; C_1206_3216Metric_Pad1.33x1.80mm_HandSolder
C8: 1.8n; C_0805_2012Metric_Pad1.18x1.45mm_HandSolder
C9: 1.6n; C_0805_2012Metric_Pad1.18x1.45mm_HandSolder; Mouser 81-GCM2165C2A162FA6D
C10: 820p; C_0805_2012Metric_Pad1.18x1.45mm_HandSolder
C11: 680p; C_0805_2012Metric_Pad1.18x1.45mm_HandSolder; Mouser 603-CC805GRNPO9BN681
D1: YELLOW; LED_0805_2012Metric_Pad1.15x1.40mm_HandSolder
D2, D4: RED; LED_0805_2012Metric_Pad1.15x1.40mm_HandSolder
D3, D5: BLUE; LED_0805_2012Metric_Pad1.15x1.40mm_HandSolder
H1, H2, H3, H4: MountingHole; MountingHole_3.2mm_M3_DIN965_Pad_TopOnly
J1, J2, J4, J15: Conn_01x03_Pin; JST_PH_B3B-PH-K_1x03_P2.00mm_Vertical
J3, J10, J14, J17, J19: Conn_01x02_Pin; JST_PH_B2B-PH-K_1x02_P2.00mm_Vertical
J5, J8, J13: Conn_01x03_Male; JST_VH_B3P-VH-B_1x03_P3.96mm_Vertical
J6, J7, J12, J16, J18: Conn_01x03_Pin; PinHeader_1x03_P2.54mm_Vertical
J9, J11: Conn_01x02_Pin; PinHeader_1x02_P2.54mm_Vertical
Q1: BC807; TSOT-23; Mouser 637-BC807-16
Q2, Q3: BC817K-40; TSOT-23; Mouser 637-BC817K-40
R1, R19: 9k; R_0603_1608Metric_Pad0.98x0.95mm_HandSolder
R2, R18: 10R; R_0805_2012Metric_Pad1.20x1.40mm_HandSolder
R3: 4.7k; R_0603_1608Metric_Pad0.98x0.95mm_HandSolder
R4: 2.04k; R_0805_2012Metric_Pad1.20x1.40mm_HandSolder
R5: 3.77k; R_0805_2012Metric_Pad1.20x1.40mm_HandSolder
R6: 10k; R_0805_2012Metric_Pad1.20x1.40mm_HandSolder
R7, R10: 1K; R_0805_2012Metric_Pad1.20x1.40mm_HandSolder
R8: 100K; R_0805_2012Metric_Pad1.20x1.40mm_HandSolder
R9: 50K; R_0805_2012Metric_Pad1.20x1.40mm_HandSolder
R11: 4.02k; R_0805_2012Metric_Pad1.20x1.40mm_HandSolder; Mouser 754-RG2012P-4021-BT5
R12: 1.78k; R_0805_2012Metric_Pad1.20x1.40mm_HandSolder; Mouser 667-ERA-6AEB1781V
R13, R14, R17: 150R; R_0603_1608Metric_Pad0.98x0.95mm_HandSolder
R15: 300R; R_0603_1608Metric_Pad0.98x0.95mm_HandSolder
R16: 550R; R_0603_1608Metric_Pad0.98x0.95mm_HandSolder
TP1, TP2, TP3, TP4, TP5, TP6, TP7, TP8: TestPoint; TestPoint_THTPad_2.5x2.5mm_Drill1.2mm
U1: TMP100; SOT-23-6
U2: OPA2134; DIP-8_W7.62mm

Connections:
3V3: C2.1, C7.1, J3.2, J9.1, J11.2, Q1.2 (E), R6.2, R14.2, TP6.1, U1.4 (V+)
ACTIVE_IN: J4.1, R10.1, R15.2, R16.2
ACTIVE_NEG: Q3.3 (C), R6.1, R7.1, R17.2
ACTIVE_OUT: J10.2, J14.2, Q2.3 (C)
AGND: J1.2, J6.1, R2.2
AGND_OUT: J6.2, J7.3
DGND: C2.2, C7.2, D3.1 (K), D4.1 (K), J3.1, J10.1, J14.1, J15.2, Q3.2 (E), R3.2, U1.2 (GND)
FILTER_TWEETER: C9.1, J16.3, U2.6 (-), U2.7
FILTER_WOOFER: C8.1, J18.3, U2.1, U2.2 (-)
GND: TP7.1
GND_OUT: J12.2, J17.1, J19.1
LED_ACTIVE: J15.1, R16.1
LED_STANDBY: J15.3, R17.1
LOW_SIG_GND: C1.2, C4.1, C5.2, C6.1, C10.2, C11.2, C13.1, C14.1, J7.2, J12.1, R18.2, TP8.1
NEG: C12.2, D5.1 (K), J5.3, J8.3, J13.3, Q2.2 (E), R9.1, TP5.1
unnamed: C8.2, R4.2, R5.1
unnamed: C9.2, R11.1, R12.2
unnamed: C10.1, R5.2, U2.3 (+)
unnamed: C11.1, R11.2, U2.5 (+)
unnamed: D1.2 (A), R1.1
unnamed: D2.2 (A), R13.1
unnamed: D3.2 (A), R14.1
unnamed: D4.2 (A), R15.1
unnamed: D5.2 (A), R19.1
unnamed: J6.3, R2.1
unnamed: J9.2, U1.5 (ADD0)
unnamed: J11.1, R3.1, U1.3 (ADD1)
unnamed: J12.3, R18.1
unnamed: Q1.1 (B), R7.2
unnamed: Q1.3 (C), R8.2
unnamed: Q2.1 (B), R8.1, R9.2
unnamed: Q3.1 (B), R10.2
OPAMP+: C1.1, C4.2, C5.1, J2.3, R13.2, TP2.1, U2.8 (V+)
OPAMP-: C6.2, C13.2, C14.2, D2.1 (K), J2.1, TP4.1, U2.4 (V-)
OPAMP_GND: J2.2, J7.1
PGND: C3.2, C12.1, D1.1 (K), J5.2, J8.2, J13.2, R19.2, TP3.1
POS: C3.1, J5.1, J8.1, J13.1, R1.2, TP1.1
SCL: J4.2, U1.1 (SCL)
SDA: J4.3, U1.6 (SDA)
TWEETER: J1.3, J16.1, R12.1
TWEETER_OUT: J16.2, J17.2
WOOFER: J1.1, J18.1, R4.1
WOOFER_OUT: J18.2, J19.2

Notes on the sheet:
INVERTER
TWEETER
CAPACITORS
WOOFER
MOUNTING HOLES
LEDS
CONNECTORS
TEMP_SENSOR
OPAMPS
