duanestorey/hifi-amp/pcbs/psu-entry/1.3/psuentry.kicad_sch

## KiCad design pcbs/psu-entry/1.3/psuentry.kicad_sch (2025-05-14)

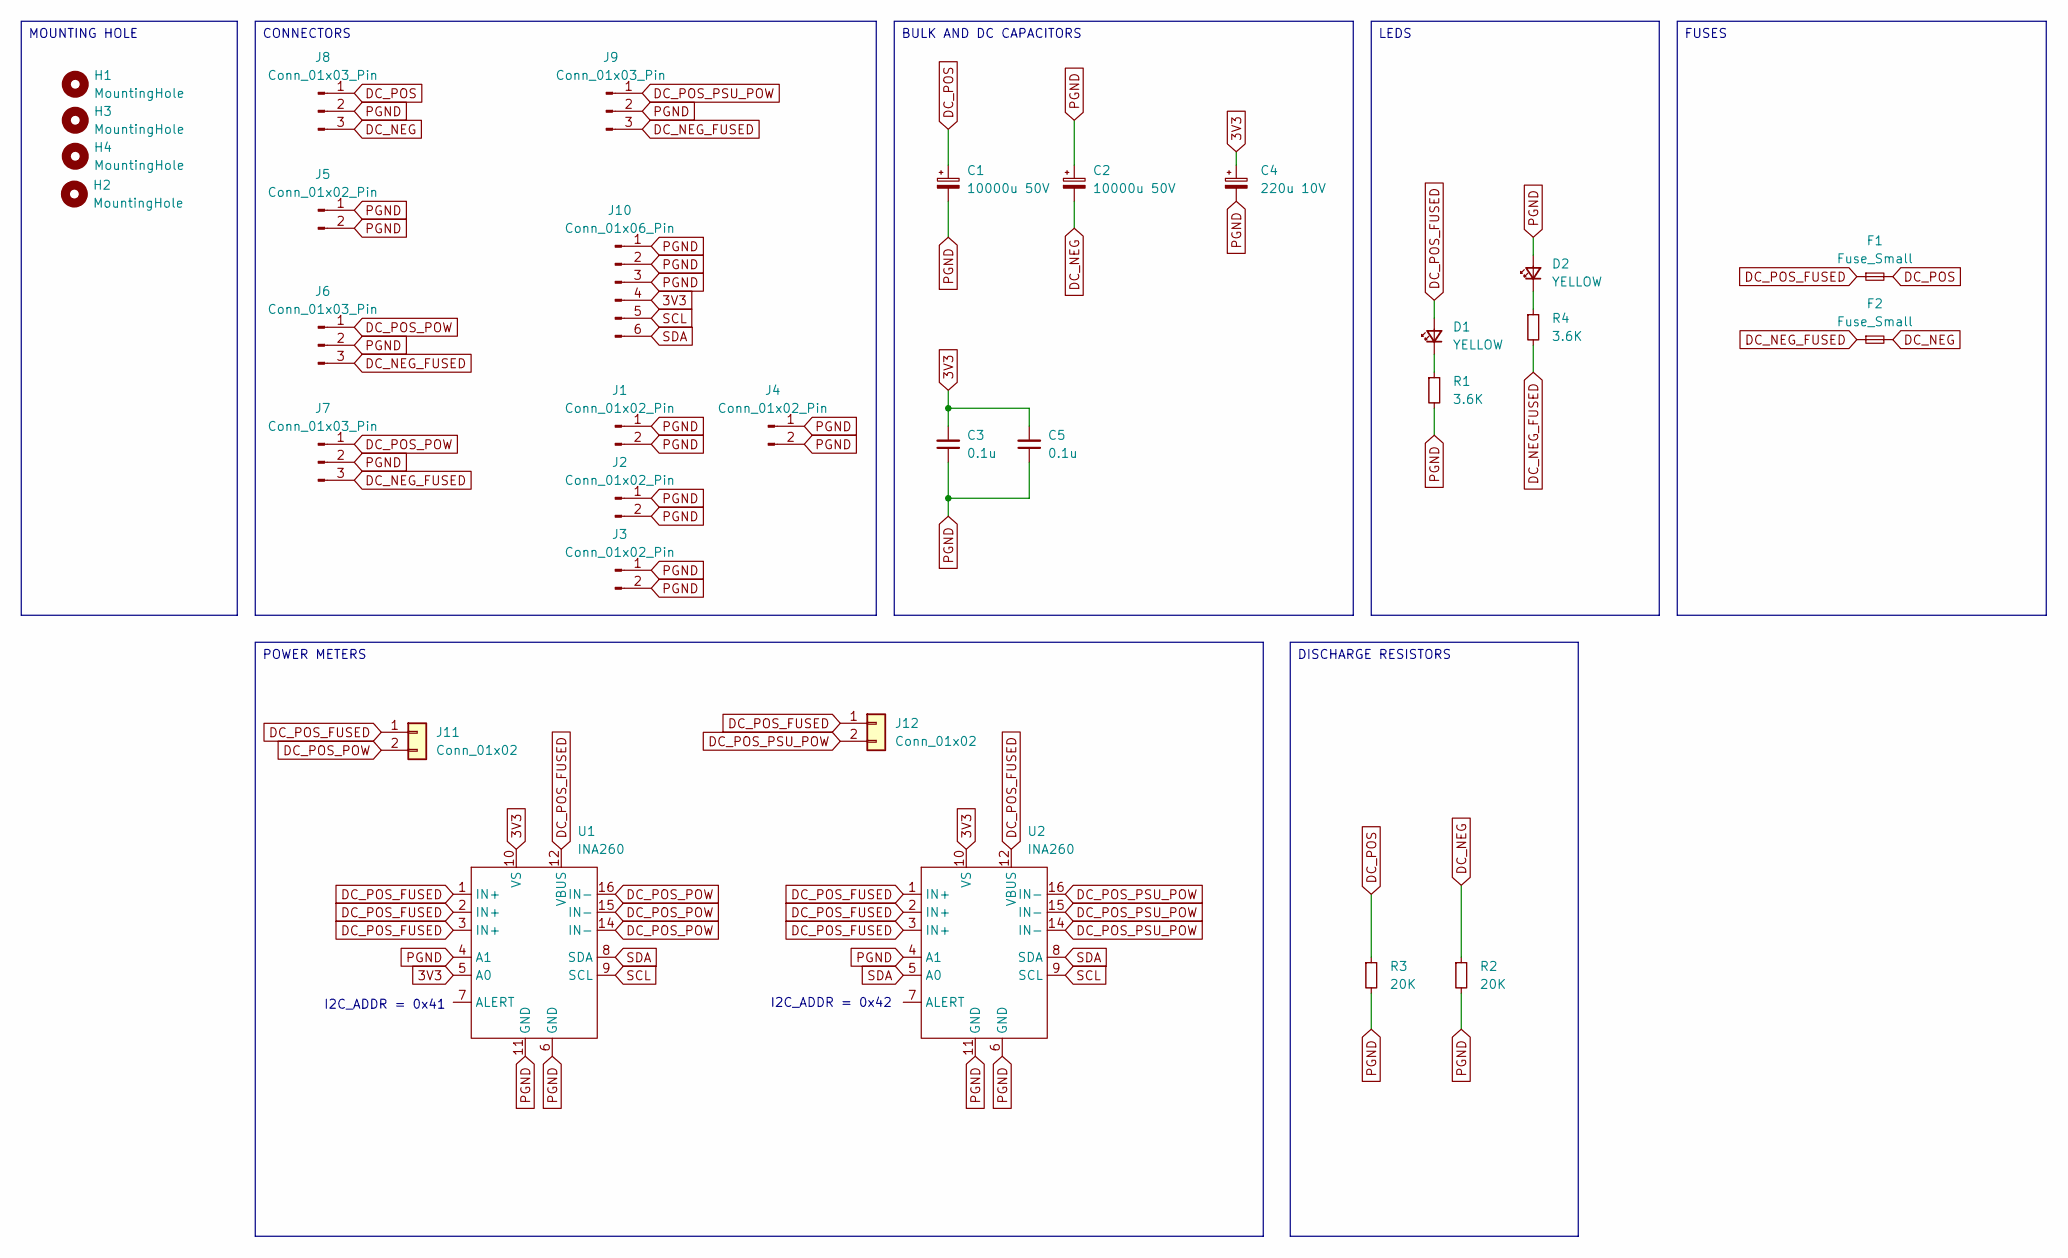
[picture p223: schematic psuentry.kicad_sch]

Parts:
C1, C2: 10000u 50V; CP_Radial_D25.0mm_P10.00mm_SnapIn
C3, C5: 0.1u; C_0805_2012Metric_Pad1.18x1.45mm_HandSolder
C4: 220u 10V; CP_Radial_D6.3mm_P2.50mm
D1, D2: YELLOW; LED_0805_2012Metric_Pad1.15x1.40mm_HandSolder
F1, F2: Fuse_Small; Aliexpress Fuse 5x20
H1, H2, H3, H4: MountingHole; MountingHole_3.2mm_M3_DIN965_Pad_TopOnly
J1, J2, J3, J4: Conn_01x02_Pin; JST_PH_B2B-PH-K_1x02_P2.00mm_Vertical
J5: Conn_01x02_Pin; JST_VH_B2P-VH-B_1x02_P3.96mm_Vertical
J6, J7, J8, J9: Conn_01x03_Pin; JST_VH_B3P-VH-B_1x03_P3.96mm_Vertical
J10: Conn_01x06_Pin; JST_PH_B6B-PH-K_1x06_P2.00mm_Vertical
J11, J12: Conn_01x02; PinHeader_1x02_P2.54mm_Vertical
R1, R4: 3.6K; R_0603_1608Metric_Pad0.98x0.95mm_HandSolder
R2, R3: 20K; R_0603_1608Metric_Pad0.98x0.95mm_HandSolder
U1, U2: INA260; TSSOP-16_4.4x5mm_P0.65mm

Connections:
3V3: C3.2, C4.1, C5.2, J10.4, U1.5 (A0), U1.10 (VS), U2.10 (VS)
DC_NEG: C2.2, F2.2, J8.3, R2.1
DC_NEG_FUSED: F2.1, J6.3, J7.3, J9.3, R4.2
DC_POS: C1.1, F1.2, J8.1, R3.1
DC_POS_FUSED: D1.2 (A), F1.1, J11.1, J12.1, U1.1 (IN+), U1.2 (IN+), U1.3 (IN+), U1.12 (VBUS), U2.1 (IN+), U2.2 (IN+), U2.3 (IN+), U2.12 (VBUS)
DC_POS_POW: J6.1, J7.1, J11.2, U1.14 (IN-), U1.15 (IN-), U1.16 (IN-)
DC_POS_PSU_POW: J9.1, J12.2, U2.14 (IN-), U2.15 (IN-), U2.16 (IN-)
unnamed: D1.1 (K), R1.1
unnamed: D2.1 (K), R4.1
PGND: C1.2, C2.1, C3.1, C4.2, C5.1, D2.2 (A), J1.1, J1.2, J2.1, J2.2, J3.1, J3.2, J4.1, J4.2, J5.1, J5.2, J6.2, J7.2, J8.2, J9.2, J10.1, J10.2, J10.3, R1.2, R2.2, R3.2, U1.4 (A1), U1.6 (GND), U1.11 (GND), U2.4 (A1), U2.6 (GND), U2.11 (GND)
SCL: J10.5, U1.9 (SCL), U2.9 (SCL)
SDA: J10.6, U1.8 (SDA), U2.5 (A0), U2.8 (SDA)

Notes on the sheet:
I2C_ADDR = 0x41
I2C_ADDR = 0x42
POWER METERS
CONNECTORS
BULK AND DC CAPACITORS
MOUNTING HOLE
LEDS
DISCHARGE RESISTORS
FUSES
