duanestorey/hifi-amp/pcbs/psu-monitor/1.0/multipsu.kicad_sch

## KiCad design pcbs/psu-monitor/1.0/multipsu.kicad_sch (2025-03-01)

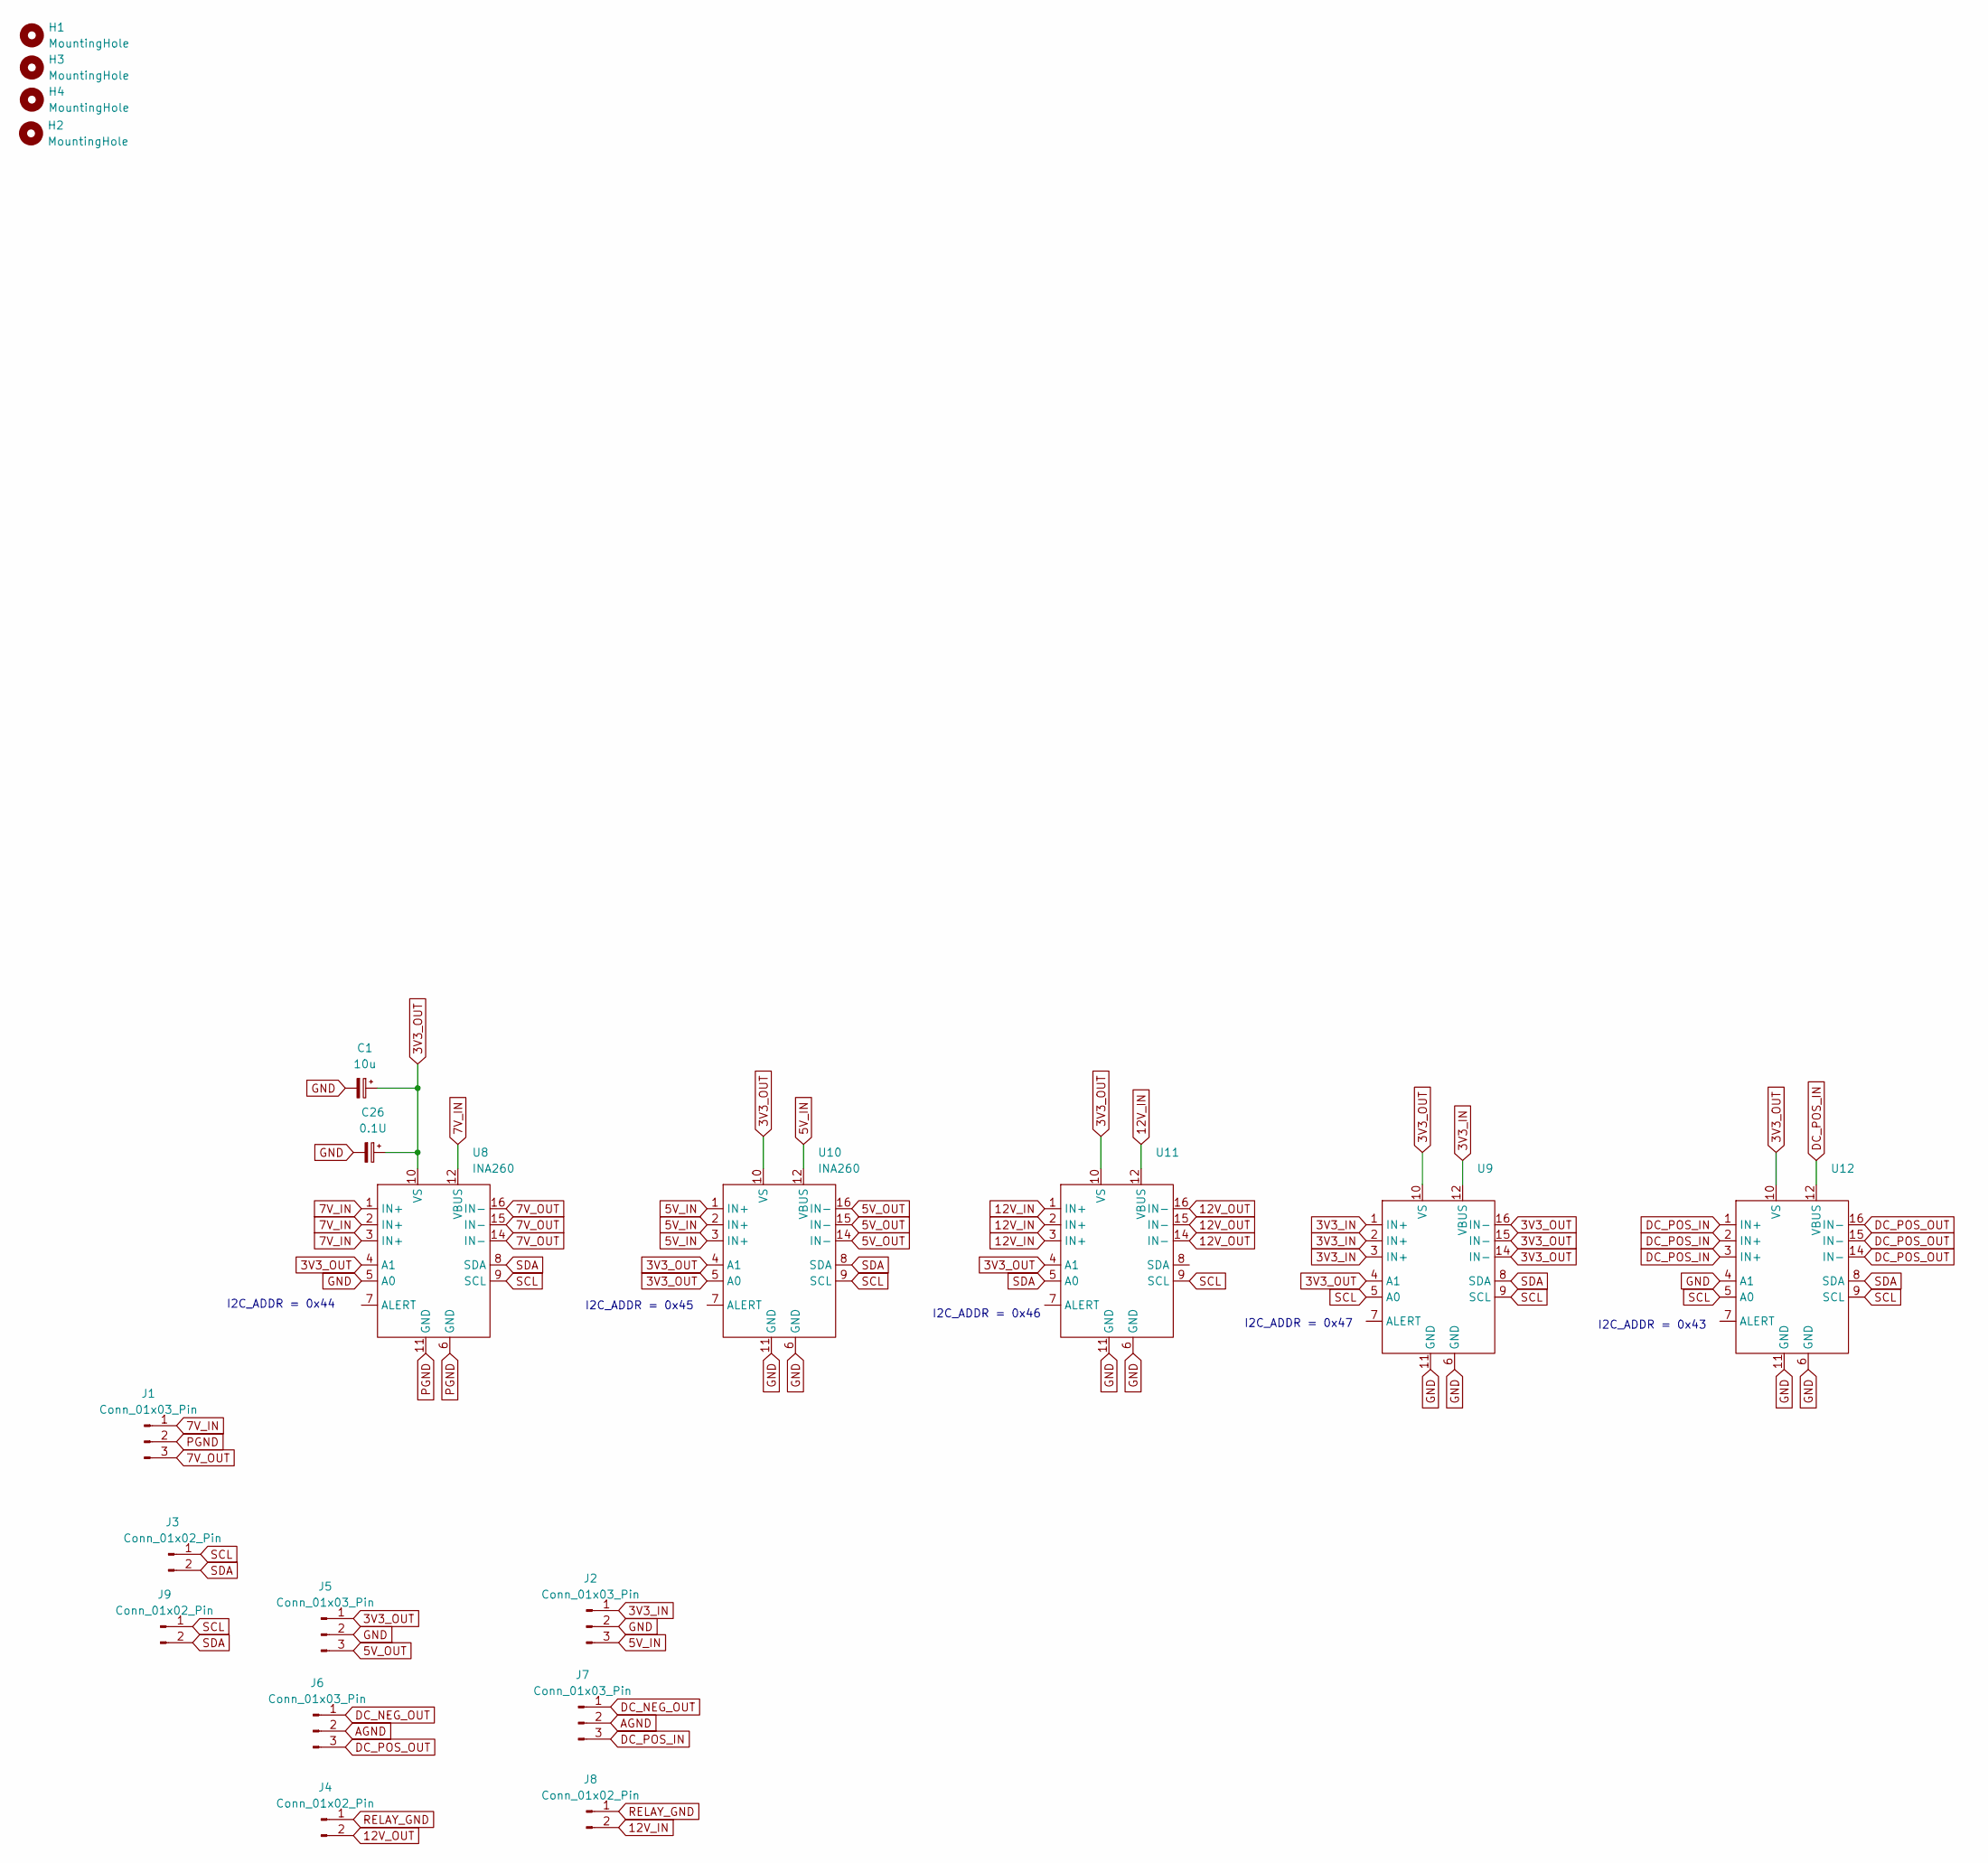
[picture p224: schematic multipsu.kicad_sch]

Parts:
C1: 10u; C_1206_3216Metric_Pad1.33x1.80mm_HandSolder
C26: 0.1U; C_0603_1608Metric_Pad1.08x0.95mm_HandSolder
H1, H2, H3, H4: MountingHole; MountingHole_3.2mm_M3_DIN965_Pad_TopOnly
J1, J2, J5, J6, J7: Conn_01x03_Pin; JST_PH_B3B-PH-K_1x03_P2.00mm_Vertical
J3, J4, J8, J9: Conn_01x02_Pin; JST_PH_B2B-PH-K_1x02_P2.00mm_Vertical
U8, U9, U10, U11, U12: INA260; TSSOP-16_4.4x5mm_P0.65mm

Connections:
3V3_IN: J2.1, U9.1 (IN+), U9.2 (IN+), U9.3 (IN+), U9.12 (VBUS)
3V3_OUT: C1.1, C26.1, J5.1, U8.4 (A1), U8.10 (VS), U9.4 (A1), U9.10 (VS), U9.14 (IN-), U9.15 (IN-), U9.16 (IN-), U10.4 (A1), U10.5 (A0), U10.10 (VS), U11.4 (A1), U11.10 (VS), U12.10 (VS)
5V_IN: J2.3, U10.1 (IN+), U10.2 (IN+), U10.3 (IN+), U10.12 (VBUS)
5V_OUT: J5.3, U10.14 (IN-), U10.15 (IN-), U10.16 (IN-)
7V_IN: J1.1, U8.1 (IN+), U8.2 (IN+), U8.3 (IN+), U8.12 (VBUS)
7V_OUT: J1.3, U8.14 (IN-), U8.15 (IN-), U8.16 (IN-)
12V_IN: J8.2, U11.1 (IN+), U11.2 (IN+), U11.3 (IN+), U11.12 (VBUS)
12V_OUT: J4.2, U11.14 (IN-), U11.15 (IN-), U11.16 (IN-)
AGND: J6.2, J7.2
DC_NEG_OUT: J6.1, J7.1
DC_POS_IN: J7.3, U12.1 (IN+), U12.2 (IN+), U12.3 (IN+), U12.12 (VBUS)
DC_POS_OUT: J6.3, U12.14 (IN-), U12.15 (IN-), U12.16 (IN-)
GND: C1.2, C26.2, J2.2, J5.2, U8.5 (A0), U9.6 (GND), U9.11 (GND), U10.6 (GND), U10.11 (GND), U11.6 (GND), U11.11 (GND), U12.4 (A1), U12.6 (GND), U12.11 (GND)
PGND: J1.2, U8.6 (GND), U8.11 (GND)
RELAY_GND: J4.1, J8.1
SCL: J3.1, J9.1, U8.9 (SCL), U9.5 (A0), U9.9 (SCL), U10.9 (SCL), U11.9 (SCL), U12.5 (A0), U12.9 (SCL)
SDA: J3.2, J9.2, U8.8 (SDA), U9.8 (SDA), U10.8 (SDA), U11.5 (A0), U12.8 (SDA)

Notes on the sheet:
I2C_ADDR = 0x47
I2C_ADDR = 0x44
I2C_ADDR = 0x46
I2C_ADDR = 0x45
I2C_ADDR = 0x43
