duanestorey/hifi-amp/pcbs/psu-monitor/1.2/monitor.kicad_sch

## KiCad design pcbs/psu-monitor/1.2/monitor.kicad_sch (2025-05-14)

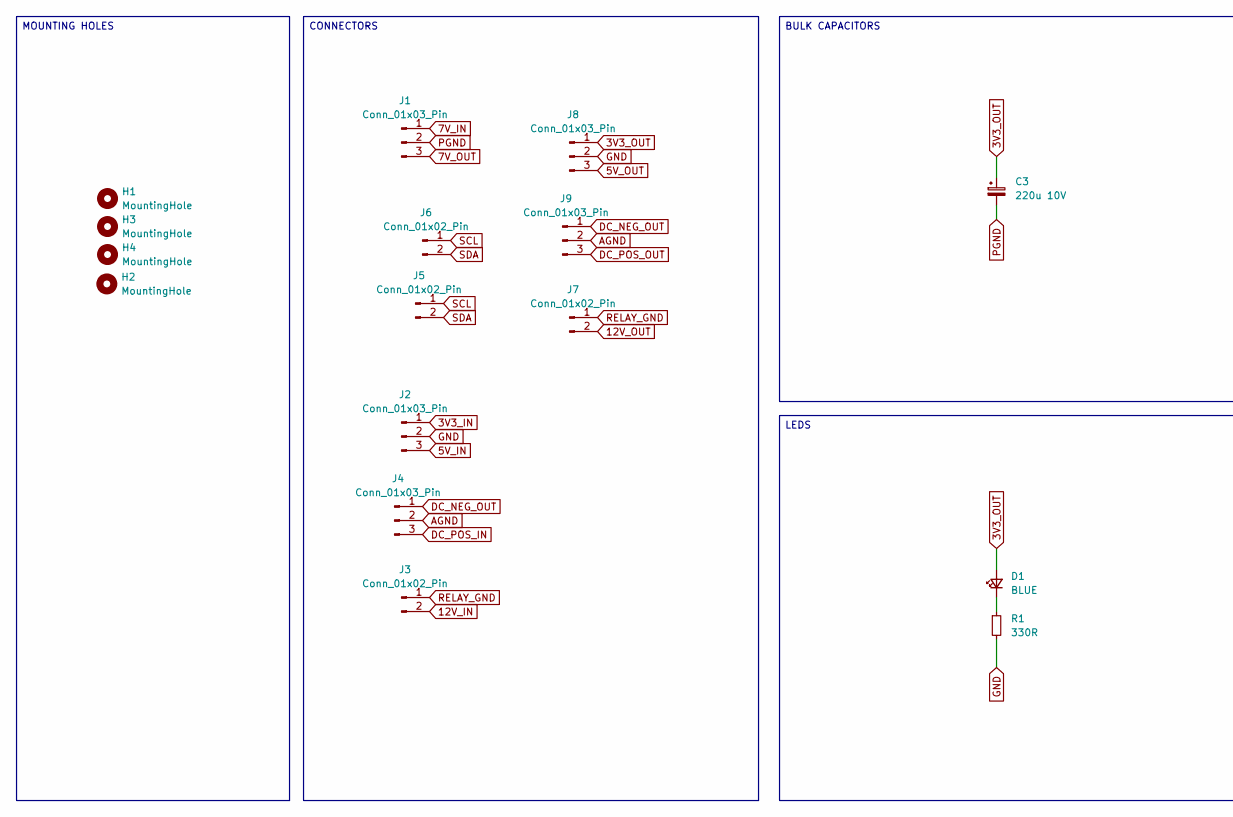
[picture p225: schematic monitor.kicad_sch, part in row 1, column 1]

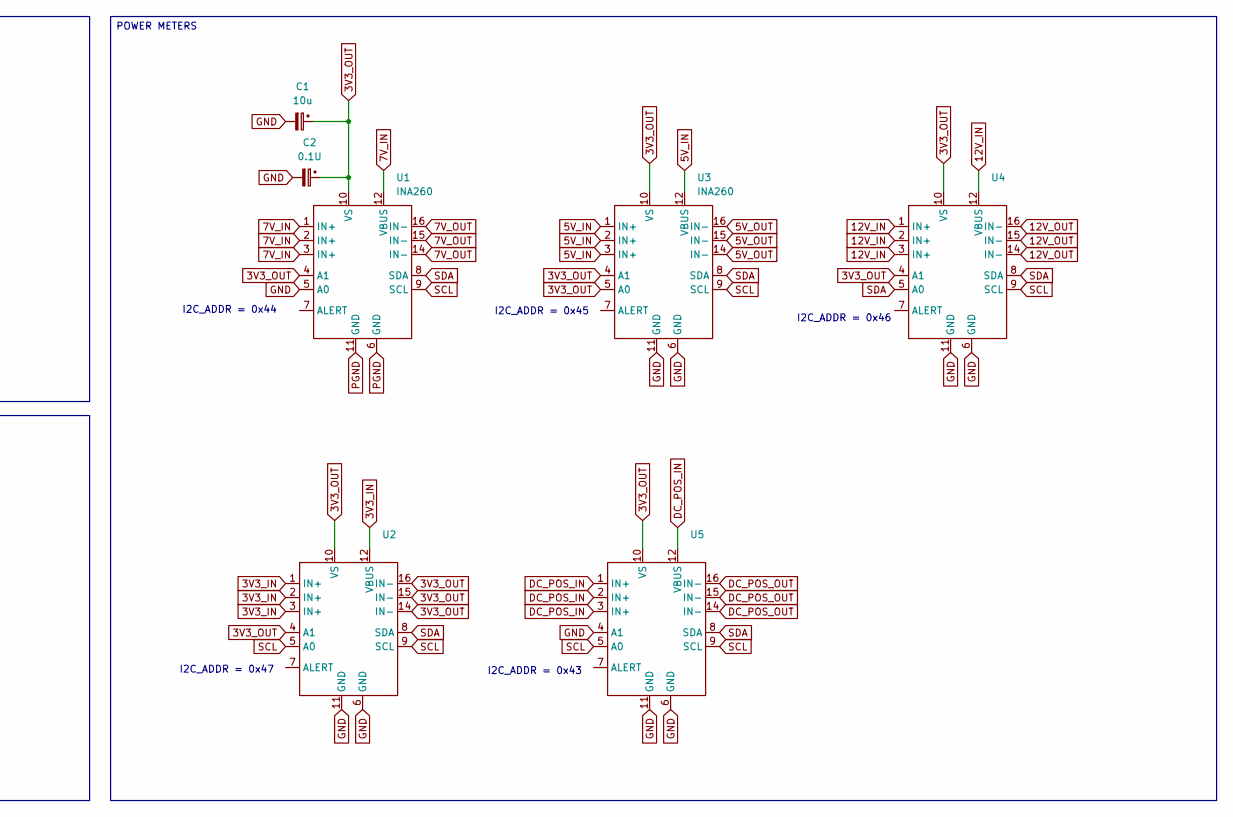
[picture p226: schematic monitor.kicad_sch, part in row 1, column 2]

Parts:
C1: 10u; C_1206_3216Metric_Pad1.33x1.80mm_HandSolder
C2: 0.1U; C_0603_1608Metric_Pad1.08x0.95mm_HandSolder
C3: 220u 10V; CP_Radial_D6.3mm_P2.50mm
D1: BLUE; LED_0805_2012Metric_Pad1.15x1.40mm_HandSolder
H1, H2, H3, H4: MountingHole; MountingHole_3.2mm_M3_DIN965_Pad_TopOnly
J1, J2, J4, J8, J9: Conn_01x03_Pin; JST_PH_B3B-PH-K_1x03_P2.00mm_Vertical
J3, J5, J6, J7: Conn_01x02_Pin; JST_PH_B2B-PH-K_1x02_P2.00mm_Vertical
R1: 330R; R_0603_1608Metric_Pad0.98x0.95mm_HandSolder
U1, U2, U3, U4, U5: INA260; TSSOP-16_4.4x5mm_P0.65mm

Connections:
3V3_IN: J2.1, U2.1 (IN+), U2.2 (IN+), U2.3 (IN+), U2.12 (VBUS)
3V3_OUT: C1.1, C2.1, C3.1, D1.2 (A), J8.1, U1.4 (A1), U1.10 (VS), U2.4 (A1), U2.10 (VS), U2.14 (IN-), U2.15 (IN-), U2.16 (IN-), U3.4 (A1), U3.5 (A0), U3.10 (VS), U4.4 (A1), U4.10 (VS), U5.10 (VS)
5V_IN: J2.3, U3.1 (IN+), U3.2 (IN+), U3.3 (IN+), U3.12 (VBUS)
5V_OUT: J8.3, U3.14 (IN-), U3.15 (IN-), U3.16 (IN-)
7V_IN: J1.1, U1.1 (IN+), U1.2 (IN+), U1.3 (IN+), U1.12 (VBUS)
7V_OUT: J1.3, U1.14 (IN-), U1.15 (IN-), U1.16 (IN-)
12V_IN: J3.2, U4.1 (IN+), U4.2 (IN+), U4.3 (IN+), U4.12 (VBUS)
12V_OUT: J7.2, U4.14 (IN-), U4.15 (IN-), U4.16 (IN-)
AGND: J4.2, J9.2
DC_NEG_OUT: J4.1, J9.1
DC_POS_IN: J4.3, U5.1 (IN+), U5.2 (IN+), U5.3 (IN+), U5.12 (VBUS)
DC_POS_OUT: J9.3, U5.14 (IN-), U5.15 (IN-), U5.16 (IN-)
GND: C1.2, C2.2, J2.2, J8.2, R1.2, U1.5 (A0), U2.6 (GND), U2.11 (GND), U3.6 (GND), U3.11 (GND), U4.6 (GND), U4.11 (GND), U5.4 (A1), U5.6 (GND), U5.11 (GND)
unnamed: D1.1 (K), R1.1
PGND: C3.2, J1.2, U1.6 (GND), U1.11 (GND)
RELAY_GND: J3.1, J7.1
SCL: J5.1, J6.1, U1.9 (SCL), U2.5 (A0), U2.9 (SCL), U3.9 (SCL), U4.9 (SCL), U5.5 (A0), U5.9 (SCL)
SDA: J5.2, J6.2, U1.8 (SDA), U2.8 (SDA), U3.8 (SDA), U4.5 (A0), U4.8 (SDA), U5.8 (SDA)

Notes on the sheet:
I2C_ADDR = 0x47
I2C_ADDR = 0x44
I2C_ADDR = 0x46
I2C_ADDR = 0x45
I2C_ADDR = 0x43
LEDS
CONNECTORS
POWER METERS
MOUNTING HOLES
BULK CAPACITORS
