duanestorey/hifi-amp/pcbs/psu-multi/1.1/multipsu.kicad_sch

## KiCad design pcbs/psu-multi/1.1/multipsu.kicad_sch (2025-03-21)

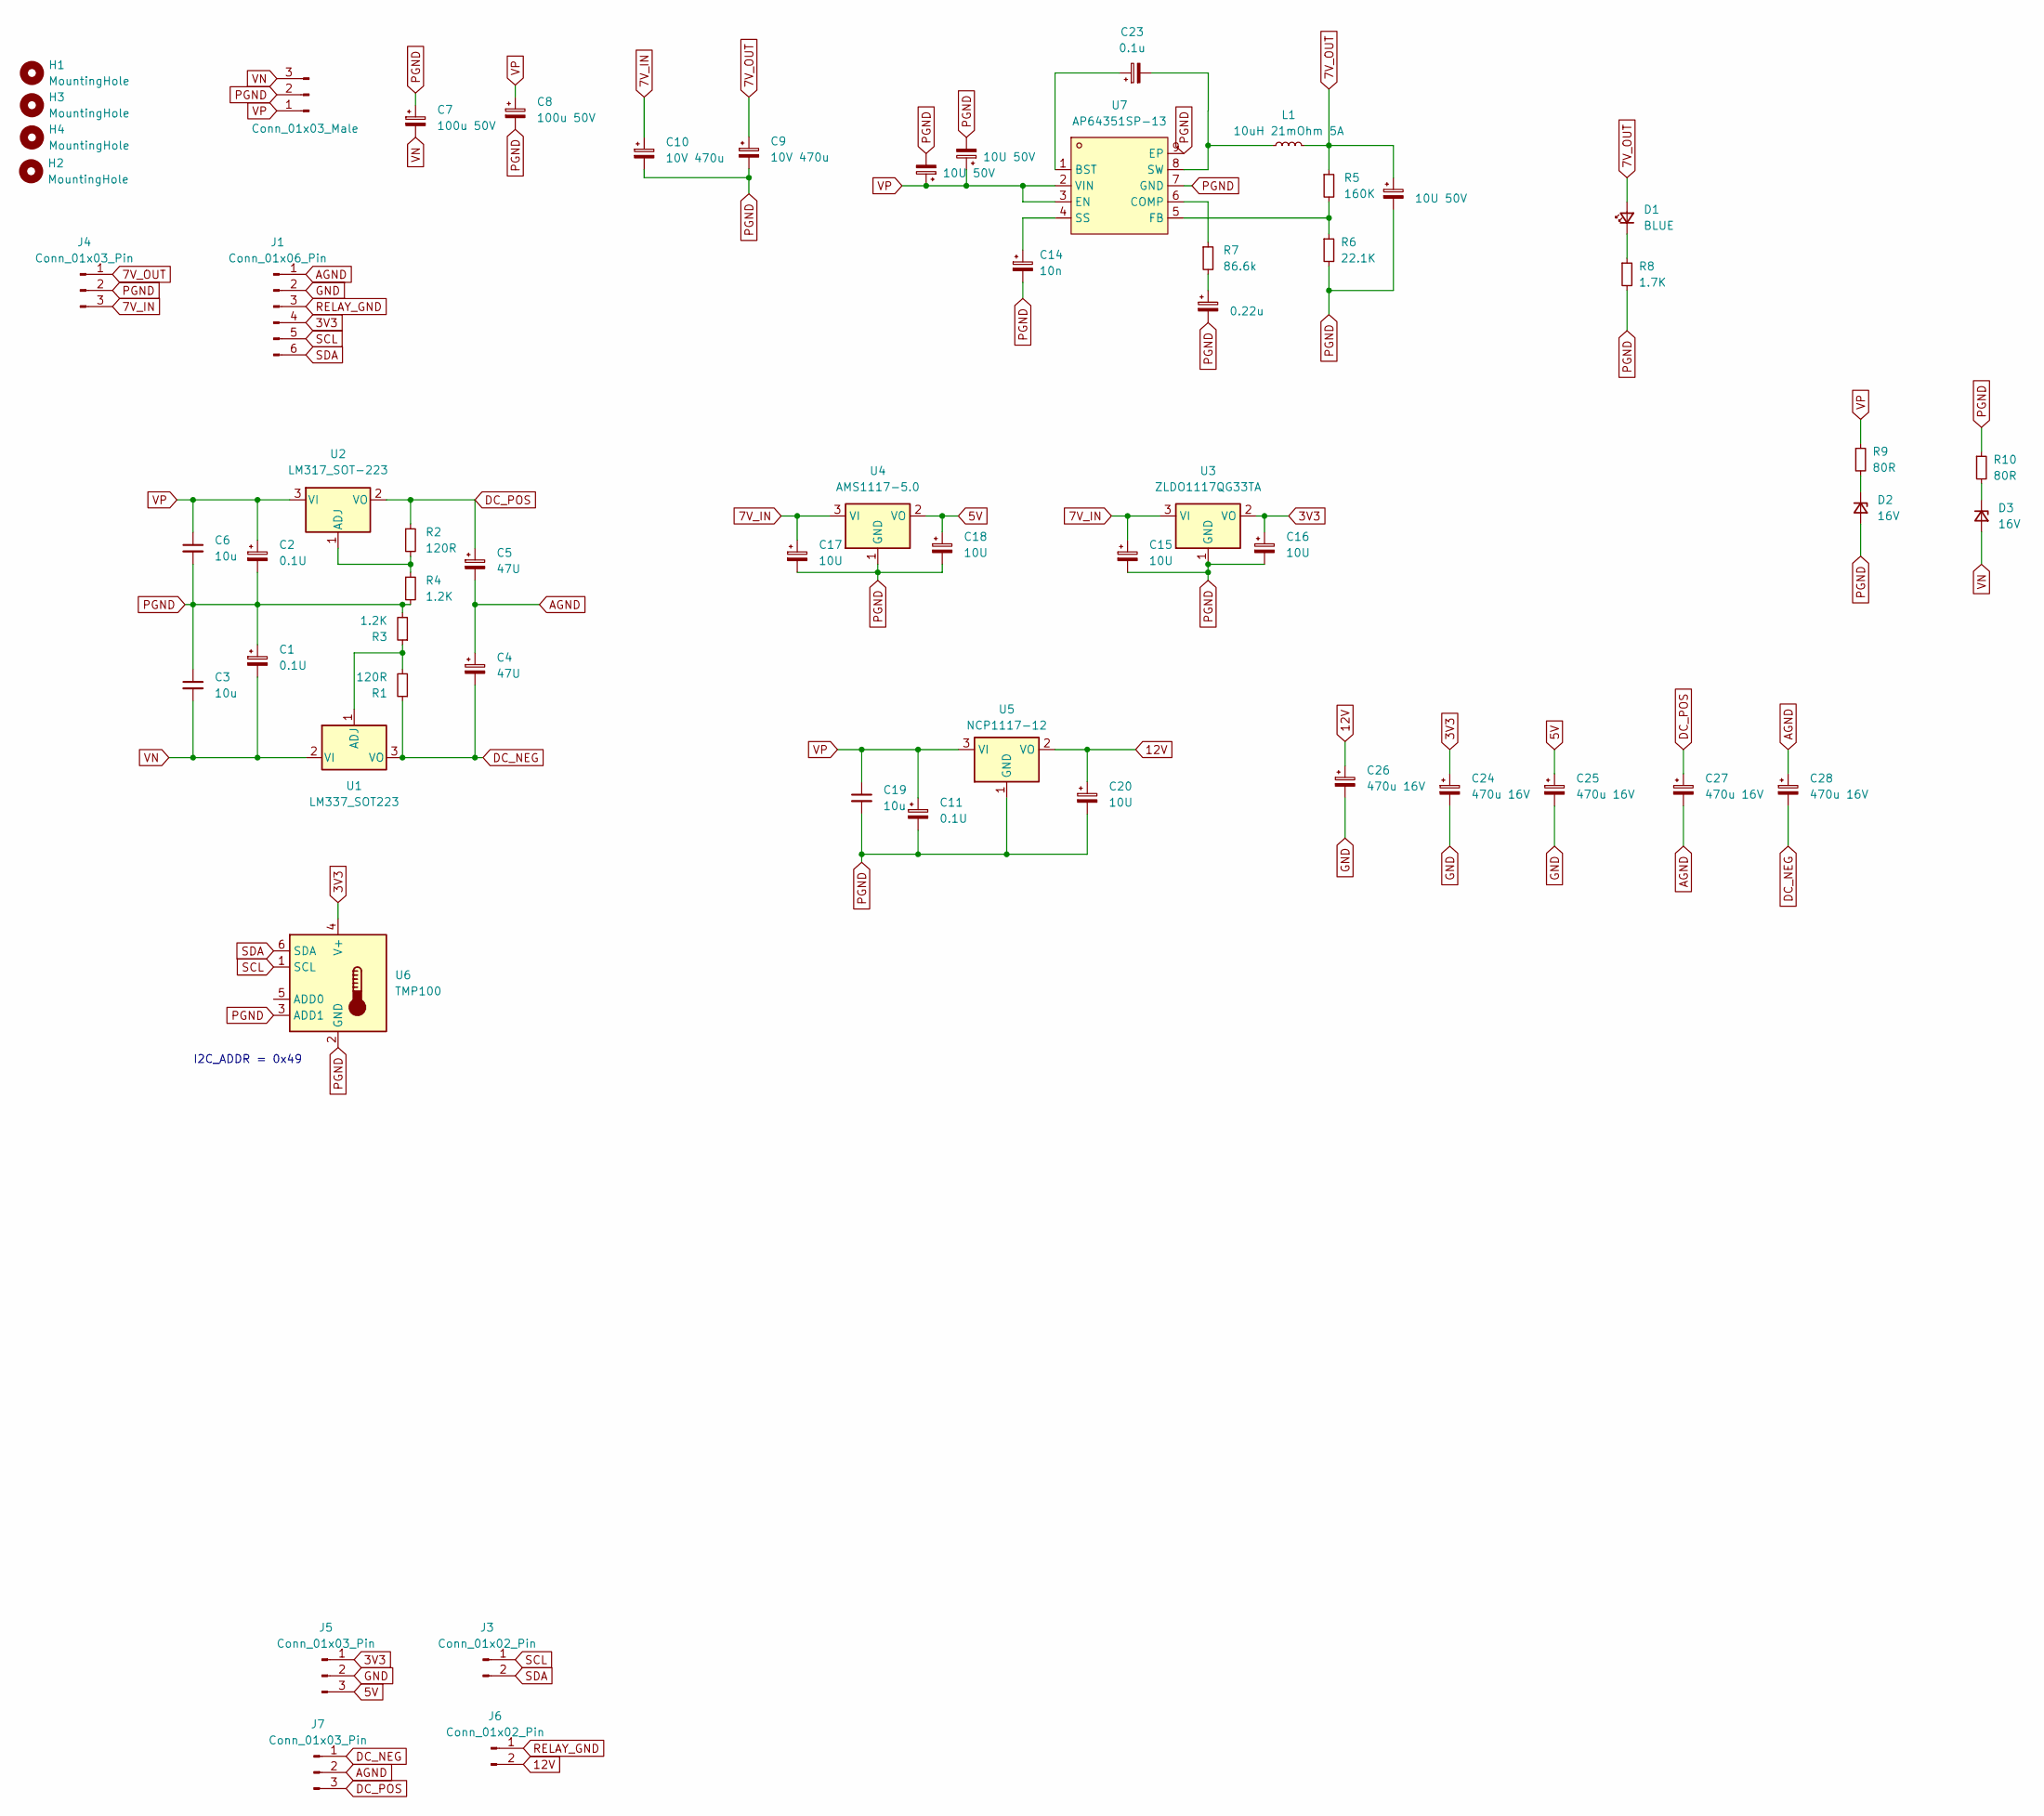
[picture p227: schematic multipsu.kicad_sch]

Parts:
C1, C2, C11: 0.1U; C_0603_1608Metric_Pad1.08x0.95mm_HandSolder
C3, C6, C19: 10u; C_1206_3216Metric_Pad1.33x1.80mm_HandSolder
C4, C5: 47U; C_1206_3216Metric_Pad1.33x1.80mm_HandSolder
C7, C8: 100u 50V; CP_Radial_D8.0mm_P3.50mm
C9, C10: 10V 470u; CP_Radial_D8.0mm_P3.50mm
C12, C21, C22: 10U 50V; C_1206_3216Metric_Pad1.33x1.80mm_HandSolder
C13: 0.22u; C_0805_2012Metric_Pad1.18x1.45mm_HandSolder
C14: 10n; C_0805_2012Metric_Pad1.18x1.45mm_HandSolder
C15, C16, C17, C18, C20: 10U; C_1206_3216Metric_Pad1.33x1.80mm_HandSolder
C23: 0.1u; C_0805_2012Metric_Pad1.18x1.45mm_HandSolder
C24, C25, C26, C27, C28: 470u 16V; CP_Radial_D6.3mm_P2.50mm
D1: BLUE; LED_0805_2012Metric_Pad1.15x1.40mm_HandSolder
D2, D3: 16V
H1, H2, H3, H4: MountingHole; MountingHole_3.2mm_M3_DIN965_Pad_TopOnly
J1: Conn_01x06_Pin; JST_PH_B6B-PH-K_1x06_P2.00mm_Vertical
J2: Conn_01x03_Male; JST_VH_B3P-VH_1x03_P3.96mm_Vertical
J3, J6: Conn_01x02_Pin; JST_PH_B2B-PH-K_1x02_P2.00mm_Vertical
J4, J5, J7: Conn_01x03_Pin; JST_PH_B3B-PH-K_1x03_P2.00mm_Vertical
L1: 10uH 21mOhm 5A; L_Vishay_IHLP-4040; Mouser 704-DR1040-7R0-R
R1, R2: 120R; R_0603_1608Metric_Pad0.98x0.95mm_HandSolder
R3, R4: 1.2K; R_0603_1608Metric_Pad0.98x0.95mm_HandSolder
R5: 160K; R_0603_1608Metric_Pad0.98x0.95mm_HandSolder; Mouser 603-RC0603JR-10180KL
R6: 22.1K; R_0603_1608Metric_Pad0.98x0.95mm_HandSolder; Mouser 603-RC0603JR-07820KP
R7: 86.6k; R_0603_1608Metric_Pad0.98x0.95mm_HandSolder; Mouser 71-CRCW0603-86.6K-E3
R8: 1.7K; R_0603_1608Metric_Pad0.98x0.95mm_HandSolder; Mouser 603-RC0603JR-07820KP
R9, R10: 80R; R_2512_6332Metric_Pad1.40x3.35mm_HandSolder; Mouser 603-RC2512FK-0780R6L
U1: LM337_SOT223; SOT-223-3_TabPin2; Mouser 926-LM337IMPX/NOPB
U2: LM317_SOT-223; SOT-223-3_TabPin2; Mouser 595-LM317DCY
U3: ZLDO1117QG33TA; SOT-223-3_TabPin2; Mouser ZLDO1117QG33TA
U4: AMS1117-5.0; SOT-223-3_TabPin2; Mouser 926-LM1117MPX5.0NOPB
U5: NCP1117-12; SOT-223; Mouser 863-NCP1117ST12T3G
U6: TMP100; SOT-23-6
U7: AP64351SP-13; SOIC-8_L4.9-W3.9-P1.27-LS6.0-BL-EP; LCSC Part C3192339

Connections:
3V3: C16.1, C24.1, J1.4, J5.1, U3.2 (VO), U6.4 (V+)
5V: C18.1, C25.1, J5.3, U4.2 (VO)
7V_IN: C10.1, C15.1, C17.1, J4.3, U3.3 (VI), U4.3 (VI)
7V_OUT: C9.1, C12.1, D1.2 (A), J4.1, L1.2, R5.1
12V: C20.1, C26.1, J6.2, U5.2 (VO)
AGND: C4.1, C5.2, C27.2, C28.1, J1.1, J7.2
DC_NEG: C4.2, C28.2, J7.1, R1.1, U1.3 (VO)
DC_POS: C5.1, C27.1, J7.3, R2.1, U2.2 (VO)
GND: C24.2, C25.2, C26.2, J1.2, J5.2
unnamed: C13.1, R7.2
unnamed: C14.1, U7.4 (SS)
unnamed: C23.1, U7.1 (BST)
unnamed: C23.2, L1.1, U7.8 (SW)
unnamed: D1.1 (K), R8.1
unnamed: D2.1 (K), R9.2
unnamed: D3.1 (K), R10.2
unnamed: R1.2, R3.1, U1.1 (ADJ)
unnamed: R2.2, R4.1, U2.1 (ADJ)
unnamed: R5.2, R6.1, U7.5 (FB)
unnamed: R7.1, U7.6 (COMP)
PGND: C1.1, C2.2, C3.1, C6.2, C7.1, C8.2, C9.2, C10.2, C11.2, C12.2, C13.2, C14.2, C15.2, C16.2, C17.2, C18.2, C19.2, C20.2, C21.2, C22.2, D2.2 (A), J2.2, J4.2, R3.2, R4.2, R6.2, R8.2, R10.1, U3.1 (GND), U4.1 (GND), U5.1 (GND), U6.2 (GND), U6.3 (ADD1), U7.7 (GND), U7.9 (EP)
RELAY_GND: J1.3, J6.1
SCL: J1.5, J3.1, U6.1 (SCL)
SDA: J1.6, J3.2, U6.6 (SDA)
VN: C1.2, C3.2, C7.2, D3.2 (A), J2.3, U1.2 (VI)
VP: C2.1, C6.1, C8.1, C11.1, C19.1, C21.1, C22.1, J2.1, R9.1, U2.3 (VI), U5.3 (VI), U7.2 (VIN), U7.3 (EN)

Notes on the sheet:
I2C_ADDR = 0x49
