duanestorey/hifi-amp/pcbs/psu-multi/1.5/multipsu.kicad_sch

## KiCad design pcbs/psu-multi/1.5/multipsu.kicad_sch (2025-05-14)

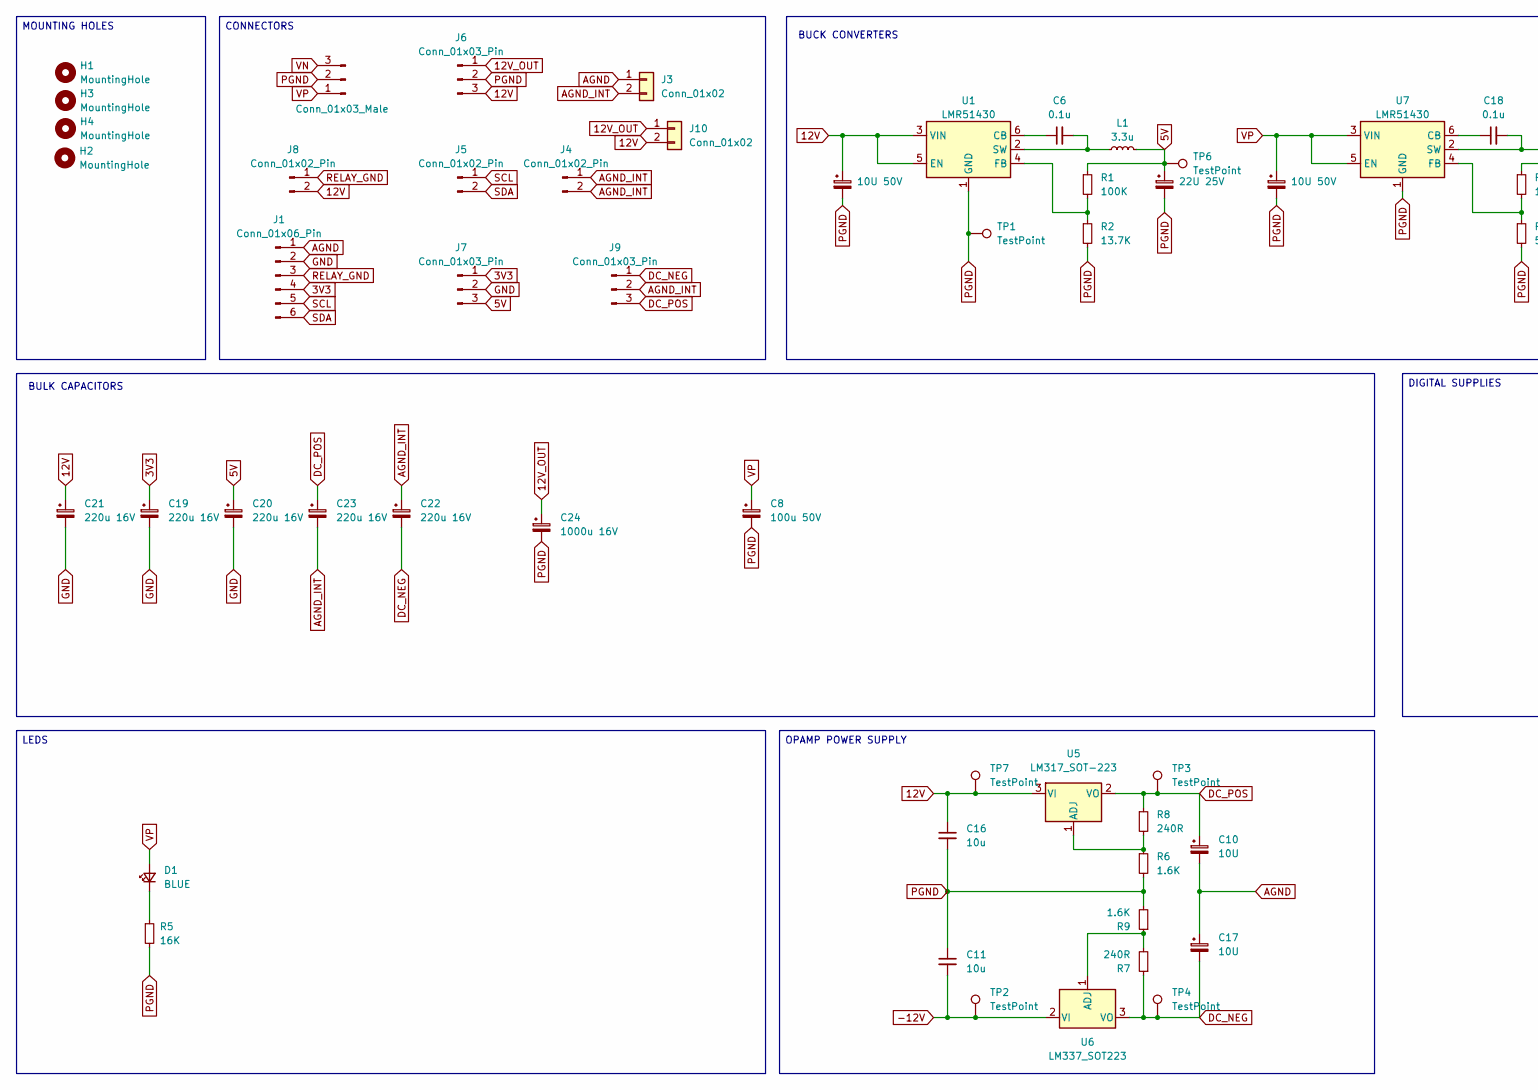
[picture p228: schematic multipsu.kicad_sch, part in row 1, column 1]

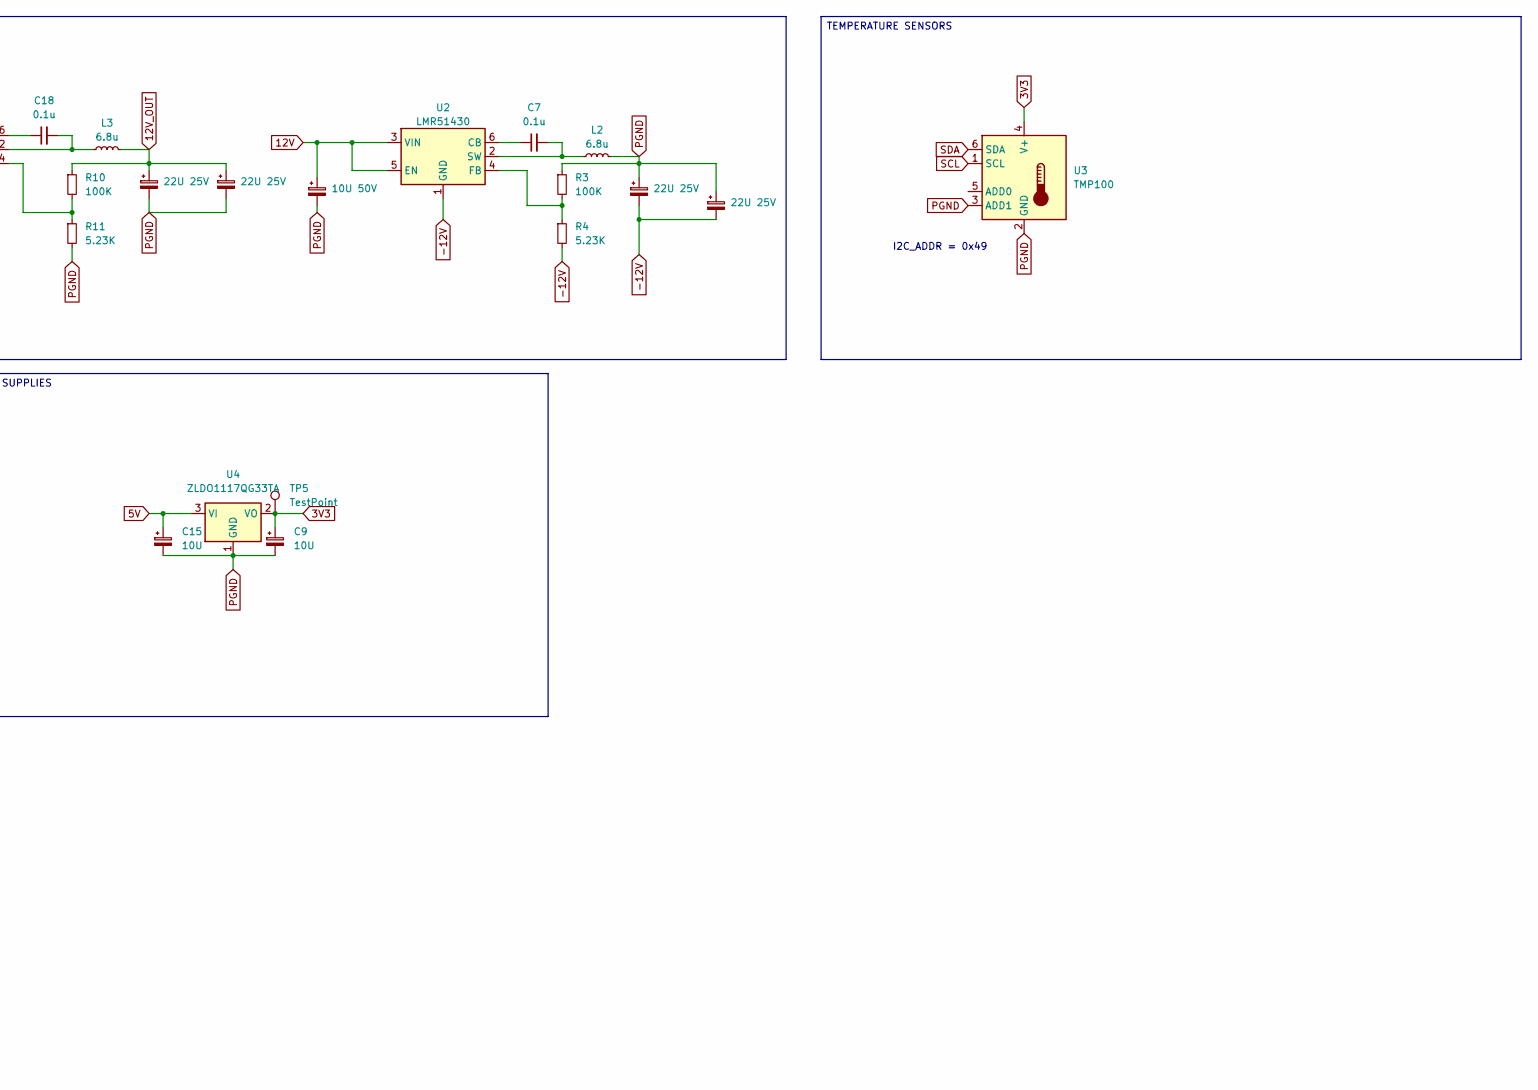
[picture p229: schematic multipsu.kicad_sch, part in row 1, column 2]

Parts:
C1, C2, C3, C12, C14: 22U 25V; C_1206_3216Metric_Pad1.33x1.80mm_HandSolder
C4, C5, C13: 10U 50V; C_1206_3216Metric_Pad1.33x1.80mm_HandSolder
C6, C7, C18: 0.1u; C_0805_2012Metric_Pad1.18x1.45mm_HandSolder
C8: 100u 50V; CP_Radial_D8.0mm_P3.50mm; Mouser RGA101M1HBK-0811G
C9, C10, C15, C17: 10U; C_1206_3216Metric_Pad1.33x1.80mm_HandSolder
C11, C16: 10u; C_1206_3216Metric_Pad1.33x1.80mm_HandSolder
C19, C20, C21, C22, C23: 220u 16V; CP_Radial_D6.3mm_P2.50mm
C24: 1000u 16V; CP_Radial_D8.0mm_P3.50mm
D1: BLUE; LED_0805_2012Metric_Pad1.15x1.40mm_HandSolder
H1, H2, H3, H4: MountingHole; MountingHole_3.2mm_M3_DIN965_Pad_TopOnly
J1: Conn_01x06_Pin; JST_PH_B6B-PH-K_1x06_P2.00mm_Vertical
J2: Conn_01x03_Male; JST_VH_B3P-VH_1x03_P3.96mm_Vertical
J3, J10: Conn_01x02; PinHeader_1x02_P2.54mm_Vertical
J4, J5, J8: Conn_01x02_Pin; JST_PH_B2B-PH-K_1x02_P2.00mm_Vertical
J6, J7, J9: Conn_01x03_Pin; JST_PH_B3B-PH-K_1x03_P2.00mm_Vertical
L1: 3.3u; L_Sunlord_MWSA0605S
L2, L3: 6.8u; L_Sunlord_MWSA0605S
R1, R3, R10: 100K; R_0603_1608Metric_Pad0.98x0.95mm_HandSolder; Mouser RC0603DR-07100KL
R2: 13.7K; R_0603_1608Metric_Pad0.98x0.95mm_HandSolder; Mouser RT0603DRE0713K7L
R4, R11: 5.23K; R_0603_1608Metric_Pad0.98x0.95mm_HandSolder; Mouser ERJ-3RBD5231V
R5: 16K; R_0603_1608Metric_Pad0.98x0.95mm_HandSolder; Mouser 603-RC0603JR-07820KP
R6, R9: 1.6K; R_0603_1608Metric_Pad0.98x0.95mm_HandSolder; Mouser RC0603FR-071K6L
R7, R8: 240R; R_0603_1608Metric_Pad0.98x0.95mm_HandSolder; Mouser RC0603FR-07240RL
TP1, TP2, TP3, TP4, TP5, TP6, TP7: TestPoint; TestPoint_THTPad_D2.0mm_Drill1.0mm
U1, U2, U7: LMR51430; SOT-23-6
U3: TMP100; SOT-23-6
U4: ZLDO1117QG33TA; SOT-223-3_TabPin2; Mouser ZLDO1117QG33TA
U5: LM317_SOT-223; SOT-223-3_TabPin2; Mouser 595-LM317DCY
U6: LM337_SOT223; SOT-223-3_TabPin2; Mouser 926-LM337IMPX/NOPB

Connections:
3V3: C9.1, C19.1, J1.4, J7.1, TP5.1, U3.4 (V+), U4.2 (VO)
5V: C1.1, C15.1, C20.1, J7.3, L1.2, R1.1, TP6.1, U4.3 (VI)
12V: C4.1, C5.1, C16.1, C21.1, J6.3, J8.2, J10.2, TP7.1, U1.3 (VIN), U1.5 (EN), U2.3 (VIN), U2.5 (EN), U5.3 (VI)
12V_OUT: C12.1, C14.1, C24.1, J6.1, J10.1, L3.2, R10.1
-12V: C2.2, C3.2, C11.2, R4.2, TP2.1, U2.1 (GND), U6.2 (VI)
AGND: C10.2, C17.1, J1.1, J3.1
AGND_INT: C22.1, C23.2, J3.2, J4.1, J4.2, J9.2
DC_NEG: C17.2, C22.2, J9.1, R7.1, TP4.1, U6.3 (VO)
DC_POS: C10.1, C23.1, J9.3, R8.1, TP3.1, U5.2 (VO)
GND: C19.2, C20.2, C21.2, J1.2, J7.2
unnamed: C6.1, U1.6 (CB)
unnamed: C6.2, L1.1, U1.2 (SW)
unnamed: C7.1, U2.6 (CB)
unnamed: C7.2, L2.1, U2.2 (SW)
unnamed: C18.1, U7.6 (CB)
unnamed: C18.2, L3.1, U7.2 (SW)
unnamed: D1.1 (K), R5.1
unnamed: R1.2, R2.1, U1.4 (FB)
unnamed: R3.2, R4.1, U2.4 (FB)
unnamed: R6.1, R8.2, U5.1 (ADJ)
unnamed: R7.2, R9.1, U6.1 (ADJ)
unnamed: R10.2, R11.1, U7.4 (FB)
PGND: C1.2, C2.1, C3.1, C4.2, C5.2, C8.2, C9.2, C11.1, C12.2, C13.2, C14.2, C15.2, C16.2, C24.2, J2.2, J6.2, L2.2, R2.2, R3.1, R5.2, R6.2, R9.2, R11.2, TP1.1, U1.1 (GND), U3.2 (GND), U3.3 (ADD1), U4.1 (GND), U7.1 (GND)
RELAY_GND: J1.3, J8.1
SCL: J1.5, J5.1, U3.1 (SCL)
SDA: J1.6, J5.2, U3.6 (SDA)
VN: J2.3
VP: C8.1, C13.1, D1.2 (A), J2.1, U7.3 (VIN), U7.5 (EN)

Notes on the sheet:
BULK CAPACITORS
I2C_ADDR = 0x49
BUCK CONVERTERS
CONNECTORS
DIGITAL SUPPLIES
TEMPERATURE SENSORS
MOUNTING HOLES
OPAMP POWER SUPPLY
LEDS
