duanestorey/hifi-amp/pcbs/psu-split/1.2/split.kicad_sch

## KiCad design pcbs/psu-split/1.2/split.kicad_sch (2025-03-21)

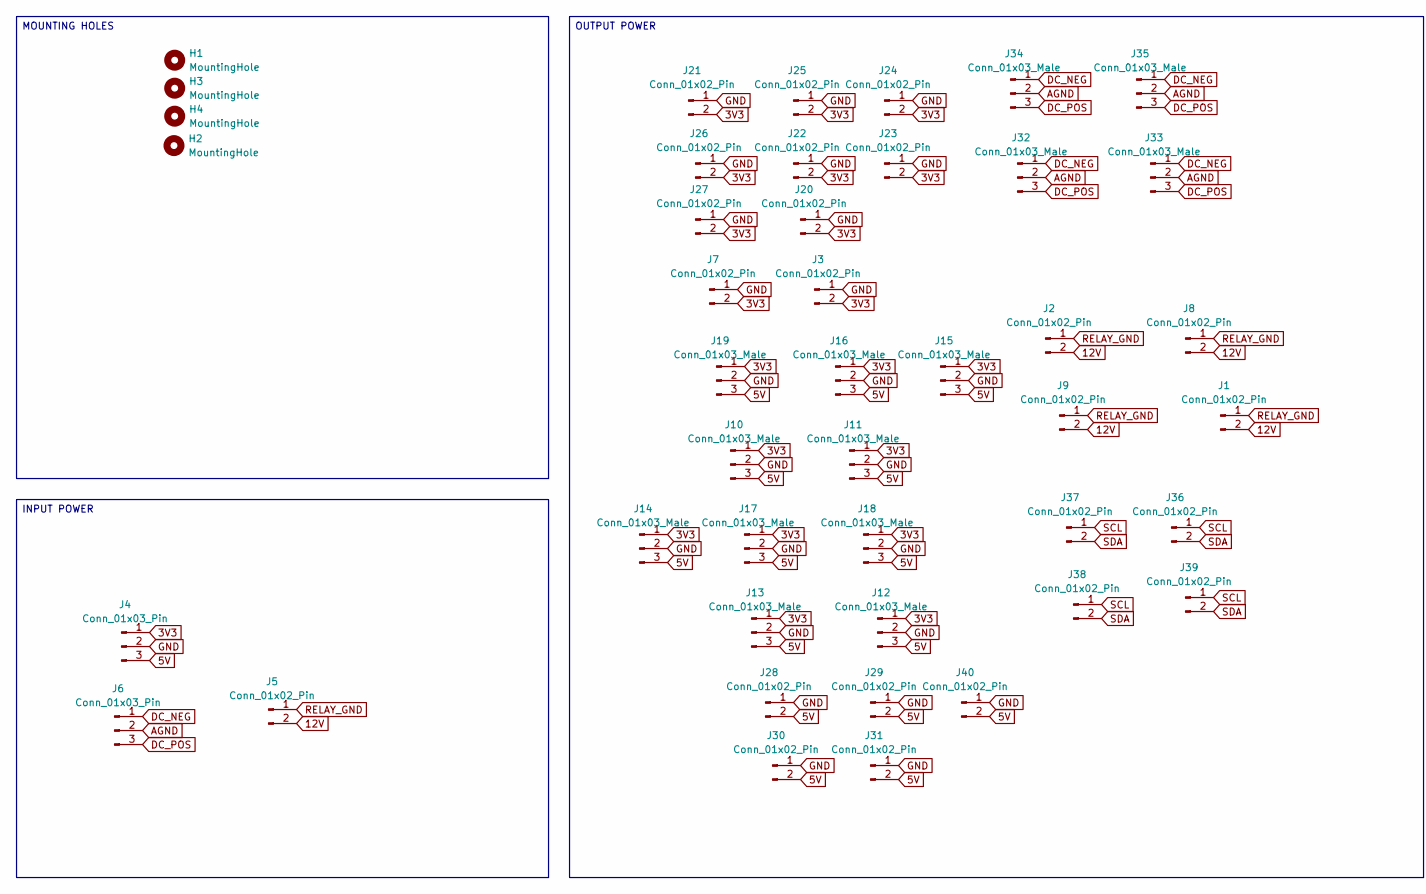
[picture p230: schematic split.kicad_sch, part in row 1, column 1]

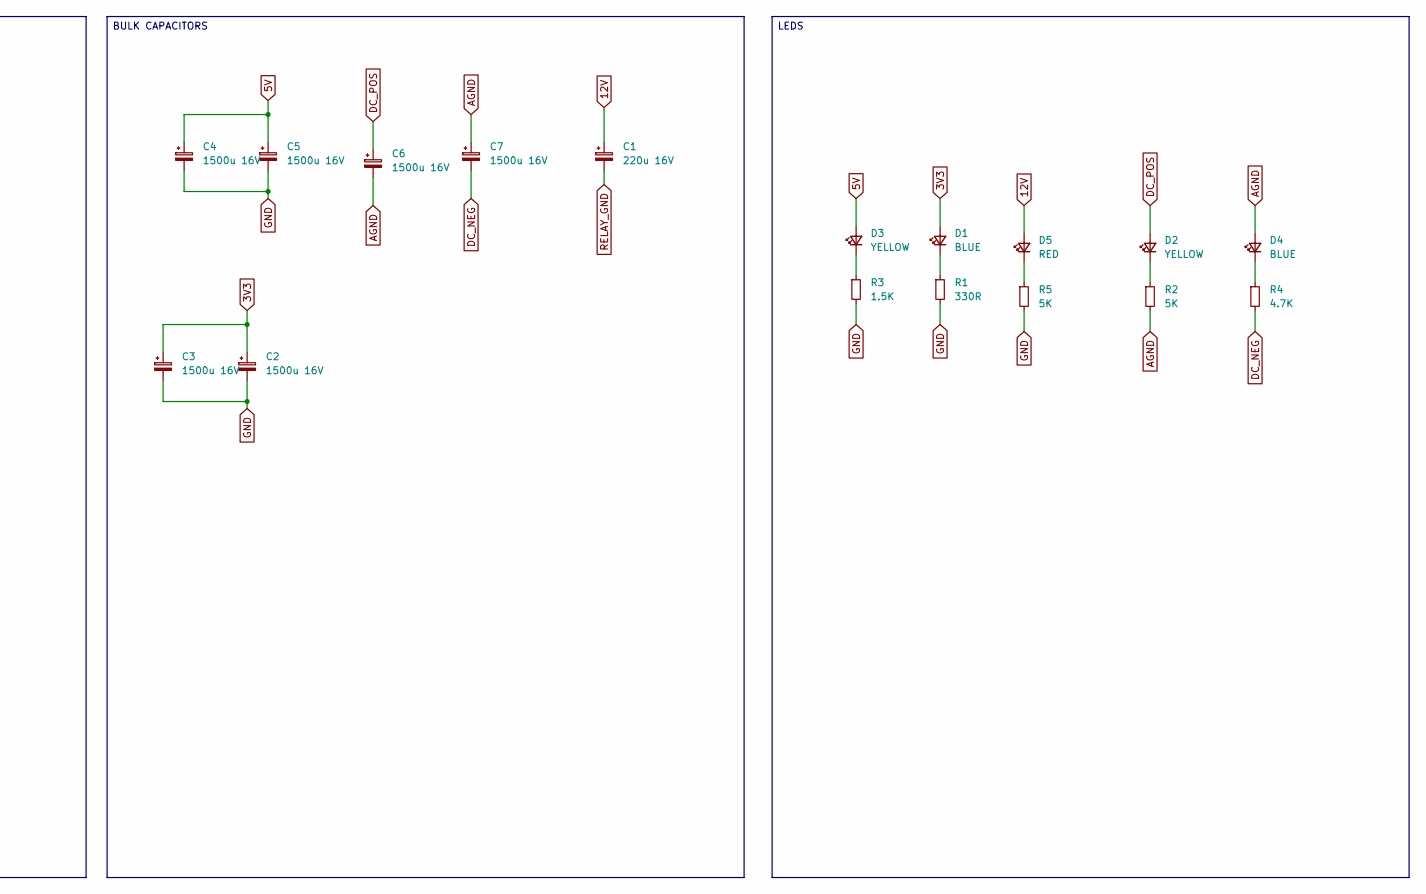
[picture p231: schematic split.kicad_sch, part in row 1, column 2]

Parts:
C1: 220u 16V; CP_Radial_D6.3mm_P2.50mm
C2, C3, C4, C5, C6, C7: 1500u 16V; CP_Radial_D10.0mm_P2.50mm_P5.00mm
D1, D4: BLUE; LED_0805_2012Metric_Pad1.15x1.40mm_HandSolder
D2, D3: YELLOW; LED_0805_2012Metric_Pad1.15x1.40mm_HandSolder
D5: RED; LED_0805_2012Metric_Pad1.15x1.40mm_HandSolder
H1, H2, H3, H4: MountingHole; MountingHole_3.2mm_M3_DIN965_Pad_TopOnly
J1, J2, J3, J5, J7, J8, J9, J20, J21, J22, J23, J24, J25, J26, J27, J28, J29, J30, J31, J36, J37, J38, J39, J40: Conn_01x02_Pin; JST_PH_B2B-PH-K_1x02_P2.00mm_Vertical
J4, J6: Conn_01x03_Pin; JST_PH_B3B-PH-K_1x03_P2.00mm_Vertical
J10, J11, J12, J13, J14, J15, J16, J17, J18, J19, J32, J33, J34, J35: Conn_01x03_Male; JST_PH_B3B-PH-K_1x03_P2.00mm_Vertical
R1: 330R; R_0603_1608Metric_Pad0.98x0.95mm_HandSolder
R2, R5: 5K; R_0603_1608Metric_Pad0.98x0.95mm_HandSolder
R3: 1.5K; R_0603_1608Metric_Pad0.98x0.95mm_HandSolder
R4: 4.7K; R_0603_1608Metric_Pad0.98x0.95mm_HandSolder

Connections:
3V3: C2.1, C3.1, D1.2 (A), J3.2, J4.1, J7.2, J10.1, J11.1, J12.1, J13.1, J14.1, J15.1, J16.1, J17.1, J18.1, J19.1, J20.2, J21.2, J22.2, J23.2, J24.2, J25.2, J26.2, J27.2
5V: C4.1, C5.1, D3.2 (A), J4.3, J10.3, J11.3, J12.3, J13.3, J14.3, J15.3, J16.3, J17.3, J18.3, J19.3, J28.2, J29.2, J30.2, J31.2, J40.2
12V: C1.1, D5.2 (A), J1.2, J2.2, J5.2, J8.2, J9.2
AGND: C6.2, C7.1, D4.2 (A), J6.2, J32.2, J33.2, J34.2, J35.2, R2.2
DC_NEG: C7.2, J6.1, J32.1, J33.1, J34.1, J35.1, R4.2
DC_POS: C6.1, D2.2 (A), J6.3, J32.3, J33.3, J34.3, J35.3
GND: C2.2, C3.2, C4.2, C5.2, J3.1, J4.2, J7.1, J10.2, J11.2, J12.2, J13.2, J14.2, J15.2, J16.2, J17.2, J18.2, J19.2, J20.1, J21.1, J22.1, J23.1, J24.1, J25.1, J26.1, J27.1, J28.1, J29.1, J30.1, J31.1, J40.1, R1.2, R3.2, R5.2
unnamed: D1.1 (K), R1.1
unnamed: D2.1 (K), R2.1
unnamed: D3.1 (K), R3.1
unnamed: D4.1 (K), R4.1
unnamed: D5.1 (K), R5.1
RELAY_GND: C1.2, J1.1, J2.1, J5.1, J8.1, J9.1
SCL: J36.1, J37.1, J38.1, J39.1
SDA: J36.2, J37.2, J38.2, J39.2

Notes on the sheet:
LEDS
MOUNTING HOLES
INPUT POWER
OUTPUT POWER
BULK CAPACITORS
