duanestorey/hifi-amp/pcbs/psu/capacitor-bank-left/capacitor-bank.kicad_sch

## KiCad design pcbs/psu/capacitor-bank-left/capacitor-bank.kicad_sch (2025-10-22)

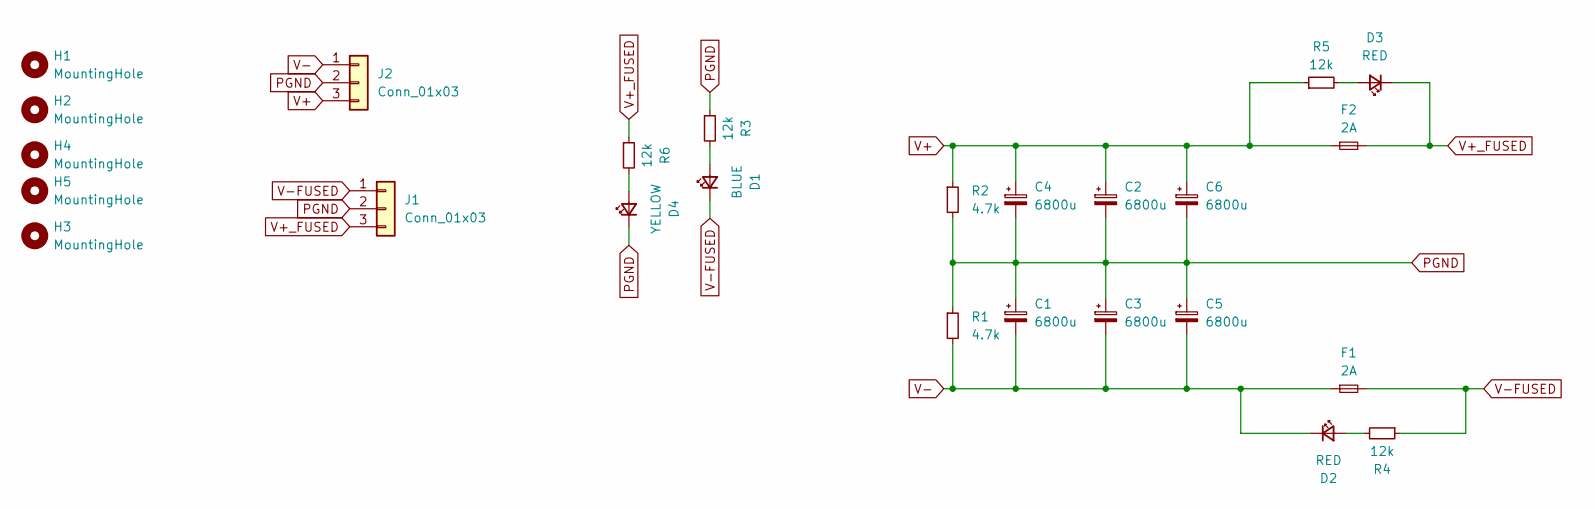
[picture p232: schematic capacitor-bank.kicad_sch]

Parts:
C1, C2, C3, C4, C5, C6: 6800u; CP_Radial_D25.0mm_P10.00mm_SnapIn
D1: BLUE; LED_0805_2012Metric_Pad1.15x1.40mm_HandSolder
D2, D3: RED; LED_0805_2012Metric_Pad1.15x1.40mm_HandSolder
D4: YELLOW; LED_0805_2012Metric_Pad1.15x1.40mm_HandSolder
F1, F2: 2A; Aliexpress Fuse 5x20
H1, H2, H3, H4, H5: MountingHole; MountingHole_3.2mm_M3_DIN965_Pad_TopBottom
J1, J2: Conn_01x03; JST_VH_B3P-VH-B_1x03_P3.96mm_Vertical
R1, R2: 4.7k; R_0805_2012Metric_Pad1.20x1.40mm_HandSolder
R3, R4, R5, R6: 12k; R_0805_2012Metric_Pad1.20x1.40mm_HandSolder

Connections:
unnamed: D1.2 (A), R3.2
unnamed: D2.2 (A), R4.2
unnamed: D3.2 (A), R5.2
unnamed: D4.2 (A), R6.2
PGND: C1.1, C2.2, C3.1, C4.2, C5.1, C6.2, D4.1 (K), J1.2, J2.2, R1.1, R2.2, R3.1
V+: C2.1, C4.1, C6.1, F2.1, J2.3, R2.1, R5.1
V+_FUSED: D3.1 (K), F2.2, J1.3, R6.1
V-: C1.2, C3.2, C5.2, D2.1 (K), F1.1, J2.1, R1.2
V-FUSED: D1.1 (K), F1.2, J1.1, R4.1
