duanestorey/hifi-amp/pcbs/psu/fanout/fanout.kicad_sch

## KiCad design pcbs/psu/fanout/fanout.kicad_sch (2025-10-22)

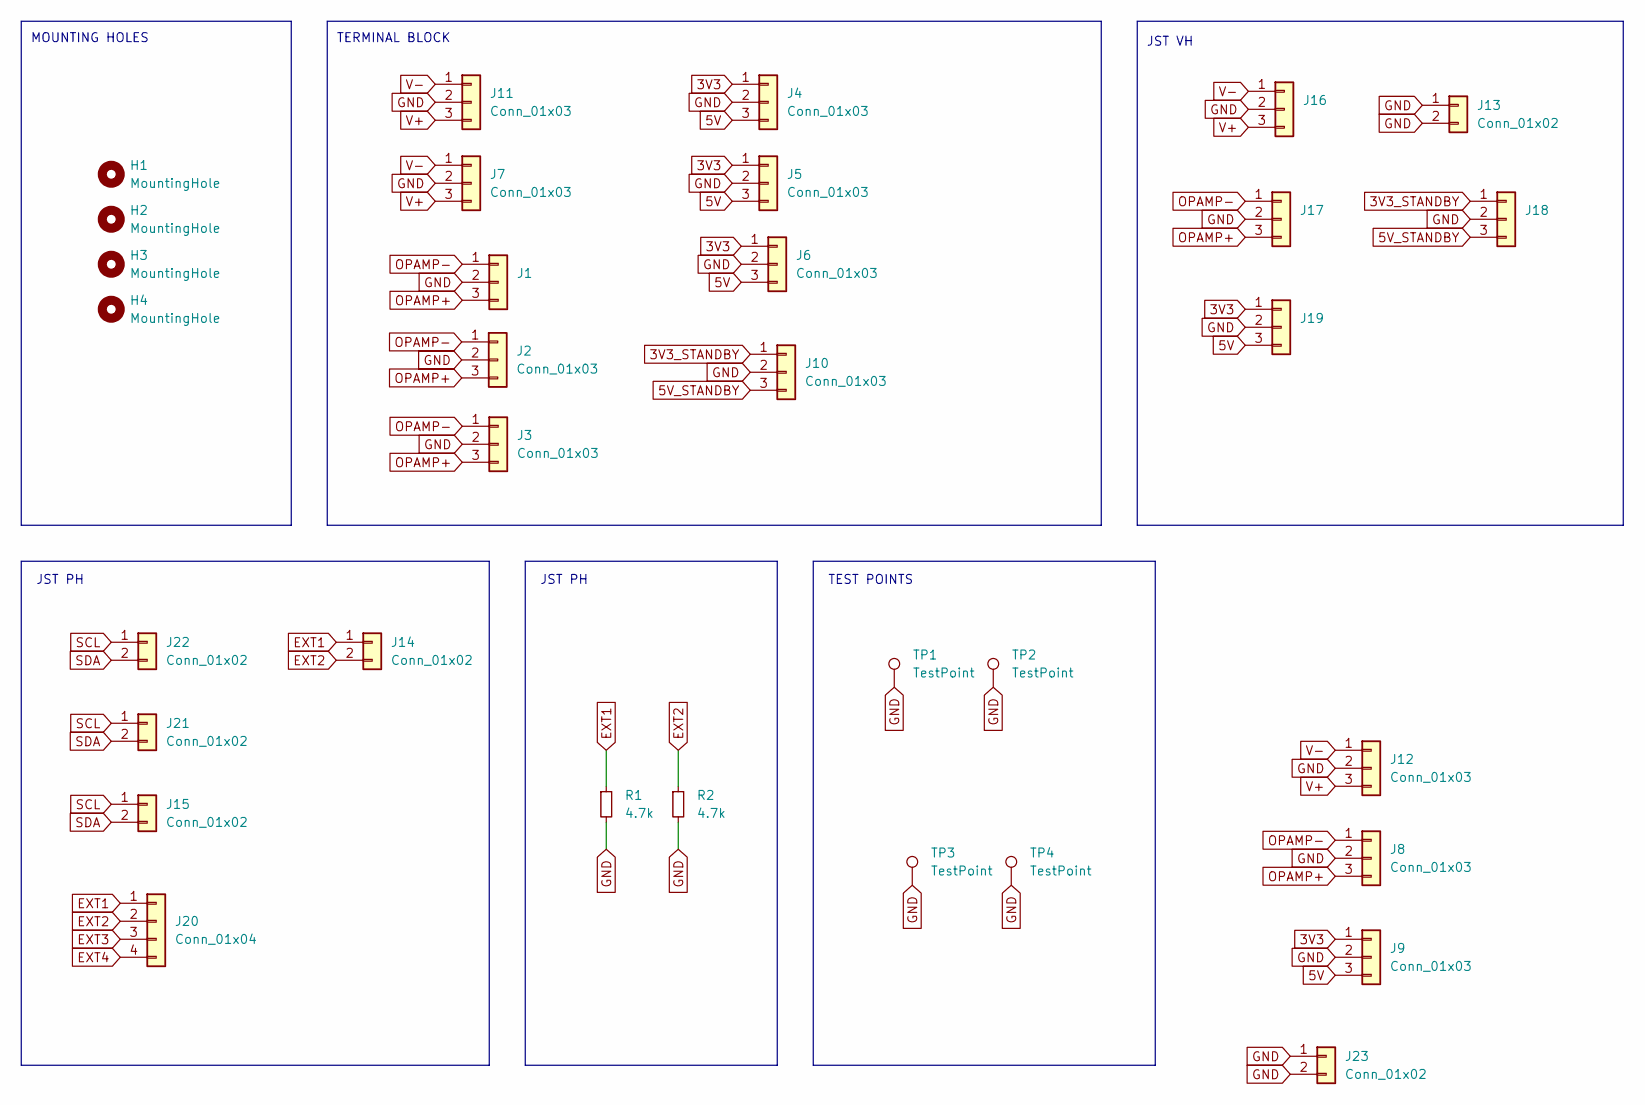
[picture p234: schematic fanout.kicad_sch]

Parts:
H1, H2, H3, H4: MountingHole; MountingHole_3.2mm_M3_DIN965_Pad_TopBottom
J1, J2, J3, J4, J5, J6, J7, J10, J11: Conn_01x03; TerminalBlock_Phoenix_PT-1,5-3-3.5-H_1x03_P3.50mm_Horizontal
J8, J9, J12: Conn_01x03; JST_PH_B3B-PH-K_1x03_P2.00mm_Vertical
J13: Conn_01x02; JST_VH_B2P-VH-B_1x02_P3.96mm_Vertical
J14, J15, J21, J22: Conn_01x02; JST_PH_B2B-PH-K_1x02_P2.00mm_Vertical
J16, J17, J18, J19: Conn_01x03; JST_VH_B3P-VH-B_1x03_P3.96mm_Vertical
J20: Conn_01x04; JST_PH_B4B-PH-K_1x04_P2.00mm_Vertical
J23: Conn_01x02; PinHeader_1x02_P2.54mm_Vertical
R1, R2: 4.7k; R_0805_2012Metric_Pad1.20x1.40mm_HandSolder
TP1, TP2, TP3, TP4: TestPoint; TestPoint_THTPad_2.5x2.5mm_Drill1.2mm

Connections:
3V3: J4.1, J5.1, J6.1, J9.1, J19.1
3V3_STANDBY: J10.1, J18.1
5V: J4.3, J5.3, J6.3, J9.3, J19.3
5V_STANDBY: J10.3, J18.3
EXT1: J14.1, J20.1, R1.1
EXT2: J14.2, J20.2, R2.1
EXT3: J20.3
EXT4: J20.4
GND: J1.2, J2.2, J3.2, J4.2, J5.2, J6.2, J7.2, J8.2, J9.2, J10.2, J11.2, J12.2, J13.1, J13.2, J16.2, J17.2, J18.2, J19.2, J23.1, J23.2, R1.2, R2.2, TP1.1, TP2.1, TP3.1, TP4.1
OPAMP+: J1.3, J2.3, J3.3, J8.3, J17.3
OPAMP-: J1.1, J2.1, J3.1, J8.1, J17.1
SCL: J15.1, J21.1, J22.1
SDA: J15.2, J21.2, J22.2
V+: J7.3, J11.3, J12.3, J16.3
V-: J7.1, J11.1, J12.1, J16.1

Notes on the sheet:
TEST POINTS
JST VH
MOUNTING HOLES
JST PH
TERMINAL BLOCK
