duanestorey/hifi-amp/pcbs/psu/toroid-lights/toroid-lights.kicad_sch

## KiCad design pcbs/psu/toroid-lights/toroid-lights.kicad_sch (2025-10-22)

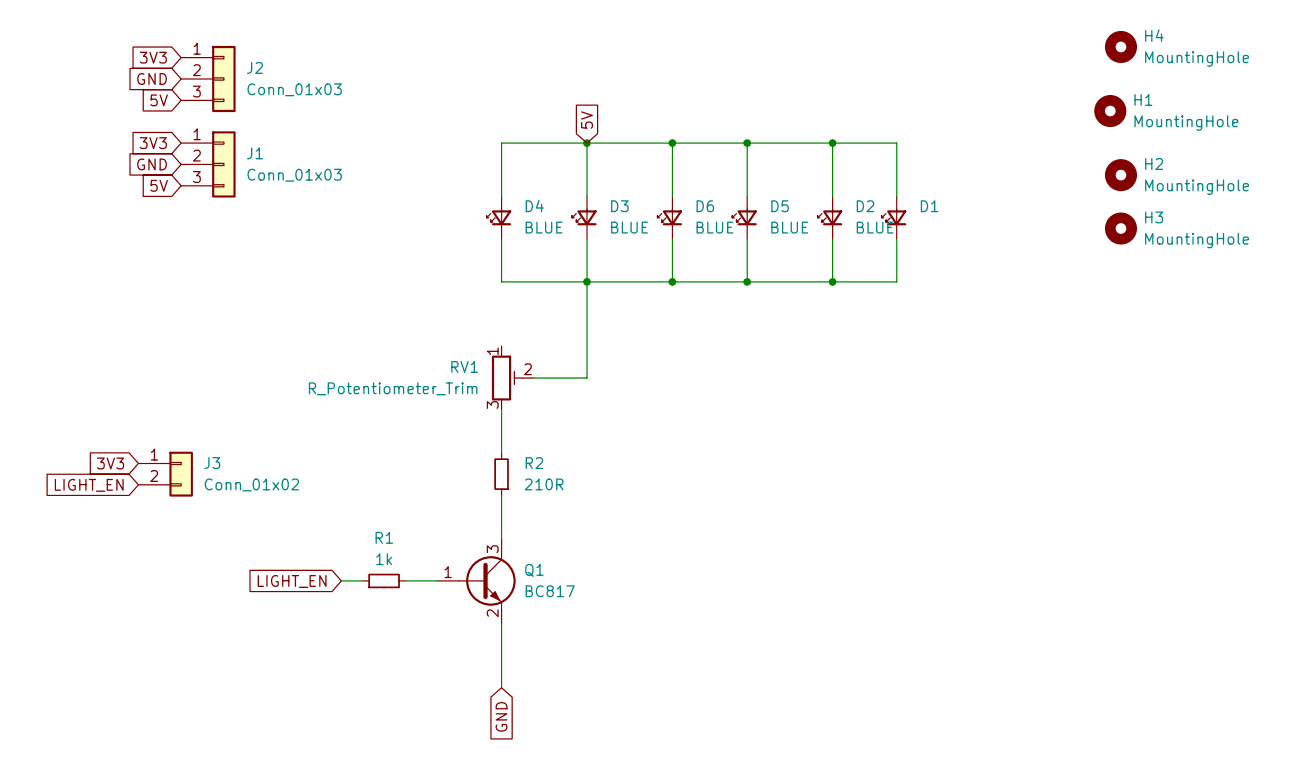
[picture p235: schematic toroid-lights.kicad_sch]

Parts:
D1, D2, D3, D4, D5, D6: BLUE; LED_0805_2012Metric_Pad1.15x1.40mm_HandSolder
H1, H2, H3, H4: MountingHole; MountingHole_3.2mm_M3_DIN965_Pad_TopBottom
J1, J2: Conn_01x03; JST_VH_B3P-VH-B_1x03_P3.96mm_Vertical
J3: Conn_01x02; PinHeader_1x02_P2.54mm_Vertical
Q1: BC817; SOT-23
R1: 1k; R_0805_2012Metric_Pad1.20x1.40mm_HandSolder
R2: 210R; R_0805_2012Metric_Pad1.20x1.40mm_HandSolder
RV1: R_Potentiometer_Trim; Potentiometer_Bourns_3296W_Vertical

Connections:
3V3: J1.1, J2.1, J3.1
5V: D1.2 (A), D2.2 (A), D3.2 (A), D4.2 (A), D5.2 (A), D6.2 (A), J1.3, J2.3
GND: J1.2, J2.2, Q1.2 (E)
LIGHT_EN: J3.2, R1.1
unnamed: D1.1 (K), D2.1 (K), D3.1 (K), D4.1 (K), D5.1 (K), D6.1 (K), RV1.2
unnamed: Q1.1 (B), R1.2
unnamed: Q1.3 (C), R2.1
unnamed: R2.2, RV1.3
