duanestorey/hifi-amp/pcbs/rectify/1.3/rectify.kicad_sch

## KiCad design pcbs/rectify/1.3/rectify.kicad_sch (2025-03-21)

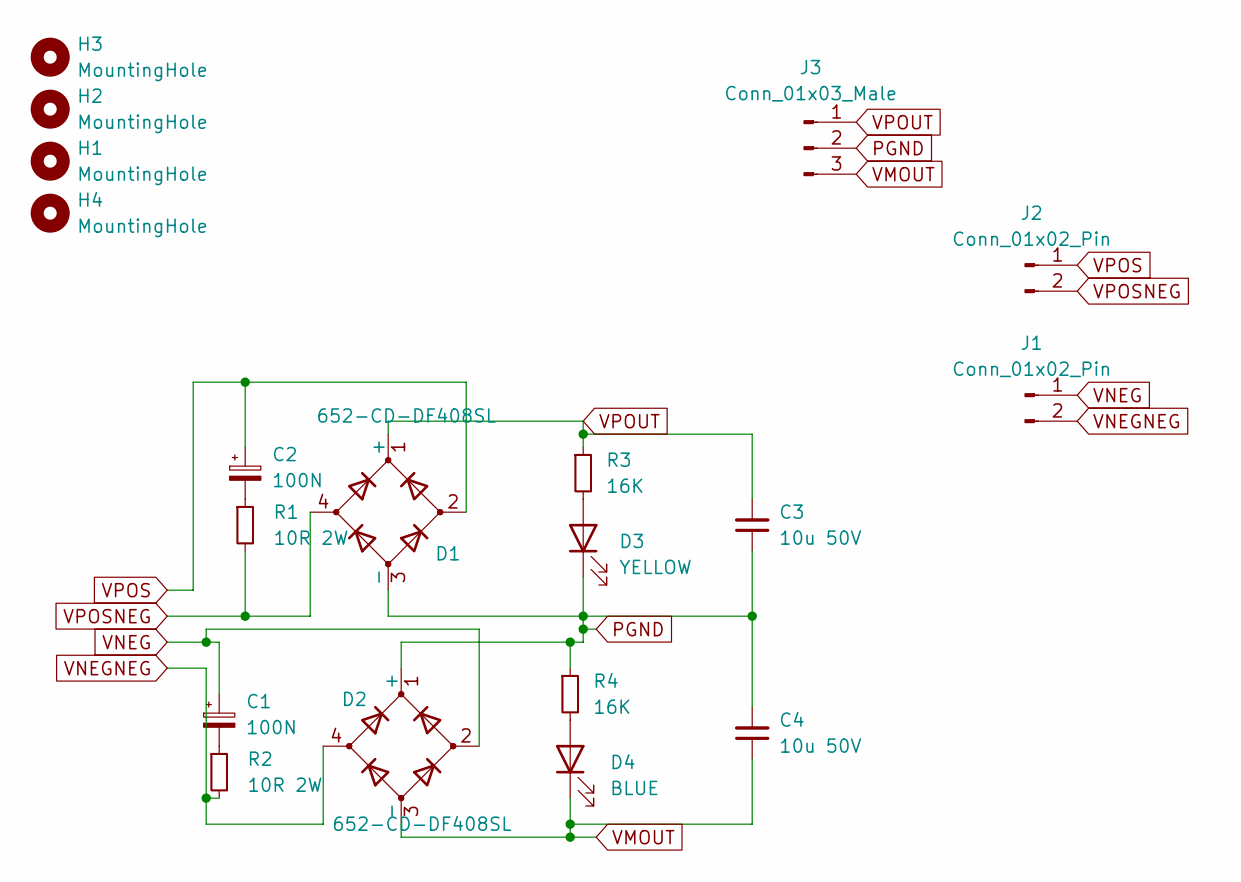
[picture p236: schematic rectify.kicad_sch]

Parts:
C1, C2: 100N; C_Rect_L13.0mm_W6.0mm_P10.00mm_FKS3_FKP3_MKS4; Mouser 505-MKP1D031003G00JS
C3, C4: 10u 50V; C_1206_3216Metric_Pad1.33x1.80mm_HandSolder
D1, D2: 652-CD-DF408SL; Diode_Bridge_19.0x19.0x6.8mm_P12.7mm; Mouser 652-CD-DF408SL
D3: YELLOW; LED_0603_1608Metric_Pad1.05x0.95mm_HandSolder
D4: BLUE; LED_0603_1608Metric_Pad1.05x0.95mm_HandSolder
H1, H2, H3, H4: MountingHole; MountingHole_3.2mm_M3_Pad_TopOnly
J1, J2: Conn_01x02_Pin; TerminalBlock_MetzConnect_Type055_RT01502HDWU_1x02_P5.00mm_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
J3: Conn_01x03_Male; JST_VH_B3P-VH_1x03_P3.96mm_Vertical
R1, R2: 10R 2W; R_2512_6332Metric_Pad1.40x3.35mm_HandSolder; Mouser 603-SR2512JK-7W10RL
R3, R4: 16K; R_0603_1608Metric_Pad0.98x0.95mm_HandSolder

Connections:
unnamed: C1.2, R2.1
unnamed: C2.2, R1.1
unnamed: D3.2 (A), R3.2
unnamed: D4.2 (A), R4.2
PGND: C3.1, C4.2, D1.3 (-), D2.1 (+), D3.1 (K), J3.2, R4.1
VMOUT: C4.1, D2.3 (-), D4.1 (K), J3.3
VNEG: C1.1, D2.2, J1.1
VNEGNEG: D2.4, J1.2, R2.2
VPOS: C2.1, D1.2, J2.1
VPOSNEG: D1.4, J2.2, R1.2
VPOUT: C3.2, D1.1 (+), J3.1, R3.1
