duanestorey/hifi-amp/pcbs/speaker/1.0/speaker.kicad_sch

## KiCad design pcbs/speaker/1.0/speaker.kicad_sch (2025-02-14)

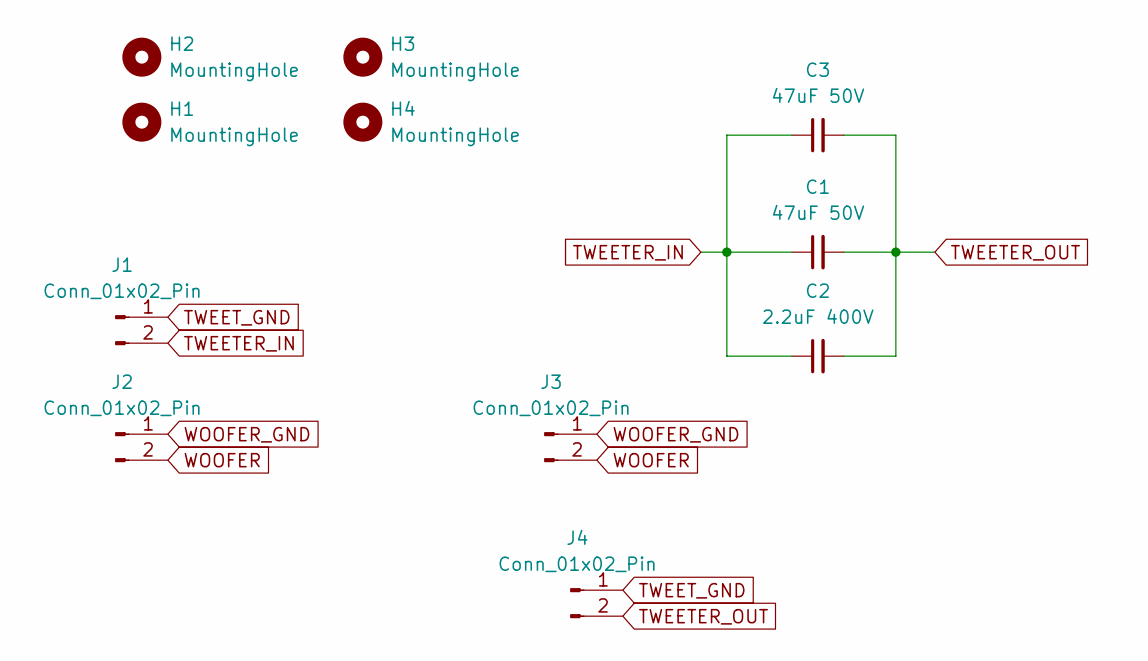
[picture p238: schematic speaker.kicad_sch]

Parts:
C1: 47uF 50V; CP_Radial_D10.0mm_P5.00mm_P7.50mm
C2: 2.2uF 400V; C_Rect_L31.5mm_W15.0mm_P27.50mm_MKS4
C3: 47uF 50V; CP_Radial_D6.3mm_P2.50mm
H1, H2, H3, H4: MountingHole; MountingHole_3.2mm_M3_DIN965_Pad_TopBottom
J1, J2, J3, J4: Conn_01x02_Pin; JST_VH_B2P-VH-B_1x02_P3.96mm_Vertical

Connections:
TWEETER_IN: C1.1, C2.1, C3.1, J1.2
TWEETER_OUT: C1.2, C2.2, C3.2, J4.2
TWEET_GND: J1.1, J4.1
WOOFER: J2.2, J3.2
WOOFER_GND: J2.1, J3.1
