duanestorey/hifi-amp/pcbs/speaker/1.1/speaker.kicad_sch

## KiCad design pcbs/speaker/1.1/speaker.kicad_sch (2025-10-22)

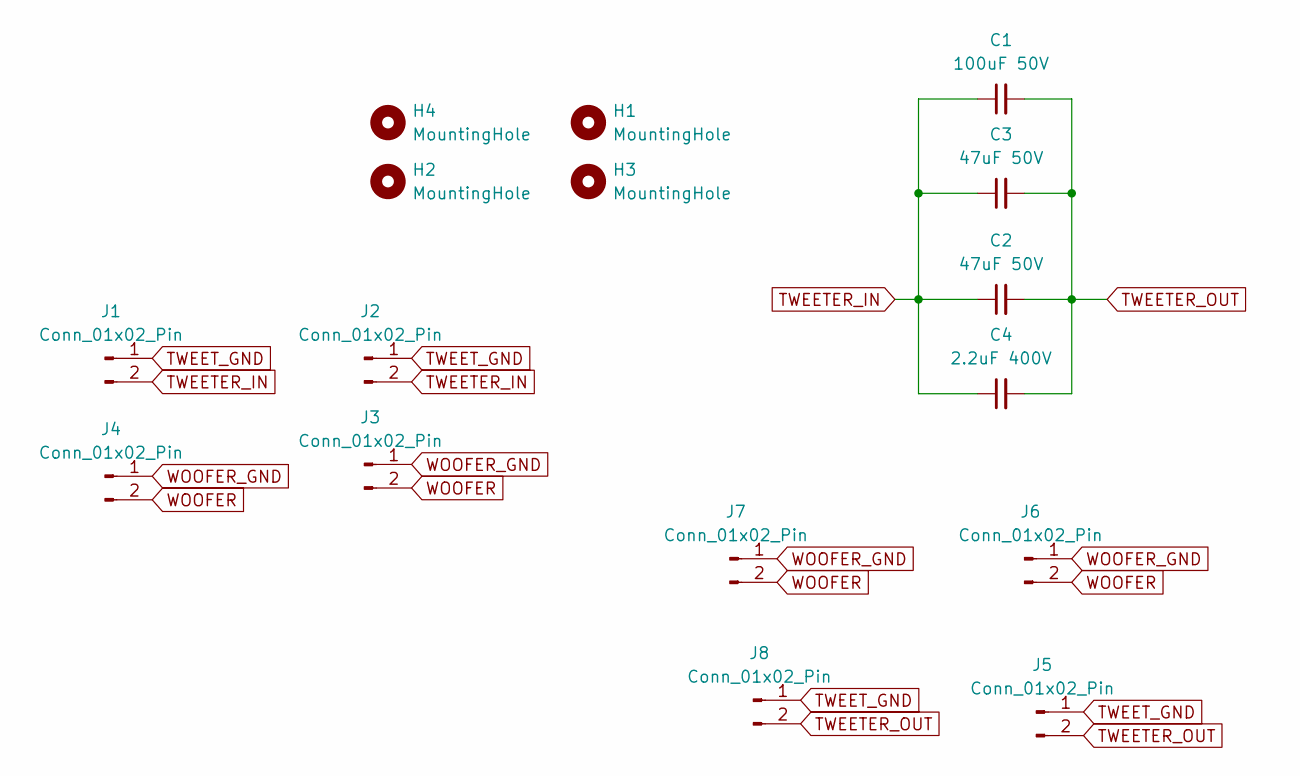
[picture p239: schematic speaker.kicad_sch]

Parts:
C1: 100uF 50V; CP_Radial_D12.5mm_P7.50mm
C2, C3: 47uF 50V; CP_Radial_D10.0mm_P5.00mm_P7.50mm
C4: 2.2uF 400V; C_Rect_L31.5mm_W15.0mm_P27.50mm_MKS4
H1, H2, H3, H4: MountingHole; MountingHole_3.2mm_M3_DIN965_Pad_TopBottom
J1, J4, J5, J6: Conn_01x02_Pin; TerminalBlock_Phoenix_PT-1,5-2-5.0-H_1x02_P5.00mm_Horizontal
J2, J3, J7, J8: Conn_01x02_Pin; JST_VH_B2P-VH-B_1x02_P3.96mm_Vertical

Connections:
TWEETER_IN: C1.1, C2.1, C3.1, C4.1, J1.2, J2.2
TWEETER_OUT: C1.2, C2.2, C3.2, C4.2, J5.2, J8.2
TWEET_GND: J1.1, J2.1, J5.1, J8.1
WOOFER: J3.2, J4.2, J6.2, J7.2
WOOFER_GND: J3.1, J4.1, J6.1, J7.1
