duanestorey/hifi-amp/pcbs/uproc/1.2/uproc.kicad_sch

## KiCad design pcbs/uproc/1.2/uproc.kicad_sch (2025-10-22)

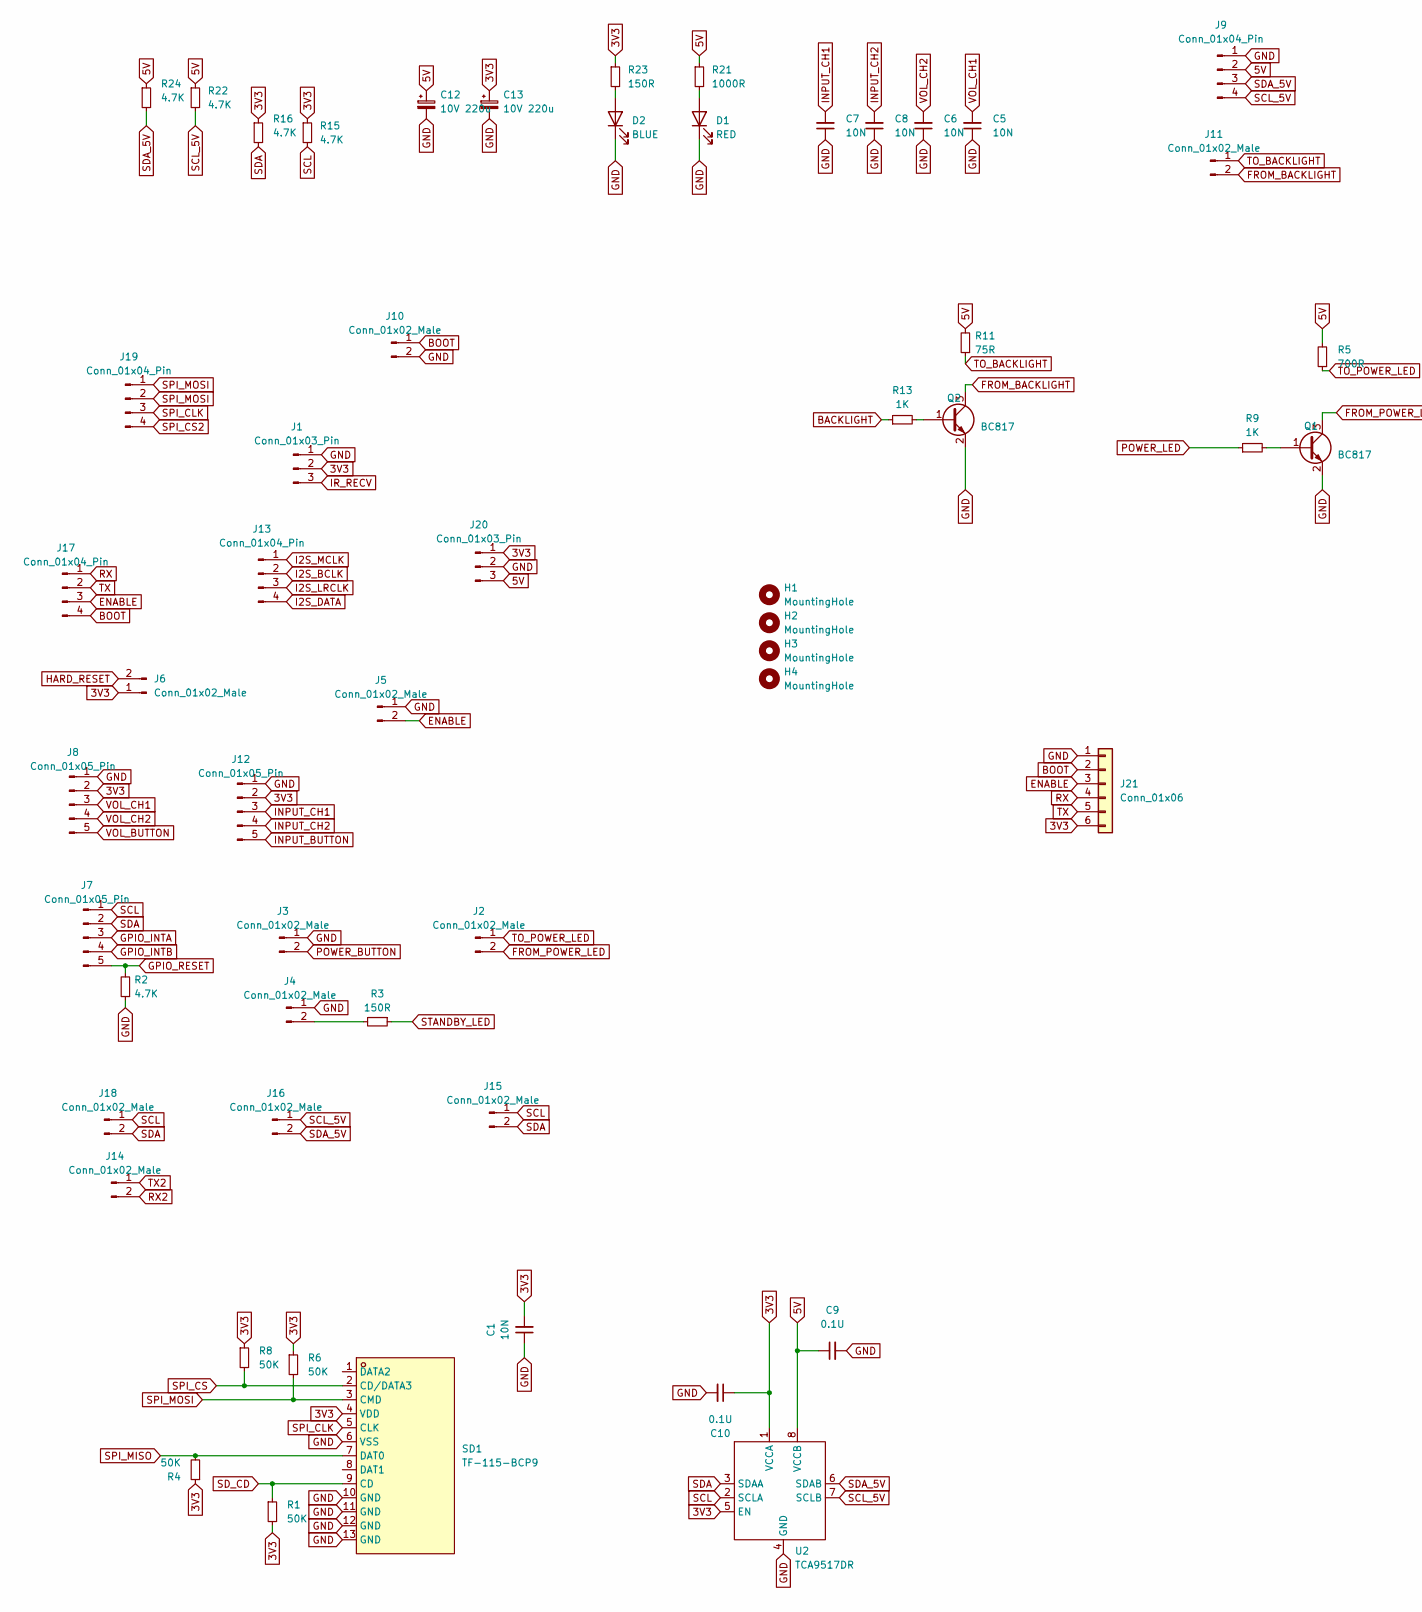
[picture p240: schematic uproc.kicad_sch, part in row 1, column 1]

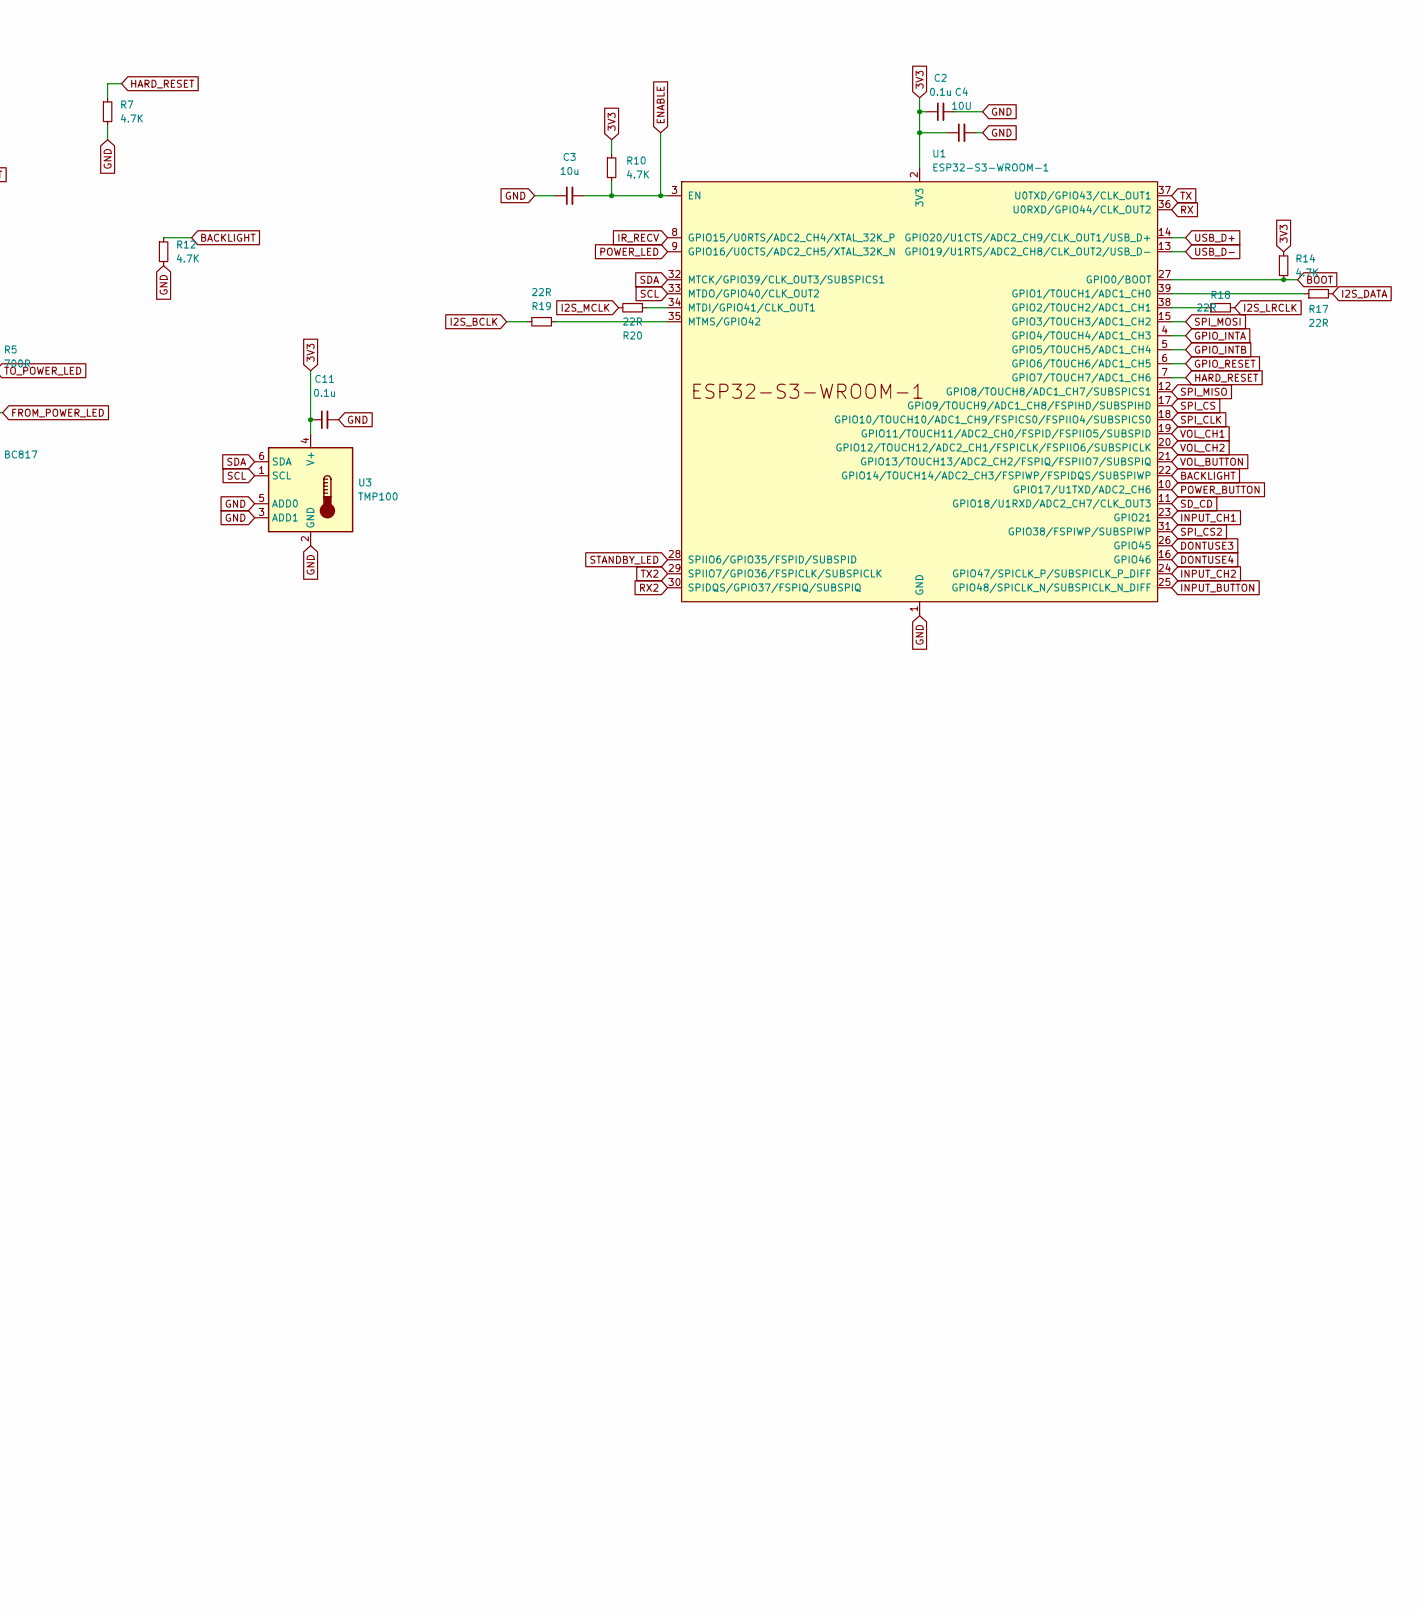
[picture p241: schematic uproc.kicad_sch, part in row 1, column 2]

Parts:
C1: 10N; C_0805_2012Metric_Pad1.18x1.45mm_HandSolder
C2, C11: 0.1u; C_0805_2012Metric_Pad1.18x1.45mm_HandSolder
C3: 10u; C_0805_2012Metric_Pad1.18x1.45mm_HandSolder
C4: 10U; C_1206_3216Metric_Pad1.33x1.80mm_HandSolder
C5, C6, C7, C8: 10N; C_0603_1608Metric_Pad1.08x0.95mm_HandSolder
C9, C10: 0.1U; C_0805_2012Metric_Pad1.18x1.45mm_HandSolder
C12, C13: 10V 220u; CP_Radial_D6.3mm_P2.50mm
D1: RED; LED_0603_1608Metric; LCSC XL-1608UBC-04
D2: BLUE; LED_0603_1608Metric; LCSC NCD0603R1
H1, H2, H3, H4: MountingHole; MountingHole_3.2mm_M3_DIN965_Pad_TopOnly
J1, J20: Conn_01x03_Pin; JST_PH_B3B-PH-K_1x03_P2.00mm_Vertical
J2, J3, J4, J5, J11, J14, J15, J16, J18: Conn_01x02_Male; JST_PH_B2B-PH-K_1x02_P2.00mm_Vertical
J6, J10: Conn_01x02_Male; PinHeader_1x02_P2.54mm_Vertical
J7, J8, J12: Conn_01x05_Pin; JST_PH_B5B-PH-K_1x05_P2.00mm_Vertical
J9, J13, J17, J19: Conn_01x04_Pin; JST_PH_B4B-PH-K_1x04_P2.00mm_Vertical
J21: Conn_01x06; PinHeader_1x06_P2.54mm_Vertical
Q1, Q2: BC817; TSOT-23; Mouser 637-BC817K-40
R1, R4, R6, R8: 50K; R_0603_1608Metric_Pad0.98x0.95mm_HandSolder
R2, R7, R10, R12, R14, R15, R16, R22, R24: 4.7K; R_0603_1608Metric_Pad0.98x0.95mm_HandSolder
R3, R23: 150R; R_0603_1608Metric_Pad0.98x0.95mm_HandSolder
R5: 700R; R_0603_1608Metric_Pad0.98x0.95mm_HandSolder
R9, R13: 1K; R_0603_1608Metric_Pad0.98x0.95mm_HandSolder
R11: 75R; R_0603_1608Metric_Pad0.98x0.95mm_HandSolder
R17, R18, R19, R20: 22R; R_0603_1608Metric; Mouser 603-RT0805FRE0722RL
R21: 1000R; R_0603_1608Metric_Pad0.98x0.95mm_HandSolder
SD1: TF-115-BCP9; TF-SMD_TF-115-BCP9; LCSC Part C720505
U1: ESP32-S3-WROOM-1
U2: TCA9517DR; SOIC-8_3.9x4.9mm_P1.27mm; Mouser 595-TCA9517DR
U3: TMP100; SOT-23-6

Connections:
3V3: C1.2, C2.1, C4.1, C10.1, C11.1, C13.1, J1.2, J6.1, J8.2, J12.2, J20.1, J21.6, R1.2, R4.1, R6.1, R8.1, R10.1, R14.1, R15.1, R16.1, R23.1, SD1.4 (VDD), U1.2 (3V3), U2.1 (VCCA), U2.5 (EN), U3.4 (V+)
5V: C9.1, C12.1, J9.2, J20.3, R5.2, R11.2, R21.1, R22.1, R24.1, U2.8 (VCCB)
BACKLIGHT: R12.1, R13.1, U1.22 (GPIO14/TOUCH14/ADC2_CH3/FSPIWP/FSPIDQS/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)
BOOT: J10.1, J17.4, J21.2, R14.2, U1.27 (GPIO0/BOOT)
DONTUSE3: U1.26 (GPIO45)
DONTUSE4: U1.16 (GPIO46)
ENABLE: C3.2, J5.2, J17.3, J21.3, R10.2, U1.3 (EN)
FROM_BACKLIGHT: J11.2, Q2.3 (C)
FROM_POWER_LED: J2.2, Q1.3 (C)
GND: C1.1, C2.2, C3.1, C4.2, C5.1, C6.1, C7.1, C8.1, C9.2, C10.2, C11.2, C12.2, C13.2, D1.1 (K), D2.1 (K), J1.1, J3.1, J4.1, J5.1, J8.1, J9.1, J10.2, J12.1, J20.2, J21.1, Q1.2 (E), Q2.2 (E), R2.1, R7.2, R12.2, SD1.6 (VSS), SD1.10 (GND), SD1.11 (GND), SD1.12 (GND), SD1.13 (GND), U1.1 (GND), U1.40 (GND), U1.41 (GND), U2.4 (GND), U3.2 (GND), U3.3 (ADD1), U3.5 (ADD0)
GPIO_INTA: J7.3, U1.4 (GPIO4/TOUCH4/ADC1_CH3)
GPIO_INTB: J7.4, U1.5 (GPIO5/TOUCH5/ADC1_CH4)
GPIO_RESET: J7.5, R2.2, U1.6 (GPIO6/TOUCH6/ADC1_CH5)
HARD_RESET: J6.2, R7.1, U1.7 (GPIO7/TOUCH7/ADC1_CH6)
I2S_BCLK: J13.2, R19.2
I2S_DATA: J13.4, R17.2
I2S_LRCLK: J13.3, R18.2
I2S_MCLK: J13.1, R20.2
INPUT_BUTTON: J12.5, U1.25 (GPIO48/SPICLK_N/SUBSPICLK_N_DIFF)
INPUT_CH1: C7.2, J12.3, U1.23 (GPIO21)
INPUT_CH2: C8.2, J12.4, U1.24 (GPIO47/SPICLK_P/SUBSPICLK_P_DIFF)
IR_RECV: J1.3, U1.8 (GPIO15/U0RTS/ADC2_CH4/XTAL_32K_P)
unnamed: D1.2 (A), R21.2
unnamed: D2.2 (A), R23.2
unnamed: J4.2, R3.2
unnamed: Q1.1 (B), R9.2
unnamed: Q2.1 (B), R13.2
unnamed: R17.1, U1.39 (GPIO1/TOUCH1/ADC1_CH0)
unnamed: R18.1, U1.38 (GPIO2/TOUCH2/ADC1_CH1)
unnamed: R19.1, U1.35 (MTMS/GPIO42)
unnamed: R20.1, U1.34 (MTDI/GPIO41/CLK_OUT1)
POWER_BUTTON: J3.2, U1.10 (GPIO17/U1TXD/ADC2_CH6)
POWER_LED: R9.1, U1.9 (GPIO16/U0CTS/ADC2_CH5/XTAL_32K_N)
RX: J17.1, J21.4, U1.36 (U0RXD/GPIO44/CLK_OUT2)
RX2: J14.2, U1.30 (SPIDQS/GPIO37/FSPIQ/SUBSPIQ)
SCL: J7.1, J15.1, J18.1, R15.2, U1.33 (MTDO/GPIO40/CLK_OUT2), U2.2 (SCLA), U3.1 (SCL)
SCL_5V: J9.4, J16.1, R22.2, U2.7 (SCLB)
SDA: J7.2, J15.2, J18.2, R16.2, U1.32 (MTCK/GPIO39/CLK_OUT3/SUBSPICS1), U2.3 (SDAA), U3.6 (SDA)
SDA_5V: J9.3, J16.2, R24.2, U2.6 (SDAB)
SD_CD: R1.1, SD1.9 (CD), U1.11 (GPIO18/U1RXD/ADC2_CH7/CLK_OUT3)
SPI_CLK: J19.3, SD1.5 (CLK), U1.18 (GPIO10/TOUCH10/ADC1_CH9/FSPICS0/FSPIIO4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)
SPI_CS: R8.2, SD1.2 (CD/DATA3), U1.17 (GPIO9/TOUCH9/ADC1_CH8/FSPIHD/SUBSPIHD)
SPI_CS2: J19.4, U1.31 (GPIO38/FSPIWP/SUBSPIWP)
SPI_MISO: R4.2, SD1.7 (DAT0), U1.12 (GPIO8/TOUCH8/ADC1_CH7/SUBSPICS1)
SPI_MOSI: J19.1, J19.2, R6.2, SD1.3 (CMD), U1.15 (GPIO3/TOUCH3/ADC1_CH2)
STANDBY_LED: R3.1, U1.28 (SPIIO6/GPIO35/FSPID/SUBSPID)
TO_BACKLIGHT: J11.1, R11.1
TO_POWER_LED: J2.1, R5.1
TX: J17.2, J21.5, U1.37 (U0TXD/GPIO43/CLK_OUT1)
TX2: J14.1, U1.29 (SPIIO7/GPIO36/FSPICLK/SUBSPICLK)
USB_D+: U1.14 (GPIO20/U1CTS/ADC2_CH9/CLK_OUT1/USB_D+)
USB_D-: U1.13 (GPIO19/U1RTS/ADC2_CH8/CLK_OUT2/USB_D-)
VOL_BUTTON: J8.5, U1.21 (GPIO13/TOUCH13/ADC2_CH2/FSPIQ/FSPIIO7/S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)
VOL_CH1: C5.2, J8.3, U1.19 (GPIO11/TOUCH11/ADC2_CH0/FSPID/FSPIIO5/S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)
VOL_CH2: C6.2, J8.4, U1.20 (GPIO12/TOUCH12/ADC2_CH1/FSPICLK/FSPIIO6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)
