duanestorey/hifi-amp/pcbs/_final_proto/adc/1.0/adc.kicad_sch

## KiCad design pcbs/_final_proto/adc/1.0/adc.kicad_sch (2025-10-22)

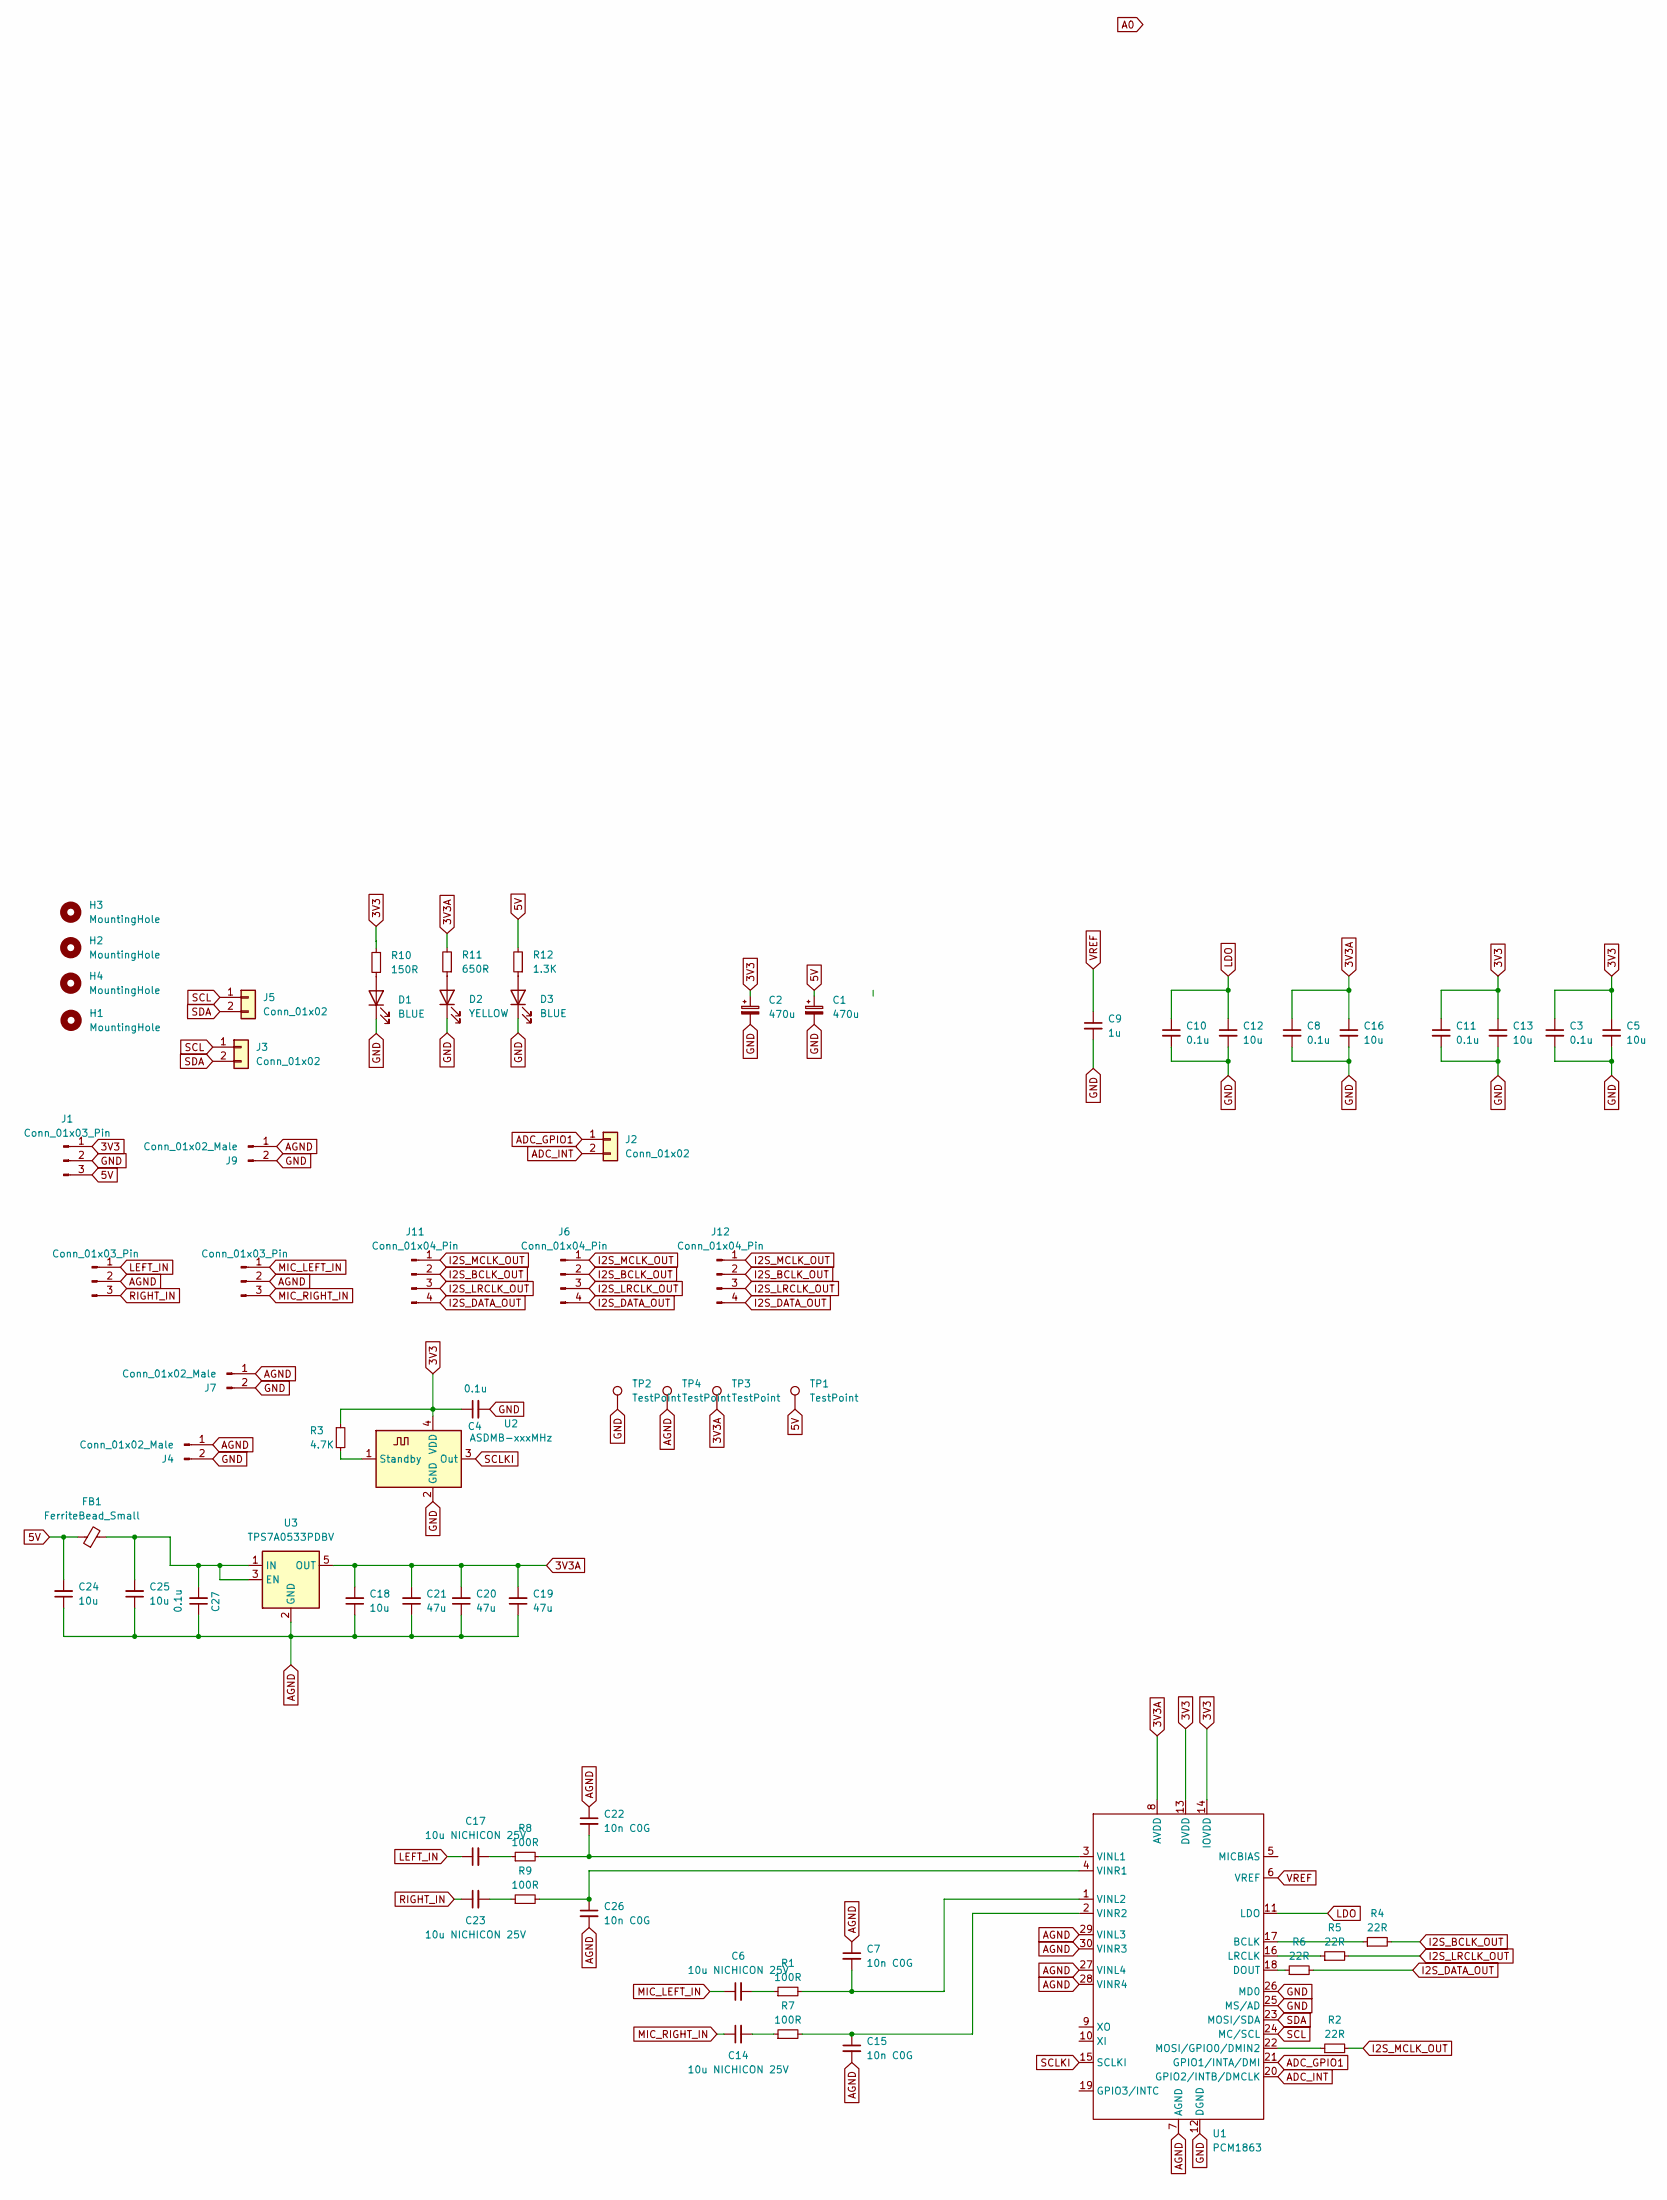
[picture p242: schematic adc.kicad_sch]

Parts:
C1, C2: 470u; CP_Radial_D6.3mm_P2.50mm
C3, C8, C10, C11: 0.1u; C_0805_2012Metric_Pad1.18x1.45mm_HandSolder
C4, C27: 0.1u; C_0805_2012Metric_Pad1.18x1.45mm_HandSolder; Mouser 791-0805N103G250CT
C5, C12, C13, C16, C18, C24, C25: 10u; C_1206_3216Metric_Pad1.33x1.80mm_HandSolder
C6, C14, C17, C23: 10u NICHICON 25V; CP_Radial_D5.0mm_P2.00mm
C7, C15, C22, C26: 10n C0G; C_0805_2012Metric_Pad1.18x1.45mm_HandSolder; Mouser 791-0805N103G250CT
C9: 1u; C_1206_3216Metric_Pad1.33x1.80mm_HandSolder
C19, C20, C21: 47u; C_1206_3216Metric_Pad1.33x1.80mm_HandSolder
D1, D3: BLUE; LED_0603_1608Metric
D2: YELLOW; LED_0603_1608Metric
FB1: FerriteBead_Small; R_0603_1608Metric_Pad0.98x0.95mm_HandSolder
H1, H2, H3, H4: MountingHole; MountingHole_3.2mm_M3_DIN965_Pad_TopOnly
J1, J8, J10: Conn_01x03_Pin; JST_PH_B3B-PH-K_1x03_P2.00mm_Vertical
J2, J3, J5: Conn_01x02; JST_PH_B2B-PH-K_1x02_P2.00mm_Vertical
J4, J7, J9: Conn_01x02_Male; PinHeader_1x02_P2.54mm_Vertical
J6, J11: Conn_01x04_Pin; JST_PH_B4B-PH-K_1x04_P2.00mm_Vertical
J12: Conn_01x04_Pin; PinHeader_1x04_P2.54mm_Vertical
R1, R7, R8, R9: 100R; R_0805_2012Metric_Pad1.20x1.40mm_HandSolder; Mouser 603-RT0805FRE13100RL
R2, R4, R5, R6: 22R; R_0805_2012Metric_Pad1.20x1.40mm_HandSolder; Mouser 603-RT0805FRE0722RL
R3: 4.7K; R_0603_1608Metric_Pad0.98x0.95mm_HandSolder; Mouser 603-RT0805FRE0722RL
R10: 150R; R_0603_1608Metric_Pad0.98x0.95mm_HandSolder
R11: 650R; R_0603_1608Metric_Pad0.98x0.95mm_HandSolder
R12: 1.3K; R_0603_1608Metric_Pad0.98x0.95mm_HandSolder
TP1, TP2, TP3, TP4: TestPoint; TestPoint_THTPad_2.5x2.5mm_Drill1.2mm
U1: PCM1863; TSSOP-30_4.4x7.8mm_P0.5mm; Mouser 595-PCM1863DBT
U2: ASDMB-xxxMHz; Oscillator_SMD_Abracon_ASE-4Pin_3.2x2.5mm; Mouser 346-3225Z24.5760C1KX
U3: TPS7A0533PDBV; SOT-23-5

Connections:
3V3: C2.1, C3.1, C4.1, C5.1, C11.1, C13.1, J1.1, R3.1, R10.2, U1.13 (DVDD), U1.14 (IOVDD), U2.4 (VDD)
3V3A: C8.1, C16.1, C18.2, C19.2, C20.2, C21.2, R11.2, TP3.1, U1.8 (AVDD), U3.5 (OUT)
5V: C1.1, C24.2, FB1.1, J1.3, R12.2, TP1.1
ADC_GPIO1: J2.1, U1.21 (GPIO1/INTA/DMI)
ADC_INT: J2.2, U1.20 (GPIO2/INTB/DMCLK)
AGND: C7.1, C15.2, C18.1, C19.1, C20.1, C21.1, C22.1, C24.1, C25.1, C26.2, C27.1, J4.1, J7.1, J8.2, J9.1, J10.2, TP4.1, U1.7 (AGND), U1.27 (VINL4), U1.28 (VINR4), U1.29 (VINL3), U1.30 (VINR3), U3.2 (GND)
GND: C1.2, C2.2, C3.2, C4.2, C5.2, C8.2, C9.2, C10.2, C11.2, C12.2, C13.2, C16.2, D1.1 (K), D2.1 (K), D3.1 (K), J1.2, J4.2, J7.2, J9.2, TP2.1, U1.12 (DGND), U1.25 (MS/AD), U1.26 (MD0), U2.2 (GND)
I2S_BCLK_OUT: J6.2, J11.2, J12.2, R4.2
I2S_DATA_OUT: J6.4, J11.4, J12.4, R6.2
I2S_LRCLK_OUT: J6.3, J11.3, J12.3, R5.2
I2S_MCLK_OUT: J6.1, J11.1, J12.1, R2.2
LDO: C10.1, C12.1, U1.11 (LDO)
LEFT_IN: C17.1, J10.1
MIC_LEFT_IN: C6.1, J8.1
MIC_RIGHT_IN: C14.1, J8.3
unnamed: C6.2, R1.1
unnamed: C7.2, R1.2, U1.1 (VINL2)
unnamed: C14.2, R7.1
unnamed: C15.1, R7.2, U1.2 (VINR2)
unnamed: C17.2, R8.1
unnamed: C22.2, R8.2, U1.3 (VINL1)
unnamed: C23.2, R9.1
unnamed: C25.2, C27.2, FB1.2, U3.1 (IN), U3.3 (EN)
unnamed: C26.1, R9.2, U1.4 (VINR1)
unnamed: D1.2 (A), R10.1
unnamed: D2.2 (A), R11.1
unnamed: D3.2 (A), R12.1
unnamed: R2.1, U1.22 (MOSI/GPIO0/DMIN2)
unnamed: R3.2, U2.1 (Standby)
unnamed: R4.1, U1.17 (BCLK)
unnamed: R5.1, U1.16 (LRCLK)
unnamed: R6.1, U1.18 (DOUT)
RIGHT_IN: C23.1, J10.3
SCL: J3.1, J5.1, U1.24 (MC/SCL)
SCLKI: U1.15 (SCLKI), U2.3 (Out)
SDA: J3.2, J5.2, U1.23 (MOSI/SDA)
VREF: C9.1, U1.6 (VREF)
