duanestorey/hifi-amp/pcbs/_final_proto/dolby/1.0/dolby.kicad_sch

## KiCad design pcbs/_final_proto/dolby/1.0/dolby.kicad_sch (2025-10-22)

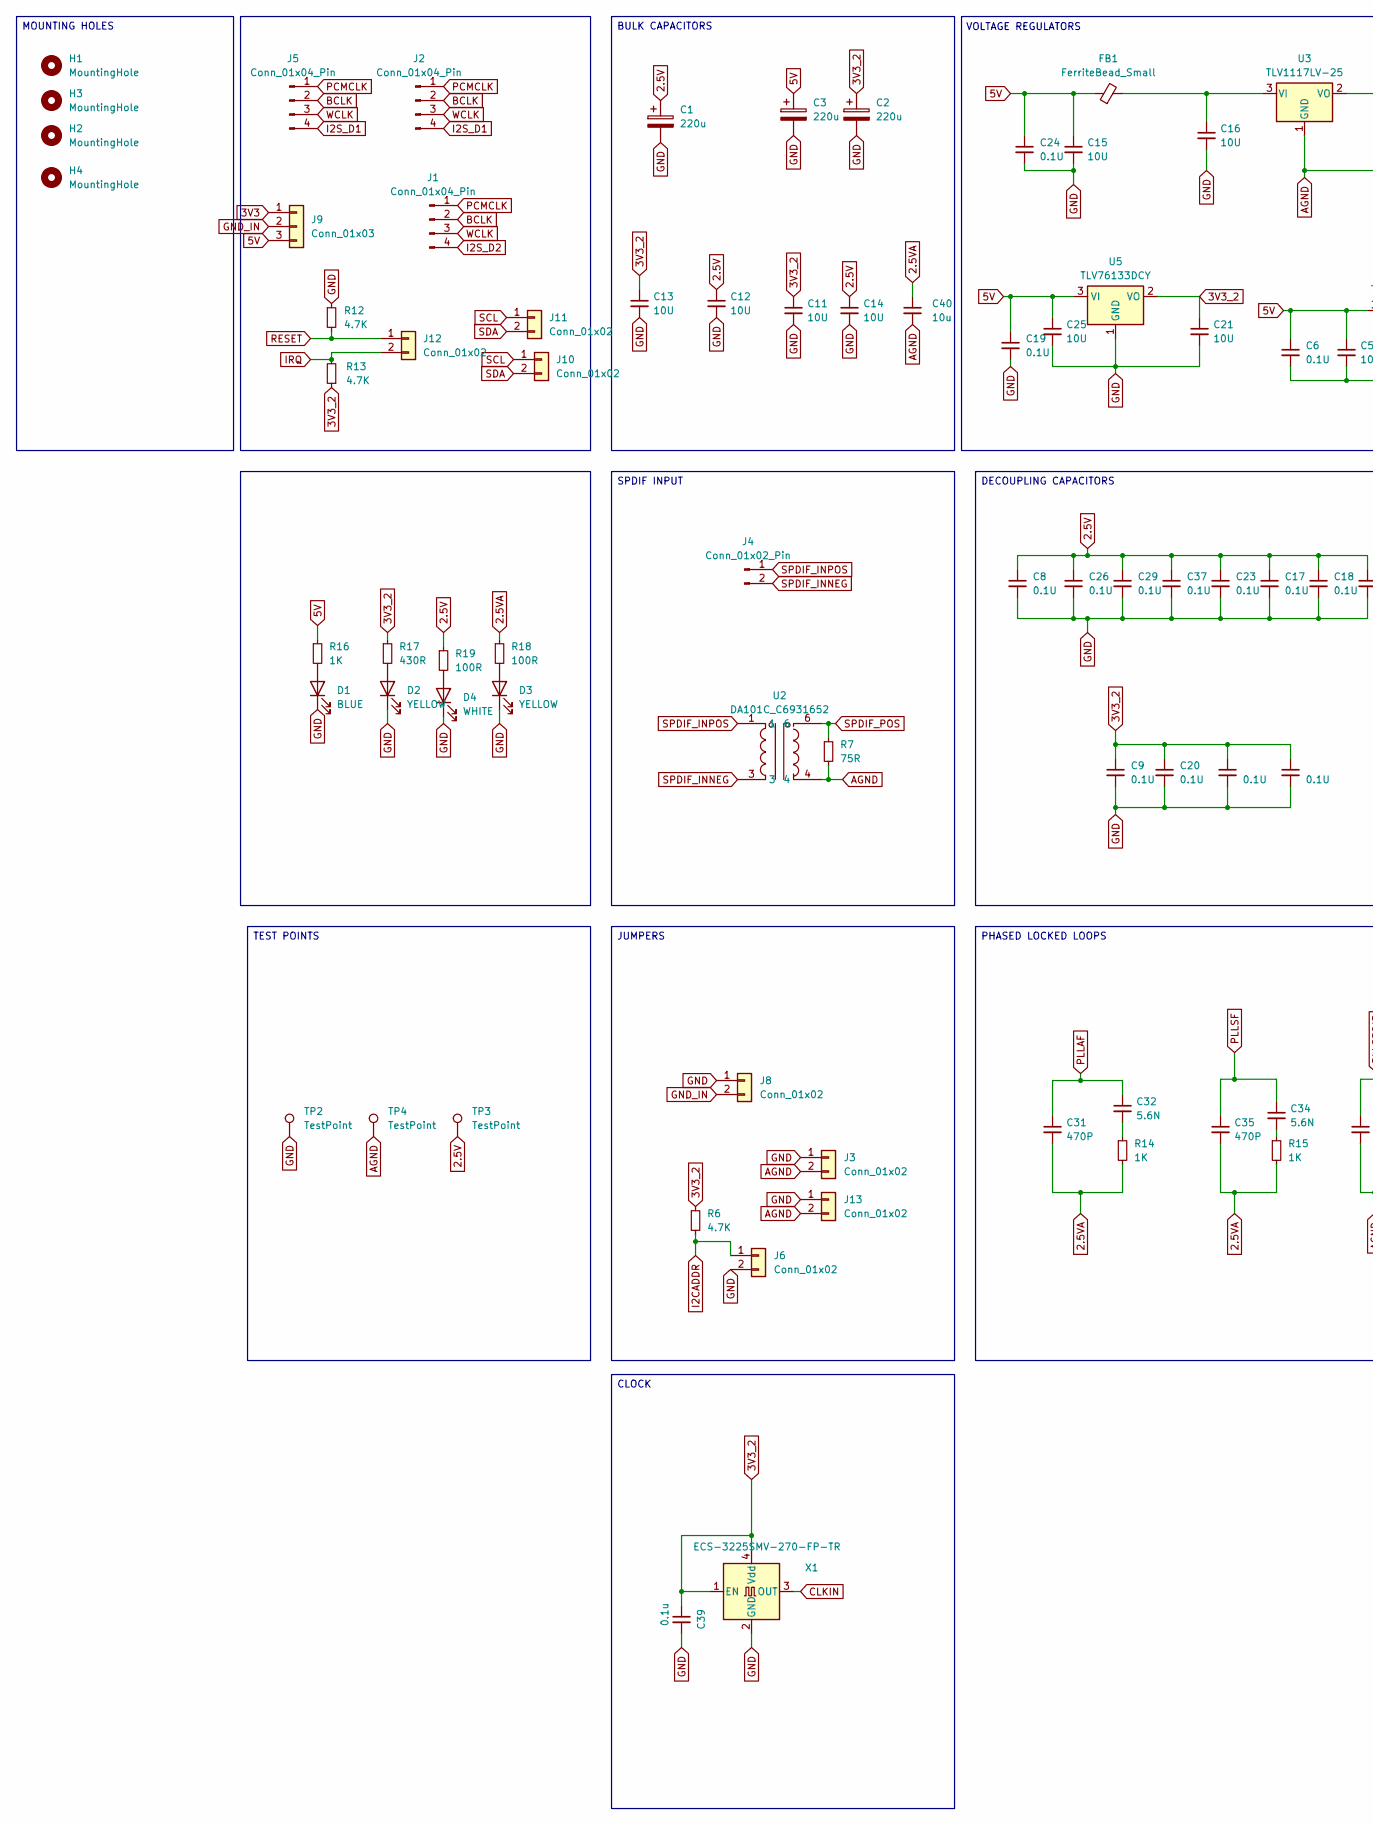
[picture p243: schematic dolby.kicad_sch, part in row 1, column 1]

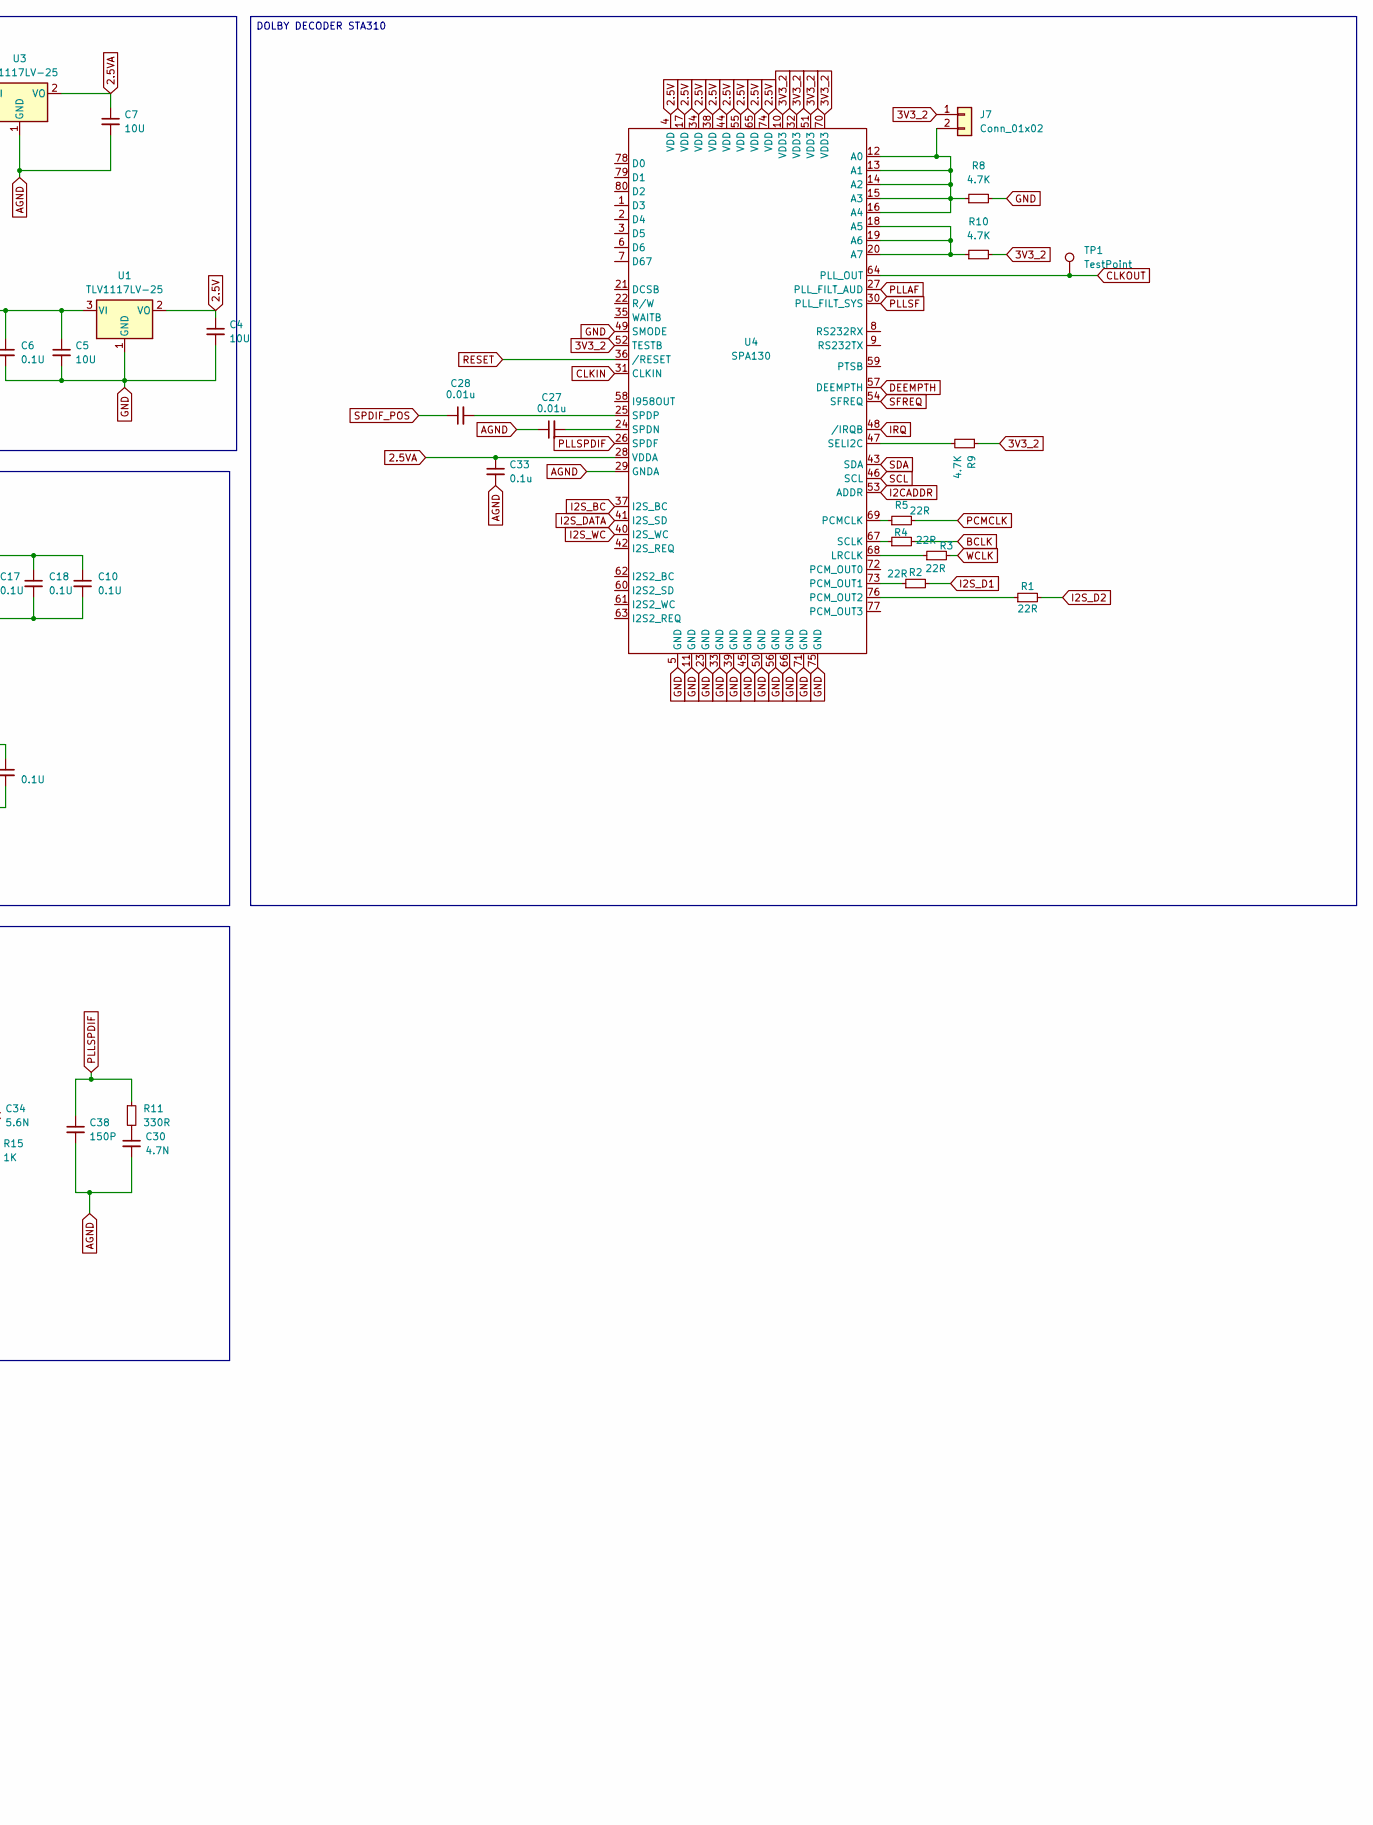
[picture p244: schematic dolby.kicad_sch, part in row 1, column 2]

Parts:
C1, C2, C3: 220u; CP_Radial_D6.3mm_P2.50mm
C4, C5, C7, C11, C12, C13, C14, C15, C16, C21, C25: 10U; C_1206_3216Metric_Pad1.33x1.80mm_HandSolder
C6, C8, C9, C10, C17, C18, C19, C20, C22, C23, C24, C26, C29, C36, C37: 0.1U; C_0805_2012Metric_Pad1.18x1.45mm_HandSolder
C27, C28: 0.01u; C_0805_2012Metric_Pad1.18x1.45mm_HandSolder
C30: 4.7N; C_0805_2012Metric_Pad1.18x1.45mm_HandSolder
C31, C35: 470P; C_0805_2012Metric_Pad1.18x1.45mm_HandSolder
C32, C34: 5.6N; C_0805_2012Metric_Pad1.18x1.45mm_HandSolder
C33, C39: 0.1u; C_0805_2012Metric_Pad1.18x1.45mm_HandSolder
C38: 150P; C_0805_2012Metric_Pad1.18x1.45mm_HandSolder
C40: 10u; C_1206_3216Metric_Pad1.33x1.80mm_HandSolder
D1: BLUE; LED_0805_2012Metric_Pad1.15x1.40mm_HandSolder
D2, D3: YELLOW; LED_0805_2012Metric_Pad1.15x1.40mm_HandSolder
D4: WHITE; LED_0805_2012Metric_Pad1.15x1.40mm_HandSolder
FB1: FerriteBead_Small; R_0603_1608Metric_Pad0.98x0.95mm_HandSolder
H1, H2, H3, H4: MountingHole; MountingHole_3.2mm_M3_DIN965_Pad_TopBottom
J1, J2: Conn_01x04_Pin; JST_PH_B4B-PH-K_1x04_P2.00mm_Vertical
J3, J6, J7, J8, J13: Conn_01x02; PinHeader_1x02_P2.54mm_Vertical
J4: Conn_01x02_Pin; JST_XH_B2B-XH-A_1x02_P2.50mm_Vertical
J5: Conn_01x04_Pin; PinHeader_1x04_P2.54mm_Vertical
J9: Conn_01x03; JST_PH_B3B-PH-K_1x03_P2.00mm_Vertical
J10, J11, J12: Conn_01x02; JST_PH_B2B-PH-K_1x02_P2.00mm_Vertical
R1, R2, R3, R4, R5: 22R; R_0805_2012Metric_Pad1.20x1.40mm_HandSolder
R6, R8, R9, R10, R12, R13: 4.7K; R_0603_1608Metric_Pad0.98x0.95mm_HandSolder
R7: 75R; R_0805_2012Metric_Pad1.20x1.40mm_HandSolder
R11: 330R; R_0603_1608Metric_Pad0.98x0.95mm_HandSolder
R14, R15: 1K; R_0603_1608Metric_Pad0.98x0.95mm_HandSolder
R16: 1K; R_0805_2012Metric_Pad1.20x1.40mm_HandSolder
R17: 430R; R_0805_2012Metric_Pad1.20x1.40mm_HandSolder
R18, R19: 100R; R_0805_2012Metric_Pad1.20x1.40mm_HandSolder
TP1, TP2, TP3, TP4: TestPoint; TestPoint_THTPad_D2.0mm_Drill1.0mm
U1, U3: TLV1117LV-25; SOT-223-3_TabPin2
U2: DA101C_C6931652; XFMR-TH_4P-L9.5-W9.0-P5.08-LS10.2_C9900096976; LCSC Part C6931652
U4: SPA130; LQFP-80_14x14mm_P0.65mm
U5: TLV76133DCY; SOT-223-3_TabPin2
X1: ECS-3225SMV-270-FP-TR; Oscillator_SMD_EuroQuartz_XO32-4Pin_3.2x2.5mm_HandSoldering

Connections:
2.5V: C1.1, C4.1, C8.1, C10.1, C12.1, C14.1, C17.1, C18.1, C23.1, C26.1, C29.1, C37.1, R19.1, TP3.1, U1.2 (VO), U4.4 (VDD), U4.17 (VDD), U4.34 (VDD), U4.38 (VDD), U4.44 (VDD), U4.55 (VDD), U4.65 (VDD), U4.74 (VDD)
2.5VA: C7.1, C31.2, C33.1, C35.2, C40.1, R14.2, R15.2, R18.1, U3.2 (VO), U4.28 (VDDA)
3V3: J9.1
3V3_2: C2.1, C9.1, C11.1, C13.1, C20.1, C21.1, C22.1, C36.1, C39.1, J7.1, R6.1, R9.1, R10.2, R13.1, R17.1, U4.10 (VDD3), U4.32 (VDD3), U4.51 (VDD3), U4.52 (TESTB), U4.70 (VDD3), U5.2 (VO), X1.1 (EN), X1.4 (Vdd)
5V: C3.1, C5.1, C6.1, C15.1, C19.1, C24.1, C25.1, FB1.1, J9.3, R16.1, U1.3 (VI), U5.3 (VI)
AGND: C7.2, C27.1, C30.2, C33.2, C38.2, C40.2, J3.2, J13.2, R7.2, TP4.1, U2.4, U3.1 (GND), U4.29 (GNDA)
BCLK: J1.2, J2.2, J5.2, R4.2
CLKIN: U4.31 (CLKIN), X1.3 (OUT)
CLKOUT: TP1.1, U4.64 (PLL_OUT)
DEEMPTH: U4.57 (DEEMPTH)
GND: C1.2, C2.2, C3.2, C4.2, C5.2, C6.2, C8.2, C9.2, C10.2, C11.2, C12.2, C13.2, C14.2, C15.2, C16.2, C17.2, C18.2, C19.2, C20.2, C21.2, C22.2, C23.2, C24.2, C25.2, C26.2, C29.2, C36.2, C37.2, C39.2, D1.1 (K), D2.1 (K), D3.1 (K), D4.1 (K), J3.1, J6.2, J8.1, J13.1, R8.2, R12.1, TP2.1, U1.1 (GND), U4.5 (GND), U4.11 (GND), U4.23 (GND), U4.33 (GND), U4.39 (GND), U4.45 (GND), U4.49 (SMODE), U4.50 (GND), U4.56 (GND), U4.66 (GND), U4.71 (GND), U4.75 (GND), U5.1 (GND), X1.2 (GND)
GND_IN: J8.2, J9.2
I2CADDR: J6.1, R6.2, U4.53 (ADDR)
I2S_BC: U4.37 (I2S_BC)
I2S_D1: J2.4, J5.4, R2.2
I2S_D2: J1.4, R1.2
I2S_DATA: U4.41 (I2S_SD)
I2S_WC: U4.40 (I2S_WC)
IRQ: J12.2, R13.2, U4.48 (/IRQB)
unnamed: C16.1, FB1.2, U3.3 (VI)
unnamed: C27.2, U4.24 (SPDN)
unnamed: C28.2, U4.25 (SPDP)
unnamed: C30.1, R11.2
unnamed: C32.2, R14.1
unnamed: C34.2, R15.1
unnamed: D1.2 (A), R16.2
unnamed: D2.2 (A), R17.2
unnamed: D3.2 (A), R18.2
unnamed: D4.2 (A), R19.2
unnamed: J7.2, R8.1, U4.12 (A0), U4.13 (A1), U4.14 (A2), U4.15 (A3), U4.16 (A4)
unnamed: R1.1, U4.76 (PCM_OUT2)
unnamed: R2.1, U4.73 (PCM_OUT1)
unnamed: R3.1, U4.68 (LRCLK)
unnamed: R4.1, U4.67 (SCLK)
unnamed: R5.1, U4.69 (PCMCLK)
unnamed: R9.2, U4.47 (SELI2C)
unnamed: R10.1, U4.18 (A5), U4.19 (A6), U4.20 (A7)
PCMCLK: J1.1, J2.1, J5.1, R5.2
PLLAF: C31.1, C32.1, U4.27 (PLL_FILT_AUD)
PLLSF: C34.1, C35.1, U4.30 (PLL_FILT_SYS)
PLLSPDIF: C38.1, R11.1, U4.26 (SPDF)
RESET: J12.1, R12.2, U4.36 (/RESET)
SCL: J10.1, J11.1, U4.46 (SCL)
SDA: J10.2, J11.2, U4.43 (SDA)
SFREQ: U4.54 (SFREQ)
SPDIF_INNEG: J4.2, U2.3
SPDIF_INPOS: J4.1, U2.1
SPDIF_POS: C28.1, R7.1, U2.6
WCLK: J1.3, J2.3, J5.3, R3.2

Notes on the sheet:
VOLTAGE REGULATORS
CLOCK
JUMPERS
TEST POINTS
DOLBY DECODER STA310
BULK CAPACITORS
PHASED LOCKED LOOPS
SPDIF INPUT
MOUNTING HOLES
DECOUPLING CAPACITORS
