duanestorey/hifi-amp/pcbs/_final_proto/input-sel/1.0/input-sel.kicad_sch

## KiCad design pcbs/_final_proto/input-sel/1.0/input-sel.kicad_sch (2025-10-22)

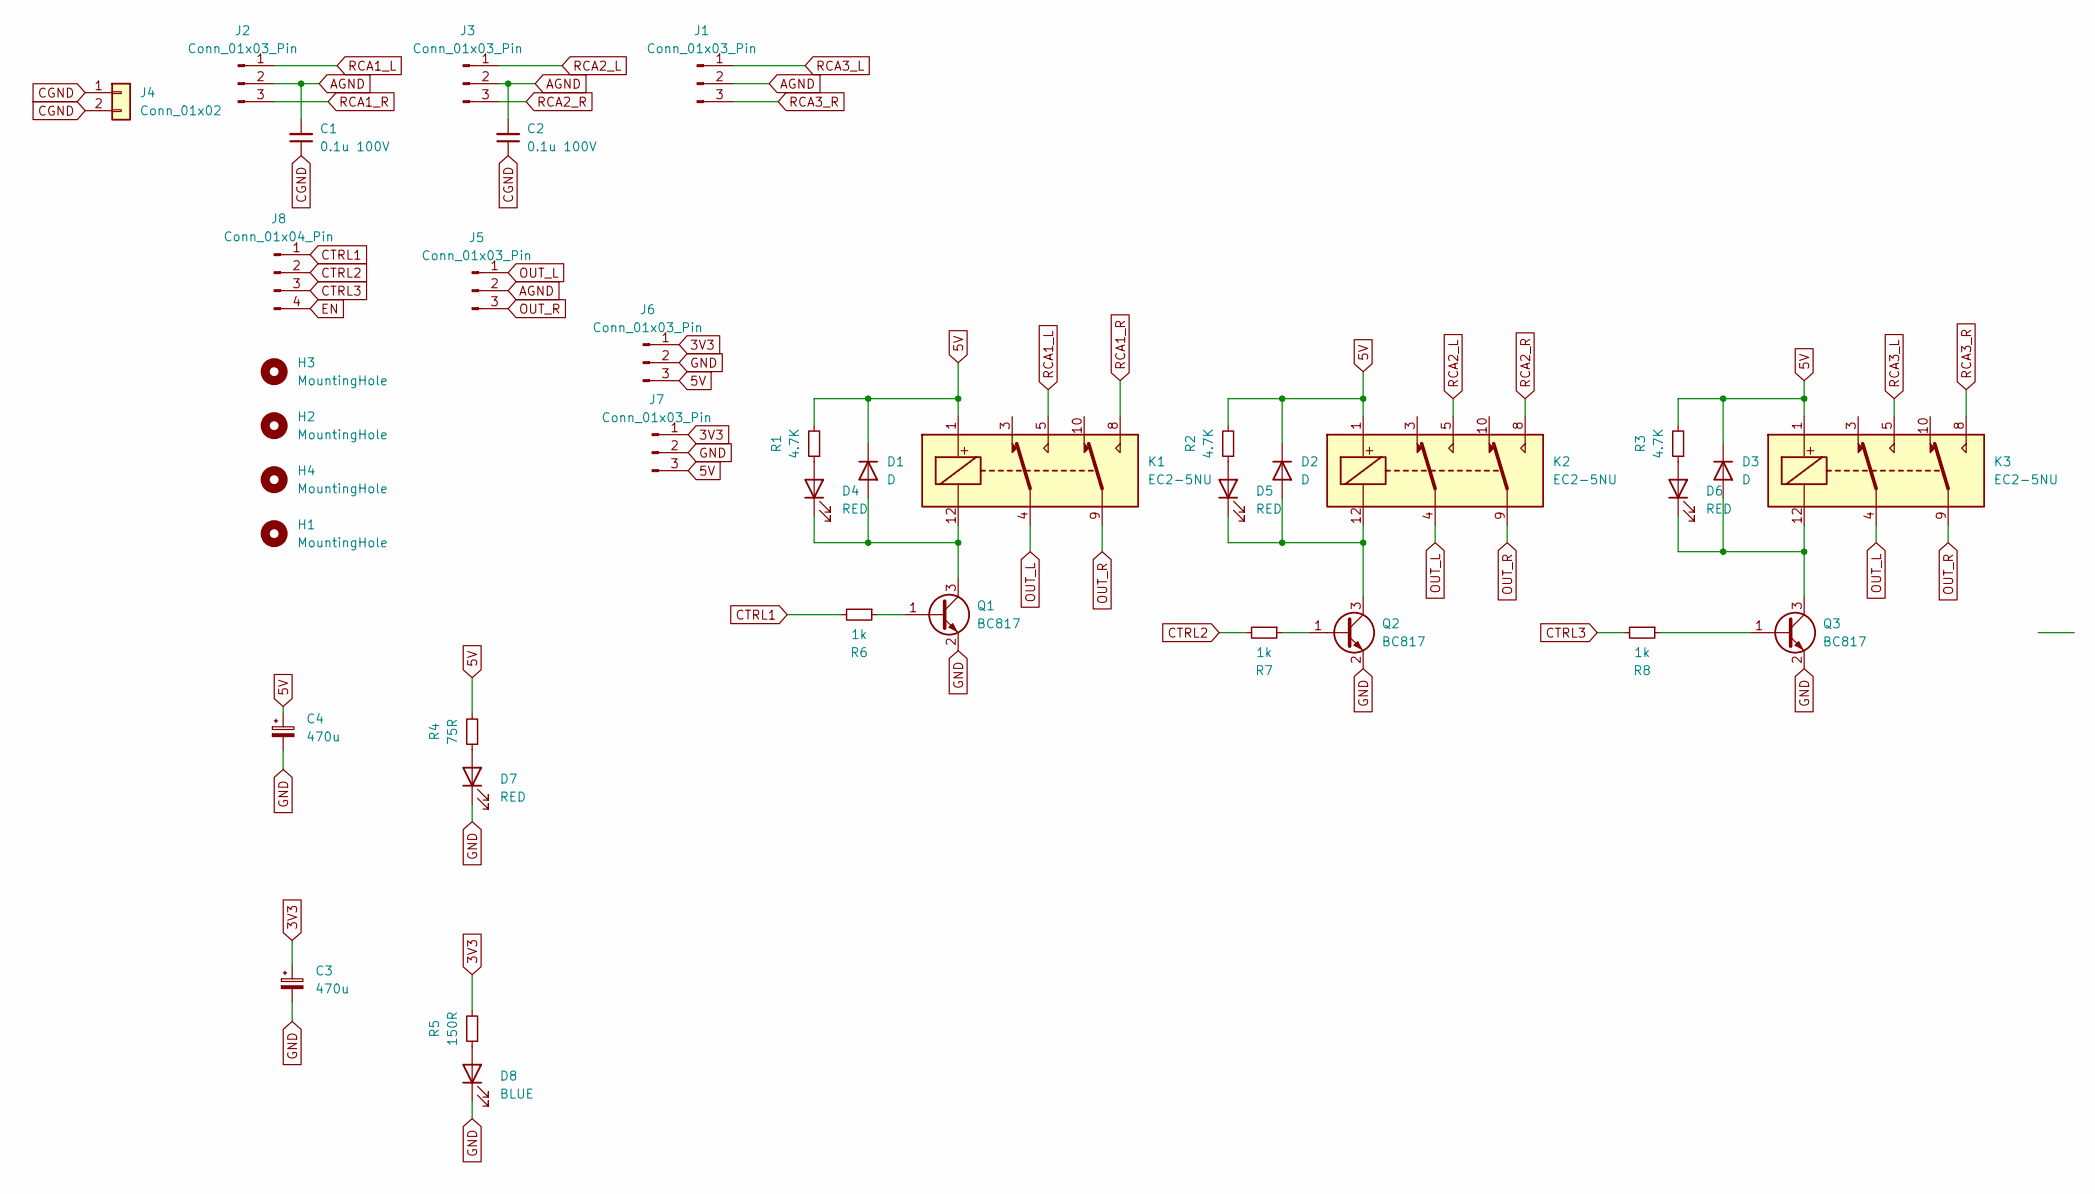
[picture p246: schematic input-sel.kicad_sch]

Parts:
C1, C2: 0.1u 100V; C_1206_3216Metric; Mouser 791-1206B104K101CT
C3, C4: 470u; CP_Radial_D6.3mm_P2.50mm
D1, D2, D3: D; D_SMA; Mouser 863-NRVA4005T3G
D4, D5, D6, D7: RED; LED_0805_2012Metric_Pad1.15x1.40mm_HandSolder
D8: BLUE; LED_0805_2012Metric_Pad1.15x1.40mm_HandSolder
H1, H2, H3, H4: MountingHole; MountingHole_3.2mm_M3_DIN965_Pad_TopOnly
J1, J5, J6, J7: Conn_01x03_Pin; JST_PH_B3B-PH-K_1x03_P2.00mm_Vertical
J2, J3: Conn_01x03_Pin; TerminalBlock_Phoenix_PT-1,5-3-3.5-H_1x03_P3.50mm_Horizontal
J4: Conn_01x02; TerminalBlock_Phoenix_PT-1,5-2-3.5-H_1x02_P3.50mm_Horizontal
J8: Conn_01x04_Pin; JST_PH_B4B-PH-K_1x04_P2.00mm_Vertical
K1, K2, K3: EC2-5NU; KEMET EA2; Mouser 80-EA2-12NU
Q1, Q2, Q3: BC817; SOT-23
R1, R2, R3: 4.7K; R_0805_2012Metric_Pad1.20x1.40mm_HandSolder
R4: 75R; R_0805_2012Metric_Pad1.20x1.40mm_HandSolder
R5: 150R; R_0805_2012Metric_Pad1.20x1.40mm_HandSolder
R6, R7, R8: 1k; R_0805_2012Metric_Pad1.20x1.40mm_HandSolder; Mouser 603-AC0603JR-07820RL

Connections:
3V3: C3.1, J6.1, J7.1, R5.2
5V: C4.1, D1.1 (K), D2.1 (K), D3.1 (K), J6.3, J7.3, K1.1, K2.1, K3.1, R1.2, R2.2, R3.2, R4.2
AGND: C1.2, C2.2, J1.2, J2.2, J3.2, J5.2
CGND: C1.1, C2.1, J4.1, J4.2
CTRL1: J8.1, R6.2
CTRL2: J8.2, R7.2
CTRL3: J8.3, R8.2
EN: J8.4
GND: C3.2, C4.2, D7.1 (K), D8.1 (K), J6.2, J7.2, Q1.2 (E), Q2.2 (E), Q3.2 (E)
unnamed: D1.2 (A), D4.1 (K), K1.12, Q1.3 (C)
unnamed: D2.2 (A), D5.1 (K), K2.12, Q2.3 (C)
unnamed: D3.2 (A), D6.1 (K), K3.12, Q3.3 (C)
unnamed: D4.2 (A), R1.1
unnamed: D5.2 (A), R2.1
unnamed: D6.2 (A), R3.1
unnamed: D7.2 (A), R4.1
unnamed: D8.2 (A), R5.1
unnamed: Q1.1 (B), R6.1
unnamed: Q2.1 (B), R7.1
unnamed: Q3.1 (B), R8.1
OUT_L: J5.1, K1.4, K2.4, K3.4
OUT_R: J5.3, K1.9, K2.9, K3.9
RCA1_L: J2.1, K1.5
RCA1_R: J2.3, K1.8
RCA2_L: J3.1, K2.5
RCA2_R: J3.3, K2.8
RCA3_L: J1.1, K3.5
RCA3_R: J1.3, K3.8
