duanestorey/hifi-amp/pcbs/_final_proto/line-filter/1.0/line-filter.kicad_sch

## KiCad design pcbs/_final_proto/line-filter/1.0/line-filter.kicad_sch (2025-10-22)

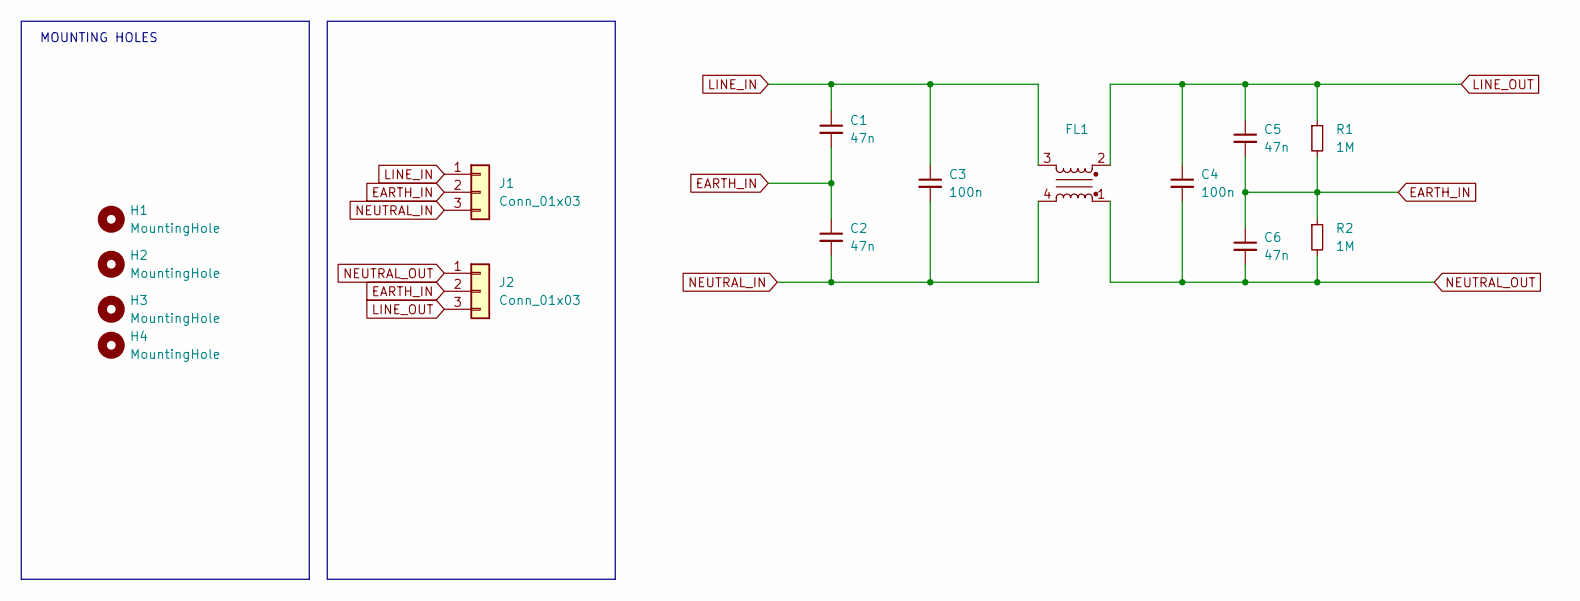
[picture p248: schematic line-filter.kicad_sch]

Parts:
C1, C2, C5, C6: 47n; C_Rect_L18.0mm_W7.0mm_P15.00mm_FKS3_FKP3
C3, C4: 100n; C_Rect_L18.0mm_W5.0mm_P15.00mm_FKS3_FKP3
FL1: Choke_CommonMode_PulseElectronics_PH9455x356NL; SSR21NV-M
H1, H2, H3, H4: MountingHole; MountingHole_3.2mm_M3_DIN965_Pad_TopBottom
J1, J2: Conn_01x03; TerminalBlock_Phoenix_MKDS-1,5-3_1x03_P5.00mm_Horizontal
R1, R2: 1M; R_1206_3216Metric_Pad1.30x1.75mm_HandSolder

Connections:
EARTH_IN: C1.2, C2.1, C5.2, C6.1, J1.2, J2.2, R1.2, R2.1
LINE_IN: C1.1, C3.1, FL1.3, J1.1
LINE_OUT: C4.1, C5.1, FL1.2, J2.3, R1.1
NEUTRAL_IN: C2.2, C3.2, FL1.4, J1.3
NEUTRAL_OUT: C4.2, C6.2, FL1.1, J2.1, R2.2

Notes on the sheet:
MOUNTING HOLES
