duanestorey/hifi-amp/pcbs/_final_proto/spdif-cs8416/1.0/spdif-cs8416.kicad_sch

## KiCad design pcbs/_final_proto/spdif-cs8416/1.0/spdif-cs8416.kicad_sch (2025-10-22)

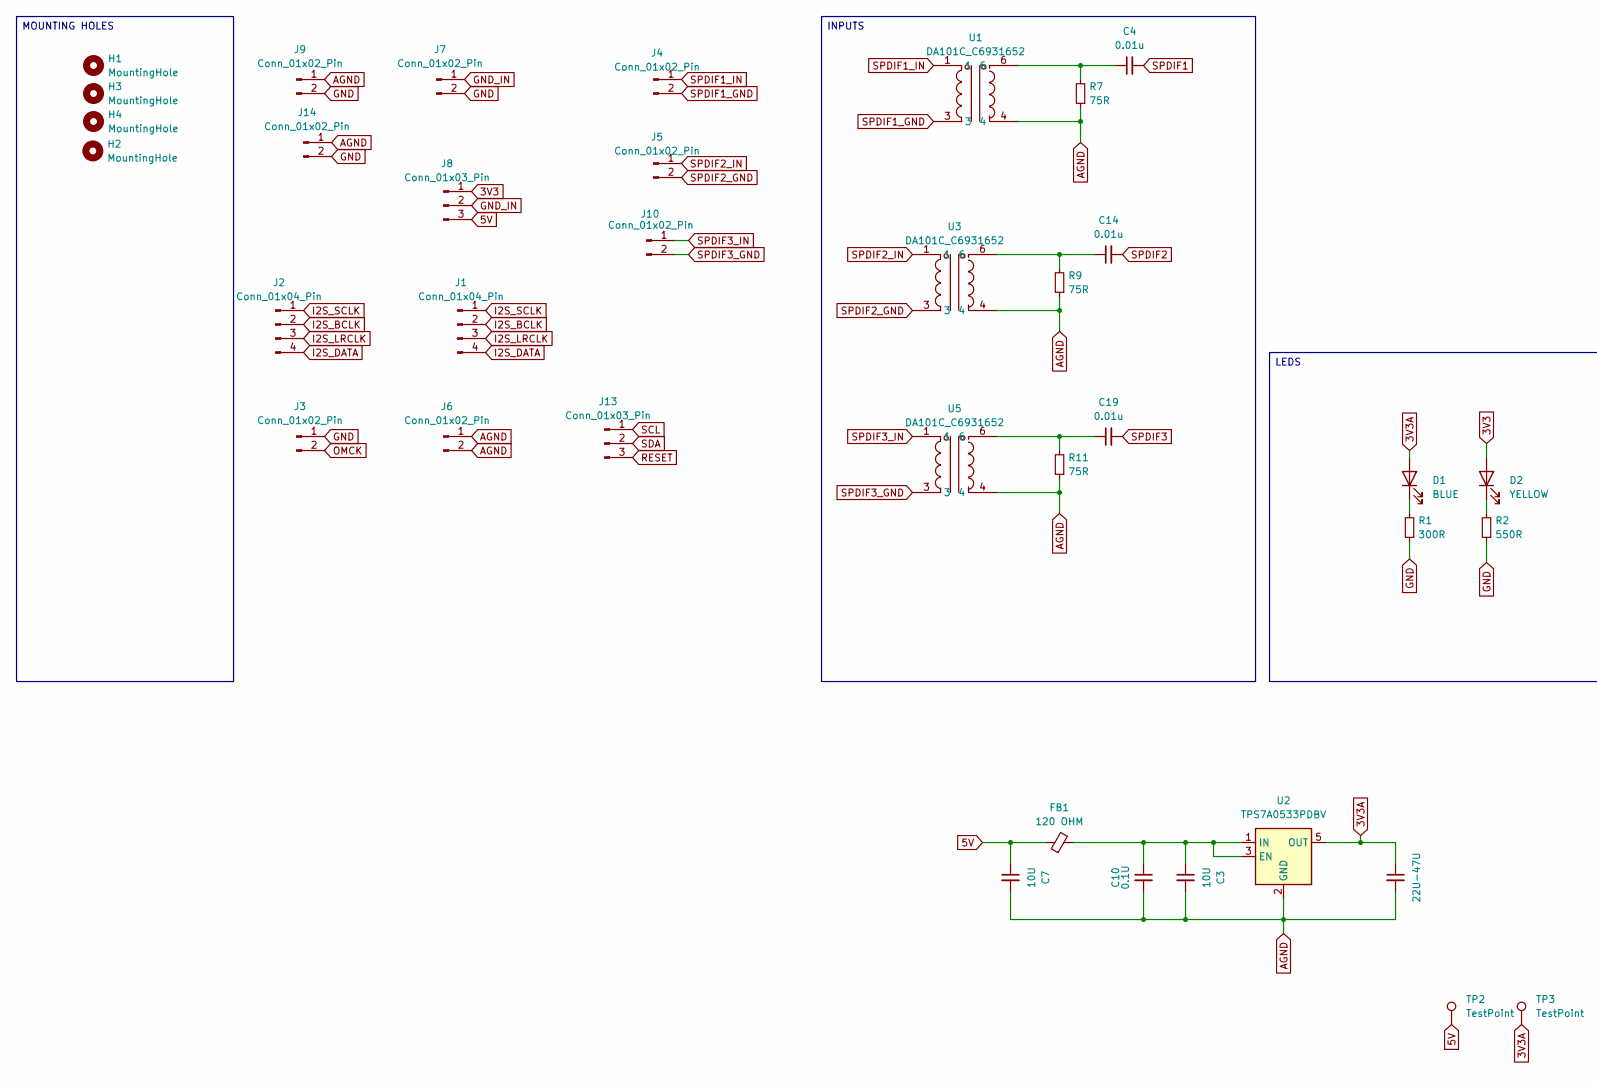
[picture p249: schematic spdif-cs8416.kicad_sch, part in row 1, column 1]

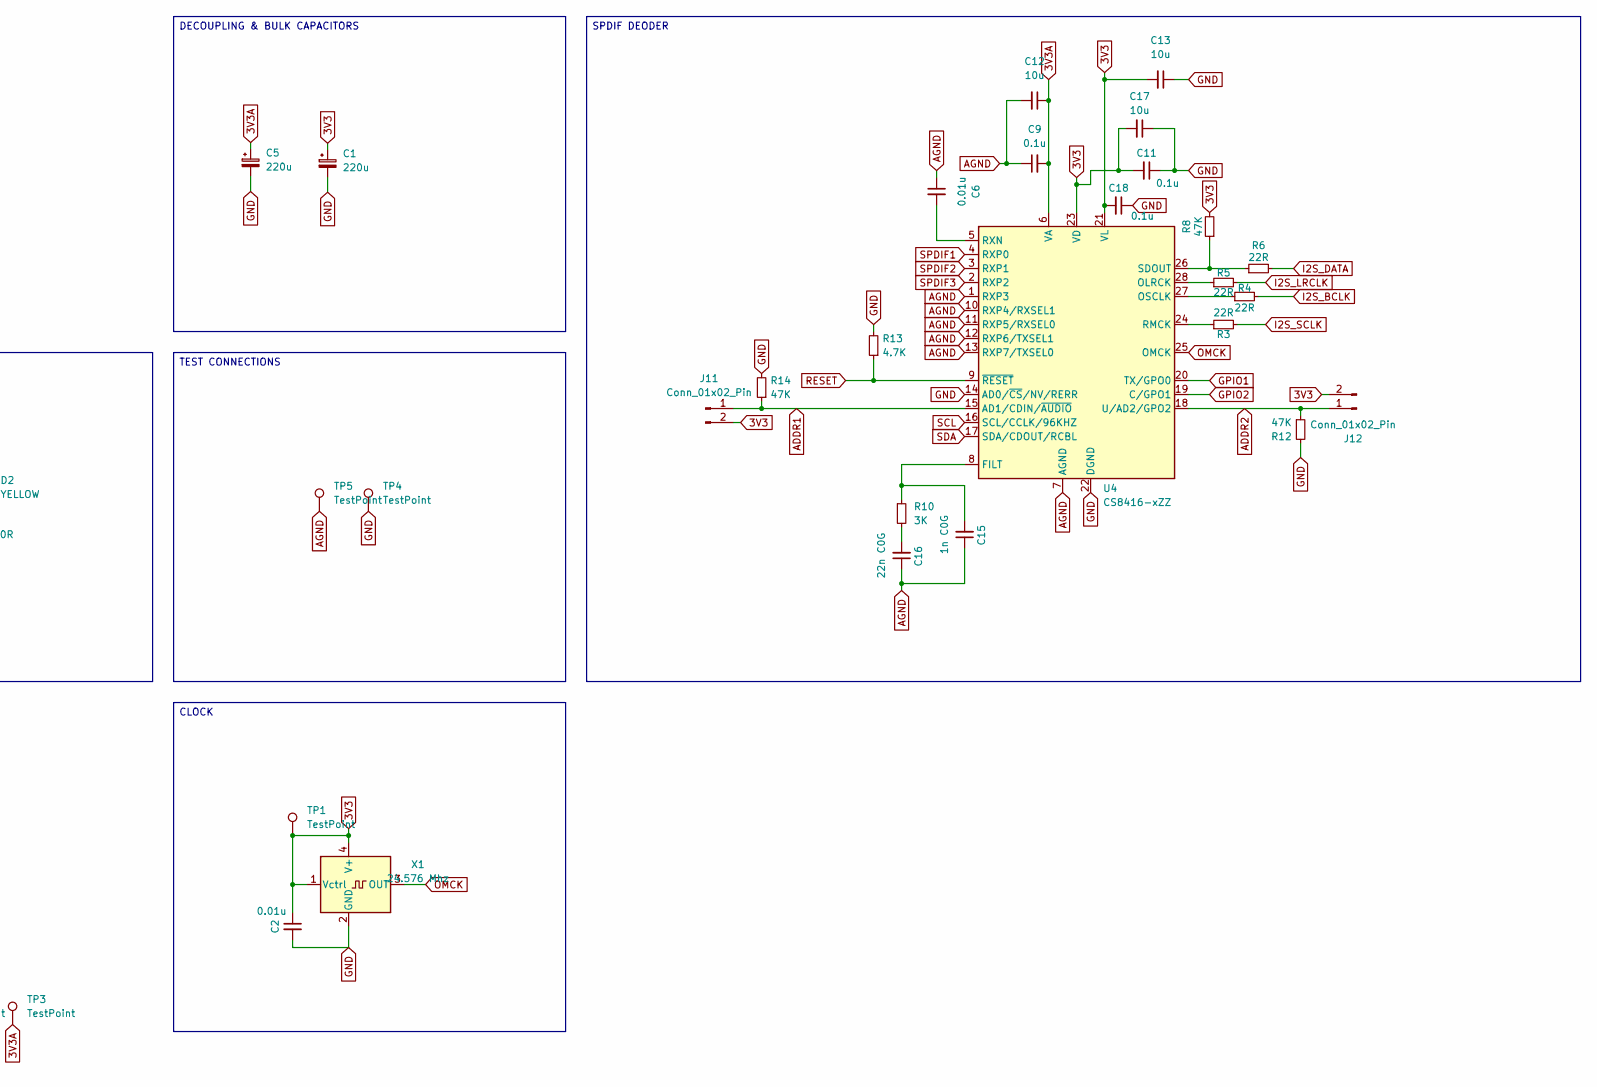
[picture p250: schematic spdif-cs8416.kicad_sch, part in row 1, column 2]

Parts:
C1, C5: 220u; CP_Radial_D6.3mm_P2.50mm
C2, C4, C6, C14, C19: 0.01u; C_0805_2012Metric_Pad1.18x1.45mm_HandSolder
C3, C7: 10U; C_1206_3216Metric_Pad1.33x1.80mm_HandSolder
C8: 22U-47U; C_1206_3216Metric_Pad1.33x1.80mm_HandSolder
C9, C11, C18: 0.1u; C_0805_2012Metric_Pad1.18x1.45mm_HandSolder
C10: 0.1U; C_0805_2012Metric_Pad1.18x1.45mm_HandSolder
C12, C13, C17: 10u; C_1206_3216Metric_Pad1.33x1.80mm_HandSolder
C15: 1n C0G; C_0805_2012Metric_Pad1.18x1.45mm_HandSolder
C16: 22n C0G; C_0805_2012Metric_Pad1.18x1.45mm_HandSolder; Mouser 80-C0805C223J3GECLR
D1: BLUE; LED_0805_2012Metric_Pad1.15x1.40mm_HandSolder
D2: YELLOW; LED_0805_2012Metric_Pad1.15x1.40mm_HandSolder
FB1: 120 OHM; R_0603_1608Metric_Pad0.98x0.95mm_HandSolder
H1, H2, H3, H4: MountingHole; MountingHole_3.2mm_M3_DIN965_Pad_TopOnly
J1: Conn_01x04_Pin; PinHeader_1x04_P2.54mm_Vertical
J2: Conn_01x04_Pin; JST_PH_B4B-PH-K_1x04_P2.00mm_Vertical
J3, J7, J9, J11, J12, J14: Conn_01x02_Pin; PinHeader_1x02_P2.54mm_Vertical
J4, J5, J10: Conn_01x02_Pin; JST_XH_B2B-XH-A_1x02_P2.50mm_Vertical
J6: Conn_01x02_Pin; JST_PH_B2B-PH-K_1x02_P2.00mm_Vertical
J8, J13: Conn_01x03_Pin; JST_PH_B3B-PH-K_1x03_P2.00mm_Vertical
R1: 300R; R_0805_2012Metric_Pad1.20x1.40mm_HandSolder
R2: 550R; R_0805_2012Metric_Pad1.20x1.40mm_HandSolder
R3, R4, R5, R6: 22R; R_0805_2012Metric_Pad1.20x1.40mm_HandSolder
R7, R9, R11: 75R; R_0805_2012Metric_Pad1.20x1.40mm_HandSolder; Mouser 603-RT0805FRE0775RL
R8, R12, R14: 47K; R_0805_2012Metric_Pad1.20x1.40mm_HandSolder
R10: 3K; R_0805_2012Metric_Pad1.20x1.40mm_HandSolder; Mouser 603-RT0805FRE133KL
R13: 4.7K; R_0805_2012Metric_Pad1.20x1.40mm_HandSolder
TP1, TP2, TP3, TP4, TP5: TestPoint; TestPoint_THTPad_1.5x1.5mm_Drill0.7mm
U1, U3, U5: DA101C_C6931652; XFMR-TH_4P-L9.5-W9.0-P5.08-LS10.2_C9900096976; LCSC Part C6931652
U2: TPS7A0533PDBV; SOT-23-5
U4: CS8416-xZZ; TSSOP-28_4.4x9.7mm_P0.65mm
X1: 24.576 Mhz; Oscillator_SMD_EuroQuartz_XO32-4Pin_3.2x2.5mm_HandSoldering; Mouser 815-ASE24.576MHZLCT

Connections:
3V3: C1.1, C2.1, C11.2, C13.2, C17.2, C18.2, D2.2 (A), J8.1, J11.2, J12.2, R8.2, TP1.1, U4.21 (VL), U4.23 (VD), X1.1 (Vctrl), X1.4 (V+)
3V3A: C5.1, C8.1, C9.2, C12.1, D1.2 (A), TP3.1, U2.5 (OUT), U4.6 (VA)
5V: C7.1, FB1.1, J8.3, TP2.1
ADDR1: J11.1, R14.1, U4.15 (AD1/CDIN/~AUDIO)
ADDR2: J12.1, R12.1, U4.18 (U/AD2/GPO2)
AGND: C3.2, C6.1, C7.2, C8.2, C9.1, C10.2, C12.2, C15.1, C16.1, J6.1, J6.2, J9.1, J14.1, R7.1, R9.1, R11.1, TP5.1, U1.4, U2.2 (GND), U3.4, U4.1 (RXP3), U4.7 (AGND), U4.10 (RXP4/RXSEL1), U4.11 (RXP5/RXSEL0), U4.12 (RXP6/TXSEL1), U4.13 (RXP7/TXSEL0), U5.4
GND: C1.2, C2.2, C5.2, C11.1, C13.1, C17.1, C18.1, J3.1, J7.2, J9.2, J14.2, R1.1, R2.1, R12.2, R13.2, R14.2, TP4.1, U4.14 (AD0/~CS/NV/RERR), U4.22 (DGND), X1.2 (GND)
GND_IN: J7.1, J8.2
GPIO1: U4.20 (TX/GPO0)
GPIO2: U4.19 (C/GPO1)
I2S_BCLK: J1.2, J2.2, R4.2
I2S_DATA: J1.4, J2.4, R6.2
I2S_LRCLK: J1.3, J2.3, R5.2
I2S_SCLK: J1.1, J2.1, R3.2
unnamed: C4.1, R7.2, U1.6
unnamed: C6.2, U4.5 (RXN)
unnamed: C3.1, C10.1, FB1.2, U2.1 (IN), U2.3 (EN)
unnamed: C14.1, R9.2, U3.6
unnamed: C15.2, R10.1, U4.8 (FILT)
unnamed: C16.2, R10.2
unnamed: C19.1, R11.2, U5.6
unnamed: D1.1 (K), R1.2
unnamed: D2.1 (K), R2.2
unnamed: R3.1, U4.24 (RMCK)
unnamed: R4.1, U4.27 (OSCLK)
unnamed: R5.1, U4.28 (OLRCK)
unnamed: R6.1, R8.1, U4.26 (SDOUT)
OMCK: J3.2, U4.25 (OMCK), X1.3 (OUT)
RESET: J13.3, R13.1, U4.9 (~RESET)
SCL: J13.1, U4.16 (SCL/CCLK/96KHZ)
SDA: J13.2, U4.17 (SDA/CDOUT/RCBL)
SPDIF1: C4.2, U4.4 (RXP0)
SPDIF1_GND: J4.2, U1.3
SPDIF1_IN: J4.1, U1.1
SPDIF2: C14.2, U4.3 (RXP1)
SPDIF2_GND: J5.2, U3.3
SPDIF2_IN: J5.1, U3.1
SPDIF3: C19.2, U4.2 (RXP2)
SPDIF3_GND: J10.2, U5.3
SPDIF3_IN: J10.1, U5.1

Notes on the sheet:
SPDIF DEODER
TEST CONNECTIONS
DECOUPLING & BULK CAPACITORS
LEDS
CLOCK
INPUTS
MOUNTING HOLES
