duanestorey/hifi-amp/pcbs/_final_proto/vinyl-duanesy/1.0/vinyl.kicad_sch

## KiCad design pcbs/_final_proto/vinyl-duanesy/1.0/vinyl.kicad_sch (2025-11-16)

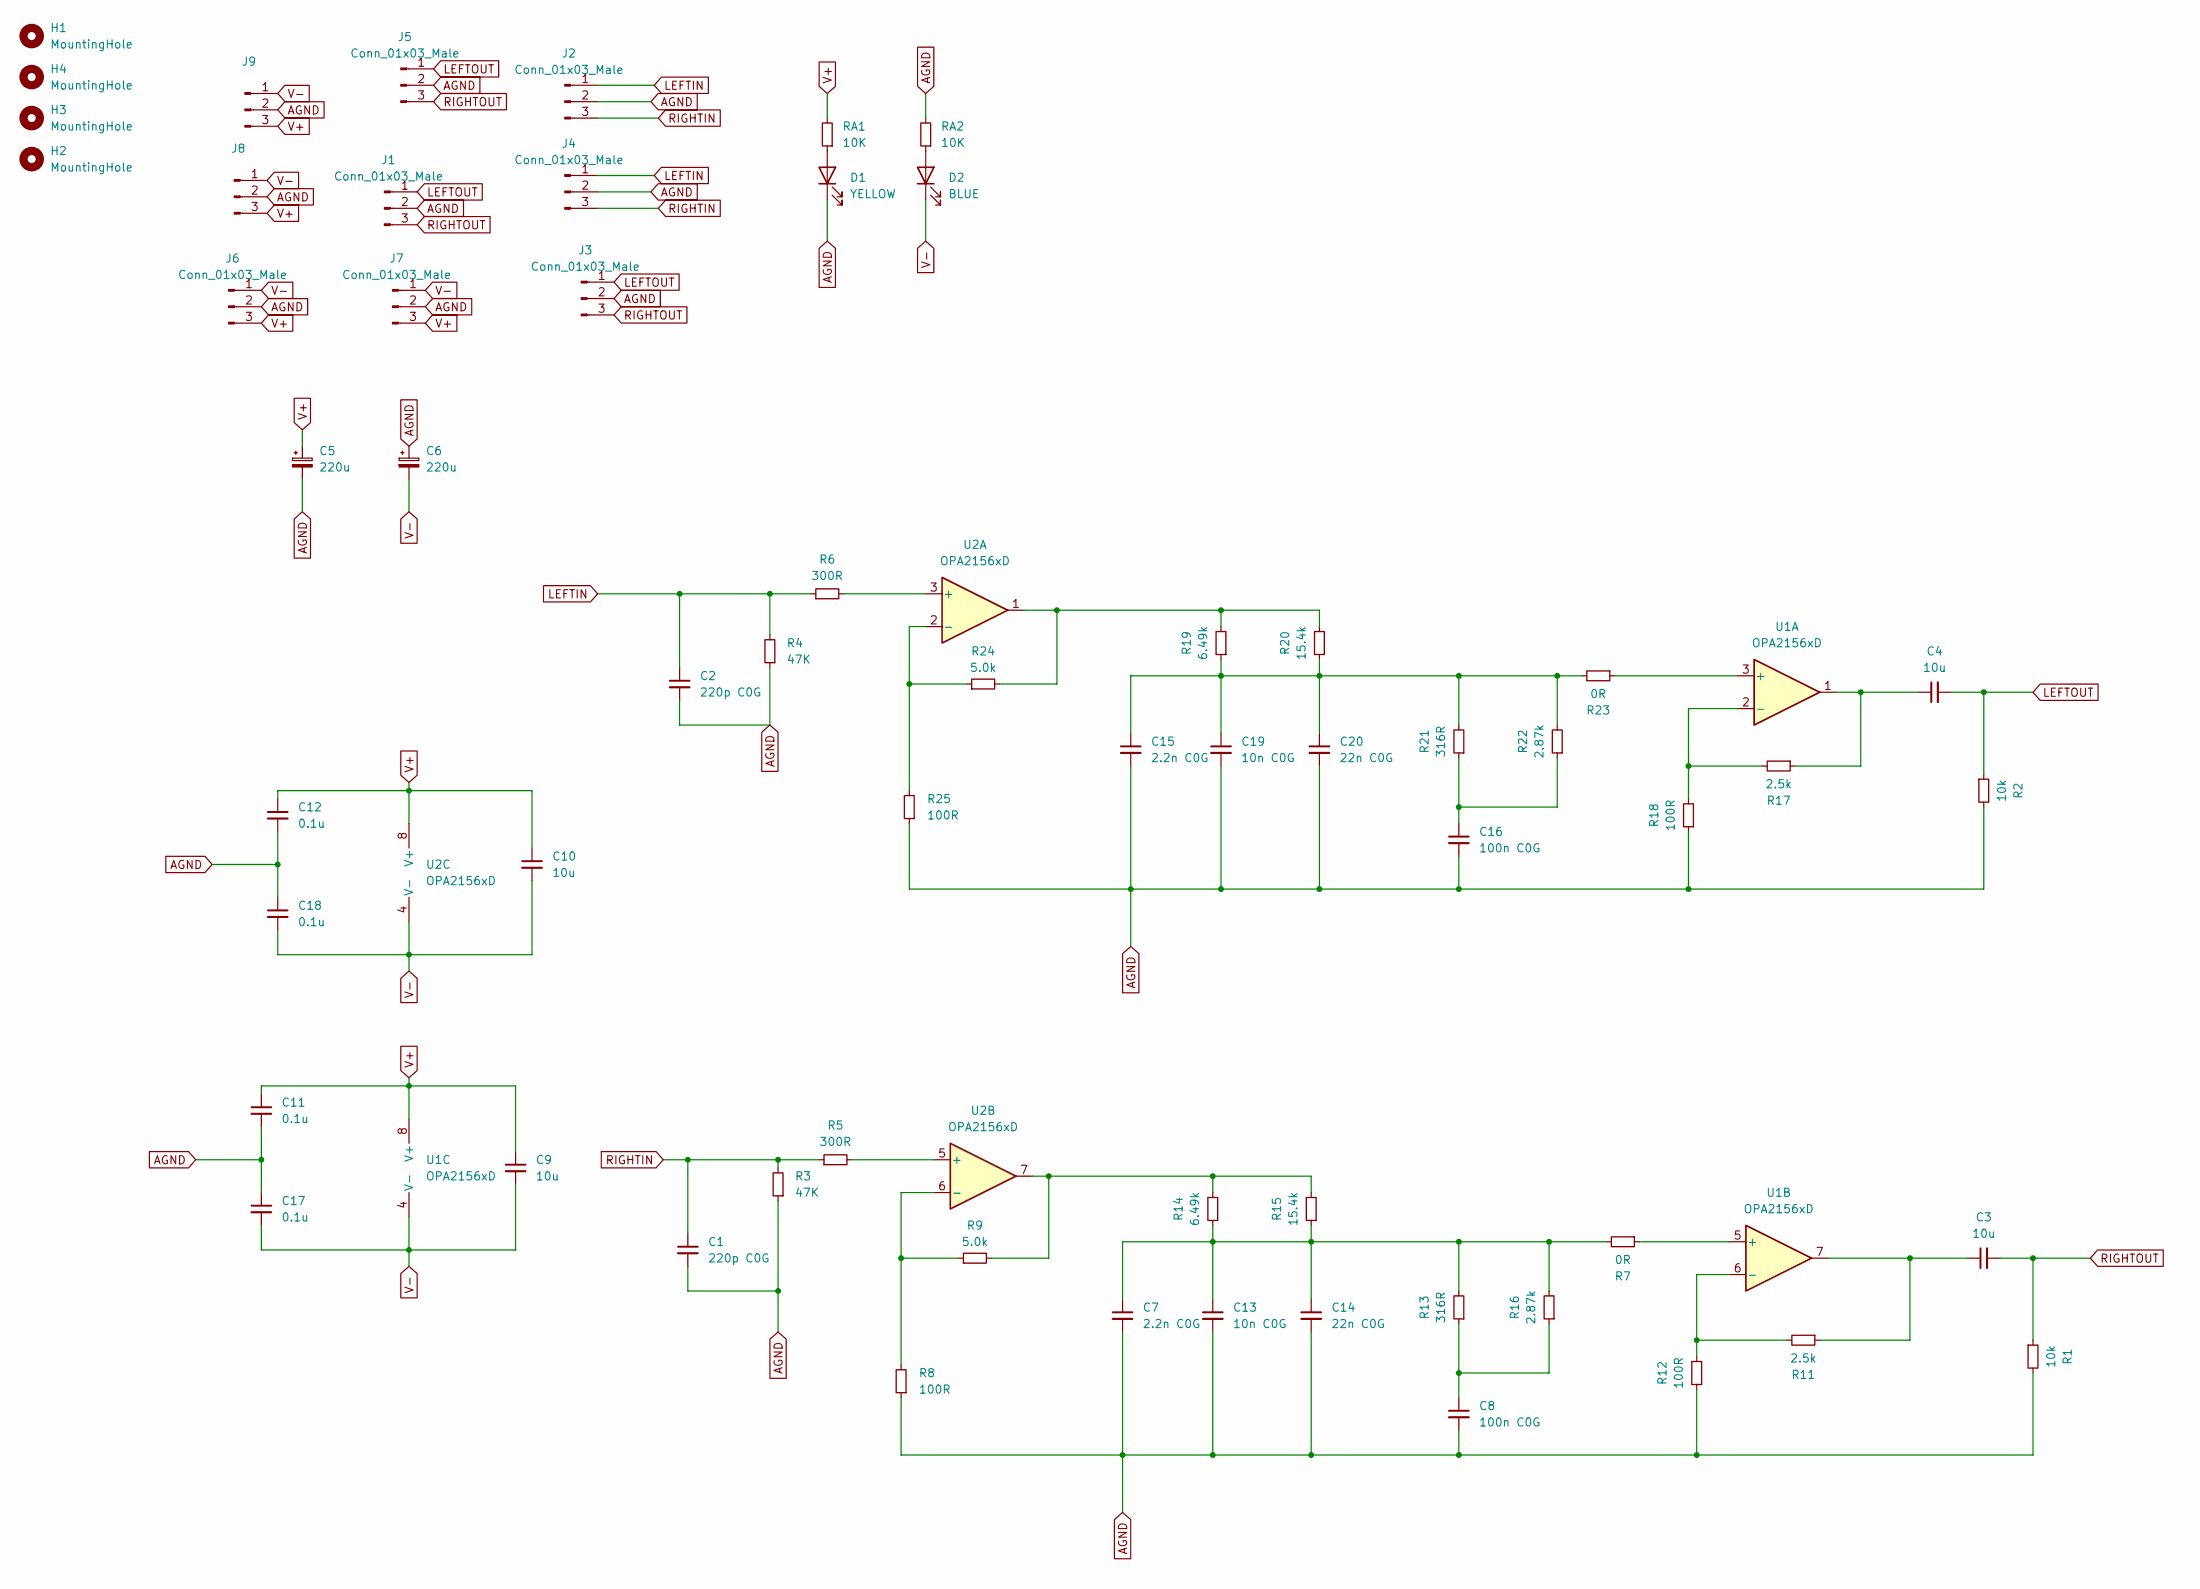
[picture p251: schematic vinyl.kicad_sch]

Parts:
C1, C2: 220p C0G; C_0805_2012Metric_Pad1.18x1.45mm_HandSolder_Duane; Mouser 791-0805N221F500CT
C3, C4: 10u; CP_Radial_D5.0mm_P2.00mm
C5, C6: 220u; CP_Elec_6.3x7.7
C7, C15: 2.2n C0G; C_0805_2012Metric_Pad1.18x1.45mm_HandSolder_Duane; Mouser 791-0805N222F500CT
C8, C16: 100n C0G; C_1206_3216Metric_Pad1.33x1.80mm_HandSolder_Duane; Mouser 81-GRT31C5C1H104FA2L
C9, C10: 10u; C_1206_3216Metric_Pad1.33x1.80mm_HandSolder_Duane
C11, C12, C17, C18: 0.1u; C_0805_2012Metric_Pad1.18x1.45mm_HandSolder_Duane
C13, C19: 10n C0G; C_0805_2012Metric_Pad1.18x1.45mm_HandSolder_Duane; Mouser 791-0805N103F500CT
C14, C20: 22n C0G; C_0805_2012Metric_Pad1.18x1.45mm_HandSolder_Duane; Mouser 81-GCM21B5C1H223FA6L
D1: YELLOW; LED_0805_2012Metric_Pad_HandSolder_Duane
D2: BLUE; LED_0805_2012Metric_Pad_HandSolder_Duane
H1, H2, H3, H4: MountingHole; MountingHole_3.2mm_M3_DIN965_Pad_TopOnly
J1, J2, J8, J9: Conn_01x03_Male; JST_PH_B3B-PH-K_1x03_P2.00mm_Vertical
J3, J4, J6, J7: Conn_01x03_Male; TerminalBlock_Phoenix_PT-1,5-3-5.0-H_1x03_P5.00mm_Horizontal
J5: Conn_01x03_Male; PinHeader_1x03_P2.54mm_Vertical
R1, R2: 10k; R_0805_2012Metric_Pad1.20x1.40mm_HandSolder_Duane; Mouser 754-RG2012P-103-B-T5
R3, R4: 47K; R_0805_2012Metric_Pad1.20x1.40mm_HandSolder_Duane; Mouser 603-RT0805BRD0747KL
R5, R6: 300R; R_0805_2012Metric_Pad1.20x1.40mm_HandSolder_Duane; Mouser 603-RT0805BRD07300RL
R7, R23: 0R; R_0805_2012Metric_Pad1.20x1.40mm_HandSolder_Duane; Mouser 594-MCU0805MZ0000ZP5
R8, R12, R18, R25: 100R; R_0805_2012Metric_Pad1.20x1.40mm_HandSolder_Duane; Mouser 708-RNCF0805BTE100R
R9, R24: 5.0k; R_0805_2012Metric_Pad1.20x1.40mm_HandSolder_Duane; Mouser 652-CRT0805BY5001EAS
R11, R17: 2.5k; R_0805_2012Metric_Pad1.20x1.40mm_HandSolder_Duane; Mouser PTN0805E2501BST1
R13, R21: 316R; R_0805_2012Metric_Pad1.20x1.40mm_HandSolder_Duane; Mouser 71-TNPW0805316RBEEA
R14, R19: 6.49k; R_0805_2012Metric_Pad1.20x1.40mm_HandSolder_Duane; Mouser RT0805BRD076K49L
R15, R20: 15.4k; R_0805_2012Metric_Pad1.20x1.40mm_HandSolder_Duane; Mouser RNCS0805BTE15K4
R16, R22: 2.87k; R_0805_2012Metric_Pad1.20x1.40mm_HandSolder_Duane; Mouser 667-ERA-6AEB2871V
RA1, RA2: 10K; R_0805_2012Metric_Pad1.20x1.40mm_HandSolder_Duane
U1, U2: OPA2156xD; DIP-8_W7.62mm_Socket

Connections:
AGND: C1.2, C2.2, C5.2, C6.1, C7.2, C8.2, C11.2, C12.2, C13.2, C14.2, C15.2, C16.2, C17.1, C18.1, C19.2, C20.2, D1.1 (K), J1.2, J2.2, J3.2, J4.2, J5.2, J6.2, J7.2, J8.2, J9.2, R1.2, R2.2, R3.1, R4.1, R8.1, R12.1, R18.1, R25.1, RA2.2
LEFTIN: C2.1, J2.1, J4.1, R4.2, R6.1
LEFTOUT: C4.2, J1.1, J3.1, J5.1, R2.1
unnamed: C3.1, R11.1, U1.7
unnamed: C4.1, R17.1, U1.1
unnamed: C8.1, R13.1, R16.1
unnamed: C7.1, C13.1, C14.1, R7.2, R13.2, R14.1, R15.1, R16.2
unnamed: C15.1, C19.1, C20.1, R19.1, R20.1, R21.2, R22.2, R23.2
unnamed: C16.1, R21.1, R22.1
unnamed: D1.2 (A), RA1.1
unnamed: D2.2 (A), RA2.1
unnamed: R5.2, U2.5 (+)
unnamed: R6.2, U2.3 (+)
unnamed: R7.1, U1.5 (+)
unnamed: R8.2, R9.1, U2.6 (-)
unnamed: R11.2, R12.2, U1.6 (-)
unnamed: R9.2, R14.2, R15.2, U2.7
unnamed: R17.2, R18.2, U1.2 (-)
unnamed: R19.2, R20.2, R24.2, U2.1
unnamed: R23.1, U1.3 (+)
unnamed: R24.1, R25.2, U2.2 (-)
RIGHTIN: C1.1, J2.3, J4.3, R3.2, R5.1
RIGHTOUT: C3.2, J1.3, J3.3, J5.3, R1.1
V+: C5.1, C9.1, C10.1, C11.1, C12.1, J6.3, J7.3, J8.3, J9.3, RA1.2, U1.8 (V+), U2.8 (V+)
V-: C6.2, C9.2, C10.2, C17.2, C18.2, D2.1 (K), J6.1, J7.1, J8.1, J9.1, U1.4 (V-), U2.4 (V-)
