duanestorey/hifi-amp/pcbs/psu/analog/1.0/analog.kicad_sch

## KiCad design pcbs/psu/analog/1.0/analog.kicad_sch (2025-10-22)

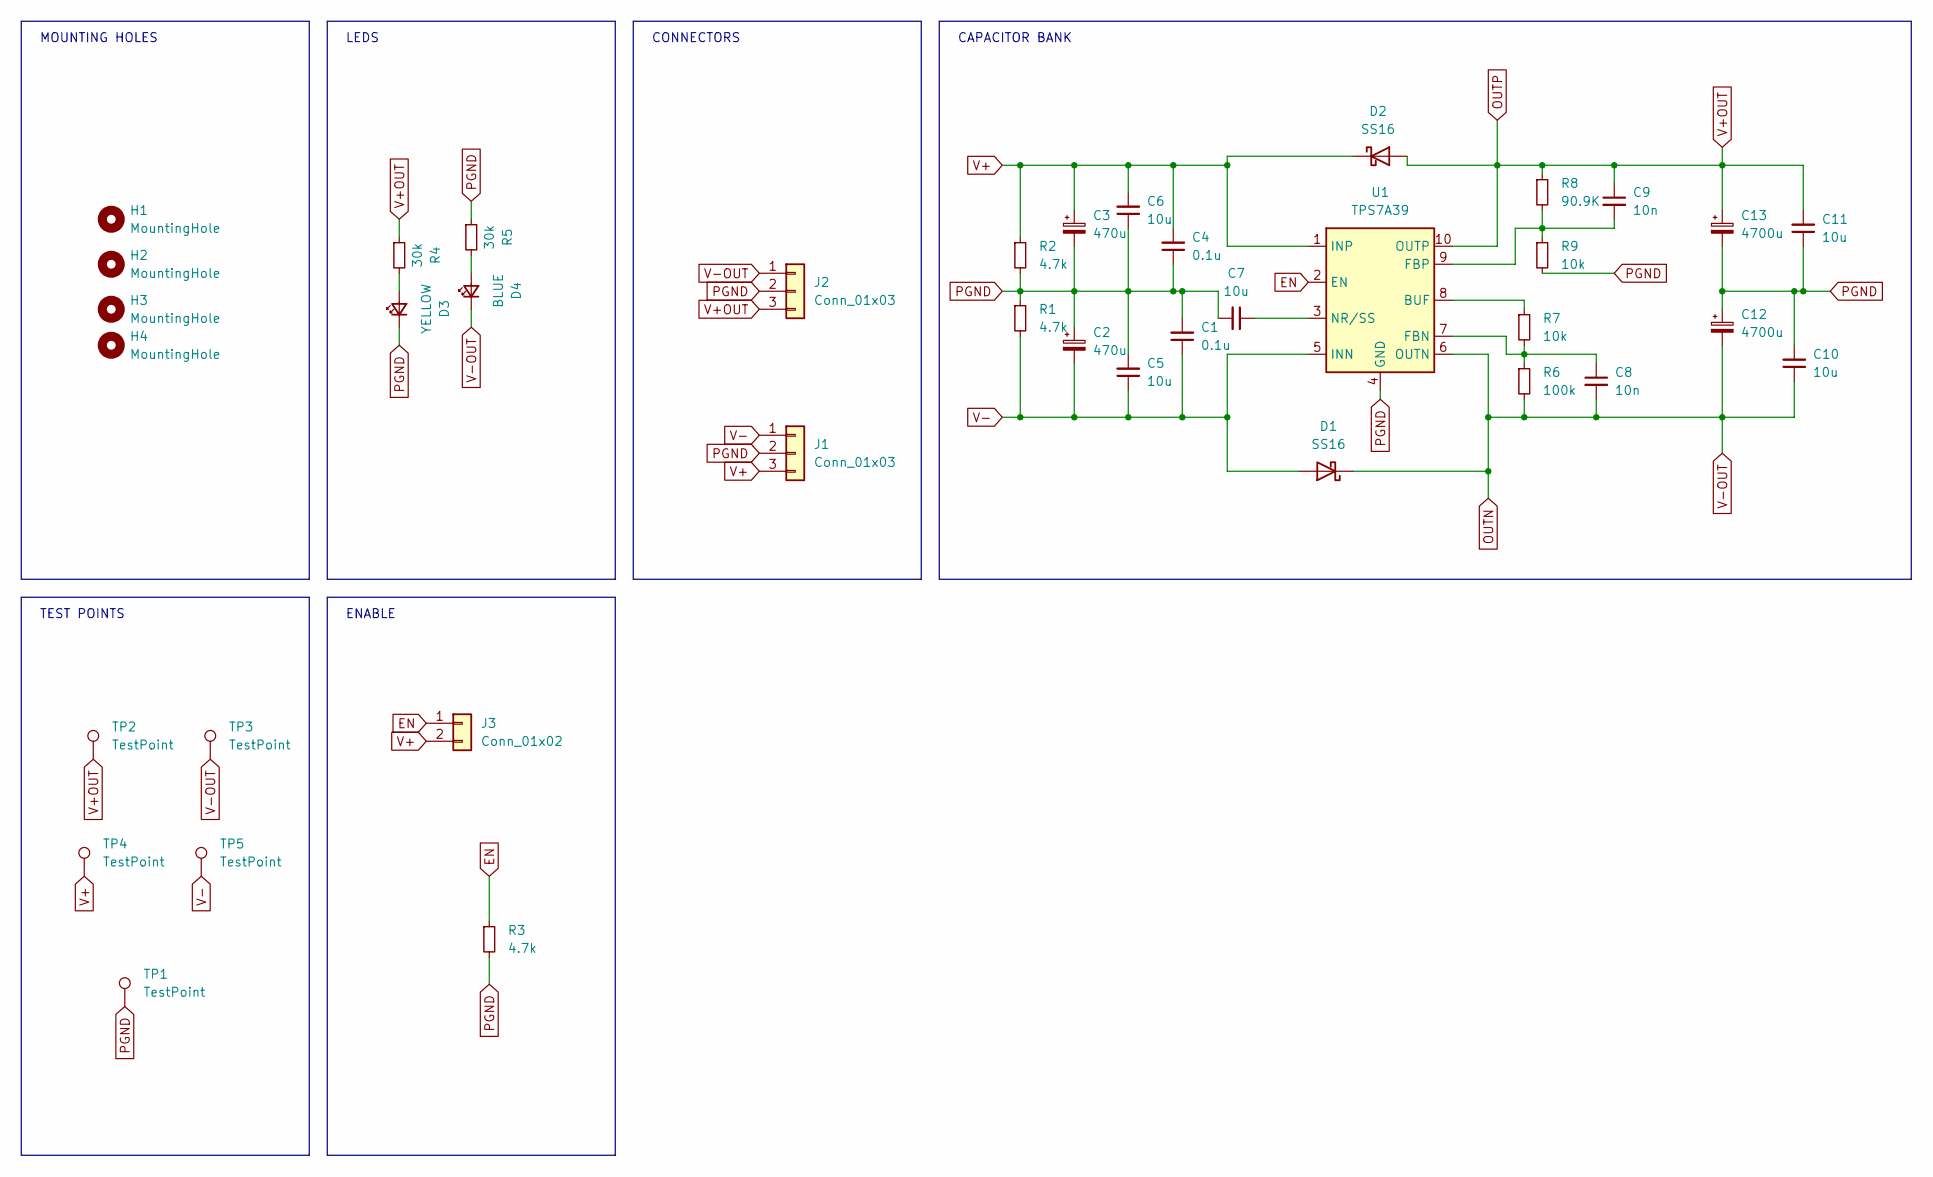
[picture p252: schematic analog.kicad_sch]

Parts:
C1, C4: 0.1u; C_0805_2012Metric_Pad1.18x1.45mm_HandSolder
C2, C3: 470u; CP_Radial_D8.0mm_P5.00mm
C5, C6, C7, C10, C11: 10u; C_1206_3216Metric_Pad1.33x1.80mm_HandSolder
C8, C9: 10n; C_0805_2012Metric_Pad1.18x1.45mm_HandSolder
C12, C13: 4700u; CP_Radial_D16.0mm_P7.50mm
D1, D2: SS16; D_SMA
D3: YELLOW; LED_0805_2012Metric_Pad1.15x1.40mm_HandSolder
D4: BLUE; LED_0805_2012Metric_Pad1.15x1.40mm_HandSolder
H1, H2, H3, H4: MountingHole; MountingHole_3.2mm_M3_DIN965_Pad_TopBottom
J1, J2: Conn_01x03; JST_VH_B3P-VH-B_1x03_P3.96mm_Vertical
J3: Conn_01x02; PinHeader_1x02_P2.54mm_Vertical
R1, R2, R3: 4.7k; R_0805_2012Metric_Pad1.20x1.40mm_HandSolder
R4, R5: 30k; R_0805_2012Metric_Pad1.20x1.40mm_HandSolder
R6: 100k; R_0805_2012Metric_Pad1.20x1.40mm_HandSolder
R7, R9: 10k; R_0805_2012Metric_Pad1.20x1.40mm_HandSolder
R8: 90.9K; R_0805_2012Metric_Pad1.20x1.40mm_HandSolder
TP1, TP2, TP3, TP4, TP5: TestPoint; TestPoint_THTPad_2.5x2.5mm_Drill1.2mm
U1: TPS7A39; Texas_S-PVSON-N10_ThermalVias

Connections:
EN: J3.1, R3.1, U1.2 (EN)
unnamed: C7.1, U1.3 (NR/SS)
unnamed: C8.1, R6.1, R7.2, U1.7 (FBN)
unnamed: C9.2, R8.2, R9.1, U1.9 (FBP)
unnamed: D3.2 (A), R4.2
unnamed: D4.2 (A), R5.2
unnamed: R7.1, U1.8 (BUF)
OUTN: C8.2, C10.1, C12.2, D1.1 (K), D4.1 (K), J2.1, R6.2, TP3.1, U1.6 (OUTN)
OUTP: C9.1, C11.2, C13.1, D2.2 (A), J2.3, R4.1, R8.1, TP2.1, U1.10 (OUTP)
PGND: C1.2, C2.1, C3.2, C4.1, C5.2, C6.1, C7.2, C10.2, C11.1, C12.1, C13.2, D3.1 (K), J1.2, J2.2, R1.1, R2.2, R3.2, R5.1, R9.2, TP1.1, U1.4 (GND), U1.11 (GND)
V+: C3.1, C4.2, C6.2, D2.1 (K), J1.3, J3.2, R2.1, TP4.1, U1.1 (INP)
V-: C1.1, C2.2, C5.1, D1.2 (A), J1.1, R1.2, TP5.1, U1.5 (INN)

Notes on the sheet:
CAPACITOR BANK
MOUNTING HOLES
LEDS
CONNECTORS
TEST POINTS
ENABLE
