duanestorey/hifi-amp/pcbs/psu/capacitor-bank-center/1.0/capacitor-bank.kicad_sch

## KiCad design pcbs/psu/capacitor-bank-center/1.0/capacitor-bank.kicad_sch (2025-10-22)

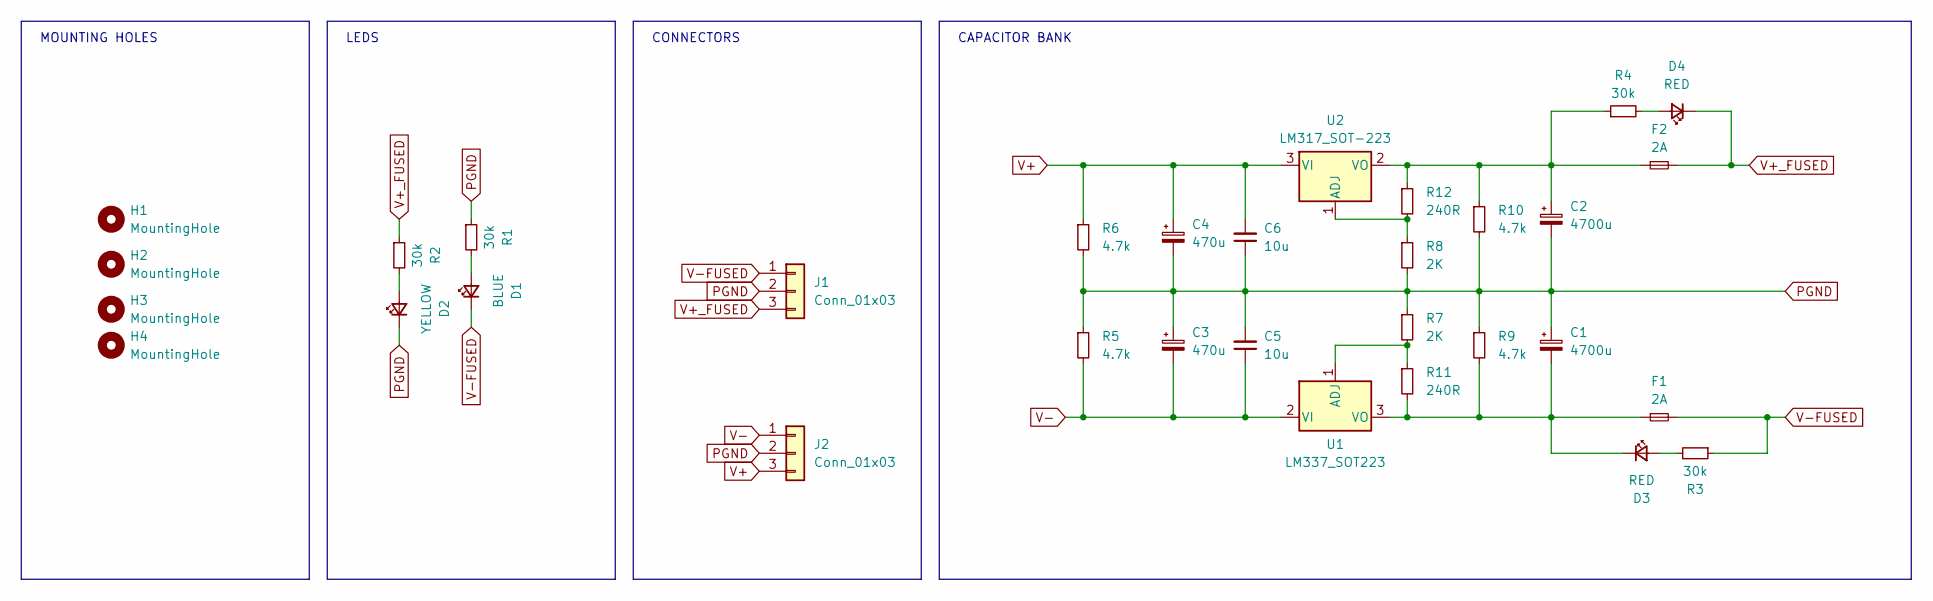
[picture p253: schematic capacitor-bank.kicad_sch]

Parts:
C1, C2: 4700u; CP_Radial_D16.0mm_P7.50mm
C3, C4: 470u; CP_Radial_D8.0mm_P5.00mm
C5, C6: 10u; C_1206_3216Metric_Pad1.33x1.80mm_HandSolder
D1: BLUE; LED_0805_2012Metric_Pad1.15x1.40mm_HandSolder
D2: YELLOW; LED_0805_2012Metric_Pad1.15x1.40mm_HandSolder
D3, D4: RED; LED_0805_2012Metric_Pad1.15x1.40mm_HandSolder
F1, F2: 2A; Aliexpress Fuse 5x20
H1, H2, H3, H4: MountingHole; MountingHole_3.2mm_M3_DIN965_Pad_TopBottom
J1, J2: Conn_01x03; JST_VH_B3P-VH-B_1x03_P3.96mm_Vertical
R1, R2, R3, R4: 30k; R_0805_2012Metric_Pad1.20x1.40mm_HandSolder
R5, R6, R9, R10: 4.7k; R_0805_2012Metric_Pad1.20x1.40mm_HandSolder
R7, R8: 2K; R_0805_2012Metric_Pad1.20x1.40mm_HandSolder
R11, R12: 240R; R_0805_2012Metric_Pad1.20x1.40mm_HandSolder
U1: LM337_SOT223; SOT-223-3_TabPin2
U2: LM317_SOT-223; SOT-223-3_TabPin2

Connections:
unnamed: C1.2, D3.1 (K), F1.1, R9.2, R11.2, U1.3 (VO)
unnamed: C2.1, F2.1, R4.1, R10.1, R12.1, U2.2 (VO)
unnamed: D1.2 (A), R1.2
unnamed: D2.2 (A), R2.2
unnamed: D3.2 (A), R3.2
unnamed: D4.2 (A), R4.2
unnamed: R7.2, R11.1, U1.1 (ADJ)
unnamed: R8.1, R12.2, U2.1 (ADJ)
PGND: C1.1, C2.2, C3.1, C4.2, C5.2, C6.1, D2.1 (K), J1.2, J2.2, R1.1, R5.1, R6.2, R7.1, R8.2, R9.1, R10.2
V+: C4.1, C6.2, J2.3, R6.1, U2.3 (VI)
V+_FUSED: D4.1 (K), F2.2, J1.3, R2.1
V-: C3.2, C5.1, J2.1, R5.2, U1.2 (VI)
V-FUSED: D1.1 (K), F1.2, J1.1, R3.1

Notes on the sheet:
CAPACITOR BANK
MOUNTING HOLES
LEDS
CONNECTORS
