duanestorey/hifi-amp/pcbs/psu/capacitor-bank-center/1.1/capacitor-bank.kicad_sch

## KiCad design pcbs/psu/capacitor-bank-center/1.1/capacitor-bank.kicad_sch (2025-10-22)

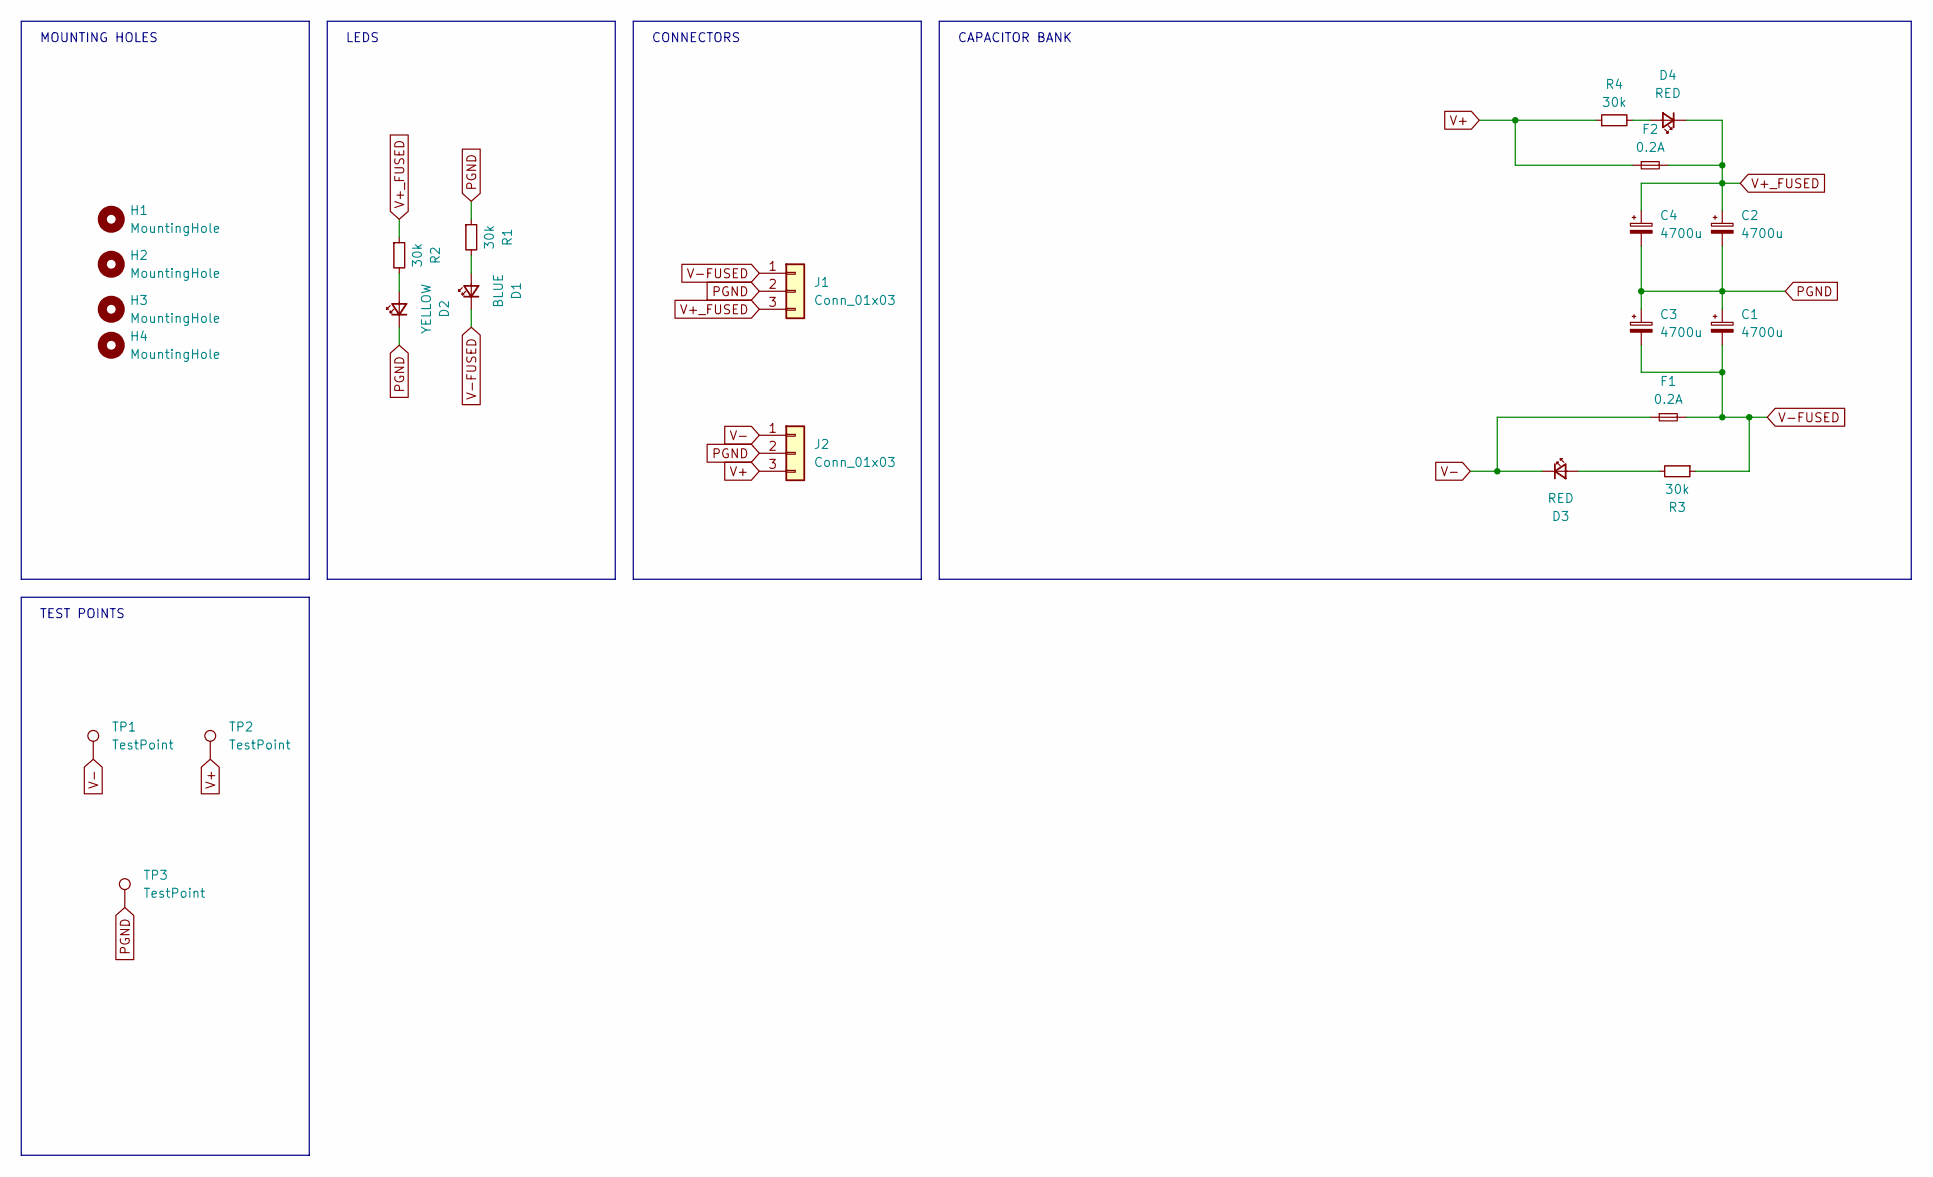
[picture p254: schematic capacitor-bank.kicad_sch]

Parts:
C1, C2, C3, C4: 4700u; CP_Radial_D16.0mm_P7.50mm
D1: BLUE; LED_0805_2012Metric_Pad1.15x1.40mm_HandSolder
D2: YELLOW; LED_0805_2012Metric_Pad1.15x1.40mm_HandSolder
D3, D4: RED; LED_0805_2012Metric_Pad1.15x1.40mm_HandSolder
F1, F2: 0.2A; Aliexpress Fuse 5x20
H1, H2, H3, H4: MountingHole; MountingHole_3.2mm_M3_DIN965_Pad_TopBottom
J1, J2: Conn_01x03; JST_VH_B3P-VH-B_1x03_P3.96mm_Vertical
R1, R2, R3, R4: 30k; R_0805_2012Metric_Pad1.20x1.40mm_HandSolder
TP1, TP2, TP3: TestPoint; TestPoint_THTPad_2.5x2.5mm_Drill1.2mm

Connections:
unnamed: D1.2 (A), R1.2
unnamed: D2.2 (A), R2.2
unnamed: D3.2 (A), R3.2
unnamed: D4.2 (A), R4.2
PGND: C1.1, C2.2, C3.1, C4.2, D2.1 (K), J1.2, J2.2, R1.1, TP3.1
V+: F2.1, J2.3, R4.1, TP2.1
V+_FUSED: C2.1, C4.1, D4.1 (K), F2.2, J1.3, R2.1
V-: D3.1 (K), F1.1, J2.1, TP1.1
V-FUSED: C1.2, C3.2, D1.1 (K), F1.2, J1.1, R3.1

Notes on the sheet:
CAPACITOR BANK
MOUNTING HOLES
LEDS
CONNECTORS
TEST POINTS
