duanestorey/hifi-amp/pcbs/psu/debug-prog/1.0/debug.kicad_sch

## KiCad design pcbs/psu/debug-prog/1.0/debug.kicad_sch (2025-10-22)

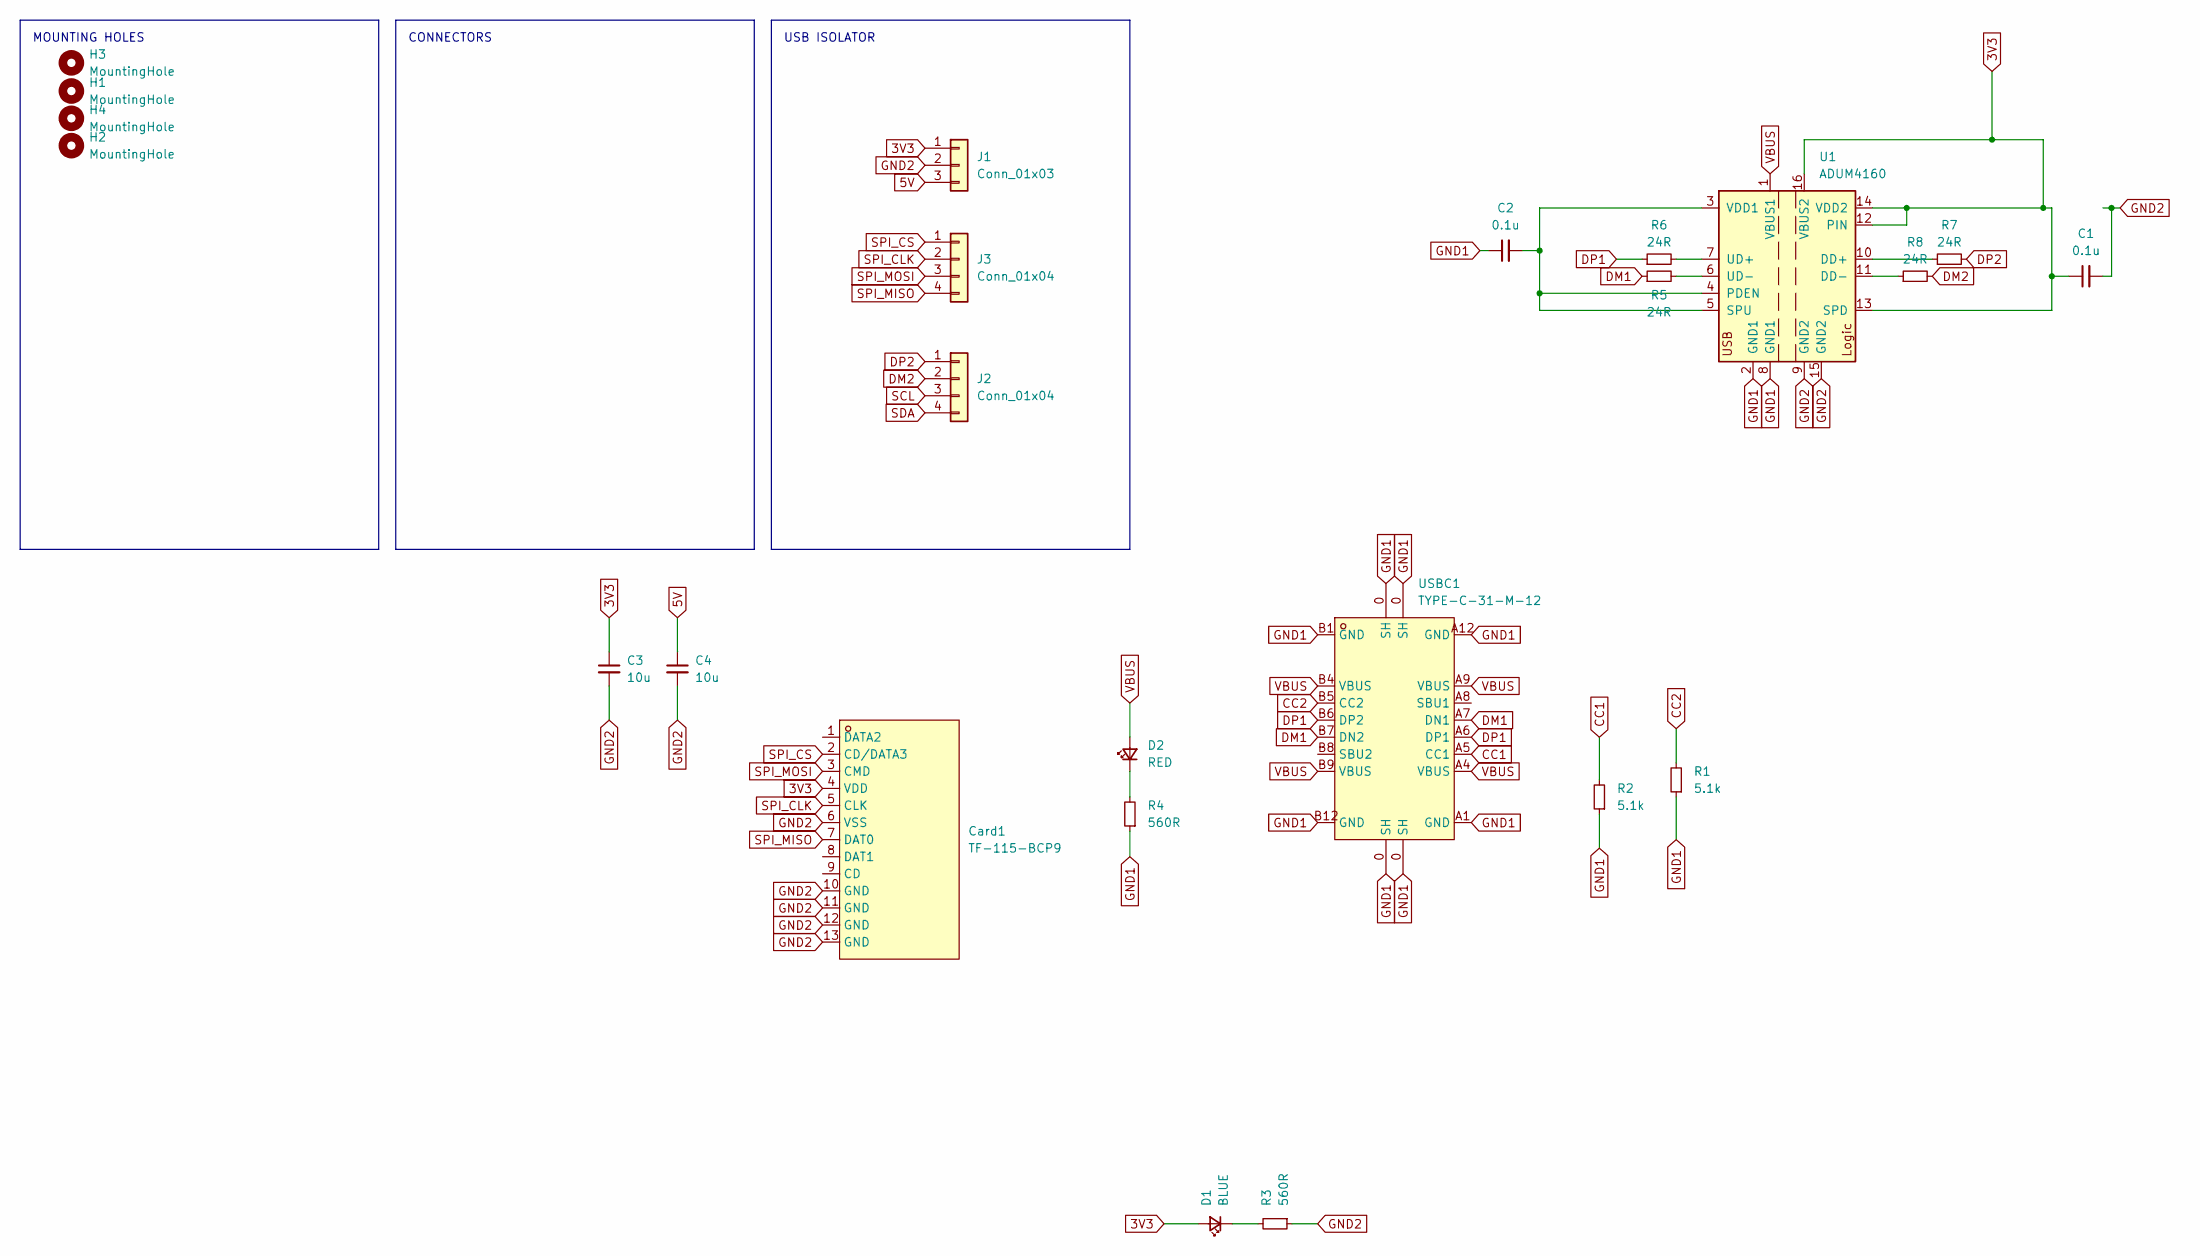
[picture p255: schematic debug.kicad_sch]

Parts:
C1, C2: 0.1u; C_0805_2012Metric_Pad1.18x1.45mm_HandSolder
C3, C4: 10u; C_1206_3216Metric_Pad1.33x1.80mm_HandSolder
Card1: TF-115-BCP9; TF-SMD_TF-115-BCP9; LCSC Part C720505
D1: BLUE; LED_0805_2012Metric_Pad1.15x1.40mm_HandSolder
D2: RED; LED_0805_2012Metric_Pad1.15x1.40mm_HandSolder
H1, H2, H3, H4: MountingHole; MountingHole_3.2mm_M3_DIN965_Pad_TopOnly
J1: Conn_01x03; JST_PH_B3B-PH-K_1x03_P2.00mm_Vertical
J2, J3: Conn_01x04; JST_PH_B4B-PH-K_1x04_P2.00mm_Vertical
R1, R2: 5.1k; R_0805_2012Metric_Pad1.20x1.40mm_HandSolder
R3, R4: 560R; R_0805_2012Metric_Pad1.20x1.40mm_HandSolder
R5, R6, R7, R8: 24R; R_0603_1608Metric_Pad0.98x0.95mm_HandSolder
U1: ADUM4160; SOIC-16W_7.5x10.3mm_P1.27mm
USBC1: TYPE-C-31-M-12; USB-C_SMD-TYPE-C-31-M-12; LCSC Part C165948

Connections:
3V3: C1.1, C3.1, Card1.4 (VDD), D1.2 (A), J1.1, U1.12 (PIN), U1.13 (SPD), U1.14 (VDD2), U1.16 (VBUS2)
5V: C4.1, J1.3
CC1: R2.2, USBC1.A5 (CC1)
CC2: R1.2, USBC1.B5 (CC2)
DM1: R5.1, USBC1.A7 (DN1), USBC1.B7 (DN2)
DM2: J2.2, R8.2
DP1: R6.1, USBC1.A6 (DP1), USBC1.B6 (DP2)
DP2: J2.1, R7.2
GND1: C2.1, R1.1, R2.1, R4.1, U1.2 (GND1), U1.8 (GND1), USBC1.0 (SH), USBC1.A1 (GND), USBC1.A12 (GND), USBC1.B1 (GND), USBC1.B12 (GND)
GND2: C1.2, C3.2, C4.2, Card1.6 (VSS), Card1.10 (GND), Card1.11 (GND), Card1.12 (GND), Card1.13 (GND), J1.2, R3.1, U1.9 (GND2), U1.15 (GND2)
unnamed: C2.2, U1.3 (VDD1), U1.4 (PDEN), U1.5 (SPU)
unnamed: D1.1 (K), R3.2
unnamed: D2.1 (K), R4.2
unnamed: R5.2, U1.6 (UD-)
unnamed: R6.2, U1.7 (UD+)
unnamed: R7.1, U1.10 (DD+)
unnamed: R8.1, U1.11 (DD-)
SCL: J2.3
SDA: J2.4
SPI_CLK: Card1.5 (CLK), J3.2
SPI_CS: Card1.2 (CD/DATA3), J3.1
SPI_MISO: Card1.7 (DAT0), J3.4
SPI_MOSI: Card1.3 (CMD), J3.3
VBUS: D2.2 (A), U1.1 (VBUS1), USBC1.A4 (VBUS), USBC1.A9 (VBUS), USBC1.B4 (VBUS), USBC1.B9 (VBUS)

Notes on the sheet:
CONNECTORS
USB ISOLATOR
MOUNTING HOLES
