duanestorey/hifi-amp/pcbs/psu/digital/1.1/digital.kicad_sch

## KiCad design pcbs/psu/digital/1.1/digital.kicad_sch (2025-10-22)

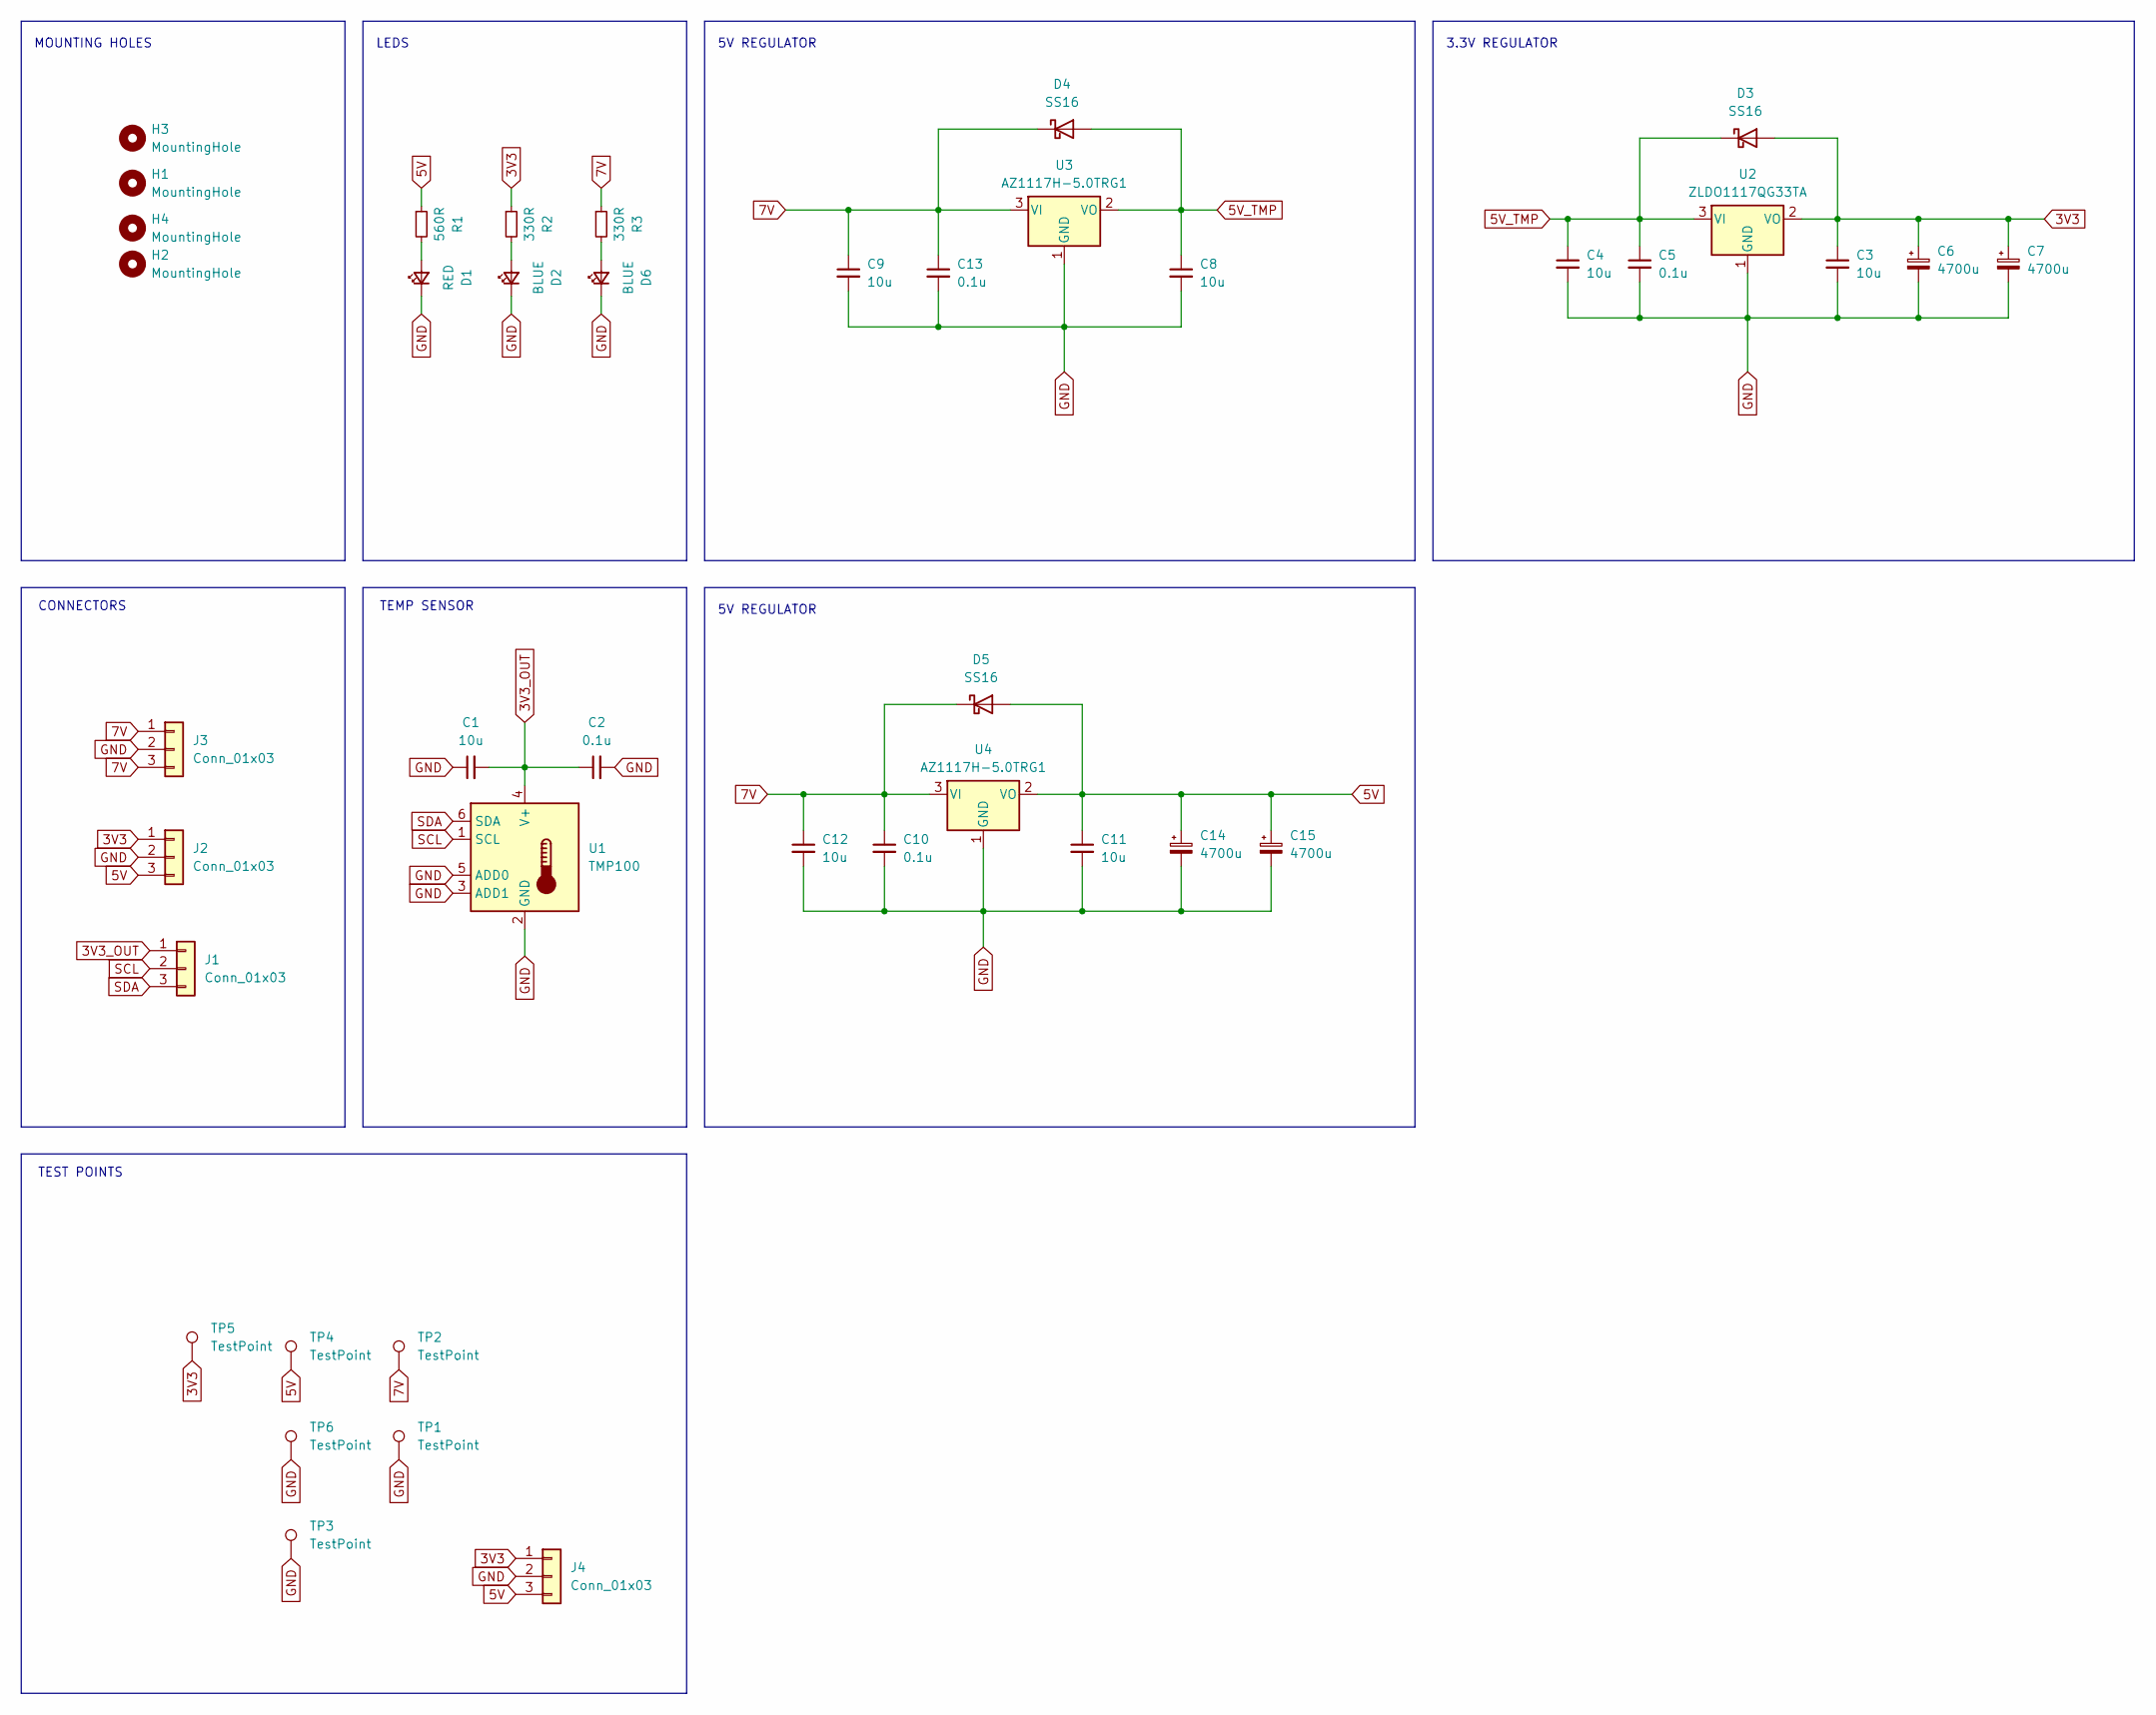
[picture p257: schematic digital.kicad_sch]

Parts:
C1, C3, C4, C8, C9, C11, C12: 10u; C_1206_3216Metric_Pad1.33x1.80mm_HandSolder
C2, C5, C10, C13: 0.1u; C_0805_2012Metric_Pad1.18x1.45mm_HandSolder
C6, C7, C14, C15: 4700u; CP_Radial_D16.0mm_P7.50mm
D1: RED; LED_0805_2012Metric_Pad1.15x1.40mm_HandSolder
D2, D6: BLUE; LED_0805_2012Metric_Pad1.15x1.40mm_HandSolder
D3, D4, D5: SS16; D_SMA
H1, H2, H3, H4: MountingHole; MountingHole_3.2mm_M3_DIN965_Pad_TopBottom
J1, J4: Conn_01x03; JST_PH_B3B-PH-K_1x03_P2.00mm_Vertical
J2, J3: Conn_01x03; JST_VH_B3P-VH-B_1x03_P3.96mm_Vertical
R1: 560R; R_0805_2012Metric_Pad1.20x1.40mm_HandSolder
R2, R3: 330R; R_0805_2012Metric_Pad1.20x1.40mm_HandSolder
TP1, TP2, TP3, TP4, TP5, TP6: TestPoint; TestPoint_THTPad_2.5x2.5mm_Drill1.2mm
U1: TMP100; SOT-23-6
U2: ZLDO1117QG33TA; SOT-223; Mouser ZLDO1117QG33TA
U3, U4: AZ1117H-5.0TRG1; SOT-223

Connections:
3V3: C3.1, C6.1, C7.1, D3.2 (A), J2.1, J4.1, R2.1, TP5.1, U2.2 (VO)
3V3_OUT: C1.2, C2.1, J1.1, U1.4 (V+)
5V: C11.1, C14.1, C15.1, D5.2 (A), J2.3, J4.3, R1.1, TP4.1, U4.2 (VO)
5V_TMP: C4.1, C5.1, C8.1, D3.1 (K), D4.2 (A), U2.3 (VI), U3.2 (VO)
7V: C9.1, C10.1, C12.1, C13.1, D4.1 (K), D5.1 (K), J3.1, J3.3, R3.1, TP2.1, U3.3 (VI), U4.3 (VI)
GND: C1.1, C2.2, C3.2, C4.2, C5.2, C6.2, C7.2, C8.2, C9.2, C10.2, C11.2, C12.2, C13.2, C14.2, C15.2, D1.1 (K), D2.1 (K), D6.1 (K), J2.2, J3.2, J4.2, TP1.1, TP3.1, TP6.1, U1.2 (GND), U1.3 (ADD1), U1.5 (ADD0), U2.1 (GND), U3.1 (GND), U4.1 (GND)
unnamed: D1.2 (A), R1.2
unnamed: D2.2 (A), R2.2
unnamed: D6.2 (A), R3.2
SCL: J1.2, U1.1 (SCL)
SDA: J1.3, U1.6 (SDA)

Notes on the sheet:
TEST POINTS
3.3V REGULATOR
5V REGULATOR
LEDS
TEMP SENSOR
MOUNTING HOLES
CONNECTORS
