duanestorey/hifi-amp/pcbs/psu/rectifiers/1.0/rectifiers.kicad_sch

## KiCad design pcbs/psu/rectifiers/1.0/rectifiers.kicad_sch (2025-10-22)

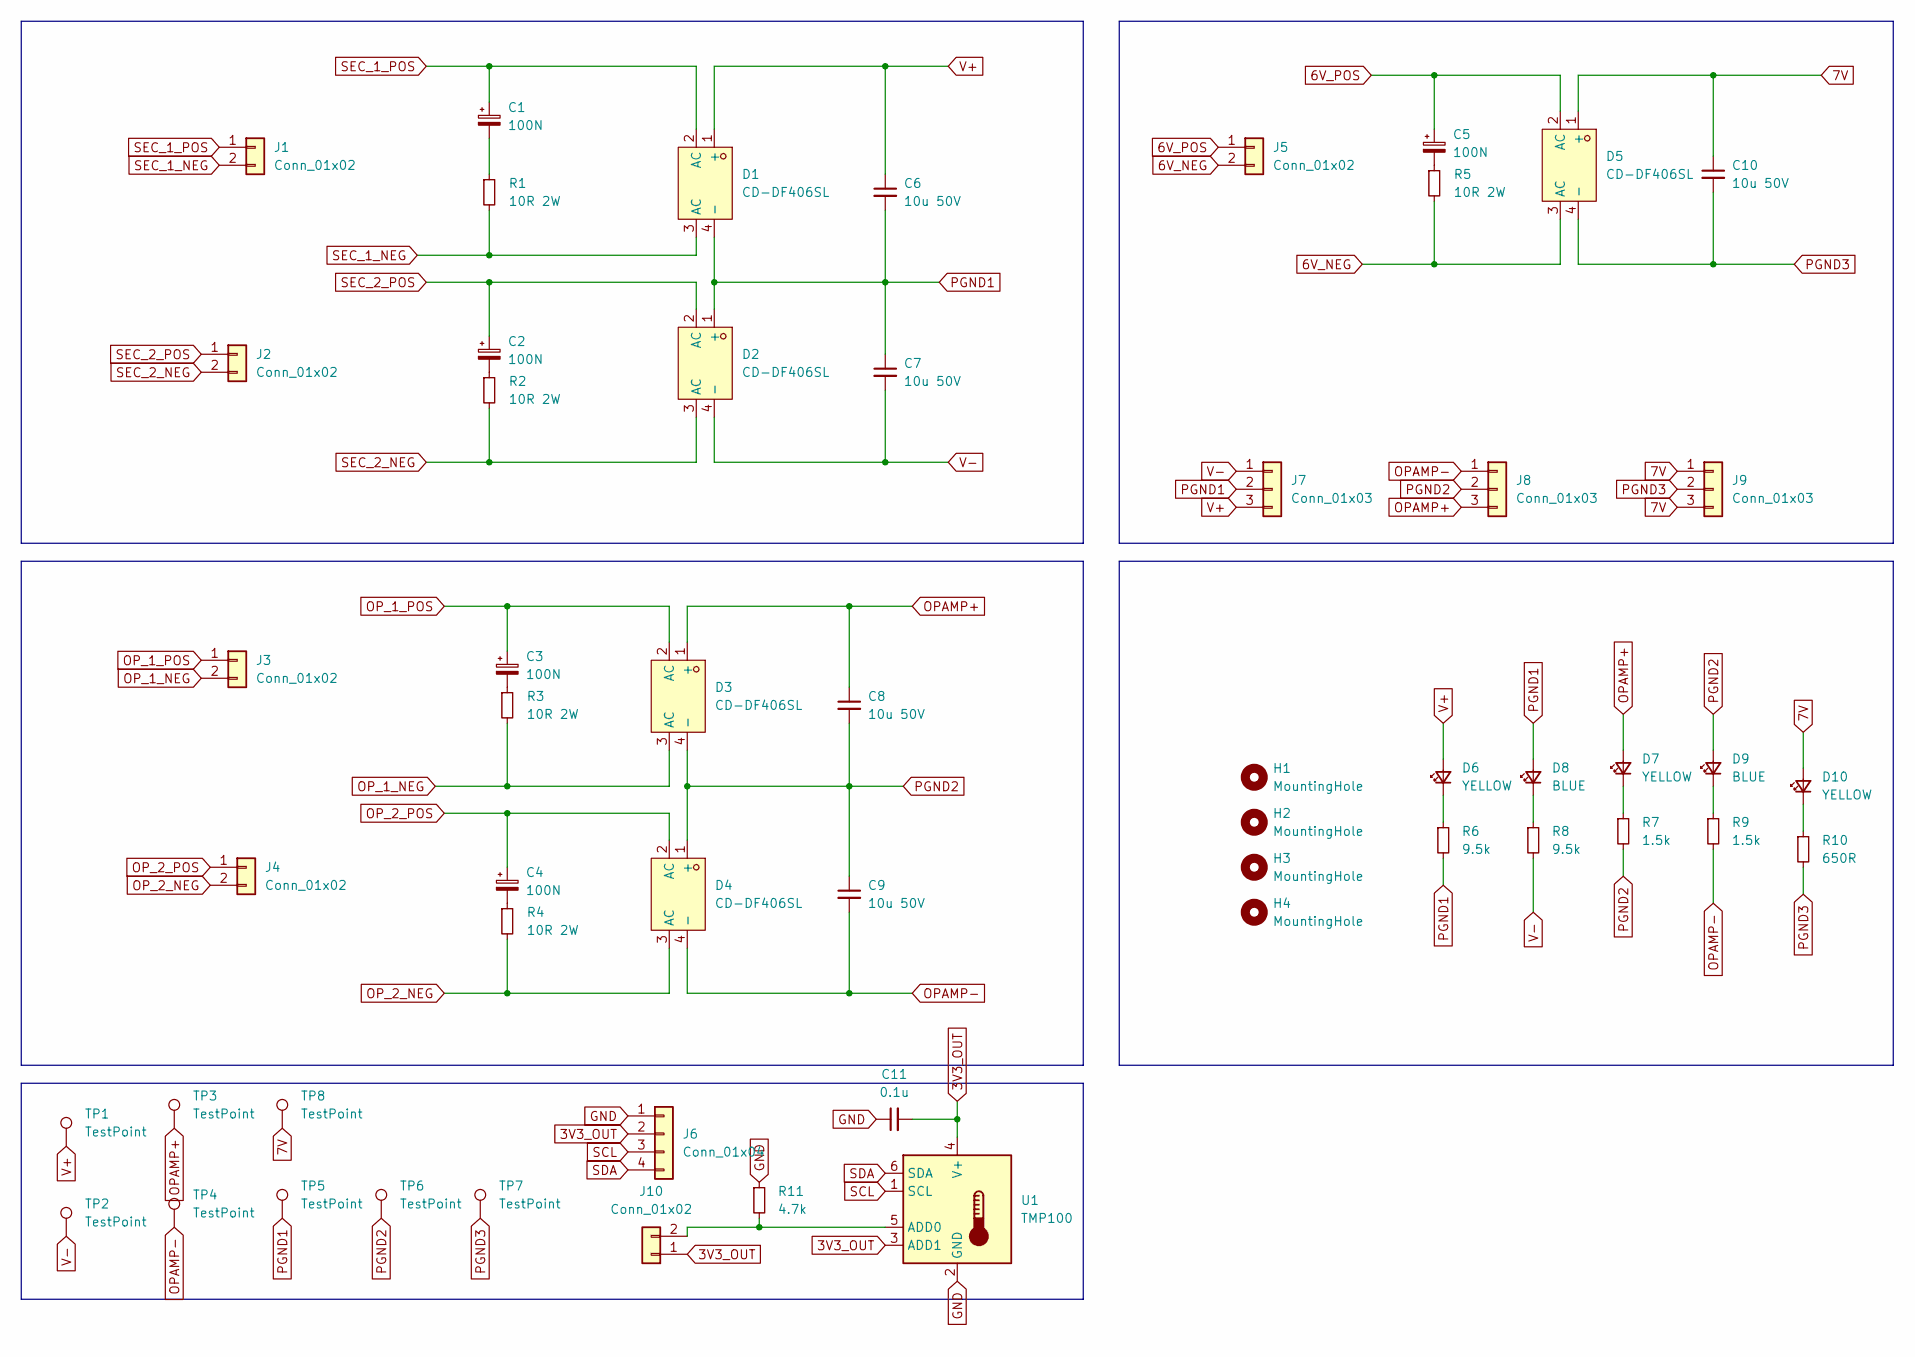
[picture p259: schematic rectifiers.kicad_sch]

Parts:
C1, C2, C3, C4, C5: 100N; C_Rect_L10.3mm_W4.5mm_P7.50mm_MKS4; Mouser MKP4F031002D00KF00
C6, C7, C8, C9, C10: 10u 50V; C_1206_3216Metric_Pad1.33x1.80mm_HandSolder
C11: 0.1u; C_0805_2012Metric_Pad1.18x1.45mm_HandSolder
D1, D2, D3, D4, D5: CD-DF406SL; Z4-D_4P-L10.5-W8.1-P5.08-TL; LCSC Part C17188088
D6, D7, D10: YELLOW; LED_0805_2012Metric_Pad1.15x1.40mm_HandSolder
D8, D9: BLUE; LED_0805_2012Metric_Pad1.15x1.40mm_HandSolder
H1, H2, H3, H4: MountingHole; MountingHole_3.2mm_M3_DIN965_Pad_TopBottom
J1, J2, J3, J4, J5: Conn_01x02; TerminalBlock_Phoenix_PT-1,5-2-3.5-H_1x02_P3.50mm_Horizontal
J6: Conn_01x04; JST_PH_B4B-PH-K_1x04_P2.00mm_Vertical
J7, J8, J9: Conn_01x03; JST_VH_B3P-VH-B_1x03_P3.96mm_Vertical
J10: Conn_01x02; PinHeader_1x02_P2.54mm_Vertical
R1, R2, R3, R4, R5: 10R 2W; R_2512_6332Metric_Pad1.40x3.35mm_HandSolder; Mouser 603-SR2512JK-7W10RL
R6, R8: 9.5k; R_0805_2012Metric_Pad1.20x1.40mm_HandSolder
R7, R9: 1.5k; R_0805_2012Metric_Pad1.20x1.40mm_HandSolder
R10: 650R; R_0805_2012Metric_Pad1.20x1.40mm_HandSolder
R11: 4.7k; R_0805_2012Metric_Pad1.20x1.40mm_HandSolder
TP1, TP2, TP3, TP4, TP5, TP6, TP7, TP8: TestPoint; TestPoint_THTPad_2.5x2.5mm_Drill1.2mm
U1: TMP100; SOT-23-6

Connections:
3V3_OUT: C11.2, J6.2, J10.1, U1.3 (ADD1), U1.4 (V+)
6V_NEG: D5.3 (AC), J5.2, R5.2
6V_POS: C5.1, D5.2 (AC), J5.1
7V: C10.1, D5.1 (+), D10.2 (A), J9.1, J9.3, TP8.1
GND: C11.1, J6.1, R11.1, U1.2 (GND)
unnamed: C1.2, R1.1
unnamed: C2.2, R2.1
unnamed: C3.2, R3.1
unnamed: C4.2, R4.1
unnamed: C5.2, R5.1
unnamed: D6.1 (K), R6.1
unnamed: D7.1 (K), R7.1
unnamed: D8.1 (K), R8.1
unnamed: D9.1 (K), R9.1
unnamed: D10.1 (K), R10.1
unnamed: J10.2, R11.2, U1.5 (ADD0)
OPAMP+: C8.1, D3.1 (+), D7.2 (A), J8.3, TP3.1
OPAMP-: C9.2, D4.4 (-), J8.1, R9.2, TP4.1
OP_1_NEG: D3.3 (AC), J3.2, R3.2
OP_1_POS: C3.1, D3.2 (AC), J3.1
OP_2_NEG: D4.3 (AC), J4.2, R4.2
OP_2_POS: C4.1, D4.2 (AC), J4.1
PGND1: C6.2, C7.1, D1.4 (-), D2.1 (+), D8.2 (A), J7.2, R6.2, TP5.1
PGND2: C8.2, C9.1, D3.4 (-), D4.1 (+), D9.2 (A), J8.2, R7.2, TP6.1
PGND3: C10.2, D5.4 (-), J9.2, R10.2, TP7.1
SCL: J6.3, U1.1 (SCL)
SDA: J6.4, U1.6 (SDA)
SEC_1_NEG: D1.3 (AC), J1.2, R1.2
SEC_1_POS: C1.1, D1.2 (AC), J1.1
SEC_2_NEG: D2.3 (AC), J2.2, R2.2
SEC_2_POS: C2.1, D2.2 (AC), J2.1
V+: C6.1, D1.1 (+), D6.2 (A), J7.3, TP1.1
V-: C7.2, D2.4 (-), J7.1, R8.2, TP2.1
