duanestorey/hifi-amp/pcbs/psu/usb/1.0/usb.kicad_sch

## KiCad design pcbs/psu/usb/1.0/usb.kicad_sch (2025-10-22)

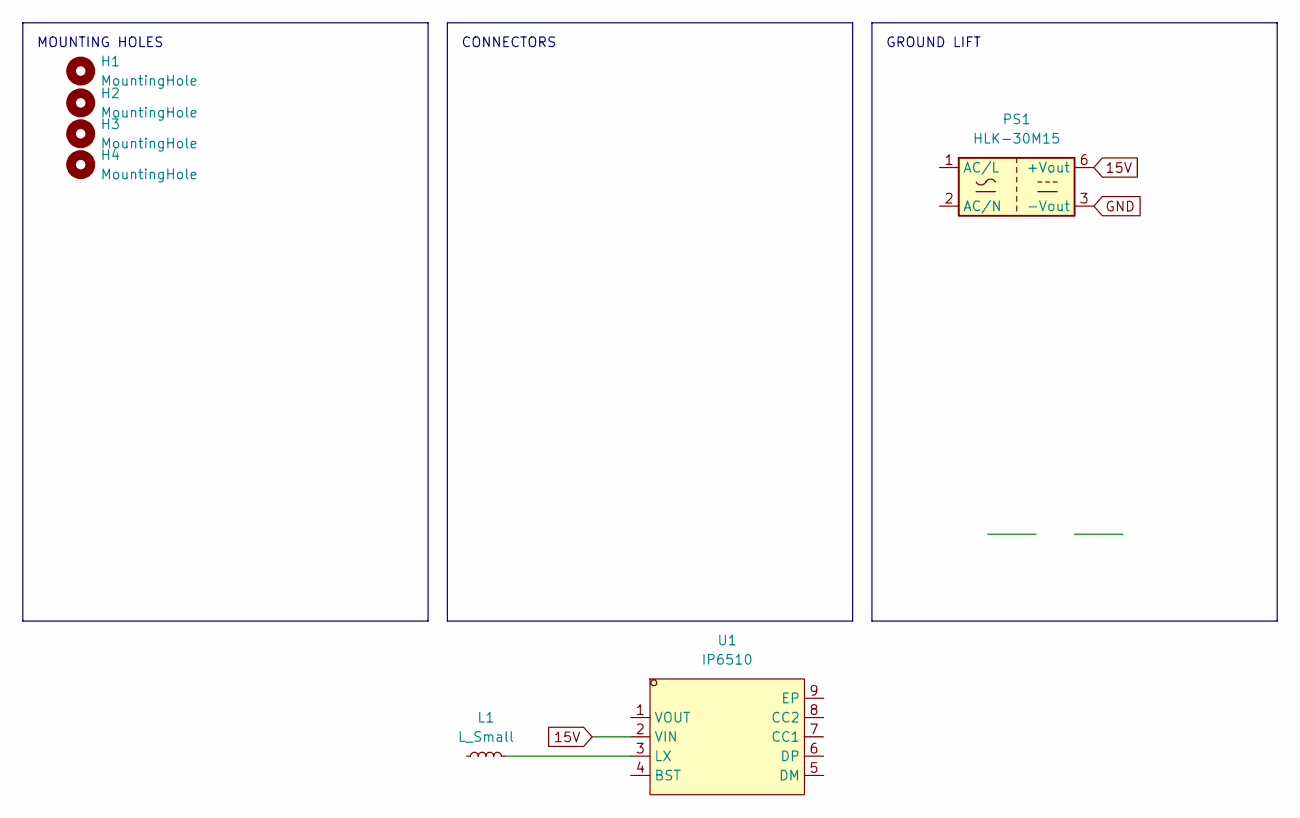
[picture p260: schematic usb.kicad_sch]

Parts:
H1, H2, H3, H4: MountingHole; MountingHole_3.2mm_M3_DIN965_Pad_TopOnly
L1: L_Small
PS1: HLK-30M15; Converter_ACDC_Hi-Link_HLK-30Mxx
U1: IP6510; ESOP-8_L4.9-W3.9-P1.27-LS6.0-BL-EP; LCSC Part C192869

Connections:
15V: PS1.6 (+Vout), U1.2 (VIN)
GND: PS1.3 (-Vout)
unnamed: L1.2, U1.3 (LX)

Notes on the sheet:
CONNECTORS
GROUND LIFT
MOUNTING HOLES
