duanestorey/hifi-amp/code/amp/main/http-server.cpp

#include "http-server.h"

#include <stdio.h>
#include <stdlib.h>
#include "freertos/FreeRTOS.h"
#include "freertos/task.h"
#include "esp_system.h"


#include "nvs_flash.h"
#include "esp_netif.h"
#include "driver/gpio.h"
#include <lwip/sockets.h>
#include <lwip/sys.h>
#include <lwip/api.h>
#include <lwip/netdb.h>
#include "esp_spiffs.h"

#include "debug.h"
#include <string>
#include <ranges>
#include "state.h"

#define HTTPD_307 "307 Temporary Redirect"
#define HTTPD_404 "404 Not Found"

HTTPServer::HTTPServer( QueuePtr queue, DiagnosticsPtr diag ) : mQueue( queue ), mServerHandle( 0 ), mDiag( diag ) {

}

esp_err_t send_web_response( httpd_req_t *req )
{
    HTTPServer *server = (HTTPServer *)req->user_ctx;
    return server->handleResponse( HTTPServer::SERVER_MAIN, req );
}

esp_err_t poweroff( httpd_req_t *req )
{
    HTTPServer *server = (HTTPServer *)req->user_ctx;
    return server->handleResponse( HTTPServer::SERVER_POWEROFF, req );
}

esp_err_t poweron( httpd_req_t *req )
{
    HTTPServer *server = (HTTPServer *)req->user_ctx;
    return server->handleResponse( HTTPServer::SERVER_POWERON, req );
}

esp_err_t volume_up( httpd_req_t *req )
{
    HTTPServer *server = (HTTPServer *)req->user_ctx;
    return server->handleResponse( HTTPServer::SERVER_VOLUME_UP, req );
}

esp_err_t volume_down( httpd_req_t *req )
{
    HTTPServer *server = (HTTPServer *)req->user_ctx;
    return server->handleResponse( HTTPServer::SERVER_VOLUME_DOWN, req );
}

esp_err_t volume_up5( httpd_req_t *req )
{
    HTTPServer *server = (HTTPServer *)req->user_ctx;
    return server->handleResponse( HTTPServer::SERVER_VOLUME_UP_5, req );
}

esp_err_t volume_down5( httpd_req_t *req )
{
    HTTPServer *server = (HTTPServer *)req->user_ctx;
    return server->handleResponse( HTTPServer::SERVER_VOLUME_DOWN_5, req );
}

esp_err_t input_hdmi( httpd_req_t *req )
{
    HTTPServer *server = (HTTPServer *)req->user_ctx;
    return server->handleResponse( HTTPServer::SERVER_INPUT_HDMI, req );
}

esp_err_t input_streamer( httpd_req_t *req )
{
    HTTPServer *server = (HTTPServer *)req->user_ctx;
    return server->handleResponse( HTTPServer::SERVER_INPUT_STREAMER, req );
}

esp_err_t input_dolby( httpd_req_t *req )
{
    HTTPServer *server = (HTTPServer *)req->user_ctx;
    return server->handleResponse( HTTPServer::SERVER_INPUT_DOLBY, req );
}

esp_err_t input_analog1( httpd_req_t *req )
{
    HTTPServer *server = (HTTPServer *)req->user_ctx;
    return server->handleResponse( HTTPServer::SERVER_INPUT_ANALOG1, req );
}

esp_err_t input_analog2( httpd_req_t *req )
{
    HTTPServer *server = (HTTPServer *)req->user_ctx;
    return server->handleResponse( HTTPServer::SERVER_INPUT_ANALOG2, req );
}

esp_err_t input_vinyl( httpd_req_t *req )
{
    HTTPServer *server = (HTTPServer *)req->user_ctx;
    return server->handleResponse( HTTPServer::SERVER_INPUT_VINYL, req );
}

esp_err_t http_404( httpd_req_t *req ) {
    HTTPServer *server = (HTTPServer *)req->user_ctx;
    return server->handleResponse( HTTPServer::SERVER_NOT_FOUND, req );
}

void 
HTTPServer::replaceWithFloat( std::string &str, const char *find, float replace, uint8_t digits ) {
    std::string *resp = new std::string( str );

    char temp[ 128 ];
    if ( digits == 1 ) {
        sprintf( temp, "%0.1f", replace );
    } else {
        sprintf( temp, "%0.2f", replace );
    }

    *resp = replaceAll( str, find, temp );
    str = *resp;

    delete resp;
}

esp_err_t 
HTTPServer::handleResponse( uint8_t requestType, httpd_req_t *req ) {
    //httpd_resp_set_type(req, "text/html");
    switch( requestType ) {
        case HTTPServer::SERVER_POWEROFF:
            mQueue->add( Message::MSG_POWEROFF );
            httpd_resp_set_status( req, HTTPD_307 );
            httpd_resp_set_hdr( req, "Location", "/");
            return httpd_resp_send(req, NULL, 0 );
            break;
        case HTTPServer::SERVER_POWERON:
            mQueue->add( Message::MSG_POWERON );
            httpd_resp_set_status( req, HTTPD_307 );
            httpd_resp_set_hdr( req, "Location", "/");
            return httpd_resp_send(req, NULL, 0 );
            break;
        case HTTPServer::SERVER_MAIN:
            {
                std::string resp = mMainPage;
                {
                    replaceWithFloat( resp, "{$chan_voltage}", mDiag->getVoltage( "POWER" ) );
                    replaceWithFloat( resp, "{$chan_current}", mDiag->getCurrent( "POWER" ) );
                    replaceWithFloat( resp, "{$chan_power}", mDiag->getPower( "POWER" ), 2 );
                    replaceWithFloat( resp, "{$5v_voltage}", mDiag->getVoltage( "5V" ) );
                    replaceWithFloat( resp, "{$5v_current}", mDiag->getCurrent( "5V" ) );
                    replaceWithFloat( resp, "{$5v_power}", mDiag->getPower( "5V" ), 2 );
                    replaceWithFloat( resp, "{$opamp_voltage}", mDiag->getVoltage( "OPAMP" ) );
                    replaceWithFloat( resp, "{$opamp_current}", mDiag->getCurrent( "OPAMP" ) );
                    replaceWithFloat( resp, "{$opamp_power}", mDiag->getPower( "OPAMP" ), 2 );
                    replaceWithFloat( resp, "{$3v3_voltage}", mDiag->getVoltage( "3V3" ) );
                    replaceWithFloat( resp, "{$3v3_current}", mDiag->getCurrent( "3V3" ) );
                    replaceWithFloat( resp, "{$3v3_power}", mDiag->getPower( "3V3" ), 2 );
                    replaceWithFloat( resp, "{$cpu_temp}", mDiag->getTemperature( "CPU" ) );
                    replaceWithFloat( resp, "{$psu_temp}", mDiag->getTemperature( "PSU" ) );
                }
                
                return httpd_resp_send(req, resp.c_str(), HTTPD_RESP_USE_STRLEN );
            }
            break;
        case HTTPServer::SERVER_VOLUME_UP:
            mQueue->add( Message::MSG_VOLUME_UP );
            httpd_resp_set_status( req, HTTPD_307 );
            httpd_resp_set_hdr( req, "Location", "/");
            return httpd_resp_send(req, NULL, 0 );
            break;
        case HTTPServer::SERVER_VOLUME_DOWN:
            mQueue->add( Message::MSG_VOLUME_DOWN );
            httpd_resp_set_status( req, HTTPD_307 );
            httpd_resp_set_hdr( req, "Location", "/");
            return httpd_resp_send(req, NULL, 0 );
            break;
        case HTTPServer::SERVER_VOLUME_UP_5:
            mQueue->add( Message::MSG_VOLUME_UP, 5 );
            httpd_resp_set_status( req, HTTPD_307 );
            httpd_resp_set_hdr( req, "Location", "/");
            return httpd_resp_send(req, NULL, 0 );
            break;
        case HTTPServer::SERVER_VOLUME_DOWN_5:
            mQueue->add( Message::MSG_VOLUME_DOWN, 5);
            httpd_resp_set_status( req, HTTPD_307 );
            httpd_resp_set_hdr( req, "Location", "/");
            return httpd_resp_send(req, NULL, 0 );
            break;  
        case HTTPServer::SERVER_INPUT_HDMI:
            mQueue->add( Message::MSG_INPUT_SET, 0 );
            httpd_resp_set_status( req, HTTPD_307 );
            httpd_resp_set_hdr( req, "Location", "/");
            return httpd_resp_send(req, NULL, 0 );
            break;        
        case HTTPServer::SERVER_INPUT_STREAMER:
            mQueue->add( Message::MSG_INPUT_SET, 1 );
            httpd_resp_set_status( req, HTTPD_307 );
            httpd_resp_set_hdr( req, "Location", "/");
            return httpd_resp_send(req, NULL, 0 );
            break; 
        case HTTPServer::SERVER_INPUT_DOLBY:
            mQueue->add( Message::MSG_INPUT_SET, 2 );
            httpd_resp_set_status( req, HTTPD_307 );
            httpd_resp_set_hdr( req, "Location", "/");
            return httpd_resp_send(req, NULL, 0 );
            break;    
        case HTTPServer::SERVER_INPUT_ANALOG1:
            mQueue->add( Message::MSG_INPUT_SET, 3);
            httpd_resp_set_status( req, HTTPD_307 );
            httpd_resp_set_hdr( req, "Location", "/");
            return httpd_resp_send(req, NULL, 0 );
            break; 
        case HTTPServer::SERVER_INPUT_ANALOG2:
            mQueue->add( Message::MSG_INPUT_SET, 4);
            httpd_resp_set_status( req, HTTPD_307 );
            httpd_resp_set_hdr( req, "Location", "/");
            return httpd_resp_send(req, NULL, 0 );
            break;
            
        case HTTPServer::SERVER_INPUT_VINYL:
            mQueue->add( Message::MSG_INPUT_SET, 5 );
            httpd_resp_set_status( req, HTTPD_307 );
            httpd_resp_set_hdr( req, "Location", "/");
            return httpd_resp_send(req, NULL, 0 );
            break;                   
        default:
            return httpd_resp_send(req, mMainPage.c_str(), HTTPD_RESP_USE_STRLEN );
            break;
    }

}


std::string 
HTTPServer::replaceAll( std::string str, const std::string& from, const std::string& to) {
    auto&& pos = str.find(from, size_t{});
    while (pos != std::string::npos) {
        str.replace(pos, from.length(), to);
        // easy to forget to add to.length()
        pos = str.find(from, pos + to.length());
    }
    return str;
}

void
HTTPServer::start() {
    httpd_config_t config = HTTPD_DEFAULT_CONFIG();
    mServerHandle = 0;
    config.max_uri_handlers = 30;

    if ( httpd_start( &mServerHandle, &config ) == ESP_OK ) { 
        AMP_DEBUG_I( "Web server started" );

        httpd_uri_t uri_get = {};

        uri_get.uri = "/";
        uri_get.method = HTTP_GET;
        uri_get.handler = send_web_response;
        uri_get.user_ctx = this;
        httpd_register_uri_handler( mServerHandle, &uri_get );

        uri_get.uri = "/poweroff";
        uri_get.handler = poweroff;
        httpd_register_uri_handler( mServerHandle, &uri_get );
        uri_get.uri = "/poweron";
        uri_get.handler = poweron;
        httpd_register_uri_handler( mServerHandle, &uri_get );

        uri_get.uri = "/volumeup";
        uri_get.handler = volume_up;
        httpd_register_uri_handler( mServerHandle, &uri_get );

        uri_get.uri = "/volumedown";
        uri_get.handler = volume_down;
        httpd_register_uri_handler( mServerHandle, &uri_get );

        uri_get.uri = "/volumeup5";
        uri_get.handler = volume_up5;
        httpd_register_uri_handler( mServerHandle, &uri_get );

         uri_get.uri = "/volumedown5";
        uri_get.handler = volume_down5;
        httpd_register_uri_handler( mServerHandle, &uri_get );

        uri_get.uri = "/input_hdmi";
        uri_get.handler = input_hdmi;
        httpd_register_uri_handler( mServerHandle, &uri_get );

        uri_get.uri = "/input_dolby";
        uri_get.handler = input_dolby;
        httpd_register_uri_handler( mServerHandle, &uri_get );

        uri_get.uri = "/input_streamer";
        uri_get.handler = input_streamer;
        httpd_register_uri_handler( mServerHandle, &uri_get );

        uri_get.uri = "/input_analog1";
        uri_get.handler = input_analog1;
        httpd_register_uri_handler( mServerHandle, &uri_get );

        uri_get.uri = "/input_analog2";
        uri_get.handler = input_analog2;
        httpd_register_uri_handler( mServerHandle, &uri_get );

        uri_get.uri = "/input_vinyl";
        uri_get.handler = input_vinyl;
        httpd_register_uri_handler( mServerHandle, &uri_get );

        uri_get.uri = "/ipp/print";
        uri_get.method = HTTP_POST;
        uri_get.handler = http_404;
        httpd_register_uri_handler( mServerHandle, &uri_get );

        uri_get.uri = "/ipp/print";
        uri_get.method = HTTP_GET;
        uri_get.handler = http_404;
        httpd_register_uri_handler( mServerHandle, &uri_get );

        uri_get.uri = "/ipp/print";
        uri_get.method = HTTP_HEAD;
        uri_get.handler = http_404;
        httpd_register_uri_handler( mServerHandle, &uri_get );

        uri_get.uri = "/*";
        uri_get.method = HTTP_GET;
        uri_get.handler = http_404;
        httpd_register_uri_handler( mServerHandle, &uri_get );

        uri_get.uri = "/*";
        uri_get.method = HTTP_POST;
        uri_get.handler = http_404;
        httpd_register_uri_handler( mServerHandle, &uri_get );
                
        esp_vfs_spiffs_conf_t conf = {
            .base_path = "/spiffs",
            .partition_label = NULL,
            .max_files = 5,
            .format_if_mount_failed = false
        };

        esp_err_t ret = esp_vfs_spiffs_register(&conf);

        if (ret == ESP_OK) {
            AMP_DEBUG_I( ".. file system mounted" );

            FILE *f = fopen( "/spiffs/index.html", "rt" );
            if ( f ) {
                char s[ 1025 ];

                while ( !feof( f ) ) {
                    fgets( s, 1024, f );

                    if ( strlen( s ) ) {
                        mMainPage = mMainPage + s;
                    }
                }
            }
        }
    }


    
}

void 
HTTPServer::stop() {

}
