duanestorey/hifi-amp/code/amp/main/amplifier.h

#ifndef __AMPLIFIER_H__
#define __AMPLIFIER_H__

#include "pins.h"
#include "timer.h"
#include "queue.h"

#include "state.h"
#include "mutex.h"
#include "i2c-bus.h"
#include "lcd.h"
#include "abstract/dac.h"
#include "abstract/channel-sel.h"
#include "driver/temperature_sensor.h"

#include "tmp100.h"
#include "encoder.h"
#include "button.h"
#include "http-server.h"
#include "driver/rmt_rx.h"
#include "pin-manager.h"
#include "abstract/pin.h"
#include "volume-controller.h"
#include "analog-channel-selector.h"
#include "digital-receiver.h"
#include "mdns-net.h"
#include "input.h"
#include "dsp.h"
#include "diagnostics.h"
#include "dolby-sta310.h"
#include "adc-pcm1863.h"
#include "cs8416.h"
#include <vector>

typedef std::vector<InputPtr> InputVector;

class Amplifier {
public:
    Amplifier();
    void init();
    void handleDisplayThread();
    void handleAudioThread();
    void handleRadioThread();
    void handleAmplifierThread();

    void handleTimerThread();

    void _handleWifiCallback( int32_t event_id );
    void _handlePowerButtonISR();
    void _handleVolumeButtonISR();
    void _handleVolumeButtonEncoderISR();
    void _handleInputButtonISR();
    void _handleInputButtonEncoderISR();
    void _handleNecRemoteCommand( uint8_t address, uint8_t command );

    void _handleIRInterrupt( const rmt_rx_done_event_data_t *edata );
protected:
    void asyncUpdateDisplay();

    PinPtr mStandbyLED;
  //  PinPtr mEncoderResetPin;
    PinPtr mDolbyResetPin;
    PinPtr mMonoblockEnablePin;
    PinPtr mDACXSMT;
    PinPtr mDolbyInterrupt;
    PinPtr mChannelEnable;
    PinPtr mSPDIFEnable;
    PinPtr mRelayEnablePin;

    bool mWifiEnabled;   
    bool mWifiConnectionAttempts;
    bool mUpdatingFromNTP;
    bool mPoweredOn;

    TimerPtr mTimer;

    QueuePtr mDisplayQueue;
    QueuePtr mAudioQueue;
    QueuePtr mRadioQueue;
    QueuePtr mAmplifierQueue;

    /*
    Queue mDisplayQueue;
    Queue mAudioQueue;
    Queue mRadioQueue;
    Queue mAmplifierQueue;
    */

    uint32_t mTimerID;
    uint32_t mButtonTimerID;
    uint32_t mReconnectTimerID;

    AmplifierState mState;

    uint8_t mCurrentInput;
    InputVector mAllInputs;

    I2CBUSPtr mI2C;

    LCDPtr mLCD;

    DACPtr mDAC[AMP_DAC_TOTAL_NUM];
    
    HTTPServerPtr mWebServer;
    MDNSPtr mDNS;
    AnalogChannelSelectorPtr mChannelSel;
    CS8416_Ptr mSPDIF;
    DiagnosticsPtr mDiagnostics;
    DSPPtr mDSP;
    Dolby_STA310Ptr mDolby;
    PCM1863Ptr mADC;

    Encoder mVolumeEncoder;
    Encoder mInputEncoder;

    uint32_t mAudioTimerID;
    uint32_t mSpdifTimerID;
    
    bool mPendingVolumeChange;
    uint32_t mPendingVolume;

    ButtonPtr mPowerButton;
    ButtonPtr mVolumeButton;
    ButtonPtr mInputButton;

    std::vector<TickPtr> mNeedsTick;

    uint8_t *mIRBuffer;
    rmt_channel_handle_t mIRChannel;

    //PinMcpManagerPtr mMcpPinManager;
    PinManagerPtr mPinManager;

    VolumeControllerPtr mMasterVolume;

    temperature_sensor_handle_t mTempSensorHandle;

private:
    void setupWifi();
    void attemptWifiConnect();
    void taskDelayInMs( uint32_t ms );

    void updateTimeFromNTP();
    void handleWifiCallback( int32_t event_id );

    void updateConnectedStatus( bool connected, bool doActualUpdate = true );

    void updateDisplay();

    void setupPWM();
    void handlePowerButtonPress();
    void handleInputButtonPress();
    void handleVolumeButtonPress();

    AmplifierState getCurrentState();
    void changeAmplifierState( uint8_t newState );
    InputPtr getCurrentInput();

    void startAudio();
    void stopAudio();

    void activateButtonLight( bool activate = true );
    void setupRemoteReceiver();
    void doActualRemoteReceive();

    void addInput( InputPtr input ) { mAllInputs.push_back( input ); }
    InputPtr findInput( uint8_t inputType, uint8_t modifier );
    void audioChangeInput();

    Mutex mStateMutex;

};

#endif
