duanestorey/hifi-amp/code/dsp/main/i2s.h

#ifndef __I2S_H__
#define __I2S_H__

#include "queue.h"
#include "driver/i2s_std.h"
#include "circ-buffer.h"

class I2S {
    public:
        I2S( QueuePtr queue );
        void start( uint32_t samplingRate, uint8_t bitDepth, uint8_t slotDepth );
        void stop();

        void handleReceiveCallback( i2s_event_data_t *event );
        void writeData( uint8_t *data, size_t maxSize, size_t &dataSize );
        bool readData( uint32_t readSize, uint8_t *&dataPtr1, size_t &dataSize1, uint8_t *&dataPtr2, size_t &dataSize2 );

        uint32_t bytesWaiting() { return mBuffer->dataReady(); }
    protected:
        QueuePtr mQueue;
        uint32_t mSamplingRate;
        uint32_t mPreloadedAmount;
        
        uint8_t mBitDepth;
        uint8_t mSlotDepth;

        i2s_chan_handle_t mTxHandle;
        i2s_chan_handle_t mRxHandle;

        bool mTransmitStarted;
        i2s_std_config_t mConfig;

        Circ_Buffer *mBuffer;
};

#endif
