duanestorey/hifi-amp/code/amp/main/pin-mcp.h

#ifndef __PINMCP_H__
#define __PINMCP_H__

#include "abstract/pin.h"
#include "queue.h"

class PinMcpManager;

class PinMcp : public Pin {
    public:
        enum {
            PIN_A0 = 0x01,
            PIN_A1 = 0x02,
            PIN_A2 = 0x03,
            PIN_A3 = 0x04,
            PIN_A4 = 0x05,
            PIN_A5 = 0x06,
            PIN_A6 = 0x07,
            PIN_A7 = 0x08,
            PIN_B0 = 0x11,
            PIN_B1 = 0x12,
            PIN_B2 = 0x13,
            PIN_B3 = 0x14,
            PIN_B4 = 0x15,
            PIN_B5 = 0x16,
            PIN_B6 = 0x17,
            PIN_B7 = 0x18
        };

        PinMcp( PinMcpManager *pinManager, uint8_t pin, uint8_t direction, uint8_t pulldown, uint8_t pullup );
        virtual void enableInterrupt( uint8_t interruptType );

        virtual void config( uint8_t direction, uint8_t pulldown, uint8_t pullup );
        virtual void setState( uint8_t state );

        virtual std::string getClass() const { return "MCP"; }
        virtual uint8_t getPinID() const { return mPin; }
        virtual uint8_t getState() const;
    protected:
        uint8_t mPin;
        PinMcpManager *mPinManager;
};

#endif
