duanestorey/hifi-amp/(commit log)

2025-01-13 Adding LED info
2025-01-13 Updating LEDs
2025-01-13 Adding pcbs and kicad
    [SPDIF.kicad_pcb, SPDIF.kicad_sch, adc.kicad_pcb, adc.kicad_sch, dac.kicad_pcb, dac.kicad_sch, dsp.kicad_pcb, dsp.kicad_sch]
2025-01-13 Ground lift
2025-01-15 Adding image
    [ftdi.kicad_sch]
2025-01-16 Moving PCBs
    [SPDIF.kicad_pcb, SPDIF.kicad_sch, adc.kicad_pcb, adc.kicad_sch, dac.kicad_pcb, dac.kicad_sch, dsp.kicad_pcb, dsp.kicad_sch]
2025-02-14 Major updates
    [adc.kicad_sch, dac.kicad_pcb, dac.kicad_sch, dsp.kicad_pcb, dsp.kicad_sch, dual-psu.kicad_pcb, dual-psu.kicad_sch, esp32-s3.kicad_pcb]
2025-02-15 Updating docs
    [dual-psu.kicad_sch]
2025-02-15 Updating pin outs
    [dual-psu.kicad_pcb, dual-psu.kicad_sch]
2025-02-15 Fixing small issues with input selector
    [input-sel.kicad_pcb, input-sel.kicad_sch]
2025-02-17 More updates
    [blank.kicad_pcb, blank.kicad_sch, dual-psu.kicad_sch, multipsu.kicad_pcb, multipsu.kicad_sch, psu.kicad_pcb, psu.kicad_sch, psuentry.kicad_pcb]
2025-02-18 Updating connectors
2025-02-21 Updating code and designs
    [dac.kicad_sch, dsp.kicad_pcb, dsp.kicad_sch, extend.kicad_pcb, extend.kicad_sch, mono.kicad_pcb, mono.kicad_sch, uproc.kicad_pcb]
2025-02-23 Updatined code
    [dac.kicad_pcb, lm3886.kicad_pcb, lm3886.kicad_sch, mono.kicad_pcb, mono.kicad_sch, partitions.csv]
2025-10-22 All changes
    [SSR21NV-M30064.step, adc.kicad_pcb, adc.kicad_sch, analog.kicad_pcb, analog.kicad_sch, back-adapter-pesante.scad, capacitor-bank.kicad_pcb, capacitor-bank.kicad_sch]
2025-11-16 Working code
    [2171790001.stp, B2P-VH--3DModel-STEP-56544.STEP, B3P-VH-LF--SN---3DModel-STEP-510211.STEP, LM3886.STEP, Msbl.stp, SMD fuse holder v7.step, SPDIF.kicad_pcb, SPDIF.kicad_sch]
2025-11-16 Looking good
    [split.kicad_pcb, split.kicad_sch]
